czp-1-A1/FPGA_Component_Inspector/开发实施/显示方案预览/README.md

# A显示方案预览（2026-10-05）

这些文件用于讨论20方案，均不是新FPGA输出截图或识别验收证据。

- `lab3-logo-reference.png`：从随板Lab3原ROM直接解码的160×160图案，未改原ROM；来源与SHA见20方案。
- `sample-uncal-preview.png`：下一版建议采用的取样界面，默认未标定。
- `demo-present-preview.png`：未来精简演示内容，有件仅为状态预演。
- `demo-offline-preview.png`：无输入时撤销旧判定并显示等待采样。
- `preview_manifest.json`：本轮预览检查和文件哈希，不替代硬件验收清单。

三张布局图均为1024×600；字形是风格示意，正式RTL使用有限字符的1bit字模。载带为几何示意，双框用途及坐标沿用当前方案，顶部参数和底部示例数据不能用来证明实物检测通过。

交互预览源位于本聊天的可视化目录：

`C:/Users/yiziw/.codex/visualizations/2026/10/02/01a0fcf4-604d-7ef2-88bc-ccfea7cc8b08/fpga-stage-a-display.html`

`fpga-stage-a-display-inspection.html`为本机浏览器检查包装页。这里只准备方案、预览和交接；RTL/约束/.al/bit均未改。
