czp-1-A1/FPGA_Component_Inspector/待测元器件/待测元器件选择与验证方案.md

# 待测元器件搜集与筛选清单

> 2026-09-07修订：候选库仍作资料初筛。A版从一种实际样品完成正常/空穴识别；B版进入运动编号前确认P0/P1，方向特征按实测加入，不以极性未通过阻塞A版。

## 1. 搜集时主要看什么

看到一个元件后，重点记录：

- 立创编号、制造商和完整料号；
- 封装名称和元件尺寸；
- 顶部是否有色带、缺角、圆点、字符或不对称结构；
- 从正上方能否判断方向或极性；
- 是否采用载带卷盘包装；
- 载带宽度、穴位节距和装料方向；
- 能检测哪些缺陷；
- 商品图是否只是示意图，datasheet是否有真实标记说明。

最重要的一条：

> **只能从底部看出极性的元件，不适合作顶部极性识别样品；仍可用于已验证的存在/空穴检测。**

---

## 2. 第一类：最值得重点搜集

这些元件尺寸合适、方向特征较明显，优先建立候选库。

| 元件类型 | 嘉立创搜索关键词 | 可以检测什么 | 推荐程度 | 重点注意 |
|---|---|---|---:|---|
| SOD-123 二极管 | `B5819W SOD-123`、`1N4148W SOD-123` | 空穴、偏位、旋转、阴极方向 | ★★★★★ | 色带必须从顶部清楚可见 |
| SMA 二极管 | `SS14 SMA`、`DO-214AC 二极管` | 空穴、偏位、旋转、阴极方向 | ★★★★★ | 元件更大，但载带也可能更宽 |
| 3528 LED | `3528 PLCC-2 水清 LED` | 空穴、偏位、旋转、极性、颜色 | ★★★★☆ | 优先水清有色，避免荧光胶遮挡 |
| 5050 单色 LED | `5050 单色 LED` | 空穴、偏位、旋转、极性、颜色 | ★★★☆☆ | 区分单色和RGB，多芯片结构较复杂 |
| CASE-A 钽电容 | `CASE-A 3216 钽电容` | 空穴、偏位、旋转、极性条 | ★★★★★ | 顶部极性条是否清楚、批次是否一致 |
| CASE-B/C 钽电容 | `3528 钽电容`、`6032 钽电容` | 空穴、位置、方向、尺寸 | ★★★★☆ | 更容易拍清，但载带更宽、价格较高 |

可以先查看的具体例子：

- SOD-123：[MDD B5819W，C64885](https://www.lcsc.com/product-detail/C64885.html)
- 3528红色水清LED：[C516137](https://www.lcsc.com/product-detail/Light-Emitting-Diodes-LED_HONGLITRONIC-Hongli-Zhihui-HONGLITRONIC-HL-A-3528S9AC-S1-13HL_C516137.html)
- 3528绿色水清LED：[C5280496](https://www.lcsc.com/product-detail/C5280496.html)
- CASE-A钽电容：[C7177](https://www.lcsc.com/product-detail/Tantalum-Capacitors_Kyocera-AVX-TAJA106K010RNJ_C7177.html)
- SMA二极管：[onsemi SS14，C83852](https://www.lcsc.com/product-detail/schottky-diodes_onsemi-ss14_C83852.html)

---

## 3. 第二类：适合扩展方向和封装识别

这些元件适合展示系统不仅能检测二极管或LED，还能通过配方检测不同封装。

| 元件类型 | 嘉立创搜索关键词 | 可以检测什么 | 难度 | 注意事项 |
|---|---|---|---:|---|
| SOT-23 | `SOT-23 三极管`、`SOT-23 MOS管` | 空穴、偏位、旋转、侧立、封装方向 | 低 | 三引脚结构不对称，比较适合 |
| SOT-89 | `SOT-89 稳压器` | 空穴、位置、方向、错尺寸 | 低 | 引脚和散热片结构明显 |
| SOT-223 | `SOT-223 稳压器` | 空穴、方向、偏位、姿态 | 低 | 尺寸较大，载带通常更宽 |
| SOP/SOIC | `SOP-8 芯片`、`SOIC-8` | 空穴、偏位、旋转、Pin 1方向、明显引脚异常 | 中 | 查找顶部圆点或缺口明显的型号 |
| TSSOP | `TSSOP-8`、`TSSOP-14` | 空穴、方向、偏位、引脚轮廓 | 中 | 引脚较细，对清晰度要求更高 |
| QFP/LQFP | `LQFP-32`、`LQFP-48` | 空穴、方向、Pin 1、明显引脚异常 | 中高 | 元件较大但引脚密集，载带较宽 |
| QFN/DFN | `QFN-16`、`DFN-8` | 空穴、外形、方向、Pin 1标记 | 高 | 顶部标记小，部分极性特征只在底部 |
| DPAK/TO-252 | `TO-252 MOS管`、`DPAK` | 空穴、方向、偏位、外形 | 低 | 外形不对称但尺寸和载带较大 |
| 贴片光耦 | `SOP-4 光耦` | 空穴、方向、Pin 1、偏位 | 中 | 顶部圆点或缺口是否明显 |
| 贴片整流桥 | `MBF 贴片整流桥` | 空穴、方向、极性符号、字符 | 中 | 顶部符号可能较小，需看datasheet |

这类元件的重点不是识别具体电气型号，而是检测封装方向、位置和可见外观。不能仅凭普通摄像头判断芯片内部是否正常。

---

## 4. 第三类：可以做普通外观检测

这类元件通常没有极性，但可以用于扩展空穴、偏位、侧立、错尺寸和破损检测。

| 元件类型 | 嘉立创搜索关键词 | 可以检测什么 | 推荐程度 | 注意事项 |
|---|---|---|---:|---|
| 1206电阻 | `1206 电阻` | 空穴、偏位、旋转、侧立、字符 | ★★★★☆ | 适合做非极性配方 |
| 0805电阻 | `0805 电阻` | 空穴、偏位、姿态 | ★★★☆☆ | 尺寸偏小但仍可尝试 |
| 1206陶瓷电容 | `1206 MLCC` | 空穴、偏位、侧立、错尺寸 | ★★★☆☆ | 外观过于相似，不能测容量 |
| 贴片电感 | `1210 电感`、`功率电感 SMD` | 空穴、偏位、旋转、破损 | ★★★★☆ | 优先选择3～6 mm的屏蔽电感 |
| 贴片保险丝 | `1206 贴片保险丝` | 空穴、位置、外观、字符 | ★★★☆☆ | 不能只靠视觉判断是否熔断 |
| 磁珠 | `1206 磁珠` | 空穴、位置、侧立 | ★★☆☆☆ | 与电阻电容外观相似 |

普通阻容感不能作为“极性反向”检测对象，也不能通过外观判断阻值、容量或电感量。

---

## 5. 第四类：可作为高难度扩展

| 元件类型 | 嘉立创搜索关键词 | 可以研究什么 | 主要困难 |
|---|---|---|---|
| 贴片晶振 | `3225 晶振`、`5032 晶振` | 空穴、方向、字符、封装尺寸 | 金属壳反光，部分型号无方向要求 |
| 有源晶振 | `3225 有源晶振` | Pin 1方向、字符、偏位 | 顶部圆点或缺角较小 |
| 光电传感器 | `SMD 光电传感器` | 方向、窗口位置、外观 | 透明窗口和黑色壳体反光差异大 |
| 贴片霍尔传感器 | `SOT-23 霍尔传感器` | 封装方向、位置 | 只能识别外观，不能判断功能 |
| TVS二极管 | `SMA TVS`、`SOD-123 TVS` | 空穴、方向、外形 | 双向TVS可能没有极性，不要混淆 |
| 连接器 | `载带包装 SMD 连接器` | 空穴、方向、针脚明显异常 | 异形、尺寸大、载带不统一 |
| 屏蔽罩/金属件 | `载带包装 屏蔽罩` | 空穴、方向、轮廓和变形 | 高反光，需要特殊照明 |

这些适合后期证明系统可扩展，不建议作为第一版主样品。

---

## 6. 暂时不要重点搜集

- 0201、0402等超小元件；
- BGA、WLCSP等底部特征为主的封装；
- 极性只能从底部焊盘判断的LED或芯片；
- 没有datasheet、品牌或完整料号的元件；
- 散装、管装或托盘装且没有相应载带资料的元件；
- 外形完全相同、只能靠电参数区分的电阻、电容或二极管；
- 只在手机微距商品图里看得清标记的元件。

---

## 7. 每找到一个元件就这样记录

| 项目 | 填写内容 |
|---|---|
| 元件类别 | 例如SOD-123二极管 |
| 立创编号 | 例如C64885 |
| 制造商 |  |
| 完整料号 |  |
| 封装 |  |
| 元件尺寸 |  |
| 顶部特征 | 色带/缺角/圆点/字符/不对称结构 |
| 顶部能否判断方向 | 能/不能/待实物验证 |
| 预计可检测缺陷 |  |
| 包装方式 | Tape & Reel/其他 |
| 载带宽度 |  |
| 穴位节距 |  |
| datasheet链接 |  |
| 商品链接 |  |
| 初步推荐等级 | 主样品候选/第二配方/后期扩展/不推荐 |
| 备注 |  |

建议每一大类先搜集2～3个具体型号，不需要把商城所有同类元件都记录一遍。

---

## 8. 搜集完成后的初步分类

把找到的型号分成四组：

1. **主样品候选**：顶部极性明显、尺寸3～6 mm、载带资料完整；
2. **第二配方候选**：与主样品材质或封装不同，但仍容易检测；
3. **高难度扩展**：Pin 1、小字符、细引脚或强反光目标；
4. **淘汰**：顶部无可靠特征、尺寸太小或包装信息不完整。

目前推荐的搜集重点为：

> **SOD-123二极管、SMA二极管、3528 LED、钽电容、SOT-23和SOP-8。**

这六类已经能覆盖色带极性、内部结构极性、极性条、非对称引脚和Pin 1标记等多种视觉特征。

## 9. 本轮增加的实物验证记录

- 固定支架、镜头高度/倾角、导轨基准和光源，拍同平面毫米尺，记录有效视场与标记像素数；不先限定可见穴位数量。
- A版只要求正常/空穴真值完整。反向、偏位、旋转在对应功能启用前分别记录制作方法、允许正常范围与测量真值。
- 测试段和物理穴位建立编号，标记避开检测ROI及定位孔；记录运行段/相对编号与物理真值号的映射。
- 拆装后和轻微横移后复拍；完整标定补偿按误差是否妨碍本版判定决定。
- 单帧先验，多帧可用数按完整清晰检测行程和实测速度计算，不以每节距帧数代替。
- 所有未知包装、成像和运动参数仍标待核实，不因为本轮批准计划就改成实测通过。候选工作簿保持原始数据状态。
