czp-1-A1/FPGA_Component_Inspector/开发实施/验收记录/20261001_步骤1_轮次1.md

# A 阶段步骤 1：官方 Lab 1 构建记录

## 结论

**需补测。** TD 6.2.1 已完成官方 `lab_hd_1_mipi_hdmi` 的综合、布局布线和 bitgen，生成 SRAM 下载镜像；未能经 JTAG 下载到开发板，因此没有本机显示、连续视频或冷启动验收证据。

## 目标与范围

执行开发计划《00_分阶段开发与逐级验证路线.md》步骤 1：以官方 Lab 1 摄像头到 HDMI 工程为起点，先验证本机完整工具链。计划中要求的真实视频、输入分辨率/帧率、30 分钟连续运行和冷启动，本轮未测。

本轮未修改 HDL、约束或原始例程。为了不改动资料目录中的源例程，构建副本位于 `D:\TD_Example_Run_20261001`。

## 基本信息

- 日期：2026-10-01；阶段 A，步骤 1，轮次 1。
- 仓库基线：`hx1p35a-contest-work`，HEAD `f87ccf1`；无 RTL/约束改动。
- TD：`6.2.168116`（6.2.1）。
- 官方工程：`7_lab_ex_2026_nosoft/lab_hd_1_mipi_hdmi/lab_hd_1_mipi_hdmi/td_project/camera_to_dsi_display.al`。
- 顶层/器件：`design_top_wrapper` / `PH1P35MDG324`。
- 板卡照片丝印：HX1P35A V1.0；FPGA 封装丝印未能从照片确认。
- COM8：`USB Serial Port (COM8)`，FTDI VID/PID `0403:6042`，MI_01（Channel B）；Channel A 为 MI_00。当前 A、B 均绑定 FTDI CDM 2.12.36.20。

## 构建结果

| 阶段 | 结果 | 关键报告 |
|---|---|---|
| 综合 `read_design` → `opt_gate` | 通过，TD 进程退出码 0 | Setup WNS 2040 ps、TNS 0 ps；Hold WNS 114 ps、TNS 0 ps |
| 布局布线/bitgen `opt_place` → `bitgen` | 通过，TD 进程退出码 0 | Setup WNS 629 ps、TNS 0 ps、违例端点 0；Hold WNS 20 ps、TNS 0 ps、违例端点 0 |

最终资源：LUT6 9,830/21,216（46.33%）；slice 12,187/21,216（57.44%）；寄存器 13,318/42,432（31.39%）；ERAM 31/108（28.70%）；DSP 8/40（20%）；DDR byte 6/12；MIPI RX 1/2；PLL 3/6。详见 `camera_to_dsi_display_phy.area` 和 `route.qor`。

综合日志包含未驱动 DDR 初始化 RAM 输入脚及 `SYN-5025 Using 0 for all undriven pins and nets` 警告；另有部分 RAM_STYLE 自动推断警告。物理实现报告包含摄像头时钟网使用局部布线、时钟网混合扇出及 PLL 输出未绑定可时钟 IO 的警告。流程仍成功生成镜像，但这些警告需要在实际板卡验证前复核。

## JTAG/上板结果

- Windows 枚举到 FTDI `VID_0403&PID_6042`；COM8 是 MI_01/Channel B 的串口，JTAG 使用 MI_00/Channel A。
- `hwserver.exe` 实测输出：`Use channel A`、`Open device vid=0x0403 pid=0x6042`，随后 `usb_open() failed`，退出码 1。
- `bw_commands_prompt.exe` 的诊断调用及 `hwserver.exe` 都在打开 FTDI Channel A 时失败：前者报告 `PRG-9505 USB device open error` / `PRG-9525 Chip validation failed`，后者报告 `usb_open() failed`、退出码 1。当前 Channel A/MI_00 绑定 FTDI CDM；这与随附手册要求的 JTAG WinUSB 驱动状态不一致，是已观察到的阻塞点。没有向 FPGA SRAM/Flash 下载，也没有改写 FTDI EEPROM。
- 摄像头和显示器是否接好、摄像头实时视频、分辨率/帧率、30 分钟稳定性、断电冷启动：未测。

## 证据

| 证据 | 文件 | 支持内容 |
|---|---|---|
| E01 | `syn_run.log` | TD 版本、综合完成状态、综合时序与警告 |
| E02 | `phy_run.log` | 布局布线、DRC/QoR、bitgen 完成状态与最终时序 |
| E03 | `camera_to_dsi_display_phy.area`、`route.qor`、`place.qor`、`final_timing.rpt`、`route_clock_utilization.txt` | 资源、I/O、布局布线时序、时钟网络报告 |
| E04 | `camera_to_dsi_display.bit`、`camera_to_dsi_display_compress.bit` | 本轮生成的 SRAM 下载镜像 |
| E05 | Windows PnP 枚举和 `hwserver.exe` 终端输出（本轮记录） | COM8/FTDI 通道与 JTAG 打开失败原因 |

Bitstream SHA-256：

- `camera_to_dsi_display.bit`: `33A0A0B89A178E9F119E8434F6CE4649C56974B7F580A400D60301B6F49154C9`
- `camera_to_dsi_display_compress.bit`: `72E2E73AA01CA646EA7F703A8238784CDF505188F5F55DDBA8732782C3D78533`

## 下一步

先按随附的 JTAG 安装说明把 USB-JTAG 的 Channel A/MI_00 配置为可供 hwserver 打开的 WinUSB 驱动，保留 Channel B/MI_01 的 FTDI COM 驱动以维持 COM8。重插 USB 后再次确认 `hwserver.exe` 能打开设备，再用 BitWriter 的 SRAM 模式下载本轮镜像。随附流程还包含 FT_Prog 写入 `al_link_ft_new.xml` 的 USB 桥 EEPROM 步骤；本轮未执行该持久写入，模板状态也未读取。随后接好摄像头和显示器，按步骤 1 记录视频与冷启动证据。

## 提交状态

未提交、未推送。记录及证据为本地新增文件；没有修改检测 RTL 或约束。
