czp-1-A1/FPGA_Component_Inspector/开发实施/验收记录/20261001_步骤1_轮次2_JTAG驱动复测.md

# A 阶段步骤 1：JTAG 驱动复测

## 结论

**FPGA 识别和 SRAM 下载通过，视频验收待完成。** BitWriter识别到`PH1P35MDG324`，并报告芯片验证成功；官方Lab 1压缩镜像的`download`命令正常结束，耗时7.458209秒。SRAM下载成功不等于板上摄像头视频验收通过，当前也没有30分钟运行或冷启动证据。

## 设备状态

- 日期：2026-10-01；阶段 A，步骤 1，轮次 2。
- 板卡 USB 桥：FTDI `VID_0403&PID_6042`。
- JTAG：USB `MI_00` / Channel A，设备管理器显示 `USB Serial Converter A (Libusb - WinUSB)`；驱动提供方 `Libusb - WinUSB (Powered by UsbDriverTool)`，驱动包 `oem107.inf`。
- UART：USB `MI_01` / Channel B，仍绑定 FTDI CDM 2.12.36.20；`USB Serial Port (COM8)`状态为 OK。
- 未运行 FT_Prog；未写入 `al_link_ft_new.xml`；未改写 FTDI EEPROM。

## JTAG 访问探测

`hwserver.exe` 1.0c 在交互终端中输出：

```text
Initialize ftdi
Use channel A
Open device vid=0x0403 pid=0x6042
Enable mpsse
Requested jtag tck: 15 MHz
Actual jtag tck: 15 MHz
Speed: 0.00 kbps
```

这说明程序已打开 Channel A 并进入 MPSSE/JTAG 模式；空闲时速率显示 0.00 kbps。探测进程随后已关闭，避免占用 JTAG 接口。

## BitWriter SRAM 下载

- 用户截图中目标器件为`0:PH1P35MDG324`，Debug Server为`AL-LINK-FT (Local Host)`，模式为`PROGRAM_SRAM`、速度为`5MHz`。
- 文件列表显示加载了`camera_to_dsi_display_compress.bit`，Device为`phl_35p`、Package为`PH1P35MDG324`、Bit version为`0x00`。
- 日志报告`PRG-2014 : Chip validation success: PH1P35MDG324`，随后`download`命令正常结束，用时7.458209秒；界面进度为100%。据此记录FPGA识别和SRAM下载通过。
- 用镜像：`D:\TD_Example_Run_20261001\td_project\camera_to_dsi_display_Runs\best_result\camera_to_dsi_display_compress.bit`，SHA-256 `72E2E73AA01CA646EA7F703A8238784CDF505188F5F55DDBA8732782C3D78533`。
- 截图证据：`开发实施/验收记录/20261001_步骤1_轮次2_JTAG驱动复测/BitWriter_SRAM下载成功.png`，SHA-256 `4127094CA1ECF89BE154DAE522DF7924FABBAF9D109BAA8ECC33D969700865E5`。
- 下载方式为SRAM；此证据不包含Flash写入、摄像头实时视频或显示端验收。

## 待完成

## 后续下载重试

用户接好摄像头后提供的日志先显示`GUI-1001 : Downloading succeeded!`，随后又启动了一条新的`download`命令。该次新命令多次报告`PRG-8000 ERROR: Connect server failed`，最终报告`PRG-9525 ERROR: Chip validation failed`并在30.525386秒后结束。前一条GUI成功提示属于此前已完成的下载，不代表这次新重试成功；芯片校验失败发生在服务连接失败之后。

同一工作站随后检查到：`127.0.0.1:5555` TCP连接失败；PID 5124的`jtagserver.exe`进程存在，但没有在该端口监听。此前BitWriter使用`connect_cable -host_name 127.0.0.1:5555`，因此当前现象优先指向本地调试服务未就绪/不可达。现有信息不足以判断摄像头是否造成板卡复位；也未确认第一次成功下载后板卡是否掉电或复位，故当前SRAM配置状态待确认。

用户随后反馈重新上电后USB接口类型变回原样。对此工作站重新枚举当前在场的FTDI复合设备：MI_00仍显示`USB Serial Converter A (Libusb - WinUSB)`，驱动提供方`Libusb - WinUSB (Powered by UsbDriverTool)`，服务`WinUSB`，状态`Started`；MI_01仍显示`USB Serial Converter B`。因此本次系统检查时JTAG接口驱动并未回退。如果用户看到的是其他窗口/设备项，需提供对应截图才能定位其所指的“接口类型”。

建议先确认板卡USB保持连接、BitWriter选择`AL-LINK-FT (Local Host)`，停止下载后退出并重新打开BitWriter以重建本地服务；刷新后先确认器件仍显示为`PH1P35MDG324`，再只执行一次下载。不要重复更换驱动或写USB桥EEPROM。若仍报`Connect server failed`，保存刷新后的顶栏与完整日志。排线不要带电插拔；如果接排线时板卡断过电，需待服务恢复后重新下载SRAM镜像。

## 对照用户提供的安路驱动教程

此前没有完整执行该教程。此前做过的是用UsbDriverTool将MI_00绑定WinUSB、用`hwserver.exe`确认MPSSE可打开，以及BitWriter识别并下载SRAM；没有由本轮在FT_Prog中执行Scan and Parse、应用`al_link_ft_new.xml`或点击ProgramDevice/Program。

教程包含：管理员运行FT_Prog和UsbDriverTool；临时给USB Serial Converter A安装FTDI CDM以便FT_Prog识别；Scan and Parse设备并设置PID为`6042`；应用`al_link_ft_new.xml`；执行ProgramDevice/Program；重新扫描确认写入，再重新枚举设备并为Channel A安装WinUSB。模板设置FT2232H、VID/PID `0403:6042`、序列号`123456789`、Port_A使用D2XX且不启用VCP、Port_B启用VCP且不使用D2XX。

此前Windows USB父设备instance ID含序列号`123456789`，与模板基础描述符一致，VID/PID也相符；但Port_A/Port_B配置未读回，不能据此断定模板已完整写入。用户删除COM8设备后BitWriter重连和芯片校验成功，并再次下载成功（7.370535秒）；这是当前已观察到的恢复方法，不足以证明COM8是唯一根因或等价于教程EEPROM流程。教程里的FTDI EEPROM编程是持久操作，应先用FT_Prog只读Scan and Parse对比通道配置，再决定是否Program。

用户已表示摄像头接好，实时显示验收仍待完成。若需继续核对，请在FT_Prog执行只读Scan and Parse，展开Hardware Specific中的Port_A、Port_B并提供截图；暂不点Program。
