czp-1-A1/FPGA_Component_Inspector/开发实施/机械概念图/学生简易版_生成与检查说明_20260908.txt

材料方案：用户选择木板＋少量3D打印件。
生成方式：内置image_gen，以购物清单观察结果作文字描述。
本图为结构布局草案，尚待用户确认。首轮金属V1弃用。

已检查与后续必须修正的示意差异
1. 本图相机PCB水平、镜头向下，板卡相机共用托架，符合结构意图。
2. 生成板卡上出现EP4CE6字样，不是用户HX1P35A实物；正式模型必须使用HX1P35A真实外形和孔位，不能照抄文字或电路布局。
3. 出口载带被画为随滚筒下折，是图像错误。正式模型必须增加水平出口托板，使开放载带平直离开，不卷入滚筒。
4. 导向块需按真实载带宽度做成侧向限位；光轴必须对准载带中心，灯与相机PCB不得遮挡光路。这些以CAD干涉检查和实物调试为准。
5. 图片不提供可直接加工的尺寸、公差或强度结论。用户只确认材料与布局方向，后续HTML和三视图使用修正后的几何。

完整提示词
Create one realistic SIMPLE STUDENT DIY tabletop carrier-tape camera inspection prototype concept image, landscape white studio background, three-quarter front view. This is inexpensive and easy to build, NOT an industrial metal machine. MAIN STRUCTURE light natural plywood, small dark-gray 3D-printed PLA adapters, a few ordinary screws and thumb nuts. NO aluminum extrusion, NO metal gantry, NO precision slide, NO lead screw, NO fancy enclosure. Purchased narrow WHITE PLASTIC tabletop conveyor, roughly 400mm length and80mm beltwidth proportions, small yellow miniature geared motor left end, rests on a flat rectangular plywood base. A black pocketed component carrier tape with edge sprocket holes lies flat on white belt, leaves straight onto small simple flat plywood end supports, never wraps around rollers. At rear middle ONE broad rectangular upright plywood backboard, braced to base by two triangular plywood gussets, short enough for compact student bench. Two vertical rows of a FEW plain adjustment holes in backboard. A simple black 3D-printed shelf bracket bolts at one selected hole level, carries a short horizontal plywood or printed shelf extending forward over tape. This common shelf holds TWO separate PCBs flat horizontal: long BLUE FPGA board rear-right on plastic spacers, ONE tiny GREEN camera PCB at forward edge on printed cutout adapter. Short amber flat flexible ribbon with gentle slack connects adjacent edges of both boards. BOTH PCBs are horizontal, neither is upright. Camera's ONE small black M12 lens is mounted on UNDERSIDE of green PCB, points vertically DOWN through cutout. Camera top shows electronic components, not a second lens. PCB and board mechanically secured to SAME shelf, together height adjustable by changing mounting-hole row, no dangling camera. Below camera, a compact black ring light (approx outer90 inner40 height22 proportions), white emitting face downward. TWO SIMPLE 3D-printed short slotted arms support OUTER ring housing from shared shelf, permit limited independent height adjustment with hand knobs, don't block central hole. Lens vertical axis passes through ring light center and intersects carrier tape centerline. Two simple small black printed side guide blocks alongside narrow tape mounted to white conveyor frame, do not press chips or cover sprocket holes. Small purchased black knob light-controller box fixed to plywood base side by a simple printed strap, wires clipped. Leave right downstream zone open for fingers. Finish believable plywood layers and subtle printed-layer texture, tidy student prototype, no expensive machining. Title Chinese '学生简易版 载带检测支架'. Only four short leader labels: '木板底座与加固立板', '板子相机共用托架', '换孔调高 灯架微调', '3D打印导向块'. Footer '概念示意 尺寸待实测'. No claims of precision or rigidity, no manufacturing dimension lines. One assembly view only, clean readable Chinese. Make camera orientation physically correct: ONLY a flat horizontal green PCB, with ONLY one lens UNDER it facing DOWN.
