czp-1-A1/FPGA_Component_Inspector/开发实施/机械概念图/生成说明_20260908.txt

生成方式：内置 image_gen。参考购物清单进行文字描述生成，首轮带参考图片请求因网络错误失败。
用途：布局确认，不是CAD或加工图。用户确认后继续HTML展示及工程三视图。

最终完整提示词
Create a precise, physically plausible industrial CAD-style concept rendering of a small desktop FPGA carrier-tape inspection bench, landscape 3:2 white background, one large three-quarter assembly view plus one enlarged detail inset of camera and FPGA on the SAME rigid adjustable head tray. White narrow belt conveyor roughly 400mm long 80mm wide, small yellow geared motor at one end. Narrow black embossed component carrier tape lies on belt, two low adjustable side guides keep carrier laterally positioned without covering sprocket holes or pressing components. Tape remains horizontal at both ends on support tables, never wraps around rollers. Aluminum common base, sturdy twin-post aluminum extrusion gantry bolted to base outside conveyor, adjustable lockable Z carriage with handwheel crossbeam. Camera and board move together with Z carriage: long blue HX1P35A FPGA PCB horizontal on insulated standoffs behind a small green SC500CS camera PCB horizontal in a forward cutout mounting plate, small M12 black lens points straight DOWN. Adjacent edges of both PCBs connected by a SHORT yellow flat flexible ribbon with gentle slack, NOT a long cable. Board and camera both mechanically fixed on SAME head, cable never supports them. Make this connection clear in detail inset. Ring light below camera coaxial with downward lens, outer diameter90 central aperture40 height22 approximately for reference proportions, supported by two outer slotted brackets with independent vertical adjustment. No member blocks central optical aperture. Small black finned light controller at base side with accessible knob and secured cable to light. Right/downstream zone accessible for hand repair, conveyor moves left to right. Realistic bolts, rigid brackets, plain industrial finish, no robots, screens or reels. Simple numbered Chinese callouts, clear legible typography. Title '载带检测台 可调结构概念'. Label '板子与相机共用托架' pointing to two connected boards; label '环形灯独立调高'; label '载带侧导向'; label '处置空间预留'; inset title '短排线连接局部'; bottom '概念示意 非加工图'. Show height adjustment arrows. Do NOT include dimension lines or invented numerical manufacturing tolerances. Engineering concept presentation, convincing correct geometry, modest aesthetic.
