czp-1-A1/FPGA_Component_Inspector/开发实施/机械概念图/背面折叠版_生成说明_20260909.txt

图像：摄像头背面折叠版_概念V1_20260909.png
生成方式：内置image_gen。2026-09-09本次请求成功，此前失败记录保留。
用途：确认木板加少量打印件的外部支架布局，不是加工图或电气接线图。
核心结构：开发板正面朝上，用户已有隔离板与背面相机作为现成组件；两侧承托，中部避让镜头；环形灯独立调高；载带水平出入。
检查说明：板卡、隔离板、相机内部外观均为占位，以用户实际组件为准，不设计其内部固定。图中控制器、电缆和灯架连接位置仅为概念表达，不能直接作为接线或安装孔依据；后续CAD明确灯架固定面并核对干涉。未验证实际视场、尺寸或刚度。

完整提示词
Square realistic 3D concept image, inexpensive student DIY carrier-tape inspection bench on white background. Plywood base, one plywood upright backboard with triangular braces, a few black 3D printed brackets, ordinary screws. White plastic small tabletop conveyor with yellow miniature gearmotor. Black pocketed electronics carrier tape lies flat on white belt and continues horizontally onto wooden inlet/outlet support tables; black tape NEVER wraps rollers. Above tape: ONE blue FPGA board HORIZONTAL, chips and seven-segment displays face UP. Existing light-gray insulating plate directly underneath board. Tiny green camera PCB is already fixed to UNDERSIDE of this plate, inside FPGA footprint, short gold ribbon folds around board edge. Camera ONLY lens points vertically DOWN. Do NOT put camera beside board. Two printed side arms support outer edges of existing plate, middle completely OPEN under camera; no solid shelf blocking lens, no separate camera mount. Arms bolt to selectable height holes in plywood backboard. Ring light under camera on two short slotted printed brackets, independent height adjustment. Lens, ring aperture and tape center aligned vertically. Simple tape side guides and small black light controller box on base. Single three-quarter view clearly revealing camera BELOW FPGA assembly. No metal extrusion gantry, no precision slide, no enclosure, no invented chip model numbers, no manufacturing dimensions. Chinese title '摄像头背面折叠版'. Labels '已有板卡相机组件', '两侧承托 中间留空', '木板支架', '环形灯独立调高'. Footer '概念示意 尺寸待实测'. Camera is a user-provided assembled module; do not invent internal attachment details. Mechanically plausible, simple student construction.
