czp-1-A1/FPGA_Component_Inspector/官方资料/04_接口与开发流程/安路软件使用完整流程.pdf

# 安路软件使用完整流程

## 以流水灯实验为例进行演示

## 实验要求：

实现 4 个 led 灯流水点亮。

## 实现思路（代码实现）:

a) 写一个分频模块，产生 1hz 时钟（1s），用于 led 切换显示的时间。
b) 控制 led 灯进行循环点亮的控制。
i. 通过 4 个 led 灯原理图可知，当 LED0 引脚接地（给 0 值），LED1 熄灭。 当 LED0 引脚接电源（给 1 值），LED1 点亮。

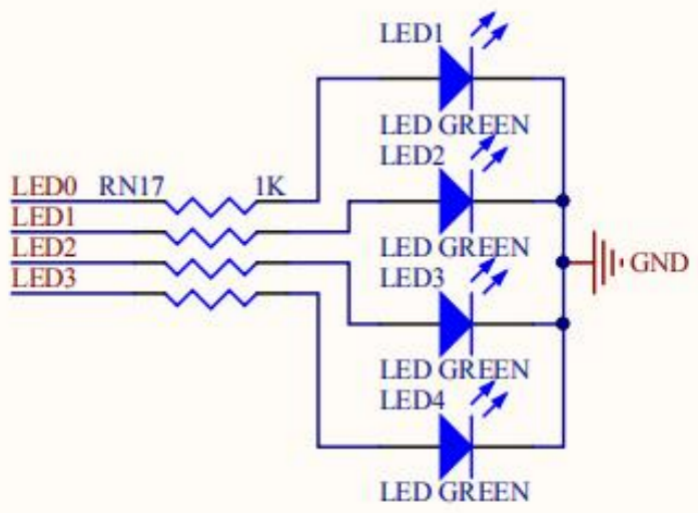
[picture p27: figure]

## 分频实现思路

### c) 应用原理： T = 1S/F 1s时间= 50_000_000(频率hz) * 20 (always @ (posedge clk)) ns , 50_000_000 是我计时 1s 时间，用 always @ (posedge clk)语句进行循环累加

的个数。

### d) 实际分频的参数：parameter T = 50_000_000 /1 / 2 -1;计数器计时到 1hz 时间一

半的个数

### i. 50_000_000 计时 1s 的个数

ii. | /1 分频频率 1hz
iii. | /2 是得到周期一半的个数
iv. | -1，因为计数器是从 0 开始计数（计数器校准）
e) 之后用计数器 cnt,从 0 到 T 值循环累加计数即可，计数器计时到 T 值时，让分
| 频的时钟取反即可。

## 设计框架：

f) 输入信号：

### i. clk;50mhz ii. rst_n;复位

g) 输出信号:

### i. [3:0] led;4 个 led 灯

## 新建工程，代码实现：

① 新建一个 run_led 文件夹，如图 1 所示。

图 1 新建工程文件夹
② 打开文件夹，里面新建 4 个文件夹。doc：是存放文档或工程相关资料的。 prj：是存放项目、IP 核文件、引脚约束文件和烧录比特流文件的。sim:是存放方针文件的。 src:是存放顶层代码和功能代码的。如图 2 所示。

### run_led

### clk

### rst_n

### led

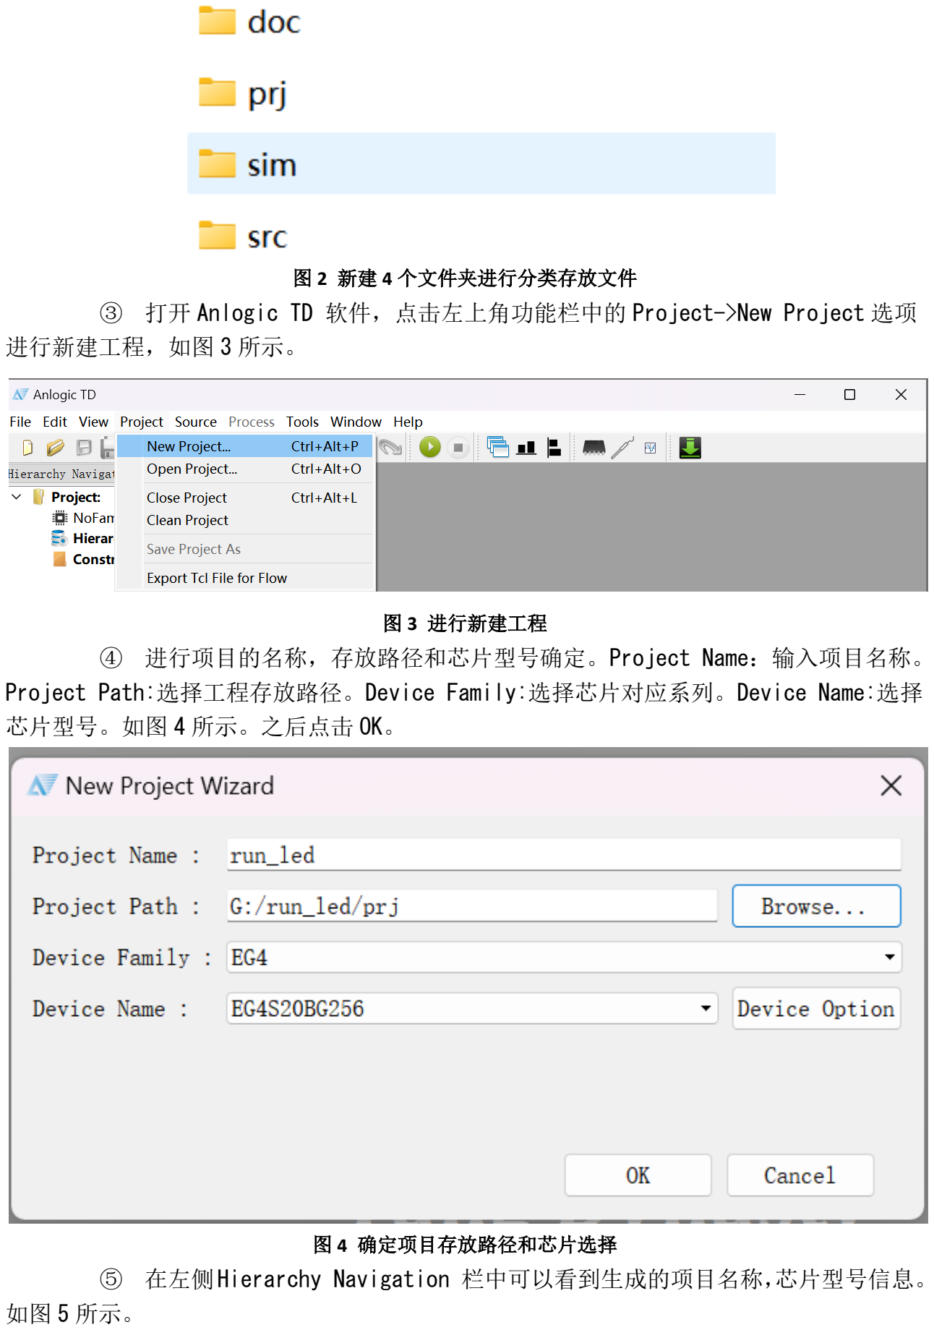
[picture p28: page 3]

图 2 新建 4 个文件夹进行分类存放文件
③ 打开 Anlogic TD 软件，点击左上角功能栏中的 Project->New Project 选项 进行新建工程，如图 3 所示。

图 3 进行新建工程
④ 进行项目的名称，存放路径和芯片型号确定。Project Name：输入项目名称。 Project Path:选择工程存放路径。Device Family:选择芯片对应系列。Device Name:选择 芯片型号。如图 4 所示。之后点击 OK。

图 4 确定项目存放路径和芯片选择
⑤ 在左侧Hierarchy Navigation 栏中可以看到生成的项目名称，芯片型号信息。 如图 5 所示。

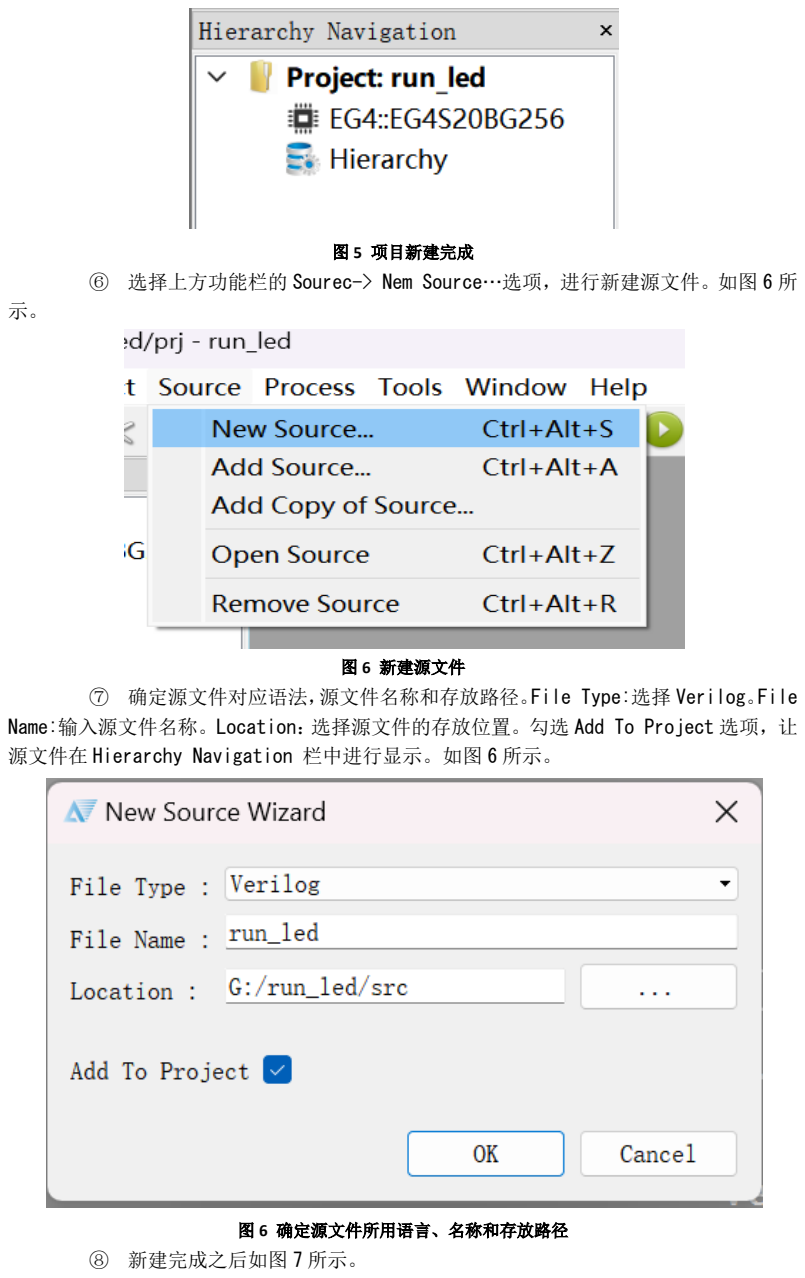
[picture p29: page 4]

图 5 项目新建完成
⑥ 选择上方功能栏的 Sourec-> Nem Source…选项，进行新建源文件。如图 6 所 示。

图 6 新建源文件
⑦ 确定源文件对应语法，源文件名称和存放路径。File Type:选择 Verilog。File Name:输入源文件名称。Location：选择源文件的存放位置。勾选 Add To Project 选项，让 源文件在 Hierarchy Navigation 栏中进行显示。如图 6 所示。

图 6 确定源文件所用语言、名称和存放路径
⑧ 新建完成之后如图 7 所示。

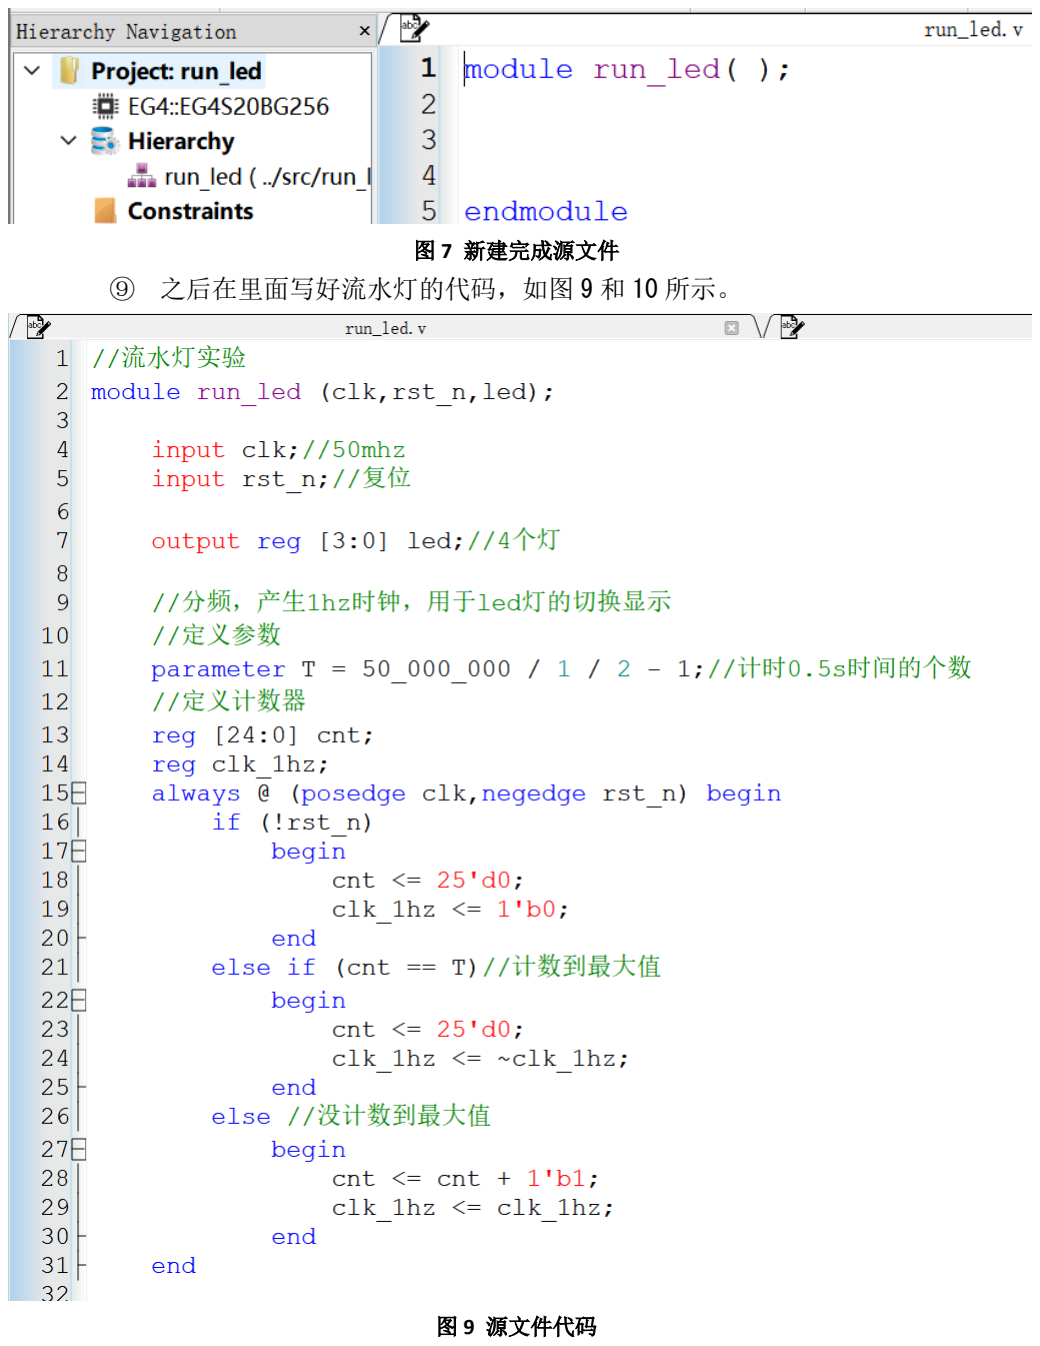
[picture p30: page 5]

图 7 新建完成源文件
⑨ 之后在里面写好流水灯的代码，如图 9 和 10 所示。

图 9 源文件代码

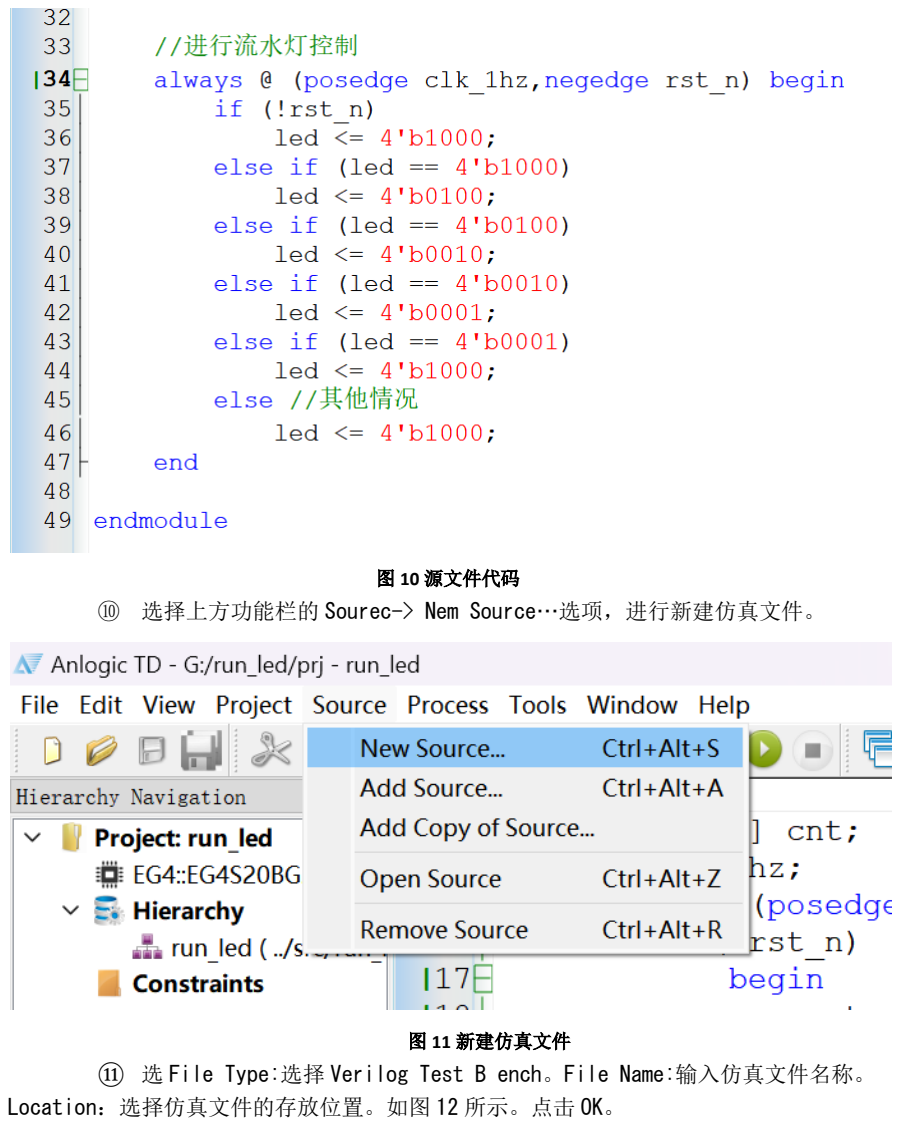
[picture p31: page 6]

图 10 源文件代码
⑩ 选择上方功能栏的 Sourec-> Nem Source…选项，进行新建仿真文件。

图 11 新建仿真文件
⑪ 选 File Type:选择 Verilog Test B ench。File Name:输入仿真文件名称。 Location：选择仿真文件的存放位置。如图 12 所示。点击 OK。

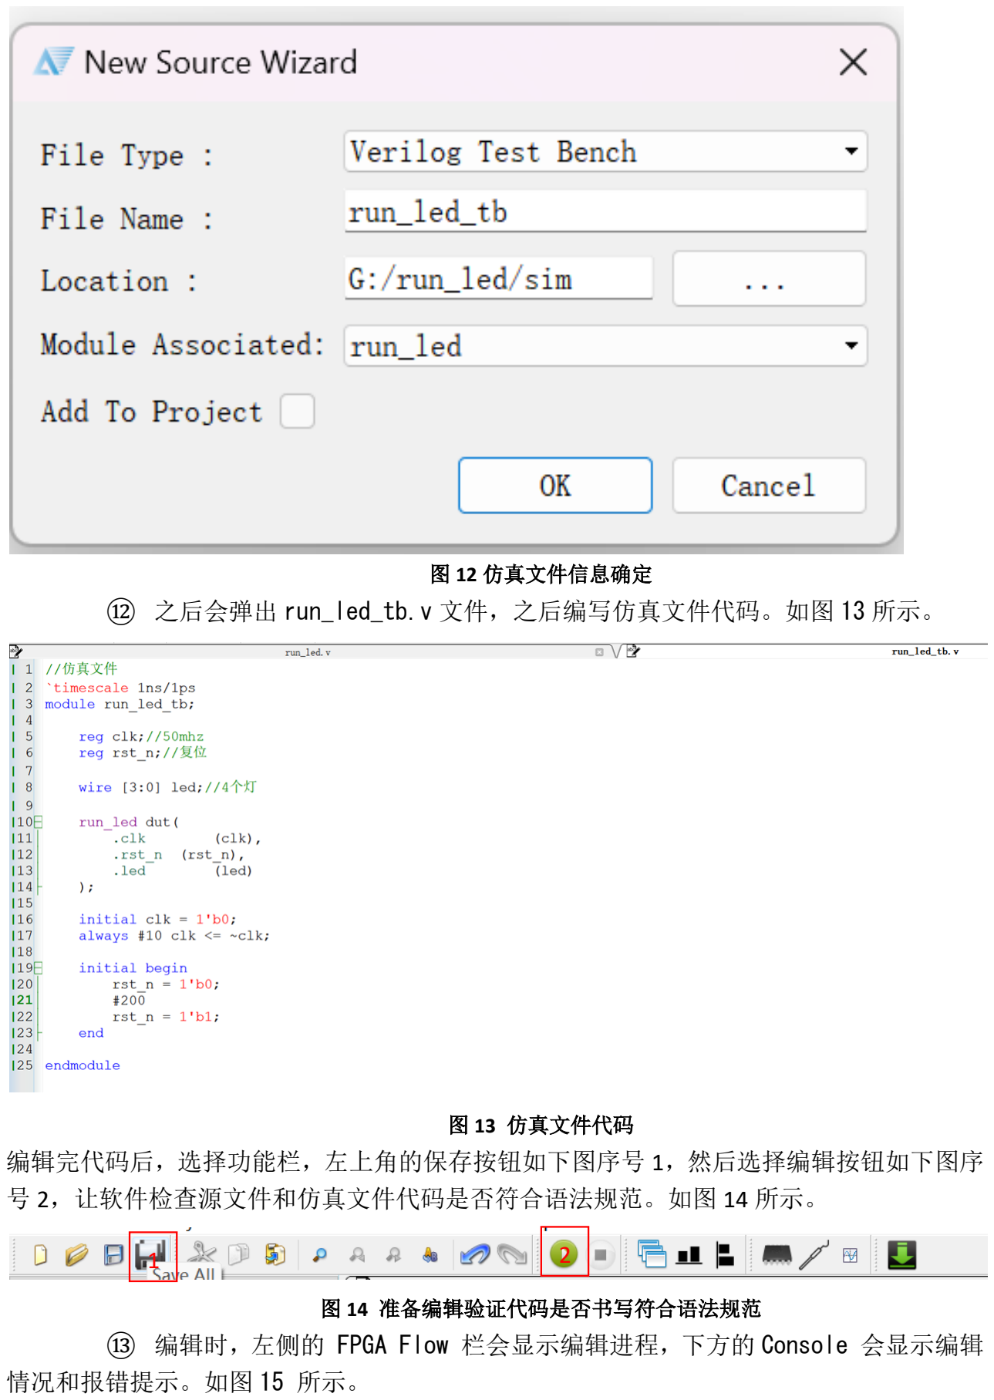
[picture p32: page 7]

图 12 仿真文件信息确定
⑫ 之后会弹出 run_led_tb.v 文件，之后编写仿真文件代码。如图 13 所示。

图 13 仿真文件代码
编辑完代码后，选择功能栏，左上角的保存按钮如下图序号 1，然后选择编辑按钮如下图序 号 2，让软件检查源文件和仿真文件代码是否符合语法规范。如图 14 所示。

图 14 准备编辑验证代码是否书写符合语法规范
⑬ 编辑时，左侧的 FPGA Flow 栏会显示编辑进程，下方的 Console 会显示编辑 情况和报错提示。如图 15 所示。
1 | 2

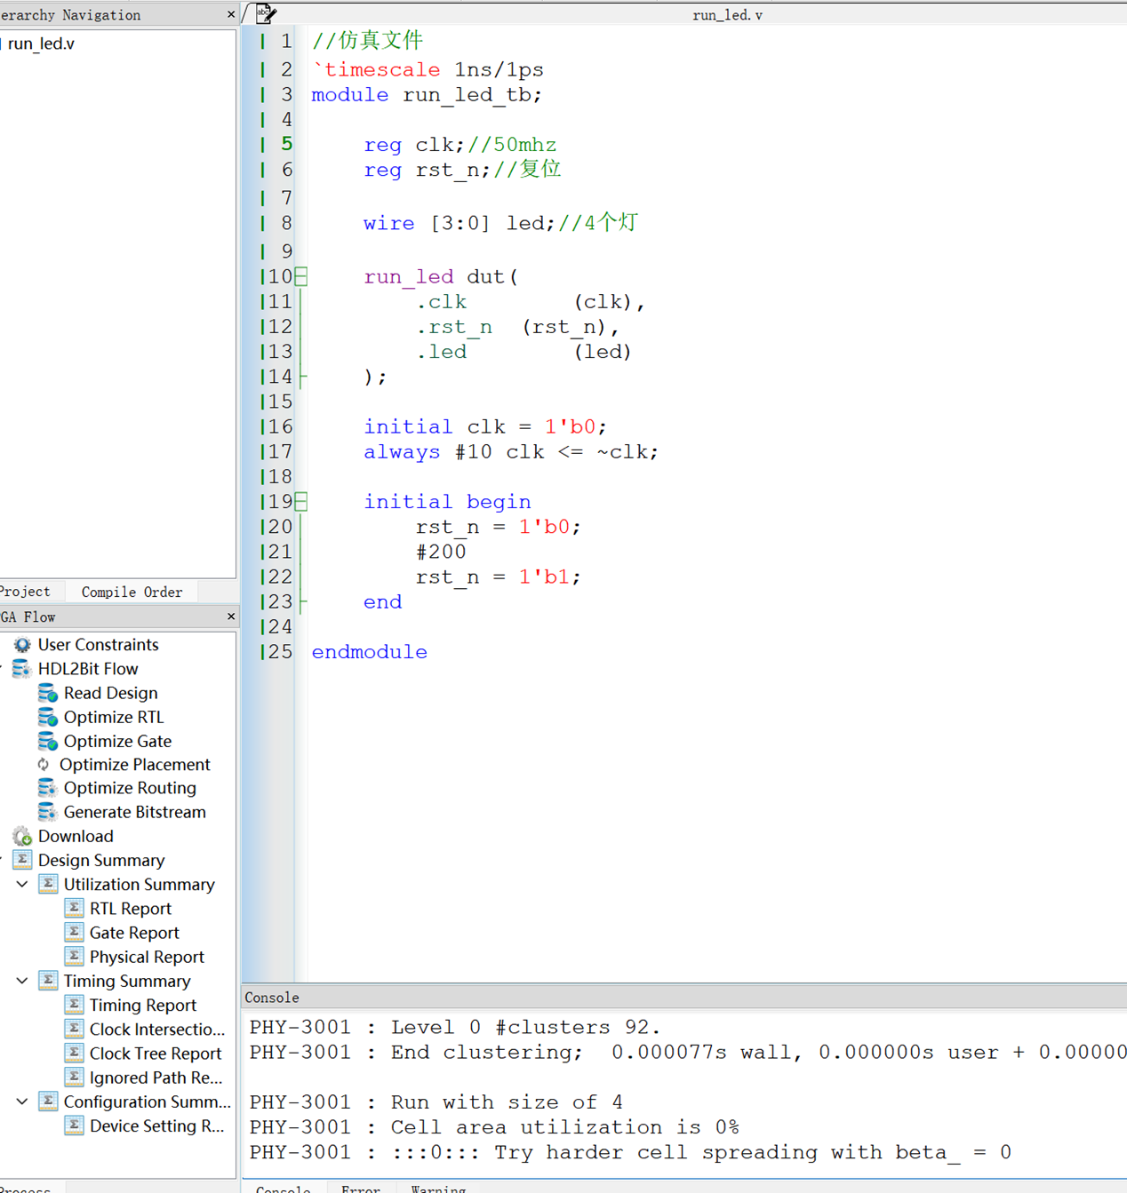
[picture p33: figure]

图 15 准备编辑验证代码是否书写符合语法规范

## 仿真验证：

### ① 编辑完成之后，没有语法问题就需要用 ModelSim-Altera 10.1d (Quartus II 13.1)

软件进行仿真验证。如图 16 所示。

### 图 16 ModelSim-Altera 10.1d (Quartus II 13.1)软件

② 左键双击 ModelSim-Altera 10.1d 软件，打开后关掉弹窗，选择功能栏里的

### File->New->Project…进行新建工程。如图 17 所示。

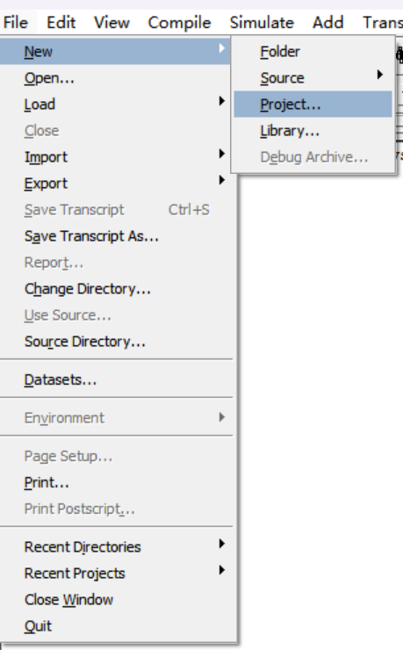
[picture p34: figure]

图 17 新建工程

### ③ project Name:输入项目名称；Project Location:选择工程存放路径；其它保持默

认即可。之后点击 OK。如图 18 所示。

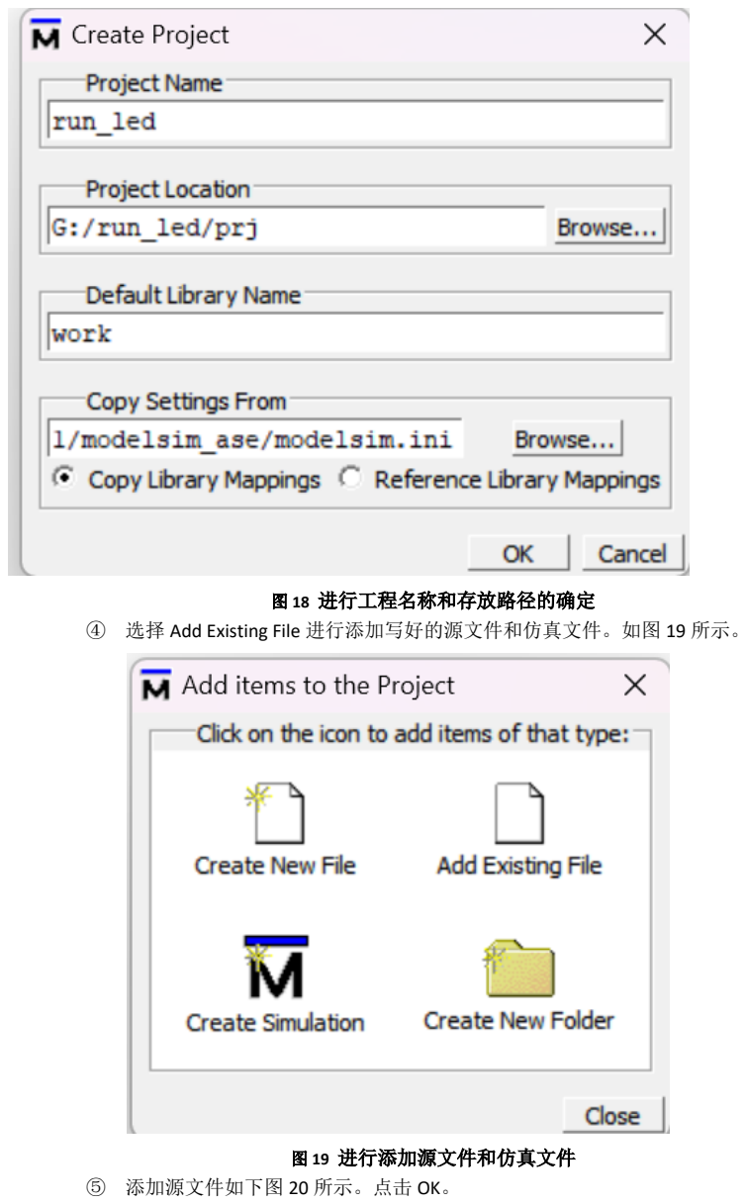
[picture p35: page 11]

图 18 进行工程名称和存放路径的确定
④ 选择 Add Existing File 进行添加写好的源文件和仿真文件。如图 19 所示。

图 19 进行添加源文件和仿真文件
⑤ 添加源文件如下图 20 所示。点击 OK。

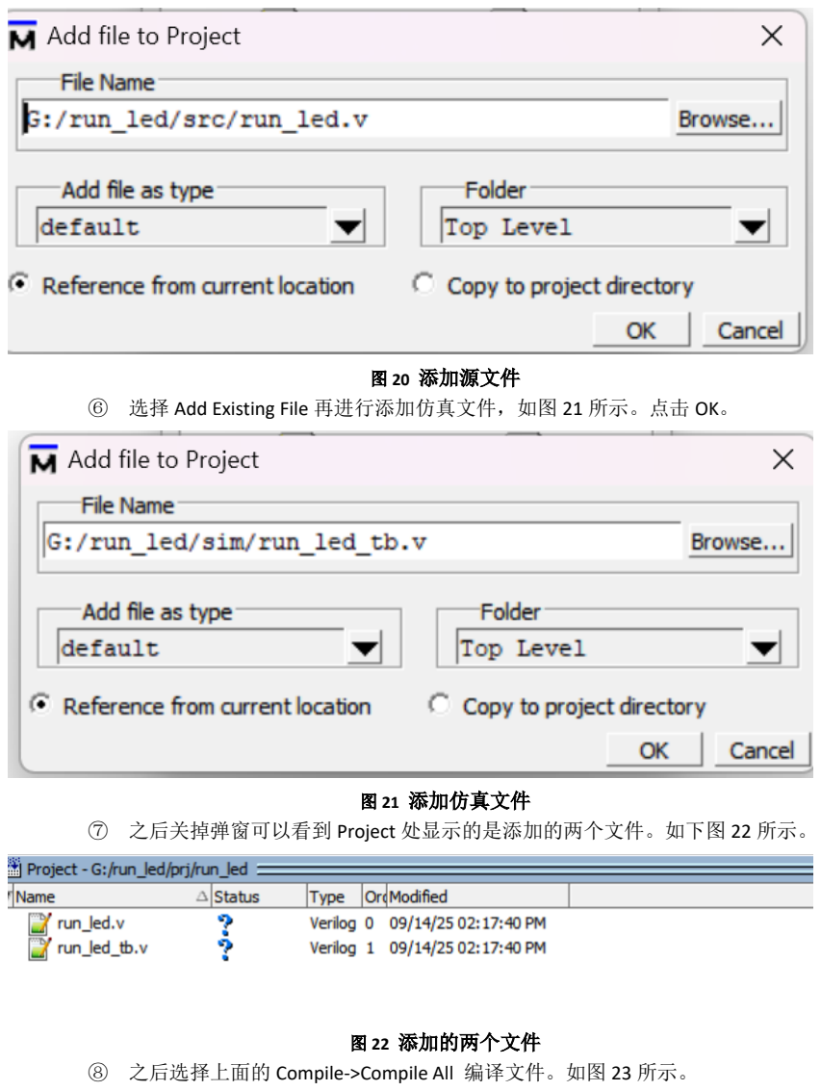
[picture p36: page 12]

图 20 添加源文件
⑥ 选择 Add Existing File 再进行添加仿真文件，如图 21 所示。点击 OK。

图 21 添加仿真文件
⑦ 之后关掉弹窗可以看到 Project 处显示的是添加的两个文件。如下图 22 所示。

图 22 添加的两个文件

### ⑧ 之后选择上面的 Compile->Compile All 编译文件。如图 23 所示。

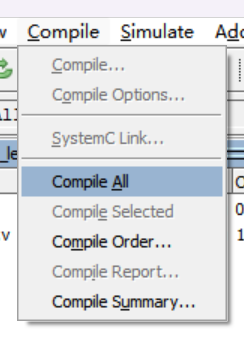
[picture p37: figure]

图 23 进行编译代码
⑨ 编译完成之后如下图 24 所示，Status 下显示对钩证明程序没有语法错误。

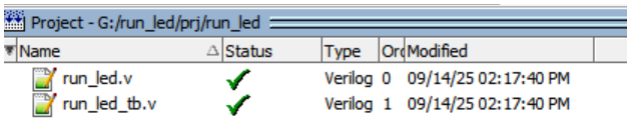
[picture p38: figure]

图 23 编译完成

### ⑩ 选择 Simulate-> Start Simulation 进行开始仿真验证的准备工作。如图 24 所示。

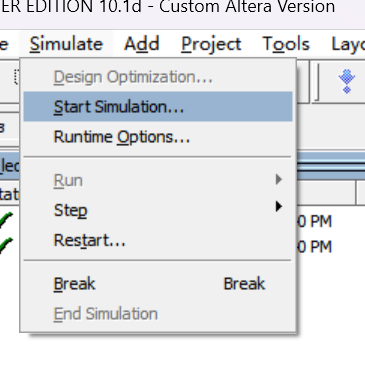
[picture p39: figure]

图 24 准备进行仿真验证

### ⑪ 选择 work 栏中的 run_led_tb 文件，之后点击 OK,如图 25 所示。

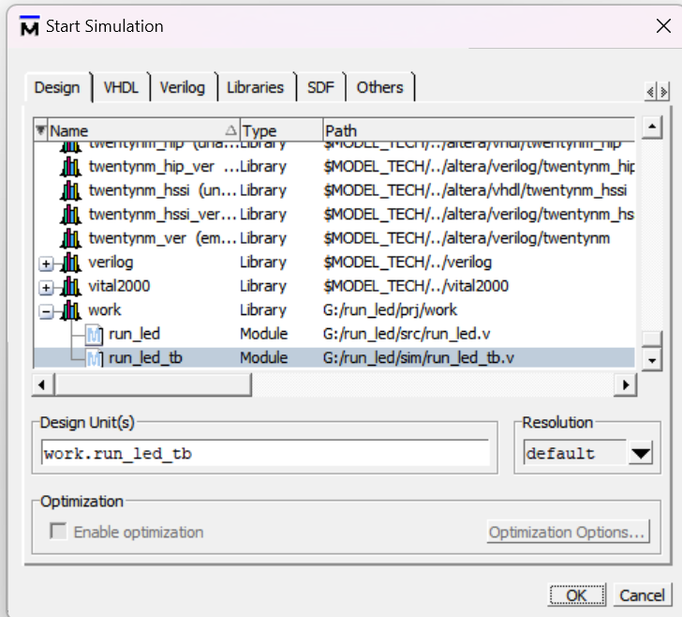
[picture p40: figure]

图 25 选择仿真文件
⑫ 找到 sim 页面栏，之后选择 dut->Add Wave 添加需要观察的信号。如图 26 所 示。

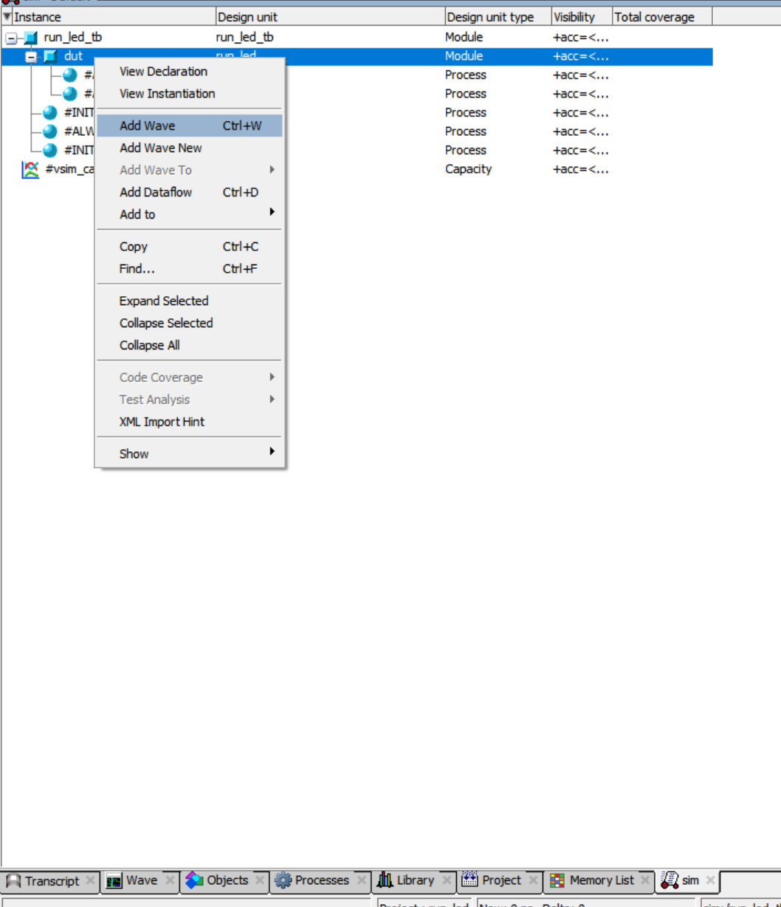
[picture p41: figure]

图 26 选择添加观察的信号
⑬ 之后找到 Wave 页面进行观察信号，验证代码功能是否正常实现。如图 27 所 示。

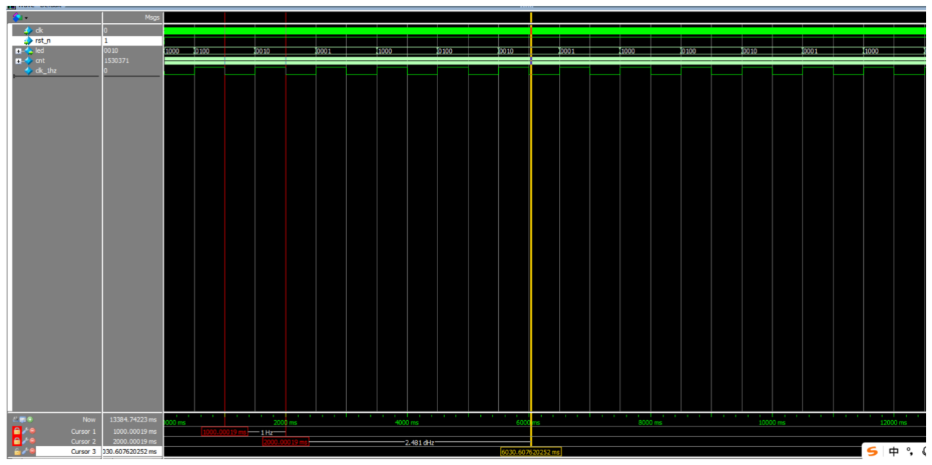
[picture p42: figure]

图 27 观察仿真波形

## 分配引脚：

1. 选择 TOOls->IO Constraint 进行分配引脚。所对应的引脚信息通过查看开发板 手册了解。如图 28 所示。

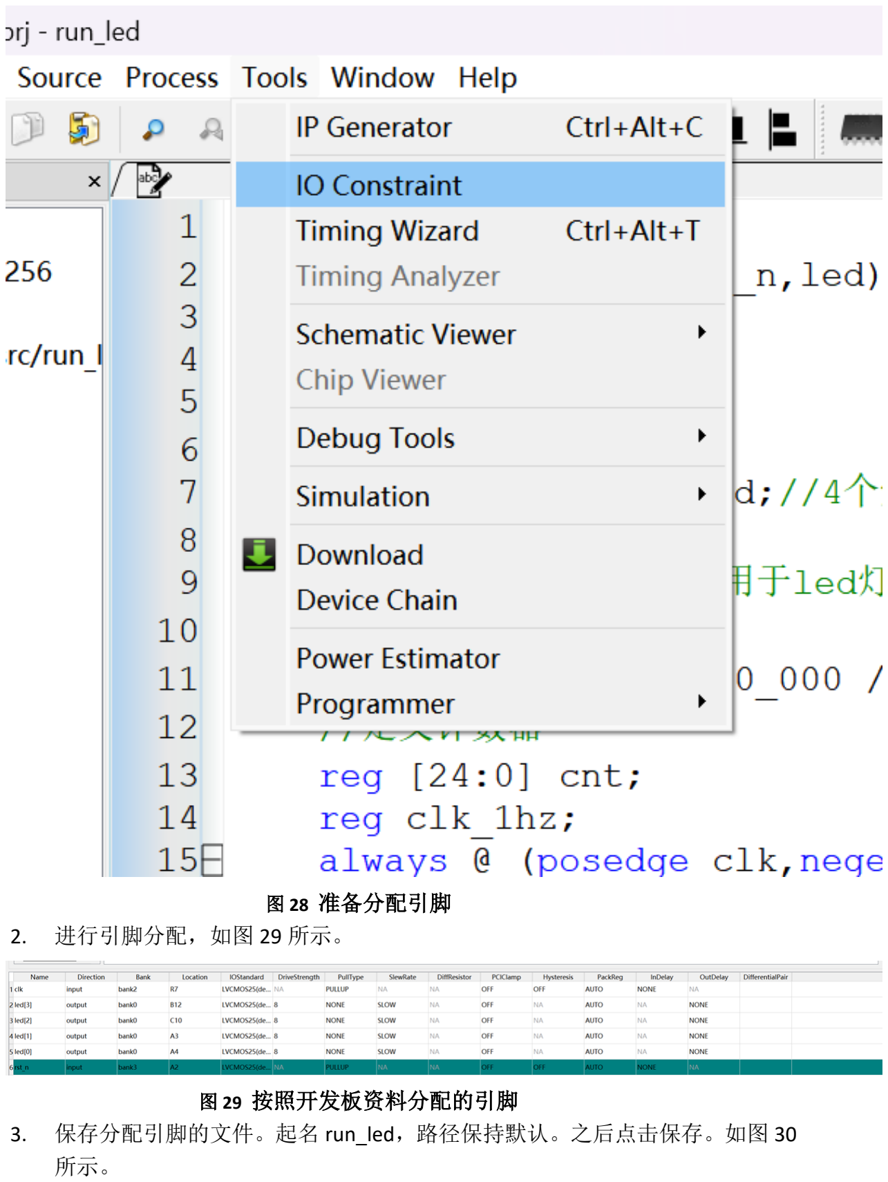
[picture p43: page 18]

图 28 准备分配引脚
2. 进行引脚分配，如图 29 所示。

图 29 按照开发板资料分配的引脚
3. 保存分配引脚的文件。起名 run_led，路径保持默认。之后点击保存。如图 30 所示。

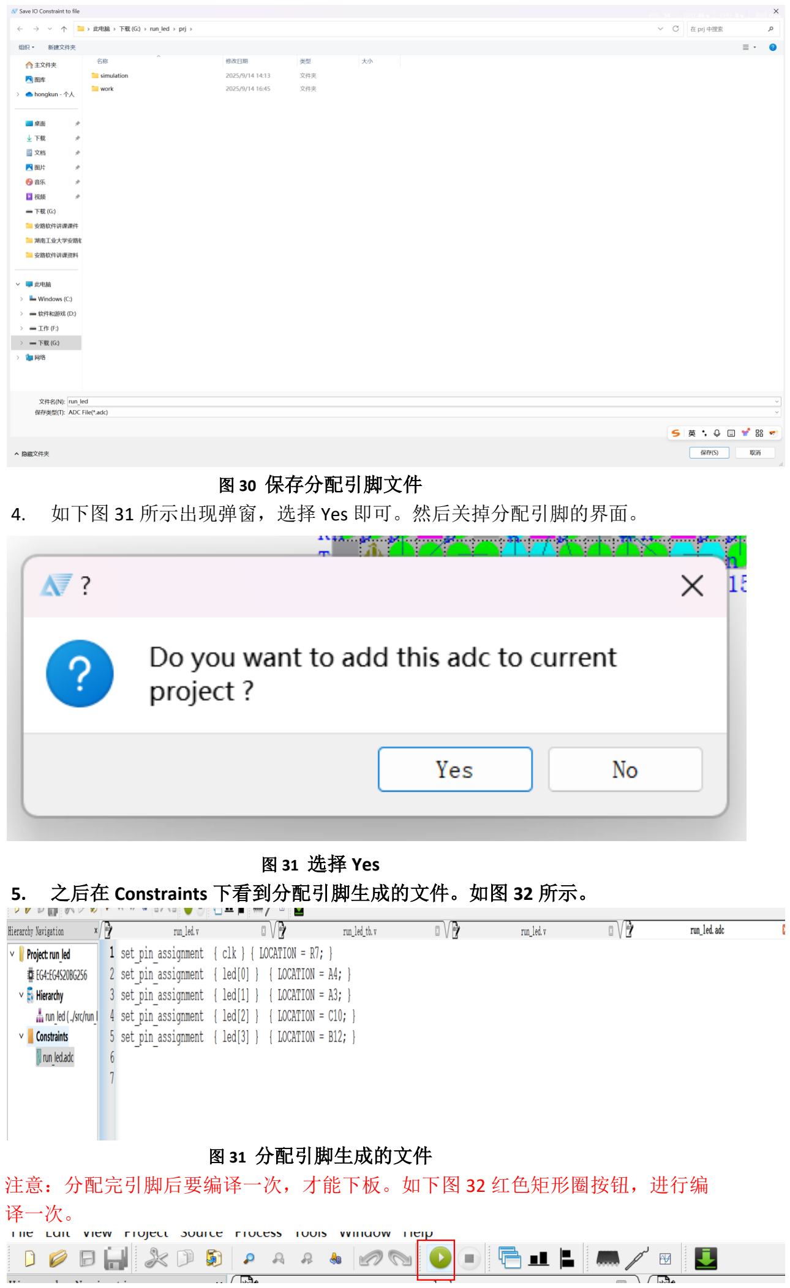
[picture p44: page 19]

图 30 保存分配引脚文件
4. 如下图 31 所示出现弹窗，选择 Yes 即可。然后关掉分配引脚的界面。

### 图 31 选择 Yes

### 5. 之后在 Constraints 下看到分配引脚生成的文件。如图 32 所示。

图 31 分配引脚生成的文件
注意：分配完引脚后要编译一次，才能下板。如下图 32 红色矩形圈按钮，进行编 译一次。

图 32 分配完引脚后编译一次

## 下板验证：

### 1) 选择 Tools->Download 进行下板。如图 32 所示。

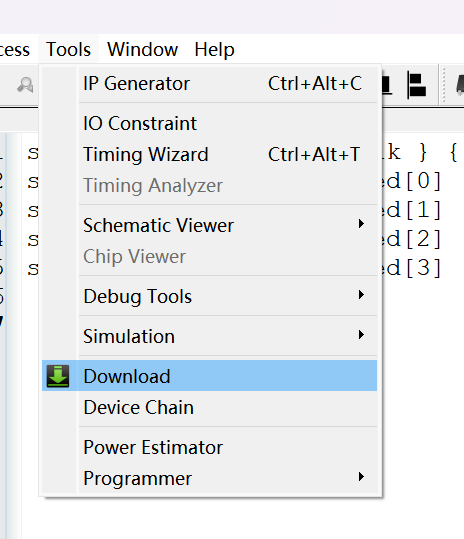
[picture p45: figure]

图 33 进行下板
2) 如果打开之后点 File Selection 下没有烧录文件，击 add 进行添加。如图 34 和 35 所示。点击打开。

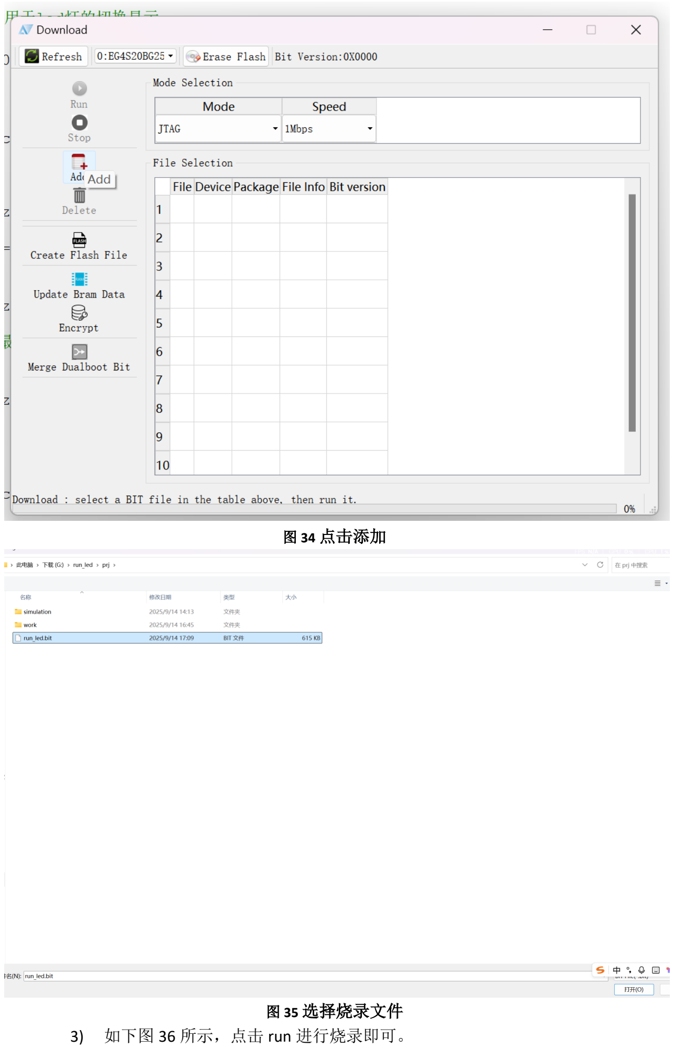
[picture p46: page 21]

图 34 点击添加

图 35 选择烧录文件
3) 如下图 36 所示，点击 run 进行烧录即可。

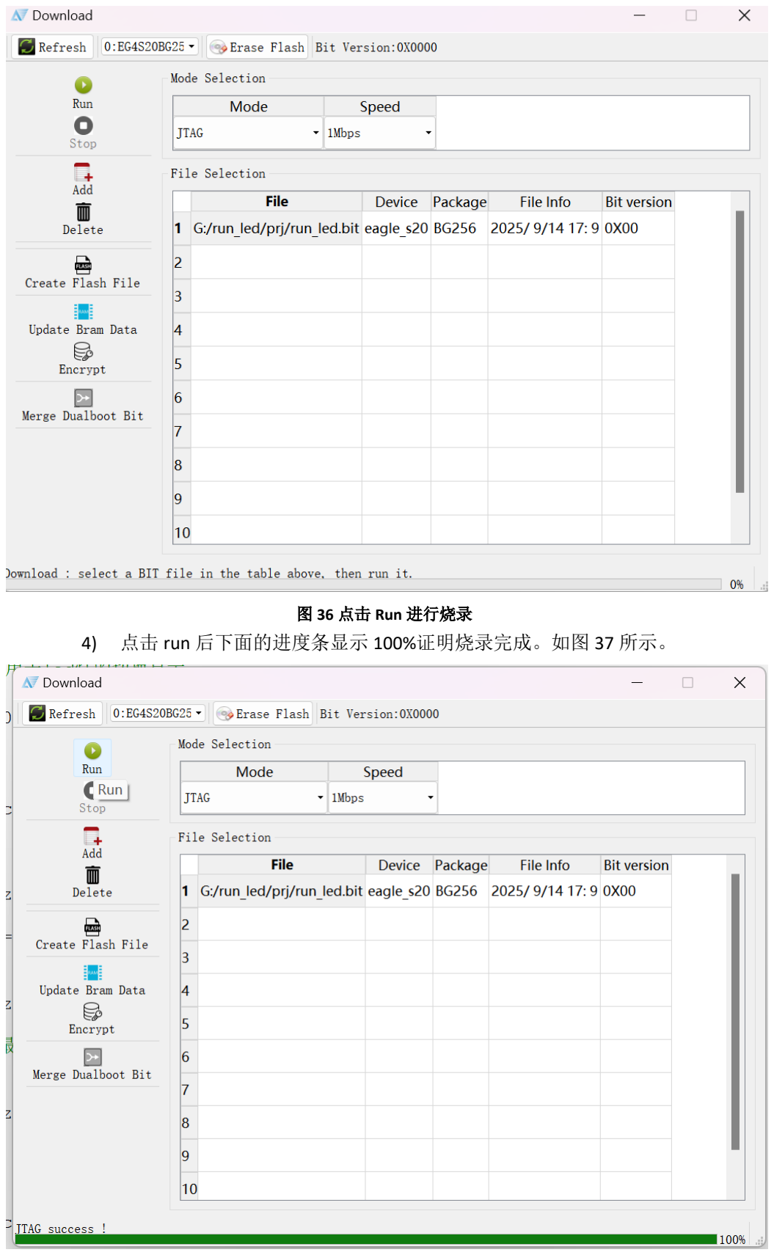
[picture p47: page 22]

图 36 点击 Run 进行烧录
4) 点击 run 后下面的进度条显示 100%证明烧录完成。如图 37 所示。

图 37 烧录完成

## 下板结果：

如下图 4 个，显示的是流水灯从右到左依次点亮的结果。

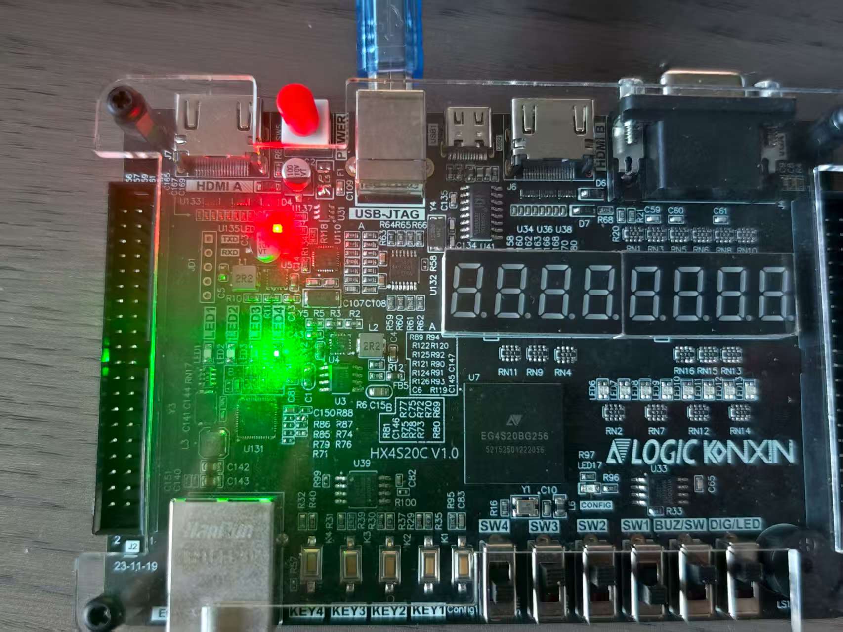
[picture p48: figure]

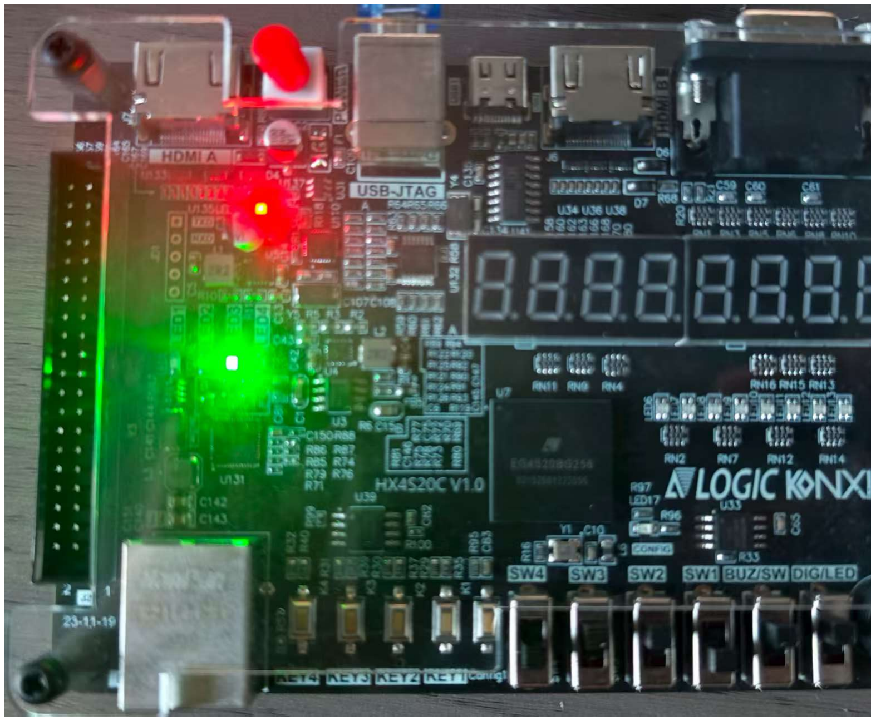
[picture p49: figure]

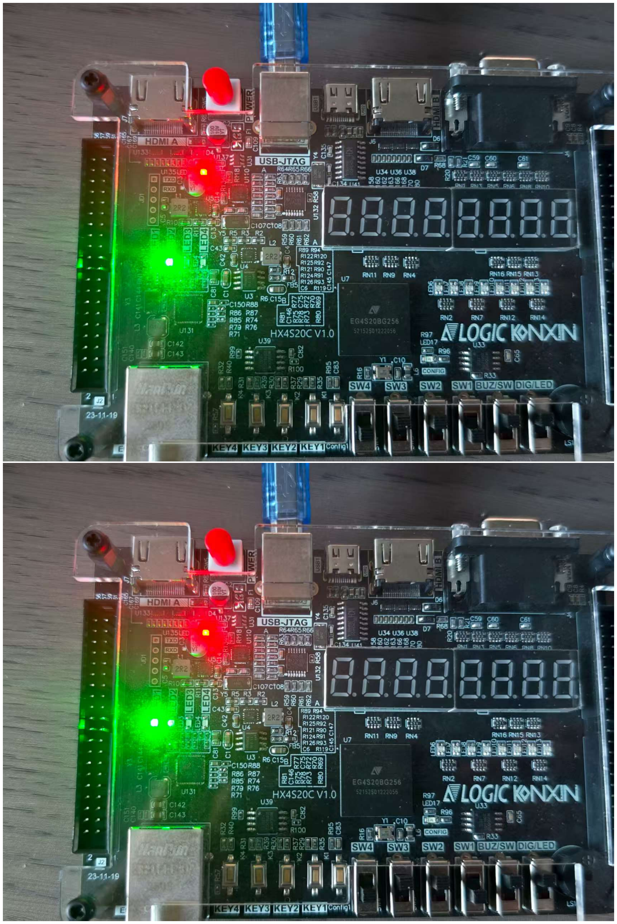
[picture p50: figure]
