czp-1-A1/FPGA_Component_Inspector/开发实施/验收记录/20261007_A_EDGE冻结诊断_轮次1/README.zh-CN.md

# EDGE 吞吐修复与冻结诊断候选版（2026-10-07）

本版修正仿真已复现的逐行额外等待，并增加拒帧诊断。软件回归、完整 TD 布局布线和镜像核对完成；实物 EDGE 冻结是否解决尚待烧录复测，不能称已上板通过。

## 烧录文件

- 文件：camera_to_dsi_display.bit（1789539 字节）
- SHA-256：c3a1cce7d4a19d6750c0e6f3e36395a3c2f3d31901834a1b13a76f497a9230f8
- 旧版 video_fix_20261006 保留，可以回退；其镜像与证据未修改。
- 分类仍未标定，界面显示“未标定”符合当前状态。

## 实物复测

不需要固定载带或记录灰度10秒范围。这次只确认视频是否持续更新。

1. 烧录本目录镜像；确认 ANLOGIC 标志下方出现 `ER x LP xxxx WS xxxx`，借此区别旧镜像。
2. SW1、SW2 都拨下进入 RAW，等待2秒后轻轻移动载带，观察10秒。
3. 仅 SW1 拨上进入 GRAY；同样等待2秒并移动载带观察10秒。
4. SW1 拨下、SW2 拨上进入 EDGE；同样观察10秒。
5. 两个 SW 都拨上进入 GRAY+EDGE；同样观察10秒，再拨回 RAW 确认恢复。可重复一轮。
6. 若 EDGE 卡住，先拍全屏，确保标志下的 ER／LP／WS 和页脚 FR／SEC／OF／VF／UF 清楚；随后切回 RAW，记录是否自行恢复。即使 FR/SEC 在变化，也以实际移动载带是否显示为视频更新依据。

KEY1/KEY2仍调曝光−/＋，KEY3/KEY4调增益−/＋。这次保持原曝光/增益/光源，避免引入额外变量。

## 诊断字段

三个新增字段均为十六进制。ER／LP／WS属于上一 AWB early epoch，由现有 CDC mailbox 一起传输，OSD 在显示帧边界一起锁存；切换后先等2秒再读稳定值。OF仍是独立的累计计数，不能说整组52bit都来自同一个视频帧。

| 字段 | 含义 |
|---|---|
| ER | 4bit拒帧原因，可按位相加；见下表。0只表示没有记录这四种原因，不能单独证明完整帧已写入并发布。 |
| LP | Sobel输入端最短行首间隔，单位是CSI处理时钟拍，按1024像素行计数。0表示未量到两个行首，FFFF表示饱和。它不是摄像头原生行时序的直接读数。 |
| WS | EDGE等待行读取信用/出口允许的最长连续等待拍数。RAW/GRAY应为0；FFFF为饱和。 |

| ER位值 | 来源 |
|---|---|
| 1 | 边缘行缓存拒帧 |
| 2 | 摄像头配置无效 |
| 4 | CSI lane异常 |
| 8 | ROI/输入帧完整性保护拒帧 |

例如 ER9=缓存拒帧+完整性拒帧，ERA=配置无效+完整性拒帧。切换瞬间的旧帧可能被主动拒绝；关注模式稳定后是否持续增长VF、持续卡住及ER稳定值。

## 软件验证

- 同一独立逐像素TB：旧Sobel在零行空闲时明确失败，新版11帧四模式、梯度、坐标、末拍和打包验证通过。
- 真实MC bridge、命令FIFO、VI/VO的RAW→EDGE→RAW和GRAY→GRAY+EDGE→GRAY均完整通过；每场景345600写字、1843200显示像素、691200真实MC命令零差异。输入为合成AWB数据，256有效拍+384空闲拍/行。
- MC暂停1000拍仍完整通过；人为暂停2000拍时EDGE明确拒坏，保留旧显示槽，下一RAW完整恢复。该负例是安全拒帧验证，未称视频完整通过，也未称板上实际DDR停顿原因。
- 真实摄像头ISP/AWB：13个短前缀验证SW/epoch恢复、四种诊断原因和每次early原子快照；另1个600行完整EDGE帧（native640有效拍+160空闲拍）验证614400像素、frame_good，以及下一epoch ER0/LP800/WS0。
- 另保留native640有效拍+32空闲拍的完整帧失败输入：累计几何错位、输出不完整。没有板上原生CSI时序测量，不能据此判定实际卡顿原因。
- LP/WS独立18个计数边界场景和逐周期无诊断对照通过；52bit CDC原子性、停钟/恢复/reset通过。
- OSD四模式每帧614400像素比对通过，新增字段帧边界快照通过；原字体/Logo ROM哈希相同。
- 默认16项测试套件中本轮重跑sobel_view和osd，其他验证来自上述独立新增回归；未声称16项全部重跑。

## 构建与记录

TD6.2.168116，PH1P35MDG324 speed3；207个冻结构建输入与当前工程哈希全部相符。最终 setup WNS +0.858 ns、hold WNS +0.020 ns，TNS均0、违例端点均0；16397 slices（77.29%）、48 ERAM、8 DSP。

新增52bit mailbox payload约束匹配208/208，req/ack各2/2，未被覆盖或忽略。完整STA覆盖率94.53%；原有PLL/IO/例程例外约束检查项与警告保留，与旧版警告语义一致，不能称全部路径完美覆盖。

独立冻结记录：开发实施/验收记录/20261007_A_EDGE冻结诊断_轮次1。含207源快照、构建报告、日志、负例、新复测和SHA-256清单。没有提交/推送、烧板或更改摄像头/检测物料算法。
