czp-1-A1/FPGA_Component_Inspector/交接说明.md

# 下一位队员操作说明（2026-10-07）

本端按用户要求停止功能开发；此次仅完成Git提交、推送和交接资料。一个时刻只有一个实现端写代码。当前新镜像是已通过软件验证的诊断候选，**尚未上板验收，实物EDGE冻结根因仍未确认**。

## 1．取得代码并确认接力

远端：https://github.com/czp-1-A1/FPGA_Component_Inspector.git
工作分支：`hx1p35a-contest-work`。不要从main继续，也不要自动把候选合并到main。

代码、镜像和冻结资料已成功推送，代码提交：`7edbb0afca701332d3d11b1d6e5a6cf5d99354fd`；远端SHA已核对。后续交接文字更新不会改变该镜像输入，拉取分支最新HEAD即可。同步信息见根目录`交接同步.json`。

新电脑／新目录（目录全英文、无空格）：

```powershell
git clone --branch hx1p35a-contest-work --single-branch https://github.com/czp-1-A1/FPGA_Component_Inspector.git
cd FPGA_Component_Inspector
git status --short --branch
git log -1 --oneline
```

已有本仓库且工作区干净：先`git fetch origin`，确认当前分支是`hx1p35a-contest-work`，再`git pull --ff-only origin hx1p35a-contest-work`。若有本地改动或提示非快进，先保留改动并核对，禁止reset/clean/强推覆盖。当前电脑可直接接续本工作区，无需重新拉取覆盖。

先读根目录AGENTS.md，再读`fpga/component_inspector/release/edge_diagnostic_20261007/README.zh-CN.md`。详细冻结证据位于`开发实施/验收记录/20261007_A_EDGE冻结诊断_轮次1/manifest.json`，冻结时“未提交”是历史状态；本次Git同步状态以分支和最新提交为准。

## 2．核对镜像与构建输入

本次待上板镜像：

`fpga/component_inspector/release/edge_diagnostic_20261007/camera_to_dsi_display.bit`

SHA-256必须是：

`c3a1cce7d4a19d6750c0e6f3e36395a3c2f3d31901834a1b13a76f497a9230f8`

```powershell
(Get-FileHash -Algorithm SHA256 -LiteralPath 'fpga/component_inspector/release/edge_diagnostic_20261007/camera_to_dsi_display.bit').Hash
$handoffRoot = (Get-Location).Path
$handoffInputs = Get-Content -Raw -Encoding UTF8 -LiteralPath 'fpga/component_inspector/release/edge_diagnostic_20261007/build_inputs.json' | ConvertFrom-Json
$handoffMismatch = @($handoffInputs | Where-Object {
    $handoffFile = Join-Path $handoffRoot ('fpga/component_inspector/' + $_.path)
    -not (Test-Path -LiteralPath $handoffFile) -or (Get-FileHash -Algorithm SHA256 -LiteralPath $handoffFile).Hash.ToLowerInvariant() -ne $_.sha256
})
if ($handoffMismatch.Count -ne 0) { $handoffMismatch; throw '构建输入哈希不符，先核对再继续' }
Write-Host ('207个构建输入核对通过，实际数量：' + $handoffInputs.Count)
```

`.gitattributes`保留工程和冻结资料原始字节，避免Windows换行转换影响SHA-256。验收目录里的source_snapshot是绑定镜像的207份源输入，不是应直接覆盖现工作区的另一个开发分支。

## 3．先复测视频，不做物料标定

保持当前摄像头、130mm距离、光源、曝光和增益。建模尚未固定，不要求载带固定位置；用轻微移动确认视频刷新即可。

按顺序测试，**每次切换先等2秒，再移动载带观察10秒**：

| 模式 | SW1 | SW2 |
|---|---|---|
| RAW | 下 | 下 |
| GRAY | 上 | 下 |
| EDGE | 下 | 上 |
| GRAY+EDGE | 上 | 上 |
| 再回RAW | 下 | 下 |

烧录后ANLOGIC标志下必须出现`ER x LP xxxx WS xxxx`，用它区别旧镜像。KEY1/KEY2调曝光−/＋，KEY3/KEY4调增益−/＋；本轮复测保持这些设置。

若某模式卡住：先拍全屏，保证ER/LP/WS和FR/SEC/OF/VF/UF清楚；再切RAW，记录是否自行恢复。FR/SEC变化不能证明显示画面更新，以移动载带是否显示为准。

复测通过条件：四种模式都持续显示移动画面；稳定2秒后OF/VF/UF不持续增长；切换和返回RAW能恢复。当前“未标定”状态正常，不能把它当分类成功或失败。

## 4．据诊断继续最小修复

ER/LP/WS均为十六进制、属于上一AWB early epoch，Logo下显示的三个字段一起锁存。ER按位组合：1边缘缓存拒帧，2配置无效，4CSI lane异常，8输入/ROI完整性保护拒帧。ER0只表示未记录这四种原因，不证明帧已经完整发布。

LP是Sobel输入端推导的最短行首间隔，WS是EDGE最长连续信用等待，单位均为CSI处理时钟拍；LP不是nativeCSI直接测量。先把照片/计数交给实现端，判断是缓存拒帧、配置/lane或几何完整性原因，再提出最小变更。

已知用户旧版反馈：RAW无花屏；EDGE卡住、返回RAW恢复；FR/SEC变化、VF增长、OF/UF不增长。GRAY计数无新增异常，移动画面尚未直接确认。当前代码修复了仿真确证的逐行等待缺陷，不能当作实物唯一根因已确定。

三类物料为黑带白件、黑带黑件、透明载带。SW组合仍是观察实验。是否保留双算法叠加、后续用哪种检测方案，需用户结合上板结果确认；不要直接新增分类或改阈值。CLASS_CALIBRATED=0，保持未标定。

## 5．记录结果并维护接力断点

新建`开发实施/验收记录/20261007_A_EDGE上板复测_轮次1.md`，不要改写冻结证据。记录：分支/测试提交、bit SHA、摄像头/距离/光源/EXP/GAIN、各模式移动画面结果、进入/10秒后OF/VF/UF、ER/LP/WS、卡住与返回RAW恢复、原始照片路径及人工真值。

随后更新AGENTS.md中的实物结论和下一步。修RTL前保留本轮镜像；修完跑对应仿真、独立TD完整布局布线/约束检查、输出新release和哈希，再上板验证。不要覆盖`edge_diagnostic_20261007`。

回退镜像：`fpga/component_inspector/release/video_fix_20261006/camera_to_dsi_display.bit`，SHA `1584f39b53f315c369feb41617539dbbb944b455ae3fe84a045d7824dcfac0d5`。RAW此前据用户反馈稳定；旧版EDGE有冻结，不能回退后称EDGE通过。

## 验证与工具边界

Sobel零行空闲旧FAIL／新11帧PASS；四模式真实MC逐字逐像素PASS；MC1000拍暂停完整PASS、2000拍暂停明确拒坏并恢复；真实ISP13前缀PASS及1完整EDGE native gap160 PASS，gap32输入FAIL保留。默认16项本轮仅重跑Sobel/OSD，另有诊断18边界、CDC52、真实ISP/MC回归。

TD6.2.168116，PH1P35MDG324 speed3：setup+0.858ns、hold+0.020ns、TNS0；16397 slices/77.29%、48ERAM、8DSP，STA94.53%，既有PLL/IO/例外约束检查项保留。

当前本机：TD `D:/AAA/FPGA.....YZW/bin`，ModelSim `D:/modelsim/win64`，vendor库`D:/AAA/FPGA.....YZW/sim_release`。TD工程入口`fpga/component_inspector/td_project/camera_to_dsi_display.al`，仿真入口`fpga/component_inspector/sim/run_modelsim.ps1`。新电脑需自行安装这些工具并更新本机路径；许可证/软件缓存不由Git传送。

Git包含当前代码、sim源/资产、release、最新20261006视频修复与20261007诊断完整冻结记录，及历史设计说明/现场反馈。`tmp/`、仿真工作库与未选入的旧大型构建缓存留在原电脑；最新验收记录已保留接续所需源/报告/脚本/日志，不依赖tmp才能阅读或烧录。
