czp-1-A1/FPGA_Component_Inspector/开发实施/08_A版静态载带实验.md

# A版静态载带实验

2026-10-02：用户确认近期目标为静止载带的稳定性与正常/空穴准确性；工作距离尚未确定。用户报告现场已经能显示清楚的载带实时画面。这是人工口述，尚未取得本轮原图、录像或镜像对应证据。

## 1. 当前这一轮怎样做

1. 保持现在能拍清楚的位置，固定相机、镜头、光源和载带。记录镜头最下端到载带检测面的距离、元件料号或外形描述、光源亮度及是否动过增益按键。距离是本轮条件，不是最终机械尺寸。
2. 同一检测位置分别放正常件和空穴。正常件完整平放；空穴确认无元件、无工具或手遮挡。真值标记放在画面检测区域之外。
3. 先提供同一条件下的正常与空穴画面各一张，附整体摆放及距离说明，用于选择候选ROI。优先保存HDMI采集的原始1024×600帧；若暂时只能拍显示器，先用于成像判断，不能将屏幕照片中的灰度值直接用作FPGA阈值。
4. 试采建议每类先选5个不同物理穴位，每个静止保持约10秒，正常件再做3次取放复位。此数量只用于探索特征和重复性，不作为正式准确率验收样本量。逐个记录穴位ID、真值、时间和画面文件。
5. 用另一张同平面的毫米尺画面记录视场。不要让尺子进入分类样本；不因缺少最终支架尺寸而停止静态试验。

未明确采集设备前，不假设电脑已经有HDMI采集卡。没有原始像素数据时，可先判断清晰度、反光和可见范围；像素阈值需通过原始帧或后续FPGA统计数据校准。

## 2. 两种测试分开记录

| 项目 | 测法 | 输出 |
|---|---|---|
| 静止稳定性 | 同一穴位不动，逐个有效采集帧计算特征 | 特征范围、结果跳变次数、无效帧；显示重复帧不算新采集帧 |
| 取放重复性 | 同一件取出再放回，回到同一检测位置 | 特征变化及是否跨越阈值 |
| 分类准确性 | 用未参与调参的物理样本测试 | 正常误报数/正常样本数、空穴漏检数/空穴样本数 |

正式测试前确定样本数及误报/漏检目标。初期按现有路线建议每类至少30个独立样本；数量不足如实记录。连拍帧不能扩充独立样本数量。换样过程单独标注，不与静止误判混合计算，但不能把静止误判事后剔除为换样。

## 3. 对应代码顺序

1. **接口验证**：候选位置为`isp_top/u_awb`的96位输出、`data_96bit_to_128bit`之前。先确认像素顺序、同步及复位行为，再冻结接口。
2. **处理和统计**：四像素并行灰度/二值、固定ROI统计，保留原图旁路。先输出统计值，再用样本选择面积、亮度和或其他最小特征；不同时堆叠多套算法。
3. **逐帧判定**：完整ROI采样后输出存在、空穴或无效/等待。无效帧不直接判空穴。样品更换的作废/重新采样方式以及视频中断超时，在接入结果显示前确定；尚未批准具体按键映射。
4. **显示与验证**：显示ROI、处理画面及统计/结果，解决跨域与显示内容关联。仿真覆盖四个lane、非4对齐ROI、首末像素、最后一拍累加、valid间断、复位及截断帧；每次上板集成保存资源、时序和视频证据。
5. **A版交付补齐**：静态判据成立后整合轻量安路Logo及最终界面，执行独立样本、30分钟运行和固化冷启动验收。

## 4. 本轮源码核实与未决项

- 主工程：`fpga/component_inspector/td_project/camera_to_dsi_display.al`；分支`hx1p35a-contest-work`，HEAD `f87ccf1c6a38e84b58a4f86cecd532a71ae56e89`。已有未提交增益48修改，本轮未动。
- `awb.v`输出96位，包含4组RGB888，组内为R/G/B从高到低；各组的空间左右顺序仍须用坐标测试向量核验。
- `awb.v`的`O_tuser = I_tuser`，没有跟随像素处理延迟；`O_tlast = !valid_d1 && valid_d2`。不能直接套标准SOF/EOL假设。
- `isp/data96_128/data96_128.v`实际定义`data_96bit_to_128bit`：4个连续96位有效拍打包成3个128位有效拍；输入无效即重置打包计数。新增处理流水线必须保留所需连续性。
- 当前链路没有实现可依赖的上游回压，不能通过拉低ready暂停相机。
- 检测结果帧标识、无效策略、显示帧关联、ROI和阈值尚未冻结；本轮没有新增检测RTL。
- `tmp/gain48_td_build`是带Logo/文字的不同副本，不等同主工程。已有报告：Slice 14357（67.67%），ERAM31，DSP9，Setup/Hold WNS 154/20 ps，TNS均0。只说明已有构建报告，不代表本轮上板通过。
- 临时副本`best_result/camera_to_dsi_display_compress.bit`本轮读取SHA-256：`D60526429D6AF8AA1D69F36D725B8EB2781EEF613C2CF200C69AAAEDC2A30E75`。现场当前使用的镜像未知，不能默认就是该文件。
- PATH中未发现`iverilog`或`verilator`；未据此判断所有安装位置均无仿真器。尚未启动仿真、构建、下载或设备操作。

下一步：取得当前正常/空穴画面、距离和采集方式；确定可复现的ROI及原始像素数据来源。随后完成接口仿真准备与最小特征方案。
