czp-1-A1/FPGA_Component_Inspector/开发实施/09_四键成像调参与视频验收.md

# 四键成像调参与视频验收（2026-10-03）

## 范围

当前版本用于静态载带成像实验：固定样品，筛选工作距离、曝光、增益和光源强度。四键调参、参数显示、输入监测属于本版；ROI正常/空穴分类仍待样本确定后实施，不能据此称完整A版通过。

正式入口：`fpga/component_inspector/td_project/camera_to_dsi_display.al`。本机目录为`D:/BaiduNetdiskDownload/HX1P35A_Contest_202606/FPGA_Component_Inspector`。原消息中额外下划线分隔的路径不存在。TD依赖使用英文目录和相对路径。

## 交付与现场分工

用户负责下载和上板调试，Codex负责代码、仿真、TD构建及针对反馈修复。交付位流位于`fpga/component_inspector/release/experiment_20261003/camera_to_dsi_display.bit`；版本清单在同目录manifest.json。当前六项仿真通过、TD已生成位流，用户确认清楚实物画面和参数叠加。四键实测、输入FPS数值、30分钟稳定性和固化冷启动仍待用户记录。资源/时序/约束覆盖及原始报告见`开发实施/验收记录/20261003_按键调参与输入测量_轮次1.md`。

## 操作

| 按键 | 管脚 | 功能 |
|---|---|---|
| KEY1 | D5 | 曝光减16个半行单位 |
| KEY2 | A9 | 曝光加16个半行单位 |
| KEY3 | B9 | 增益减1档 |
| KEY4 | C7 | 增益加1档 |

低有效，20ms消抖；长按500ms后每60ms重复；同一参数加减同时按下不改变。复位默认曝光2244、增益档48；不保存实验参数到Flash。曝光范围3~2244，由当前VTS=1127及传感器手册2*VTS-10确定；改变帧长时必须同步修改该界限。短按曝光步长16半行，触及边界时饱和，因此边界处最后一步可能小于16。

曝光不是微秒：EXP表示半行数。准确时间需核实传感器行时间、像素时钟及配置后再换算。GAIN是查表输入档号；16对应1倍、48对应2倍、80对应4倍。16~47的倍数为1+(档号-16)/32；48~79为2+(档号-48)/16；80~89为4+(档号-80)/8，最大5.125倍。光源强度手动调整并记录控制器档位/电流，未接FPGA自动控制。

初始化写完121项后，索引清零写5项曝光/增益，修正旧流程的表索引越界。配置期间保持曝光/增益整对不变，期间按键产生的新设定在本次完成后补写。CFG表示配置写入流程完成；不是传感器读回确认，须同时检查I2C错误并观察成像变化。手册说明调参在N+2帧生效，调完等待至少数帧再记录。

## 屏幕字段

第一行EXP/GAIN为十进制，EXP单位HALF-LINE，GAIN单位INDEX。INPUT为在接收支路测得的有效像素宽度、有效行数，FPS为每个1秒窗口收到的帧开始数；量化误差约±1帧/秒，连续观察多个窗口。测量使用独立板载50MHz计时，与HDMI刷新无关。HDMI标注1024x600、像素时钟约52.002MHz；总时序1344x635，名义刷新约60.935Hz，这是输出配置值，实际显示器识别模式另行记录。

标为HEX的计数均是十六进制：

- LANE：MIPI lane_error新断言事件数，同拍多个lane错误合记一次；不等于坏像素数。
- FORMAT：不一致行宽、尺寸偏离1024x600、未结束帧被新帧打断、溢出或未排空数据的异常帧计数。
- I2C：总线NACK标志上升事件数，不承诺逐字节失败计数。
- GAP：整秒窗口没有收到任何输入帧的累计次数；短于1秒的停流未必计入。
- FRAMES：输入帧开始累计次数；SECONDS：本次复位后的50MHz计时秒数。

LANE/FORMAT/I2C/GAP为16位饱和计数，FRAMES/SECONDS为32位饱和计数，复位清零。没有CRC/ECC、DDR FIFO溢出、撕裂和重启事件的完整自动计数。花屏、黑屏、冻结、撕裂、重启由现场观察独立记录，不能把这些项目填为零仅因现有计数为零。

## 接口与实现依据

输入监测在RAW10解包后、固定尺寸uial2axis之前：40位=4个10位像素，valid可能隔拍出现。HS-valid下降后延迟16拍等待CSI/RAW10流水排空，完成该数据包的像素统计；零像素短包不作为图像行。FS清零本帧，FE发布尺寸；该方法依赖原接口一行一个RAW10包和足够包间间隔，已使用现有CSI/RAW10源码联调仿真，实物须复核。

尺寸/计数和摄像头设定使用稳定寄存器邮箱握手跨时钟传输；源保持完整快照至应答返回，目的同步请求后一次采样。源MIPI→50MHz受既有异步时钟组约束，50MHz/24MHz→HDMI采用19ns datapath-only上限，小于请求两级同步到采样的最小38.46ns稳定期；只对这两个邮箱的负载和首级令牌同步器设置，未放松ISP/DDR/HDMI内部路径。原I2C分频时钟改成摄像头时钟域的上升/下降时钟使能，保留总线半周期和协议状态顺序，消除普通逻辑时钟保持违例。

新增OSD在HDMI mixer之后，视频/DE/HS/VS统一延迟2拍；字段在垂直消隐时锁存，16拍移位加3转十进制，像素路径不做变量除法。顶部704x80区域显示参数，其他区域保留视频。ENABLE=0可旁路OSD（延迟仍为2拍）。字体5x7放大2倍，使用小组合常量，不复制完整Lab3。

位宽：坐标x11位覆盖1024、y10位覆盖600；曝光/增益/输入尺寸/错误16位；一秒计数26位覆盖50,000,000；毫秒计数15位覆盖24,074；消抖/长按10位覆盖500ms；BCD20位保存5位十进制。小计数器/字体预计LUT与FF，沿用视频31 ERAM、8 DSP；最终以TD报告为准。

## 验证顺序与验收

1. 仿真：按键、消抖、长按、边界、双键、启动表、忙握手；输入尺寸/异常/停流；现有CSI/RAW10联调；邮箱原子性/停钟/复位；实际I2C起止/字节/ACK/NACK；OSD数字/像素。主要使用`sim/run_modelsim.ps1`，这六项已通过；新增打包边界也通过，原厂RAM像素测试存在已记录的悬空输入失败，详见sim/README.md。`sim/run_iverilog.ps1`保留辅助验证，可用参数IcarusBin指定工具目录。
2. TD：综合及完整布局布线，保存资源、建立/保持、check_timing、例外报告和日志。失败轮次单独保留。无解释的关键未约束路径不得称完全时序验收通过。
3. 冻结镜像：保存源码清单、TD版本、bit SHA-256和下载日志，先SRAM验证；不能边测边换镜像。
4. 上板：确认真实载带画面、四键、INPUT/FPS、显示器识别的HDMI模式；复位确认默认值。拍照用于证据，不替代原始像素数据。
5. 连续30分钟：以有效画面开始，记录0/5/10/15/20/25/30分钟的全部计数、输入FPS以及目视六项异常；末尾SECONDS比开始至少增加1800（十六进制差至少0x708），独立现场时间核对。出现异常保留失败记录，再修复重测。
6. 稳定后按板卡Flash流程固化，记录启动介质/拨码/下载模式/镜像/校验。关闭电源、断开可能供电的USB后再次上电，验证无需JTAG自动运行。最终A版整合还须重做冷启动。

## 成像组合记录

后续修复版：用户确认RAM只读输入接零后，当前ModelSim默认八项通过、TD资源及时序复核通过；新位流在`release/experiment_ramfix_20261003`，详见RAM只读端口修复验收记录。原厂RAM悬空失败为修复前记录。该版仍不包含ROI/分类，本轮未做上板验收。

每次只改变一个变量，固定载带与照明角度；先同一距离调整光源和曝光，再比较增益档，随后改变距离重复。记录反光饱和、暗部细节、边缘清晰度和噪声。当前无分类算法，检测准确率字段填“待实现/待测”。

| 编号 | 镜头端面到载带mm | EXP半行 | GAIN档/倍数 | 光源档/电流 | INPUT/FPS | 反光/噪声/细节 | 正常/空穴样本ID | 检测结果 |
|---|---:|---:|---|---|---|---|---|---|
| 待填 | | | | | | | | 待实现/待测 |
