czp-1-A1/FPGA_Component_Inspector/开发实施/10_A阶段后续实施确认稿.md

# A阶段后续实施确认稿（2026-10-03）

状态：批次1接口验证和RAM最小修复已完成；用户随后批准扩大到帧保护＋ROI灰度处理与统计，先选择中央256×128临时观测框，上板后已确认扩大为512×256。当前实施范围见14说明及本轮验收记录。用户负责下载和现场调试；后续分类、字体美化及A整合仍先确认具体范围。

后续进展：ModelSim复核定位RAM B口未连接web后，用户确认最小修复；现已显式接零，默认原厂模型八项测试通过。13稿的帧对齐/完整性保护已纳入14批次，生成专用SOF、采集/处理帧保护、四像素ROI统计和显示灰度框。历史失败与本次修复分开记录。

## 已知起点

用户确认有清楚实物画面和参数叠加；确认按键有效、亮度有响应。这里只证明基本按键功能，不扩大为长按、限幅、双键、30分钟或冷启动实测通过。当前工程四键用于曝光减/加、增益减/加，保留映射。

用户认为OSD字体和排版不好看，后续希望只保留曝光与增益。用户已确认：仅精简调参字段，A计划的ROI框、识别结果和安路Logo保留。当前实现临时观测界面：上方EXP/GAIN和ROI统计，底部独立验收监测；字体美化、分类结果和Logo待后续A整合。已有视频监测数据不能因精简界面而补填通过。

前一RAM修复基线Slice63.75%，31 ERAM、8 DSP，已约束路径建立/保持WNS 0.555/0.020ns；STA覆盖95.18%，外部I/O及硬IP约束仍需复核。保留已生成实验位流作为对照版本。

## 批次1：固定成像条件与核实像素接口

现场：继续记录镜头端面到载带面的距离、曝光半行值、增益档、光源强度，正常/空穴用同一条件观察；同平面毫米尺用于测实际视场。先选一种元件和一种载带，再确定可重复放置的单穴固定ROI。最终距离和单穴ROI坐标不预设，当前使用用户批准的中央临时观测框。

代码准备：核实AWB后RGB888四像素顺序、valid间断、帧/行边界与延迟。现有O_tuser未跟随像素流水，不能直接当作已对齐SOF使用。仿真确定坐标与首末像素，无回压暂停相机。确认后才能冻结检测接口。

通过条件：正常/空穴细节在固定位置重复可见；像素顺序与帧行时序有测试证据。单靠拍显示器不标定FPGA像素阈值。

## 批次2：固定ROI的最小处理与统计

实现可旁路灰度或二值处理、固定ROI与逐帧统计，沿用现有视频/DDR链路。先根据样本比较亮度或阈值面积，选一个最小有效特征；不预先叠加边缘、角度、极性、多帧算法。任何二值阈值、ROI或判别阈值须由有效样本确定，不能任意填写后宣称检测完成。

验证：四像素并行、非4对齐ROI、首末像素、最后一拍累加、valid间断、复位和截断帧；每次集成综合/布局布线并记录资源增量。原始帧优先；如无采集设备，先拟定FPGA统计校准方式并确认观测出口。

通过条件：定点统计与参考模型一致，能直接观察处理画面；正常/空穴特征存在可重复分离范围。

## 批次3：单帧正常/空穴判定

每个有效采集帧完整ROI采样后生成结果；无效/截断/停流显示等待，不能把无效帧直接判空穴或沿用旧结果。换样期间的作废/再采样方式需在接入结果显示前明确，不占用已固定的四个调参键。检测帧与DDR显示画面的关联在实现前确定；未验证关联时不把新结果画到旧帧上冒充对应。

先建立独立物理样本、真值与调参/测试划分，建议正常、空穴每类至少30个独立样本；同一穴位多帧只评估稳定性。正式测试前由用户确认正常误报与空穴漏检目标，不预设准确率承诺。

通过条件：静止时结果稳定，取放可复现，独立测试达到预先确认目标，失败样例保留。

## 批次4：界面与A版整合验收

字体和排版后期一起调整。调参区域只保留曝光/增益，曝光标明半行单位、增益标明档号；保留A阶段ROI框、识别结果和安路Logo（用户已确认）。处理画面与结果显示、必要的验收监测观测方式一并冻结，不能删掉现场证据入口后宣称完整验收。

完整A版同一镜像完成：综合/布局布线/约束复核、真实样本测试、连续30分钟、Flash固化与断电自动运行；建议3次冷启动。已有视频基线30分钟及早期固化记录仍待用户补齐，最终A版再测试。现场由用户操作和记录。

## 下一次拟实施范围

当前已获确认并实施帧保护＋ROI灰度统计，范围限定于14说明。交付后先用正常件和空穴记录同条件MEAN/MIN/MAX稳定范围，再由用户确认正式单穴ROI及最小分类特征。运动、编号、NG队列、电机控制继续归B/C。
