czp-1-A1/FPGA_Component_Inspector/开发实施/11_静态成像条件与样本记录.md

# 静态成像条件与样本记录（2026-10-03）

## 当前条件：临时实验点，不是最终机械或算法参数

| 项目 | 用户报告 | 状态 |
|---|---|---|
| 元件 | LM358DR | 已明确本轮对象 |
| 距离 | 镜头端面到载带约280mm | 约数，待尺测；不锁定为最终距离 |
| 机构可调距离 | 约60～400mm | 建模可调范围，不代表全范围都能清晰成像 |
| EXP | 1460 | 屏幕口述值，单位半行 |
| GAIN | 90 | 用户报告原值；代码上限89，差异待现场核对，不擅改为89 |
| 光源强度 | 未测 | 后续记录控制器档位或电流 |
| 采集方式 | 尚不确定 | 不假设已有HDMI采集卡 |
| 画面、参数叠加 | 清楚 | 人工反馈 |
| 按键及亮度 | 按键有效，亮度有响应 | 人工反馈；非长按/边界/双键完整验收 |

这些条件影响后续灰度/面积分布，但不阻塞像素接口验证。此表用于追溯实验条件，不要求现在定死参数。先在当前约280mm位置固定机位和照明，比较同位置正常件与空穴；每次只改变一个变量，允许慢慢调整。距离变化后重测视场与候选ROI，曝光/增益/照明变化后重测特征分布，不套用旧阈值。

## 一轮最小现场操作

1. 固定载带、相机和光源角度，用尺记录镜头端面到元件所在平面的距离；注明是否调整焦距、是否清楚。
2. 记录屏幕EXP/GAIN与光源档位（没有档位则记录当前控制器状态，电流未测写未测）。记录输入尺寸/FPS；HDMI刷新率单独记录。
3. 将毫米尺放在元件同平面，记录可见刻度及有效画面范围；拿走尺后再采分类样本。
4. 同一位置放LM358DR正常件和确认无元件的空穴，先各5个独立穴位探索，每个静止约10秒；正常件做3次取放复位，观察反光、暗部、边缘、噪声及装夹偏移。这些数量不作为正式准确率验收样本数。
5. 原始帧可获取时保存像素帧和对应条件；只能拍显示器时先用于候选ROI/清晰度判断，不把屏幕照片灰度当作FPGA阈值。没有原始帧时，先用14版屏幕MEAN/MIN/MAX记录有效样本分布，再决定分类特征与阈值。

当前无需遍历60～400mm全部距离。先验证一个清楚、可重复的临时实验点，再按成像效果尝试其他距离。

## 条件组合

| 组合ID | 实测距离mm | EXP半行 | GAIN档 | 光源档/电流 | 焦距/倾角变化 | INPUT/FPS | 正常/空穴清晰度、反光、噪声 | 帧或照片文件 |
|---|---:|---:|---:|---|---|---|---|---|
| E00 | 约280（待尺测） | 1460 | 90（待核对） | 未测 | 未记录 | 未记录 | 用户反馈画面清楚；正常/空穴对照待做 | 未提供 |
| E01 | | | | | | | | |
| E02 | | | | | | | | |
| E03 | | | | | | | | |

## 视场与重复装夹

| 组合ID | 同平面尺可见宽/高mm | 完整穴位数 | 单穴像素宽/高 | 候选ROI左/上/右/下 | 拆装/取放偏移 | 结论 |
|---|---|---|---|---|---|---|
| E00 | 未测 | 未测 | 未测 | 未确定 | 未测 | 不能冻结ROI |

候选ROI采用显示图像坐标，正式接入前对应到已验证的采集像素坐标。用户已批准临时观测框[256,768)×[172,428)，采用半开区间；用于成像与统计调试，不等同于E00已完成单穴标定。

## 样本真值与用途

| 样本ID | 物理穴位ID | LM358DR正常/空穴 | 真值确认方式 | 条件组合ID | 调参/独立测试 | 静止/取放 | 文件 | 备注 |
|---|---|---|---|---|---|---|---|---|
| | | | | | | | | |

真值标记放在ROI外。正式测试按物理样本划分调参集与独立测试集；连拍同一穴位不增加独立样本数。误报/漏检目标在正式测试前确认，当前没有分类RTL，不能填写检测准确率。

## ROI统计现场记录（14批次上板后填写）

每个独立穴位静止约10秒，等VALID后记录MEAN/MIN/MAX各自波动范围；WAIT不记成0或空穴。改距离、EXP、GAIN或照明后另建条件组合。以下仅是记录模板，没有实测数据。

| 样本ID/穴位ID | 条件ID | 正常/空穴真值 | ROI范围 | MEAN范围 | MIN范围 | MAX范围 | VALID/WAIT、画面异常 | 重复取放偏移 |
|---|---|---|---|---|---|---|---|---|
| 待测 | | | [256,768)×[172,428)临时 | 未测 | 未测 | 未测 | 未测 | 未测 |
