czp-1-A1/FPGA_Component_Inspector/开发实施/14_A帧保护与ROI灰度统计_实施说明.md

# A帧保护与ROI灰度统计（2026-10-03）

用户选择扩大范围到“帧保护＋ROI灰度处理与统计”，先选择中央256×128临时观测框；上板后用户反馈框偏小，现已确认扩大为512×256。13稿的帧对齐保护纳入本批；本批已获实施授权，不再停在确认稿。正常/空穴分类仍需实物特征和阈值依据。

## 本版行为

- 当前图像1024×600。扩大版ROI为半开区间 `[256,768)×[172,428)`，共131072像素；这是临时成像观测窗，后续按单穴视场调整，不是已标定的检测区。
- 中央框内显示灰度，边界为绿色，框外保留原色。灰度取 `floor((R+2G+B)/4)`，范围0～255；统计取自AWB后原始像素，显示框线和文字不进入统计。
- 调参区仅保留EXP（半行）和GAIN（档号）；第二行显示ROI MEAN/MIN/MAX与VALID/WAIT。VALID表示最近一次完整采集且处理完整的有效样本，未声称与当前DDR读出帧一一绑定；WAIT显示横线，避免将旧数值当作新样本。
- 底部两行单独保留INPUT/FPS及十六进制LANE/FORMAT/I2C/GAP/FRAMES/SECONDS、CFG，供视频验收记录；输入FPS仍是独立50MHz窗口测得的输入帧数。字体沿用现有5×7，只补充WAIT所需W字形，正式美化后续处理。
- 四键继续只调曝光/增益。距离、照明、ROI不要求现在固定；ROI边界由顶层共享常量定义，改动后需重新构建，本批不增加按键模式或串口菜单。

## 数据与保护

AWB新增独立检测SOF，使用已经存在且与像素对齐的延迟标志；原O_tuser及DDR早帧通知连接保留。坐标按每拍四像素递增，last核对一行256拍，完整处理帧600行。检测支路不使用ready回压，也不改变DDR像素和打包器。

采集保护位于RAW10解包后、uial2axis固定尺寸转换前，核对真实FS/FE、HS包结束16拍排空、每行1024像素及600行；同时检查处理是否超过接收进度。只有采集/处理均完成且候选帧未作废时，发布一次统计。配置忙、曝光/增益/I2C状态变化、通道异常、缺行/缺列、重叠SOF、重复SOF和回放超前均作废。

摄像头状态用稳定邮箱整体跨到接收时钟域；ROI均值、最小/最大值与有效位通过另一稳定邮箱整体跨到HDMI。统计支路用两级寄存器分隔灰度计算和四像素平衡归约，帧首、有效、完成及作废控制同步流水；异常立即取消有效样本并排空待处理控制。平均值在完整帧后用28拍串行除法计算，统计字段一次更新，不在逐像素路径放除法器。新增两个邮箱的payload及请求/应答物理延迟在SDC中单独约束。

原demosaic的两个只读RAM实例也存在未连接web/dib，已与前次AWB修复一样显式接零，以执行原厂模型；没有修改/解密安路库。原demosaic启动时先学习带暂停的首行跨度：本轮测试首帧回放超前被拒绝，第二帧开始正常提交。画面不变成空穴结果，启动/恢复时等待完整样本。

停流时不会重复提交统计；显示端还用独立输入FPS与配置状态作有效性门控。接收时钟停掉后，到下一空的一秒测量窗口才显示WAIT，约1～2秒；不声称毫秒级停流响应。调参期间重新等待完整帧，传感器自身寄存器生效/曝光稳定时刻仍需现场核对。

## 验证与现场操作

ModelSim新增两级验证：ROI单元以独立RGB数学参考核对非四像素对齐ROI、首末像素和异常拒绝；真实RAW10 native→uial2axis→demosaic→AWB→打包/ROI使用原厂RAM，覆盖1024×600、valid暂停、ready低、短行、长暂停回放及正常恢复。完整日志/TD结果按本轮验收记录保存，未测不能填通过。

上板后先把目标穴位放在临时框内，确认框内灰度、框外彩色、四键与底部监测。保持同一条件，正常件与空穴分别静止记录MEAN/MIN/MAX的稳定范围，再改变一个成像变量重测。统计仅说明当前ROI的亮度特征，不能直接填分类准确率。

将来若要精确分类，需重新选单穴ROI，并检查正常/空穴的特征可分性及独立样本；可再选一个最小有效特征或阈值面积。本批不加边缘、运动编号、多帧投票或电机控制。

## 扩大版范围

用户确认512×256，显示及统计共享边界同步扩大，共131072像素。仅4个RTL文件的ROI默认/共享常量变更；20位计数、28位亮度和足够容纳最多131072×255=33423360，沿用原流水与除法。扩大版受影响的OSD、ROI保护及真实ISP统计重新仿真，并用独立TD快照构建。首版256×128的照片与上板反馈保存在20261003_ROI上板反馈_轮次1；新版验收见20261003_ROI扩大512x256_轮次1。大框用于观测与成像调试，正式分类须另外选单穴ROI。
