czp-1-A1/FPGA_Component_Inspector/开发实施/15_A单穴判定与离线验证_讨论稿.md

# A单穴判定与离线验证：下一步讨论稿

2026-10-03拟稿，2026-10-04执行更新。用户确认“暂时不能上板，先做离线准备”，随后用“执行”批准文末最小批次。实现及验证边界见16实施说明；本稿保留原讨论及独立数学参考，不能把人工阈值作为实物标定值。

## 当前起点

512×256临时观测框版已经完成相关ModelSim复测及TD构建，尚未收到该扩大版上板反馈。原256×128版四张屏幕照片和用户反馈证明灰度/彩色观测出口及四键已在现场显示正常；照片不是相机原始帧，也没有同一穴位连续10秒的真值统计。

现有统计来自AWB后四像素并行RGB；只提交完整有效采集/处理帧，已有MEAN/MIN/MAX与WAIT。当前中央大框可能包含多个穴位、定位孔和背景，不能将整个框的均值直接解释为某一个穴位是否缺件。

## 建议推进顺序

1. **明确检测区域与输出语义。** 保留512×256作为成像观测窗；正式分类采用只覆盖一个目标穴位的固定ROI，避开相邻穴和定位孔。坐标先留待实物选定，不任意缩框后声称已标定。判定只代表有件/空穴，不扩展为料号、角度、极性或焊点识别。
2. **先评估现有最小特征。** 用同一条件、同一位置的正常件与空穴比较MEAN稳定范围，MIN/MAX辅助观察亮部和反光。四照片中65～68和83～84属于不同照片内容的瞬时读数，不能据此直接设置阈值或确定判定方向。均值不足以区分时，再根据实物数据评估一个阈值面积特征，不预先堆叠算法。
3. **离线准备判定与有效性测试。** 拟用人工构造、真值明确的RGB帧验证数学和控制：阈值两侧与等值边界、背景/亮点干扰、位置变化、valid暂停、帧截断、配置变化及正常恢复。人工阈值仅为仿真输入，不作为上板标定值。正常/空穴只有在采样有效且标定条件已确认后允许输出；缺少标定或帧无效保持待标定/WAIT。
4. **确认后实施最小代码批次。** 依据选定ROI和特征决定是否只复用均值，还是增加一个必要统计量；保持现有四键。新增判定功能后复测相关ModelSim，再独立TD构建及资源/建立/保持/约束报告，保留现有镜像作对照。

## 显示与换样约定须先明确

现有统计表示最近有效采集样本，没有与DDR读出帧绑定。下一判定版必须明确输出的采集时刻/有效性、换样时如何避免旧结果，以及是否要求和当前显示帧绑定；这些不能仅靠增加NORMAL/EMPTY文字解决。没有验证帧关联前，不在实物图像上叠加对应某元件的NG标记。

正式字体排版和安路Logo可以离线准备，但仍是另一个待确认范围；本讨论稿不自动授权界面改造或增加控制方式。

## 离线能完成与现场仍需完成

| 工作 | 离线进度边界 |
|---|---|
| 接口、位宽、阈值比较及状态方案 | 可以核对/拟定，具体逻辑由用户确认后实现 |
| ModelSim独立参考、人工场景、异常恢复 | 可以验证实现正确性，不等于实物准确率 |
| TD资源与时序、约束复核、镜像冻结 | 代码批次确认后可以完成 |
| 单穴ROI、正常/空穴真值、实物特征分布和阈值 | 要实物数据；距离/曝光/增益/照明可继续逐步调整并记录 |
| 误报漏检、重复取放、30分钟、Flash与冷启动 | 需要现场操作，不能用离线仿真补填 |

建议本次先确认单穴判定的输出与离线测试范围；实物条件未定时不承诺分类阈值或准确率。距离尚未最终确定不妨碍离线设计和仿真准备，后续改变成像条件时重新检查特征与阈值适用性。

## 已准备的人工测试参考

以下是拟用于ModelSim的人工像素输入，不是现场数据。测试ROI可用[1,17)×[2,10)，16×8共128像素，左右边界不与四像素拍对齐。用R=G=B构造灰度40/60/200/255，可避免把待验证DUT自身的灰度输出当作参考。

| 场景 | 人工像素组成 | 像素数 | SUM | MEAN | MIN | MAX |
|---|---|---:|---:|---:|---:|---:|
| 均匀暗区 | 128个40 | 128 | 5120 | 40 | 40 | 40 |
| 中央亮块 | 96个40＋32个200 | 128 | 10240 | 80 | 40 | 200 |
| 单个高亮干扰 | 127个40＋1个255 | 128 | 5335 | 41 | 40 | 255 |
| 阈值等值边界 | 128个60 | 128 | 7680 | 60 | 60 | 60 |

若纯仿真暂取T=60、亮块代表“有件”，则均匀暗区/高亮干扰应在暗侧，中央亮块在亮侧；等值情况须明确采用>=还是>并测试。这一方向和T不写入实物分类参数。单个高亮即使MAX=255，均值也只有41，说明至少要在测试中覆盖反光，不能直接用MAX判断是否有件。

控制场景要求：ROI外改变像素不影响特征；非4对齐边界只数选中像素；无效拍不计数；首末有效拍都计入；帧不完整、配置变化或复位时不输出正常/空穴；无标定始终待标定；下一个完整有效帧恢复。人工判定场景即使通过，也只能证明逻辑按约定工作。

## 下一批拟确认的最小范围

优先复用现有均值统计，增加单帧比较与待标定/WAIT状态的离线验证；不先增加多个特征。正式ROI、阈值和判定方向取得同条件单穴数据后再启用实物分类。用户已用“执行”确认这一批测试台＋判定RTL与独立RECENT状态行；每次native FS清旧判定、等待新样本，最近统计继续保留供调参，默认未标定。正式字体与Logo仍不在本批范围。
