czp-1-A1/FPGA_Component_Inspector/开发实施/16_A均值判定与离线验证_实施说明.md

# A均值判定与离线验证

2026-10-04，用户已用“执行”确认15稿最小批次；当前不能上板。本批实现单帧均值比较与有效性控制，继续使用512×256临时观测窗，交付参数默认未标定。它是A阶段的离线准备，实物单穴判定和完整A验收尚未完成。

## 输出规则

| 状态编码 | 屏幕文字 | 条件与含义 |
|---|---|---|
| 0 | RECENT UNCAL | 未启用标定，或曝光/增益不匹配已标定配方 |
| 1 | RECENT WAIT | 已标定，但新帧仍在采集/处理，或出现无效帧/配置变化/复位，尚未得到新样本 |
| 2 | RECENT PRESENT | 新的完整有效采集样本，均值处于设定的有件一侧 |
| 3 | RECENT EMPTY | 新的完整有效采集样本，均值处于设定的空穴一侧 |

亮侧有件：MEAN≥T；暗侧有件：MEAN≤T。等值属于有件侧。PRESENT只表示该ROI按均值条件有件，不表示料号、角度、极性或其他质量全部合格；EMPTY也不是已关联穴位编号的NG事件。

每个native RAW帧开始立即在CSI域抑制旧判定，等待本帧统计完成。配置无效、lane错误、帧保护invalidate、sample_valid撤销或复位均清除新鲜标志。UNCAL优先于WAIT；重新启用标定时，旧的sample_valid不足以恢复分类，必须收到新的sample_new。模块接口改变threshold/present_high前应撤销calibration_ok至少一个源时钟周期，并等待新样本；交付顶层参数为编译常量，无运行时阈值修改入口。

保留调参需要的最近完整MEAN/MIN/MAX：正常的新帧开始不会撤销旧统计显示，但会取消未完成的除法以及仍在流水中的旧commit。源帧无效仍撤销统计有效性。统计、判定的含义不同，不能用统计的VALID替代分类的新鲜标志。

## 接入与时序

- 原native RAW10→真实demosaic→AWB→DDR打包显示路径不插入回压或缓存。新增判定仅观察AWB后统计；四像素顺序、灰度公式和ROI逐像素掩码保持。
- `roi_statistics`仍是两级归约＋帧后28拍顺序除法；增加1位sample_new，同一源时钟边沿与mean/min/max/count/sum/sample_valid原子发布，持续一拍。native frame_start及其两级延迟取消旧计算，不清除已完成的调参统计。
- `roi_classifier`仅增加1位fresh寄存器和8位均值比较；正常接收sample_new后的下一源时钟边沿置fresh。没有新增ERAM、DSP或除法器。状态为2位，覆盖四种情形；未标定为算法旁路，原始显示继续工作。复位fresh=0。
- 顶层将状态与原25位有效/mean/min/max一起放入27位status_cdc邮箱，CSI→HDMI稳定握手；原低25位排布保持。源payload保持至应答，目标不会拼接不同邮箱快照。继续使用已有payload/req/ack物理延迟约束。
- OSD在显示VS起始锁存统计有效性和2位判定状态，同一显示帧不撕裂状态文字；只增加第三行RECENT信息，原两拍视频与同步延迟保持。摄像头配置未就绪或输入FPS为0时，已标定状态显示WAIT；CSI时钟彻底停止的检测沿用输入监测，约1～2秒，并非即时停止检测。

结果尚未绑定DDR读出帧。RECENT表示最近采集结果，不能解释为当前显示画面的逐穴判定；新帧开始的WAIT跨邮箱并等到下次显示VS后可见，可能存在邮箱/一个显示帧的显示滞后。人工换样后的在途旧图像与光学变化不由软件自动识别，静止后等待新完整样本再读取。结果不画在具体元件上，不产生运动控制事件。

## 交付参数与下一次实物标定

`design_top_wrapper.v`集中定义ROI及分类常量：

| 参数 | 本次值 | 说明 |
|---|---:|---|
| ROI | [256,768)×[172,428) | 131072像素，临时观测框；可能覆盖多个穴位和定位孔 |
| CLASS_CALIBRATED | 0 | 默认禁用；本次下载应显示UNCAL |
| CLASS_THRESHOLD | 0 | 无效占位，不能当现场阈值 |
| CLASS_PRESENT_HIGH | 1 | 无效占位，不能认定实物一定亮侧有件 |
| CLASS_EXPOSURE / CLASS_GAIN | 2244 / 48 | 禁用状态下的占位；未来应填真实标定时的曝光/增益 |

后续在同一距离、光源、曝光、增益与ROI下记录正常件/空穴的连续统计，固定单穴ROI，比较分布后再设T与方向。曝光/增益变化会使已标定状态变UNCAL，恢复匹配设置也必须等新样本；机械距离、照明与目标变化需人工作废配方，当前硬件不测这些量。均值分布重叠时，先调整成像或根据实物数据讨论新的最小特征。

默认CLASS_CALIBRATED=0会使综合工具优化分类比较逻辑；本次TD报告证明交付配置的资源与时序，不能移作未来启用配置的布局布线证明。启用或修改ROI/阈值/方向/配方后，必须重新做ModelSim及TD检查，再冻结新bit。

## 可复现验证

在`fpga/component_inspector/sim`执行`./run_modelsim.ps1`，默认11项；没有启用强制覆盖未连接RAM输入。`classifier`独立人工ROI为[1,17)×[2,10)，16×8共128像素，左右边界非四像素拍对齐。数学期望直接使用以下值，不从DUT输出反推答案：

| 人工输入 | SUM | MEAN | MIN/MAX | 仿真T=60、亮侧有件 |
|---|---:|---:|---|---|
| 128个40 | 5120 | 40 | 40/40 | EMPTY |
| 96个40＋32个200 | 10240 | 80 | 40/200 | PRESENT |
| 127个40＋1个255 | 5335 | 41 | 40/255 | EMPTY |
| 128个60 | 7680 | 60 | 60/60 | PRESENT |

另测暗侧有件、阈值±1/等值/0/255、框外黑白变化、有效拍间断、native短行、处理短行、配置取消正在进行的除法、native FS取消旧计算、lane错误、重置、未标定及重新启用不复用旧样本、异常后正常恢复；27位异步邮箱核对完整快照。单个亮点测试仅证明给定人工输入的数学行为，不承诺所有实物反光都不影响分类。

真实链路`roi_chain`继续使用1024×600、7帧native RAW10、真实demosaic/AWB/原厂ERAM/GSR/除法网表及独立RGB统计参考，增加纯仿真T=110亮侧比较。正常120应PRESENT、100应EMPTY，短行与长暂停回放WAIT；不将T=110写入交付顶层。OSD验证四状态文字/字模、VS快照、灰度/绿色边框/框外彩色及统计WAIT。

仿真不包含物理MIPI/DDR/HDMI端到端，不包含实物标签、准确率或30分钟稳定性。资源、时序、约束覆盖及bit哈希以本轮验收记录为准；既有外部I/O/PLL/DDR约束缺口须保留说明，不能把正WNS解释为所有路径完全约束。

## 待现场完成

扩大版与本版画面、四键及最近统计现场复核；正式单穴ROI与有件/空穴真值采样；阈值和方向冻结；误报/漏检、重复取放、输入FPS/HDMI模式记录；30分钟观察；按板卡流程固化及断电冷启动。Logo和整体字体美化仍留后续批准批次。
