czp-1-A1/FPGA_Component_Inspector/开发实施/18_A单穴80x80取样_实施说明.md

# A单穴80×80取样，实施说明18

2026-10-05用户回复“可以”，批准17稿。本批保留512×256灰度观测框，中央增加80×80青框，现有单个统计单元只统计青框区域；默认未标定。此文件描述实现，最终ModelSim/TD数值和镜像身份见同日验收记录，不把构建当成上板通过。

## 区域和显示语义

| 用途 | 半开坐标 | 像素数 | 显示 |
|---|---|---:|---|
| 成像观察 | [256,768)×[172,428) | 131072 | 灰度，绿色外框 |
| 单穴内部核心统计 | [472,552)×[260,340) | 6400 | 青色外框，内部仍为灰度 |

MEAN/MIN/MAX/VALID仅来自青框。第三行增加`CYAN 80X80`，RECENT继续显示UNCAL。青框表示取样区域，不是对元件轮廓的自动识别框。它应落在同一个穴位内部，排除邻穴、大定位孔和台面，无需包住整穴。

## 最小RTL改动

- `design_top_wrapper.v`保留ROI观测常量，增加SAMPLE取样常量，将SAMPLE传给ISP统计和OSD青框。原CLASS_CALIBRATED=0、四键控制、1024×600及27位邮箱不变。
- `isp/isp_top.v`默认统计区域改为80×80，继续显式传给既有roi_statistics。通用roi_statistics自身默认参数未改，生产实例以ISP参数为准。
- `experiment_osd.v`增加四个静态SAMPLE坐标参数、青框边界及说明字样，青框像素优先于灰度背景。ENABLE=0保持视频旁路，颜色和HS/VS/DE仍经过原两级寄存器。

没有增加第二套统计、帧缓存、分类算法或跨域通道。SDC/ADC、TD工程清单及相机寄存器不改。本批仅三个综合输入RTL发生变化。

## 数值、流水及有效性

沿用四像素一拍、AWB高到低排列，gray=floor((R+2G+B)/4)，范围0～255。最大6400像素和为1632000，21位足够；保留既有28位sum和20位count，避免无关位宽重构。ROI边界使用半开区间，边框是显示叠加，不写入统计输入。

灰度、平衡四路归约到累加器保持原流水，完整有效帧提交后串行除法28拍完成；均值向下取整。原生FS取消未完成计算，最近完整统计保留；坏帧、配置更新及lane错误撤销有效性。启动首帧可能因原demosaic学习被拒绝，后续完整帧恢复。

既有CSI→显示27位稳定邮箱和VS快照继续原子传送状态/有效/均值/最小/最大。统计表示最近完成采集，不与DDR显示帧编号绑定。CLASS_CALIBRATED=0，当前阈值T=0、亮侧方向、EXP2244和GAIN48仍为候选占位；不代表真实有件/空穴判断。

## 验证范围

ModelSim新增roi_core：独立生成80×80数值参考，验证6400像素、SUM/MEAN/MIN/MAX、框外黑/白不影响结果、255满量程及valid气泡。OSD逐像素核对绿色大框、灰度、青色小框、框外彩色及CYAN说明，并检查两级同步/旁路。roi_chain真实RAW10→demosaic/AWB/原厂ERAM验证7帧1024×600，参考区域改为6400像素；短行/长暂停拒绝、配置失效/恢复保持。其他非4对齐ROI、取消、分类器和27位CDC回归继续运行。

TD独立目录保存完整198项输入，综合、布局布线、时序及约束覆盖证据。既有DDR复位recovery余量和I/O/PLL/DDR约束缺口需记录，不能声称所有路径均已覆盖。未放宽约束；未来启用实际分类仍须新一轮仿真和TD。

## 下载后采样

用户自行下载本版独立bit。先检查绿框/青框、框外彩色、四键和UNCAL，确认青框内部取样有效。固定候选130mm、同一焦点/光源，先沿用EXP2244/GAIN48；两类使用同种载带、相同方向和观察面。

将同一穴内核心位置对准青框。有件、空穴各静止约10秒，记录这10秒MEAN最低/最高、MIN/MAX、VALID、INPUT FPS、L/F/I/G和真值，每类至少重复一次摆放。拍屏可用于读取FPGA显示数字和确认摆放，不把照片灰度当作原始像素。若80×80覆盖了邻穴/定位孔/台面，先反馈小框与实物边界，再调整ROI。

单穴分布有足够间隔后再确认T/方向/曝光/增益与光源/距离配方，另批启用并测准确率。30分钟运行、固化、断电自动运行和A整合后冷启动尚未完成。
