czp-1-A1/FPGA_Component_Inspector/开发实施/19_A机构未固定期间推进安排_讨论稿.md

# A阶段机构未固定期间的推进安排

2026-10-05用户说明：建模尚未完成，当前没有固定位置，严格重复摆放和连续测量困难。本记录调整工作顺序，不批准新的RTL批次。

## 当前结论

继续使用roi_core_80_20261005取样版，CLASS_CALIBRATED=0、RECENT UNCAL。当前80×80照片中有件MEAN78～88、空穴36～37，支持讨论均值判定；它们属于探索快照，不能证明固定位置下的时间稳定性或分类准确率。T58、亮侧有件保持为讨论候选。

缺少固定机构时，ROI内目标占比会随摆放变化，不能把全部波动归因于曝光、光源或传感器。因此不要求现在完成每类两次10秒的正式标定。130mm/EXP2244/GAIN48仍是候选条件，不由本轮照片锁定最终工作距离或配方。

## 机构完成之前

1. 保留已有证据，现场方便时观察双框、统计有效性、四键与输入帧率。若现有条件能临时压稳载带，可以做粗对照，记录为临时试验；无法压稳时无需继续重复拍照求正式阈值。
2. 先准备A阶段结果显示、字体/Logo和状态处理的后续方案与验收用例。当前分类器、坏帧处理、CDC已经离线验证；后续功能范围仍须形成具体方案并经用户确认再写代码。
3. 视频连续运行和断电启动验证不依赖穴位精确定位，可在现场设备方便时单独开展。记录所用bit身份、输入FPS/错误计数和人工现象；30分钟、固化及冷启动当前仍为未测。

## 机构可固定之后

先确定载带平面、高度、方向及取样位置，重新核对ROI和最佳焦点，再确定曝光/增益与照明候选配方。随后按同一穴内区域采两类各10秒、重新摆放各重复一次的完整范围，再决定T及方向。实际启用分类要重新ModelSim、TD和实物准确率验证。

当前无新bit生成授权。已冻结RTL、bit和历史验收证据保持；本次仅更新推进安排和AGENTS交接。
