czp-1-A1/FPGA_Component_Inspector/开发实施/20_A结果显示字体Logo与状态处理_待确认方案.md

# A阶段结果显示、字体、Logo与状态处理方案

日期：2026-10-05。状态：**用户已明确选择“直接用取样界面”，已批准本批RTL、ModelSim和TD实施；已完成离线实现和验证，实物检查待用户下载。**

用户最新约束：机构建模尚未完成，目标位置不能固定；先准备显示和状态处理，确认后再生成代码。当前保持 `roi_core_80_20261005` 取样版和 `CLASS_CALIBRATED=0`。照片中的T58只是讨论候选，本批不启用实际分类。

## 1. 推荐的这一批范围

完成轻量中文结果显示、清晰字模、可辨认安路Logo，以及结果撤销和恢复规则。沿用既有视频、灰度观测、80×80核心统计和四键调参。下一版先交付**取样界面**；精简演示界面采用同一布局，在最终A整合时选择。

中文结果建议使用“未标定 / 等待采样 / 有件 / 空穴”，取代当前RECENT UNCAL等小号英文。顶部调参字段只有曝光和增益，分别标“半行”和“档号”；曝光不能直接标成ms，增益档号不能直接标成dB。

“有件”只表示穴内存在元件，“空穴”只表示存在判定为空；不把它们写成综合质量OK/NG。当前尚未实现偏位、角度、极性、料号或引脚缺陷判别。

## 2. 1024×600布局

采用固定深色实底信息条、白色正文，矩形区域和留白，不使用渐变、半透明混合或装饰动画。摄像头图像仍按原像素坐标叠加；上下信息条遮盖边缘区域，**不缩放、不移动相机画面或ROI坐标**。

| 区域 | 半开坐标 / 尺寸 | 内容 |
|---|---|---|
| 顶部条 | x=[0,1024)，y=[0,80) | 安路Logo、曝光、增益 |
| Logo图案 | x=[16,112)，y=[8,72)，96×64 | 例程安路图案，保留比例，蓝/红/白 |
| Logo文字 | x=[128,272)，y=[24,56) | ANLOGIC，补充文字，不替代图案 |
| 曝光区 | x=[360,656)，y=[8,72) | 曝光 EXP；2244 半行（示例值） |
| 增益区 | x=[688,984)，y=[8,72) | 增益 GAIN；48 档号（示例值） |
| 观测框 | x=[256,768)，y=[172,428) | 512×256，绿色固定边框，内部灰度 |
| 核心框 | x=[472,552)，y=[260,340) | 80×80，青色固定边框，统计仅来自这里 |
| 底部条 | x=[0,1024)，y=[504,600) | 左侧大字结果；右侧取样/验收或精简信息 |
| 结果区 | x=[16,280)，y=[510,592) | “最近采样”小标题，48像素高状态文字 |
| 信息区 | x=[304,1008)，y=[510,592) | 见下表 |

观测框和核心框始终采用固定颜色。判定颜色只用于底部文字和标记，避免让框色暗示结果与当前DDR画面严格对应。两个框不会被上下信息条遮盖。

| 界面内容 | 底部右侧内容 | 使用时机 |
|---|---|---|
| 取样界面（下一版建议默认） | MEAN/MIN/MAX和采样有效性；真实INPUT宽高/FPS、CFG、L/F/I/G；帧计数与运行秒数 | 机构未固定、后续标定、30分钟验证 |
| 精简演示界面 | 视频/采样状态、INPUT宽高/FPS、两个框的用途说明 | 正式A演示；具体启用时机另确认 |

两种内容仅是显示编译选择，不新增板载操作。KEY1～KEY4继续曝光−/＋、增益−/＋。预览里的界面和状态选择器用于讨论，不是将要加入FPGA的菜单或按键功能。

取样界面诊断计数继续采用四位十六进制，帧/秒采用八位十六进制并标明HEX；曝光、增益、灰度和FPS采用十进制。调参和普通读数取消多余前导零，预留最大位数，数字变化不挤动标签。

## 3. 字体和Logo来源

字体方案为清晰无衬线中文和等宽数字。预览用本机微软雅黑/Consolas表达风格；正式实现只制作本界面用到的固定字模，不加入完整中文字库。

| 字模 | 原始尺寸 | 显示尺寸 / 用途 |
|---|---|---|
| 中文，预计不超过48字 | 24×24，1bit | 标签24×24；结果按整数2倍显示48×48 |
| ASCII，预计不超过64字符 | 8×16，1bit | 诊断8×16；参数和主要读数2倍显示16×32 |
| 安路图案 | 96×64，2bit索引 | 透明/白、蓝、红的固定调色板 |

字体不沿用当前5×7点阵直接放大的形式。实际字模需在1024×600渲染图和上板画面中检查笔画完整、字间距、数字0/8等辨认情况。若复杂中文在24×24仍不清晰，先调整字模而不扩充整套字体库。

Logo依据本机随板例程：

`D:/BaiduNetdiskDownload/HX1P35A_Contest_202606/7_lab_ex_2026_nosoft/lab_hd_3_osd/lab_hd_3_osd/user_source/hdl_source/anlogic_logo_rom.v`

原ROM SHA-256：`37c76680345f17a85632b7835e46a3a197cf75fdd91ca6a970b75f5346e7a9f8`。参考解码图保存在 `显示方案预览/lab3-logo-reference.png`。原图160×160，可见图案包围盒为x=[7,153)、y=[34,128)，压缩空白后按比例放入96×64区域。

只借用图案素材，不复制Lab3大型case ROM、hdmi_mixer或完整OSD。按项目02规范，将小字模和Logo放到同步ROM/ERAM。按上述字符上限计算净存储约6016字节（不含ROM深度对齐、端口和地址逻辑）；实际ERAM数量、LUT增量和时序以TD报告为准。OSD不新增DSP或全帧缓存。

## 4. 状态显示规则

结果状态与输入可用性分别判断；错误计数是累计历史，不等于当前故障。

| 条件 | 主结果文字 | 颜色 / 辅助信息 |
|---|---|---|
| 复位或相机配置尚未完成 | 等待采样 | 灰白；配置中 |
| 配置完成但INPUT FPS=0 | 等待采样 | 无输入用红色提示；撤销旧有件/空穴 |
| 采样无效、坏帧或恢复后尚无新的完整有效采样 | 等待采样 | 灰白；等待有效帧，统计显示“—” |
| 有效采样，但未标定或EXP/GAIN不匹配已标定配方 | 未标定 | 琥珀色；仍可显示有效灰度统计 |
| 配方匹配，收到新的完整有效采样，分类为PRESENT | 有件 | 绿色；最近采样结果 |
| 配方匹配，收到新的完整有效采样，分类为EMPTY | 空穴 | 橙色；最近采样结果 |

按表中顺序处理：配置/无输入/无效采样先阻止判定，再检查标定条件，最后才显示分类。不得用默认0值、残留均值或无效帧产生“空穴”。

正常下一帧开始时，画面保留**上一份完整有效采样结果**，下一份完整结果到达后统一替换。这是“最近采样”，不声称对应屏幕正在显示的DDR帧。发生坏帧、配置变化、复位或输入失效时撤销旧判定；撤销之后不能凭旧邮箱内容恢复有件/空穴，必须等新的完整采样。

当前输入停流依据独立50MHz监测域的1秒FPS窗口：完全停流通常需约1～2秒才显示FPS=0；不能宣传即时停流检测。本批沿用该机制，在仿真中验证最坏窗口边界。HDMI本身停钟/显示器断线仍需现场观察，不能由这条状态提示代替验收。

调整曝光/增益时先等待配置；配置完成后，若不匹配将来标定的EXP/GAIN则显示未标定。调回原配方也必须等待新采样。光源、焦点、距离或手动换样没有硬件观测输入，本批不能自动判断这些变化；最终标定配方和固定摆放仍由人维护。

换样期间只作观测，手正在画面内或目标移动时不能当作正式判定。静态A本批不增加稳定帧判断、手部检测或人工确认键。恢复稳定后以新的完整采样为准；自动换样识别和运动编号属于后续阶段。

累计L/F/I/G非零时，取样界面显示数值和累计异常提示；不把过去一次错误永久锁成当前故障，不把累计I2C错误直接当作当前配置失败。无效或中断期间不显示旧统计冒充有效读数。

## 5. 代码如何落地（批准后）

1. **结果发布与撤销**：保留roi_classifier现有帧新鲜性规则，在采集域增加给显示用的最近完整结果快照。新结果的state/valid/mean/min/max一次发布；普通FS不撤销这个历史显示快照，真正invalidate和标定失效会撤销。避免新均值与旧类别分开进入邮箱。
2. **恢复必须有新采样**：快照携带1位完成翻转标记，仅完整新采样发布时翻转。ROI邮箱由27位变28位，目的端记录撤销时的标记，直到收到新的有效完成标记才恢复分类；启动、配置、停流和复位分别验证。收发时钟和邮箱最坏传递时间需证明可以观察相邻完成事件，不能靠普通轮询次数冒充新采样。
3. **轻量OSD**：修改experiment_osd，新增小字模/Logo ROM及其离线转换素材。保留原灰度公式和框坐标；动态字段在显示帧边界锁存，整帧使用同一快照。同步ROM预计采用3级视频流水，RGB、DE、HS、VS及旁路一致延迟，并更新原2级的接口记录和测试预期。
4. **接入和验证**：design_top_wrapper/必要ISP输出接入发布标记和显示门控；显示域同时核对实际EXP/GAIN与已批准配方，不能仅等待另一个异步邮箱最终到达。复核28位邮箱的专用约束覆盖和CDC测试。当前阈值、摄像头配置、四键、灰度统计、DDR和HDMI模式不因界面批次调整。

本批默认仍未标定：有件/空穴界面先通过仿真状态注入检查，不表示已经用实物完成判别。T58/亮侧不写入启用配方；正式启用需要机构能固定后的同位置两类完整测量和用户确认。

## 6. 分步验收

| 步骤 | 验证内容 | 可判通过的依据 |
|---|---|---|
| 最近结果与状态 | 启动、正常新FS、有效结果更新、坏帧、调参、停流/恢复、复位、旧邮箱和完成标记 | ModelSim事件序列；错误/恢复期间不冒出旧有件或空穴；有效新结果字段不混合 |
| 字模/Logo/叠加 | 所有实际用字、最大参数位数、四类结果和输入异常；首末像素、双框边界、框外彩色、灰度 | 1024×600逐像素参考、完整帧图检查；Logo可辨认，文字不重叠 |
| 流水与旁路 | 同步、RGB、可用像素、ROM读取延迟；ENABLE旁路 | 统一3级延迟，无错位、黑边或少首末像素；若实现改变级数则同步修订并验证 |
| 集成 | 保留现有12项回归，增加显示状态时序用例；真实RAW→ISP链路 | ModelSim通过且保留日志/WLF/渲染图；不能只强制OSD状态证明整条发布链正确 |
| 资源和时序 | TD综合及布局布线，Slice/LUT/REG/ERAM/DSP、建立/保持、约束覆盖及28位CDC | 对照本批前14122 Slice/31 ERAM/8 DSP；保存报告，不放宽约束或隐藏既有覆盖缺口 |
| 实物 | 用户下载后检查中文/Logo、两个框、四键；30分钟及固化冷启动 | 绑定镜像SHA和现场记录；当前均不补填通过。正式识别准确率等机构固定后另测 |

## 7. 预览说明与确认点

预览是布局示意，载带是几何示意，有件/空穴/断流均为状态预演，不是新bit截图或实物准确率证据。建议确认的具体范围为：

- 中文状态、顶部Logo＋曝光/增益、底部大字“最近采样”，固定深色信息条。
- 下一版保留取样/验收信息，最终演示再采用精简内容；四键不增加界面切换功能。
- 最近完整结果保持、坏帧/调参/停流撤销、恢复等待新采样；轻量ROM和一致流水。
- 保持未标定，不启用T58，不新增定位/多帧/电机/计数/缺陷算法。

确认上述范围后再实施RTL、ModelSim和TD，最后提供独立版本bit由用户下载。本文件和预览不构成实现或验收通过。

## 8. 本轮方案检查

已检查取样/精简两种内容及六种状态预演；等待、配置和停流预演均隐藏统计值。浏览器在320、736、1024像素外层宽度检查无水平溢出；另外导出三张严格1024×600布局图并检查文字和Logo。此处只验证预览，尚未运行新RTL仿真或TD。

- [取样界面：未标定](D:/BaiduNetdiskDownload/HX1P35A_Contest_202606/FPGA_Component_Inspector/开发实施/显示方案预览/sample-uncal-preview.png)
- [精简界面：有件状态预演](D:/BaiduNetdiskDownload/HX1P35A_Contest_202606/FPGA_Component_Inspector/开发实施/显示方案预览/demo-present-preview.png)
- [精简界面：无输入状态预演](D:/BaiduNetdiskDownload/HX1P35A_Contest_202606/FPGA_Component_Inspector/开发实施/显示方案预览/demo-offline-preview.png)

当前198项综合输入、.al及冻结bit哈希均与roi_core_80_20261005记录相同。本轮未修改历史验收证据或release。

## 9. 用户选择

2026-10-05用户选择“直接用取样界面”。本批仅实现取样布局；精简演示布局保留为历史讨论，不增加编译选择或菜单。保持CLASS_CALIBRATED=0，不启用T58。原待确认稿已保存tmp/sample_ui_before_20261005供本批证据冻结。

## 10. 实施落点

仅取样界面已实现，最终结果见21实施说明及20261005_A取样界面字体Logo状态_轮次1。14项ModelSim与TD通过，CLASS_CALIBRATED=0。此前预览图/preview_manifest保持方案当时状态，不改造成实物或新bit证据。
