czp-1-A1/FPGA_Component_Inspector/开发实施/22_A黑带黑件特征选择与ROI边缘观测_待确认方案.md

# A黑带黑件特征选择与ROI边缘观测：待确认方案

日期：2026-10-05。本文是讨论和下一批范围建议，尚未获得实现授权；本轮不修改RTL、不生成bit、不启用分类。

## 1. 已知条件与本轮反馈

- 用户反馈取样界面调参后统计“能恢复”。仅记录这一项现场反馈；字体/Logo全部检查、30分钟、固化冷启动及分类准确率仍未完整验收。
- 目前照片中的黑带白色器件只是一种物料；还要考虑黑带黑色器件。用户确认黑色器件在当前画面中能看到外壳轮廓或金属引脚。
- 摄像头不能更换。130 mm仍是候选工作距离，机械建模未完成，位置、焦点、照明和最终ROI尚未冻结。
- 白色器件已有单穴时点MEAN：有件78～88、空穴36～37，不能用于给黑色器件设阈值，也不能代表重复摆放或完整10秒范围。
- 当前取样版CLASS_CALIBRATED=0；T58只是旧样品讨论值，未启用实际有件/空穴判定。

## 2. 为什么不能只换一个均值阈值

灰度图仍保存每个像素的明暗和空间关系；当前MEAN把整个核心区域压成一个数，会丢失轮廓、引脚位置和纹理。黑件与黑色穴底可以有相近均值，但仍存在局部亮暗变化。因此不是放弃灰度，而是考虑在灰度上提取局部结构。

Sobel计算局部亮度梯度，适合观察已可见的外壳边界和引脚；它不直接识别“元件”。空穴的穴壁、底孔、反光及噪声也会形成边缘，不能假设边缘数量越多就一定有件，也不能假设有件一定比空穴更亮。

如果光学成像中外壳边界几乎没有对比，边缘算法无法凭空恢复结构。当前已有可见轮廓或引脚，具备先做边缘观测的理由；照明方向仍需以后用实物比较。

## 3. 候选方法与采用条件

| 方法 | 适用线索 | 本项目的限制与建议 |
|---|---|---|
| 灰度均值/亮区面积 | 白件和黑色穴底有明显对比 | 保留现有均值；黑件不共用白件阈值。亮区面积看一片区域，不能只看单个MAX反光点。 |
| ROI Sobel边缘 | 外壳轮廓、引脚边界可见 | 推荐先做观测与统计；还须区分穴壁/底孔，不能单独按总边缘数判有件。 |
| 引脚或端子区域的亮区面积、位置 | 黑色本体周围存在可见金属引脚/端子 | 可能比整穴Sobel总量更简单、更有区分度；等黑件样本确认它们的位置和可见性再选。 |
| 空穴参考/小模板差分 | 固定位置后，有件与空穴的局部结构有稳定差异 | 机构固定后再评估；当前摆放变化可能被误当作元件差异。 |

建议按物料分别标定ROI和所需特征。先验证一个白件样品和一个黑件样品；不承诺一个通用阈值覆盖所有封装，也不在当前阶段增加自动物料识别或配方菜单。

## 4. 建议下一批实现范围：仅ROI边缘观测与统计

以下整批待用户确认：

1. 保留1024×600输入/显示、四键曝光增益、当前取样界面、Logo、帧保护和异常撤销恢复。
2. 在绿色512×256临时观测框内增加3×3 Sobel边缘观察；按23最新独立SW方案，SW1控制灰度底图、SW2控制橙色边缘叠加，两者都下拨看原始彩色，都上拨看灰度加边缘；框外保留彩色。先让人看清边缘来自外壳、引脚、穴壁还是底孔。
3. 保留青色80×80核心的MEAN/MIN/MAX，增加同一完整帧的边缘像素数和梯度强度总和。边缘像素阈值是观测参数，与“有件/空穴”的分类阈值分开；阈值变化会改变边缘计数，不能混用记录。
4. 暂不启用实际分类，继续显示“未标定/等待采样”。在黑件实物上比较均值、边缘位置及统计是否有稳定差别，再决定使用轮廓分区、引脚亮区面积或其他最少必要特征。

**区域边界必须注意**：80×80原本偏重穴内取样，不保证包含黑件的完整外壳轮廓和全部引脚。先用大观测框观察结构；如果轮廓落在青框外，不能据此认定Sobel无效。后续按物料选择单穴分析区域或引脚子区域，避开相邻穴位和载带定位孔，不盲目统计整个大框来判单穴。

现阶段不要求严格固定位置的长时间阈值测量。上板观察时尽量把同一种载带的有件和空穴依次放到青框，同方向、同焦点和同照明，先判断特征是否值得保留。机构固定后再做重复摆放、完整时间范围和独立样本验收。

## 5. 确认后实现和验证的约束

- 以取样版为基线，检测数据从OSD覆盖前的像素提取。现有接口为96位RGB、每拍4像素；Sobel保留各像素及跨拍水平邻居，不能用4像素平均后复制4份来代替逐像素边缘。
- 已只读核对官方Lab 2的edge_detect_96：它先对4像素分组平均，行存储复位逐项清零。本项目不直接复制该实现；遵守02资源规范，行缓存使用ERAM并验证实际映射。
- 梯度用abs(Gx)+abs(Gy)，加减/移位实现；无像素率平方根、变量除法或新增通用乘法器。流水线的坐标、有效标志及视频同步必须匹配。
- 对观测框边缘采用明确的邻域有效屏蔽，统计只计完整有效邻域；显示与统计使用相同梯度定义。不能把ROI裁切边界人为补零造成的边缘当器件特征。
- 坏帧、停流、调参、复位及RAM行预热阶段不得发布混帧统计；新增特征和原统计按同一帧原子发布，扩展CDC快照并复核其约束。
- 当前取样版Slice14240/21216（67.12%）、ERAM36/108、DSP8/40；新模块资源和建立/保持时序以实际TD报告为准，不凭预计值称通过。现有覆盖缺口继续记录，不能放松约束获得通过。
- ModelSim重点验证独立参考梯度、水平/垂直/斜边、四像素跨拍邻居、非对齐ROI、有效间隙、换行/帧边界、RAM预热、坏帧取消、调参和停流恢复，以及完整视频同步。
- 当前AWB仍为动态实现，固定曝光/增益不等于RGB增益也固定。先保留现有链路；最终标定时检查场景变化带来的特征漂移，再单独决定是否冻结AWB，不在本批顺带重写。

## 6. 本轮只读核对及参考

分支hx1p35a-contest-work，HEAD f87ccf1c6a38e84b58a4f86cecd532a71ae56e89。取样版manifest的203个构建输入、工程.al和bit哈希全部与现文件相符；本轮只新增本文并更新交接摘要，不重跑ModelSim/TD、不修改冻结release或旧验收证据。

基线bit SHA-256：ab23766b4b51c4df1d331fc14ad7f5bcc8a5ddeeeae3a2aedb8929cf04332ea1。

- [OpenCV Sobel说明](https://docs.opencv.org/4.13.0/d2/d2c/tutorial_sobel_derivatives.html)：局部梯度及abs(Gx)+abs(Gy)近似，灰度输入仍可提取边缘。
- [Edmund Optics照明几何说明](https://www.edmundoptics.com/knowledge-center/application-notes/illumination/brightfield-illumination-with-spot-and-bar-lights-for-machine-vision/)：斜向照明可增强表面结构对比，反光材料需比较角度以避免热点。把它应用于黑件载带是本项目待实测的建议，不是已证明有效的结论。

后续讨论：用户最新纠正，三类对象为黑带白件、黑带黑件、透明载带，但是否保留两种算法组合须上板验证。23_A检测方案SW切换与按键分工_待确认方案.md已改为SW1上拨灰度、SW2上拨边缘的独立开关实验方案；两者同时开启保留用于观察，不预设与/或融合判定。先由用户确认生成实验版，再手动上板比较三类有件/空穴并反馈；之后拟定正式分类代码，再经确认生成。本文Sobel为候选观察特征，不提前把任何物料固定绑定某算法。
