czp-1-A1/FPGA_Component_Inspector/开发实施/24_A独立SW灰度边缘实验版_实施说明.md

# A独立SW灰度边缘实验版

2026-10-05。用户确认实现可切换取样实验版；已完成RTL、ModelSim、TD及独立bit。正式分类和组合判定仍未授权启用，上板由用户操作。

## 已确认行为

SW1（A4）上拨灰度显示，SW2（B4）上拨橙色边缘叠加；两者全下原彩色、全上灰度加边缘。仅绿色[256,768)×[172,428)内处理，框外彩色。KEY1/2曝光减/加、KEY3/4增益减/加不变，既有字体、Logo和取样状态保留。青框[472,552)×[260,340)原MEAN/MIN/MAX不受视图改变；新增边缘数量和梯度强度用于观察，不是分类结论。

边缘用3×3 Sobel，G=abs(Gx)+abs(Gy)，初始观察阈值80（G>=80），不是有件/空穴阈值。框内只显示邻域完整的梯度，ROI边界不补零造边缘。核心边界的邻居可来自核心之外、观测框之内。

## 实施接口与位宽

1. 实际AWB接口96位RGB888，最左[95:72]，每拍四像素，CSI112.5MHz。原统计/完整性支路保持原插入点和原生FS/FE，处理器不回压摄像头。
2. 为使边缘位于邻域中心且完整保留彩色，用4行RGB缓存，每行256×96位，TD确认12个ERAM；无复位逐地址清零。接收下一行完成后连续读出上一行的RGB及邻域，再3×3计算；完整帧回放600行，尾行单独冲刷。固定整行连续有效输出，保持原96→128打包每4组变3组，不能因水平前看引入组内气泡丢字节。同步RAM、灰度、组前看、方向权和、梯度和、混色共6级寄存器；读请求到RGB有效相差5个CSI周期，已包含前看1拍。整帧独立像素及115200打包字数量核对通过。
3. 4个像素分别计算灰度floor((R+2G+B)/4)。各方向正/负权和10位（最大1020），差的绝对值10位，两方向总强度11位（按最大2040保守设计）。核心梯度有效像素数13位（6400），阈上边缘数13位，强度累加24位（6400×2040<2^24）。无平方根、变量除法或新像素乘法器。
4. SW只接50MHz两级同步器；整个2位状态稳定20ms后发布，16位epoch每次稳定切换加1。18位{epoch,edge,gray}稳定邮箱分别到CSI/HDMI；原生FS锁存本帧tag，变化立即取消旧观察统计。epoch用于防快速往返旧内容复活，65536次完整稳定切换约至少21.8分钟，邮箱旧在途内容应在微秒级排空，并由仿真验证回绕。
5. 原28位显示记录与同帧边缘统计原子合成83位：低28原字段，[45:28]tag，[58:46]边缘数，[82:59]梯度和。原mean完成后发布，不允许旧边缘配新mean；核心梯度有效数须6400且原guard完整帧才有效。目的域仅接受匹配当前请求tag的新完成token，保留既有调参/坏帧/配置/停流撤销恢复。
6. 处理后RGB进入既有DDR；OSD只画框、状态和参数，不重复把ROI变灰。视频新增行缓存延迟，DDR早帧通知应保持早于首个打包输出，且不清掉前帧尾行。观察统计仍是最近完整采集样本，没有与DDR当前显示帧绑定，静态实验不代表动态跟踪完成。

## 验证与证据

- 单元：独立图像参考比对原色/灰度/边缘/同时开启的每个输出像素及全部核心梯度、数量、强度；水平/垂直/斜边、四像素跨拍、非对齐ROI、气泡、RAM预热、尾行和帧间隔。
- 集成：真实RAW/ISP/原厂RAM与原统计回归，核对连续128位打包、早帧通知、完整600行；SW抖动/快速往返/上电位置/帧中切换、停CSI、调参并发、旧邮箱拒绝与恢复。
- UI：独立完整画面与状态参考、参数/模式按VS快照、边缘关闭或样本无效不显示旧数、RGB/同步/旁路延迟一致。
- TD：完整综合及布局布线，检查缓存映射、资源增量、正确约束下建立/保持及所有新增邮箱/开关约束匹配。不得放松时序或降低测试标准。
- 原取样版release/sample_ui_20261005及全部冻结证据保留。新构建和镜像使用独立目录；最终保存输入快照、哈希、ModelSim日志/波形、TD报告、失败/修复历史。

上板由用户操作。三类物料分别比较有件/空穴的四种视图，记录距离、曝光、增益、照明和边缘阈值，再决定正式算法；准确率、30分钟、固化及冷启动均尚未测试。

## 本轮完成结果

镜像：`fpga/component_inspector/release/sw_edge_20261005/camera_to_dsi_display.bit`，1789539字节，SHA-256 `a43156b8fc076d7940e12b8f7ba46d026a3053466b759724bef79235570bcd8c`。原sample_ui及全部旧release哈希核对未改变。

证据：`开发实施/验收记录/20261005_A独立SW灰度边缘实验_轮次1/`，包含206构建输入+.al、最新testbench/生成器/ROM、ModelSim日志及WLF、TD完整报告、独立参考/实际渲染图、首次失败与修复记录、manifest。独立TD构建在`tmp/sw_edge_td_build_20261005`。

默认16项ModelSim通过，随后对observation增加同时调参/配置与拨动的定向补测并通过。Sobel单元逐像素比对四模式及水平/垂直/斜边、彩色、非4对齐边界、气泡、尾行、预热和打包字节。真实RAW/原厂ISP/RAM9帧包括四模式、坏行/长暂停拒绝、帧中切换取消且本帧视图不变、下一原生FS应用和恢复；有效帧每帧614400像素、115200个128位字、6400核心像素，独立参考边缘316、梯度和51200。该数字是仿真图案结果，不是实物性能。OSD四模式各614400像素与参考完全一致，6状态条及3拍RGB/同步/旁路通过，字段只在VS更新。

TD6.2.168116，PH1P35MDG324 speed3，最终Slice15740/21216（74.19%），ERAM48/108，DSP8/40，综合LUT17356/REG17347。相对取样版增加1500 Slice、12 ERAM、0 DSP；按02规范属于70%～80%需复核区间，增量已核对，后续功能应重新预算。建立/恢复WNS0.146ns、TNS0，保持WNS0.020ns、TNS0，慢/快角均检查；约束周期CSI8.888ns、HDMI19.230ns不放松。最差路径为原demosaic的高扇出控制至新增early_pending，主要是布线延迟，余量较小，后续扩展须再次检查。

STA覆盖94.74%，不是100%。no-input-delay从37变39：新增2个机械SW异步输入不设置虚构同步delay，`report_timing_ignored`证明两条false-path均匹配、0覆盖/忽略；最终网表每个SW只有一个同步寄存器数据输入负载。shadow/ignored约束计数4变7：旧monitor req/ack被相同19ns观察显示预算覆盖，旧camera-display13条payload路径被更严格8ns接收预算覆盖；12项CSI/ROI/SW专用预算全部匹配且有效，无新增被忽略项。原DDR/FIFO例外、dummy4、PLL7、无输出delay63、部分输入1及两PLL反馈关键告警保留。只读约束探查不修改最终DB/bit。

## 下载后操作

| SW1 | SW2 | MODE | 绿色框内 |
|---|---|---|---|
| 下 | 下 | RAW | 原彩色 |
| 上 | 下 | GRAY | 灰度 |
| 下 | 上 | EDGE | 彩色加橙色边缘 |
| 上 | 上 | GRAY+EDGE | 灰度加橙色边缘 |

1. 下载此独立bit，先双下核对画面与KEY1/2曝光减/加、KEY3/4增益减/加。绿色框外保持彩色。
2. 将一穴放在青框，待采样有效，再依次切换四种组合。拨动后先等待新完整采样；MODE是请求，DDR画面可能晚一两帧更新。EC是阈上边缘数、GS是全部梯度和，均为十六进制；T80是十进制观察阈值。关闭边缘或样本无效时显示横线。
3. 三类物料分别拍有件/空穴的四种视图，保留EXP/GAIN。机构未固定时先看轮廓/引脚、穴壁/孔和反光是否也被突出；不要求当前完成严格准确率统计。青框80×80可能未覆盖某类器件整个轮廓，反馈后再讨论ROI或阈值。

上板反馈只决定后续正式方案。边缘更多不自动等于有件，透明盖膜/反光和空穴结构也可能产生边缘；当前显示未标定是预期行为。
