czp-1-A1/FPGA_Component_Inspector/项目整体分析/第一性原理评审与赛题符合性_20260907.md

# 载带元件智检仪：第一性原理评审与赛题符合性

评审日期：2026-09-07。计划修订状态：已按用户批准更新。

> 阅读说明：以下问题描述保留首次评审所针对的旧计划背景；引用文件现已修订，旧章节号与旧假设不再代表现行计划。当前执行以开发实施中的00路线和04接口约定为准。文档修订完成不等于实物验收通过。

## 0. 本轮采纳结果

十项建议均已采纳：实测视场优先、布局不预设穴位数、1024×600工程基线、A/B/C分版、单帧先验证、运行内相对编号、实测停车间距、分项指标、保留安路Logo、先明确FPGA接口。

A版完成静态视频和正常/空穴识别、处理视图、Logo、固化冷启动；每加模块记录资源和时序。B版验证运动清晰度、电机干扰、相对编号与失锁恢复；启用动态叠加时验证帧匹配。C版验证停车、多NG队列及复检。滚动快门列为B版验证项，双光场仅在单光场不足时考虑；A版固定ROI不必先完成完整动态跟踪。

补充相机支架与导轨复装标定、物理穴位真值集、队列高水位及停车期间余量。资源、样本和冷启动在原计划中已有方向性要求，本轮将其落实到阶段验收表，不能一概称为原计划完全遗漏。

所有实拍、时序闭合、识别率和停车结果仍待记录。

评审对象为实际存在的 `E:\2026FPGA\FPGA_Component_Inspector`。用户给出的分层路径在当前文件系统中不存在；上述目录包含对应项目和“赛题要求与分析”。

**结论：选题方向符合这份赛题，但现有文件不足以认定作品已经满足验收要求。修订前最大的具体漏洞是成像几何尚未验证，就固定了“16 mm镜头、80 mm左右工作距离、5～7穴位、同画面检测与返修”的整机架构。**

本次读取总体方案、全部开发实施Markdown、样品方案、候选库、购物条目、相机手册，以及官方Lab压缩包中的相关RTL和时序报告；逐字复核两份原PPT的第5、6、26页。未操作实物、运行TD综合或进行上板测试。未在项目自研资料中找到检测RTL、离线算法代码、实拍检测数据、已填写验收记录或最终整合工程；官方例程与其历史报告不能当作本项目的完成证据。实物或其他目录中的进度不在这个结论范围内。

## 1. 从第一性原理定义这个项目

C版完整闭环最终需要输出的是：**哪一个物理穴位存在什么可观察缺陷，以及能否在该穴位离开可处置范围前把它正确停住。**

C版需要五个条件同时成立；A版只验证静态观察、判据和集成证据，B版再加入运动编号：

| 条件 | 必须回答的问题 | 不成立的后果 |
|---|---|---|
| 能观察 | 正反、正常偏移和异常偏移在真实图像中能否分开？ | 算法无法恢复图像里没有的信息 |
| 有判据 | 对具体元件和载带，多少偏移或旋转算不合格？ | 数值测得准也可能判错质量 |
| 地址可靠 | 当前结果属于哪个物理穴位？失去观测后如何处理？ | 识别正确但停错元件 |
| 来得及 | 取像、复核、计算和减速的总时间/距离是否足够？ | 发出NG时已经错过停车点 |
| 可证实 | 同一固化工程是否稳定完成上述过程？ | 只有方案描述，无法证明完成 |

当前计划对模块和阶段的组织较完整，也已提出成像验证、独立测试集、定点化、资源检查和逐级提速。真正欠缺的是：**这些约束之间的定量闭合，以及失败时的处理契约。**

## 2. 最大漏洞：镜头视角与实际传感器不匹配

### 2.1 已确认的源文件事实

[总体方案第5.2节](E:/2026FPGA/FPGA_Component_Inspector/项目整体分析/基于国产FPGA的电子元件载带封装检测_项目总体分析.md)根据16 mm镜头标称水平20°、垂直13°，推算80 mm工作距离下视场约28 × 18 mm，并据此安排5～7个4 mm节距穴位。

但是，[SC500CS数据手册](E:/2026FPGA/FPGA_Component_Inspector/摄像头+镜头/SC500CS_数据手册_V1.8.pdf)第2页给出：像素尺寸1.12 μm，阵列2600 × 1952，镜头光学尺寸1/5英寸。以有效输出2592 × 1944计算，实际感光宽高约：

```text
传感器有效宽度 Sx = 2592 × 0.00112 = 2.903 mm
传感器有效高度 Sy = 1944 × 0.00112 = 2.177 mm
```

镜头商品参数中的“适配1/2.5英寸像面”不能使这个1/5英寸传感器变大；商品视角也不能脱离其测试传感器尺寸直接移植。视场与传感器尺寸、焦距、工作距离共同相关，参见[Edmund Optics光学说明](https://www.edmundoptics.com/knowledge-center/application-notes/imaging/understanding-focal-length-and-field-of-view/)。

### 2.2 一阶复算

以薄透镜近似，令物距u从主平面计、焦距f=16 mm：

```text
放大率 m = f / (u - f)
物方视场 FOV = 传感器有效尺寸 / m
```

| 假设物距u | 全有效阵列水平视场 | 全有效阵列垂直视场 |
|---|---:|---:|
| 80 mm | 11.61 mm | 8.71 mm |
| 110 mm | 17.06 mm | 12.79 mm |

即便使用忽略近摄修正的粗略公式 `FOV ≈ S × u/f`，80 mm处也只得到14.52 × 10.89 mm，仍与28 × 18 mm有明显差异。

**上述数字是用于发现矛盾的估算，不是实际镜头的测量值，也不是误差上下界。** 商品工作距离可能从镜头前端测量，主平面位置、实际有效焦距、调焦和裁剪都会改变结果。它们足以说明现有28 mm结论缺少依据，不能直接冻结机械布局。

在相同薄透镜假设下，16 mm镜头覆盖28 mm水平视场需要u约170 mm；能否在此距离合焦、保留极性细节，仍需实测。

### 2.3 为什么它会影响整机

1. 80 mm附近可能只能覆盖少数穴位，不能按5～7个完整穴位安排算法和界面。
2. 横向放带时，12 mm载带及定位孔可能无法完整进入垂直视场。
3. 检测点与返修点计划相隔3～4个穴位，即12～16 mm；还需两端ROI、边缘余量和操作空间，小视场未必装得下。
4. 后续所有“每元件多少像素”“可用几帧”“还有多少停车距离”的预算都需重算。

**优先修正办法：使用最终相机模式，在载带高度平面放毫米尺，拍下水平/垂直视场；同画面放入真实载带、定位孔及极性标记。先得到可用视场和特征像素数，再决定工作距离、穴位数和返修布局。** 不必据此立即更换已选镜头。

## 3. 相机能力与当前官方工程不是同一基线

SC500CS手册第15页确实支持2592 × 1944@30、1920 × 1080@30、1280 × 720@60；其中FHD标为Crop，HD标为2 × 2 Binning and Crop。这说明切换模式可能同时改变视场与采样方式，不能默认只是对相同视场换一个像素数。

本次直接读取[官方Lab 1压缩包](E:/2026FPGA/FPGA_Component_Inspector/Example/01_MIPI采集与HDMI显示/lab_hd_1_mipi_hdmi.zip)，得到以下事实：

| 源码位置（压缩包内部） | 核查结果 |
|---|---|
| `user_source/hdl_source/uics500_cfg/uics500reg.v`，78～81行 | 输出宽寄存器0x3208/09为0x0400=1024；高寄存器0x320A/B为0x0258=600 |
| `user_source/hdl_source/design_top_wrapper.v`，539～540行 | 图像宽高参数1024 × 600 |
| 同一顶层，734、738行 | HDMI有效宽高1024 × 600 |
| `user_source/hdl_source/isp/isp_top.v`，50～51、78～79行 | ISP也使用1024 × 600 |
| `user_source/hdl_source/isp/data128_96/data128_96.v`，16行 | 96位数据由四组24位数据组成 |

因此：

- 应先以1024 × 600及实测输入帧率建立工程基线；不能预先把720p60作为已经能用的模式。
- 提升模式必须联动检查相机寄存器、解包、ISP尺寸、行缓存、DDR调度、显示时序和时钟吞吐量。
- 96位RGB接口一次携带四个24位像素的布局，与“一拍一个像素”的算法草图存在适配工作；需确定像素顺序、坐标步进、同拍跨ROI时的累加规则。
- 改为串行像素也可以，但必须证明时钟和FIFO能承受突发输入，不能只按每秒平均像素量估算。

[框架文档末节](E:/2026FPGA/FPGA_Component_Inspector/开发实施/03_系统框架与Codex接力协作流程图.md)已经承认“一拍像素数”未确定。这是需要前置关闭的接口问题。

## 4. 定位孔可以维持运行内相对编号，但不自带永久绝对地址

[总体方案第14节](E:/2026FPGA/FPGA_Component_Inspector/项目整体分析/基于国产FPGA的电子元件载带封装检测_项目总体分析.md)称定位孔提供“天然地址”。更准确地说，它提供周期位置基准；绝对地址需要起点、相位关系和持续可信的运动历史。

正常连续运行中，可用“本次基准建立后的第127穴”作为有效相对编号。比赛并不必然要求整卷永久绝对序号。失锁后停止并重建run_id与起点，旧队列冻结，确认受影响载带段后才能清理；可控暂停若位置仍可信则保留编号。

对于均匀孔列，载带前进一个完整P0后，局部孔列可以长得一样。例如P0=4 mm、速度20 mm/s，200 ms观测中断就可能漏过一个完整孔周期。如果又发生跳齿或手动拉带，电机发出的脉冲数也不能单独证明载带实际位移。

结果可能是：所有后续检测继续“正常显示”，但pocket_id整体偏移一位。NG FIFO会稳定地把错误穴位送到返修区，这是比偶发误检更难发现的系统错误。

需要新增明确状态和验收用例：

- 起始基准、P0/P1比例、运动方向和首次合法穴位的初始化规则。
- `UNSYNC / TRACKING / LOST / RECOVERY`，独立于元件OK/NG质量状态。
- 丢帧超时、孔数与步进预测不一致、反向拖动、孔损坏、队列满时的处理。
- 地址可信度丢失后禁止把后续结果冒充原编号；暂停送料，重新建立基准，并明确原队列如何处置。
- 遮住定位孔、暂停视频、制造一次滑移、连续NG及停车恢复时，核对实际标记穴位。

是否必须增加独立传感器或编码器取决于实测。若能证明连续观测条件和位移界限，视觉加步进预测可工作；若无法保证，就应失锁停车或增加独立位移证据。

## 5. B版运动验证与C版停车预算

### 5.1 每穴位可用帧数的公式需要改

[总体方案第6.4节](E:/2026FPGA/FPGA_Component_Inspector/项目整体分析/基于国产FPGA的电子元件载带封装检测_项目总体分析.md)以4 mm节距、40 mm/s、60 fps算出6帧。

```text
60 × 4 / 40 = 6
```

这个量是“载带前进一个节距期间采了多少帧”。它只有在可用检测行程恰好4 mm时，才能代表每穴位可用帧数。更一般地：

```text
可用帧数约为 N = 输入帧率 × 有效检测行程长度 / 载带速度
```

有效行程必须扣掉ROI不完整、边缘模糊、反光和判定截止位置等因素。若有效行程只有1 mm，上述工况只有约1.5帧的时间窗口，无法保证3帧投票；具体整数帧数还受采样相位影响。

多帧需要先统一穴位坐标，不能直接平均同一元件在不同帧中的绝对图像坐标。重复帧也不能当作独立观测；同一片反光持续存在时，多帧并不自动提升可信度。

### 5.2 曝光预算

设物方像素密度为s px/mm，速度v mm/s，曝光t秒，则匀速运动导致的像素模糊约为：

```text
模糊像素 b = s × v × t
```

例如只作为算例取s=50 px/mm、v=20 mm/s，若目标为b≤1 px，则曝光应≤1 ms。必须用最终模式的实际s和实际可接受模糊量重新计算。

还应测试逐行曝光导致的几何形变。SC500CS手册第21页图2-2展示逐行Reset/Readout时序；缩短曝光可以降低单行运动模糊，却不能自动消除不同行采样时刻不同造成的形变。这种区别也见[Basler快门原理文档](https://docs.baslerweb.com/electronic-shutter-types)。移动矩形的倾斜可能被误认为元件旋转，定位孔与元件跨行采样也会产生相对位置偏差。

滚动形变先实测是否影响判定，不要求A版实现补偿。双光场是可选升级，不宜仅凭输出VSYNC简单交替开灯。曝光窗口、传感器帧号、光源相位及驱动延迟需要一起验证，尤其是逐行曝光跨越光源切换的情况。

### 5.3 停车预算

从首次有效采样位置到目标停车位置的距离D至少满足：

```text
D ≥ v × T判定及控制 + v²/(2a可保证减速度) + 位置误差及余量
```

该式假定前段匀速、制动段恒减速度；真实加减速曲线应替换为实测停止距离。T应包括取像等待、所需帧数、读出、计算、跨域与驱动响应。

举例：v=40 mm/s，T=0.10 s，a=100 mm/s²，位置余量1 mm，需要约4+8+1=13 mm。在计划的12～16 mm检测—返修间距里已经不宽裕。这个算例不是对现有机构的实测结论，但说明停车间距必须由预算决定。

“像素流水线固定延迟”“多帧判定延迟”“采集到HDMI显示延迟”是三个不同指标。可变帧数的复核不能不加条件地宣称整个判定延迟固定；应报告最小、最大、分布和超时策略。

## 6. 动态功能启用时必须落实的时间关系

### 6.1 动态ROI生成具有因果顺序

A版使用固定ROI；以下约束在启用动态ROI或动态框时生效，不作为全部A版前置功能。

修订前的完整图把“定位孔 → 穴位ROI → 特征累加”画为直接流式通路。但是如果完整孔特征到图像较后位置才得到，元件对应像素可能已经经过。即使孔在上游，孔中心也要在相应区域结束后才稳定。

必须选择并验证一种实现：

1. 在扫描方向安排定位孔区域先完成，再处理元件区域，缓存所需行；
2. 用上一帧位姿加运动预测生成当前帧ROI，并预算预测误差及起步行为；
3. 保存必要ROI或图像后再处理，并重新预算存储和延迟。

已有“用行缓存”“传递valid”的规范是正确方向，但不能替代具体的扫描时序与数据可用时间说明。

### 6.2 检测结果和DDR显示帧必须匹配

检测支路产生的最新位置可能属于帧n，而HDMI正在显示DDR里的较早帧。直接把最新矩形框叠在旧画面上会漂移，即使CDC电路完全正确也一样。

应绑定采集frame_id、DDR写入/读出帧、结果快照和显示坐标；帧切换时原子更新结果。运动控制用带采样时刻/位置的实时事件，屏幕叠加用与所显示图像匹配的快照。两者可以共享判定，但时间语义不同。

## 7. 工艺边界、质量判据和误停成本还不完整

### 7.1 开放载带的输送方式

总体方案先定位为“装料之后、封盖之前”，随后又安排“放料卷盘放出已装料但未封盖载带”，并把盖带压合设为可选。对没有保持结构的开放穴位，转弯、卷绕、送料启停可能改变元件的位置或使元件离穴。

因此要区分两种真实可验证场景：

- 接在装料工序后的水平短段，检测/处置后进入封合或保持结构。
- 比赛用水平测试带，在导轨内制作缺陷和送料，明确不把未经保持与封合的收卷作为已验证功能。

若主张卷对卷，必须说明入口元件保持、局部开盖/剥离、出口保持或封盖结构，以及这些动作是否产生新缺陷。

购物清单中保存的是“小型桌面电动传送带、可调速正反转”条目；现有文字不能确认其电机类型、控制输入或定位能力。它与方案里的STEP/DIR齿孔送料之间缺一份接口核验，不能按商品标题推定已满足精准停车。

### 7.2 偏位和旋转不自动等于缺陷

元件与穴位之间存在容纳间隙，必须先定义具体包装和工序允许的平移、旋转、露出边界及方向。需分开：

- 整条载带在图像中的运动；
- 穴位相对定位孔的制造/定位偏差；
- 元件相对实际穴位的位姿；
- 允许活动范围内的正常变化与越界缺陷。

否则算法只是“偏离理想中心报警”，无法说明为什么需要返修。最好实测穴位边界或标定孔—穴位关系并计入容差，不能把名义坐标直接当作精确真值。

二阶矩提供主轴方向，通常不能独立区分0°与180°；正方形或近对称轮廓的主轴还可能不稳定。极性必须依赖独立可见标记，不应把二阶矩角度直接当成有向极性角。

### 7.3 3%～5%误检率可能使自动停车很低效

总体方案稳定版设定20 mm/s、4 mm节距，即不停车时300穴位/min，并提出3%～5%误检率目标。若每个误检都触发停车，假设每次确认恢复耗时10秒，仅误停就会使净吞吐显著下降：

```text
平均秒/穴 = P1/v + 误停概率q × 单次误停时间t
净吞吐 = 60 / (P1/v + q×t)
```

| 假设误停概率 | 每次误停耗时 | 仅计误停后的净吞吐 |
|---|---:|---:|
| 0% | 10 s | 300穴位/min |
| 3% | 10 s | 120穴位/min |
| 5% | 10 s | 约85.7穴位/min |

这是近似算例，假设每个误停单独处理，不计真实缺陷返修、加减速及合并处置。它说明“95%识别”和“可用闭环”不是同一个验收目标。应分别测正常件误停、异常件漏检、失锁停车、人工处置时间和净吞吐。

30张图片也不等于30个独立元件，更不能将相邻视频帧随机拆分为训练/测试集。应按物理样本、测试段或批次划分。即便30个独立样本零失败，单侧95%置信上界对应的失败率仍约9.5%；1000次独立试验零失败则约0.30%。这些只是统计界限，不代表本项目已达到对应结果。

## 8. 赛题逐项符合性

依据2026-09-05版[赛题原PPT](<E:/2026FPGA/FPGA_Component_Inspector/赛题要求与分析/赛题解析二 .pptx>)第5、6、26页，并与AI可读包内original.pptx同页复核。官网链接本次访问超时，未确认是否另有更新规则，因此本表严格针对用户提供的版本。

### 8.1 基础要求：最终设计至少3条

| 条目 | 方案覆盖 | 当前证据结论 | 要补的验收证据 |
|---|---|---|---|
| MIPI摄像头采集，HDMI实时显示 | 明确覆盖；官方Lab 1可作底座 | 未证明本项目上板完成 | 对应工程版本、实物采集显示、实际输入输出帧率 |
| FPGA完成至少一种图像处理，并输出处理后视频 | 灰度/二值/边缘模式有规划 | 未证明最终整合工程完成 | 同一镜像中可见处理画面，确认处理发生在FPGA |
| 处理后视频稳定连续，无明显异常 | 有30分钟等测试计划 | 只有计划，无本项目测试记录 | 连续运行录像、帧/错误计数、异常说明 |
| OSD图形或文字，包含“安路”Logo | 总体方案明确覆盖 | 文档冲突已修正，仍无上板完成证据 | Logo与检测叠加同屏的最终镜像演示 |

**Logo冲突是已修正的历史文档问题。** [资源规范第11节第1项](E:/2026FPGA/FPGA_Component_Inspector/开发实施/02_FPGA资源预算与代码优化规范.md)修订前要求“删除Logo、大图片和复杂OSD”；另有“不复制Logo”等语句。不能让资源优化误删赛题第4条需要的标识。

应改成：“保留可辨认的安路Logo，以小尺寸位图/ERAM实现；删除大型组合ROM的原实现和无关演示图形。”本轮已按批准将资源规范改为保留轻量Logo。

严格按这份PPT，缺Logo意味着基础第4条不能算完成；若其余3条成立，仍满足‘至少3条’，所以不能推断缺Logo就自动不合格。但它会破坏项目承诺的四项完整覆盖。

只输出原始画面和分类框，不能当然证明基础第2条的“输出处理后视频”。保留可切换的灰度或二值视图，最容易现场验证。

### 8.2 扩展要求：最终设计至少1条

| 条目 | 项目对应 | 判断 |
|---|---|---|
| 风格化/视觉增强 | 边缘、增强和调试视图 | 可能覆盖；固定外部照明本身不能作为FPGA视频增强完成证据 |
| 目标检测识别并叠加结果文字 | 穴位/元件检测、空穴/方向分类、文字与框 | 最直接且足够独立的扩展主线；不强制CNN |
| 实际场景外部控制 | 图像NG驱动送料停车 | 方向符合，须演示动作由实时识别触发 |
| 实时性、资源等性能优化 | 流水线、共享计算、ERAM等 | 有方法不等于已优化；需同功能条件下的前后数据 |
| 自主创新 | 逐穴追踪、处置复检等 | 可以作为创新说明，程度由实际实现和评审决定 |

从方案覆盖看，做好“检测识别+叠加结果”就已有清晰的扩展路径。电机、双光场、复检、第二配方不是满足至少1条扩展的共同前提。

### 8.3 整机硬约束与进阶建议

| 项目 | 当前结论 |
|---|---|
| 必须HX1P35A | 方案正确；实物需核对。目录中有HX1P35B命名的手册/原理图，不能仅凭文件名判定实物不符合 |
| 固化、上电运行，无需PC重新下载 | 已规划，无最终固化和冷启动证据；应从早期视频版本就验证启动链 |
| 已实现功能整合在一个最终设计 | 已规划，无最终整合工程证据；三个单独Lab不能合并计为一个已完成作品 |
| 实用性 | 场景有逻辑，但开放载带保持、质量阈值、地址恢复与净吞吐需验证 |
| 优化逻辑、功耗 | 不能依据资源占用大小单独判断作品优劣；报告功耗应说明测量边界 |
| 多算法、跟踪、延迟可视化、运动检测、图像自调节 | PPT为尝试/鼓励/探索方向，未设为全部必做 |

进阶第3项说的是“采集到显示”的延迟。项目目前主要描述“检测线到判定”的延迟，两者不能互相替代。进阶第4项帧差运动检测与定位孔测速也不是完全同一个实现；固定曝光不能算自动图像质量调节。无需为凑全这些建议而扩张稳定版。

总体方案中的“不得加入非安路FPGA”等表述，在这份PPT第5、6、26页及已读文字中未找到直接依据；可以保留为团队设计约束，但不应不加来源地转述为本次已经核实的赛事原文。PPT明确写的是无需PC再次下载；项目主动选择核心检测无PC运行，是更明确的工程边界。

## 9. 计划最大的管理漏洞：最小可交付版本过大

[总体方案稳定版清单](E:/2026FPGA/FPGA_Component_Inspector/项目整体分析/基于国产FPGA的电子元件载带封装检测_项目总体分析.md)同时要求四类缺陷、多穴位、动态ROI、编号、FIFO、精准停车、人工返修、同相机复检和统计。只要任何一个困难环节推迟，就无法宣布稳定版完成。

同时，多帧融合在前文被作为默认判定策略，在冲刺清单和资源规范中又被安排为后加功能。若单帧达不到误检要求，多帧实际就是前置依赖；若单帧足够，就不应默认把融合复杂度压进第一版。需要用实测统一版本边界。

阶段路线把完整机械验证放在静态四类检测之后，但目标速度、抖动、保持结构和可用窗口会反过来决定成像和算法。已有第一周计划提到动态图像，这一点应落实成前置的小型运动试验，避免一直等到阶段7/8才发现前面数据不适用。

建议三个可验收版本：

| 版本 | 必须完成 | 退出条件 |
|---|---|---|
| A：赛题完整视频与最小识别 | HX1P35A、MIPI、至少一种处理后视图、稳定HDMI、安路Logo、真实载带的存在/空穴识别与文字、固化冷启动 | 同一镜像独立运行，形成基本+扩展证据 |
| B：可信连续检测 | 一种锁定料号和载带、低速运动、相对编号、失锁策略、启用动态显示时的帧匹配；方向识别待特征验证后再加 | 样本与实物ID对应，运动检出/误停/漏号可量化 |
| C：处置闭环 | 已测停车预算、缺陷队列、连续NG、停靠、人工处置和同相机复检 | 正确穴位停车与恢复，包含异常注入测试 |

偏位/角度精测、双光场、第二配方、缺陷地图与自动配方按证据再加入。这样既保留最终目标，也能尽早拥有可提交作品。

## 10. 现在优先完成的六项工作

1. **确认并固化现有视频基线。** 记录1024 × 600模式的真实输入帧率、像素格式和复位行为；保存本机工程及启动证据。
2. **量真实视场。** 最终模式下用标尺测宽高、焦平面和边缘可用区域，重新评估16 mm镜头及检测/处置位置。
3. **A版锁定一个样品。** 候选库目前仍将顶部可见性和包装尺寸标为待验证；落实具体料号、实物载带P0/P1、正常活动范围；A版先正常/空穴，方向真值在启用方向检测前补齐。
4. **B版做小型动态成像试验。** 无需先造完整卷对卷机构；测短曝光下的极性、孔位、形变和有效帧数。
5. **分阶段填写系统预算和异常状态契约。** 包含有效检测行程、最大判定时间、制动距离、定位误差、丢帧/失锁/队列满与恢复动作。
6. **依据已修订计划形成版本A。** 保留轻量Logo；统一多帧是否依赖；生成同一最终设计的证据，再推进高难度闭环。

最有价值的下一项实验是：**在当前实际相机模式下，拍一张同平面的毫米尺、整条载带宽度、数个定位孔和真实正反向元件。** 它能立即检查项目最关键的空间假设，并为像素精度、可用帧数、机械间距和后续算法提供同一套依据。

## 11. 补充证据说明

- 候选库“候选元件库”J5:J14仍为待实物验证；M5:N16的载带宽度和节距仍为待核实。资料初筛有进展，但不能当作成像与机械验证已完成。[元器件候选库](E:/2026FPGA/FPGA_Component_Inspector/待测元器件选择/待测元器件候选库.xlsx)
- 本次核对官方Lab 1/2/3的`final_timing.rpt`，总体SWNS分别0.629、0.234、0.121 ns，与资源规范列出的官方历史数据一致。这支持参考工程的风险评估，不证明新增检测算法合并后的时序。
- 数学算例均基于文中明确假设，未作为实测成绩；本报告没有推断获奖概率或承诺工业产线级性能。
- 首次评审未修改原计划；本轮经批准已更新总体分析、开发路线、资源规范、框架、验收模板、样品方案及Word，新增接口约定。候选工作簿和官方工程未修改，实物测试尚待完成。
