czp-1-A1/FPGA_Component_Inspector/开发实施/01_阶段验收记录模板.md

# 阶段验收记录模板

> 本文件是AI填写的正式测试记录模板。人按Word操作手册完成实物操作并提供证据，AI复制本模板为每轮测试生成独立记录，不覆盖模板。版本A/B/C与团队组名不同。

## 0. 人与AI怎样协作

1. 测试前：AI说明本次测什么、操作顺序、需要保存的文件、通过条件；未定的验收目标先列出，不能看到结果后倒推目标。
2. 人执行实物操作，提供原图、视频、日志、工具报告和必要的现场说明。AI有实际工具访问能力时可直接收集工程报告，但必须记录来源。
3. AI在`开发实施/验收记录/日期_步骤_轮次.md`保存本轮记录，原始证据建议放到对应同名目录。只填写与本轮有关的章节，其余注明不适用原因。
4. AI区分“仪器或报告实测”“从图像或日志计算”“人工口述”“估算”。每个关键结果引用具体文件、页码、时间段或行号，并写明单位和计算方法。
5. 未执行写“未测”；缺证据写“待补证据”；确实不适用写“N/A及原因”。不得把计划值、官方例程成绩、显示刷新率或猜测当成本项目实测。
6. AI根据事先目标给出“通过、需补测、未通过”，列出依据和缺口。没有证据不能默认通过；不虚构验收人或签字。
7. Word仅同步步骤状态、一句关键结论和本轮记录路径，不重复维护详细数据。更正记录时保留原值、修正依据和日期，复测另建记录。

### 本轮证据清单

| 证据编号 | 文件路径及定位 | 内容与来源类型 | 能支持什么 | 缺失或限制 |
|---|---|---|---|---|
| E01 | | | | |

测试前约定的目标及来源：

本轮待补信息及由谁提供：

## 1. 基本信息

| 项目 | 填写 |
|---|---|
| 版本与步骤、负责人、日期 | |
| 工程提交号、bitstream及TD版本 | |
| 板卡丝印、摄像头、镜头 | |
| 输入模式/帧率、HDMI模式/帧率 | |
| 光源、曝光、工作距离及测量起点 | |
| 相机倾角、支架锁紧和导轨基准 | |
| 元件料号、载带宽度、P0/P1 | |
| 运行段编号、速度及真值表位置 | |

## 2. 测试前目标与本次变化

- 本次只改变：
- 本版本启用的检测类别：
- 样本数量和误报/漏检/定位等目标：
- 测试方法与停止条件：

## 3. 视场及重复装夹 A起

| 距离 mm | 有效视场宽高 mm | 完整穴位数 | 孔/标记可见性 | 重装夹后结果 | 照片 |
|---|---|---|---|---|---|
| | | | | | |

## 4. 物理穴位真值 A起

| 测试段/物理号 | 料号 | 真值类别 | 制作与测量方法 | 运行段/相对号 | 检测结果 | 原图 |
|---|---|---|---|---|---|---|
| | | | | | | |

标记不放入检测ROI或定位孔；调参集与独立测试集按物理样本或测试段分开。初始NG、返修后真值与复检结果分开记录，复检不重复计产量。

## 5. 每次模块集成记录 A起

| 工程/新增模块 | LUT/Slice | FF | ERAM | DSP | 对前版增量 | 建立/保持WNS | 报告位置 |
|---|---|---|---|---|---|---|---|
| | | | | | | | |

- 时钟和I/O约束覆盖、未约束路径说明：
- RAM/DSP映射检查：
- 接口表、像素顺序、valid/sof/eol和帧匹配检查：
- 本次功能与视频是否同时通过：

## 6. 运动及电气干扰 B起

| 工况 | 实测速度 | 曝光/可用帧 | 视频错误计数前后 | 闪屏/重启 | 供电/回流/布线与证据 |
|---|---|---|---|---|---|
| 电机关闭 | | | | | |
| 匀速运行 | | | | | |
| 反复启停 | | | | | |
| 光源开关 | | | | | |

## 7. 编号和异常恢复 B起

| 注入情况 | 是否失锁/暂停 | 旧结果/队列处理 | 新运行段/基准 | 恢复结果与实物核对 |
|---|---|---|---|---|
| 孔遮挡/视频中断 | | | | |
| 滑移/手动移动 | | | | |
| 受控暂停再继续 | | | | |

最大可信观测间隔、位移偏差及依据：

## 8. 停车与队列 C版

| 速度/负载 | 判定及控制时间 | 最坏停止距离 | 检测到处置距离 | 误差余量 | 是否足够 |
|---|---|---|---|---|---|
| | | | | | |

FIFO深度：　高水位：　停车期间新增事件储备：　复检完成条件：

| 场景 | 停靠物理号是否正确 | 未决事件是否保留 | 恢复结果 | 证据 |
|---|---|---|---|---|
| 单NG/相邻NG/间隔NG | | | | |
| 全NG/高水位/队列满 | | | | |
| 复检失败/失锁重同步 | | | | |

## 9. 指标与证据

| 指标 | 分子/分母或测法 | 实测 | 目标 | 是否通过 |
|---|---|---|---|---|
| 正常误报 | 正常判NG数/正常数 | | | |
| 异常漏检 | 分类别，异常放行数/异常数 | | | |
| 正常件误停 | 次数及每百正常穴次数，C版 | | | |
| 停错穴 | 错穴次数/定位停车次数，C版 | | | |
| 丢号/重号/失锁/重同步 | 分开计数及原因，B起 | | | |
| 净吞吐 | 唯一完成穴数/含停车处置恢复的总分钟 | | | |
| 延迟 | 流水/采样到判定/采集到显示分开 | | | |
| 冷启动 | 不重新下载，成功次数/测试次数 | | | |
| 连续视频稳定性 | 时长、错误计数、录像 | | | |

## 10. 阶段结论

- [ ] 通过，进入本计划下一步
- [ ] 需补测，当前结论未定
- [ ] 未通过，保留已验收版本

失败样例、原因及下一步：

AI整理日期：　人工操作人：　人工复核状态（未复核/已复核）：

验收人（实际确认后填写）：　日期：　工程/图片/视频/日志存放位置：

### 同步到Word的摘要

- 步骤与当前状态：
- 一句关键结论：
- 本轮正式记录路径：
- 下一步操作或待补证据：
