czp-1-A1/FPGA_Component_Inspector/开发实施/05_计划修订记录_20260907.md

# 计划修订记录

日期：2026-09-07。用户已批准十项修订及Word更新。

## 已实施的修改

| 修订项 | 写入位置 | 仍需完成的实测 |
|---|---|---|
| 实测视场优先，穴位与布局不预设 | 总体分析、00路线、01记录、样品方案 | 标尺视场、标记像素数、复装重复性 |
| 官方1024×600工程基线 | 总体分析、00路线、团队HTML | 输入帧率、稳定运行与冷启动 |
| A/B/C分版，先单帧识别 | 总体分析、00路线、02资源、03框架 | A正常/空穴；B运动；C停车 |
| 运行内相对编号与失锁重建 | 总体分析、04接口 | 漏孔、视频中断、滑移及暂停恢复 |
| 停车距离先测，多NG队列明确 | 总体分析、01记录、04接口 | 停靠误差、高水位、在途事件和队列满 |
| 缺陷分项指标与物理真值 | 总体分析、01记录、样品方案 | 独立验收段、各类误报漏检、净吞吐 |
| 保留轻量安路Logo | 02资源、总体分析、00路线 | 最终镜像显示证据 |
| 写RTL前落实像素与时序接口 | 04接口、03框架 | 像素顺序、有效信号、动态ROI及帧匹配 |

## 验证项的阶段归属

- A：每次集成记录资源与时序，固定夹具和标定，独立真值集，固化冷启动。
- B：电机启停干扰、运动清晰度、滚动形变、相对编号；启用动态显示时验证帧匹配。
- C：制动距离、多NG处理、队列余量、失锁后的旧队列处置、人工处理后复检。
- 可选升级：双光场、方向及偏位旋转精测、多帧融合。是否加入由实测与需求决定。

## 配套文档与完成状态

第一性原理评审保留旧计划问题背景，新增已修订状态与阶段限定。Word已改为可编辑的执行与实验填写表，不再要求重复授权。原文件已在本轮修改前备份。

文档修订完成；实拍、资源时序闭合、识别率、停车成绩和赛题实物验收均不能据此标为完成。官方工程、候选工作簿和购物资料未修改。

## 按AI协作方式调整文档分工

用户确认主要由AI整理和填写，人需要明确测试操作。Word保留原文件名以便查找，内容改为操作与证据采集手册：八步分别说明目的、人工操作、交给AI的证据和继续条件，末页仅保留进度摘要。01模板作为AI填写的正式记录，规定逐轮保存、引用证据、区分来源、缺失项不猜测和人工复核状态。详细数据不在两份文件重复维护。
