czp-1-A1/FPGA_Component_Inspector/开发实施/06_机械结构概念与建模边界_20260908.md

# 机械结构概念与建模边界

日期：2026-09-08。阶段：结构概念待用户确认。用户已明确选择“木板＋少量3D打印件”，优先简单、低成本、容易装配。本轮先出概念图；用户确认后再制作HTML整体展示及建模三视图，不冻结生产尺寸。

最新结构输入：用户确认摄像头可通过原排线折到开发板背面，并由用户直接固定到已有隔离板。本设计把“开发板＋隔离板＋背面摄像头”视为一个已有组件，不设计或审查其内部相机固定方式。外部支架仅承托整体、调高度并避让镜头。

## 1. 现在能提前做什么

可以开始总体占位、参数化骨架和可调机构的设计。优先解决相机与载带的相对位置固定、照明调节、板卡安装及走线。视场未实测时，镜头工作距离、检测穴位数和处置区距离不应定死。

现行建议结构为：木底板 + 宽木立板及两块三角加强板 + 分档调高的双侧承托架 + 环形灯短槽微调支架 + 载带侧导向及水平出料托板。整块开发板水平放置，正面向上，背面摄像头镜头向下。承托架中间留空，不用完整木托盘挡住背面镜头。送料机构与相机架分别固定到底板，避免把相机的重量和调整力直接交给塑料传送带框架。实际振动仍须联调验证。

取消首轮概念中的金属型材龙门、丝杆升降台和复杂机加工件。相机整体通过换安装孔位调高；短槽只做小范围微调，拧紧后固定。先验证检测功能，再决定是否需要更精细的机构。普通螺钉、螺母及垫片可用于连接，主体不依赖金属加工。

## 2. 购物资料能确认到什么程度

| 物品 | 已见本地依据 | 设计用途与限制 |
|---|---|---|
| HX1P35A板子与SC500CS摄像头 | 商品图显示短柔性排线连接；用户确认相机可折到已有背面隔离板并自行固定 | 作为一个组件承托，摄像头位于开发板下方；仅需组件外形、可承托位置和镜头位置来设计外部支架 |
| 小型白色传送带 | 文件名“长40cm-宽8cm”，照片有端部黄色减速电机 | 暂按400×80 mm名义占位，不能当精确安装尺寸；无编码反馈或精准停车性能证据 |
| 环形灯 | 商品图标SJ-R9060-D40，外径90、内孔40、高22 mm；图示4×M3深4及78 mm圆 | 可作初步灯座包络，安装孔侧别、位置、深度和选购型号仍须核实 |
| 光源控制器 | 单路型号示图：输出24V/48W，可调18.5至24V；示图宽74.5、高39.5、长103、安装宽88 mm | 基座侧边安装，预留旋钮、开关与接线空间；核对实际购买型号、光源额定电流及连接器后接线 |
| 16/25 mm镜头 | 本地参数文件均写M12×P0.5，最大宽度14 mm，高18.3/20 mm | 不用商品视角冻结SC500CS视场；保留调焦及镜头拆装空间 |
| M12螺母帽 | 仅有短链接，无所选规格图 | 核对是否为M12×0.5镜头锁圈；普通标“M12”的五金螺母帽不能直接判为兼容 |

以上来自购物清单图片和文字，不是到货尺寸验收。未访问或确认商品当前库存、价格与变体。

## 3. 板子与相机怎样一起安装

开发板正面朝上，已有隔离板在下，摄像头固定于隔离板背面，镜头朝下。原排线绕过板边连接，形成紧凑的上下叠放组件；内部相机固定和折线方式由用户处理，不增加单独的相机前伸支架。

自制支架采用两侧短承托臂，支承已有隔离板的可用边缘并防止整体滑移。中间及镜头下方留空。承托边具体位置以用户组件实际可承托区域确定，不夹PCB器件或接口。开发板接口、按键和调焦操作仍可触及。

整个组件换孔调高，环形灯通过短槽独立微调。光轴应依次穿过灯的内孔并落在载带检测位置；相机折到背面后，光轴未必位于开发板几何中心，外部支架按实际镜头位置对齐，不按板中心猜测。

## 4. 具体需要建模的零件

| 优先级 | 自制件或组件 | 需要的调节与装配功能 |
|---|---|---|
| 先做 | 木底板、宽立板及两块三角加强板 | 用普通板材切割钻孔，固定设备，侧向不明显晃动；底板预留后续送料机构安装位 |
| 先做 | 双侧承托臂与连接块 | 小型3D打印件，用成对安装孔分档调高；只托已有组件可承托的两侧，中间避让镜头 |
| 先做 | 环形灯双侧支架 | 从灯壳安装位置承重，灯高独立调节，中央光路无遮挡，不夹持镜头承重 |
| 随后 | 载带侧导向和入口引导 | 按载带宽度调节，仅约束侧向，不遮定位孔或压元件；支架固定，载带在内部移动 |
| 随后 | 控制器固定座与线夹 | 控制器固定到底板，方便操作，外部线缆有余量并固定 |
| 后置 | 遮光罩、整机外壳及专用送料轮 | 先验证光照、散热、停车和排线空间，再决定形状 |

承重面积较大的底板、立板、加强板及出料托板优先用木板，3D打印只做双侧承托臂、短灯架、导向块和线夹，避免为了支架打印一整套大机器。取消上版单独的相机安装板及完整共用木托盘。木板厚度、打印材料、壁厚及连接件尺寸根据实物重量和试装决定；木板孔位尽量简单，打印孔先用小试件检查装配。概念图不代表已经验证刚度或长期稳定性。

保留相机原有镜头座，不把打印M12精细螺纹作为本轮任务；现成传送带、环形灯、控制器以外购件占位即可。优先只做能开始视场测试的板卡相机托架，确认视场后再完成灯架和侧导向，减少反复打印。

## 5. 当前清单还不等于完整停车系统

现有平带适合先验证运动成像。载带与平带之间可能相对滑动，照片也无法证明减速电机已有适合FPGA的驱动输入、位置反馈和停止重复精度。C版仍要核对电机额定参数及驱动器，测实际停止距离，再决定是否补充齿孔送料或位置反馈。

开放载带保持水平通过，不能随输送机端部滚筒卷下去；入口和出口要有支承，并保留前方人工取放空间。处置区在下游预留，是否同相机复检、最终相隔多少，待视场和制动实验确定。

M12镜头的S接口名义螺纹是M12×0.5；所选螺母要逐项核对螺距、厚度及不干涉调焦。[Edmund Optics接口说明](https://www.edmundoptics.com/c/m12-smount-lenses/1005/)

## 6. 从概念图到工程三视图

材料与简易布局已确认：带三角加强的木立板、共架板卡相机、独立灯架、侧导向、下游操作空间。已制作HTML旋转查看与部件说明，以及同一展示几何生成的正视、俯视、右视结构示意。它们用于确认布局，不替代实测定尺寸后的CAD加工图。

正式建模前由人量、AI整理：已有板卡相机组件的外形、总厚度、重量、隔离板可承托位置以及镜头轴相对组件边缘的位置和向下突出量；传送带实物外形、带面高度、固定位置；灯和控制器安装孔；镜头实际合焦与视场距离；载带及元件高度。无需为了外部支架重新测绘内部相机固定孔或设计排线折弯。

采用规范工程图表达即可，不为了“工业级”增加昂贵结构或无必要的精密公差。木板出切割外形和钻孔定位图；打印件出正视、俯视、右视及必要剖面，并配可打印模型。统一投影法、基准、单位和比例，标明材料、板厚、孔径、装配间隙；未知尺寸用参数或待测标识。生成概念图只供布局确认，正式三视图从同一CAD几何导出，实测定尺寸后才进入制作。

## 7. 概念图检查说明

首张V1金属结构生成图存在相机朝向与光路错误，且不符合后来确认的简易材料方案，已弃用，不可照着建模。正确设计是两块PCB水平固定在同一托架，相机唯一镜头在相机PCB下方，光轴垂直穿过环形灯中心并对准载带。生成图中的电路板元件布局、传送带细节和紧固件均为示意，以实物替换。

旧学生简易版图片`机械概念图/木板与3D打印_学生简易版_20260908.png`采用相机与板卡平铺，已被用户的背面折叠方案替代。旧图还存在板卡型号文字和出口载带方向错误，不作为本轮建模依据。

背面折叠版的结构重设计已写入本文件；本轮新概念图连续两次因图像服务网络错误未生成成功。暂无与新结构匹配的生成图，不把旧图标为新版。HTML和正式三视图尚未开始。

2026-09-09更新：背面折叠版概念图已成功生成，保存为`机械概念图/摄像头背面折叠版_概念V1_20260909.png`，替代以上“暂无新图”的状态。图片符合背面相机、双侧承托、镜头避让和水平出料的布局意图。内部板卡相机外观、控制器接线及灯架连接细节均为示意，不作为制造或接线依据。用户随后确认增加前后调节，当前执行以下方案。

## 8. 已确认的调节结构与展示文件

板卡、已有隔离板与背面摄像头作为整体，两侧托臂承托，中间留空。木立板按孔位分档调高；两侧托臂设置前后长槽，组件同步前后移动，锁紧后保持镜头朝下。调整高度时先托住组件，再拆装连接螺钉，左右使用同一排孔。实际孔距、槽长、承托宽度和螺钉规格待实测确认。

环形灯采用独立支架：竖槽调灯高，横向支臂的前后短槽调中心位置，外侧承托避免遮挡中央光路。调节顺序为：先调板卡高度与前后位置，使镜头对准器件并合焦；再将灯中心移到镜头轴线下；最后调灯高、亮度并实拍检查反光。不能只把灯对准器件，却让镜头仍然偏离检测区。

展示入口：`机械结构展示/背面折叠支架_调节与三视图.html`，可离线打开、拖动旋转、切换视角、分别调整板卡和灯，并下载当前三视结构示意。默认状态已导出为`机械结构展示/背面折叠支架_三视结构示意.svg`。

页面里的毫米值和高度档位用于演示交互，不是实物测量结果；光轴对齐提示只验证展示几何，不能证明实际成像与照明合格。正式加工三视图、打印模型及公差仍须在第6节实测完成后生成。
