czp-1-A1/FPGA_Component_Inspector/官方资料/00_资料索引.md

# 官方资料索引

## 1. 资料来源与整理原则

- 官方原始资料：`E:\2026FPGA\HX1P35A_Contest_202606`
- 本项目资料目录：`E:\2026FPGA\国产FPGA载带元件智检仪\官方资料`
- 整理日期：2026-08-28
- 本目录只复制当前“载带元件智检仪”开发中直接有用或较可能用到的资料。
- 官网原始资料没有被移动、修改或删除；大型安装包、无关外设例程和重复压缩包仍保留在官网原目录中。

## 2. 最推荐的阅读顺序

1. `02_开发板与引脚/新HX1P35A开发板手册-HDL版2604.pdf`
2. `01_赛题参考例程/参考文档/lab_ex_1_MIPI采集与HDMI显示.docx`
3. `01_赛题参考例程/01_MIPI采集与HDMI显示/lab_hd_1_mipi_hdmi.zip`
4. `01_赛题参考例程/参考文档/lab_ex_2_边缘检测.docx`
5. `01_赛题参考例程/参考文档/lab_ex_3_OSD叠加.docx`
6. `03_PH1P35芯片与MIPI/UG1316_安路科技PH1P系列FPGA MIPI用户手册.pdf`
7. 遇到资源、时序、封装或电气问题时，再查 `DS1300_PH1P_Datasheet.pdf` 和开发板原理图。

## 3. 各目录用途

### 3.1 `01_赛题参考例程`

| 资料 | 对本项目的作用 | 建议 |
|---|---|---|
| MIPI采集与HDMI显示 | SC500 摄像头输入、RAW10 解包、基础 ISP、DDR2 帧缓存和 HDMI 输出的底座 | 第一阶段先完整跑通 |
| 边缘检测 | 提供流式邻域运算、行缓存和边缘算子的参考结构 | 可复用于定位孔、穴位边界和元件轮廓检测 |
| OSD叠加 | 提供检测框、文字/图标、计数等画面叠加思路 | 用于显示穴位编号、OK/NG、缺陷类型和统计信息 |
| 参考文档 | 三个实验的操作和模块说明 | 解压工程前先读 |

三个实验压缩包按原文件名保存，没有改动内部工程。第二个压缩包原名本身为 `lab_hd_2_edge.zip.zip`，不是整理时误加的后缀。

### 3.2 `02_开发板与引脚`

包含开发板手册、引脚汇总和 10 页开发板原理图，主要用于：

- 确认 MIPI、DDR2、HDMI、系统时钟和复位连接；
- 选择电机驱动、传感器、按键、蜂鸣器和补光控制使用的扩展 IO；
- 核对 IO Bank 电压、电平兼容性和外接电路连接；
- 编写或复核工程引脚约束。

> **重要版本提示：** 手册名称为 **HX1P35A**，但引脚汇总和原理图名称为 **HX1P35B**。正式接电和写约束前，必须同时核对实物板丝印、当前官方例程约束文件和原理图，不能只照抄“AI易读版”引脚表。

### 3.3 `03_PH1P35芯片与MIPI`

| 资料 | 主要用途 |
|---|---|
| `DS1300_PH1P_Datasheet.pdf` | PH1P35 资源、电气、时钟、存储器、DSP、封装和引脚资料 |
| `DS1301_PH1P_FamilyOverview.pdf` | 快速查看 PH1P 系列能力和型号差异 |
| `UG1316_安路科技PH1P系列FPGA MIPI用户手册.pdf` | MIPI D-PHY 硬核、通道、时钟、接口和配置方法 |
| `参考IP设计资料文档.zip` | 后续使用官方 IP 时查阅 |
| `安路选型手册_202503.pdf` | 编写器件选型与资源适配论证时使用 |

PH1P35 提供 MIPI 硬核、片上存储、DSP、PLL 和 DDR 接口能力，适合作为本项目低延迟流式视觉链路的核心。具体可用资源和约束仍应以综合、布局布线报告为准。

### 3.4 `04_接口与开发流程`

- `安路软件使用完整流程.pdf`：TD 工具建工程、综合、布局布线和下载流程。
- `FAE培训_硬件接口相关(1).pdf`：扩展 IO、电平和接口设计的基础参考。
- `FPGA 设计与开发的工程设计流程.pptx`：项目分层、验证和工程流程参考。

## 4. 已在主工程中、未重复复制的官方资料

以下三个文件已经位于 `摄像头+镜头` 目录，并与官网对应文件的 SHA-256 完全一致：

- `摄像头+镜头/SC500CS_数据手册_V1.8.pdf`
- `摄像头+镜头/SC500CS板原理图.pdf`
- `摄像头+镜头/6504镜头.pdf`

用途分别是 SC500CS 寄存器与成像参数、摄像头小板供电/MIPI 接线、原配镜头参数。它们是完成摄像头初始化、曝光控制、光学选型和接口排查的直接依据。

## 5. 项目模块与官方资料对应关系

| 项目模块 | 首选资料 |
|---|---|
| SC500 图像采集 | Lab 1、SC500CS 数据手册、SC500CS 板原理图、MIPI 用户手册 |
| RAW10/ISP/DDR2/HDMI | Lab 1、开发板手册、开发板原理图 |
| 定位孔与轮廓提取 | Lab 2，后续在其流式行缓存结构上改造 |
| HDMI 检测框和文字显示 | Lab 3 |
| 元件分类、偏移、旋转、极性检测 | 在 Lab 1 视频链路上新增项目自研模块；官方例程只作为底座 |
| 穴位编号与运动跟踪 | 定位孔检测模块 + 项目自研状态机/FIFO |
| 电机、传感器、蜂鸣器和补光 | 开发板手册、引脚汇总、开发板原理图、硬件接口培训 |
| FPGA资源与器件选型论证 | DS1300、DS1301、安路选型手册、最终综合报告 |

## 6. 没有复制到主工程的内容

以下资料不是被删除，而是继续保留在官网原目录：

- 约 3 GB 的 TD 安装包和软件工具；
- 约 2 GB 的驱动、网络工具和第三方软件；
- 与当前作品无关的 GPS、以太网、AD/DA、LCD、音视频等通用例程；
- 大量综合日志、临时文件和重复工程；
- `安路比赛文档2026.zip`：其中主要内容与已复制的三个独立实验包重复，故没有再次复制；
- AD 元件库和 PCB 封装库：当前阶段不自制 FPGA 核心板，暂不放入主工程；若后续制作扩展 PCB，可回官网原目录取用。

## 7. 当前建议

先以 Lab 1 建立一份项目基线工程，确认摄像头、DDR2 和 HDMI 全链路稳定；随后分别移植 Lab 2 的流式邻域处理结构和 Lab 3 的 OSD 结构。不要直接在官方压缩包内改工程，应解压到主工程后另建版本控制目录，保留一份未修改基线用于对照。
