czp-1-A1/FPGA_Component_Inspector/开发实施/验收记录/20261003_A像素接口验证_轮次1.md

# A像素接口验证：轮次1（2026-10-03）

## 本轮范围与结论

用户确认先做成像条件记录和像素接口验证；不改综合RTL，不生成新bit，不进入分类阈值或ROI实现。基本按键与亮度响应已由用户确认。接口特点与正常数据路径在模型仿真中得到验证，但整体A版和全部相机/DDR链路未验收。

分支hx1p35a-contest-work，HEAD f87ccf1c6a38e84b58a4f86cecd532a71ae56e89，工作区未提交。原实验位流及195项RTL/IP/SDC构建输入SHA-256全部不变。bit SHA-256仍为0b1a72e36772b852195fd16275d9540bd694d849a3dae2b110596f2eac6c907a。

## 成像条件（人工报告）

LM358DR，镜头端面到载带约280mm；建模可调范围约60～400mm；EXP1460半行，GAIN报告90；光源未测，原始帧采集方式尚不确定。源码GAIN上限89，差异保留待核对，未擅改数据。详表在11文档。这些是临时实验条件，不是最终锁定参数；无需因暂未定死而停止接口验证。

## 测试方法与限制

Icarus Verilog v12。选择TD .al列出的根目录awb.v/signal_delay.v，使用实际双线性、96/128转换RTL和divider_gate网表。线性x梯度确认lane顺序，BGGR R100/G50/B20确认RGB，等RGB样本使真实除法器输出1倍用于AWB像素标签追踪。与外部参考字节串比较，不用DUT信号作为期望数据。

首次尝试直接编译厂商库，因保护块解析报al_map_basic.v:1009 syntax error失败；Icarus无法执行加密ERAM。后续只编译厂商已公开的明文DFF/LUT/Adder/glbl定义，不解密保护块、不改厂商文件；ERAM使用awb_ram_model.v的96×2048同步读一拍/读前写模型，不清RAM。模型边界必须带入结论：不代表厂商完整ERAM验证或上板物理延迟。原语编译有typ选择及输入coerced to inout警告，来自既有厂商定义。

本轮测试输入为1024宽、3行（AWB高度配置600）；没有伪称已覆盖完整600行图像或MIPI、整个demosaic邻域生成、DDR/FIFO/HDMI联调。

## 证据与结果

| 项目 | 结果 | 原始证据 |
|---|---|---|
| 双线性模块x梯度、RGB通道、5级数据/标志对齐 | PASS | pixel_interface.log |
| AWB四lane标签与连续正常行 | 768输入拍=768输出拍，3行各256拍 | pixel_interface.log |
| 96→128字节流 | 576字、全部匹配12像素参考串 | pixel_interface.log |
| 每行2处各2拍输入暂停 | 数据保持完整，输出连续 | pixel_interface.log；仅此暂停程度 |
| user到第一像素 | 连续53拍，短暂停顿55拍 | pixel_interface.log；RAM模型仿真值 |
| ready低 | 180拍输出仍有效，无有效回压 | pixel_interface.log |
| 复位/首帧 | 输出启动前复位，随后新帧标签无污染 | pixel_interface.log；不扩展为全部复位时序验证 |
| 残缺行 | 64拍输入仍回放256拍、unknown=0 | pixel_interface.log；暴露完整性保护缺口 |
| 打包中reset/SOF | 不重启相位，仍拼接连续字节流 | pack_boundary.log |
| 打包中valid空拍 | 相位清零；残余64位丢弃；完整新组可恢复 | pack_boundary.log |

这些负面场景的PASS表示“如实复现现有接口行为”，不是残缺帧防护通过。不能依据AWB输出宽度正确、无X或valid连续判输入完整。

## 新文件与复现

新增sim/tb_pixel_interface.v、tb_pack_boundary.v、awb_ram_model.v、run_pixel_interface.ps1；.gitignore忽略生成的pixel_interface_lib。运行run_pixel_interface.ps1即可复现两项测试，TdSimRoot可指定安装目录。实际除法器网表编译较慢，生成约157MB仿真中间文件，该文件不作为源码交付。

同名证据目录包含两项完整stdout日志、源码快照和manifest.json（源码及厂商明文库输入校验）。已编译仿真再次执行用于取得完整持久日志；复现结果一致。没有重跑TD，因本轮没有修改任何综合输入，沿用上一版本报告而不称本轮新增布局布线验证。

## 下一批建议（未生成RTL）

保留DDR现有早帧通知；新增检测专用的像素对齐SOF/坐标/本帧有效上下文。不得简单固定延迟53拍处理user，不得拿累计FORMAT计数替代本帧有效性。缺行/缺列、中断、复位或换样期间作废，不认旧缓存数据为新结果；覆盖上一帧未排空时新帧到来。具体方案在12文档，须由用户确认后生成。

现场继续在临时条件下观察正常/空穴和同平面毫米尺，记录视场、装夹重复性与候选ROI。采集方式和参数尚可调整；没有像素样本/FPGA统计依据时不写死阈值。四键映射保留，字体与排版在后期整合批次调整。

未测：实测INPUT/FPS、GAIN90差异、视场、正式ROI、误报漏检、30分钟、Flash/冷启动。未提交/推送，无下载服务操作。
