czp-1-A1/FPGA_Component_Inspector/开发实施/验收记录/20261003_ModelSim复核_轮次1.md

# ModelSim复核记录（2026-10-03）

用户指定主要使用ModelSim。本轮接通本机ModelSim并复核既有测试，未实现ROI/分类、未生成位流、未操作下载服务。

分支 `hx1p35a-contest-work`，HEAD `f87ccf1c6a38e84b58a4f86cecd532a71ae56e89`，未提交/推送。ModelSim SE-64 2019.2，安路库来自TD 6.2.168116安装目录；原厂加密ERAM原文件未修改、未解密。

## 运行方式

主入口 `fpga/component_inspector/sim/run_modelsim.ps1`，图形波形入口 `sim/run.do`，说明 `sim/README.md`。脚本继承本机已有许可环境变量到子进程，本轮没有改变系统许可配置；测试各用独立编译库、日志和WLF，既检查退出码也检查PASS及Fatal/Error。

| 测试 | 原工程 | 未用RAM输入接零的诊断模式 |
|---|---|---|
| controls | 通过 | 通过 |
| cdc | 通过 | 通过 |
| monitor | 通过 | 通过 |
| csi_monitor | 通过，实际CSI/RAW10，1024×600 | 通过 |
| i2c | 通过，实际I2C总线 | 通过 |
| osd | 通过 | 通过 |
| pack_boundary | 通过，复现既有打包边界 | 通过 |
| pixel_interface | **失败**：1036ns首拍全零 | 通过，测试台强制web=0/dib=0 |

诊断模式是明确的测试覆盖，不能据此把原工程记为八项通过。主入口默认测试原工程，发现失败会返回错误。诊断使用 `-TieUnusedAwbRamInputs`，编译库及日志与原工程分开。

## 失败、定位和复测

1. 最初ModelSim进程未继承已有许可配置；读取本机已配置变量到当前进程后运行成功，不在证据中存储许可内容。
2. ModelSim拒绝 `uicfgcs500.v` 在使用 `iic_error` 后再声明；仅将这一行声明移到I2C实例前，未改电路逻辑。原源文件保存在本目录 `uicfgcs500_before.v`，编译失败日志保留。
3. 原厂ERAM模型要求 `PH1P_PHY_GSR` 顶层，只有 `glbl` 时加载失败。脚本增加原厂GSR库和顶层；测试在GSR启动期结束后才发数据。加载失败日志单独保存。
4. 加载完成后首拍为全零，期望 `111111121212131313141414`。定位到 `signal_delay.v` 的RAM B端口未连接 `web`/`dib`。独立试验写入四个不同96位字，原厂RAM输入悬空时均读零；只将 `web` 接0就能逐地址正确读回，`dib` 接0也正确。此试验含读回断言，证据为 `tb_eram_probe.v`、`eram_console.log`。
5. 综合RTL中的RAM连接没有更改。只在像素测试台显式强制 `web=0,dib=0` 后，真实AWB/除法器/原厂ERAM链路通过：连续3行共768拍输入/输出，576个打包字，SOF提前53拍；短输入暂停时55拍；ready低仍输出180拍；复位重启正常；64拍残缺输入仍回放256拍旧数据。与前次行为RAM模型结果相符，但不能推断原工程悬空端口在硬件上的行为。

像素测试仍是1024宽、3行局部链路测试，配置高度600；不包含完整600行、MIPI接收/DDR/video_out全链路，不证明上板时序或分类准确率。219条加载警告来自既有网表/IP，包括未用端口、常量宽度、加法器默认输入及ERAM INIT_FILE诊断；日志完整保存，未用屏蔽警告换取通过。

## 冻结版本与改动边界

本轮新增ModelSim脚本/说明，更新测试台的可选诊断覆盖及波形入口。仅一项综合源码字节变化：`uicfgcs500.v` 的声明顺序修复。冻结manifest的195项构建输入中，当前194项一致、该文件不同；差异及SHA-256见本目录manifest.json。旧bit及历史manifest保留，SHA-256仍为 `0b1a72e36772b852195fd16275d9540bd694d849a3dae2b110596f2eac6c907a`，没有重跑TD。不能称当前源码与冻结bit逐字一致。

原工程失败、诊断通过的编译/运行日志、顶层WLF、独立RAM试验、当前源码快照和校验清单保存在同名目录。历史失败不覆盖。

## 下一步（确认后实施）

最小前置修复：仅显式连接 `signal_delay.v` 的RAM只读B端口 `web=0,dib=0`，去掉仿真强制覆盖后重跑ModelSim主入口，目标为原工程八项通过。随后按12文档拟定检测专用SOF/坐标与输入完整性保护，用户确认范围再生成RTL；保持当前显示/DDR早帧通知。新集成版须重跑TD并由用户上板复核，不提前称A阶段完成。
