czp-1-A1/FPGA_Component_Inspector/开发实施/验收记录/20261003_RAM只读端口修复_轮次1.md

# RAM只读端口修复与复测（2026-10-03）

用户在ModelSim失败定位及最小修复说明后回复“可以，我们继续”，本轮执行该两处RAM输入连接修复。检测帧对齐/完整性保护尚未生成RTL；具体范围另见13确认稿。

分支 `hx1p35a-contest-work`，HEAD `f87ccf1c6a38e84b58a4f86cecd532a71ae56e89`，工作区未提交/推送，既有改动保留。

## 改动

根目录 `signal_delay.v` 的AWB RAM只读B端口增加 `.web(1'b0)`、`.dib(96'd0)`。其余原文件字节保持，前后快照有校验。辅助Icarus RAM模型增加对应未用输入声明，以保持测试接口可编译；没有用该辅助模型替代本轮原厂模型验证。

ModelSim默认脚本和测试台未增加强制覆盖。修复前失败和接零诊断记录完整保留在 `20261003_ModelSim复核_轮次1`，本轮证据单独保存。

## 验证结果

| 项目 | 结果 | 证据 |
|---|---|---|
| ModelSim默认回归 | 八项通过，原厂加密ERAM，未启用TieUnusedAwbRamInputs | regression_console.log、modelsim各测试目录 |
| 像素接口 | 连续/短valid暂停、ready低、复位后重启通过；残缺行仍回放旧数据的现状复现 | modelsim/pixel_interface/console.log及WLF |
| 已有延迟SOF探针 | 四个输出序列中I_tuser_r2均与第一有效组同拍 | awb_sof_console.log、tb_awb_sof_probe.sv |
| 辅助Icarus | signal_delay与更新后的辅助RAM模型展开编译通过；未重跑完整Icarus网表仿真 | manifest验证字段；主要结论来自ModelSim |
| TD综合/布局布线 | 通过 | td_syn、td_phy |
| 资源 | Slice13525（63.75%）、ERAM31、DSP8，与旧实验版相同 | td_phy/route.qor及area |
| 最终建立/保持 | WNS 0.555/0.020ns，TNS均0，无约束路径违例 | td_phy/route.qor及pr.timing |
| STA覆盖 | 95.18%，待核验事项未消除 | td_phy/pr.timing、constraint_coverage.txt |
| 上板/30分钟/固化/冷启动 | 本轮未测 | 不补填通过 |

像素场景仍为1024宽、3行局部AWB/双线性/打包测试，未覆盖完整600行、RAW→demosaic全链路或帧重叠。已有延迟SOF只是候选接口证据，不能直接判完整帧保护实现完成。

check_timing：no_clock=0、invalid_constraint=0；dummy4、PLL/clock约束7、两项被遮蔽例外、37项无输入延迟、63项无输出延迟、1项部分输入延迟仍待核验。本轮没有通过放宽约束取得通过。原厂网表/IP警告保留。

TD使用独立构建目录 `tmp/ram_readonly_td_build_20261003`，旧构建未覆盖。首次命令因工作目录错误未找到build.tcl，日志保存为td_wrong_working_directory.log；纠正目录后的综合及布局布线均正常完成，不将命令调用失误误记为RTL失败。

## 冻结交付

新目录 `fpga/component_inspector/release/experiment_ramfix_20261003/` 包含位流、sha256、manifest和说明。bit为1,789,539字节，SHA-256 `e8c925afb42ffbcc4bebd5081ec0fb4b4e266a5ca61fb80caa4d0140fef3fb97`。

manifest验证195项当前工程与本轮构建输入逐文件一致；相对旧冻结版本，仅 `signal_delay.v` 两处输入连接及 `uicfgcs500.v` 的声明顺序两项源码不同。旧bit SHA-256仍为 `0b1a72e36772b852195fd16275d9540bd694d849a3dae2b110596f2eac6c907a`，旧manifest不改作新版本记录。

源码/IP/SDC快照、仿真和TD报告及证据校验在同名目录。本轮所有构建/仿真进程已结束，未操作USB-JTAG/Flash。用户可自行下载此修复版复核视频，不能据此称完整A版完成。

下一步按13确认稿确认检测专用SOF、四像素坐标、输入及处理完整性与异常恢复的范围；确认后生成对应RTL及全600行ModelSim测试，再做TD集成和现场复核。

## 后续现场反馈（2026-10-03）

用户尝试下载修复版时，日志反复出现`PRG-8000 ERROR: Connect server failed`，随后`PRG-9525 ERROR: Chip validation failed`，用时32.624026s。该失败发生在服务连接/芯片校验阶段，不作为位流写入后功能失败。只读检查确认交付bit的SHA-256仍为`e8c925afb42ffbcc4bebd5081ec0fb4b4e266a5ca61fb80caa4d0140fef3fb97`；先后观察到下载服务未运行及随后hwserver PID22388监听5555，服务变化由现场自行操作，Codex没有启动/停止下载服务或执行download。

用户随后明确回复“没有问题烧进去了”，记为用户确认修复版下载成功。没有获取本次成功下载的完整日志；不推断Flash固化或冷启动成功。用户随后确认本修复版“画面清楚，四键均正常”，记为实物画面及四键基本调参功能人工复核通过。没有取得本版长按/限幅/双键、输入尺寸/FPS数值、30分钟稳定性证据，其他验收事项仍待现场记录。

13确认稿仍待用户确认功能范围，本次下载成功反馈不视为新检测RTL生成授权。
