czp-1-A1/FPGA_Component_Inspector/开发实施/验收记录/20261003_ROI上板反馈_轮次1.md

# ROI统计版上板反馈（2026-10-03）

用户反馈：“这个中央框有点太小了，框外彩色和四建正常”。收到四张显示器照片，原始JPEG复制保留在同名证据目录，逐文件校验见manifest.json；没有改图、没有把屏幕照片当原始像素帧。

## 版本及确认边界

预期镜像为release/roi_statistics_20261003，SHA-256 53b6e341c02da01292067eb27bb7d0f456afded30602a449d79496b2051fabce。照片中的256×128中央绿色框及MEAN/MIN/MAX界面与此版一致；未取得下载日志或现场位流校验，镜像绑定记为预期而非已核实。

- 用户确认：框外彩色、四键正常。
- 照片可见：绿色中央框、框内灰度、EXP/GAIN、统计值、VALID；这证明现场观测出口已经显示，不单凭照片断言FPGA统计数值绝对准确。
- 用户提出扩大观测框；未批准新尺寸前不改RTL、不生成新bit。

## 照片逐张读数

| 用户图 | EXP半行 | GAIN档 | MEAN | MIN | MAX | 状态 | ROI内容观察 |
|---|---:|---:|---:|---:|---:|---|---|
| 1 | 2116 | 43 | 68 | 41 | 192 | VALID | 主要是暗色穴区与亮圆点，空穴真值未单独确认 |
| 2 | 2116 | 43 | 65 | 40 | 192 | VALID | 类似图1，放置存在变化 |
| 3 | 2116 | 43 | 83 | 36 | 255 | VALID | 包含亮色物体/元件区域及多个穴位，正常真值待确认 |
| 4 | 2116 | 43 | 84 | 36 | 255 | VALID | 类似图3，放置存在变化 |

图3/4底部输入宽×高可读为1024×600，输入FPS分别为27/26（由工程独立输入监测产生，非显示器刷新率）。F/I/G可读为0000，L被遮挡，不补填；图1/2底部不完整，不据此补全计数。图3/4秒计数约0x44B/0x44A，不能替代连续30分钟无异常验收。

以上是四个照片时刻的读数，不是固定同穴位连续10秒的波动范围，也不是已标定正常/空穴分布。曝光2116、增益43是这次照片条件；距离、光源、镜头位置变化未新增确认，不能自动套用此前约280mm条件。MAX255说明至少有ROI处理像素达到8位灰度上限，不证明整幅过曝或原始传感器已饱和。

## 拟定下一版范围

建议中央观测框512×256，半开区间[256,768)×[172,428)，宽高均为现版两倍、面积四倍；备选384×192，[320,704)×[204,396)。待用户选尺寸后，显示灰度/边框及统计ROI一起调整，验证像素数、统计与边界，重新TD构建并独立冻结版本。

扩大框方便放置与观察，会纳入更多载带、定位孔和背景；不能将它直接当单穴正常/空穴分类ROI。正式分类时再按一个穴位选区。当前不加按键ROI模式、分类阈值、字体/Logo或运动功能。30分钟、Flash固化、冷启动和统计绝对准确性实物复核仍未完成。

后续决定：用户已明确选择512×256，开始按上述扩大版范围实施；本反馈记录仍描述原256×128镜像的四张现场照片，不把它们作为扩大版实测。
