czp-1-A1/FPGA_Component_Inspector/开发实施/验收记录/20261003_按键调参与输入测量_轮次1.md

# 四键调参与输入测量：轮次1（2026-10-03）

## 版本与结论

静态载带成像调参实验版本，不含ROI正常/空穴分类。用户最新决定：Codex生成和验证代码，用户负责下载、上板调试，有问题再反馈解决。因此不继续代做30分钟或Flash现场测试。

代码基线：hx1p35a-contest-work，HEAD f87ccf1c6a38e84b58a4f86cecd532a71ae56e89，交付为未提交工作区。入口`fpga/component_inspector/td_project/camera_to_dsi_display.al`。用户既有增益默认48等改动保留。

位流：`fpga/component_inspector/release/experiment_20261003/camera_to_dsi_display.bit`，未压缩，1,789,539字节。

SHA-256：`0b1a72e36772b852195fd16275d9540bd694d849a3dae2b110596f2eac6c907a`。

交付RTL、IP、SDC共195项与最终构建逐文件SHA-256一致；manifest.json保存完整清单。TD工程.al仅修正旧E盘根路径为当前D盘路径，引用全部存在。源码改动快照与证据在同名目录。

## 实现

四板载键：KEY1/2曝光减/加，KEY3/4增益减/加，管脚D5/A9/B9/C7。增加20ms消抖、长按重复、限幅、同参数相反双键抑制、配置忙时稳定握手。曝光默认/最大2244半行，增益默认48档。修复摄像头初始化转曝光增益表的索引，增加I2C NACK事件计数。

增加输入宽高、输入帧率、lane/format/gap/frames/seconds监测与OSD、跨域邮箱、BCD转换。I2C逻辑改用摄像头主时钟的时钟使能以消除普通逻辑分频时钟保持违例。详细单位、计数语义和操作见09文档。

## 仿真

Icarus Verilog v12，`sim/run_iverilog.ps1`，六项通过，原始日志`simulation_final.log`：

| 项目 | 结果 |
|---|---|
| 四键/消抖/长按/边界/双键/忙握手/启动121+5次写入 | PASS |
| CDC原子数据、异步变化、停钟、复位 | PASS |
| PPC4隔拍valid、尺寸异常、lane事件、停流 | PASS |
| 现有CSI与RAW10解包联调，1024×600 | PASS |
| 实际I2C START、4字节、ACK、STOP、NACK | PASS |
| OSD十进制字段与视频像素保留 | PASS |

ModelSim许可证不可用，未修改许可证；使用仓库tmp/tools/iverilog。保留既有REG_DATA、GainTbl端口位宽警告。OSD仿真图`osd_simulation.png`是仿真证据，不能替代实物图。

## TD失败与复测

TD 6.2.168116，PH1P35MDG324，速度等级3。第一轮失败报告保留在`td_failed_round1`：建立WNS -1.459ns/TNS -204.614ns，保持WNS -3.925ns/TNS -105.189ns。定位为跨域邮箱路径以及普通逻辑分频I2C时钟；修复后完整重跑综合与布局布线。

第二轮报告保留在`td_final_syn`与`td_final_phy`，bitgen结束标记、日志完整：

| 项目 | 第二轮结果 |
|---|---|
| Slice | 13525/21216，63.75% |
| LUT6 | 10943/21216，51.58% |
| 寄存器 | 14815，34.91% |
| ERAM / DSP / PLL / GCLK | 31 / 8 / 3 / 8 |
| 建立WNS / TNS | 0.555ns / 0ns |
| 保持WNS / TNS | 0.020ns / 0ns |
| STA覆盖 | 95.18% |
| no_clock / invalid_constraint / loops / no_path | 均0 |

已约束路径的建立和保持检查通过；尚不能称完整约束验收通过。check_timing仍有37项no input delay、63项no output delay、1项partial input delay、7项PLL/clock buffer检查、4项dummy node。既有DDR FIFO两项max_delay被异步时钟组遮蔽，仍需结合硬IP和板级时序复核。两个显示邮箱的6项19ns datapath-only约束均命中非空路径；详细路径与例外在报告中。

## 下载与实物

此前失败日志保留。用户关闭旧JTAG程序并重连后，同一BitWriter会话connect_cable再download：芯片校验成功，进度100%，命令正常结束，11.567455秒。日志同时有附带自动服务usb_open失败警告，完整保存，未删除。模式jtag（SRAM），参数-spd 7（工具枚举，不当作7MHz）；未写Flash。

用户随后确认：有清楚的实物画面和参数叠加。这是人工反馈，未取得截图、参数数值或逐键测试记录。Codex自建hwserver PID16968已停止，释放USB-JTAG；没有修改驱动或FTDI EEPROM。

| 现场项目 | 当前证据/状态 |
|---|---|
| 实物画面及参数叠加 | 用户确认清楚 |
| KEY1～4及亮度响应 | 用户确认按键有效、画面亮度有响应；长按/边界/双键未单独实测记录 |
| 输入尺寸、输入FPS、计数 | 待用户填写屏幕值 |
| 显示器识别HDMI模式 | 待用户记录；配置1024×600，像素约52.002MHz |
| 连续30分钟 | 未测试 |
| 花屏/黑屏/冻结/撕裂/重启 | 未统计，不填零 |
| Flash固化/启动方式/断电自动运行 | 未测试 |
| 最终A版整合冷启动 | 待最终A版完成后测试 |
| 检测准确率 | 未实现分类，不可评估 |

## 用户现场记录表

固定同一位流、样品与成像设置，现场有效画面开始计时；输入FPS与显示器刷新率分别记录。计数是十六进制。

| 分钟 | INPUT/FPS | EXP/GAIN/光源/距离 | LANE/FORMAT/I2C/GAP | FRAMES/SECONDS | 花屏/黑屏/冻结/撕裂/重启 | 备注 |
|---|---|---|---|---|---|---|
| 0 | | | | | | |
| 5 | | | | | | |
| 10 | | | | | | |
| 15 | | | | | | |
| 20 | | | | | | |
| 25 | | | | | | |
| 30 | | | | | | |

下次根据用户按键、参数或异常反馈定位问题；如代码改变，重新生成镜像与校验值，受影响的仿真/时序/现场测试重做。未提交或推送。

## 后续用户反馈与范围（2026-10-03）

用户确认按键有效、亮度有响应；认为参数字体及排版不好看，希望后期只保留增益/曝光。下一步继续A阶段，但必须先确认方案再生成。本轮不改RTL/位流；后续计划见10文档。

用户进一步确认：调参只留曝光/增益，A阶段ROI框、识别结果和安路Logo保留。该回答仅确认显示范围，不视为批准生成检测RTL。
