czp-1-A1/FPGA_Component_Inspector/开发实施/验收记录/20261004_A均值离线判定_轮次1.md

# A均值离线判定：本轮验收记录

2026-10-04。用户“执行”批准15稿离线最小实现；无法上板，下载及现场复核由用户进行。本记录区分仿真、TD构建、实物状态，不作为完整A阶段通过结论。

## 代码与镜像身份

- 分支：hx1p35a-contest-work；HEAD：f87ccf1c6a38e84b58a4f86cecd532a71ae56e89；未提交、未推送。
- 工程入口：fpga/component_inspector/td_project/camera_to_dsi_display.al。
- 最终独立构建：tmp/roi_classifier_final_td_build_20261004；与当前工程、冻结快照逐项核对198项输入及.al哈希一致。
- bit：fpga/component_inspector/release/roi_classifier_20261004/camera_to_dsi_display.bit；1,789,539字节。
- SHA-256：`e9ae1233a592f5d500d8b30cabbcb17acbf82c6ed49ce1ead95be26e0282a707`。
- 回退基线：roi_statistics_large_20261003，SHA-256 `a20859510c99568d15377d6bb9622090d23ca92d4f275a4282bed70cad466a48`；所有旧发布保持。

本批新增roi_classifier与独立RECENT状态行；统计sample_new、native FS取消旧计算、配置/lane直接取消；27位结果邮箱。正常新帧保留最近完整调参统计，但清除旧分类。512×256仍用于观测，CLASS_CALIBRATED=0，因此本次实物应显示UNCAL，不会直接分类多个穴位。详细接口、位宽、延迟、旁路及标定步骤见16实施说明。

## ModelSim最终证据

ModelSim SE-64 2019.2，真实原厂ERAM/GSR/除法网表；未使用强制覆盖RAM输入。最终10项短测试在regression_classifier_final10_console.log通过；随后classifier增加最近统计保留断言单独通过；roi_chain按最终RTL单独通过。合计11项均有最终compile/console/transcript/WLF，不将中间旧版链路的通过冒作最终版。

| 测试 | 最终结果 | 主要依据 |
|---|---|---|
| controls | PASS | 四键、限幅与相机配置请求 |
| cdc | PASS | 稳定握手快照 |
| monitor | PASS | 输入尺寸/帧率及计数逻辑 |
| csi_monitor | PASS | 实际CSI解包与输入监测 |
| i2c | PASS | 实际I2C总线 |
| osd | PASS | EXP/GAIN/统计、四状态字样/字模、VS快照及全图灰度/边框/框外彩色 |
| pack_boundary | PASS | 原打包边界行为 |
| pixel_interface | PASS | 真实像素接口与原厂模型 |
| roi_guard | PASS | 独立RGB灰度参考、非4对齐、帧异常与恢复 |
| classifier | PASS | 128像素独立SUM/MEAN、阈值两极性/等值/0/255、UNCAL/WAIT、FS/config/lane/短帧/复位/恢复与27位CDC |
| roi_chain | PASS | 七个1024×600实际native RAW10→demosaic/AWB/统计帧，纯仿真T=110分类、短行与长暂停拒绝/恢复 |

人工图像独立数学：SUM/MEAN=5120/40、10240/80、5335/41、7680/60；ROI[1,17)×[2,10)，128像素。框外0/255变化不改变特征，单个255亮点在人工T=60时仍为空侧。该结论只针对人工组成，不是实物反光鲁棒性或准确率。

真实链路首帧因原demosaic学习行跨度导致回放超前而拒绝；帧2/4/6/7有效、均值120/100/120/100；帧3短native行和帧5长暂停回放无效；中间配置无效撤销结果。每个有效大ROI采样131072像素，sum/min/max与独立AWB RGB参考一致。最终链路Warnings=27，仍为原厂网表ECC端口宽度、未使用端口及legacy ready连接等基线提醒，无新增classifier接口警告；Errors=0。仿真时间33,613,540ns，不是实物运行时长。

## TD最终资源与时序

TD6.2.168116，PH1P35MDG324，speed3；最终综合及布局布线/bitgen完成，没有error标记。报告为Routed、Slow/Fast两个corner，未修改SDC放宽条件。

| 指标 | 最终值 | 相对扩大框基线 |
|---|---:|---|
| 布线Slice | 14140 / 21216（66.65%） | +61（约+0.29个百分点） |
| 物理LUT6 | 11533 | 见phy.area，不能与综合LUT直接混比 |
| 物理寄存器 | 15374 | 见phy.area |
| 综合LUT / REG | 14982 / 15682 | +23 / +2 |
| ERAM / DSP | 31 / 8 | 均无增加 |
| Setup/Recovery WNS | 0.199ns | 基线0.962ns |
| Hold WNS | 0.020ns | 基线0.020ns |
| Setup/Hold TNS | 0 / 0 | 无违例端点 |
| STA coverage | 95.06% | 基线同值 |

综合层次增量：OSD logic LUT704→720，seq656保持；统计logic LUT290→292、seq229→231、ripple55保持。默认未标定使classifier比较/fresh逻辑被优化掉，因此不以本次资源证明未来启用的全部资源或时序；启用真实配方必须重新TD验证。

全设计最紧0.199ns路径是原DDR控制器usr_clk域复位到pageInfo异步复位端的recovery（报告1329行附近），非新均值比较路径。CSI域SWNS1.777ns。余量为正，但全局低于0.3～0.5ns优化目标，应在后续增量时继续跟踪；本批不重构原DDR底层。

## 约束覆盖边界

constraint_coverage.txt：no clock0、clock definition0、invalid constraint0、combinational loops0、no path constraints0。6条camera_receive/roi_display的payload/req/ack物理预算有效，Dominated数量匹配，Ignored/Shadowed0；本次SDC与前版哈希完全相同。

仍保留基线问题：dummy4、PLL/clock buffer checks7、no input delay37、no output delay63、partial input delay1。coverage中的shadowed/ignored共4类包括既有DDR/FIFO两条无效例外与两条被邮箱细化预算部分覆盖的广义预算，不能理解为6条邮箱预算失效。两个PLL local反馈CRITICAL-WARNING保留。95.06%覆盖率和正WNS不代表完整外部I/O约束关闭。

## 现场状态与下一步

本镜像未下载、未观察实物；INPUT实测分辨率/输入FPS、HDMI输出模式、30分钟错误/花屏/黑屏/冻结/撕裂/重启、Flash启动与断电冷启动全部未测。仅可保留此前小框照片及用户“四键正常”的历史反馈，不能移作本版通过。

下次上板：使用本次冻结bit，先确认512×256灰度框、框外彩色、四键、EXP/GAIN、统计与RECENT UNCAL；调整成像后选一个完整穴位ROI，同条件分别采正常/空穴约10秒的范围和真值。距离/光源可继续调节，但改变后重检配方；不从四张显示器照片65～68/83～84直接设阈值。获得ROI、T、方向和曝光/增益后，再生成启用分类版并重新仿真/TD/现场验证。准确率目标、Logo/字体、30分钟及固化冷启动仍未闭环。

## 证据位置

目录20261004_A均值离线判定_轮次1包含198项source_snapshot、11项ModelSim compile/console/transcript/WLF、TD syn/phy报告和覆盖、仿真OSD预览、输入/证据manifest与文档快照。preview为人工RGB场景，不是相机原始帧。history/failure_notes区分首次重复声明、异步测试刺激问题、隔离目录缺依赖和未发布中间综合；不补造丢失失败波形。
