czp-1-A1/FPGA_Component_Inspector/开发实施/验收记录/20261005_130mm成像反馈_轮次1.md

# 20261005 130 mm 成像反馈，轮次1

## 本轮范围与来源

用户提交六张显示器照片及工作距离130 mm。随后确认：图1～3有元件，图4～6空穴；两组光源未调整；130 mm下轻微调过镜头对焦；尺子与载带同高。距离起算位置、光源类型/档位、元件料号仍未确认，不能沿用历史LM358DR作为本组料号。

原始JPEG按用户顺序无修改保存为同名目录内photo_01.jpg～photo_06.jpg；manifest.json保存来源、SHA-256及人工读取参数，六份副本与附件原文件哈希逐一一致。照片为显示器拍照，不是摄像头原始像素帧；统计来自屏幕OSD读数，不从手机照片重新计算灰度。

分支hx1p35a-contest-work，HEAD f87ccf1c6a38e84b58a4f86cecd532a71ae56e89。照片中的512×256观测框、第三行RECENT UNCAL与最新roi_classifier_20261004界面一致，但没有下载日志/实际下载镜像哈希，本组不宣称精确绑定到该bit。本机冻结bit重新核对SHA-256为e9ae1233a592f5d500d8b30cabbcb17acbf82c6ed49ce1ead95be26e0282a707。本轮只归档证据及更新交接，不改RTL、约束或冻结release，不运行TD/ModelSim/JTAG。

## 照片读数

共同条件：EXP=2244（half-line），GAIN=48（index）；INPUT=1024×600，ROI=VALID，RECENT=UNCAL，CFG=1，L/F/I/G可见计数均为0000。曝光2244已到当前ae_set.v的AE_MAX；GAIN48不是48 dB。

| 照片 | 人工真值 | MEAN | MIN | MAX | 输入FPS | FR（十六进制） | SEC（十六进制） |
|---|---|---:|---:|---:|---:|---|---|
| 1 | 有件 | 87 | 30 | 255 | 27 | 000036F0 | 0000020D |
| 2 | 有件 | 81 | 31 | 255 | 27 | 000038D8 | 00000220 |
| 3 | 有件 | 85 | 31 | 255 | 27 | 000038F5 | 00000221 |
| 4 | 空穴 | 85 | 29 | 138 | 27 | 00004424 | 0000028C |
| 5 | 空穴 | 83 | 28 | 144 | 26 | 00004614 | 0000029E |
| 6 | 空穴 | 88 | 28 | 143 | 27 | 0000463A | 000002A0 |

## 当前结论与边界

- 有件大框MEAN范围81～87，空穴83～88，明显重叠，不能设置一个均值阈值来分开本组全部样本。不能据此否定正式单穴ROI的均值方案：当前[256,768)×[172,428)含多个穴位、尺子及背景；样本间载带位置也变动。
- 有件MAX255说明后AWB灰度至少一个像素达到8位上限，照片也可见亮反光。不能据此认定RAW已经饱和，或确定饱和面积。空穴MAX138～144虽有区别，只有六张照片且全框MAX易受亮点干扰，尚不据此改分类算法或定阈值。
- 显示叠加字符较清楚，实物与尺子刻度偏软；130 mm下仅轻微调焦，仍应比较最佳焦点。6504镜头原厂PDF标称M.O.D=0.2 m、手动聚焦，130 mm低于标称最近摄距；这是对焦风险，不能仅凭规格宣称130 mm绝对不可用。
- 同高尺子可用于后续视场测量，但本轮未完成可靠毫米/像素标定，未发布精确视场尺寸或正式ROI坐标。临时自动绿色边框提取未可靠完成，放弃数值视场推算，不把未成功的图像分析当成标定结果；未输出或修改任何图像。
- 六个时点显示输入26～27 FPS、可见错误计数0，支持这些时点的视频/统计界面状态；不能证明期间连续无花屏/冻结/撕裂，也不是30分钟测试。UNCAL为未标定版本的预期状态，不是空穴判定结果。最新版本四键、断电固化和冷启动未由本组照片验证。

## 下一次现场操作

1. 保持130 mm和现有曝光/增益/照明，若镜头允许旋调，缓慢调焦，以载带穴边或同平面尺子的细刻度为参照，寻找最清楚的位置。照相时正对显示器，优先比较同一部位边缘清晰度。
2. 若130 mm始终找不到清楚焦点，再将工作距离改到200～250 mm，每个距离重新调焦，与130 mm比较。暂不冻结最终工作距离；摄像头及1024×600保持现状。
3. 清晰度确定后，把一个完整穴位放到画面中央，标尺移出观测/检测区域；固定相机、载带高度、照明、EXP/GAIN，采集相同位置有件/空穴对照。保留大框用于观测，正式单穴统计框及启用范围需先讨论并由用户确认再生成代码。

缺失项：距离起算基准、最佳焦点比较、光源类型/强度、当前元件料号、实际视场标定、单穴统计范围/阈值/方向。完整A阶段的准确率、30分钟稳定性、固化/冷启动继续待测。本轮新增证据与交接均未提交/未推送。
