czp-1-A1/FPGA_Component_Inspector/开发实施/验收记录/20261005_130mm成像反馈_轮次2.md

# 20261005 130 mm 成像反馈，轮次2

## 来源与范围

用户再次提交六张显示器照片，明确距离仍为130 mm。按照片外观及其对摆放差异的回复，图1～3为有件样本、4～6为空穴样本。先前回答为“用了另一段载带，摆放方向不同”，其后进一步补充“是同一种载带,翻转了180°”；当前按同一种载带、摆放方向相差180°记录，不再把穴型是否相同列为未确认项，也不把“同一种”解释为同一实物片段。有件大定位孔在元件上方，空穴大定位孔在穴位下方。具体旋转轴未单独说明，不额外断言是否换过观察面。本轮调焦量和光源设置未重新确认，不能把轮次1确认的全部条件直接移入本轮。

尺子已移出画面；当前框仍包含多个穴位、大定位孔及台面背景。照片中的元件轮廓和空穴能够辨认，边缘仍偏软，手机拍屏不能用来给光学清晰度作严格评分。

六原始JPEG按顺序保存到同名目录photo_01.jpg～photo_06.jpg，manifest.json记录来源、SHA-256及屏幕人工读数；六份副本与原附件哈希逐一相同。分支hx1p35a-contest-work，HEAD f87ccf1c6a38e84b58a4f86cecd532a71ae56e89。本机冻结roi_classifier_20261004 bit重新核对SHA-256为e9ae1233a592f5d500d8b30cabbcb17acbf82c6ed49ce1ead95be26e0282a707；界面与它相符，实际下载镜像仍未通过下载日志/哈希核验。本轮不修改RTL、约束、冻结release，不运行构建/下载。

## 屏幕读数

全部照片EXP=2244（half-line）、GAIN=48（index），INPUT=1024×600、ROI VALID、RECENT UNCAL、CFG=1，L/F/I/G可见计数全部0。

| 照片 | 样本 | MEAN | MIN | MAX | 输入FPS |
|---|---|---:|---:|---:|---:|
| 1 | 有件 | 91 | 29 | 255 | 27 |
| 2 | 有件 | 81 | 28 | 255 | 27 |
| 3 | 有件 | 80 | 27 | 255 | 27 |
| 4 | 空穴 | 72 | 29 | 241 | 27 |
| 5 | 空穴 | 60 | 27 | 196 | 26 |
| 6 | 空穴 | 66 | 28 | 225 | 27 |

## 结论

- 本组六个时点有件大框均值80～91、空穴60～72，样本间存在间隔；轮次1为有件81～87、空穴83～88。不能合并两轮来认定固定阈值有效，也不能把这一轮的间隔等同于单穴分类准确率。轮次间背景、摆放及其他条件未全部固定。
- 空穴MAX达到196～241，有件仍为255；MAX不是可靠的单穴分类依据。亮部到灰度上限不证明RAW饱和面积，也不意味着应该继续增加增益。
- 用户已确认同一种载带，方向相差180°；不是不同穴型的对照。照片中穴位在大框中的高度、定位孔位置及背景占比有变化，先统一方向、观察面和穴位位置，再比较统计值；不能因同种载带就忽略这些差异。
- 130 mm可继续作为候选静态试验距离，先在该条件下做单穴ROI试验；仍未冻结为最佳工作距离，镜头标称近摄200 mm和最佳焦点未确认的限制保持。当前目标是有件/空穴检测，照片尚不能证明细节检测能力。
- 输入26～27 FPS及可见计数0仅是六张快照的证据，不代表连续30分钟、画面无冻结/撕裂、四键或冷启动已验收。UNCAL是未标定状态，当前不会输出真实有件/空穴判定。

## 下一步（待用户确认实现范围）

已整理17_A单穴ROI实物标定_讨论稿.md：建议保留512×256灰度观测框，另画中央80×80青色统计框，现有单个统计单元改为只统计该小框，默认UNCAL。80×80只是初始候选，不是已经标定的最终穴位区域；需把已确认同种载带的有件/空穴样本按同方向、同观察面、同高度摆放，将穴位中心移到同一小框位置，排除相邻穴位、大定位孔及台面，再采两类约10秒统计范围。用户此次仅更正实验条件，尚未确认下一版生成范围。

确认后才写RTL、做ModelSim/TD并冻结新bit。阈值/方向需取得正式单穴数据后另行确认。本轮只有证据归档、讨论稿及AGENTS交接更新，未提交/未推送。
