czp-1-A1/FPGA_Component_Inspector/开发实施/验收记录/20261005_130mm成像反馈_轮次3.md

# 20261005 130 mm 成像反馈，轮次3

## 样本与条件

用户提交六张新显示器照片，并明确确认：仍为130 mm，图1～3空穴、图4～6有件，两组之间没有调整光源和对焦。载带种类沿用其此前确认的同一种；本组大定位孔均在穴位/元件上方，方向已统一。光源种类/强度、元件料号及最佳焦点仍未记录完整。

EXP=2244（half-line）、GAIN=48（index），INPUT=1024×600、ROI VALID、RECENT UNCAL、CFG=1。统计读数来自OSD，不从手机拍屏像素计算灰度。当前仍为[256,768)×[172,428)的512×256大框，包含多个穴位、大定位孔及背景；两类穴位在框中的位置/占比仍不完全一致。

## 六张照片读数

| 照片 | 人工真值 | MEAN | MIN | MAX | 输入FPS |
|---|---|---:|---:|---:|---|
| 1 | 空穴 | 46 | 27 | 153 | 被线遮挡，未完整录入 |
| 2 | 空穴 | 53 | 26 | 168 | 被线遮挡，未完整录入 |
| 3 | 空穴 | 48 | 27 | 158 | 27 |
| 4 | 有件 | 107 | 30 | 255 | 被线遮挡，未完整录入 |
| 5 | 有件 | 102 | 30 | 255 | 被线遮挡，未完整录入 |
| 6 | 有件 | 100 | 30 | 255 | 被线遮挡，未完整录入 |

F/I/G可读处均为0000；L与部分FPS数字被线遮挡，不能补填为0或沿用旧轮次帧率。截图不能证明连续30分钟运行、无冻结/撕裂或冷启动通过。

## 结论与下一步

- 三张空穴均值范围46～53，有件100～107，本组已读快照间隔为100−53=47。该间隔支持继续测试单穴均值特征，不能当成已测准确率、时间稳定范围或正式阈值的余量；每类当前只有三个时点。
- 有件MAX255表示后AWB灰度至少一个像素达到8位上限；不能据此判断RAW饱和面积或细节是否完全可恢复。下一次保持这组配方便于对照，不以增加曝光/增益替代选取正确统计区域。
- 当前资料足够推进单穴取样试验方案，不需要继续重复拍大框来确定正式阈值。仍不能直接从大框数值启用分类；先取得固定小框、同位置的有件/空穴统计。
- 修正17稿先前“80×80完整装入整个穴位”的表述：80×80用于穴位内部核心取样，有件时取元件主体对应区域，空穴时取同一穴内区域，不要求覆盖整穴外轮廓。小框须位于同一个穴位内，并避开邻穴、大定位孔和台面。尺寸仍是初始候选，适配情况需上板复核。
- 下一版建议仍为512×256灰度观测区＋中央80×80青色统计框，现有单个统计单元仅统计小框、默认UNCAL。把有件/空穴的目标区域移到同一框位置，保持130 mm/EXP2244/GAIN48/现有光源与焦点，每类观察约10秒并重复摆放，再确定阈值及明暗方向。用户本轮确认的是样本/条件，不等于批准生成下一版；继续等待方案确认。

## 归档与代码状态

六JPEG无修改复制到同名目录photo_01.jpg～photo_06.jpg，manifest.json保存原来源、SHA-256和人工读数；六副本逐一校验一致。17稿更新前版本保存到轮次2目录docs_snapshot，轮次2 manifest的proposal_file已指向该快照，原proposal_sha256继续有效。

分支hx1p35a-contest-work，HEAD f87ccf1c6a38e84b58a4f86cecd532a71ae56e89。本机roi_classifier_20261004冻结bit SHA-256重新核对为e9ae1233a592f5d500d8b30cabbcb17acbf82c6ed49ce1ead95be26e0282a707。照片界面与该版本相符，实际下载身份尚未经下载日志/哈希核验。此轮仅新建证据及记录、修订17讨论稿、保留旧稿快照并更新AGENTS交接；未改RTL/约束/release，未运行TD/ModelSim/JTAG，未提交/未推送。
