czp-1-A1/FPGA_Component_Inspector/开发实施/验收记录/20261005_80x80单穴反馈_轮次1.md

# 80×80单穴上板反馈，轮次1

日期：2026-10-05。用户确认仍130mm，图1～4有件、图5～9空穴，两组光源及对焦未调整；本次是几个时点照片，未记录完整10秒MEAN范围。不能补填重复摆放协议已完成。

## 界面与实物观察

9张照片均显示绿色大观测框、青色80×80取样框和CYAN 80X80说明。EXP2244（half-line）、GAIN48（index），INPUT1024×600、ROI VALID、RECENT UNCAL、CFG1。大定位孔均在穴位上方，两类方向一致。小框未覆盖上方大定位孔，主要落在目标单穴区域；严格穴内核心边界是否全部落入仍需现场复核。

有件时元件相对青框位置有变化，尤其图3、4取入的主体和黑色周边比例不同。80×80不要求包整个元件或整个穴位，但两类应取同一穴内位置；下一次先对齐固定再观察。当前照片能观察到双框/灰度/有效统计，并不能独立证明四键、连续30分钟、无冻结/撕裂或冷启动。

## FPGA屏幕读数

以下数字由OSD人工读取，不计算手机拍屏灰度。输入FPS为工程输入帧计数显示，不是显示器刷新率。

| 图 | 真值 | MEAN | MIN | MAX | 输入FPS | 备注 |
|---|---|---:|---:|---:|---:|---|
| 1 | 有件 | 85 | 27 | 255 | 27 |  |
| 2 | 有件 | 88 | 27 | 255 | 27 |  |
| 3 | 有件 | 78 | 28 | 253 | 26 |  |
| 4 | 有件 | 82 | 27 | 255 | 27 |  |
| 5 | 空穴 | 36 | 26 | 112 | 27 |  |
| 6 | 空穴 | 37 | 26 | 112 | 26 |  |
| 7 | 空穴 | 37 | 25 | 112 | 27 |  |
| 8 | 空穴 | 37 | 26 | 112 | 26 | 与图6同一显示快照 |
| 9 | 空穴 | 36 | 26 | 110 | 26 |  |

各图可读L/F/I/G均0000，仅为相应拍照时点。图8与图6的画面及FR/SEC/读数一致，不算独立时点；原始JPEG字节重复：[(8, 6)]。共9个附件，最多8个独立显示快照。

## 判断与候选阈值

有件MEAN快照78～88，空穴36～37，观测间隔78−37=41级。与上一轮大框统计分别记录，不能混合标定。当前支持均值特征继续试验，不等于完整时间稳定范围、泛化保证或分类准确率。

仅作讨论的阈值候选为T=58、亮侧有件：有效且已标定时mean≥58为PRESENT，mean<58为EMPTY。对当前快照，离空穴最高37为21级，离有件最低78为20级；这只是快照余量。尚未批准写入RTL，交付bit继续CLASS_CALIBRATED=0/UNCAL。

有件MAX253～255说明后AWB的8位灰度至少有一个像素接近/达到上限，不足以确定RAW饱和或高亮面积；当前无需增加曝光/增益。空穴内部的小亮孔已取入统计，这可以作为固定区域特征的一部分，但不能把上方大定位孔或框外亮区混进取样。

## 下一步现场记录

继续使用当前bit，固定130mm/EXP2244/GAIN48、同一焦点/光源和同向载带。将同一个穴内位置对准青框，固定观察10秒；分别记录有件和空穴的MEAN最低/最高、MIN/MAX、VALID、INPUT FPS、L/F/I/G。每类移开后重新摆放，再记录一次。总共4段10秒，只需记数字即可，不必每帧拍照。

获得完整范围后再确认T/方向与启用批次；若范围仍有足够间隔，可以从T=58候选开始验证，重做ModelSim/TD并测真实分类准确率。若覆盖混入邻穴/台面或边界不适配，先反馈青框与穴位边界再调整ROI。

## 证据和代码状态

9个JPEG按原字节归档为photo_01.jpg～photo_09.jpg，副本SHA逐项一致；manifest保存来源、读数、重复、条件确认和未测项。冻结bit本机SHA再次核对为78d9a419cc75bae78655cc7608037959415ea67fd0452580446de0b7176c3c54；198项输入及.al仍匹配冻结版。照片界面与roi_core_80_20261005一致，实际下载的二进制身份未经下载日志核验。

本轮仅新增实物反馈记录/manifest/照片并更新AGENTS；未改RTL/约束/release，未生成新bit，未运行ModelSim/TD/JTAG，未提交/推送。旧冻结验收文档和镜像保持。
