czp-1-A1/FPGA_Component_Inspector/开发实施/验收记录/20261005_A单穴80x80取样_轮次1.md

# A单穴80×80取样验收记录，轮次1

日期：2026-10-05。用户回复“可以”批准17稿范围。结论：离线实现、ModelSim和TD通过，已冻结独立镜像；本版尚未上板，不作完整A阶段通过。

## 版本与输入身份

- 分支：hx1p35a-contest-work；HEAD：f87ccf1c6a38e84b58a4f86cecd532a71ae56e89。工作区未提交、未推送，沿用并保留已有改动。
- 新镜像：fpga/component_inspector/release/roi_core_80_20261005/camera_to_dsi_display.bit，1,789,539字节。
- SHA-256：`78d9a419cc75bae78655cc7608037959415ea67fd0452580446de0b7176c3c54`。
- TD 6.2.168116，PH1P35MDG324，speed3；ModelSim SE-64 2019.2。独立构建tmp/roi_core_td_build_20261005。
- 当前工程、隔离构建及证据快照逐项核对198项输入哈希，.al单独核对。相对roi_classifier_20261004仅design_top_wrapper/isp_top/experiment_osd三个综合RTL输入变化；ADC/SDC/.al、统计算法/guard/classifier/CDC/相机四键保持。
- 5个旧release bit哈希另行核对，不覆盖。本目录保存源文件、测试台、12项compile/console/transcript/WLF、完整回归输出、TD日志/资源/时序/约束覆盖/阶段标记、PPM/PNG预览及工具脚本。最终manifest列出全部证据文件SHA。

## 本版行为

绿框为512×256灰度观察区[256,768)×[172,428)；青框为80×80核心取样区[472,552)×[260,340)，6400像素。MEAN/MIN/MAX/VALID仅来自青框，RECENT旁新增CYAN 80X80。青框内部仍为灰度，绿框以外保留彩色。

当前仍CLASS_CALIBRATED=0，RECENT UNCAL；T=0/亮侧/EXP2244/GAIN48为占位或候选条件。只有一套统计、没有新增帧缓存；6400满量程和1632000，沿用28位sum/20位count与28拍除法。新FS取消未完成计算，最近完整调参统计保留；异常及配置更新失效。统计为最近完成采集，不绑定DDR显示帧。

## ModelSim

默认命令12项全PASS，未使用TieUnusedAwbRamInputs。完整runner终结标志为`PASS ModelSim: all 12 tests, including original vendor ERAM model`。

| 测试 | 本轮结果 |
|---|---|
| controls / cdc / monitor / csi_monitor / i2c | 全PASS，四键、原子跨域、输入测量、实际CSI/RAW解包与实际I2C ACK/NACK回归 |
| pack_boundary / pixel_interface | 全PASS，原厂RAM/GSR及实际AWB/打包、ready低、气泡、未完整行特征保持 |
| roi_guard / classifier | 全PASS，非4对齐ROI、完整性、配置/lane/FS取消恢复、两极性/等值/0/255及27位邮箱 |
| roi_core | PASS，6400像素独立SUM/MEAN/MIN/MAX参考；框外黑/白结果一致；255满量程、valid气泡 |
| osd | PASS，1024×600逐像素绿框/灰度/青框/框外彩色、CYAN字样、两级HS/VS/DE及ENABLE=0旁路；四状态VS快照 |
| roi_chain | PASS，真实7帧1024×600 native RAW→选定demosaic/AWB/原厂ERAM/统计；6400参考、短行/长暂停拒绝、配置失效/恢复；人工T=110仅测试 |

启动帧按旧demosaic学习行为拒绝，后续完整帧有效。仿真预览已检查，表示布局与逻辑，不是实物成像或物理MIPI/DDR/HDMI验证。

## TD资源、时序和约束

Slice 14122（66.56%），ERAM 31，DSP 8；Setup/Recovery WNS 1.437ns、Hold WNS 0.020ns，TNS均0；STA 95.05%。

综合LUT 15006 / REG 15680；物理LUT6 11543 / REG 15360。资源没有增加ERAM或DSP，未增加第二套统计。最紧建立路径位于MIPI_RX_BYTE_CLK域，u_roi_statistics/add12_syn_124→beat_hi_reg[7]，WNS1.437ns；建立/恢复和保持无负余量，最终路径详见td/phy_1/camera_to_dsi_display_pr.timing，不用布局估计代替布线结果。

最终约束覆盖分类计数与旧发布基线一致：dummy4、PLL/clock7、无input delay37、无output delay63、partial input1、shadowed/ignored总4（既有DDR/FIFO2及被专用预算覆盖的通用预算2）。无clock/invalid constraint/组合环等为0。6条专用邮箱payload/req/ack预算均Matched=Dominated>0、Ignored=Shadowed=0。仍有两PLL本地反馈告警，未放宽SDC，不宣称全部路径覆盖。当前默认未标定比较会被优化，未来启用须新TD验证。

## 中间工具调用记录

首次ModelSim相对Tee日志被runner Push-Location解析到sim下，未得到完整回归；改绝对日志路径后全部通过。首次TD带-f参数只报source参数错误，没有执行综合；正确直接传build.tcl后综合及物理阶段通过。原始TD调用失败日志和最终retry日志都保留，细节见history/invocation_notes.md。未出现本轮RTL断言失败，未放松测试。

## 待用户上板与标定

1. 自行下载上述新镜像，确认大绿框、小青框、框外彩色、四键、统计VALID及UNCAL。
2. 候选130mm，先沿用EXP2244/GAIN48，固定同一焦点/光源与载带高度；同种载带方向及观察面一致。
3. 单个穴位内部核心对准青框，排除邻穴、大定位孔和台面。有件/空穴各静止约10秒，记录MEAN最低/最高、MIN/MAX、VALID、INPUT FPS、L/F/I/G和真值，每类至少重复一次摆放。青框无需包整穴。
4. 小框不适配先反馈边界再调整ROI；分布有间隔后另确认T/方向及配方，另批启用并验证准确率。

130mm三轮大框照片独立保留，不用于新单穴T；轮次3批准前17稿保留原字节快照，其历史proposal_approved=false反映当时状态。本版实物准确率、30分钟、固化断电启动和A整合后冷启动均未测。
