czp-1-A1/FPGA_Component_Inspector/开发实施/机械结构展示/08_默认尺寸与采购草案.md

# 简易支架默认尺寸与采购草案

状态：用户授权对未知尺寸作工程假设。单位mm；版本2026-09-09。本文是用于试装的设计尺寸，不是已经验证的加工发布版。配套三视图为尺寸示意，尚无Fusion实体模型、干涉检查或可直接打印的STL。

最新偏心假设：用户明确镜头不在板中心，授权估计。暂取镜头相对板中心沿130长边偏置+20、沿90短边偏置0。为保持镜头在检测中心，板卡、亚克力及双侧承托整体沿X移−20；灯和检测点位置不变。不是由照片测量得到。立板两列安装位置随托架整体偏移，实际安装先对光轴再钻孔；原“板中心等于镜头中心”的占位已被整体HTML及SVG更新替代。

最新用户纠正（优先于上一段）：托臂及安装孔保持左右对称，不随板卡整体错开20。仅移动已有板卡组件来示意光轴对中，不新增左右调节机构。当前占位托臂中心在±65、板宽130，板左移20后右边到X=45，右托臂及滑块内缘约X=53，不能声称已有可靠双侧承托。整体图据实保留此待解决接口；实际固定前必须确认接触范围，不能把板卡悬空夹紧。暂不擅自改变支架尺寸。

## 1. 本轮采用的输入

确定输入：板卡与上下亚克力平面130×90；传送带带面420×80，整机420×110×80；灯外径90、内孔40、高22；镜头外形直径14、高18.3。

设计假设：下亚克力厚1；下亚克力支承面到组件顶部30；镜头最下端在支承面下方20（包括摄像头安装层的预留，并非把18.3当成真实突出量）；组件重量暂按不超过0.5kg估算设计，实际超出时须复核。上下亚克力均保留，中间及排线内部固定由用户处理。

材料默认：12厚胶合板作为主体；打印小件PETG，先按4道外壁、约40%填充作为打样起点，承重方向和层间受力由打印方检查。打印尺寸按常见小件控制，最大单件暂不超过170×110×45，不要求购买打印机。不能凭填充率保证承重。

## 2. 总体布置与调节范围

木底板650×350×12；X沿输送方向，Y向后。传送带居中于X=325，带面中心线Y=140。木立板前表面暂设Y=250，沿X居中，立板宽300、高360、厚12。整机理论木结构高度372，不包含插头和线缆突出空间。

带面高度暂按80，检测面暂按85，均从底板上表面算。镜头默认工作距离100，故镜头端面Z=185，亚克力支承面Z=205。支承面可调Z=145—305，对应假设下镜头至检测面40—200；真实突出量或检测面高度变化时整体平移这个范围。

相机高度采用木立板每20一档的孔阵列，加托臂根部22长竖槽微调，避免只有分档没有微调。左右必须同高，用托臂前后槽对中。130边暂沿X，90边沿Y；镜头未知偏移不可能无限补偿，默认前后±30，X方向通过整体安装位置调整，木底板和立板的最终安装孔现场对中再钻。

灯下表面默认Z=145，即距检测面60；灯顶Z=167，默认距镜头端面18。灯高独立可调。不要承诺整个相机行程都能保留灯在镜头下：W=40时扣除22灯厚只剩18总余量，要实拍确认无遮挡且不碰样品，否则限制最低位置或改变照明布置。

## 3. 木板下料尺寸

| 编号 | 名称 | 数量 | 尺寸 | 加工说明 |
|---|---|---:|---|---|
| W01 | 底板 | 1 | 650×350×12 | 实物摆放后钻设备孔，先不按旧HTML孔位钻孔 |
| W02 | 立板 | 1 | 300×360×12 | 相机架两列孔间距初定120；孔阵列在实物托架试装后定位 |
| W03 | 三角加强板 | 2 | 直角边120×200，厚12 | 靠后布置；普通小角码配穿透螺栓固定，避开设备 |
| W04 | 进出料托板 | 2 | 100×100×12 | 接触高度待载带和带面实测；支脚现场按高度切，不预先固定脚长 |

底板长度650对420机身两端各留115；托料板100长可在此空间摆放，但端部滚筒位置以实物为准。水平承托面不得使穴底或元件刮碰。木板尺寸是本轮选定方案，可以据此估料；孔位和托料脚仍现场确定。

## 4. 打印件候选尺寸

所有孔/槽名义尺寸是打样值。M4通孔先用4.5、滑槽宽4.5；打印收缩因设备而异，先打印孔槽试片再决定补偿，不在打印件上直接制作承重螺纹。

| 编号 | 零件 | 数量 | 外形/关键尺寸 | 尚需试装之处 |
|---|---|---:|---|---|
| P01 | 加强托臂 | 2 | 前后长170、宽24、总高45；水平承重板厚10；根部厚10、高45；三角筋厚6；水平槽4.5×70；根部两竖槽4.5×22，中心横距12 | 长槽两端距边≥10；根部螺栓及筋避让需在实体建模时检查；螺纹不攻入木板边缘 |
| P02 | 亚克力承托限位块 | 4 | 24×18×8；承托台阶深12，限位唇高2；M4通孔4.5 | 下亚克力1厚不作为夹紧承重板；接触台阶垫薄软垫，限位只防滑不压弯亚克力 |
| P03 | 灯架竖向导板 | 2 | 150×24×12；竖槽4.5×100；上下固定区各25 | 导板固定木立板前面，下端高度现场布置；活动块用两螺钉约束转动 |
| P04 | 灯前后支臂 | 2 | 140×20×12；前后槽4.5×70；根部活动连接板另按试装合并/拆分 | 需根部加强与双点锁紧，不允许单螺钉悬臂自由转动 |
| P05 | 环形灯分体外夹圈组件 | 1组，两半 | 装合名义内径91、外径110、轴向高16；分缝与夹耳另建模；两侧M4连接 | 0.5径向余量配薄软垫；夹住外壳侧壁，避开线口和LED面，轻夹试验验证不下滑；未知孔不用于固定 |
| P06 | 可调载带导向块 | 暂4 | 30×20×10；固定槽4.5×16 | 真正接触轮廓、间隙和下凸避让待样带；现在不要批量打印 |

P05不使用灯背面未知螺孔；这是替代接口的设计选择，不是已经验证的灯壳夹持方案。夹圈不会夹镜头。若灯壳有凸起、散热要求或线口干涉，局部开避让口；试夹无法可靠承重时改用确认后的原安装孔，不能靠大力挤压灯壳解决。

配套图只表达上述主体尺寸：P01筋与根部连接、P02台阶、P05夹耳和分缝等均须在实体CAD中完成。图中未标注的细节不可自行按图片比例加工。

## 5. 采购准备表

这是备料数量，允许少量余量，不是最终装配逐孔统计。已有物品无需重复买。

| 物品 | 默认准备 | 用途/长度说明 |
|---|---|---|
| 12厚胶合板 | 按W01—W04下料 | 可先买板，设备孔后钻 |
| M4螺栓 | M4×16、25、35各20颗 | 短规格用于打印件；35候选用于12木板＋约10打印根部＋垫片螺母，实际核对螺纹露出，不超长碰运动件 |
| M4螺母 | 普通40个；手拧12个 | 调节位置用手拧，其余普通；按最终孔数调整 |
| M4大平垫片 | 100个 | 木板和打印件接触面分散压力 |
| 普通小角码 | 约8—12个 | 固定木立板、加强板及托料脚；按现货孔径选配，少量金属紧固件即可 |
| 薄软垫 | 0.5和1厚少量 | 亚克力接触面、灯外夹圈试配；厚度不能累加到挤坏灯壳 |
| 扎带和线夹 | 各约10 | 固定线缆，留足运动余量 |
| PETG打印 | 先P01一件、P02一件与孔槽试片；灯圈先短段试配 | 通过后再打印左右整套，P06等样带到手 |

不新增镜头、相机、灯、控制器或输送带。现阶段不购买M3灯壳安装螺钉，因为这版采用外夹圈；后续改接口再按实际深度选长度。

## 6. 现在怎么做

1. 用现有组件和临时垫块试拍，寻找一个清楚且范围足够的位置；不知道距离不会阻止画草案，但不能跳过成像验证后宣称机械设计最终完成。
2. 看配套三视示意确认空间；按上述默认尺寸进入参数化实体CAD，完成夹耳、筋、孔、槽和配合。
3. 打印一个托臂/限位块和小孔槽试片，试托已有组件；检查亚克力有无明显挠曲、镜头与线口有无干涉。
4. 主体可靠后补齐灯架，试夹灯壳、确认不会下滑，再装灯测试照明。
5. 载带到手后确定导向接触面和托料高度，最后钻设备安装孔。

交付限制：本轮完成默认尺寸表、备料清单和标注三视示意；尚未完成可直接生产的CAD/STL。所有“设计假设”均由本轮自主选取，未冒充用户实测结果。
