czp-1-A1/FPGA_Component_Inspector/官方资料/00_来源说明/复制范围说明.md

# 复制范围说明

本目录是从 `E:\2026FPGA\HX1P35A_Contest_202606` 中筛选出的项目开发资料，不是官网资料的完整镜像。

## 已复制

- 三个 2026 赛题参考实验工程及其说明文档；
- HX1P35A/B 开发板手册、引脚汇总和完整原理图；
- PH1P35 数据手册、系列概览、MIPI 用户手册、参考 IP 资料和选型手册；
- 安路软件开发流程、硬件接口培训和 FPGA 工程流程资料；
- 官方 `资料指引.docx`。

## 未重复复制

主工程 `摄像头+镜头` 目录中的 SC500CS 数据手册、摄像头板原理图和 6504 镜头资料，已经过 SHA-256 核对，与官网文件一致。

## 保留策略

- 官网原目录始终作为只读来源保留。
- 本目录中的压缩包作为项目基线，不在压缩包内部直接修改。
- 实际开发工程另行解压并纳入版本控制。
- 若文件版本冲突，以比赛官网最新通知、实物板卡版本和当前例程约束文件共同核实，不凭文件名推断。
