czp-1-A1/FPGA_Component_Inspector/开发实施/验收记录/20261005_80x80单穴反馈_轮次1/AGENTS_snapshot.md

# 载带智检仪 Codex接力入口

## 核心规则

- 两人轮流用各自Codex实现同一工程，额度不足时接棒；第三人独立测试。无固定专业分工，A/B/C仅表示阶段。同一时间只有一个实现端写入，接棒须确认前端已停止。
- 先核对Git分支、HEAD及未提交/暂存/未跟踪文件，再从下方断点继续。默认续接同一任务分支，不重做已验证工作，不覆盖他人改动，不盲目拉取、重置或强推。
- AI负责实现与分析，人负责实物操作、真值和现场复核。只有一块板；验收冻结代码与镜像，不能边测边换。测试端不修改答案或事后降低目标。
- A：步骤1—4，Lab 1视频→视场→固定ROI正常/空穴→处理视图、Logo、结果与冷启动；B：步骤5—6，运动、编号与失锁恢复；C：步骤7—8，NG队列、停车与复检。可选算法不阻塞A。
- 以Lab 1的1024×600配置起步；改RTL前核对实际像素接口、PPC、同步和CDC。每次集成检查本机资源、完整约束与布局布线时序，同时验证视频。
- 无证据不判通过；未测、仿真、编译、上板和人工复核分别记录。上板绑定提交/工作区快照、TD版本、镜像SHA-256与证据；输入帧率不能用HDMI刷新率代替。

## 工程目录

开发工程统一放 `fpga/`，本机完整路径 `D:/BaiduNetdiskDownload/HX1P35A_Contest_202606/FPGA_Component_Inspector/fpga`。工程目录及其依赖文件使用英文/ASCII命名、无空格、相对引用；其他电脑的仓库父路径也需全英文。当前候选底座为 `fpga/component_inspector/`，TD入口 `td_project/camera_to_dsi_display.al`；保留例程内部布局，不要求套用之前的空目录骨架。原始Example保留不动。

## 按需读取（均在开发实施目录）

| 任务 | 文件 |
|---|---|
| 阶段顺序/通过条件 | `00_分阶段开发与逐级验证路线.md` |
| 测试记录 | `01_阶段验收记录模板.md` |
| RTL实现 | `02_FPGA资源预算与代码优化规范.md`、`04_FPGA接口与异常处理约定.md` |
| 架构/接力细节 | `03_系统框架与Codex接力协作流程图.md` |

只读本轮相关章节。最新用户决定优先于旧分工；示意图不代表源码已实现。

## 强制交接更新

每完成一个可接续小步骤及结束本轮前，直接更新下方断点，不等额度耗尽、不重复询问。仅保留当前有效摘要，历史详见Git或独立记录，不在本文件累积长日志。

摘要必须包含：目标与断点、分支/代码基线、改动文件、验证及证据、未决事项、下一条具体操作、运行中进程/设备、提交/推送状态。测试详表放 `开发实施/验收记录/日期_步骤_轮次.md`，失败与复测分别保留。

交接需包含代码、必要未跟踪文件与证据，不能只传本文。按授权提交/推送，不混入无关暂存文件；成功推送才可称已同步。接棒端核对工具依赖、实际文件与日志；Git不传未提交文件、进程或聊天。意外断额度时由人保存改动，接棒端恢复实际断点，WIP不当作稳定版。

## 当前断点（2026-10-05）

- **目标与断点**：用户回复“可以”批准17稿，本批已实现512×256灰度观测＋中央80×80青框核心统计，默认UNCAL。12项ModelSim及最终TD通过，独立版本已冻结，收到双框/CYAN与有效统计的上板照片；当前快照两类分离，完整10秒范围和重复摆放待记录，不当作完整A验收。
- **分支/基线**：hx1p35a-contest-work，HEAD f87ccf1c6a38e84b58a4f86cecd532a71ae56e89；fpga/component_inspector。原工作区及5个冻结release保留。上一冻结基线roi_classifier_20261004，SHA e9ae1233a592f5d500d8b30cabbcb17acbf82c6ed49ce1ead95be26e0282a707。
- **本批改动**：仅3项综合RTL输入变化：design_top_wrapper添加SAMPLE坐标并传ISP/OSD；isp_top默认统计80×80；experiment_osd画青框及CYAN 80X80。通用统计算法、guard/classifier/27位CDC、相机、四键、1024×600、ADC/SDC/.al均不改。新增tb_roi_core，修改tb_osd/tb_roi_chain/runner及simREADME/04接口/17状态，新增18说明。
- **验证及证据**：ModelSim SE64 2019.2默认12项PASS，无强制覆盖。6400像素独立参考、框外黑白排除、255满量程、气泡；OSD逐像素灰度/双框/框外彩色、字样、同步/旁路两级延迟。真实RAW→选定ISP/原厂ERAM共7帧1024×600，短行/长暂停拒绝和恢复；非4对齐/配置/取消/分类/27位CDC旧回归全部通过。日志/WLF在sim/modelsim_work，runner tmp/modelsim_probe/regression_roi_core_console.log，PPM/预览已检查；已冻结至20261005_A单穴80x80取样_轮次1同名证据目录，198项输入/.al及12项日志/WLF/TD报告/文档快照完整。
- **构建/资源**：tmp/roi_core_td_build_20261005隔离完整198输入＋.al，与旧基线仅上述3RTL不同，约束不改。综合LUT15006/REG15680，Slice 14122（66.56%），ERAM 31，DSP 8；Setup/Recovery WNS 1.437ns、Hold WNS 0.020ns，TNS均0；STA 95.05%。TD6.2.168116，PH1P35MDG324 speed3。首次TD带-f未执行综合，保留build_console.log；正确直接传build.tcl的综合日志build_console_retry.log。首次ModelSim相对Tee路径失败，完整回归改绝对路径后通过。旧基线约束I/O/PLL/DDR缺口与两PLL反馈告警需继续如实记录，不放宽SDC。
- **区域/参数**：观测[256,768)×[172,428)，统计[472,552)×[260,340)共6400像素。青框取同一个穴内核心，不要求包整穴，需实物验证边界；MEAN/MIN/MAX/VALID仅来自青框。CLASS_CALIBRATED=0，T=0/亮侧/EXP2244/GAIN48占位；无实际分类/准确率。最近完整统计保留，新FS取消未完成计算；坏帧/配置/lane撤销有效；没有DDR显示帧绑定。未来启用分类须重新TD。
- **实物/镜头约束**：固定摄像头不能换；窗口1024×600保持。6504镜头4mm/F2手动对焦、标称近摄200mm；130mm为候选距离，用户已轻调焦。最佳焦点和最终距离/光源尚未冻结，不凭镜头PDF单独否定130mm。机构60～400mm不保证全程清晰。历史LM358DR约280mm不当作当前实物料号。
- **三轮照片**：20261005_130mm成像反馈轮次1/2/3各六张独立保留。轮次2同种载带旋转180°，不合并阈值。轮次3方向统一，前三空穴/后三有件，用户确认130mm且光源/焦点未调；EXP2244/GAIN48，大框空穴MEAN46/53/48、有件107/102/100，快照间隔47级，仅支持试小框。F/I/G可读均0，多处FPS/L遮挡留空；照片非原始像素。轮次3引用17稿已保留更新前docs_snapshot/17_before_implementation.md并改manifest指向原哈希，历史proposal_approved=false保持为当时状态。
- **冻结镜像**：release/roi_core_80_20261005/camera_to_dsi_display.bit，1,789,539字节，SHA 78d9a419cc75bae78655cc7608037959415ea67fd0452580446de0b7176c3c54。198输入/.al与工程和隔离构建逐项一致。约束覆盖计数与旧版一致，6专用邮箱预算有效；基线缺口保持。5旧bit哈希验证保留。
- **最新单穴实物反馈**：20261005_80x80单穴反馈_轮次1保存9原始JPEG/manifest及报告。用户确认130mm、图1～4有件/5～9空穴、光源和焦点未调，仅几个时点、未记完整10秒范围。有件MEAN85/88/78/82（78～88），空穴36/37/37/37/36（36～37），快照间隔41级；图8与图6同一显示快照不算独立。EXP2244/GAIN48、VALID/UNCAL/CFG1、INPUT1024×600及FPS26/27，可读L/F/I/G均0。青框相对元件位置有变化，需固定同一穴内取样位置；不是原始图像标定或准确率。T58/亮侧仅讨论候选，尚未批准写RTL；下载二进制身份未从日志核验。198输入/.al和本机冻结bit哈希核对一致，本轮未改RTL/约束/release/bit。
- **下一条具体操作**：继续当前UNCAL版，130mm/EXP2244/GAIN48及同一焦点/光源，两类对齐同一个穴内核心；每类固定10秒记MEAN最低/最高，再移开重新摆放重复一次，共4段10秒，并记录MIN/MAX/VALID/INPUT FPS/L/F/I/G。取得范围后再确认T/方向与启用批次；若ROI不适配先调整取样。分类准确率/30分钟/固化冷启动未测。
- **运行进程/设备**：本批ModelSim/TD均已结束，无后台构建；设备由用户管理，助手不操作JTAG/USB。18及离线验收保持冻结，最新实物记录另存。
- **提交/推送**：未提交、未推送。git diff --check仅既有uii2c.v:148行尾空格，未修改该行；不要称已同步。
