czp-1-A1/FPGA_Component_Inspector/开发实施/验收记录/20261006_A_SW视频链路修复_轮次1/上板记录表.md

# 上板记录表：SW 视频链路修复候选版

镜像 SHA-256：`1584f39b53f315c369feb41617539dbbb944b455ae3fe84a045d7824dcfac0d5`。软件候选已验证；本表实物结果尚未填写，空白不表示通过。

日期/操作者：____　板卡：____　摄像头距离：____ mm　曝光/增益：____ / ____

保持同一接线与照明，依照 release README，切换后等待约 5 秒再记录基准。累计值为十六进制；记录起止，勿将切换瞬间与稳态混为一组。

| 条件 | 观察时长 | OF 起→止 | VF 起→止 | UF 起→止 | 左侧竖条/花屏/闪屏 | 画面与采样恢复 | 照片/视频位置 |
|---|---|---|---|---|---|---|---|
| RAW 下/下 | 1分钟 | | | | | | |
| GRAY 上/下 | 1分钟 | | | | | | |
| EDGE 下/上 | 1分钟 | | | | | | |
| GRAY+EDGE 上/上 | 1分钟 | | | | | | |
| 复位后 RAW | | | | | | | |
| 冷启动 | | | | | | | |
| 持续运行（记录模式） | 30分钟 | | | | | | |

异常补充：是否只有摄像头区变化____；文字/框是否稳定____；MODE____；计数首次变化时刻____；调参/切换/复位是否同时发生____；恢复耗时____。

结论由现场复核填写：____。
