czp-1-A1/FPGA_Component_Inspector/开发实施/验收记录/20261006_A_SW视频链路修复_轮次1/验收记录.md

# 阶段 A：SW 视频链路修复验收记录（第 1 轮）

## 结论与范围

软件验证、TD 综合/布局布线及 bitgen 完成，已冻结候选镜像；实物花屏是否消除仍待上板。不能把仿真 PASS 或正时序余量当作实物验收通过。

用户报告：此前取样版稳定，新增 SW 实验版后 RAW 也花屏/闪屏，左侧出现竖条；字体、Logo 和框保持稳定。本轮针对视频传输与帧边界，保持 1024×600、UI、双 ROI、四个 KEY 和 SW1/SW2 的四种组合；CLASS_CALIBRATED=0，没有启用正式分类或选择三类物料的算法。

Git 分支 hx1p35a-contest-work；HEAD f87ccf1c6a38e84b58a4f86cecd532a71ae56e89。交付是未提交/未推送的工作区快照，不能仅靠该 HEAD 复刻。保留既有脏文件，未暂存、未重置、未覆盖旧 release 或原始 Example。

## 修复行为

- `roi_sobel_view.v`：EDGE 按整行的 256 拍准入并等待流水线排空；有限缓存出错时拒绝当前帧。`input_armed` 在 early FS 清零，仅在真实有效 pixel SOF 置位；此前旧 valid 不写 RAM、不推进指针、不产生 RGB/打包内容或坏帧污染。
- `isp/data96_128/data96_128.v`：96→128 位打包在 valid 间隙保留相位，复位/新帧通知丢弃半组，保留原字节序。
- `isp_top.v`：完整字数必须同时满足原始输入帧的 good/bad 证明；配置、行长、停流、缓存错误撤销当前证明。
- `video_in.v`：帧尾短 burst 写出，只发布完整槽，避开最新完整槽与显示活动槽；统计的是 MC 命令 FIFO 接受的写字，不能称为 DDR 物理写完成。
- `video_out.v`：显示选择完整槽；旧 DDR 返回在 VS 后先排空，再清 FIFO；预填充和 outstanding 预留限制避免覆盖。下溢后本帧余部显示黑色，下一显示帧重新从头恢复。
- `design_top_wrapper.v`、`roi_observation_snapshot.v`：传输健康经 CDC 接入有效状态，失效撤销旧采样，恢复需新样本。`experiment_osd.v`、ASCII ROM 与生成器增加 OF/VF/UF 和 V 字形，原主要版式不变。
- SDC：取消 DDR 的整组时钟 blanket cut，给实际 CSI/DDR/显示与新增邮箱路径设置 datapath 预算，保持既有约束问题单独记录。

修复前源文件及约束在 `tmp/video_fix_before_20261006`。最终 207 项构建输入、534 份证据副本及 SHA-256 在本目录 manifest.json；全部工程输入与 TD 冻结输入哈希一致。

## 数字验证

默认测试记录如下。ROI chain 的早期通过日志保留；最后 input_armed 修改后用增强的真实 ISP 九帧 proof 完整重跑，作为最终版本该路径的证据。其余未重跑项的 RTL 依赖没有变化；Sobel 最终版本已重跑，避免把旧通过日志称为全部最新重跑。

| 测试 | 结果 | 来源范围 |
|---|---|---|
| sobel_view | PASS | latest source rerun |
| observation | PASS | pass; RTL dependency closure unchanged since test |
| stop_recovery | PASS | pass; RTL dependency closure unchanged since test |
| display_state | PASS | pass; RTL dependency closure unchanged since test |
| controls | PASS | pass; RTL dependency closure unchanged since test |
| cdc | PASS | pass; RTL dependency closure unchanged since test |
| monitor | PASS | pass; RTL dependency closure unchanged since test |
| csi_monitor | PASS | pass; RTL dependency closure unchanged since test |
| i2c | PASS | pass; RTL dependency closure unchanged since test |
| osd | PASS | pass; RTL dependency closure unchanged since test |
| pack_boundary | PASS | pass; RTL dependency closure unchanged since test |
| pixel_interface | PASS | pass; RTL dependency closure unchanged since test |
| roi_guard | PASS | pass; RTL dependency closure unchanged since test |
| roi_core | PASS | pass; RTL dependency closure unchanged since test |
| classifier | PASS | pass; RTL dependency closure unchanged since test |
| roi_chain | PASS | earlier pass; latest actual ISP proof supersedes ROI chain |

附加测试全部检查明确 PASS 和 Fatal/Error，不能只看 ModelSim 退出码：

| 证据 | 检查与结果 |
|---|---|
| `additional_tests/roi_proof_after_sof_20261006/roi_console.log` | 实际 RAW10→demosaic→AWB→ISP 九帧；五个完整有效帧每帧 614400 像素/115200 packed 字，独立拼接参考逐字比对；短行、长暂停、配置取消、帧中切换无完整证明，随后恢复 |
| `additional_tests/transport_resume_verify_20261006/mode_0..3.console.log` | 每模式两帧 1024×600；每模式 230400 实际 MC 写字/读命令和 1228800 显示像素全部匹配；合计 921600 字、4915200 像素，正常 OF/VF/UF=0；争用时 ready 低 300 DDR 拍，FIFO 峰 384、读侧预留峰 480 |
| `additional_tests/transport_resume_verify_20261006/faults.console.log` | 停 CSI 仅 1176/1536 字、960 写字时拒绝短帧；8000 拍响应暂停产生 UF=1/余 256 像素黑，240 outstanding 跨 VS 排空再 CLEAR；10000 拍 ready 暂停触发缓存过载，拒绝坏帧并恢复，VF=2 |
| `additional_tests/transport_resume_verify_20261006/pre_sof_four_modes.console.log` | 四种旧模式各半帧→early FS→4 拍旧 valid→有效新 SOF；全部 RAM、指针、输出、打包和状态逐拍不受污染；共拒绝 16 拍，恢复 32768 像素/6144 字 |
| `additional_tests/awb_epoch_verify_20261006/fixed/console.log` | 实际工程 AWB、signal_delay、原厂 ERAM 与 divider，无 force；停 CSI 后新 early FS 的 E+1..3 有真实旧 valid，E+75 为新 pixel SOF。修复版四模式丢弃旧拍、指针/RAM不变、无输出或坏帧；随后各 1024×8 恢复 8192 像素/1536 字，从(0,0)精确开始 |
| `additional_tests/io_fix_review_20261006/` | 实际 video_in/video_out，小尺寸短尾与完整 1024×600 精确传输、短帧/溢出/下溢/跨 VS 排空与恢复 |
| `simulation/model_logs/osd/console.log` | 独立完整 614400 像素布局参考，Logo/字体/状态/同步三拍/VS快照及新 V 字形 |

真实 ISP proof：Errors=0，优化阶段 Warnings=234（vopt-2241 9、2685 74、2697 8、2718 143），来自既有端口宽度、未用端口缺省连接及 vendor INIT_FILE 范围。真实 AWB fixed：Errors=0、Warnings=2（vendor ECC 端口宽度）；四模式链路 mode0/faults 的 FIFO 优化各 10 条既有警告，其余模式和最终前 SOF 测试为零。没有以抑制警告或替换实际 AWB/原厂模型判通过。

保留的失败/诊断：原 `tmp/sobel_fix_review_20261006/pre_sof_console.log` 在新增旧 valid 刺激下明确 FAIL；同一失败 TB 的 root 修复复测在 `additional_tests/pre_sof_fix_20261006` PASS。真实 AWB `legacy_contract/console.log` 对旧源码明确 Fatal，`legacy/console.log` 的 PASS 仅表示旧缺陷成功复现（RAW/GRAY 泄漏 3 RGB 拍、2 packed 字，EDGE 两模式置坏），不能当作旧版通过。AWB 两次初始监测时点误判及原 ISP proof 中断日志保留并解释；最终通过采用修正检查器和当前源快照。

受控 DDR MC 行为模型不模拟物理 DDR PHY、MIPI 信号完整性、DSI/HDMI 物理链路或真实光学条件。

## TD 构建

最终目录：`tmp/video_fix_td_after_sof_20261006/td_project/camera_to_dsi_display_Runs`，Tang Dynasty 6.2.168116，PH1P35MDG324，speed3。综合与物理阶段进程均结束，`.bitgen.end.f` 存在。

| 项目 | 最终值 |
|---|---|
| Slice | 16251 / 76.60% |
| ERAM / DSP | 48 / 8 |
| setup WNS / TNS / 违例端点 | +0.310 ns / 0 / 0 |
| hold WNS / TNS / 违例端点 | +0.020 ns / 0 / 0 |
| STA coverage | 94.54% |
| 新 transport 邮箱预算 | payload/req/ack 匹配 68/2/2；Shadowed=0，Ignored=0 |
| 新 overflow 邮箱预算 | payload/req/ack 匹配 64/2/2；Shadowed=0，Ignored=0 |
| no clock / invalid constraint / no path constraints / combinational loops | 全部 0 |

综合日志有 124 条警告（含 2 条 USR-6135 critical）；物理阶段有 10 条警告（含 PHY-5060 摄像头时钟 mixed fanout 和 PHY-5079 local clock routing 两条 critical）。与本轮早期修复预构建相比，忽略 Verilog 行号后的警告文本和计数一致，未新增 ERROR/FATAL。约束报告仍有 dummy=4、PLL/clock frequency=7、shadowed exception 分类=9、no input delay=39、no output delay=63、partial input delay=1。STA 覆盖不满 100%，不能表述为所有路径已完全约束；完整报告在 td_reports，独立审计在 final_build_audit。预构建 bit 与历史 WIP 包不用于本次烧录。

## 交付与待测

镜像：[camera_to_dsi_display.bit](D:/BaiduNetdiskDownload/HX1P35A_Contest_202606/FPGA_Component_Inspector/fpga/component_inspector/release/video_fix_20261006/camera_to_dsi_display.bit)，1789539 字节，SHA-256 `1584f39b53f315c369feb41617539dbbb944b455ae3fe84a045d7824dcfac0d5`。

[烧录与四模式操作](D:/BaiduNetdiskDownload/HX1P35A_Contest_202606/FPGA_Component_Inspector/fpga/component_inspector/release/video_fix_20261006/README.zh-CN.md)；[上板记录表](D:/BaiduNetdiskDownload/HX1P35A_Contest_202606/FPGA_Component_Inspector/开发实施/验收记录/20261006_A_SW视频链路修复_轮次1/上板记录表.md)。先 RAW，再 GRAY/EDGE/GRAY+EDGE，稳定后比较 OF/VF/UF 是否增长，并检验失效/恢复。随后复位、冷启动与 30 分钟运行。尚未操作 JTAG，未完成实物稳定性、三类物料观察、固定 ROI 标定或分类准确率验收。

旧稳定版 SHA-256：ab23766b4b51c4df1d331fc14ad7f5bcc8a5ddeeeae3a2aedb8929cf04332ea1；原问题 SW 版：a43156b8fc076d7940e12b8f7ba46d026a3053466b759724bef79235570bcd8c。冻结时均复核未改。此前 `20261006_A_SW视频修复交接_轮次1` 和 ZIP 为 input_armed 最终修复前的历史 WIP，不能代表本次候选。
