czp-1-A1/FPGA_Component_Inspector/开发实施/验收记录/20261007_A_EDGE冻结诊断_轮次1/交接说明.md

# 给下一位队员／Codex的交接说明（2026-10-07）

用户因额度不足明确要求本实现端停止并交接。本端不继续新开发，没有运行中的构建/仿真/JTAG任务。用户TD GUI没有修改。先确认上一位实现端已经停止，再启动唯一写入端。

## 先看这三个文件

1. 仓库根AGENTS.md：有效断点与协作规则。
2. 本记录README.zh-CN.md：新镜像、诊断字段和上板复测步骤。
3. 本记录manifest.json：207构建输入、镜像、完整报告和每份冻结证据的哈希。

工程根：D:/BaiduNetdiskDownload/HX1P35A_Contest_202606/FPGA_Component_Inspector。TD工程入口fpga/component_inspector/td_project/camera_to_dsi_display.al。

## 现在已完成／未完成

旧版RAW花屏已据用户反馈消失；EDGE卡住、回RAW恢复；EDGE下FR继续、VF增长，OF/UF不增长。GRAY下FR/SEC变化、OF/VF/UF不增长，但没有直接确认移动物体显示。不能把计数增长当成已显示新帧。

当前修复的是已复现Sobel逐行额外等待缺陷，附拒帧原因ER、最短行周期LP、最大信用等待WS。完整仿真、TD和hash核对通过，已生成诊断候选镜像；新镜像尚未上板，实物冻结具体原因未确定。不要向用户承诺已经修好，不继续添加新物料算法。

新镜像：fpga/component_inspector/release/edge_diagnostic_20261007/camera_to_dsi_display.bit。
SHA-256：c3a1cce7d4a19d6750c0e6f3e36395a3c2f3d31901834a1b13a76f497a9230f8。
旧video_fix_20261006保留，SHA1584f39b53f315c369feb41617539dbbb944b455ae3fe84a045d7824dcfac0d5，可回退。

下一步只做上板视频复测：RAW→GRAY→EDGE→GRAY+EDGE→RAW，每次等2秒后移动载带观察10秒。Logo下应有ER/LP/WS。如果仍卡，拍全屏包含这三个值和FR/SEC/OF/VF/UF，退回RAW记录恢复。无需固定位置、无需灰度10秒范围。

## 改动与证据边界

- 本轮代码：roi_sobel_view.v删除pipeline_idle并加LP/WS；isp/isp_top.v加四种拒帧原因并锁存上一AWB epoch；design_top_wrapper.v扩已有OF mailbox至52bit；experiment_osd.v加字段与帧边界快照。
- 验证/资产：sim/tb_sobel_view.v、tb_osd.v、generate_osd_assets.py、render_osd_reference.py及参考图。原字体/Logo ROM内容未变。
- 连续行旧TB明确Fatal失败，新Sobel11帧PASS；新四模式真实MC各三完整帧逐字/逐像素PASS。MC2000拍暂停是明确视频拒帧负例，安全恢复PASS；不是正常完整视频PASS。
- 最终源真实ISP13短前缀PASS＋1完整EDGE native gap160 PASS；gap32的完整帧输入明确FAIL（累计几何不足），单独留存。短前缀不能称完整帧，合成时序失败不能称板上根因。
- LP/WS18边界、无诊断对照、52bit CDC、四模式OSD完整栅格PASS。默认16项本轮只重跑Sobel/OSD。
- TD最终setup+0.858ns/hold+0.020ns/TNS0，16397 slices/77.29%、48ERAM、8DSP；STA94.53%。扩宽CDC预算全匹配；既有PLL/IO/例外约束告警保留，未新增警告语义。
- 所有失败日志和最初许可证设置错误保留。test scope和工具/仿真/物理限制见manifest，别混用中间源PASS。

## 文件／Git接续

分支hx1p35a-contest-work，HEAD f87ccf1c6a38e84b58a4f86cecd532a71ae56e89。本轮没有暂存/提交/推送；工程有大量此前脏文件与必要未跟踪RTL。只checkout该HEAD无法恢复本轮成果。

同一电脑接续：保留现有workspace，先git status并核对source_snapshot和build_inputs.json；不要reset、clean、拉取覆盖或重跑旧冻结脚本。
换电脑接续：优先整体复制FPGA_Component_Inspector（含必要未跟踪fpga源码、sim、release、开发实施）。只交AGENTS不够。冻结source_snapshot含本镜像全部207输入，可核验恢复；带上本记录、release和工具依赖。目录名全英文、无空格。

冻结构建目录tmp/edge_diagnostic_td_20261007。ModelSim D:/modelsim/win64，vendor库D:/AAA/FPGA.....YZW/sim_release；TD6.2.168116在D:/AAA/FPGA.....YZW/bin。Python C:/Users/yiziw/.cache/codex-runtimes/codex-primary-runtime/dependencies/python/python.exe。

freeze_edge_diagnostic_20261007.py是仅创建一次的封存脚本；如果release/record已经存在，不要重跑覆盖。执行摘要tmp/edge_diagnostic_delivery_20261007/freeze_result.json和最终manifest可判断封存是否完整。没有建立新Codex线程或给别的线程发消息，交接方式为本地文件。
