czp-1-A1/FPGA_Component_Inspector/开发实施/验收记录/20261007_A_EDGE冻结诊断_轮次1/验收记录.md

# 20261007 A阶段 EDGE冻结诊断／轮次1

状态：软件验证完成的诊断候选；实物冻结原因及本版上板复测待补。

用户反馈：旧video_fix_20261006的RAW无花屏；EDGE冻结、退回RAW恢复；FR/SEC变化、VF增长、OF/UF不增长。GRAY下FR/SEC变化，OF/VF/UF均不增长；尚未直接确认GRAY移动画面。

本轮改变限定为Sobel逐行吞吐缺陷及诊断可见性：删除pipeline_idle读行门控；增加LP/WS；ISP锁存cache/config/lane/guard四种拒帧原因；已有OF mailbox扩16→52bit；取样OSD增加ER/LP/WS。未改DDR仲裁/缓存容量/分类阈值/物料算法；保留所有既有未提交变更。字体与Logo ROM哈希相同。

当前代码基线：hx1p35a-contest-work，HEAD f87ccf1c6a38e84b58a4f86cecd532a71ae56e89；未暂存、提交或推送。镜像c3a1cce7d4a19d6750c0e6f3e36395a3c2f3d31901834a1b13a76f497a9230f8。完整资料见manifest.json及README.zh-CN.md。

本轮默认套件仅重跑sobel_view、osd；另有独立真实MC、真实ISP/AWB、CDC52、18计数边界和逐像素前后回归。原生gap160完整EDGE正常、gap32完整帧明确失败分别留存；旧零行空闲失败、MC长暂停安全拒帧和工具首次许可证错误也保留，未隐藏失败或降低答案。

TD完整布局布线和bitgen已完成：setup+0.858ns/hold+0.020ns/TNS0/端点违例0，16397 slices/77.29%/48ERAM/8DSP；STA94.53%，旧PLL/IO/例外约束检查项保留，警告语义未新增。扩宽CDC约束匹配208 payload及各2 req/ack，无覆盖/忽略。

测试边界：DDR为行为模型；真实ISP正常完整测试仅1个EDGE帧，前缀不能代表完整帧发布；LP为Sobel推导输入行间隔而非nativeCSI测量；没有JTAG或板上操作。当前修正是确证吞吐缺陷，但不是实物冻结唯一根因的证明。

下一步：按README烧录新冻结镜像，RAW→GRAY→EDGE→GRAY+EDGE→RAW各等待2秒并移动载带观察10秒。若卡住，采全屏ER/LP/WS/FR/SEC/OF/VF/UF，再记录退回RAW是否恢复；根据实测决定下一次最小修复。

封存时未操作用户TD GUI；全部构建/仿真进程已结束，没有运行中JTAG。用户撤销的定时任务未重建。
