czp-1-A1/FPGA_Component_Inspector/开发实施/机械结构展示/零件工程图_R1/先读我.md

# 零件工程图 R1

本包覆盖相机承托与环形灯安装，共8种打印零件，数量共20件。另给木板4类的大致尺寸。图册为10页A3横向PDF，也可打开“零件图册_浏览.html”查看各页矢量SVG。

这是基于用户授权假设形成的试制工程图，尚未实物验收，不应被称为已认证、已通过工业生产验收的图纸。图中一般公差为试制目标；孔槽需要打印试片验证。载带导向轮廓仍未知，未发布其加工图。

各零件STEP为实际CadQuery/OpenCascade实体，可导入Fusion等CAD继续编辑；不是生成图片或仅包络方块。8件均检查单一有效实体和尺寸包络。P01与前后P02、P02与P03的代表性摆放做了实体相交检查；左右承托重叠按偏心20假设计算。未进行整机全行程干涉、螺钉工具空间、承重或光学实测验证。

本版优先于旧“零件尺寸三视草案.html”、08默认草案和整体V3中的打印件占位尺寸。具体变化：P01长度195且筋位于下方；P02/P03加宽64，托臂不偏移；灯导板贴木立板X=±100，外侧P07连接灯圈。不要把旧V3的零件形状当成本包实体模型。

木板尺寸：底板650×350×12一块，立板300×360×12一块，直角三角加强板120×200×12两块，托料板100×100×12两块。托料脚及孔位待实物试放后定。材料默认胶合板；打印件默认PETG。

开始制作时，先做一件P01、一件P02、一件P03进行试配；确认下亚克力接触面积、夹口和镜头避让，再补齐。灯圈先试夹直径90灯壳、线口及软垫，确认不下滑再装其余灯架。不得用过度拧紧弥补明显尺寸不符。

零件列表：P01托臂2、P02承托块4、P03压片4、P04导板2、P05灯托臂2、P06A/B夹圈各1、P07连接片4（合计20）。螺栓表及数量见PDF末页。

参数化生成源在上一级build_parts_r1.py、make_parts_sheets.py。生成环境：Python、CadQuery 2.8.0、ReportLab；PDF字体嵌入黑体，几何以STEP及孔槽尺寸表为准。
