czp-1-A1/FPGA_Component_Inspector/开发实施/验收记录/20261005_130mm成像反馈_轮次2/docs_snapshot/17_A单穴ROI实物标定_讨论稿_before_round3.md

# A单穴ROI实物标定，讨论稿17

状态：拟定范围，等待用户确认；没有据此修改RTL或生成新bit。

## 目标与依据

130 mm轮次2六张照片中，有件大框MEAN80～91、空穴60～72，比轮次1出现更明显间隔。用户已进一步确认同一种载带、方向相差180°。当前512×256框混有多穴、定位孔和背景，摆放方向及穴位位置也不同，因此需要改为对同一位置的单穴统计，才能决定均值阈值是否可用。

以130 mm作为本次候选试验距离，保持现有摄像头和1024×600视频模式。最佳焦点、照明配方及最终工作距离仍由实物比较确定。80×80尺寸来自当前画面可见穴位大小的初步估计，不当作原始帧标定结果。

## 建议的下一版行为

1. 保留现有中央512×256灰度观测区和绿色外框，便于看载带与整体成像。
2. 在中央增加青色80×80单穴统计框，半开坐标[472,552)×[260,340)，即x=472～551、y=260～339。操作时将一个完整穴位居中放入；80×80必须能排除相邻穴位、大定位孔和台面，尺寸是否适配需上板复核。
3. 将当前单个统计单元的区域换为80×80。现有MEAN/MIN/MAX/VALID仅对应青色小框；大框保留观察用途，不增加第二套统计单元。界面补足统计小框的说明，避免读数归属混淆。
4. 保持CLASS_CALIBRATED=0、RECENT UNCAL；本版只采集单穴数据。尚未确定阈值、明暗方向及完整配方，不预设真实分类结果。

现有全帧完整性保护及配置变更失效逻辑继续适用于统计；曝光/增益四键按现有行为使用。整字体/Logo、直方图、MAX判定、运动跟踪及多穴分类不属于这次建议范围。

## 最小实现与验证

分开现有观测坐标和统计坐标：顶层/isp_top的统计参数指向80×80，OSD保留大框并画出小框。复用现有灰度、累加/串行除法、分类器及27位邮箱，不增加帧缓存或重复统计。

确认范围后执行：

- ModelSim：独立参考核对80×80共6400像素的SUM/MEAN/MIN/MAX；框外亮点不能影响小框；非4对齐ROI、坏帧、配置变更、取消/恢复及CDC回归保持有效。OSD核对大框灰度、框外彩色、小框覆盖及像素/同步延迟。
- TD：最终综合及布局布线，保存资源、建立/保持时序和约束覆盖报告；关注既有DDR复位recovery余量和基线约束缺口，不因通过构建宣称全部时序路径已覆盖。
- 冻结：新目录保存bit、输入快照与SHA-256，不覆盖旧release；用户自行下载，助手不操作JTAG/USB。

## 新版下载后的采样操作

先固定载带高度、对焦、照明、EXP/GAIN和130 mm距离。将已确认同种载带的有件/空穴样本摆成相同方向、同一观察面，使大定位孔在同一侧；穴位中心对齐同一青色小框位置。检查小框完整覆盖目标且不包含邻穴/大定位孔/台面。

有件与空穴各固定观察约10秒，记录MEAN的最小/最大、MIN/MAX、VALID、输入FPS、错误计数及实物真值；每类至少重复一次摆放。不要把显示器照片像素作为摄像头原始灰度。若小框不适配，先反馈边界与目标关系，再调整固定ROI，不直接强行启用阈值。

若两类单穴均值范围有足够间隔，再另行确认阈值、方向、EXP/GAIN及光源/距离配方，并在启用分类后重新仿真、TD与实物准确率验证。范围重叠则先定位对焦/反光/定位原因，再讨论是否需要其他特征。当前资料未批准此下一版；用户原要求仍为确认后生成。
