czp-1-A1/FPGA_Component_Inspector/官方资料/00_来源说明/资料指引.docx

网盘里的文件夹包括几个部分：

1_安路工具和软件：包含安路科技的开发环境相关软件安装及驱动，含老版本和新版本。

2_Example：是提供多个配套例程及实验说明，包含老版本和新版本软件完成的DEMO。

3_原理图：包含开发板和转接板摄像头的原理图。

4_芯片手册：含有开发板上用户所涉及的芯片。

5_软件工具及驱动：含串口通信、网络数据传输等上位机及驱动。

6_PH1P35：是安路科技PH1P系列所提供的技术手册。

7_lab_ex_2026_nosoft：里面包含2026年安路赛道赛题二提供相关例程及资料等。

8_FPGA学校资料：含FPGA基础知识、语法等内容。

9_康芯HX1P35使用手册及实验平台介绍：里面包含了HX4S20板的使用手册，引脚说明及安路其他系列实验平台介绍。
