czp-1-A1/FPGA_Component_Inspector/开发实施/导师汇报_制作记录/render_bw_final/page-1.png

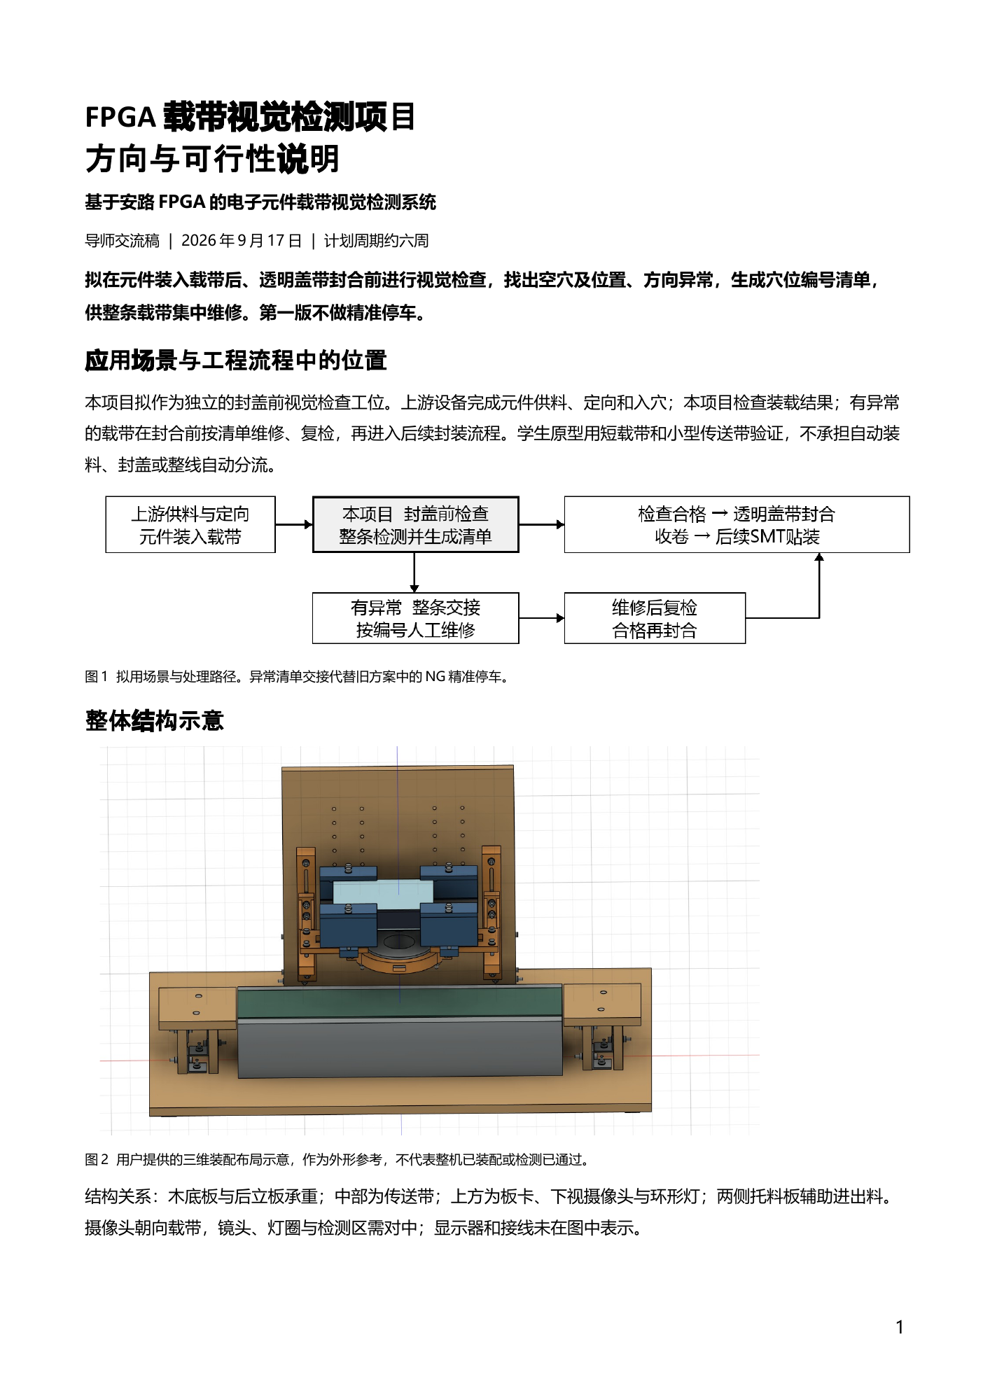
开发实施/导师汇报_制作记录/render_bw_final/page-1.png
