czp-1-A1/FPGA_Component_Inspector/开发实施/显示方案预览/demo-offline-preview.png

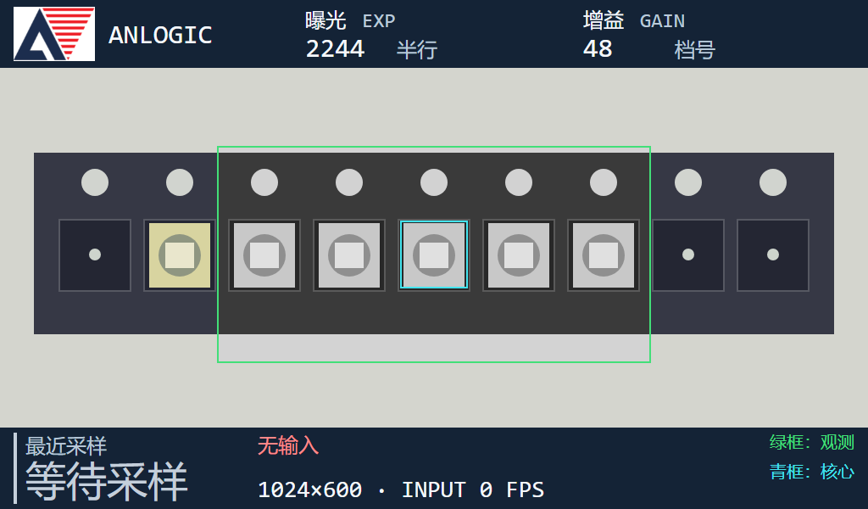
开发实施/显示方案预览/demo-offline-preview.png
