czp-1-A1/FPGA_Component_Inspector/开发实施/机械概念图/可调载带检测台_概念V1_20260908.png

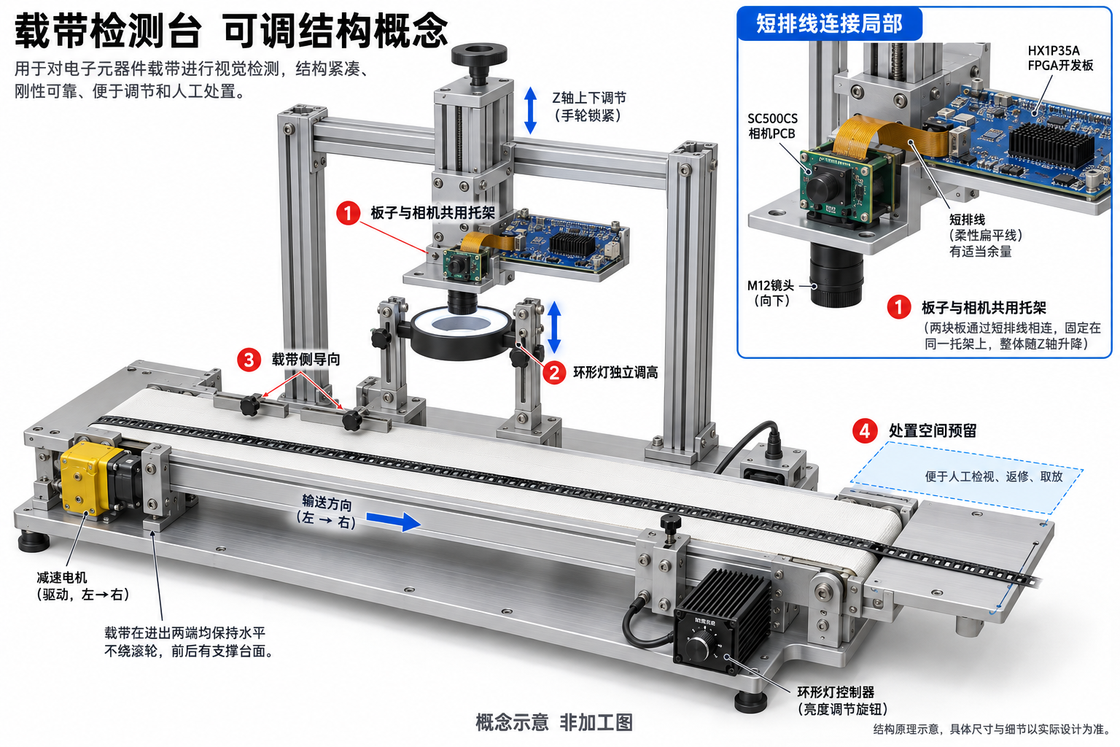
开发实施/机械概念图/可调载带检测台_概念V1_20260908.png
