czp-1-A1/FPGA_Component_Inspector/开发实施/机械概念图/摄像头背面折叠版_概念V1_20260909.png

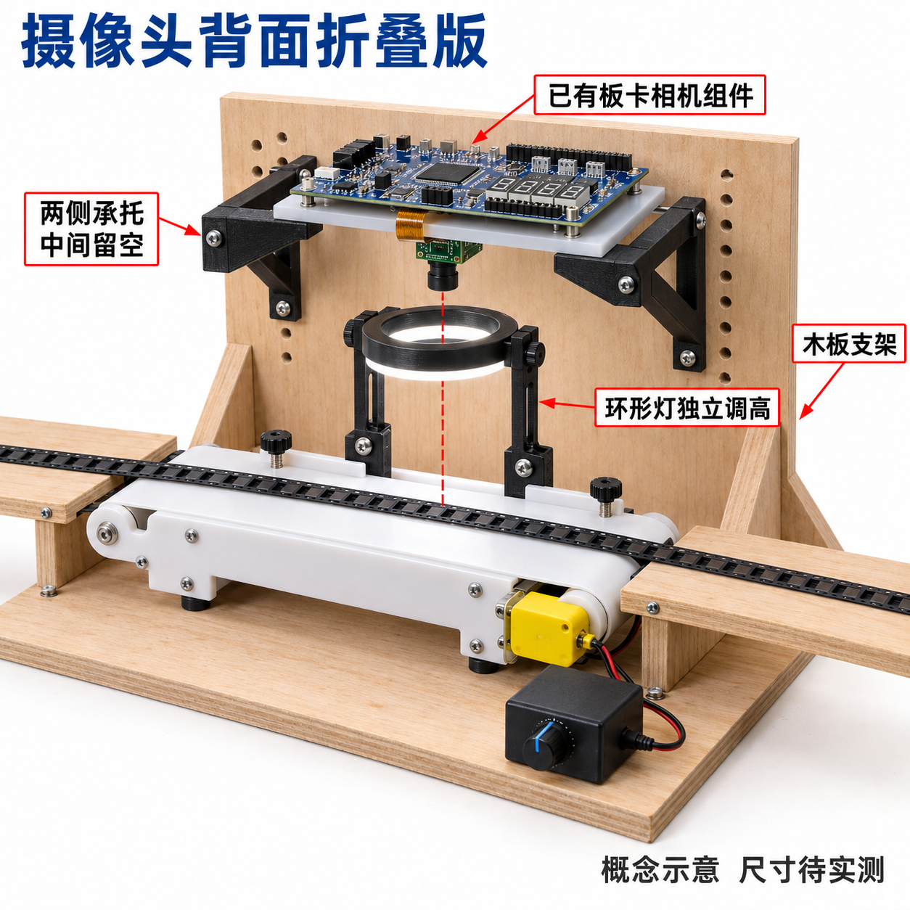
开发实施/机械概念图/摄像头背面折叠版_概念V1_20260909.png
