czp-1-A1/FPGA_Component_Inspector/开发实施/机械概念图/木板与3D打印_学生简易版_20260908.png

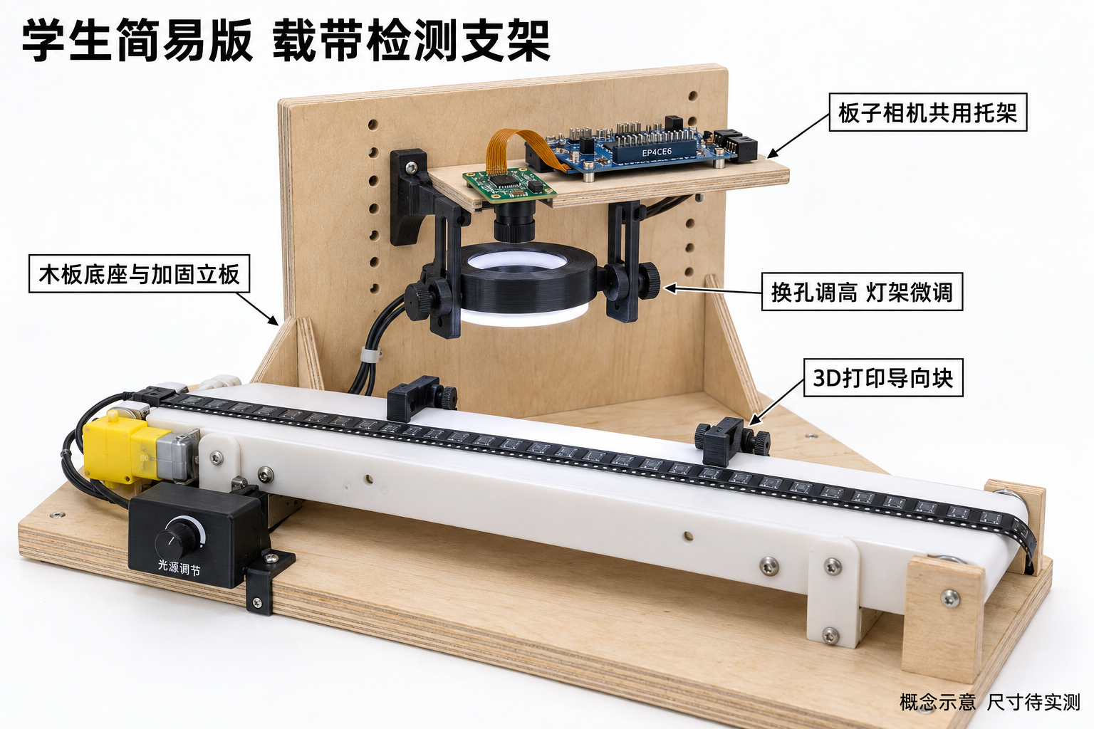
开发实施/机械概念图/木板与3D打印_学生简易版_20260908.png
