czp-1-A1/FPGA_Component_Inspector/开发实施/机械结构展示/整体布局V3_检查.png

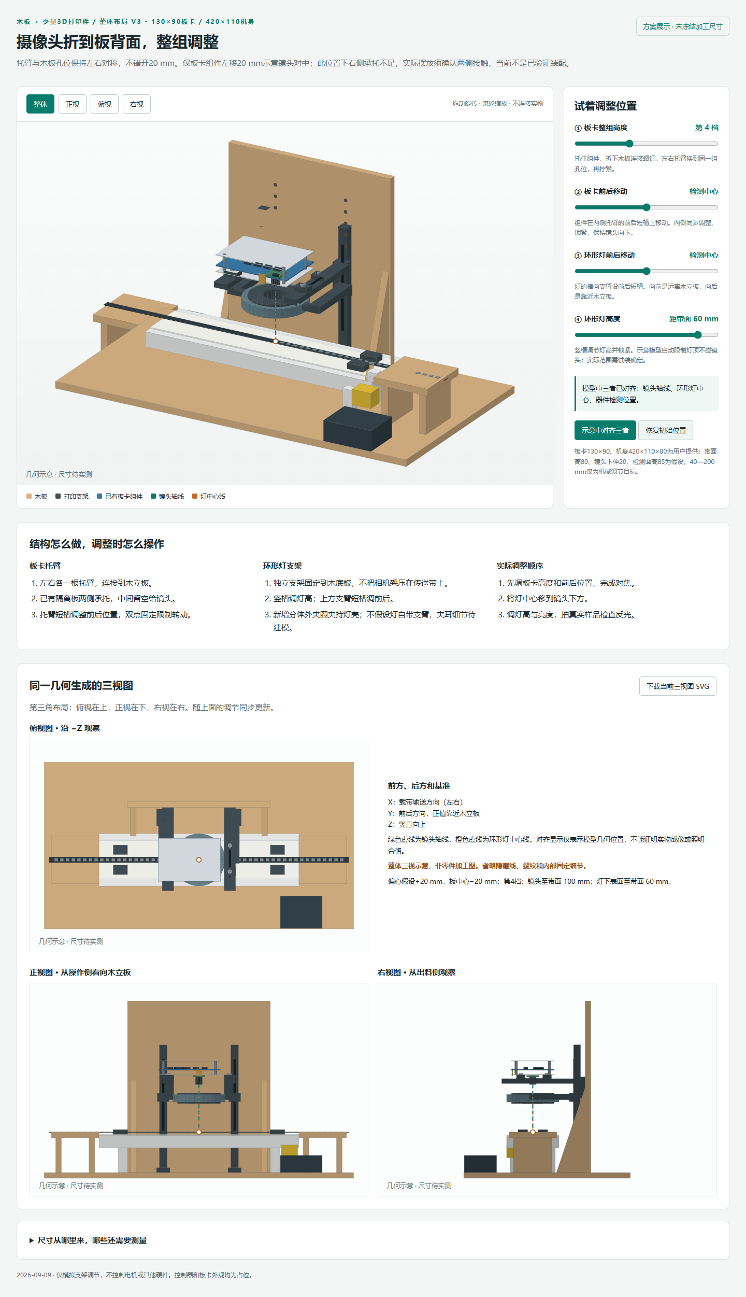
开发实施/机械结构展示/整体布局V3_检查.png
