czp-1-A1/FPGA_Component_Inspector/开发实施/机械结构展示/页面检查.png

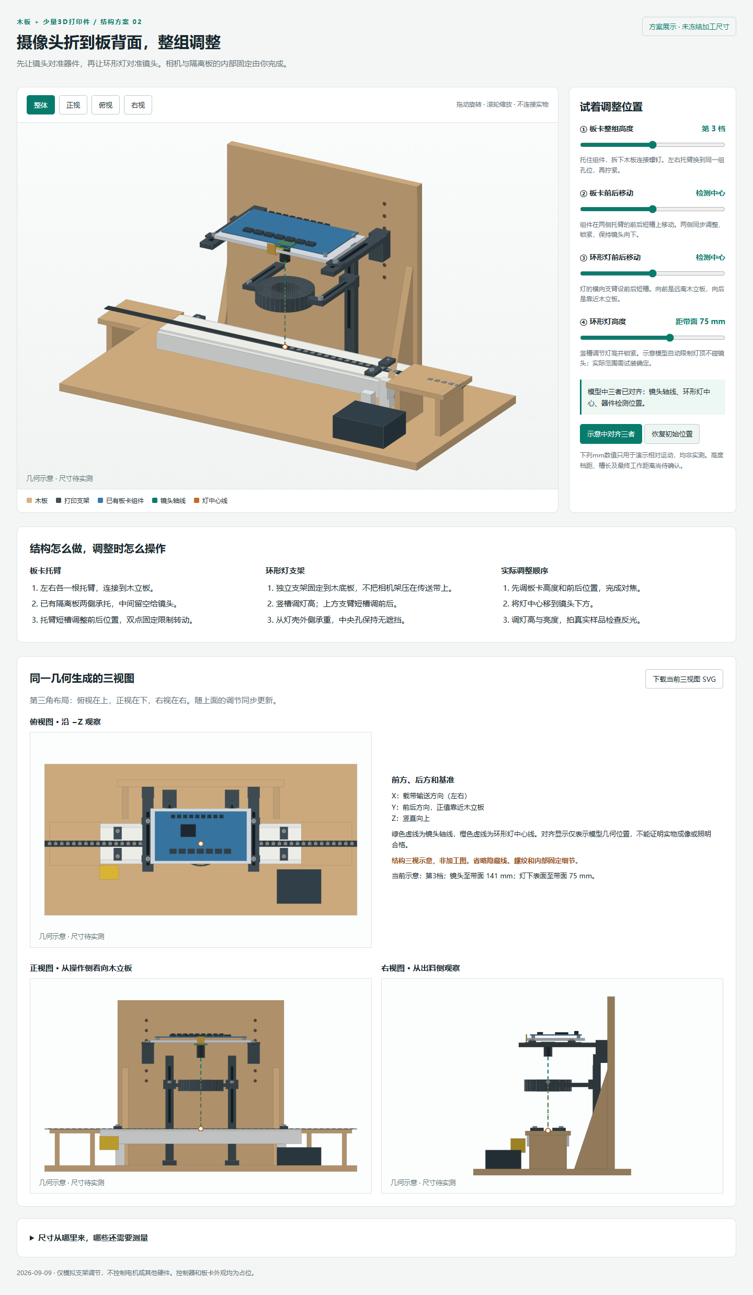
开发实施/机械结构展示/页面检查.png
