czp-1-A1/FPGA_Component_Inspector/开发实施/验收记录/20261005_80x80单穴反馈_轮次1/photo_01.jpg

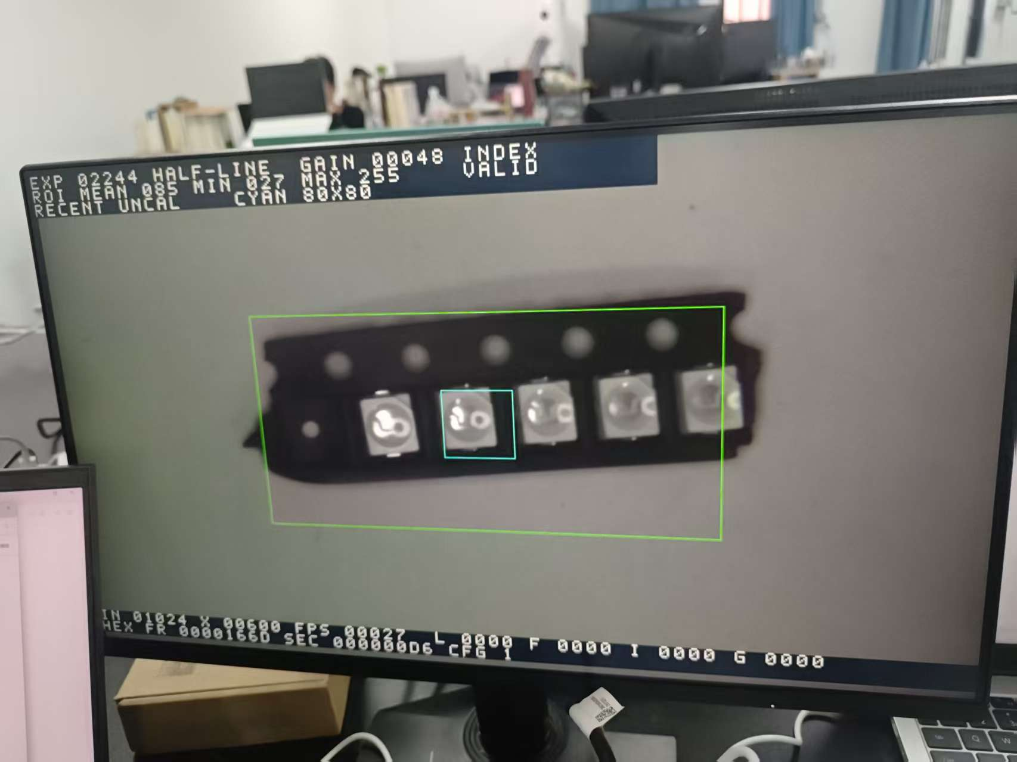
开发实施/验收记录/20261005_80x80单穴反馈_轮次1/photo_01.jpg
