czp-1-A1/FPGA_Component_Inspector/开发实施/验收记录/20261005_130mm成像反馈_轮次3/photo_04.jpg

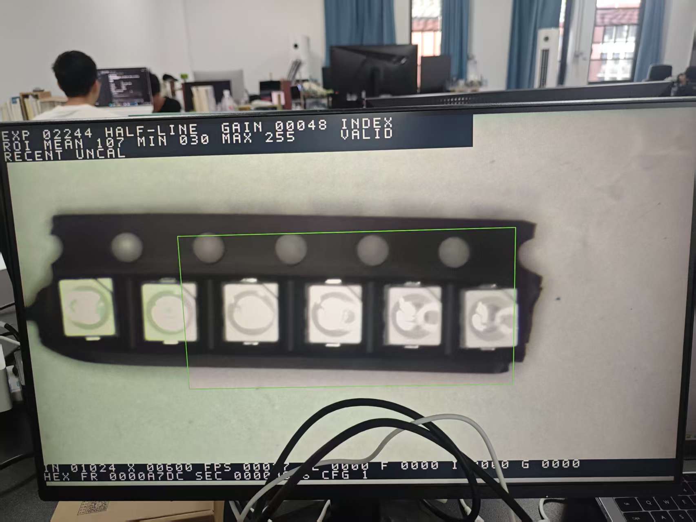
开发实施/验收记录/20261005_130mm成像反馈_轮次3/photo_04.jpg
