czp-1-A1/FPGA_Component_Inspector/开发实施/验收记录/20261006_A_SW视频链路修复_轮次1/simulation/osd_assets/mode_0.png

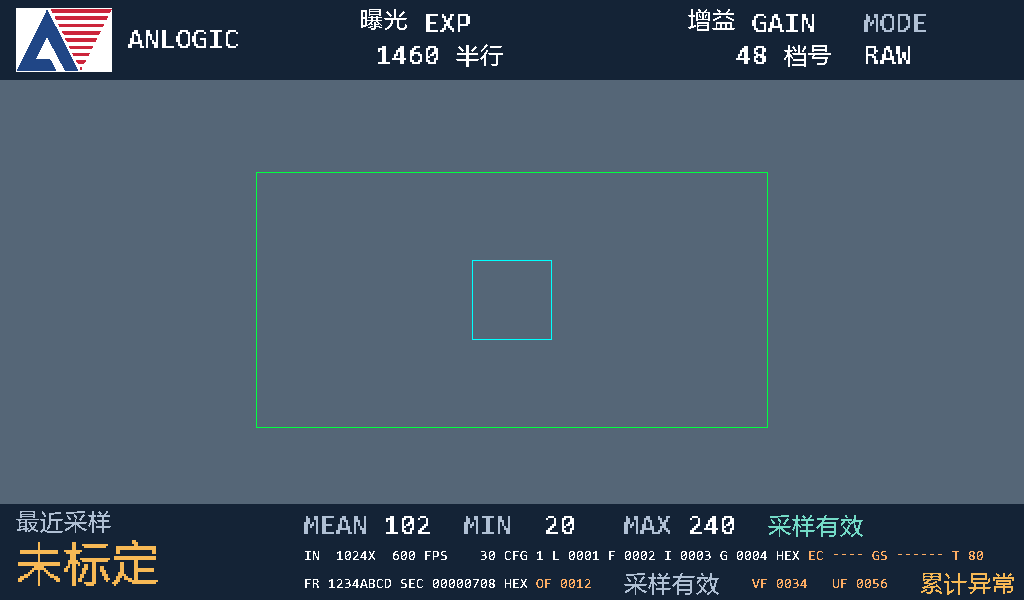
开发实施/验收记录/20261006_A_SW视频链路修复_轮次1/simulation/osd_assets/mode_0.png
