czp-1-A1/FPGA_Component_Inspector/赛题要求与分析/FPGA赛题解析_AI可读资料包/FPGA赛题解析_AI可读资料包/assets/diagrams_png/image13.png

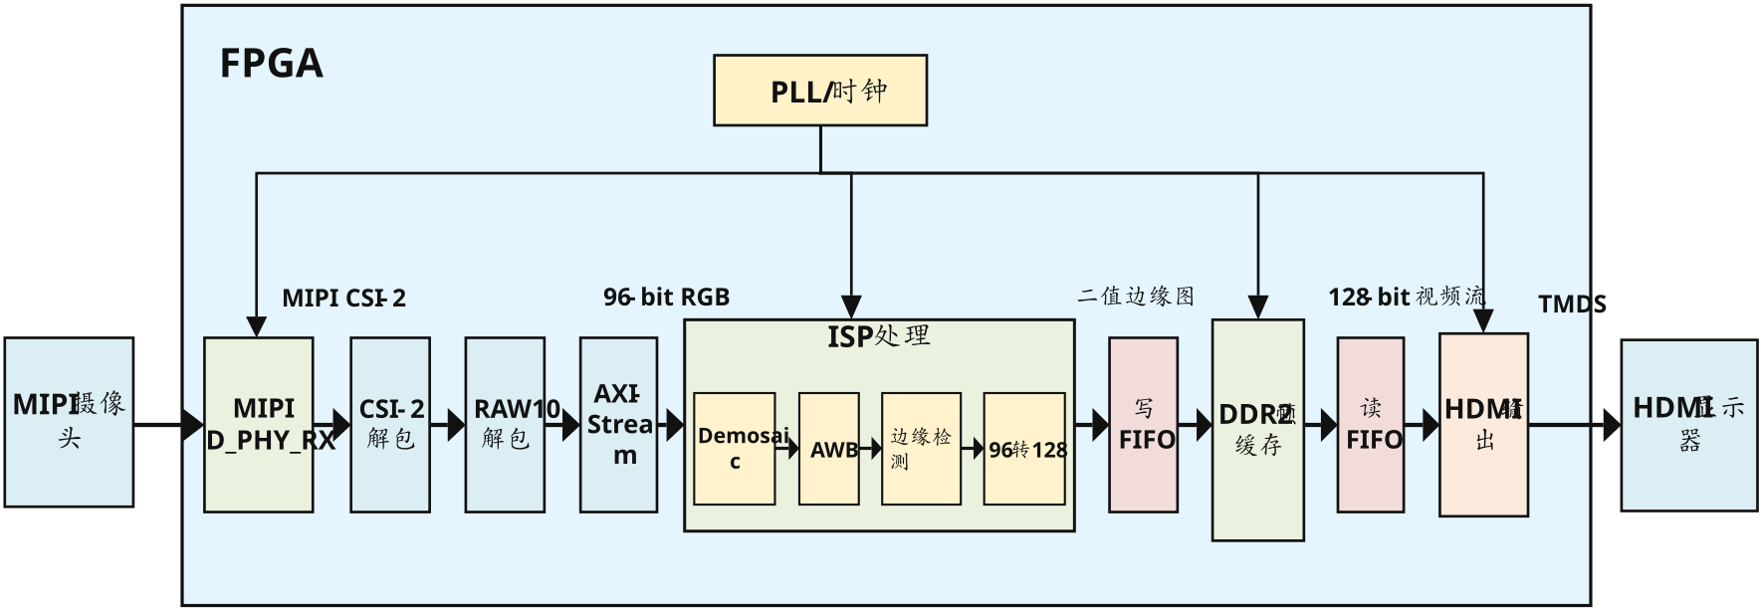
赛题要求与分析/FPGA赛题解析_AI可读资料包/FPGA赛题解析_AI可读资料包/assets/diagrams_png/image13.png
