czp-1-A1/FPGA_Component_Inspector/购物清单/镜头/16mm_25mm镜头参数.md

# 镜头参数

## 16mm 5MP 无畸变镜头

- 焦距：16 mm
- 接口：M12 × P0.5
- 视场角：
  - 对角 D：31°
  - 水平 H：20°
  - 垂直 V：13°
- 清晰度：5MP
- 像面尺寸：1/2.5"
- 畸变率：≤1%
- 光圈 F/NO：1.8 ±5%
- 重量：5.3 g
- 最近摄距 M.O.D：80 mm
- 工作温度：-10℃ ～ +70℃
- 后焦距 BFL：8.4 ±0.5 mm
- 最大宽度：14 mm
- 高度：18.3 mm

## 25mm 8MP 无畸变镜头

- 焦距：25 mm
- 接口：M12 × P0.5
- 视场角：
  - 对角 D：19°
  - 水平 H：15°
  - 垂直 V：8°
- 清晰度：8MP
- 像面尺寸：1/2"
- 畸变率：≤1%
- 光圈 F/NO：2.4 ±5%
- 重量：5.0 g
- 最近摄距 M.O.D：100 mm
- 工作温度：-10℃ ～ +70℃
- 后焦距 BFL：11 ±0.5 mm
- 最大宽度：14 mm
- 高度：20 mm
