czp-1-A1/FPGA_Component_Inspector/待测元器件/待测元器件候选库.xlsx

Sheet: 候选元件库
载带元件候选库（初筛版） |  | 立创照片 | 立创照片
用途：按项目文档先建立候选型号库；“待核实/待实物验证”不是已确认事实。LCSC照片仅用于外观初筛，最终以实物成像验证为准。 |  | LCSC商品主图；照片仅用于外观初筛，最终以实物成像验证为准。 | LCSC商品主图；照片仅用于外观初筛，最终以实物成像验证为准。 | 用途：按项目文档先建立候选型号库；“待核实/待实物验证”不是已确认事实。 | 用途：按项目文档先建立候选型号库；“待核实/待实物验证”不是已确认事实。 | 用途：按项目文档先建立候选型号库；“待核实/待实物验证”不是已确认事实。 | 用途：按项目文档先建立候选型号库；“待核实/待实物验证”不是已确认事实。 | 用途：按项目文档先建立候选型号库；“待核实/待实物验证”不是已确认事实。 | 用途：按项目文档先建立候选型号库；“待核实/待实物验证”不是已确认事实。 | 用途：按项目文档先建立候选型号库；“待核实/待实物验证”不是已确认事实。 | 用途：按项目文档先建立候选型号库；“待核实/待实物验证”不是已确认事实。 | 用途：按项目文档先建立候选型号库；“待核实/待实物验证”不是已确认事实。 | 用途：按项目文档先建立候选型号库；“待核实/待实物验证”不是已确认事实。 | 用途：按项目文档先建立候选型号库；“待核实/待实物验证”不是已确认事实。 | 用途：按项目文档先建立候选型号库；“待核实/待实物验证”不是已确认事实。 | 用途：按项目文档先建立候选型号库；“待核实/待实物验证”不是已确认事实。 | 用途：按项目文档先建立候选型号库；“待核实/待实物验证”不是已确认事实。
元件类别 | 立创编号 | 图片 | 图片2 | 制造商 | 完整料号 | 封装 | 元件尺寸 | 顶部特征 | 顶部能否判断方向 | 预计可检测缺陷 | 包装方式 | 载带宽度 | 穴位节距 | datasheet链接 | 商品链接 | 初步推荐等级 | 信息状态
SOD-123肖特基二极管 | C64885 | LCSC C64885 | LCSC C64885 | MDD | B5819W | SOD-123 | 约2.6 x 1.6 mm | 顶部阴极色带；轴向外形 | 待实物验证 | 空穴、偏位、旋转、阴极方向、多料 | Tape & Reel | 待核实（常见8 mm） | 待核实（常见4 mm） | https://www.mdddiode.com/uploadfile/2020/0908/20200908094649539.pdf | https://www.lcsc.com/product-detail/C64885.html | 主样品候选 | 商品编号来自项目文档；包装参数待核实
SOD-123开关二极管 | C2099 | LCSC C2099 | LCSC C2099 | JSCJ | 1N4148W | SOD-123 | 约2.6 x 1.6 mm | 顶部阴极色带；轴向外形 | 待实物验证 | 空穴、偏位、旋转、阴极方向、多料 | Tape & Reel | 待核实（常见8 mm） | 待核实（常见4 mm） | https://datasheet.lcsc.com/datasheet/pdf/a039f08bad6041678a289b80dd5d701f.pdf?productCode=C2099 | https://www.lcsc.com/product-detail/C2099.html | 主样品候选 | 立创商品页已核对；包装尺寸待核实
SMA肖特基二极管 | C83852 | LCSC C83852 | LCSC C83852 | onsemi | SS14 | SMA/DO-214AC | 约4.5 x 2.7 mm | 顶部阴极色带；大尺寸轴向外形 | 待实物验证 | 空穴、偏位、旋转、阴极方向、多料 | Tape & Reel | 待核实（常见12 mm） | 待核实（常见4 mm） | https://www.onsemi.com/pdf/datasheet/ss12-d.pdf | https://www.lcsc.com/product-detail/C83852.html | 主样品候选 | 商品编号来自项目文档；包装参数待核实
3528红色水清LED | C516137 | LCSC C516137 | LCSC C516137 | HONGLITRONIC | HL-A-3528S9AC-S1-13HL | PLCC-2/3528 | 约3.5 x 2.8 mm | 顶部芯片/杯体不对称结构；颜色特征 | 待实物验证 | 空穴、偏位、旋转、明显极性/方向、颜色异常、多料 | Tape & Reel | 待核实（常见8 mm） | 待核实（常见4 mm） | https://www.honglitronic.com/uploads/soft/20230210/1-23021016122Q29.pdf | https://www.lcsc.com/product-detail/Light-Emitting-Diodes-LED_HONGLITRONIC-Hongli-Zhihui-HONGLITRONIC-HL-A-3528S9AC-S1-13HL_C516137.html | 主样品候选 | 商品编号和链接来自项目文档；极性特征必须实拍验证
3528绿色水清LED | C5280496 | LCSC C5280496 | LCSC C5280496 | OSRAM | LP T67F-P1R2-35-Z | 3528 | 约3.5 x 2.8 mm | 顶部芯片/杯体不对称结构；绿色发光特征 | 待实物验证 | 空穴、偏位、旋转、方向、颜色异常、多料 | Tape & Reel | 待核实（常见8 mm） | 待核实（常见4 mm） | https://datasheet.lcsc.com/datasheet/pdf/fd3a523537368e22b535762f4866be43.pdf?productCode=C5280496 | https://www.lcsc.com/product-detail/C5280496.html | 第二配方候选 | 立创商品页已核对；极性特征和包装尺寸待实物验证
CASE-A钽电容 | C7177 | LCSC C7177 | LCSC C7177 | Kyocera AVX | TAJA106K010RNJ | CASE-A/3216 | 约3.2 x 1.6 mm | 顶部极性条（需确认颜色与方向） | 待实物验证 | 空穴、偏位、旋转、极性条方向、多料 | Tape & Reel | 待核实（常见8 mm） | 待核实（常见4 mm） | https://datasheets.kyocera-avx.com/TAJ.pdf | https://www.lcsc.com/product-detail/Tantalum-Capacitors_Kyocera-AVX-TAJA106K010RNJ_C7177.html | 主样品候选 | 商品编号来自项目文档；具体包装参数待核实
CASE-B钽电容 | C7193 | LCSC C7193 | LCSC C7193 | Kyocera AVX | TAJB106K016RNJ | CASE-B-3528-21(mm) | 约3.5 x 2.8 mm | 顶部极性条（需确认颜色与方向） | 待实物验证 | 空穴、偏位、旋转、极性方向、多料 | Tape & Reel | 待核实（常见8/12 mm） | 待核实（常见4 mm） | https://datasheets.kyocera-avx.com/TAJ.pdf | https://www.lcsc.com/product-detail/C7193.html | 第二配方候选 | 立创商品页已核对；极性条、载带宽度和节距待实物确认
SOT-23三极管 | C20526 | LCSC C20526 | LCSC C20526 | JSCJ | MMBT3904(RANGE:100-300) | SOT-23 | 约2.9 x 1.3 mm | 三引脚不对称轮廓；顶部激光标记 | 待实物验证 | 空穴、偏位、旋转、侧立、封装方向、多料 | Tape & Reel | 待核实（常见8 mm） | 待核实（常见4 mm） | https://datasheet.lcsc.com/datasheet/pdf/9335632bcfa83df8351353eab379720e.pdf?productCode=C20526 | https://www.lcsc.com/product-detail/C20526.html | 第二配方候选 | 立创商品页已核对；顶部标记和包装尺寸待实拍
SOT-89稳压器 | C880752 | LCSC C880752 | LCSC C880752 | Slkor | AMS1117-3.3 | SOT-89-3 | 约4.5 x 2.5 mm | 大散热片与引脚轮廓不对称；顶部型号标记 | 待实物验证 | 空穴、偏位、旋转、方向、错尺寸、多料 | Tape & Reel | 待核实（常见8/12 mm） | 待核实（常见4 mm） | https://datasheet.lcsc.com/datasheet/pdf/158719a1727e8939bb22ae7d016ecfa3.pdf?productCode=C880752 | https://www.lcsc.com/product-detail/C880752.html | 高难度扩展 | 立创商品页已核对；顶部标记和实际载带待确认
SOP-8芯片 | C5423 | LCSC C5423 | LCSC C5423 | TI | LM358DR | SOIC-8 | 约5.0 x 4.0 mm | 顶部缺口或圆点（Pin 1）；细引脚轮廓 | 待实物验证 | 空穴、偏位、旋转、Pin 1方向、明显引脚异常、多料 | Tape & Reel | 待核实（常见12 mm） | 待核实（常见4 mm） | https://datasheet.lcsc.com/datasheet/pdf/15e76e5a54e249468598e3cd1deb82d5.pdf?productCode=C5423 | https://www.lcsc.com/product-detail/C5423.html | 高难度扩展 | 立创商品页已核对；Pin 1标记、载带宽度和节距待实拍
1206电阻（非极性配方） | C132649 | LCSC C132649 | LCSC C132649 | YAGEO | RC1206FR-0710KL | 1206 | 约3.2 x 1.6 mm | 矩形本体；可能有字符但无可靠极性 | 不能判断极性 | 空穴、偏位、旋转、侧立、错尺寸、破损 | Tape & Reel | 待核实（常见8 mm） | 待核实（常见4 mm） | https://datasheet.lcsc.com/datasheet/pdf/b426be3ce22c6de3e0c3a2248e49159e.pdf?productCode=C132649 | https://www.lcsc.com/product-detail/C132649.html | 第二配方候选 | 立创商品页已核对；字符可见性和包装尺寸待确认
1210贴片电感（普通外观配方） | C840633 | LCSC C840633 | LCSC C840633 | BOURNS | CM322522-100KL | 1210 | 约3.2 x 2.5 mm | 磁屏蔽外壳和端头轮廓；无可靠极性 | 不能判断电气极性 | 空穴、偏位、旋转、侧立、明显破损、多料 | Tape & Reel | 待核实（常见8/12 mm） | 待核实（常见4 mm） | https://datasheet.lcsc.com/datasheet/pdf/ca5b3527879705a95e54b9f69dce33e3.pdf?productCode=C840633 | https://www.lcsc.com/product-detail/C840633.html | 后期扩展 | 立创商品页已核对；金属反光和包装尺寸待实物验证

Sheet: 验证计划
候选元件验证计划
验证阶段 | 要验证的问题 | 操作方法 | 合格判据 | 输出记录 | 关联字段
资料初筛 | 是否为真实卷带包装？ | 下载商品页/封装与包装资料，记录载带宽度、节距、装料方向 | 料号、包装方式、载带参数可追溯 | 商品页截图或PDF页码 | 包装方式/载带宽度/穴位节距
静态成像 | 顶部特征是否能判方向？ | 固定工作距离、顶光，拍摄正向/反向/旋转/空穴样品 | 正反方向特征可分离，标记不被反光淹没 | 原图、灰度图、二值图 | 顶部特征/顶部能否判断方向
动态成像 | 送料时是否清晰？ | 以目标速度连续送料，记录运动模糊和穴位覆盖数 | 每穴至少获得3帧可用图像，定位孔连续可见 | 视频、帧数、速度 | 穴位节距/检测缺陷
缺陷样本 | 算法所需缺陷是否能复现？ | 制作空穴、偏位、旋转、反向、多料测试段 | 每类缺陷均有可重复样本和编号 | 测试段照片/编号表 | 预计可检测缺陷
机械兼容 | 载带能否稳定通过导轨？ | 装卷、送料、停车，记录卡带、跑偏和停车误差 | 无明显卡带；停车误差满足处置窗口 | 机械测试记录 | 载带宽度/穴位节距
最终决策 | 是否进入主样品或第二配方？ | 按成像、算法、机械三项结果评分 | 主样品：方向可靠、资料完整、机械可用 | 选型结论和淘汰原因 | 初步推荐等级/备注

Sheet: 来源说明
来源与数据状态说明
来源类型 | 用途 | 本表处理方式 | 注意事项
项目文档中的示例链接/编号 | 提供候选商品编号和初始方向 | 保留原链接；相关字段标注“来自项目文档” | 不代表当前库存或包装参数已核实
厂商/代理商datasheet | 核对封装外形、极性标记和尺寸 | 写入datasheet链接 | 不同后缀、品牌和批次可能不同
标准封装经验值 | 帮助初筛载带宽度和节距 | 仅作为“常见值”提示，不填成确定值 | 必须下载具体料号包装图确认
实物拍摄验证 | 确认顶部方向特征、反光和动态清晰度 | 列为后续验证阶段 | 这是能否进入FPGA算法开发的关键证据
机械送料测试 | 确认载带宽度、节距和停车兼容性 | 列为验证计划 | 视觉可行不等于机械可用
信息状态字段 | 区分已知、推断和待确认 | 用“待核实/待实物验证”显式标记 | 开发前应将主样品关键字段补齐
LCSC公开商品页/接口 | 核对具体SKU、制造商、型号、封装、Tape & Reel状态 | 已为泛化条目替换为具体SKU；字段仍需按采购批次复核 | 库存、价格和包装细节会变化，采购前应再次确认
