czp-1-A1/FPGA_Component_Inspector/fpga/component_inspector/release/roi_core_80_20261005/README.md

# 单穴80×80取样版，2026-10-05

下载文件：camera_to_dsi_display.bit（1,789,539字节）。
SHA-256：78d9a419cc75bae78655cc7608037959415ea67fd0452580446de0b7176c3c54

保留512×256灰度绿框，增加中央80×80青框[472,552)×[260,340)。MEAN/MIN/MAX/VALID只统计青框内6400像素，CYAN 80X80标识归属，默认RECENT UNCAL。相机1024×600和四键保持。

ModelSim默认12项全PASS；TD 6.2.168116最终综合/布局布线通过，Slice 14122（66.56%），ERAM 31，DSP 8；Setup/Recovery WNS 1.437ns、Hold WNS 0.020ns，TNS均0；STA 95.05%。完整输入198项及.al哈希核对；约束覆盖缺口保持，没有放宽SDC。此版尚未上板。

用户自行下载，固定130mm候选条件与同一光源/焦点，先用EXP2244/GAIN48，将单穴核心区域对青框；有件/空穴各记录约10秒MEAN范围/MIN/MAX/VALID/输入FPS/错误计数，每类重复摆放一次。小框不需包整穴，排除定位孔/邻穴/台面。数据确认后再定阈值，当前不输出实际分类。

说明：开发实施/18_A单穴80x80取样_实施说明.md。验收记录与证据：开发实施/验收记录/20261005_A单穴80x80取样_轮次1.md及同名目录。回退版roi_classifier_20261004保持。30分钟、实物准确率与固化冷启动未测，未提交或推送。
