czp-1-A1/FPGA_Component_Inspector/fpga/component_inspector/release/roi_statistics_20261003/README.md

# 临时ROI灰度统计版（2026-10-03）

下载文件：camera_to_dsi_display.bit，1,789,539字节。SHA-256：`53b6e341c02da01292067eb27bb7d0f456afded30602a449d79496b2051fabce`。

中央256×128临时ROI：[384,640)×[236,364)，框内灰度、边框绿色、框外原色；上方EXP/GAIN与ROI MEAN/MIN/MAX、VALID/WAIT，底部保留独立输入FPS及验收计数。四键曝光−/＋、增益−/＋。本版没有正常/空穴分类。

ModelSim 10项通过，TD综合及布局布线完成。最终建立/保持WNS 0.217/0.020ns，TNS0；Slice 13998（65.98%）、31 ERAM、8 DSP。197项当前/构建输入一致，快照与报告见开发实施/验收记录/20261003_ROI灰度统计_轮次1，manifest绑定冻结版本。

上板由用户操作，尚未现场验收。启动首帧可能WAIT，完整后VALID；调参时等待新样本。数值是最近有效采集统计，尚未绑定DDR显示帧。外部I/O、PLL及两项DDR例外约束仍待核验；30分钟、Flash固化及冷启动未测。保留上一已确认画面/四键正常的experiment_ramfix_20261003作为对照。

先将同一目标穴位放在中央框内，确认显示与四键，再在同一距离、EXP、GAIN、光源下分别记录正常和空穴MEAN/MIN/MAX约10秒的波动范围；WAIT不作统计样本。距离和光照可继续逐步调整，每次改变一个变量并记新条件ID。
