czp-1-A1/FPGA_Component_Inspector/fpga/component_inspector/release/roi_statistics_large_20261003/README.md

# 中央512×256观测ROI版（2026-10-03）

下载camera_to_dsi_display.bit，1,789,539字节，SHA-256 `a20859510c99568d15377d6bb9622090d23ca92d4f275a4282bed70cad466a48`。

中央窗口x=256～767、y=172～427，共131072像素；框内灰度/绿色边框、框外彩色；统计同一区域。四键曝光−/＋、增益−/＋及默认参数保持。本版只扩大观测ROI，没有正常/空穴分类。

受影响的3项ModelSim（OSD、ROI保护、真实7帧ISP统计）通过；其余7项沿用前版证据。TD综合及布局布线完成，建立/保持WNS 0.962/0.020ns、TNS0，Slice14079（66.36%）、31 ERAM、8 DSP；197项输入与独立构建一致。部分基线约束待核验。全部证据在开发实施/验收记录/20261003_ROI扩大512x256_轮次1。

由用户下载。上板、30分钟、Flash和冷启动未测；前小框版反馈不作为新大框验收。启动可能先WAIT，完整采集/处理后VALID；停止CSI时钟到WAIT约1～2秒。统计显示最近有效采集样本，尚未绑定DDR显示帧。

重新下载可能回到默认EXP2244/GAIN48。可用四键恢复照片中的2116/43后比较；新ROI面积变化，均值不能直接按旧框数据判断正常/空穴。先把目标置入框，检查显示和按键，再保持同一成像条件记录统计波动范围。正式分类另选单穴ROI。
