czp-1-A1/FPGA_Component_Inspector/fpga/component_inspector/release/sw_edge_20261005/README.zh-CN.md

# 独立SW灰度/边缘取样实验版

文件：camera_to_dsi_display.bit，1789539字节。
SHA-256：a43156b8fc076d7940e12b8f7ba46d026a3053466b759724bef79235570bcd8c。

SW1上拨开启灰度，SW2上拨开启橙色Sobel边缘。下/下RAW，上/下GRAY，下/上EDGE，上/上GRAY+EDGE。绿色512×256框内处理，框外彩色；青色80×80框取样。四个KEY继续曝光减/加、增益减/加。

切换后等待新完整采样。边缘开启且采样有效时EC/GS分别是青框阈上数量/全部梯度和，十六进制显示；T80为十进制Sobel观察阈值。关闭或无效显示横线。MODE是请求，视频从下一原生帧应用，并经过DDR显示延迟。

按三类物料分别观察有件/空穴的四种视图并拍照，保留曝光/增益条件。位置尚未固定，可以先收集现象；青框不保证覆盖每类完整轮廓，阈值80也尚未标定。

默认16项ModelSim和调参/拨动并发补测通过；TD综合/布局布线完成。Slice74.19%，ERAM48，DSP8；建立0.146ns、保持0.020ns、TNS0，STA94.74%，保留既有约束覆盖问题，新增SW/邮箱路径已核对。

正式有件/空穴分类未启用，未标定是预期状态。本版上板画面、三类物料效果、准确率、30分钟稳定运行、固化和冷启动待实测。助手未执行下载。详细源码、测试及TD证据见manifest.json和仓库开发实施/验收记录/20261005_A独立SW灰度边缘实验_轮次1。
