czp-1-A1/FPGA_Component_Inspector/开发实施/07_机械定尺寸测量表与制作清单.md

# 机械定尺寸测量表与制作清单

日期：2026-09-09。单位统一为 mm。适用于木板＋少量3D打印件、摄像头折到已有隔离板背面的方案。

当前状态：布局已确认；真实安装尺寸尚未冻结。现有HTML中的620、330、高度档位、槽长等均为展示参数，不能照抄下单或打印。购物清单中有商品资料不代表已经购买，先填写“已有/未买”。

## 0. 用户补充尺寸（优先于旧商品资料和展示占位）

| 对象 | 最新输入 | 当前可用于设计的范围 |
|---|---|---|
| 板卡及上下亚克力板 | 平面均按130×90 | 确定平面包络；总厚度、下板厚度、可承托区域、重量仍未给出。暂按130沿输送方向布置，不把镜头放在几何中心作为真实尺寸 |
| 传送带带面 | 420×80 | 替代旧400×80名义尺寸 |
| 传送带整体 | 420×110×80 | 作为用户提供的整机包络；80为整体高度，不能自动等同实测带面高度；底部照片不用于推算精确脚位 |
| 镜头位置 | 未知，用户确认能对准输送带中心 | 中心对准作为装配目标；托臂和组件需要保留对中调节，最终偏移及避让仍待组装后确认 |
| 载带 | 宽度未知，仅确定小于80 | 导向采用可调结构，最终间隙及高度按样带定，不能据此保证任意小于80的载带都能适配 |
| 拍摄距离 | 用户估计40—200 | 作为机械范围的待验证目标；不代表镜头在整个范围都能合焦或满足视场。40端尤其需检查灯厚22与光路/样品之间的空间 |
| 环形灯 | 图三SJ-R9060-D40：外径90、内孔40、高22；4×M3深4、分布圆直径78 | 图纸给出的安装孔中心相对灯中心为(±39,0)、(0,±39)，相邻中心距约55.15，对置78；须确认实物安装面，不将发光面小孔当安装孔 |

环形灯不自带之前展示的竖杆、支臂、连接耳或托座，这些属于自制件。优先用灯壳已有安装螺孔连接独立的打印转接件，从上方/背面承托，保留中央光路与发光区域；不假设灯外侧自带凸耳。确认安装面后再决定转接件剖面和螺钉长度，不能直接用长螺钉拧到底。

本次三张输入照片与用户文字为上述补充来源。旧HTML及结构SVG尚未按本次数据重建，仍仅是布局示意。正式尺寸以本节和后续实测结果为准。

剩余优先数据缩减为：①下亚克力板厚度、组件总高及镜头下伸量；②镜头最终中心位置或允许移动的实际范围；③实际合焦且视场合格的工作距离；④灯背面安装面确认；⑤木板厚度和打印成型范围。样带尺寸未到时可以先做主体，导向块后定。

## 1. 你先提供什么

优先填写A1—A5、B1—B3、C1、D1。尺子测大外形，卡尺测板厚、孔径及小间隙；不确定的尺寸写“约”，没有的数据写“未测”。无需测绘相机内部固定方式。

坐标约定：X为载带行进方向，Y为前后方向（向木立板为后），Z向上。板卡组件先按最终折好、镜头向下的姿态摆放。从上往下看，以隔离板前左角作为平面测量起点。

| 编号 | 测什么、怎样测 | 填写结果 | 决定什么 |
|---|---|---|---|
| A1 | 折好后整个组件的最大左右宽X、前后深Y、总高度；包括伸出的接口 | X=；Y=；高= | 托臂间距、立板宽度、整体避让 |
| A2 | 隔离板左右宽、前后深、厚度；左右边缘各有多宽可承托，下面有没有器件挡住 | 宽=；深=；厚=；左可托宽=；右可托宽= | 承托滑块和限位块形状 |
| A3 | 镜头中心距隔离板左边、前边的距离；从隔离板下表面到镜头最下端的距离 | 距左=；距前=；下伸= | 对中位置、托臂伸出量及支架高度 |
| A4 | 镜头及其周围需要留空的最大直径；调焦时手是否能伸入；排线/插头在哪侧伸出 | 避让直径=；调焦空间=；插线侧= | 中央开口和线缆避让 |
| A5 | 整个板卡组件重量，厨房秤或可信规格均可，注明来源 | 重量= g；来源= | 托臂厚度、加强筋与连接尺寸 |
| B1 | 传送带放到平桌上，量最大长宽高，包括电机和突出的支脚；另量真正可用带面长宽 | 总长=；总宽=；总高=；带面长=；带面宽= | 底板尺寸及周边空间 |
| B2 | 从桌面到带面上表面的高度，入口/中部/出口各量一次 | 入口=；中部=；出口= | 托料板高度、检测平面高度 |
| B3 | 脚的接触位置、底部固定孔位置和孔径；无孔写无孔，并量可夹持部位 | 孔径=；孔距=；或可夹位置= | 固定孔或外侧压块，避免猜测钻机架 |
| C1 | 实际检测载带宽度、总厚度/穴底下凸高度、器件最高点；指出两侧可接触边及定位孔侧 | 宽=；厚/下凸=；件高=；可接触边= | 导向间隙、托料面、避让定位孔与元件 |
| D1 | 用最终镜头和实际视频模式，拍毫米尺与样品：清楚时镜头最下端到器件检测面的距离；画面能用的左右/前后范围；极性标记能否辨认 | 镜头=；模式=；距离=；有效视场=×；标记可辨= | 支架高度范围、是否能检测目标区域 |
| D2 | 在D1位置上下小范围试拍，记录仍能满足视场与清晰度的距离；记录灯下表面距检测面及反光情况 | 可用距离下限=；上限=；灯高=；反光= | 换孔范围、灯架行程；范围未知时先保持可调 |
| E1 | 环形灯实际外径、内孔、高度，安装孔位于哪个面，孔数/孔距/螺纹深度；电线出口 | 外径=；内孔=；高=；孔面=；孔位=；深=；出线= | 灯座和连接耳，M3螺钉长度 |
| E2 | 控制器实际长宽高、安装孔、旋钮及插头伸出方向 | 外形=；孔位=；插线空间= | 固定片、底板布置 |
| F1 | 可用木板实际厚度；打印店/打印机最大成型尺寸和材料；可用桌面长宽 | 板厚=；打印范围=；材料=；桌面= | 螺钉长度、拆件方式、整机外形 |

D1可以先用临时垫块稳固托住已有隔离板的两侧来测，镜头下方留空。记录镜头端面到样品检测面的距离，不要把PCB高度当成工作距离。暂时只有一只镜头，就先测这一只。

若方便，另给三张照片：最终折好组件的俯视、底面和侧面，各带尺子。照片帮助确认方向，不能替代孔距与厚度实测。不需要拆开相机或重新设计其内部固定。

## 2. 已有资料里的尺寸

| 现成件 | 目前能引用的尺寸 | 使用状态 |
|---|---|---|
| 传送带 | 文件名为长400、宽80 | 名义值，电机突出量、带高和孔位未提供 |
| 环形灯SJ-R9060-D40 | 商品图外径90、内孔40、高22；标4×M3深4及78圆 | 必须核实到货型号、孔所在面和78标注含义后再出灯座孔位 |
| 单路光源控制器 | 商品图74.5×103×39.5，另有安装宽88 | 核对型号，88不能直接当成完整安装孔坐标 |
| 16/25 mm镜头 | 本地资料最大宽14；高18.3/20；M12×0.5 | 外形参数不能替代镜头实际突出量和工作距离 |

## 3. 需要准备或购买的东西

不重复购买已有物品。此表为结构准备清单，不是电机驱动或整机电气BOM；电机电源、驱动、控制接口仍按项目电气验证处理。

| 物品 | 预计数量/做法 | 尺寸及下单条件 | 已有/未买 |
|---|---|---|---|
| 胶合板底板 | 1块 | 外形依B1、E2、桌面空间定；厚度先选可方便买到的规格，实测后建模 | |
| 胶合板立板 | 1块 | 宽依A1及两托臂位置；高依B2、C1、D1及A3 | |
| 木三角加强板 | 2块 | 和立板、底板一起定尺寸及连接孔 | |
| 入口、出口木托料板及支脚 | 托料面各1组 | 宽依C1，长度依实际悬空段，高依B2与载带下凸；不先固定100 mm | |
| 普通穿透螺栓、螺母、大垫片 | 按最终孔表统计 | 结构连接优先统一一种规格；M4可作设计候选，长度由夹持厚度＋垫片＋螺母决定，未冻结 | |
| 手拧螺母或旋钮 | 用于经常调整位置 | 与最终螺栓规格一致；不需要全部连接都用旋钮 | |
| 灯安装螺钉 | 依确认后的实际孔数 | 商品图标M3；长度须扣除支架及垫片厚度，伸入量不得超实际孔深 | |
| 薄软垫、扎带、粘式线夹 | 少量 | 用于隔离板接触面、线缆固定；不能靠软垫代替机械限位 | |
| 3D打印服务或材料 | 按下面零件清单 | 材料和工艺与打印店确认，承重件先试装再批量；不打印整块底板 | |
| 尺子；能借到则用卡尺和秤 | 各1 | 大外形用尺，小孔厚度用卡尺，组件重量用秤 | |

现成传送带、板卡相机、镜头、环形灯、控制器直接使用实物，不重新打印。M12锁圈若已有合适件不用买；要买时核实M12×0.5，不能仅凭“M12螺母”名称下单。

## 4. 需要3D建模/打印的零件和尺寸来源

| 零件 | 初步数量 | 最终图纸要标什么 | 依赖数据 |
|---|---|---|---|
| 左右承托臂（带根部加强） | 2件 | 总长宽高、根部安装孔、前后槽长宽、承重截面、加强筋 | A1—A5、B1、D1、木板厚度 |
| 隔离板承托滑块/限位块 | 暂4件 | 承托宽度、接触台阶、限位高度、锁紧孔；数量随可用支承区定 | A2、A3、A4 |
| 环形灯竖槽支架 | 2件 | 总高、底脚、竖槽宽长、固定孔及加强筋 | B2、C1、D2、E1 |
| 环形灯前后支臂/滑块 | 2组，能合并则合并 | 前后槽、滑块接触面、锁紧孔、灯连接孔及镜头避让 | A3、D2、E1 |
| 载带侧导向块 | 暂4件 | 导向间距、接触高度、入口倒角、固定槽；不压元件或遮定位孔 | B1、B2、C1 |
| 传送带外侧固定压块 | 仅无合适固定孔时制作 | 接触台阶、压紧孔、机架及运动部件避让 | B3 |
| 控制器固定片/线夹 | 能用现成件则不打印 | 外形、孔位、线槽 | E2 |

各零件外形与接口都依赖以上数据，当前不提供伪精确的最终长宽高。可先确定零件类型，数据齐全后在同一参数模型中出尺寸，避免HTML、采购表和三视图互相矛盾。

## 5. 怎样从实测值确定高度和位置

设Zt为检测面相对木底板上表面的高度，W为镜头端面到检测面的实测工作距离，P为镜头端面到隔离板下表面的实测上向距离，则隔离板承托面高度为：Zt＋W＋P。Zt包含传送带高度及实际载带/器件检测面的高度。承托垫片厚度应计入装配。

先定镜头轴在检测区的位置，再用A3反推隔离板位置，不能把板中心当镜头中心。环形灯按这条轴线对中，并检查整段可用视场是否被内孔挡住。灯高以实拍反光和亮度为准。换孔范围覆盖实际需要的工作距离范围，槽长只覆盖所需微调与装配余量。

承重件厚度还需用组件重量、悬臂长度和打印工艺检查，并通过试装观察晃动。尺寸齐全能冻结接口，但实际抗振、光照和送料效果仍需联调验证。

## 6. 数据齐后交付哪些图

1. 总装正视、俯视、右视及轴测图：总体尺寸、光轴、带面基准、调整范围和零件编号。
2. 每一种打印件单独三视图，必要时加剖视：长宽高、孔径孔距、槽长槽宽、壁厚、倒角及材料；给可编辑模型和打印文件。
3. 木板切割/钻孔图：板厚、外形、孔位，全部从统一边缘基准定位。
4. 最终采购表：每种螺钉的直径、长度、数量，垫片、螺母及现成件规格，并区分已有和新增。
5. 装配顺序及试装检查：左右同高、镜头与灯对中、调焦和插线可达、无碰撞、载带平直、启停不明显晃动。

现有结构三视图位于`机械结构展示/背面折叠支架_三视结构示意.svg`，仅可用于理解布局。上述实测数据尚未收到，因此本轮没有生成可加工的零件三视图或STL，也不应据现有示意尺寸购买定尺件。
