czp-1-A1/FPGA_Component_Inspector/开发实施/机械结构展示/机械装配_R2/打印准备_阶段2/木板下料清单.csv

编号 | 尺寸mm | 数量 | 备注
W01 | 650×400×12 | 1 | 结构孔10个；设备固定孔待定位
W02 | 300×360×12 | 1 | 相机40孔、灯导板4孔、角码6孔，共50孔
W03 | 直角边120/200，厚12 | 2 | 每件4个角码孔
W04 | 100×100×12 | 2 | 每件2个通孔及90度沉孔；左件旋转180度安装
W05 | 12×80×68（高度暂定） | 4 | 每件2孔；按实测带面改高度及上孔
