czp-1-A1/FPGA_Component_Inspector/开发实施/机械结构展示/机械装配_R2/打印准备_阶段2/紧固件清单_名义待实配.csv

规格 | 数量 | 备注
90°沉头 M4×20 | 4 | 名义尺寸；实购头部/有效螺纹核实
内六角圆柱头 M4×25 | 32 | 名义尺寸；实购头部/有效螺纹核实
内六角圆柱头 M4×30 | 8 | 名义尺寸；实购头部/有效螺纹核实
内六角圆柱头 M4×35 | 6 | 名义尺寸；实购头部/有效螺纹核实
内六角圆柱头 M4×45 | 4 | 名义尺寸；实购头部/有效螺纹核实
内六角圆柱头 M4×65 | 8 | 名义尺寸；实购头部/有效螺纹核实
外六角 M4×35 | 4 | 名义尺寸；实购头部/有效螺纹核实
M4螺母，AF7，模型厚3.2 | 66 | 普通螺母；防松措施试装后确定
M4平垫，内径4.5×外径9×厚0.8 | 128 | 托料板沉头顶面不加垫片
25×25×25×2 普通角码 | 18 | 现货孔位核实后再钻木板
20×20×8底部防滑垫 | 4 | 粘贴/固定方式待选型
