czp-1-A1/FPGA_Component_Inspector/开发实施/机械结构展示/机械装配_R2b/P08_询价_Q1/P08_Q1_紧固件及数量.csv

编号 | 名称 | 规格 | 数量 | 单位 | 状态 | 说明
P08 | 背孔连接板 | PETG；100%填充 | 2 | 件 | 询价；同款2件 | 主体上表面贴床，支脚向上；不增加独立试片
M3-S | 非沉头螺丝 | M3×12，建议内六角圆柱头 | 4 | 颗 | 暂选，首次装配核实 | 头部包络≤Ø5.5×3；头下长12±0.20为核验预算，不是实购物料公差已确认
M3-W | 平垫片 | OD7 / ID3.6 / 厚0.5 | 4 | 片 | 采购尺寸核实 | 厚0.50±0.05为核验预算；实际测量
M4-S | 外侧连接螺栓 | M4×30 | 4 | 颗 | 沿用，不重复采购 | 名义夹持厚18；螺母外露7.2
M4-N | 螺母 | M4；模型厚3.2 | 4 | 颗 | 沿用 | 实际规格核实
M4-W | 平垫片 | OD9 / ID4.5 / 厚0.8 | 8 | 片 | 沿用 | 每颗M4上下各一片
