czp-1-A1/FPGA_Component_Inspector/购物清单/24V光源控制器/aa68ab9984d40b1cfe8deec86199f549.jpg

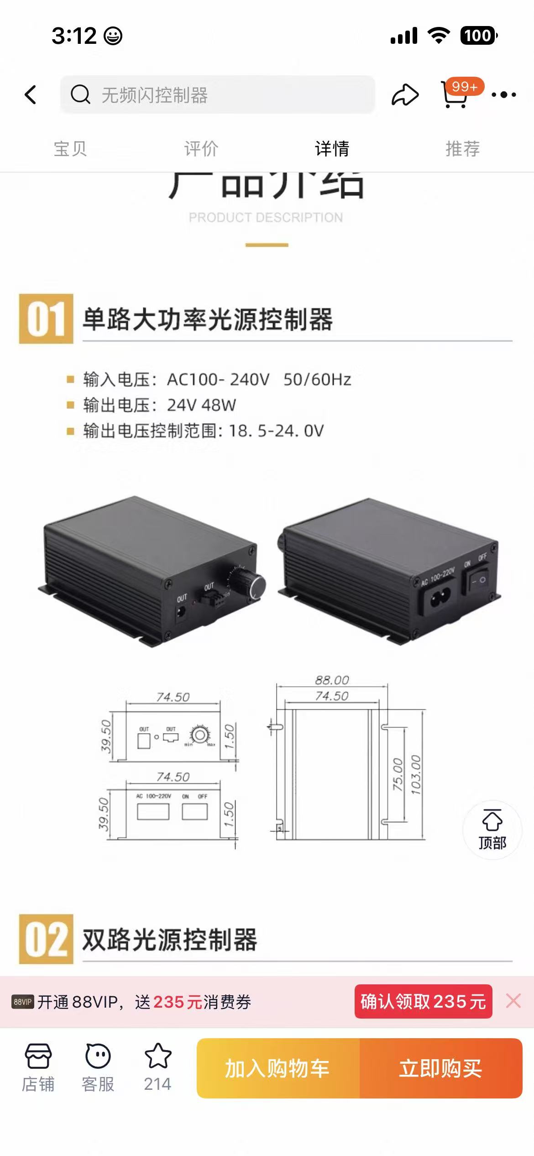
购物清单/24V光源控制器/aa68ab9984d40b1cfe8deec86199f549.jpg
