czp-1-A1/FPGA_Component_Inspector/购物清单/小型传送带/微信图片_20260907151045_1086_7.jpg

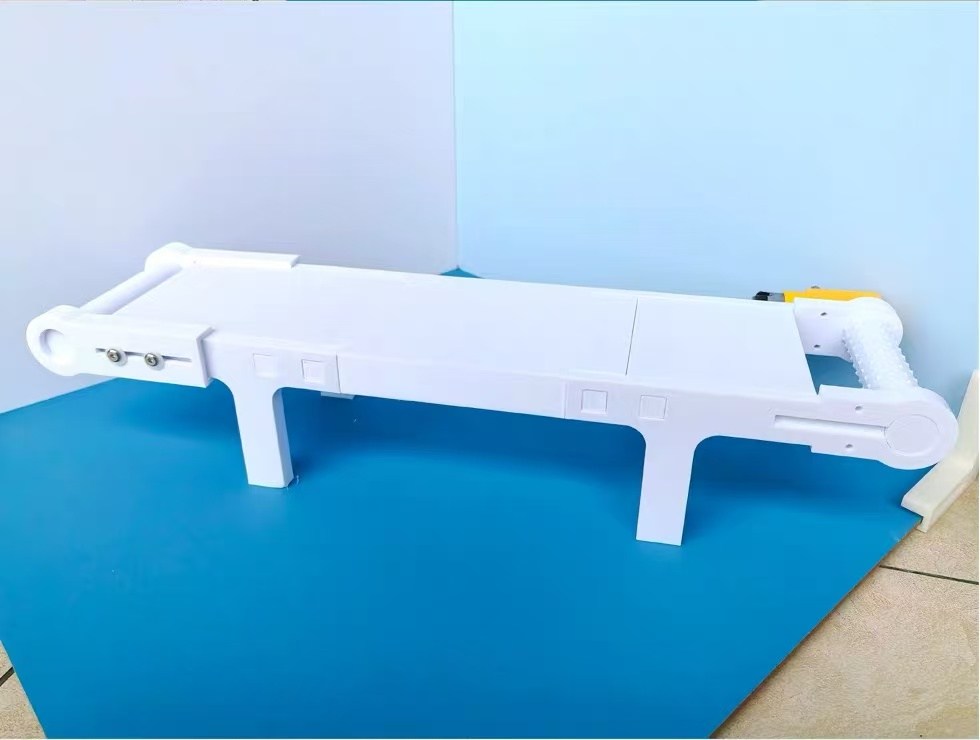
购物清单/小型传送带/微信图片_20260907151045_1086_7.jpg
