czp-1-A1/FPGA_Component_Inspector/购物清单/小型传送带/长40cm-宽8cm.jpg

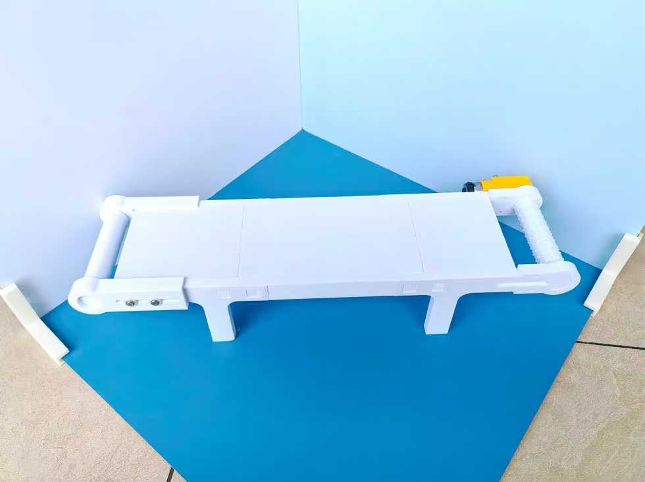
购物清单/小型传送带/长40cm-宽8cm.jpg
