czp-1-A1/FPGA_Component_Inspector/购物清单/机械视觉_60度环形光源_漫反射/微信图片_20260907151346_1089_7.jpg

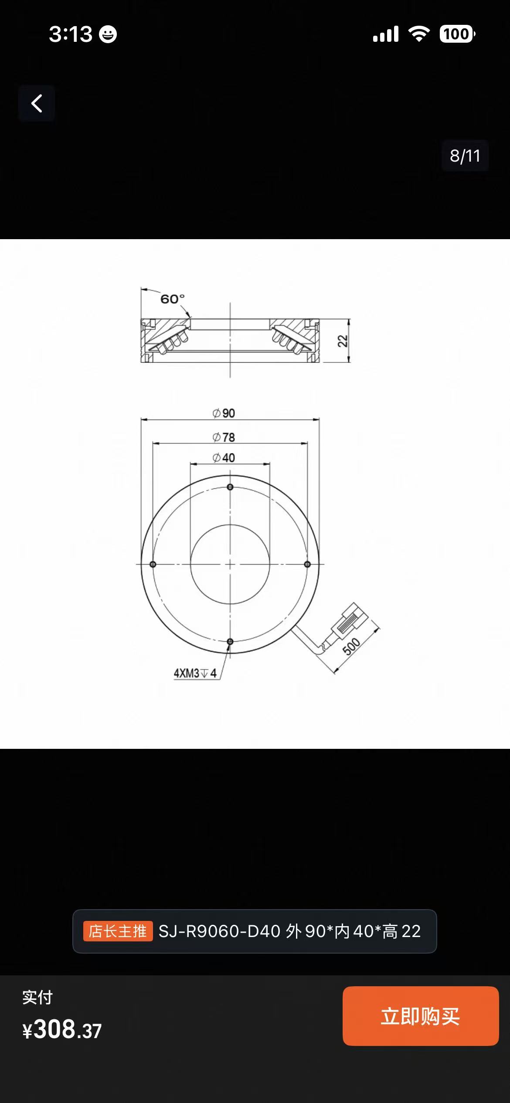
购物清单/机械视觉_60度环形光源_漫反射/微信图片_20260907151346_1089_7.jpg
