czp-1-A1/FPGA_Component_Inspector/购物清单/板子+摄像头/微信图片_20260907151759_1090_7.jpg

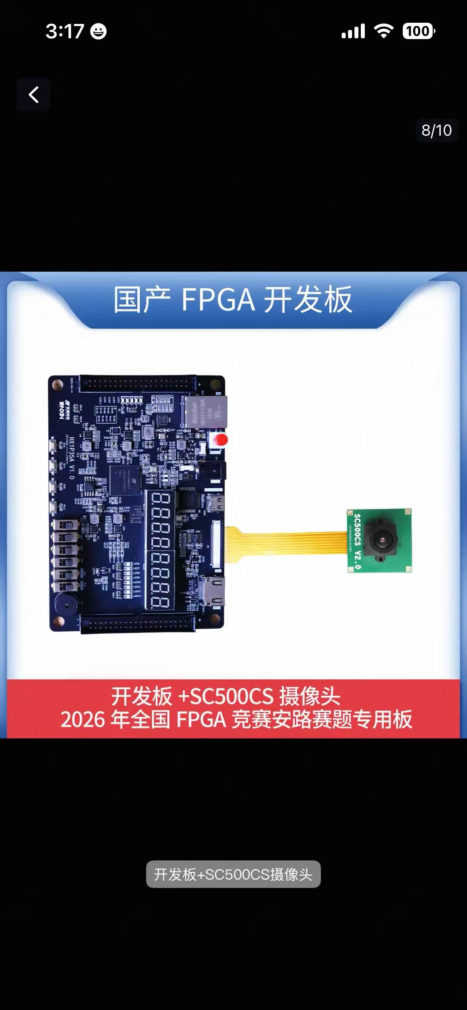
购物清单/板子+摄像头/微信图片_20260907151759_1090_7.jpg
