czp-1-A1/FPGA_Component_Inspector/开发实施/机械结构展示/机械装配_R2/FPGA_Inspector_R2_Assembly.step

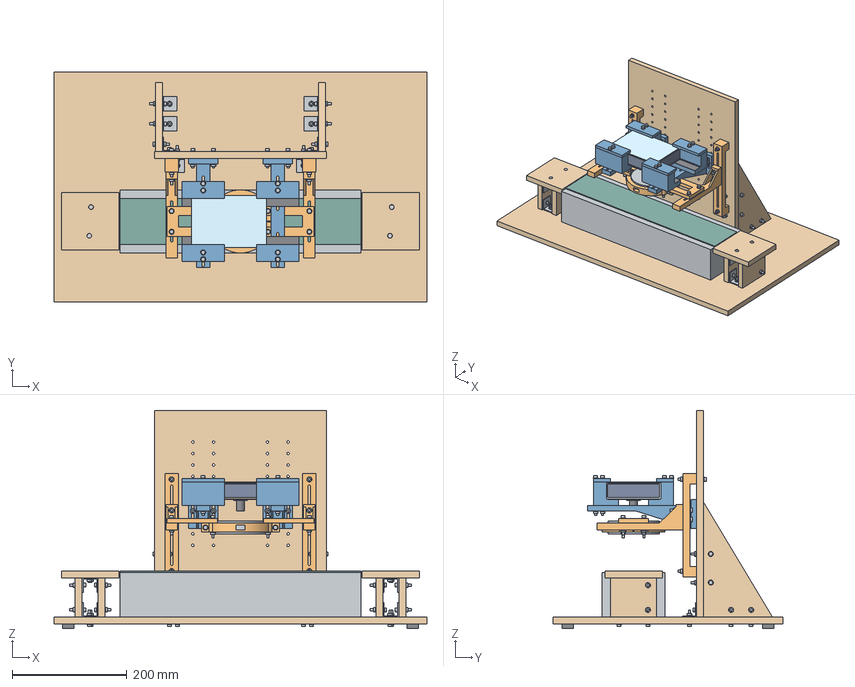
[picture p123: CAD file, 2026-09-30]
开发实施/机械结构展示/机械装配_R2/FPGA_Inspector_R2_Assembly.step
650.0 x 400.0 x 380.0 mm
