czp-1-A1/FPGA_Component_Inspector/开发实施/机械结构展示/机械装配_R2b/P08_询价_Q1/evidence/P08_native_assembly_coords.step

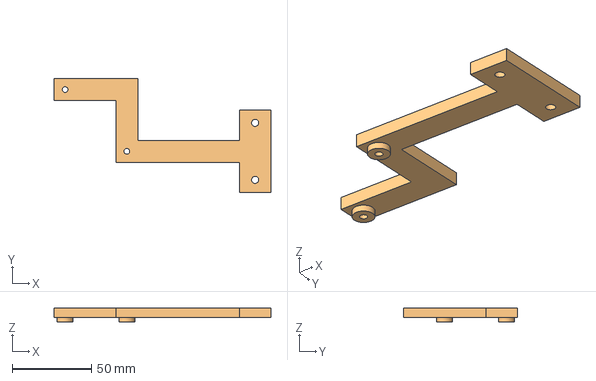
[picture p124: CAD file, 2026-09-30]
开发实施/机械结构展示/机械装配_R2b/P08_询价_Q1/evidence/P08_native_assembly_coords.step
137.0 x 72.0 x 9.00 mm
