czp-1-A1/FPGA_Component_Inspector/开发实施/机械结构展示/机械装配_R2/打印准备_阶段2/evidence/切片输入网格/P03_LB.stl

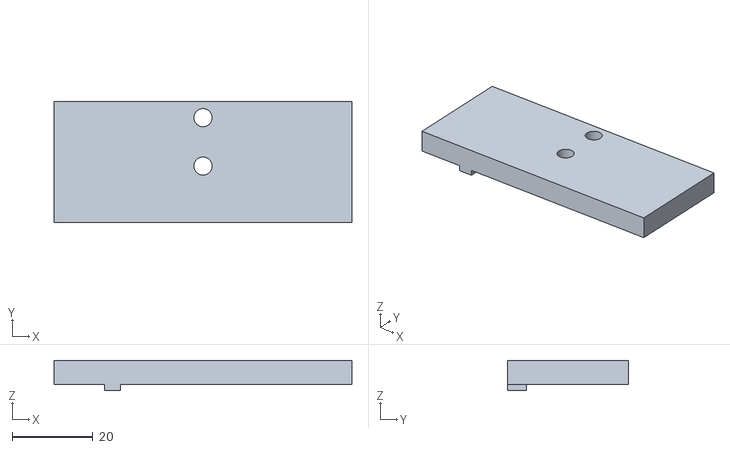
[picture p125: CAD file, 2026-09-30]
开发实施/机械结构展示/机械装配_R2/打印准备_阶段2/evidence/切片输入网格/P03_LB.stl
74.0 x 30.0 x 7.50
