czp-1-A1/FPGA_Component_Inspector/开发实施/机械结构展示/机械装配_R2/打印准备_阶段2/P01_R2a修订模型图纸及复核/零件STEP/P01.step

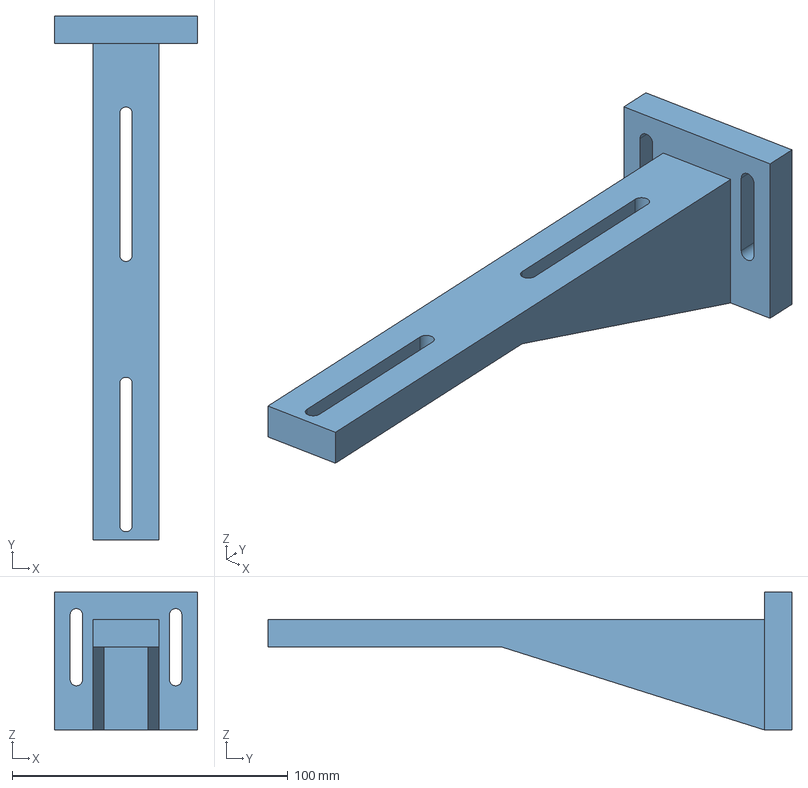
[picture p126: CAD file, 2026-09-30]
开发实施/机械结构展示/机械装配_R2/打印准备_阶段2/P01_R2a修订模型图纸及复核/零件STEP/P01.step
52.0 x 190.0 x 50.0 mm
