czp-1-A1/FPGA_Component_Inspector/开发实施/机械结构展示/机械装配_R2/打印准备_阶段2/小样STEP/HT01.step

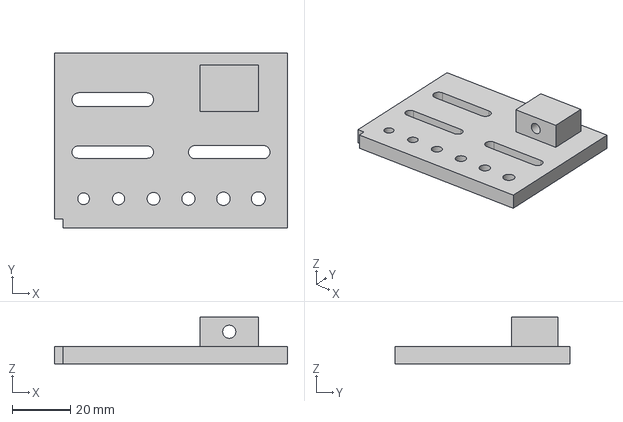
[picture p127: CAD file, 2026-09-30]
开发实施/机械结构展示/机械装配_R2/打印准备_阶段2/小样STEP/HT01.step
80.0 x 60.0 x 16.0 mm
