czp-1-A1/FPGA_Component_Inspector/开发实施/机械结构展示/机械装配_R2/打印准备_阶段2/小样原始网格/CT03.stl

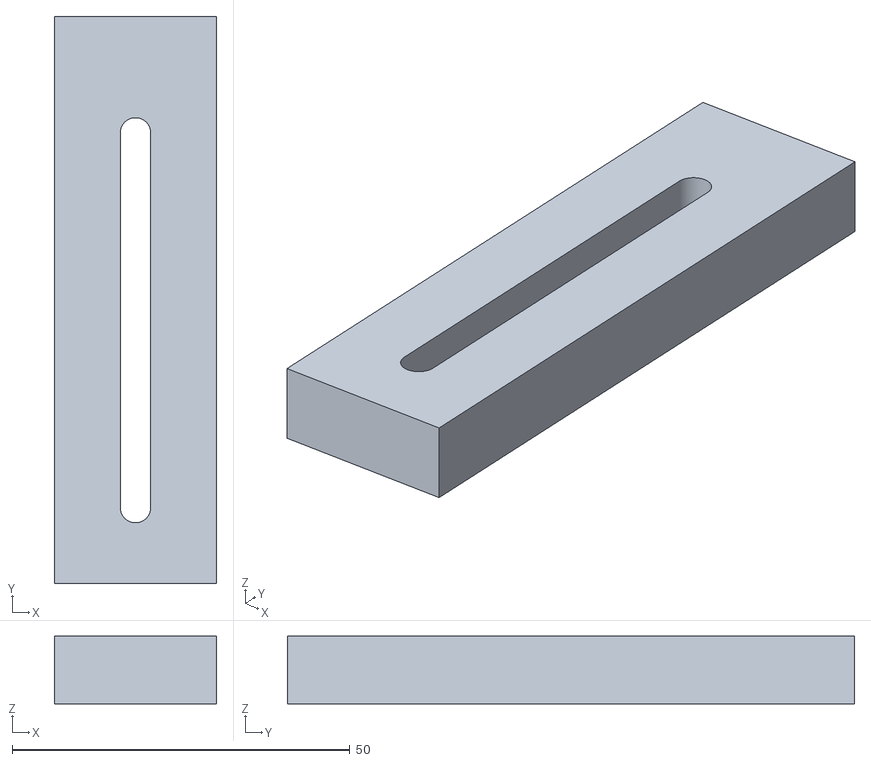
[picture p128: CAD file, 2026-09-30]
开发实施/机械结构展示/机械装配_R2/打印准备_阶段2/小样原始网格/CT03.stl
24.0 x 84.0 x 10.0
