czp-1-A1/FPGA_Component_Inspector/开发实施/机械结构展示/机械装配_R2/打印准备_阶段2/零件STEP/P06A.step

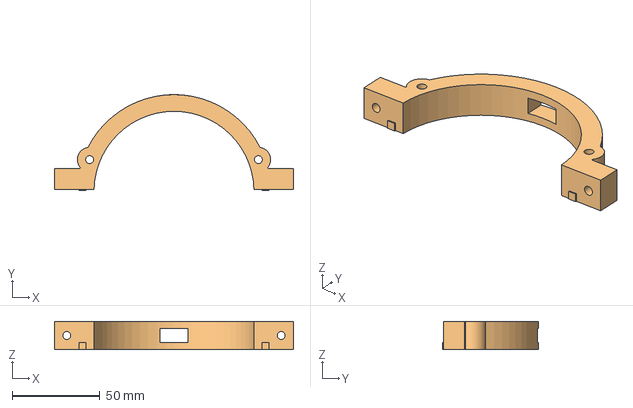
[picture p129: CAD file, 2026-09-30]
开发实施/机械结构展示/机械装配_R2/打印准备_阶段2/零件STEP/P06A.step
136.0 x 54.5 x 16.0 mm
