czp-1-A1/FPGA_Component_Inspector/开发实施/机械结构展示/零件工程图_R1/P01.step

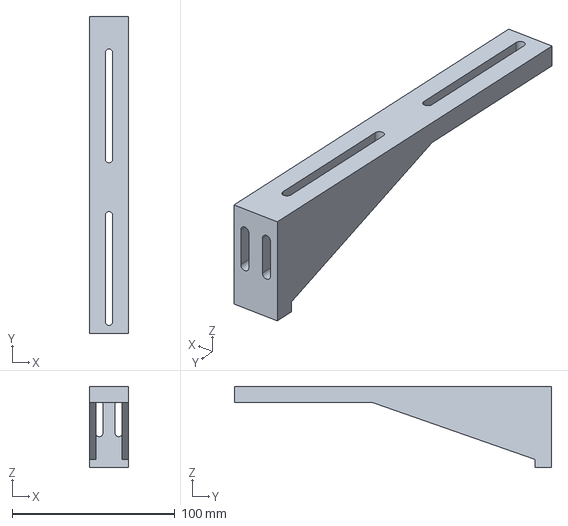
[picture p130: CAD file, 2026-09-09]
开发实施/机械结构展示/零件工程图_R1/P01.step
24.0 x 195.0 x 50.0 mm
