czp-1-A1/FPGA_Component_Inspector/开发实施/机械结构展示/机械装配_R2/打印准备_阶段2/evidence/切片输入网格/P07_L.stl

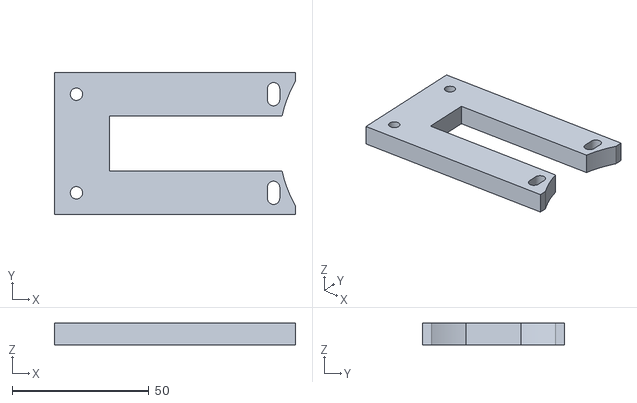
[picture p131: CAD file, 2026-09-30]
开发实施/机械结构展示/机械装配_R2/打印准备_阶段2/evidence/切片输入网格/P07_L.stl
88.0 x 52.0 x 8.00
