czp-1-A1/FPGA_Component_Inspector/开发实施/机械结构展示/机械装配_R2/打印准备_阶段2/小样STEP/CT01.step

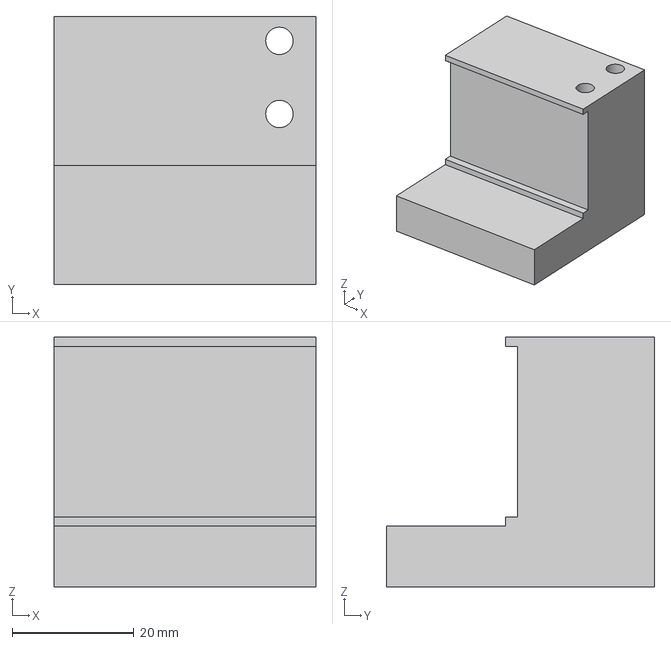
[picture p132: CAD file, 2026-09-30]
开发实施/机械结构展示/机械装配_R2/打印准备_阶段2/小样STEP/CT01.step
43.0 x 44.0 x 41.0 mm
