czp-1-A1/FPGA_Component_Inspector/开发实施/机械结构展示/机械装配_R2/打印准备_阶段2/零件STEP/S01.step

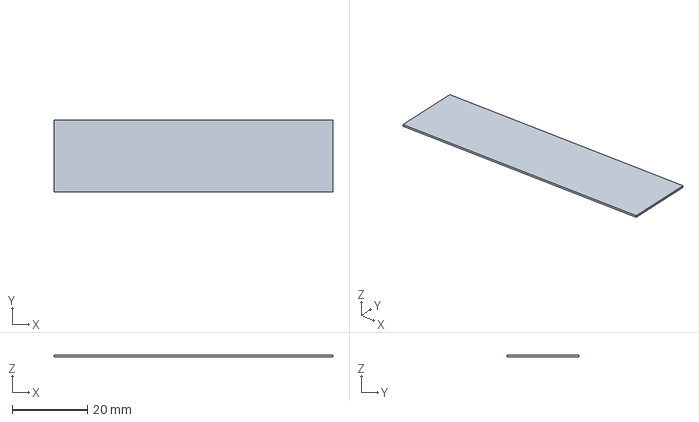
[picture p133: CAD file, 2026-09-30]
开发实施/机械结构展示/机械装配_R2/打印准备_阶段2/零件STEP/S01.step
74.0 x 19.0 x 0.5 mm
