czp-1-A1/FPGA_Component_Inspector/开发实施/机械结构展示/机械装配_R2c_合并布局/evidence/baseline_P04.step

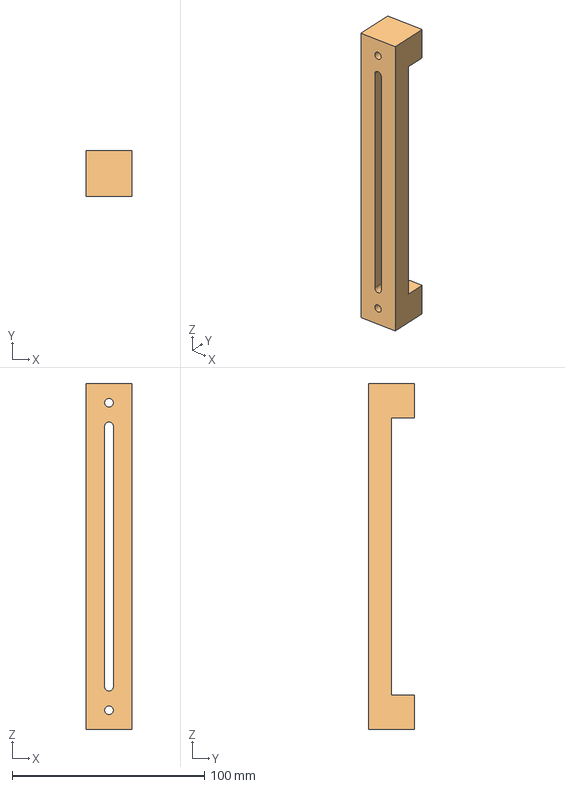
[picture p134: CAD file, 2026-09-30]
开发实施/机械结构展示/机械装配_R2c_合并布局/evidence/baseline_P04.step
24.0 x 24.0 x 180.0 mm
