czp-1-A1/FPGA_Component_Inspector/开发实施/机械结构展示/零件工程图_R1/P05.step

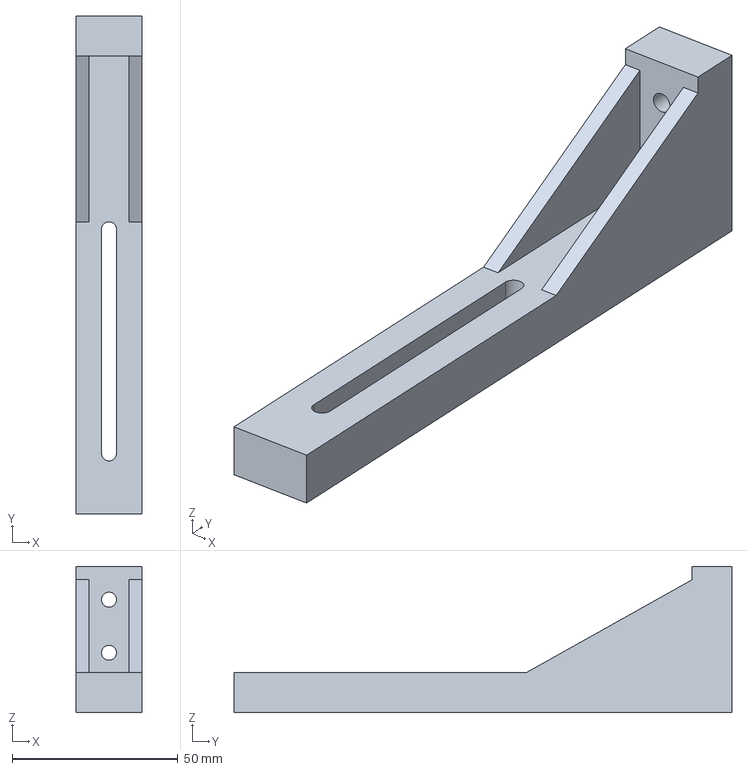
[picture p135: CAD file, 2026-09-09]
开发实施/机械结构展示/零件工程图_R1/P05.step
20.0 x 150.0 x 44.0 mm
