czp-1-A1/FPGA_Component_Inspector/开发实施/机械结构展示/机械装配_R2c_合并布局/evidence/baseline_P05.step

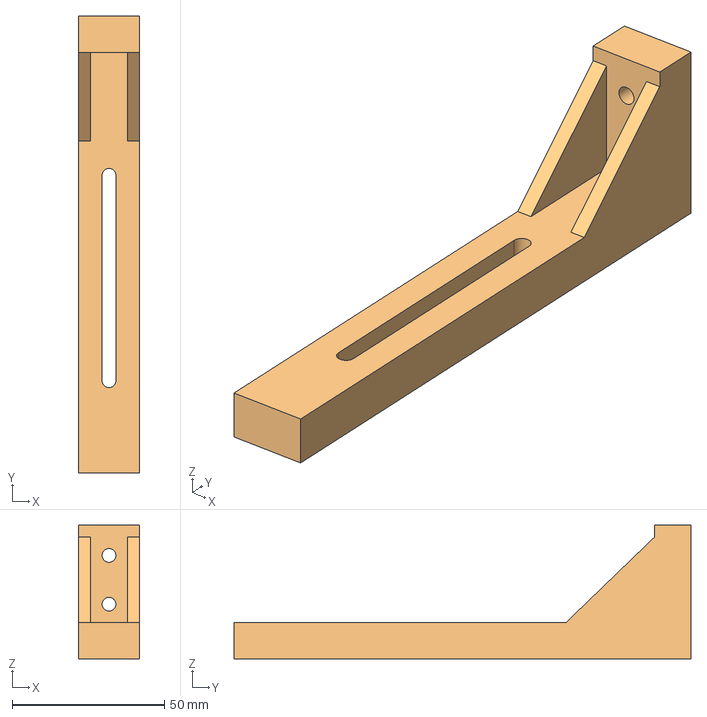
[picture p138: CAD file, 2026-09-30]
开发实施/机械结构展示/机械装配_R2c_合并布局/evidence/baseline_P05.step
20.0 x 150.0 x 44.0 mm
