czp-1-A1/FPGA_Component_Inspector/开发实施/机械结构展示/零件工程图_R1/P06B.step

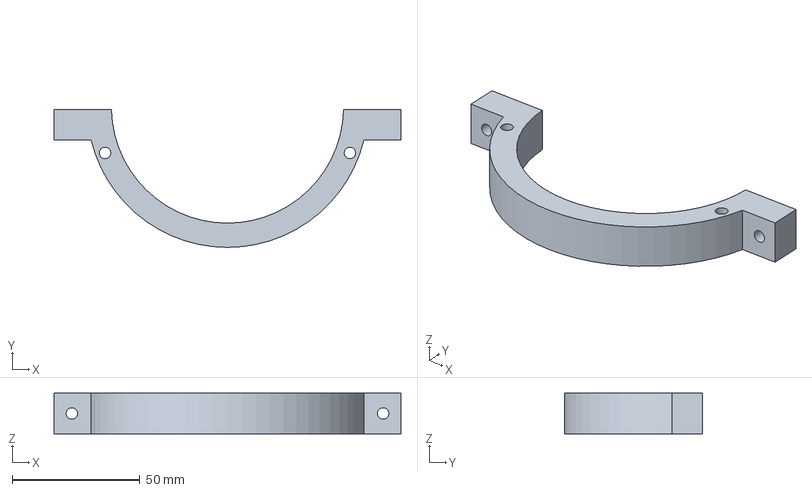
[picture p140: CAD file, 2026-09-09]
开发实施/机械结构展示/零件工程图_R1/P06B.step
136.0 x 54.0 x 16.0 mm
