czp-1-A1/FPGA_Component_Inspector/开发实施/机械结构展示/零件工程图_R1/P03.step

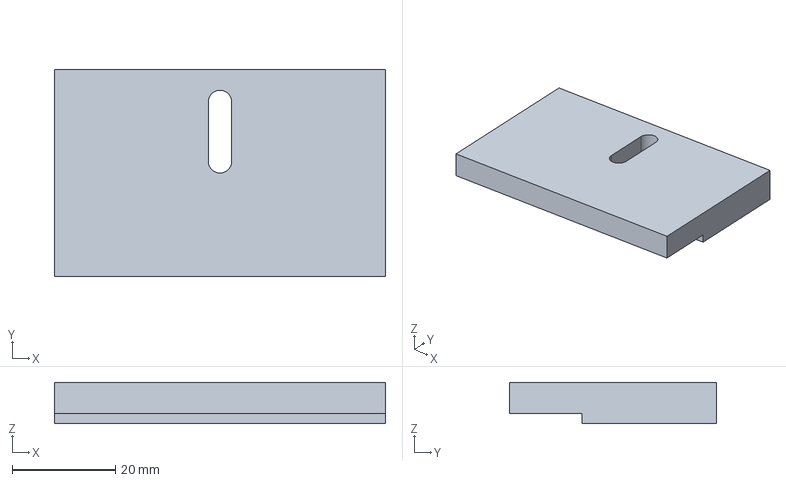
[picture p142: CAD file, 2026-09-09]
开发实施/机械结构展示/零件工程图_R1/P03.step
64.0 x 40.0 x 8.00 mm
