czp-1-A1/FPGA_Component_Inspector/开发实施/机械结构展示/机械装配_R2c_合并布局/evidence/baseline_P02.step

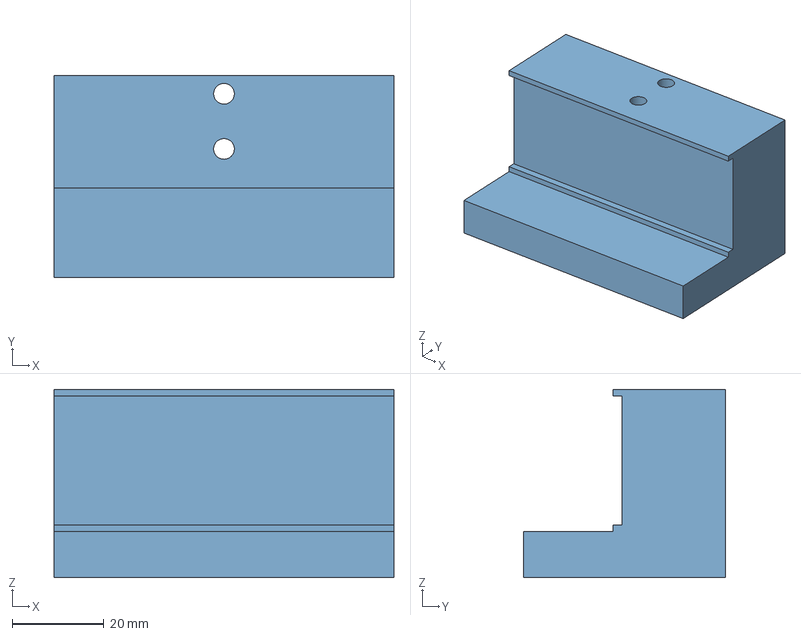
[picture p143: CAD file, 2026-09-30]
开发实施/机械结构展示/机械装配_R2c_合并布局/evidence/baseline_P02.step
74.0 x 44.0 x 41.0 mm
