czp-1-A1/FPGA_Component_Inspector/开发实施/机械结构展示/机械装配_R2/打印准备_阶段2/零件STEP/W02.step

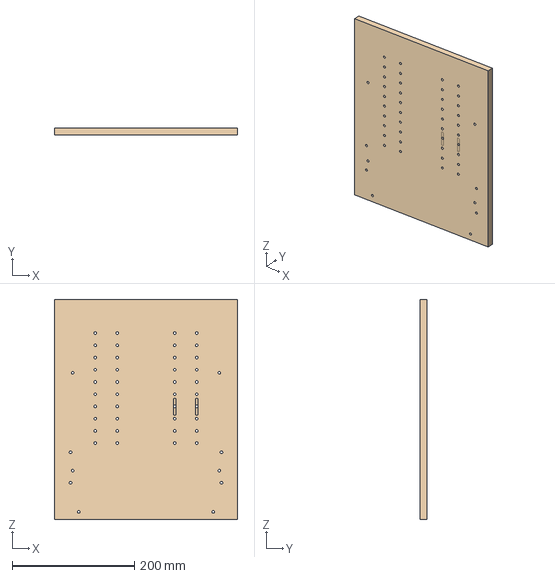
[picture p146: CAD file, 2026-09-30]
开发实施/机械结构展示/机械装配_R2/打印准备_阶段2/零件STEP/W02.step
300.0 x 12.0 x 360.0 mm
