czp-1-A1/FPGA_Component_Inspector/(list of files, cad)

Other CAD files:
开发实施/机械结构展示/机械装配_R2/打印准备_阶段2/P01_R2a修订模型图纸及复核/FPGA_Inspector_R2a_Assembly.step
开发实施/机械结构展示/机械装配_R2/打印准备_阶段2/P01修订_R2a/FPGA_Inspector_R2a_Assembly.step
开发实施/机械结构展示/机械装配_R2/打印准备_阶段2/evidence/打印方向网格/P03_RB.stl
开发实施/机械结构展示/机械装配_R2/打印准备_阶段2/P01修订_R2a/evidence/打印方向网格/P01.stl
开发实施/机械结构展示/机械装配_R2/打印准备_阶段2/首批小样_STL_毫米_已定向/CT03.stl
开发实施/机械结构展示/机械装配_R2b/P08_询价_Q1/P08_Q1_顶面贴床_支脚朝上_数量2.stl
开发实施/机械结构展示/机械装配_R2c_合并布局/evidence/baseline_P03_RB.step
开发实施/机械结构展示/机械装配_R2/打印准备_阶段2/evidence/打印方向网格/HT01.stl
开发实施/机械结构展示/机械装配_R2/打印准备_阶段2/小样原始网格/CT01.stl
开发实施/机械结构展示/机械装配_R2/打印准备_阶段2/首批小样_STL_毫米_已定向/CT01.stl
开发实施/机械结构展示/机械装配_R2b/P08_询价_Q1/evidence/P08_unoriented.stl
开发实施/机械结构展示/机械装配_R2b/P08_询价_Q1/P08_Q1.step
开发实施/机械结构展示/机械装配_R2/打印准备_阶段2/evidence/切片输入网格/P06B.stl
开发实施/机械结构展示/机械装配_R2/打印准备_阶段2/evidence/打印方向网格/P06A.stl
开发实施/机械结构展示/机械装配_R2/打印准备_阶段2/小样原始网格/HT01.stl
开发实施/机械结构展示/机械装配_R2/打印准备_阶段2/零件STEP/P07_L.step
开发实施/机械结构展示/机械装配_R2/打印准备_阶段2/首批小样_STL_毫米_已定向/P06B.stl
开发实施/机械结构展示/机械装配_R2c_合并布局/evidence/baseline_P03_LF.step
开发实施/机械结构展示/机械装配_R2/打印准备_阶段2/evidence/切片输入网格/P03_RF.stl
开发实施/机械结构展示/机械装配_R2/打印准备_阶段2/evidence/打印方向网格/P07_R.stl
开发实施/机械结构展示/机械装配_R2/打印准备_阶段2/小样STEP/CT03.step
开发实施/机械结构展示/机械装配_R2/打印准备_阶段2/小样原始网格/CT02.stl
开发实施/机械结构展示/机械装配_R2/打印准备_阶段2/零件STEP/P03_RB.step
开发实施/机械结构展示/机械装配_R2/打印准备_阶段2/首批小样_STL_毫米_已定向/CT02.stl
开发实施/机械结构展示/机械装配_R2/打印准备_阶段2/evidence/切片输入网格/P03_RB.stl
开发实施/机械结构展示/机械装配_R2/打印准备_阶段2/evidence/打印方向网格/P05.stl
开发实施/机械结构展示/机械装配_R2/打印准备_阶段2/零件STEP/P05.step
开发实施/机械结构展示/机械装配_R2/打印准备_阶段2/首批小样_STL_毫米_已定向/P06A.stl
开发实施/机械结构展示/机械装配_R2c_合并布局/evidence/baseline_P08.step
开发实施/机械结构展示/机械装配_R2/打印准备_阶段2/evidence/切片输入网格/P06A.stl
开发实施/机械结构展示/机械装配_R2/打印准备_阶段2/evidence/打印方向网格/P03_LB.stl
开发实施/机械结构展示/机械装配_R2/打印准备_阶段2/首批小样_STL_毫米_已定向/HT01.stl
开发实施/机械结构展示/机械装配_R2c_合并布局/evidence/baseline_P03_LB.step
开发实施/机械结构展示/机械装配_R2/打印准备_阶段2/evidence/切片输入网格/P05.stl
开发实施/机械结构展示/机械装配_R2/打印准备_阶段2/evidence/打印方向网格/P01.stl
开发实施/机械结构展示/机械装配_R2/打印准备_阶段2/零件STEP/P03_LB.step
开发实施/机械结构展示/机械装配_R2/打印准备_阶段2/evidence/切片输入网格/P07_R.stl
开发实施/机械结构展示/机械装配_R2/打印准备_阶段2/evidence/打印方向网格/P07_L.stl
开发实施/机械结构展示/机械装配_R2/打印准备_阶段2/零件STEP/P03_RF.step
开发实施/机械结构展示/机械装配_R2c_合并布局/evidence/baseline_P01.step
开发实施/机械结构展示/零件工程图_R1/P06A.step
开发实施/机械结构展示/机械装配_R2/打印准备_阶段2/evidence/切片输入网格/P03_LF.stl
开发实施/机械结构展示/机械装配_R2/打印准备_阶段2/evidence/打印方向网格/CT02.stl
开发实施/机械结构展示/机械装配_R2/打印准备_阶段2/零件STEP/P04.step
开发实施/机械结构展示/机械装配_R2c_合并布局/evidence/baseline_P03_RF.step
开发实施/机械结构展示/机械装配_R2/打印准备_阶段2/evidence/打印方向网格/CT03.stl
开发实施/机械结构展示/机械装配_R2/打印准备_阶段2/零件STEP/P02.step
开发实施/机械结构展示/机械装配_R2/打印准备_阶段2/evidence/打印方向网格/P06B.stl
开发实施/机械结构展示/机械装配_R2/打印准备_阶段2/零件STEP/P06B.step
开发实施/机械结构展示/机械装配_R2/打印准备_阶段2/evidence/打印方向网格/P03_LF.stl
开发实施/机械结构展示/机械装配_R2/打印准备_阶段2/evidence/打印方向网格/P03_RF.stl
开发实施/机械结构展示/机械装配_R2/打印准备_阶段2/零件STEP/P07_R.step
开发实施/机械结构展示/机械装配_R2/打印准备_阶段2/evidence/打印方向网格/CT01.stl
开发实施/机械结构展示/机械装配_R2/打印准备_阶段2/零件STEP/P03_LF.step
开发实施/机械结构展示/机械装配_R2/打印准备_阶段2/evidence/打印方向网格/P02.stl
开发实施/机械结构展示/机械装配_R2/打印准备_阶段2/零件STEP/P01.step
开发实施/机械结构展示/机械装配_R2/打印准备_阶段2/evidence/打印方向网格/P04.stl
开发实施/机械结构展示/机械装配_R2/打印准备_阶段2/零件STEP/S03A.step
开发实施/机械结构展示/机械装配_R2/FPGA_Inspector_R2_Prototype.f3d
开发实施/机械结构展示/机械装配_R2/evidence/R2_working_checkpoint.f3d
开发实施/机械结构展示/机械装配_R2/打印准备_阶段2/P01_R2a修订模型图纸及复核/FPGA_Inspector_R2a_Parametric.f3d
开发实施/机械结构展示/机械装配_R2/打印准备_阶段2/P01修订_R2a/FPGA_Inspector_R2a_Parametric.f3d
开发实施/机械结构展示/机械装配_R2/打印准备_阶段2/R2_关键配合小样.f3d
开发实施/机械结构展示/机械装配_R2/打印准备_阶段2/首件HT01_仅此件试打准备/HT01.stl
开发实施/机械结构展示/机械装配_R2b/FPGA_Inspector_R2b_Parametric.f3d
