czp-1-A1/FPGA_Component_Inspector/开发实施/机械结构展示/机械装配_R2b/00_最新状态_布局已认可_接口待确认.md

# R2b 最新状态：P08 Q1 询价文件已完成

本文件优先于旧记录中的“布局待确认”“接口待确认”和“M3长度待定”。旧R2、R2a、R2b模型及评审包均保留，R2b原生文件哈希未变。

- 布局已认可。四个Ø10支脚落点按用户确认可贴平处理。
- 孔深4mm仅作为图纸设计输入，不表述为厂家确认4mm全深可用。
- 暂选4颗M3×12非沉头螺丝，配0.5mm平垫片；CAD安装厚9mm，名义拧入2.5mm。
- 询价核验预算：A=9±0.20、L=12±0.20、w=0.50±0.05，拧入2.05～2.95mm。公差待供方确认/实测，不是制造精度已验证。
- STEP、已定向STL、3页工程图、紧固件清单、首次装配表及询价包位于P08_询价_Q1。
- P08同款2件，PETG，100%填充，M3通孔Ø3.6。无独立试片，不下发订单，不交付机器G-code。
- 维护步骤仍为D120/H60、Y0；前送入+5mm后落座，装M4，再恢复工作姿态。原行程限制继续有效。
- 承载、温升、实物互换、螺纹啮合与固定可靠性保持首次装配待验证。实际打印厚度尚未测量；禁止扩大灯壳螺纹孔。
- HT02取消，旧P06试打暂停，CT01/02/03原计划不变。
