czp-1-A1/FPGA_Component_Inspector/开发实施/机械结构展示/机械装配_R2c_合并布局/00_当前状态_仅条件询价.md

# R2c：条件布局及询价，禁止直接制造

PETG、100%填充为默认要求；25%仅作可选成本比较。
未测参数须由实测补齐，条件模型不能直接放行打印。
尚未下单的CT01/02/03暂停；旧P06试打保持暂停，HT02取消。
不增加独立打印试片，不下发订单。旧R2/R2a/R2b与P08 Q1文件保留。
首侧正式件先配简单板材/垫块模拟件；真实板卡须有稳定等高的另一侧支承。
P08沿用Q1：4颗M3x12为暂选，名义拧入2.5mm；4mm仅图纸孔深，不代表全深可用。
最终是否采用R2c取决于实际报价、装配便利和返工成本，不仅看件数。
