czp-1-A1/FPGA_Component_Inspector/开发实施/机械结构展示/机械装配_R2b/P08_询价_Q1/00_询价说明_不下单.md

# P08 Q1 询价文件说明

用途：供询价和工艺评估，不是打印订单；未发送给任何供方或打印机。R2b、R2a、R2原模型保留不变。此次P08实体形状未改，仅从R2b原生参数化实体导出单件制造文件。

## 文件与数量
- P08_Q1.step：单一有效实体，灯心X/Y坐标保留；支脚接触面Z=0，主体底Z=3、顶Z=9。
- P08_Q1_顶面贴床_支脚朝上_数量2.stl：一个零件，单位按mm导入，打印数量2；不要当作已包含两个零件，也不要缩放。
- P08_Q1_工程图及紧固件.pdf：3张A3页，单件三视图、孔位/实体坐标与剖视、紧固件及公差预算；已逐页渲染检查。
- P08_Q1_紧固件及数量.csv：两件P08所需数量，明确新选M3与沿用M4。
- P08_Q1_首次装配记录.csv：保留未验证项目；不增加HT02或其他独立试片。

## 制作与切片
P08同款2件，PETG，100%填充，M3通孔名义Ø3.6。主体大平面贴床、支脚向上，无支撑；估算采用0.4mm喷嘴、0.2mm层高、4壁、100%直线填充、3mm裙边。单件含裙边143×78×9mm，可放入200×200×200mm空间。使用一次两件排布时仍需供方检查实际间距、裙边和热床范围。

离线PrusaSlicer估算：25.32g/件（含裙边），约2h03m/件；两件约50.64g，顺序打印约4h06m。实际材料、机器、速度、排布会改变报价。100%填充不等于无孔隙或强度已经验证。未交付机器G-code。

网格检查：封闭、单一连通实体，3084三角面；STL包络137×72×9mm；原生与STEP体积一致，STL体积差约0.00021%。已定向网格没有高于床面的向下悬空平面，离线无支撑切片成功。未将切片成功当作实际打印验收。

## M3×12复核
四个Ø10支脚落点按用户确认可贴平处理。灯图纸孔深4mm仅是设计输入，不表述为厂家确认4mm全深可用。

CAD总安装厚A=主体6+支脚3=9mm。配0.5mm平垫片，4颗M3×12非沉头螺丝，名义e=12-9-0.5=2.5mm。

为询价和首次核验拟定：A=9±0.20mm、螺丝头下L=12±0.20mm、垫片w=0.50±0.05mm。得e_min=11.8-9.2-0.55=2.05mm；e_max=12.2-8.8-0.45=2.95mm。相对理想4mm深度的最小剩余量=1.05mm。以上公差须供方确认或实测，不是现成物料标准公差的引用；实际厚度现在没有测量值。

主体6±0.15、支脚3±0.15，同时总厚9±0.20需直接控制；不能把两个分项极限简单叠加到±0.30后仍引用上述结果。供方若不能达到，请在报价标明，不自行变更尺寸。

图纸孔深不提供有效完整螺纹长度，也不说明孔底几何。1.05mm仅是相对图示理想孔底的几何预算，不能据此保证不顶底。首次装配记录A、L、w、有效孔深与实际啮合，先手拧排除顶底，再检查固定可靠性；不以增大扭矩试探。若不足，暂停紧固并复核螺丝/垫片方案，不扩大灯壳螺纹孔。四处均需检查。

暂按非沉头内六角圆柱头包络≤Ø5.5×3选择，配OD7/ID3.6平垫片；供方须确认实物头部尺寸。螺丝12mm从头下承压面起算，不含头高。头部外形沿用已检查包络，伸入灯壳的杆段按上述预算新增，真实牙型/啮合可靠性未模拟。

## 继续保留的限制
沿用R2b报告有效行程：建议D50～200、H10～92且D≥H+40；H<16时Y≥-13，H≥16时前后槽±14.75，检测对中Y=0。没有扩大使用窗口。

维护固定为D120/H60、Y0：台面装好灯与P08，外侧M4暂不装；灯组件抬高5mm从前方送入后落座，再装M4，随后恢复工作姿态。默认D100下不得强行抬高送入。

首次装配仍须验证：M3孔试穿、实际螺纹啮合、固定可靠性、承载/挠曲/蠕变/松动、工作温升、实物180°互换、线缆及光学。必要时允许轻修PETG通孔并记录，禁止扩大灯壳螺纹孔。HT01的M4结果不作为M3验证；无独立试片费用。
