czp-1-A1/FPGA_Component_Inspector/开发实施/机械结构展示/机械装配_R2/打印准备_阶段2/逐件工程图_试制/HT01.pdf

# HT01 孔槽及横孔试片

## 数量 1 材料 PETG / 待试制

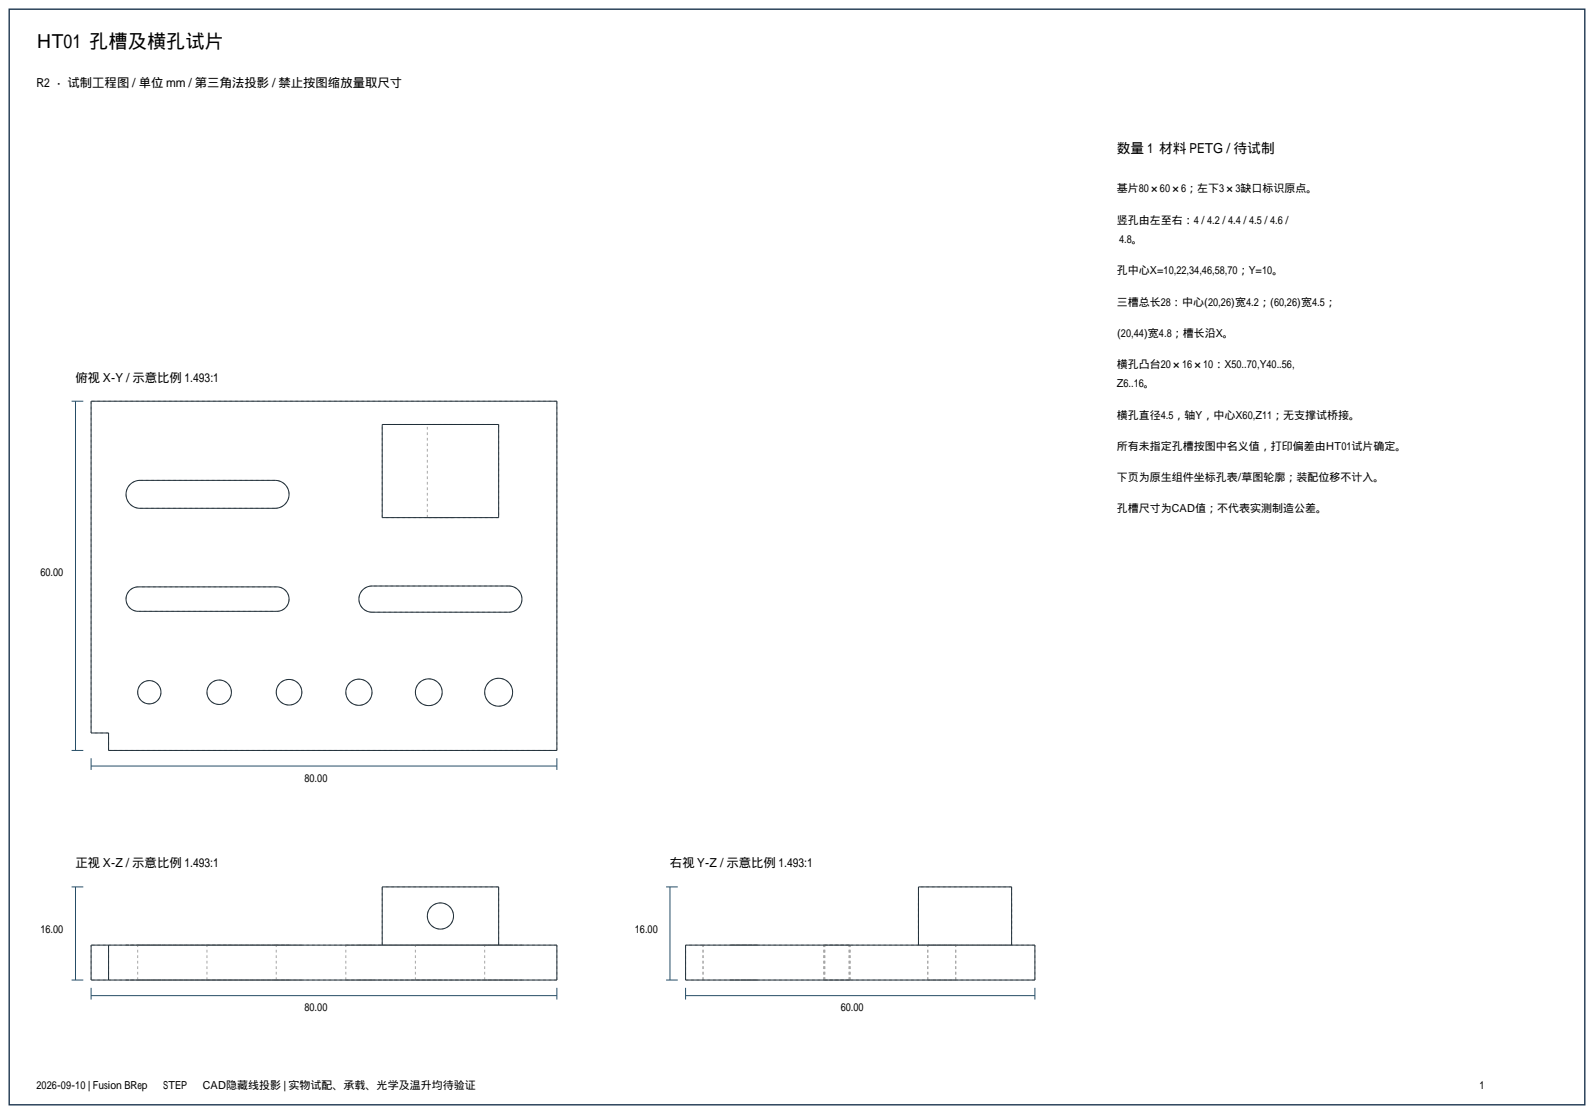
[picture p160: page 1]
俯视 X-Y / 示意比例 1.493:1; 正视 X-Z / 示意比例 1.493:1; 右视 Y-Z / 示意比例 1.493:1; 基片80×60×6；左下3×3缺口标识原点。; 竖孔由左至右：4 / 4.2 / 4.4 / 4.5 / 4.6 /; 孔中心X=10,22,34,46,58,70；Y=10。; 三槽总长28：中心(20,26)宽4.2；(60,26)宽4.5；; (20,44)宽4.8；槽长沿X。; 横孔凸台20×16×10：X50..70,Y40..56,; 横孔直径4.5，轴Y，中心X60,Z11；无支撑试桥接。; 所有未指定孔槽按图中名义值，打印偏差由HT01试片确定。; 孔槽尺寸为CAD值；不代表实测制造公差。

R2 · 试制工程图 / 单位 mm / 第三角法投影 / 禁止按图缩放量取尺寸

下页为原生组件坐标孔表/草图轮廓；装配位移不计入。

2026-09-10 | Fusion BRep → STEP → CAD隐藏线投影 | 实物试配、承载、光学及温升均待验证

### R2 · 试制工程图 / 单位 mm / 第三角法投影 / 禁止按图缩放量取尺寸

### 原生草图坐标说明：X 沿输送，Y 向后，Z 向上。圆为孔或圆轮廓；关联用途见特征名。

Base_sketch [原生草图已约束]

轮廓顶点 (0.0, 0.0, 0.0) | 轮廓顶点 (0.0, 60.0, 0.0)
轮廓顶点 (80.0, 0.0, 0.0) | 轮廓顶点 (80.0, 60.0, 0.0)

Vertical_4_1_sketch [原生草图已约束]

圆直径 4.000; 中心 (10.000, 10.000, -1.000)

Vertical_4.2_1_sketch [原生草图已约束]

圆直径 4.200; 中心 (22.000, 10.000, -1.000)

Vertical_4.4_1_sketch [原生草图已约束]

圆直径 4.400; 中心 (34.000, 10.000, -1.000)

Vertical_4.5_1_sketch [原生草图已约束]

圆直径 4.500; 中心 (46.000, 10.000, -1.000)

Vertical_4.6_1_sketch [原生草图已约束]

圆直径 4.600; 中心 (58.000, 10.000, -1.000)

Vertical_4.8_1_sketch [原生草图已约束]

圆直径 4.800; 中心 (70.000, 10.000, -1.000)

Slot_4.2_0_sketch [原生草图已约束]

轮廓顶点 (8.1, 23.9, -1.0) | 轮廓顶点 (8.1, 28.1, -1.0)
轮廓顶点 (31.9, 23.9, -1.0) | 轮廓顶点 (31.9, 28.1, -1.0)

Slot_4.2_0_ends_1_sketch [原生草图已约束]

圆直径 4.200; 中心 (8.100, 26.000, -1.000)

Slot_4.2_0_ends_2_sketch [原生草图已约束]

圆直径 4.200; 中心 (31.900, 26.000, -1.000)

Slot_4.5_0_sketch [原生草图已约束]

轮廓顶点 (48.25, 23.75, -1.0) | 轮廓顶点 (48.25, 28.25, -1.0)
轮廓顶点 (71.75, 23.75, -1.0) | 轮廓顶点 (71.75, 28.25, -1.0)

Slot_4.5_0_ends_1_sketch [原生草图已约束]

圆直径 4.500; 中心 (48.250, 26.000, -1.000)

Slot_4.5_0_ends_2_sketch [原生草图已约束]

圆直径 4.500; 中心 (71.750, 26.000, -1.000)

### R2 · 试制工程图 / 单位 mm / 第三角法投影 / 禁止按图缩放量取尺寸

Slot_4.8_0_sketch [原生草图已约束]

轮廓顶点 (8.4, 41.6, -1.0) | 轮廓顶点 (8.4, 46.4, -1.0)
轮廓顶点 (31.6, 41.6, -1.0) | 轮廓顶点 (31.6, 46.4, -1.0)

Slot_4.8_0_ends_1_sketch [原生草图已约束]

圆直径 4.800; 中心 (8.400, 44.000, -1.000)

Slot_4.8_0_ends_2_sketch [原生草图已约束]

圆直径 4.800; 中心 (31.600, 44.000, -1.000)

Horizontal_hole_boss_sketch [原生草图已约束]

轮廓顶点 (50.0, 40.0, 6.0) | 轮廓顶点 (50.0, 56.0, 6.0)
轮廓顶点 (70.0, 40.0, 6.0) | 轮廓顶点 (70.0, 56.0, 6.0)

Horizontal_M4_1_sketch [原生草图已约束]

圆直径 4.500; 中心 (60.000, 39.000, 11.000)

Origin_notch_sketch [原生草图已约束]

轮廓顶点 (0.0, 0.0, -1.0) | 轮廓顶点 (0.0, 3.0, -1.0)
轮廓顶点 (3.0, 0.0, -1.0) | 轮廓顶点 (3.0, 3.0, -1.0)
