czp-1-A1/FPGA_Component_Inspector/开发实施/机械结构展示/机械装配_R2/打印准备_阶段2/逐件工程图_试制/W02.pdf

# W02 后立板_300x360x12

## 数量 1 材料 12 mm胶合板

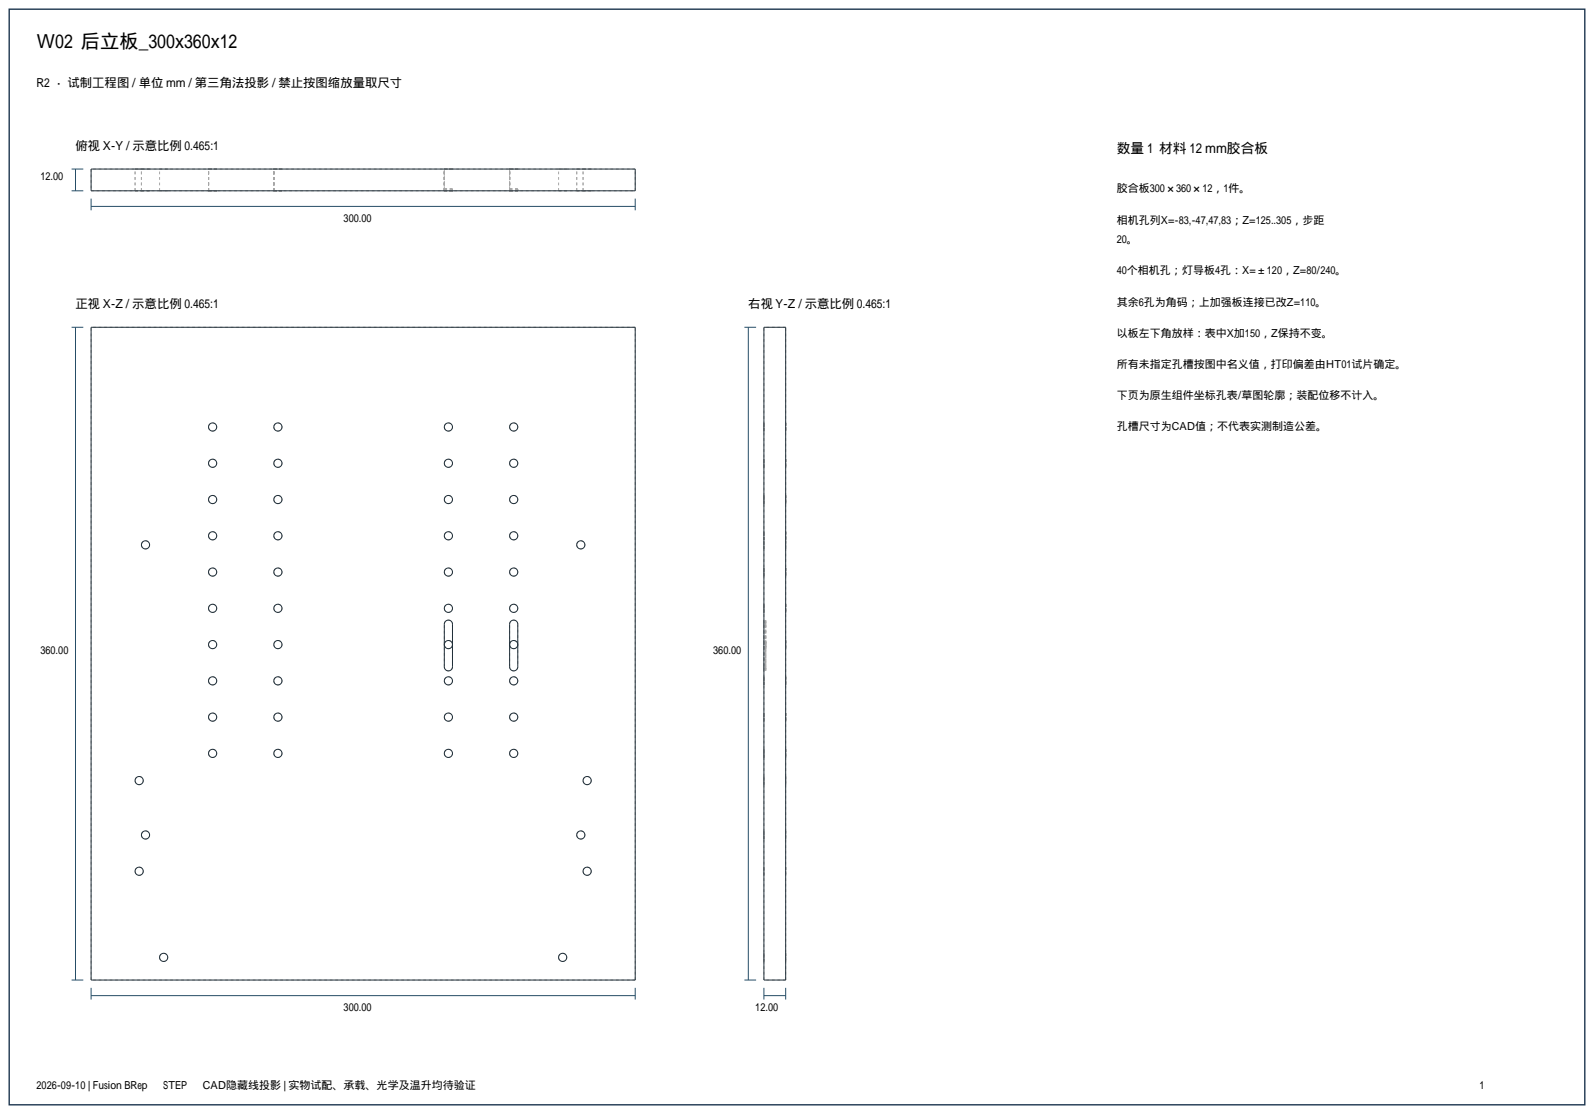
[picture p161: page 1]
俯视 X-Y / 示意比例 0.465:1; 正视 X-Z / 示意比例 0.465:1; 右视 Y-Z / 示意比例 0.465:1; 胶合板300×360×12，1件。; 相机孔列X=-83,-47,47,83；Z=125..305，步距; 40个相机孔；灯导板4孔：X=±120，Z=80/240。; 其余6孔为角码；上加强板连接已改Z=110。; 以板左下角放样：表中X加150，Z保持不变。; 所有未指定孔槽按图中名义值，打印偏差由HT01试片确定。; 孔槽尺寸为CAD值；不代表实测制造公差。

R2 · 试制工程图 / 单位 mm / 第三角法投影 / 禁止按图缩放量取尺寸

下页为原生组件坐标孔表/草图轮廓；装配位移不计入。

2026-09-10 | Fusion BRep → STEP → CAD隐藏线投影 | 实物试配、承载、光学及温升均待验证

### R2 · 试制工程图 / 单位 mm / 第三角法投影 / 禁止按图缩放量取尺寸

### 原生草图坐标说明：X 沿输送，Y 向后，Z 向上。圆为孔或圆轮廓；关联用途见特征名。

Wall_sketch [原生草图已约束]

轮廓顶点 (-150.0, 110.0, 0.0) | 轮廓顶点 (-150.0, 122.0, 0.0)
轮廓顶点 (150.0, 110.0, 0.0) | 轮廓顶点 (150.0, 122.0, 0.0)

Camera_height_hole_array_1_sketch [原生草图已约束]

圆直径 4.500; 中心 (-83.000, 109.000, 145.000)

Camera_height_hole_array_2_sketch [原生草图已约束]

圆直径 4.500; 中心 (-83.000, 109.000, 165.000)

Camera_height_hole_array_3_sketch [原生草图已约束]

圆直径 4.500; 中心 (-83.000, 109.000, 185.000)

Camera_height_hole_array_4_sketch [原生草图已约束]

圆直径 4.500; 中心 (-83.000, 109.000, 205.000)

Camera_height_hole_array_5_sketch [原生草图已约束]

圆直径 4.500; 中心 (-83.000, 109.000, 225.000)

Camera_height_hole_array_6_sketch [原生草图已约束]

圆直径 4.500; 中心 (-83.000, 109.000, 245.000)

Camera_height_hole_array_7_sketch [原生草图已约束]

圆直径 4.500; 中心 (-83.000, 109.000, 265.000)

Camera_height_hole_array_8_sketch [原生草图已约束]

圆直径 4.500; 中心 (-83.000, 109.000, 285.000)

Camera_height_hole_array_9_sketch [原生草图已约束]

圆直径 4.500; 中心 (-83.000, 109.000, 305.000)

Camera_height_hole_array_10_sketch [原生草图已约束]

圆直径 4.500; 中心 (-47.000, 109.000, 145.000)

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

圆直径 4.500; 中心 (-123.500, 109.000, 60.000)

Angle_fixings_4_sketch [原生草图已约束]

圆直径 4.500; 中心 (-123.500, 109.000, 110.000)

Angle_fixings_5_sketch [原生草图已约束]

圆直径 4.500; 中心 (123.500, 109.000, 60.000)

Angle_fixings_6_sketch [原生草图已约束]

圆直径 4.500; 中心 (123.500, 109.000, 110.000)
