czp-1-A1/FPGA_Component_Inspector/开发实施/机械结构展示/机械装配_R2c_合并布局/合并前必测表.csv

项目 | 测量内容 | 关联参数 | 当前占位值_非实测 | 实测记录
下亚克力外形 | 长/宽/厚/四角形状 | board_l,board_w,acrylic_lower_t | 130/90/1
上亚克力外形 | 长/宽/厚及相对下板XY错位 | 独立上下板外形与偏移参数 | 暂同下板；偏移0
叠层高度 | 下板底到上板顶四角高度/翘曲 | stack_h | 30
底面禁碰区 | 相机座/排线/螺帽范围及高度 | 禁碰区实测包络 | 仅占位
承托位置 | 四处可接触区与软垫实际位置/压缩厚度 | support_depth,pad_w,soft_t | 19/74/0.5
镜头中心 | 下板基准边到镜头轴XY距离及正负方向 | lens_dx,lens_dy | +20/0 假设
镜头突出 | 端面至下板底及调焦/镜座最大包络 | lens_drop,lens_d,lens_body_h | 20/14/18.3
实际接口 | 仅实际使用插座与插头XYZ包络/插拔方向 | 接口预留区 | 待确认
线缆路径 | 工作位/维护位弯曲空间及余量 | 线缆包络 | 待确认
板卡重量 | 含上下亚克力与摄像头/线缆牵引情况 | 首次件承载依据 | 未知
