czp-1-A1/FPGA_Component_Inspector/开发实施/机械结构展示/机械装配_R2c_合并布局/执行进度_续作先读.md

# R2c执行进度（不是交付完成声明）

已导入R2b为新的未保存文档FPGA_Inspector_R2c_Conditional_Quote；旧文件哈希在evidence/old_files_hashes.json。
已建立必测表、当前暂停状态和脚本；R2b基线STEP和100%/25%离线切片完成。100%整套估算1016.10g、串行73.20小时，非供方报价。
Fusion官方MCP端口27183。build.py请求已提交，必须先检查其结果/活动模型，禁止直接重发。
曾由恢复文档弹窗阻塞，已仅关闭提示、保留恢复文件。随后出现Windows登录界面，已请求用户解锁；不进行登录界面操作。

## 续作顺序
1. 查看evidence/build_mcp.json、changes.json、rebuilt.png是否出现；若请求仍运行先等待，不重复建模。
2. 完成后执行upper_parameters.py（仅一次），检查默认几何、板卡装入、默认工具、D120/H60维护和sweep、regression。
3. save_views.py输出原生与零件STEP以及截图；slice_compare.py new进行新件切片，slice_roles.py汇总支撑用料。
4. 根据失败记录修订结构/限制；核查新旧报告后再执行report.py，不能盲目使用预写报告中的候选结论。
5. 检查原生回读、图片和报价数字，校验旧文件哈希并打包。无订单，无制造放行。

所有脚本位于scripts。common.py和hardware_common.py来自旧版；MCP脚本用普通Python执行，OCP切片脚本需bundled Python3.12。内部G-code位于E:/fusion360_codex_skill/.tools/tmp/R2c_offline，不进入询价包。
