czp-1-A1/FPGA_Component_Inspector/开发实施/机械结构展示/机械装配_R2/打印准备_阶段2/HT01实测与CT推进判断_20260918.md

# HT01实测记录与CT小样推进判断

记录日期：2026-09-18。证据来源：用户到货照片、用户手动试穿反馈与本次确认；不是AI现场测量。

## 试验条件
- 商家确认：线材PETG，100%填充。
- 用户确认：M4螺丝；未打磨、未扩孔、未靠旋拧强行穿过。
- 打印层高、壁数、温度及设备配置未提供。

## 原始结果
| 项目 | 名义尺寸 mm | 用户反馈 |
|---|---:|---|
| 圆孔1 | 4.0 | 过不去 |
| 圆孔2 | 4.2 | 过不去 |
| 圆孔3 | 4.4 | 刚好 |
| 圆孔4 | 4.5 | 顺畅 |
| 圆孔5 | 4.6 | 顺畅 |
| 圆孔6 | 4.8 | 顺畅 |
| 左上槽 | 宽4.8，总长28 | 穿入及滑动顺畅 |
| 左下槽 | 宽4.2，总长28 | 穿入及滑动顺畅 |
| 右侧槽 | 宽4.5，总长28 | 穿入及滑动顺畅 |
| 凸台横孔 | 4.5 | 刚好 |
| 平放桌面 | — | 无翘动 |

未提供卡尺实测孔径、槽宽、槽长、外形与厚度；未单独量化首层外扩、松旷、横孔下垂或承载。不得据此填入尺寸实测值或宣称完整尺寸验收通过。

## 阶段结论
HT01已完成本次M4螺丝的未修孔通过性测试，足以支持进入CT小样试配。竖向4.5通孔与4.5宽槽暂不增加补偿；横向4.5孔为刚好，不作为顺畅通孔已验证。孔与槽结果不同，不能反推出统一收缩率或全局补偿。

## CT核对与下一步
已核对 scripts/02_build_coupons.py 及 scripts/phase2_drawings.py：CT01、CT02各有两个名义直径4.5的通孔；CT03为宽4.5、总长60、厚10的槽段。
- CT01：底面朝下，按既有切片说明处理支撑；CT02：顶面朝下；CT03：底面朝下。使用已定向STL，避免再次翻转。
- 可以按现有孔槽名义尺寸准备CT01/02/03各一件试打，不必先统一扩大孔槽。保持同店、同材质，并请商家沿用HT01工艺、按实际设备重新切片。
- CT01孔道比HT01深，三件叠装还涉及同轴度；HT01通过不能保证CT直接通过。
- 当前CT的30 mm板卡叠层、0.5 mm软垫及0.5 mm防脱间隙是名义试配条件。用稳定模拟件验证局部接口；不把实际整块FPGA仅支承在这一个小样上，不把假设30 mm当实测。
- CT03仍是独立试配槽段，不能用于确认P01 R2a端部余量、有效行程或整体承载。
- CT通过后再试P06灯圈；整套打印仍未放行。

本记录补充旧“仅HT01”等待状态。未改动CAD、STL、旧包及空白CSV模板，未向商家下单。
