czp-1-A1/FPGA_Component_Inspector/开发实施/机械结构展示/机械装配_R2/打印准备_阶段2/R2_切片与小样检查报告.md

# R2 第二阶段：切片可行性与关键小样交付

日期：2026-09-11。状态：试制方案；关键小样可进入试打准备，整套打印暂缓。R1与确认布局时的R2原生文件均保留。

## 本次实做与边界

- 已用 PrusaSlicer 2.9.6 对12种整机打印件及4种小样进行了实际离线切片。P03四角、P07左右为独立编号。16种网格均封闭，STEP读回通过实体有效性检查。
- 关键小样原生档重新导入Fusion：4独立实体、11用户参数、103时间线条目、33个完全约束草图，未发现特征错误。
- 在Fusion原生临时实体中，将P02及P03_RB移至小样坐标并裁切，与CT01/CT02求交；对称体积差绝对值均小于0.001 mm³，局部接口一致。外部内核对完全重合面的布尔结果出现异常，未采用该结果作为接口验收依据；原生验证记录另附。
- 逐件STEP共24份（含软垫/软衬和4种小样）；每种均有独立PDF，另附合订本。图纸由真实STEP隐藏线投影生成，含外形、孔槽及原生草图坐标，不是Fusion原生关联Drawing文档。参数改变后须重新导出图纸。
- 逐件图纸采用各视图标注的示意比例，不能按纸上比例量取尺寸；三视图位置按第三角布置。坐标是各组件原生建模坐标，安装位移另计。
- **P01整件暂缓：前侧60长槽最前端Y=-79，臂前缘Y=-80，只剩1 mm实体。建议下一修订将该承托槽缩至56以保留3 mm，复核垫片及装入路径后再放行。本次未悄然更改已确认整机。**这不是28 mm高度微调槽，不改变本报告已有高度行程。
- 16种零件连同实际生成的支撑/附着边挤出路径均在假设200×200×200范围内；不代表实机夹具、探针禁区或起始擦嘴动作已检查。
- 没有连接打印机，没有下发打印任务。evidence中的G-code仅为估算证据；首批包不含G-code。请在自己的打印机配置中导入毫米STL重新切片，确认平台与设备设置后使用。

## 切片基准（全部为预估假设）

200立方平台；0.4喷嘴；1.75 PETG，密度1.27 g/cm³；0.20层高；4圈壁；顶部/底部各5层；25% gyroid填充；0.45线宽。Brim一般3，P01为4。支撑阈值45°、snug，Z间隔0.25、XY间隔0.35，两层接触层。速度、加速度等见同目录INI。

估算配置使用喷嘴240°C、热床80°C、风扇30–60%；这是可复算的通用配置，尚未匹配用户打印机及PETG牌号。时间不是实机工时。材料含支撑和附着边，不含试错、换料和实际起始清料。

首批6件共 **122.12 g**，留15%试错备料约 **140 g**。全套18个PETG实体按当前方向逐件累计约 **612.08 g**（仅预算，未放行）。软衬/软垫及木板不计入PETG。

## 逐件方向、支撑及用料

| 编号 | 数量 | 方向 | 本体包络mm | 支撑 | Brim | g/件 | 支撑净增g | 预计时间 | 路径 | 状态 |
| --- | --- | --- | --- | --- | --- | --- | --- | --- | --- | --- |
| P01 | 2 | 侧面+X朝下 | 50.0×190.0×52.0 | 自动支撑/开放处清理 | 4 | 68.42 | 10.72 | 5h 40m 22s | 路径未超200³ | 暂缓整套打印 |
| P02 | 4 | 原生底面-Z朝下 | 74.0×44.0×41.0 | 自动支撑/开放处清理 | 3 | 50.39 | 2.09 | 4h 29m 32s | 路径未超200³ | 暂缓整套打印 |
| P03_LB | 1 | 顶面朝下 | 74.0×30.0×7.5 | 无支撑/桥接须试验 | 3 | 10.35 | 0.0 | 54m 46s | 路径未超200³ | 暂缓整套打印 |
| P03_LF | 1 | 顶面朝下 | 74.0×30.0×7.5 | 无支撑/桥接须试验 | 3 | 10.35 | 0.0 | 54m 53s | 路径未超200³ | 暂缓整套打印 |
| P03_RB | 1 | 顶面朝下 | 74.0×30.0×7.5 | 无支撑/桥接须试验 | 3 | 10.35 | 0.0 | 54m 49s | 路径未超200³ | 暂缓整套打印 |
| P03_RF | 1 | 顶面朝下 | 74.0×30.0×7.5 | 无支撑/桥接须试验 | 3 | 10.35 | 0.0 | 54m 51s | 路径未超200³ | 暂缓整套打印 |
| P04 | 2 | 正面-Y朝下 | 24.0×180.0×24.0 | 无支撑/桥接须试验 | 3 | 41.29 | 0.0 | 3h 44m 47s | 路径未超200³ | 暂缓整套打印 |
| P05 | 2 | 侧面+X朝下 | 44.0×150.0×20.0 | 自动支撑/开放处清理 | 3 | 32.26 | 0.25 | 2h 44m 46s | 路径未超200³ | 暂缓整套打印 |
| P06A | 1 | 原生底面-Z朝下 | 136.0×54.5×16.0 | 无支撑/桥接须试验 | 3 | 23.43 | 0.0 | 2h 13m 29s | 路径未超200³ | 仅小样试制 |
| P06B | 1 | 原生底面-Z朝下 | 136.0×54.5×16.0 | 无支撑/桥接须试验 | 3 | 23.41 | 0.0 | 2h 13m 47s | 路径未超200³ | 仅小样试制 |
| P07_L | 1 | 原生底面-Z朝下 | 88.0×52.0×8.0 | 无支撑/桥接须试验 | 3 | 19.17 | 0.0 | 1h 45m 53s | 路径未超200³ | 暂缓整套打印 |
| P07_R | 1 | 原生底面-Z朝下 | 88.0×52.0×8.0 | 无支撑/桥接须试验 | 3 | 19.17 | 0.0 | 1h 46m 2s | 路径未超200³ | 暂缓整套打印 |
| CT01 | 1 | 原生底面-Z朝下 | 43.0×44.0×41.0 | 自动支撑/开放处清理 | 3 | 31.23 | 1.22 | 2h 52m 39s | 路径未超200³ | 仅小样试制 |
| CT02 | 1 | 顶面朝下 | 43.0×30.0×7.5 | 无支撑/桥接须试验 | 3 | 6.24 | 0.0 | 34m 18s | 路径未超200³ | 仅小样试制 |
| CT03 | 1 | 原生底面-Z朝下 | 24.0×84.0×10.0 | 无支撑/桥接须试验 | 3 | 13.91 | 0.0 | 1h 11m 0s | 路径未超200³ | 仅小样试制 |
| HT01 | 1 | 原生底面-Z朝下 | 80.0×60.0×16.0 | 无支撑/桥接须试验 | 3 | 23.9 | 0.0 | 2h 13m 57s | 路径未超200³ | 仅小样试制 |

支撑净增为同配置有/无支撑两次切片的耗料差，包含与支撑相关的路径变化，不是称量值。层间强度未验证。

## 逐件工艺审查

- P01：侧面+X朝下，根部比臂宽，长臂底离床14 mm，因此需要长条支撑。4 mm Brim后190长本体仍可容纳；打印层沿侧向堆叠不能视为强度验证。1 mm槽端余量问题使其仍处于暂缓状态。
- P02 / CT01：底面朝下，承托面向上；上部Y止挡有2 mm伸出，使用支撑。支撑从开放前侧取出，不能把1.5 mm高止挡掰掉；止挡接触面毛刺应轻修并重新量间隙，不能靠打磨消除设计错误。
- P03 / CT02：顶面朝下，X止挡向上打印；两螺孔竖直，不需支撑。0.5 mm防抬间隙和亚克力接触面需实物量测。四个整机压片不可混用。
- P04：正面-Y朝下，两垫高脚朝上，180长方向在平台内；背面12 mm通道开放，先穿根部螺钉再固定导板。孔轴在打印Z方向。
- P05：侧放；上筋之间及根部台阶允许自动支撑，支撑可从侧面清除。孔槽及双螺栓垫片支承面清理后试装。
- P06A/B：底面朝下，以完整两半作为试配件。本轮不加支撑以检查16 mm窗口桥接和水平4.5孔；若窗口塌陷或孔内挂丝不合格，可在切片软件局部加可拆支撑重试。不要把自动切片成功当成桥接合格。
- P07L/R：平放，槽孔竖直，无支撑；避让口开通。连接短槽要容纳夹圈收紧，不能把桥板当作增加灯壳夹紧力的工具。
- CT03：平放，仅验证承托块与10 mm厚槽段/螺杆配合，不验证P01整臂、加强筋、最前端槽唇或承载。
- HT01：平放且不加支撑；六个竖孔、三种槽宽及一个横孔区分测试。保留原始测量，不先钻通再声称打印配合合格。

## 首批小样与装配试配

建议先HT01，再CT01+CT02+CT03，最后P06A+P06B。每一组通过后再推进下一组；灯圈合格前不整套打印。

### HT01 孔槽试片

80×60×6，左下3×3缺口为原点。X=10,22,34,46,58,70 / Y=10的孔依次直径4.0,4.2,4.4,4.5,4.6,4.8。三槽总长28：中心(20,26)宽4.2、(60,26)宽4.5、(20,44)宽4.8。横孔直径4.5沿Y，中心X60,Z11。

记录各实际孔径、槽宽、槽长、M4螺杆是否自由穿过、横孔顶部下垂、首层外扩。以实际螺杆和卡尺/量规检查，未经试片结果不要全局修改孔补偿。

### CT01 / CT02 / CT03 右后承托防脱小样

需2根M4×65、2个M4螺母、4片上述平垫；0.5 mm软垫一片；模拟上下亚克力与中间硬间隔，总高度30 mm。下/上亚克力各1 mm的假设意味着中间间隔28 mm。夹紧力路径是压片→板外硬支脚→底座→槽段，不能经过板卡叠层。

1. 将CT01放在CT03槽段上，两个孔对槽；放好0.5软垫。用稳定的亚克力角部模拟件和间隔块，禁止把整块FPGA只托在这一处小样上。
2. 垂直放入亚克力试件，最后装CT02；两M4×65贯穿并用垫片螺母锁住硬支脚，不靠继续拧螺钉消除防抬间隙。
3. CT01坐标下，板右边应在X=-20附近，板后边Y=45附近；检查右侧X挡内面-19.5、后侧Y挡内面45.5。上板最高面40.5、防脱底41，名义0.5间隙。
4. 用塞尺检查0.5防抬间隙，并检查最大允许抬起时X/Y止挡仍与上亚克力边缘重叠。量取实际厚度后记录偏差。
5. 本组仅验证右后局部+X/+Y接口；不能独立证明整机±X/±Y总间隙1.0。四点装配时另做四极限角及最大抬起试验。

默认右侧几何承托17×19；最不利误差沿两轴分别扣5，保留12×14=168 mm²。5 mm由板边内缩0.5、定位变化1、托臂误差1、打印偏差1、软垫贴放1.5组成。左侧名义57×19，预算后52×14。实际检验取亚克力、实体面、软垫三者交集；孔槽/倒角/缺口不能算承托区域。改变偏心、板尺寸或限位参数必须重算；小样不证明1 mm亚克力挠曲或总承重安全。

### P06A / P06B 灯圈试配

需2根M4×35、2螺母、4平垫，0.5 mm软衬；灯圈由完整成品几何导出。先空装螺钉检查穿入/退出及工具可达，再贴软衬，围合灯壳并交替轻紧两侧。

初始总缝2，几何闭合限位总缝1。若触及限位仍滑动，停止并修改衬垫/夹圈；不得继续过量挤压灯壳。限位不能证明壳体受力安全。此夹持方案没有已验证的失效承托，初次检查应在低高度软垫上进行，避免灯滑落。

必须实物记录：连续夹持接触、轻载自重防滑、夹持后灯壳是否变形、螺钉工具空间、实际线口位置与窗口对应、线缆弯曲、发光面/内孔遮挡、调焦手指空间、通电工作温升。未知安装面的4个M3孔仍不使用。灯不靠镜头承重。未完成的各项标“待验证”，不能用CAD无干涉代替。

## 有效行程保持

统一槽算法：槽总长−校核直径4.5−双螺栓中心距−两端各1余量。

|项目|槽几何允许|整机工作限制|
|---|---|---|
|相机短槽28，单螺杆|21.5；20分档交叠1.5|推荐拍摄距离D=50..200，须同时满足下列组合条件|
|灯竖槽140，双距16|117.5|保守灯发光面距检测面H=10..97|
|灯前后槽72，双距36|29.5，即±14.75|全前后范围并保留2 mm裕量要求D≥H+42|
|相机与灯对中Y=0|几何组合限制|D≥H+38；40 mm目标端未通过，D40/H10碰撞|

默认D100/H60：灯对中满足上述限制；前后全行程不满足2 mm裕量条件，向后建议Y≤10。灯前后调节用于装配/避让，偏离Y0时灯心不与检测点同轴，检测前复位对中。H<30人工取放受限，低位时先升灯再取样。40–200为机械目标，不保证光学合焦；本次没有扩大原报告工作范围。

## 木板与紧固件

| 编号 | 下料mm | 数量 | 说明 |
| --- | --- | --- | --- |
| W01 | 650×400×12 | 1 | 结构孔10个；设备固定孔待定位 |
| W02 | 300×360×12 | 1 | 相机40孔、灯导板4孔、角码6孔，共50孔 |
| W03 | 直角边120/200，厚12 | 2 | 每件4个角码孔 |
| W04 | 100×100×12 | 2 | 每件2个通孔及90度沉孔；左件旋转180度安装 |
| W05 | 12×80×68（高度暂定） | 4 | 每件2孔；按实测带面改高度及上孔 |

木板逐件PDF附圆孔坐标。W01仅结构孔，设备孔继续待实物定位。W02和W03的上加强板角码连接Z=110。现货角码的2孔位置未确认，先用实物角码核孔位。托料板应水平进入/离开设备，名义机端间隙2须结合实际载带验证，不设计未知轮廓贴合导向件。

| 规格 | 数量 | 说明 |
| --- | --- | --- |
| 90°沉头 M4×20 | 4 | 名义尺寸；实购头部/有效螺纹核实 |
| 内六角圆柱头 M4×25 | 32 | 名义尺寸；实购头部/有效螺纹核实 |
| 内六角圆柱头 M4×30 | 8 | 名义尺寸；实购头部/有效螺纹核实 |
| 内六角圆柱头 M4×35 | 6 | 名义尺寸；实购头部/有效螺纹核实 |
| 内六角圆柱头 M4×45 | 4 | 名义尺寸；实购头部/有效螺纹核实 |
| 内六角圆柱头 M4×65 | 8 | 名义尺寸；实购头部/有效螺纹核实 |
| 外六角 M4×35 | 4 | 名义尺寸；实购头部/有效螺纹核实 |
| M4螺母，AF7，模型厚3.2 | 66 | 普通螺母；防松措施试装后确定 |
| M4平垫，内径4.5×外径9×厚0.8 | 128 | 托料板沉头顶面不加垫片 |
| 25×25×25×2 普通角码 | 18 | 现货孔位核实后再钻木板 |
| 20×20×8底部防滑垫 | 4 | 粘贴/固定方式待选型 |

合计66根螺钉、66个螺母、128片垫片。未加采购备件。板卡叠层从30变35时，原M4×65可能不足，须重算有效伸出，预计改70并核实。灯导板背面根部使用外六角头以便7 mm开口扳手侧向进入；所有实购头部、螺纹长度、垫片实际厚度均需核对。

## 后续装配顺序与放行条件

关键小样→实测板卡叠层/镜头突出/带面高/灯线口→修订P01槽端并重新切片及校核→逐件打印→木板按实购角码定位钻孔→组装底板、立板、加强板→预装P04背槽根部螺钉再固定P04→装对称P01和四个P02→放板卡并装四个P03→独立安装灯臂、连接板与灯圈→调高/对中→手动带样通过两端托料板→低速启停观察位移。

全套打印放行前必须：关键小样记录通过、P01修订复核、四点限位与承托交集复查、亚克力不被压弯、灯圈夹持实测、实机切片配置确认。承载、长时间运行、光学和温升另行验证；不存在工业验收结论。

## 文件与证据

`首批小样_STL_毫米_已定向`仅含上述6件。`小样STEP`含4新小样；灯圈STEP在`零件STEP`。`R2_关键配合小样.f3d`保存用户参数和特征历史。`逐件工程图_试制`有独立PDF与合订本；`evidence`保留切片日志、参数、路径边界、实体和原生档检查结果。

软件来源：[PrusaSlicer 2.9.6官方发布](https://github.com/prusa3d/PrusaSlicer/releases/tag/version_2.9.6)、[官方命令行说明](https://github.com/prusa3d/PrusaSlicer/wiki/Command-Line-Interface)。用量来自本机实际切片输出，非网页估计。
