czp-1-A1/FPGA_Component_Inspector/开发实施/机械结构展示/机械装配_R2b/P08_询价_Q1/P08_Q1_工程图及紧固件.pdf

# P08 / Q1 背面螺纹孔连接板 - 单件三视图

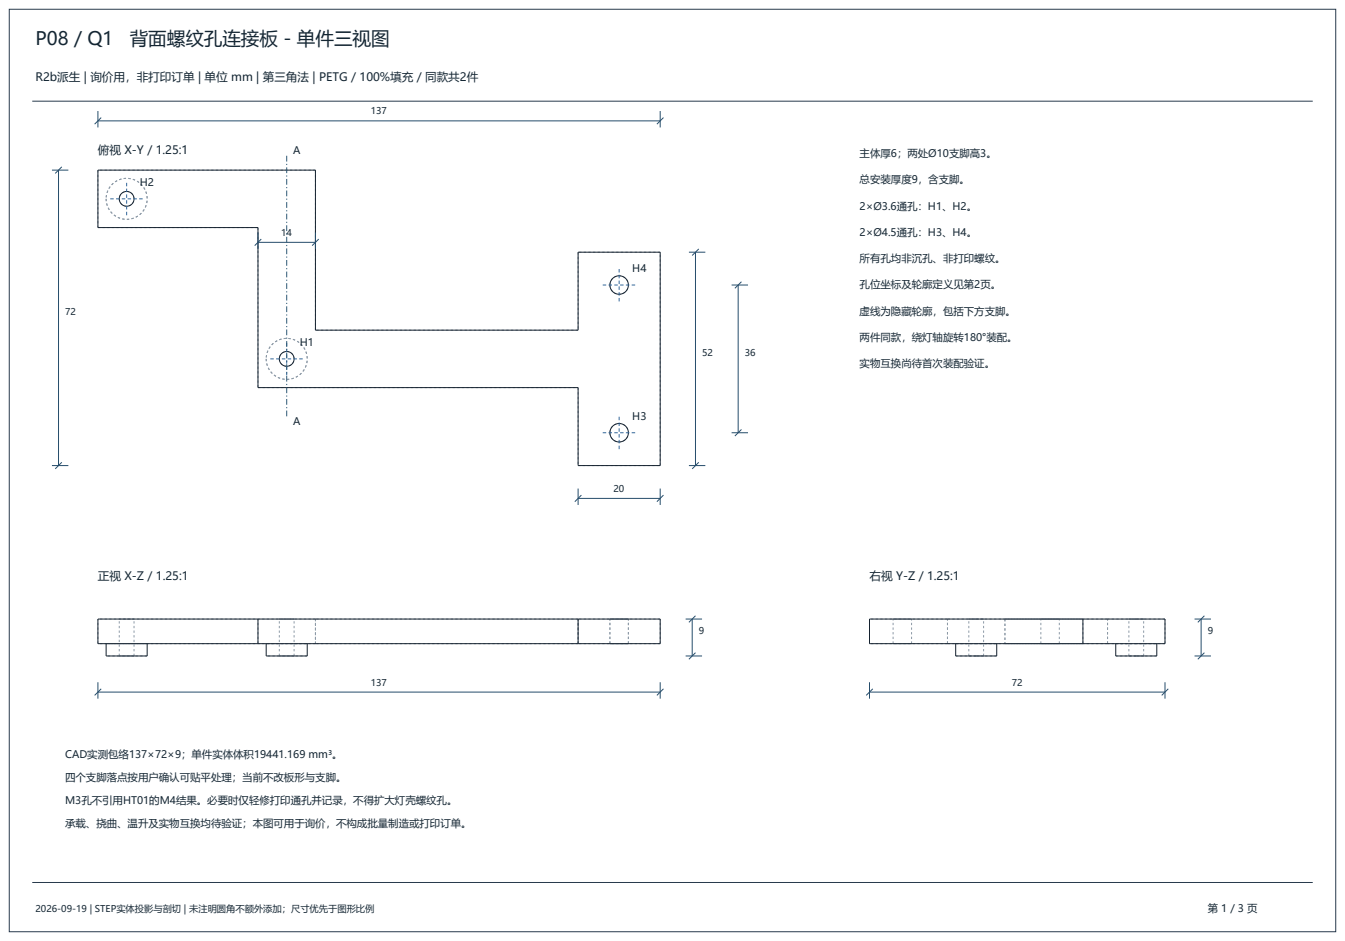
[picture p162: page 1]
2026-09-19 | STEP实体投影与剖切 | 未注明圆角不额外添加；尺寸优先于图形比例; 主体厚6；两处Ø10支脚高3。; 总安装厚度9，含支脚。; 所有孔均非沉孔、非打印螺纹。; 孔位坐标及轮廓定义见第2页。; 虚线为隐藏轮廓，包括下方支脚。; 两件同款，绕灯轴旋转180°装配。; 实物互换尚待首次装配验证。; CAD实测包络137×72×9；单件实体体积19441.169 mm³。; 四个支脚落点按用户确认可贴平处理；当前不改板形与支脚。; M3孔不引用HT01的M4结果。必要时仅轻修打印通孔并记录，不得扩大灯壳螺纹孔。

R2b派生 | 询价用，非打印订单 | 单位 mm | 第三角法 | PETG / 100%填充 / 同款共2件

承载、挠曲、温升及实物互换均待验证；本图可用于询价，不构成批量制造或打印订单。

# P08 / Q1 背面螺纹孔连接板 - 孔位、轮廓与剖视

R2b派生 | 询价用，非打印订单 | 单位 mm | 第三角法 | PETG / 100%填充 / 同款共2件
2026-09-19 | STEP实体投影与剖切 | 未注明圆角不额外添加；尺寸优先于图形比例 | 第 2 / 3 页

加工坐标：保留灯心X/Y原点，支脚接触面Z=0；主体下表面Z=3，上表面Z=9。

孔 | X | Y | 通孔直径 | 轴向范围
H1 | 39 | 0 | Ø3.6 | Z=0～9
H2 | 0 | 39 | Ø3.6 | Z=0～9
H3 | 120 | -18 | Ø4.5 | Z=3～9
H4 | 120 | 18 | Ø4.5 | Z=3～9

H1、H2各有同轴Ø10×3支脚。

M3孔中心距外条边7；孔边余量5.2。

M3垫片OD7在主体上的最小边余量3.5。

M4孔距安装耳近端边8，孔边余量5.75。

孔位取灯心原点；不要按STL平移坐标放样。

主体矩形并集 | X范围 | Y范围 | Z范围
上侧横条 | -7～46 | 32～46 | 3～9
竖向连接条 | 32～46 | -7～46 | 3～9
外伸横条 | 32～120 | -7～7 | 3～9
安装耳 | 110～130 | -26～26 | 3～9

外形由四矩形并集形成一个连续实体。

条宽14；安装耳20×52；主体统一厚6。

不要在内角自行增加影响装配的圆角。

去毛刺，不得削薄支脚承压面或垫片座面。

模型控制外形；本页坐标控制孔位与实体尺寸。

A-A实体剖切：X=39，沿+X观察 / 2:1

Ø10

3

6
9

孔贯穿主体及支脚；剖切轮廓取自STEP实体。

询价尺寸控制目标（供方需确认可达性）：

主体6±0.15；支脚3±0.15；总厚9±0.20。

总厚需直接测量控制，不因分项公差放宽。

一般线性尺寸±0.20；孔中心坐标±0.15。

M3孔Ø3.6 +0.20/0（允许轻修PETG后达到）；

M4孔Ø4.5 +0.20/0；均须去毛刺、试穿。

这些是拟定制造要求，不是已测得的打印精度。

供方若无法达到，应在报价中注明，先修订再生产。

# P08 / Q1 背面螺纹孔连接板 - 紧固件、打印要求及首次装配

R2b派生 | 询价用，非打印订单 | 单位 mm | 第三角法 | PETG / 100%填充 / 同款共2件
2026-09-19 | STEP实体投影与剖切 | 未注明圆角不额外添加；尺寸优先于图形比例 | 第 3 / 3 页
项目 | 数量 | 规格 / 当前选择 | 状态
P08连接板 | 2 | PETG，100%填充 | 同款，按已定向STL；无独立试片
灯背面螺丝 | 4 | M3×12，非沉头，建议内六角圆柱头 | 暂选；头部包络≤Ø5.5×3，供方核实
M3平垫片 | 4 | OD7 / ID3.6 / 厚0.5 | 厚度预算±0.05；实购核实
P08/P05螺栓 | 4 | M4×30 | 沿用，夹持厚18；露出螺母名义7.2
M4螺母 | 4 | M4，模型厚3.2 | 沿用；核实实际尺寸
M4平垫片 | 8 | OD9 / ID4.5 / 厚0.8 | 沿用，每个M4上下各一片

M3安装厚度按CAD复核为9 mm（主体6+支脚3）；打印后的实际厚度尚未测量。

名义拧入：e=L-A-w=12-9-0.5=2.5 mm。图示孔深4 mm仅作为设计输入。

输入或结果 | 名义 | 询价/核验公差预算 | 说明
螺丝头下长度L | 12 | ±0.20 | 采购核实；非沉头长度从头下承压面起算
实际安装厚度A | 9 | ±0.20 | 两处逐点测量，含一体支脚
平垫片厚w | 0.5 | ±0.05 | 实际采购件测量
拧入e | 2.5 | 2.05～2.95 | e_max=12.2-8.8-0.45=2.95
相对图示4mm的余量 | 1.5 | 最小1.05 | 仅理想几何预算，不证明4mm全深可用

实际有效螺纹、入口不完整牙和孔底形状未确认；不得把上表的余量写成厂家认可的顶底安全余量。

首次装配：核实A、w、L及有效孔深；手拧确认未顶底，再检查螺纹啮合和固定可靠性，不得强拧补偿。

若有效可用深度不足以容纳实际拧入并留余量，暂停紧固，复核螺丝/垫片方案后再装，不扩大灯壳螺纹孔。

打印：主体大平面贴床、支脚向上；0.4喷嘴/0.2层高为估算基准，4壁，100%直线填充，无支撑，3mm裙边。

STL单件137×72×9（含裙边143×78×9）；估算25.32g/件、约2h03/件；两件约50.64g，供方实际切片为准。

维护：D120/H60、Y0，台面组装灯与P08，抬高5mm从前送入后落座，装M4，再恢复工作姿态。

承载/挠曲/松动、温升、实物180°互换与M3通孔适配均列首次装配待验证；不增加HT02，不下发打印订单。
