czp-1-A1/FPGA_Component_Inspector/开发实施/机械结构展示/机械装配_R2/打印准备_阶段2/逐件工程图_试制/P01.pdf

# P01 对称托臂

## 数量 2 材料 PETG / 待试制

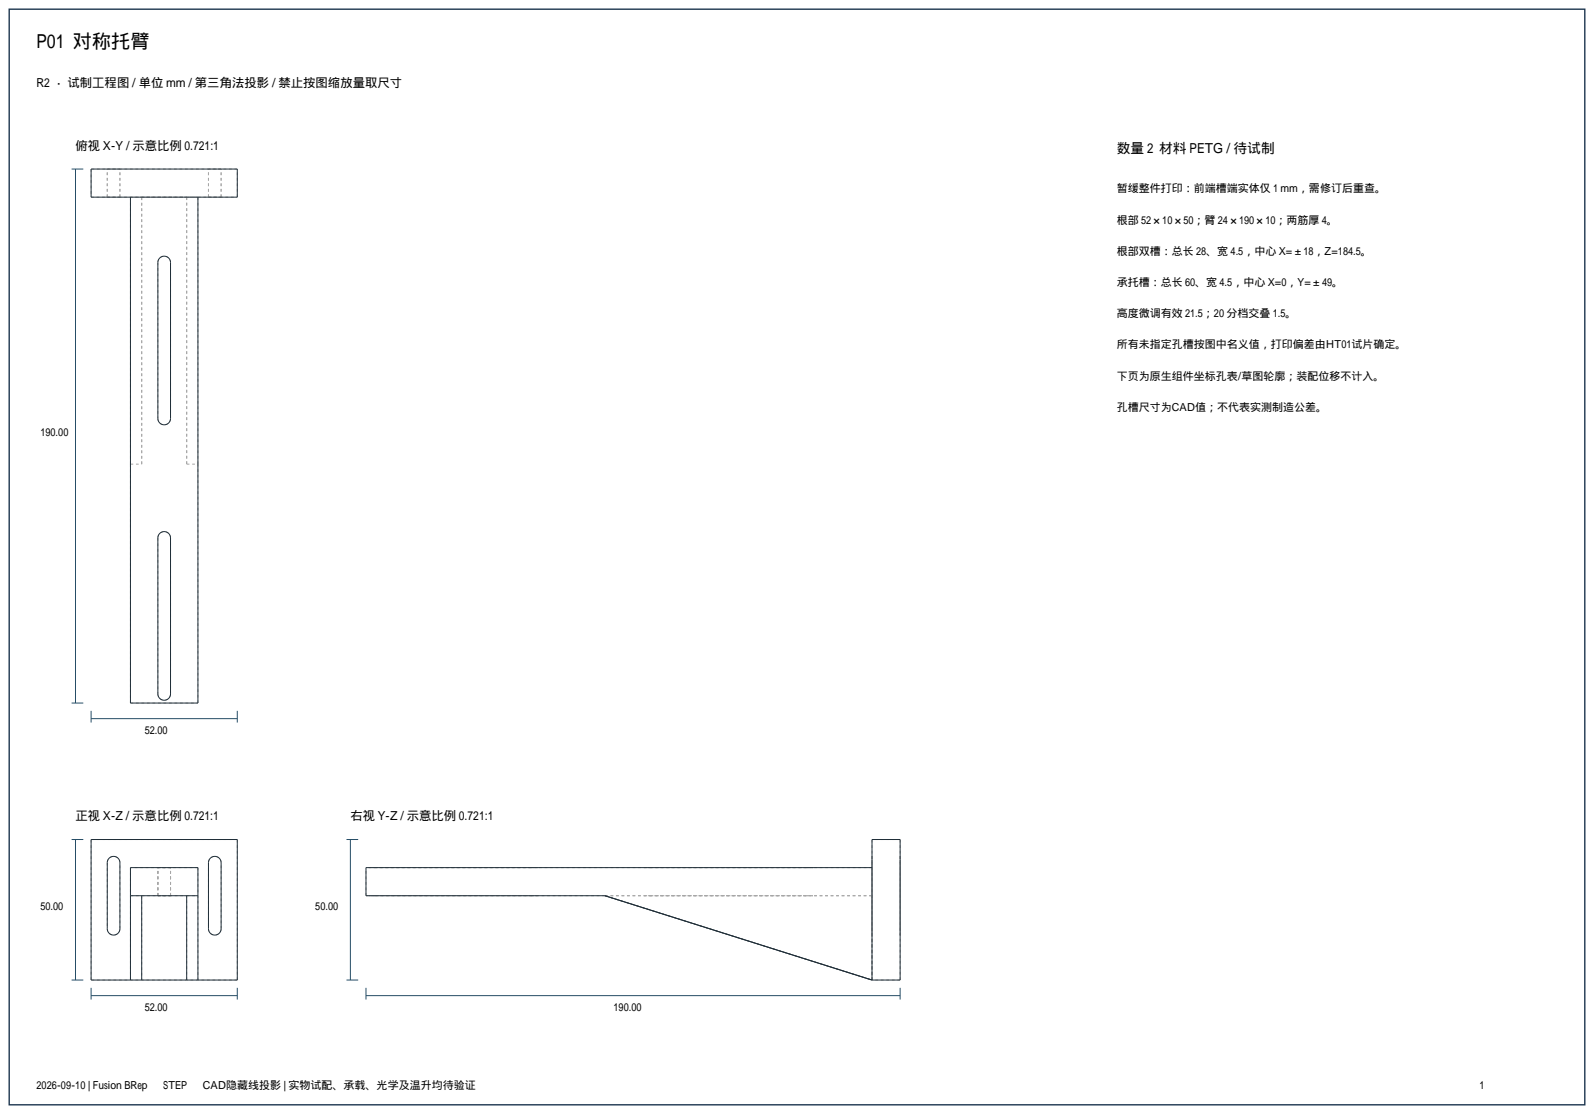
[picture p163: page 1]
俯视 X-Y / 示意比例 0.721:1; 正视 X-Z / 示意比例 0.721:1; 右视 Y-Z / 示意比例 0.721:1; 根部 52×10×50；臂 24×190×10；两筋厚 4。; 高度微调有效 21.5；20 分档交叠 1.5。; 所有未指定孔槽按图中名义值，打印偏差由HT01试片确定。; 孔槽尺寸为CAD值；不代表实测制造公差。

R2 · 试制工程图 / 单位 mm / 第三角法投影 / 禁止按图缩放量取尺寸

暂缓整件打印：前端槽端实体仅 1 mm，需修订后重查。

根部双槽：总长 28、宽 4.5，中心 X=±18，Z=184.5。

承托槽：总长 60、宽 4.5，中心 X=0，Y=±49。

下页为原生组件坐标孔表/草图轮廓；装配位移不计入。

2026-09-10 | Fusion BRep → STEP → CAD隐藏线投影 | 实物试配、承载、光学及温升均待验证

### R2 · 试制工程图 / 单位 mm / 第三角法投影 / 禁止按图缩放量取尺寸

### 原生草图坐标说明：X 沿输送，Y 向后，Z 向上。圆为孔或圆轮廓；关联用途见特征名。

Arm_flat_sketch [原生草图已约束]

轮廓顶点 (-12.0, -80.0, 184.5) | 轮廓顶点 (-12.0, 110.0, 184.5)
轮廓顶点 (12.0, -80.0, 184.5) | 轮廓顶点 (12.0, 110.0, 184.5)

Wide_root_sketch [原生草图已约束]

轮廓顶点 (-26.0, 100.0, 154.5) | 轮廓顶点 (-26.0, 110.0, 154.5)
轮廓顶点 (26.0, 100.0, 154.5) | 轮廓顶点 (26.0, 110.0, 154.5)

Under_rib_-12_sketch [原生草图已约束]

轮廓顶点 (-12.0, 5.0, 184.5) | 轮廓顶点 (-12.0, 100.0, 154.5)

轮廓顶点 (-12.0, 100.0, 184.5)

Under_rib_8_sketch [原生草图已约束]

轮廓顶点 (8.0, 5.0, 184.5) | 轮廓顶点 (8.0, 100.0, 154.5)

轮廓顶点 (8.0, 100.0, 184.5)

Pad_position_slots_0_sketch [原生草图已约束]

轮廓顶点 (-2.25, -76.75, 183.5) | 轮廓顶点 (-2.25, -21.25, 183.5)
轮廓顶点 (2.25, -76.75, 183.5) | 轮廓顶点 (2.25, -21.25, 183.5)

Pad_position_slots_0_ends_1_sketch [原生草图已约束]

圆直径 4.500; 中心 (0.000, -76.750, 183.500)

Pad_position_slots_0_ends_2_sketch [原生草图已约束]

圆直径 4.500; 中心 (0.000, -21.250, 183.500)

Pad_position_slots_1_sketch [原生草图已约束]

轮廓顶点 (-2.25, 21.25, 183.5) | 轮廓顶点 (-2.25, 76.75, 183.5)
轮廓顶点 (2.25, 21.25, 183.5) | 轮廓顶点 (2.25, 76.75, 183.5)

Pad_position_slots_1_ends_1_sketch [原生草图已约束]

圆直径 4.500; 中心 (0.000, 21.250, 183.500)

Pad_position_slots_1_ends_2_sketch [原生草图已约束]

圆直径 4.500; 中心 (0.000, 76.750, 183.500)

Root_fine_slots_0_sketch [原生草图已约束]

轮廓顶点 (-20.25, 99.0, 172.75) | 轮廓顶点 (-20.25, 99.0, 196.25)
轮廓顶点 (-15.75, 99.0, 172.75) | 轮廓顶点 (-15.75, 99.0, 196.25)

Root_fine_slots_0_ends_1_sketch [原生草图已约束]

圆直径 4.500; 中心 (-18.000, 99.000, 172.750)

### R2 · 试制工程图 / 单位 mm / 第三角法投影 / 禁止按图缩放量取尺寸

Root_fine_slots_0_ends_2_sketch [原生草图已约束]

圆直径 4.500; 中心 (-18.000, 99.000, 196.250)

Root_fine_slots_1_sketch [原生草图已约束]

轮廓顶点 (15.75, 99.0, 172.75) | 轮廓顶点 (15.75, 99.0, 196.25)
轮廓顶点 (20.25, 99.0, 172.75) | 轮廓顶点 (20.25, 99.0, 196.25)

Root_fine_slots_1_ends_1_sketch [原生草图已约束]

圆直径 4.500; 中心 (18.000, 99.000, 172.750)

Root_fine_slots_1_ends_2_sketch [原生草图已约束]

圆直径 4.500; 中心 (18.000, 99.000, 196.250)
