czp-1-A1/FPGA_Component_Inspector/开发实施/机械结构展示/机械装配_R2/打印准备_阶段2/逐件工程图_试制/P06A.pdf

# P06A 分体灯夹圈

## 数量 1 材料 PETG / 待试制

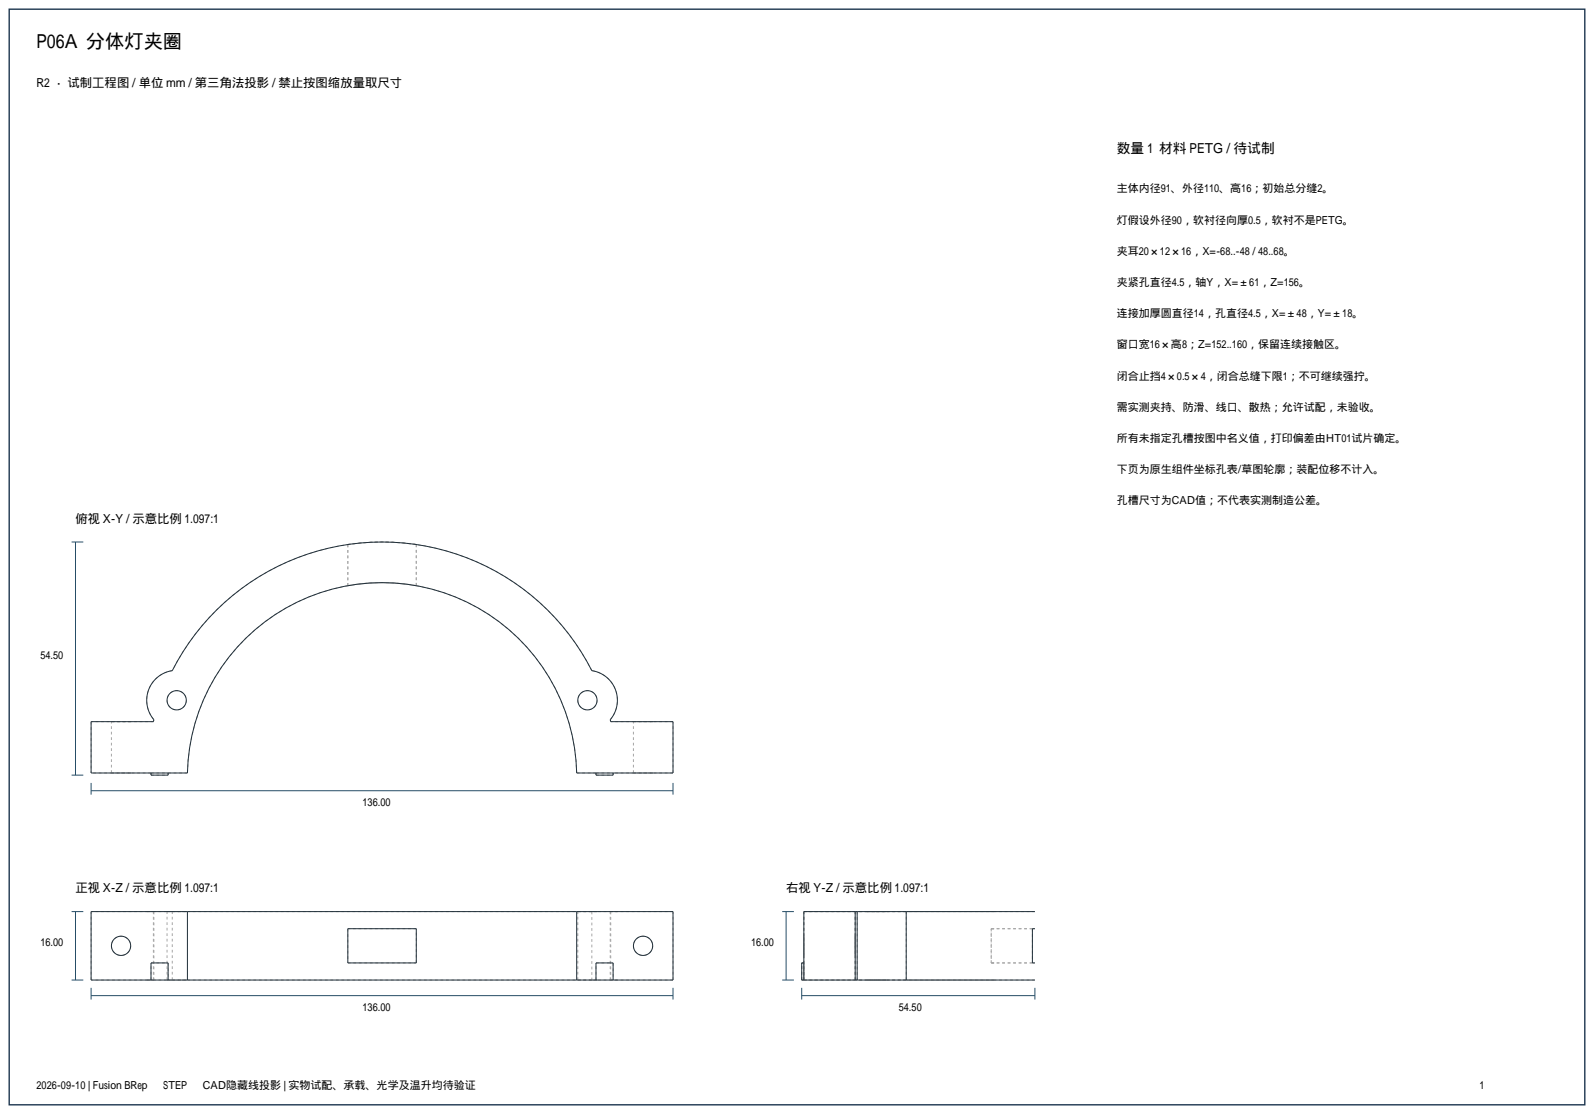
[picture p164: page 1]
俯视 X-Y / 示意比例 1.097:1; 正视 X-Z / 示意比例 1.097:1; 右视 Y-Z / 示意比例 1.097:1; 主体内径91、外径110、高16；初始总分缝2。; 灯假设外径90，软衬径向厚0.5，软衬不是PETG。; 夹紧孔直径4.5，轴Y，X=±61，Z=156。; 连接加厚圆直径14，孔直径4.5，X=±48，Y=±18。; 窗口宽16×高8；Z=152..160，保留连续接触区。; 闭合止挡4×0.5×4，闭合总缝下限1；不可继续强拧。; 所有未指定孔槽按图中名义值，打印偏差由HT01试片确定。; 孔槽尺寸为CAD值；不代表实测制造公差。

R2 · 试制工程图 / 单位 mm / 第三角法投影 / 禁止按图缩放量取尺寸

需实测夹持、防滑、线口、散热；允许试配，未验收。

下页为原生组件坐标孔表/草图轮廓；装配位移不计入。

2026-09-10 | Fusion BRep → STEP → CAD隐藏线投影 | 实物试配、承载、光学及温升均待验证

### R2 · 试制工程图 / 单位 mm / 第三角法投影 / 禁止按图缩放量取尺寸

### 原生草图坐标说明：X 沿输送，Y 向后，Z 向上。圆为孔或圆轮廓；关联用途见特征名。

Annular_clamp_sketch [原生草图已约束]

圆直径 110.000; 中心 (0.000, 0.000, 148.000)

Annular_clamp_bore_1_sketch [原生草图已约束]

圆直径 91.000; 中心 (0.000, 0.000, 148.000)

Split_gap_sketch [原生草图已约束]

轮廓顶点 (-80.0, -80.0, 147.0) | 轮廓顶点 (-80.0, 1.0, 147.0)
轮廓顶点 (80.0, -80.0, 147.0) | 轮廓顶点 (80.0, 1.0, 147.0)

Clamp_ear_-68_sketch [原生草图已约束]

轮廓顶点 (-68.0, 1.0, 148.0) | 轮廓顶点 (-68.0, 13.0, 148.0)
轮廓顶点 (-48.0, 1.0, 148.0) | 轮廓顶点 (-48.0, 13.0, 148.0)

Clamp_ear_48_sketch [原生草图已约束]

轮廓顶点 (48.0, 1.0, 148.0) | 轮廓顶点 (48.0, 13.0, 148.0)
轮廓顶点 (68.0, 1.0, 148.0) | 轮廓顶点 (68.0, 13.0, 148.0)

Reinforced_mount_-48_sketch [原生草图已约束]

圆直径 14.000; 中心 (-48.000, 18.000, 148.000)

Reinforced_mount_48_sketch [原生草图已约束]

圆直径 14.000; 中心 (48.000, 18.000, 148.000)

Preserve_housing_clearance_sketch [原生草图已约束]

圆直径 91.000; 中心 (0.000, 0.000, 147.000)

Bridge_mounts_1_sketch [原生草图已约束]

圆直径 4.500; 中心 (-48.000, 18.000, 147.000)

Bridge_mounts_2_sketch [原生草图已约束]

圆直径 4.500; 中心 (48.000, 18.000, 147.000)

Clamp_screws_1_sketch [原生草图已约束]

圆直径 4.500; 中心 (-61.000, -14.000, 156.000)

Clamp_screws_2_sketch [原生草图已约束]

圆直径 4.500; 中心 (61.000, -14.000, 156.000)

Closure_limit_-54_sketch [原生草图已约束]

轮廓顶点 (-54.0, 0.5, 148.0) | 轮廓顶点 (-54.0, 1.0, 148.0)
轮廓顶点 (-50.0, 0.5, 148.0) | 轮廓顶点 (-50.0, 1.0, 148.0)

### R2 · 试制工程图 / 单位 mm / 第三角法投影 / 禁止按图缩放量取尺寸

Closure_limit_50_sketch [原生草图已约束]

轮廓顶点 (50.0, 0.5, 148.0) | 轮廓顶点 (50.0, 1.0, 148.0)
轮廓顶点 (54.0, 0.5, 148.0) | 轮廓顶点 (54.0, 1.0, 148.0)

Straight_cable_vent_window_sketch [原生草图已约束]

轮廓顶点 (-8.0, 42.0, 152.0) | 轮廓顶点 (-8.0, 60.0, 152.0)
轮廓顶点 (8.0, 42.0, 152.0) | 轮廓顶点 (8.0, 60.0, 152.0)
