czp-1-A1/FPGA_Component_Inspector/开发实施/机械结构展示/机械装配_R2/打印准备_阶段2/逐件工程图_试制/R2_逐件工程图合订本.pdf

# P01 对称托臂

## 数量 2 材料 PETG / 待试制

俯视 X-Y / 示意比例 0.721:1; 正视 X-Z / 示意比例 0.721:1; 右视 Y-Z / 示意比例 0.721:1; 根部 52×10×50；臂 24×190×10；两筋厚 4。; 高度微调有效 21.5；20 分档交叠 1.5。; 所有未指定孔槽按图中名义值，打印偏差由HT01试片确定。; 孔槽尺寸为CAD值；不代表实测制造公差。

R2 · 试制工程图 / 单位 mm / 第三角法投影 / 禁止按图缩放量取尺寸

暂缓整件打印：前端槽端实体仅 1 mm，需修订后重查。

根部双槽：总长 28、宽 4.5，中心 X=±18，Z=184.5。

承托槽：总长 60、宽 4.5，中心 X=0，Y=±49。

下页为原生组件坐标孔表/草图轮廓；装配位移不计入。

2026-09-10 | Fusion BRep → STEP → CAD隐藏线投影 | 实物试配、承载、光学及温升均待验证

# P01 对称托臂

### R2 · 试制工程图 / 单位 mm / 第三角法投影 / 禁止按图缩放量取尺寸

### 原生草图坐标说明：X 沿输送，Y 向后，Z 向上。圆为孔或圆轮廓；关联用途见特征名。

Arm_flat_sketch [原生草图已约束]

轮廓顶点 (-12.0, -80.0, 184.5) | 轮廓顶点 (-12.0, 110.0, 184.5)
轮廓顶点 (12.0, -80.0, 184.5) | 轮廓顶点 (12.0, 110.0, 184.5)

Wide_root_sketch [原生草图已约束]

轮廓顶点 (-26.0, 100.0, 154.5) | 轮廓顶点 (-26.0, 110.0, 154.5)
轮廓顶点 (26.0, 100.0, 154.5) | 轮廓顶点 (26.0, 110.0, 154.5)

Under_rib_-12_sketch [原生草图已约束]

轮廓顶点 (-12.0, 5.0, 184.5) | 轮廓顶点 (-12.0, 100.0, 154.5)

轮廓顶点 (-12.0, 100.0, 184.5)

Under_rib_8_sketch [原生草图已约束]

轮廓顶点 (8.0, 5.0, 184.5) | 轮廓顶点 (8.0, 100.0, 154.5)

轮廓顶点 (8.0, 100.0, 184.5)

Pad_position_slots_0_sketch [原生草图已约束]

轮廓顶点 (-2.25, -76.75, 183.5) | 轮廓顶点 (-2.25, -21.25, 183.5)
轮廓顶点 (2.25, -76.75, 183.5) | 轮廓顶点 (2.25, -21.25, 183.5)

Pad_position_slots_0_ends_1_sketch [原生草图已约束]

圆直径 4.500; 中心 (0.000, -76.750, 183.500)

Pad_position_slots_0_ends_2_sketch [原生草图已约束]

圆直径 4.500; 中心 (0.000, -21.250, 183.500)

Pad_position_slots_1_sketch [原生草图已约束]

轮廓顶点 (-2.25, 21.25, 183.5) | 轮廓顶点 (-2.25, 76.75, 183.5)
轮廓顶点 (2.25, 21.25, 183.5) | 轮廓顶点 (2.25, 76.75, 183.5)

Pad_position_slots_1_ends_1_sketch [原生草图已约束]

圆直径 4.500; 中心 (0.000, 21.250, 183.500)

Pad_position_slots_1_ends_2_sketch [原生草图已约束]

圆直径 4.500; 中心 (0.000, 76.750, 183.500)

Root_fine_slots_0_sketch [原生草图已约束]

轮廓顶点 (-20.25, 99.0, 172.75) | 轮廓顶点 (-20.25, 99.0, 196.25)
轮廓顶点 (-15.75, 99.0, 172.75) | 轮廓顶点 (-15.75, 99.0, 196.25)

Root_fine_slots_0_ends_1_sketch [原生草图已约束]

圆直径 4.500; 中心 (-18.000, 99.000, 172.750)

# P01 对称托臂

### R2 · 试制工程图 / 单位 mm / 第三角法投影 / 禁止按图缩放量取尺寸

Root_fine_slots_0_ends_2_sketch [原生草图已约束]

圆直径 4.500; 中心 (-18.000, 99.000, 196.250)

Root_fine_slots_1_sketch [原生草图已约束]

轮廓顶点 (15.75, 99.0, 172.75) | 轮廓顶点 (15.75, 99.0, 196.25)
轮廓顶点 (20.25, 99.0, 172.75) | 轮廓顶点 (20.25, 99.0, 196.25)

Root_fine_slots_1_ends_1_sketch [原生草图已约束]

圆直径 4.500; 中心 (18.000, 99.000, 172.750)

Root_fine_slots_1_ends_2_sketch [原生草图已约束]

圆直径 4.500; 中心 (18.000, 99.000, 196.250)

# P02 加宽四点承托块

## 数量 4 材料 PETG / 待试制

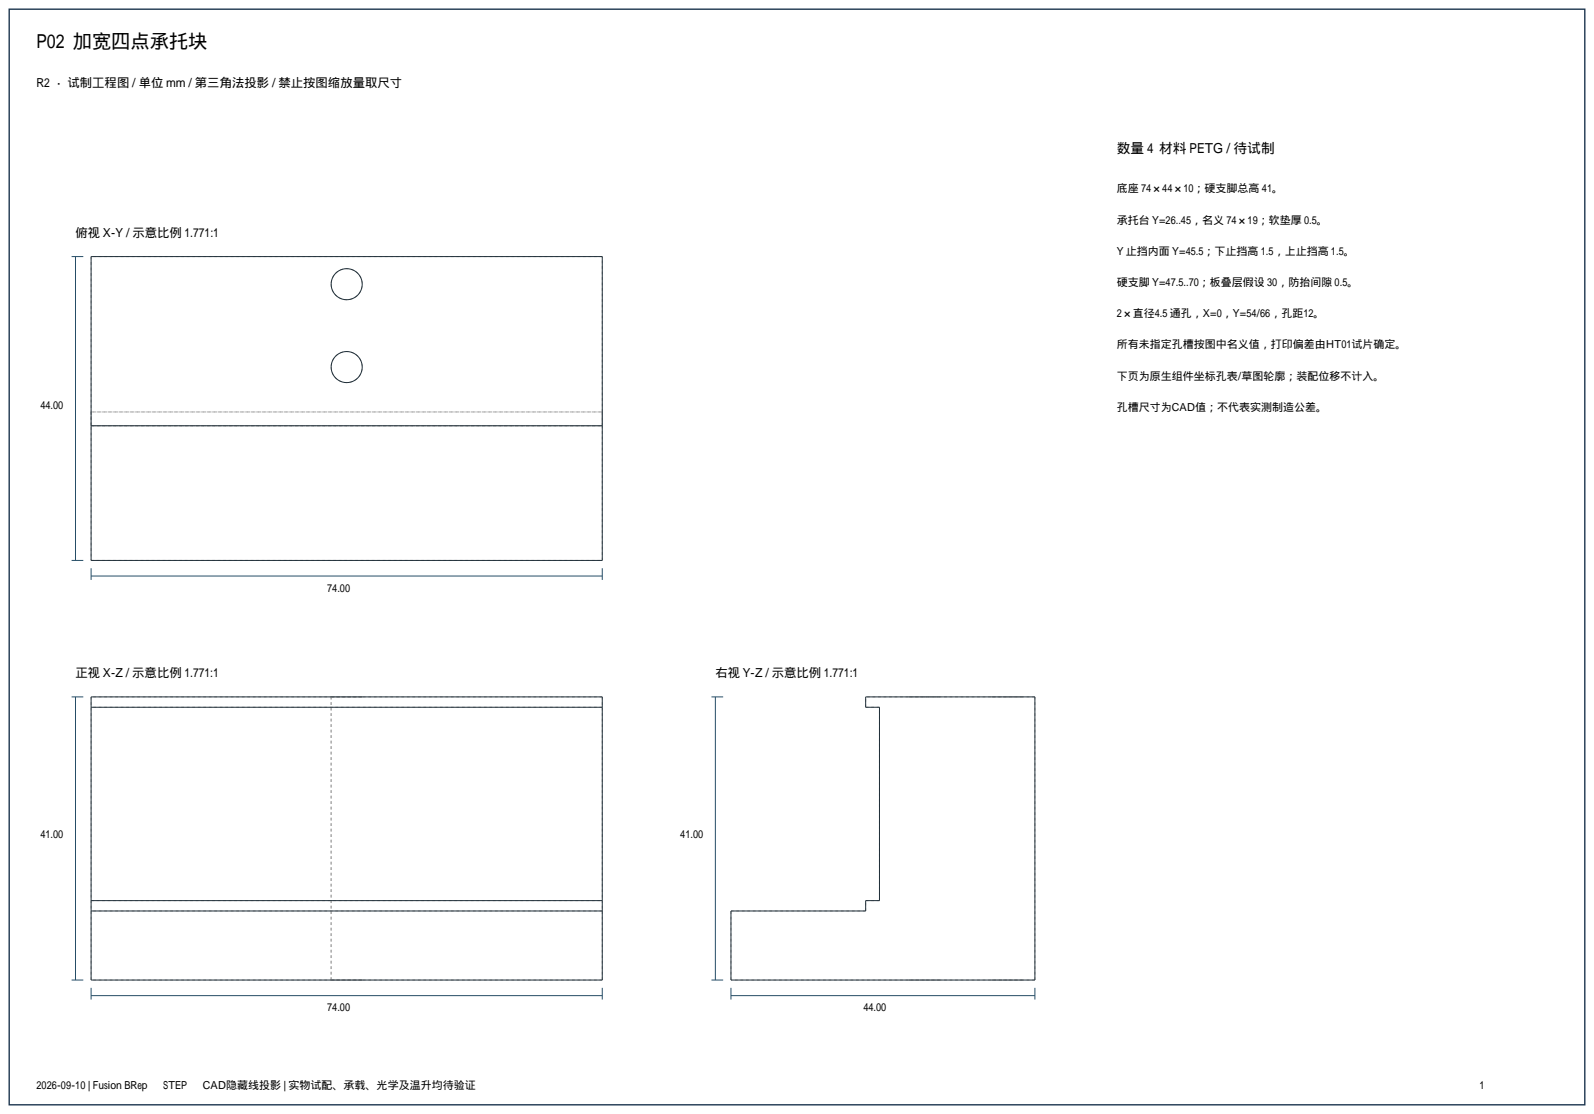
[picture p165: page 4]
俯视 X-Y / 示意比例 1.771:1; 正视 X-Z / 示意比例 1.771:1; 右视 Y-Z / 示意比例 1.771:1; 底座 74×44×10；硬支脚总高 41。; 所有未指定孔槽按图中名义值，打印偏差由HT01试片确定。; 孔槽尺寸为CAD值；不代表实测制造公差。

R2 · 试制工程图 / 单位 mm / 第三角法投影 / 禁止按图缩放量取尺寸

承托台 Y=26..45，名义 74×19；软垫厚 0.5。

Y 止挡内面 Y=45.5；下止挡高 1.5，上止挡高 1.5。

硬支脚 Y=47.5..70；板叠层假设 30，防抬间隙 0.5。

下页为原生组件坐标孔表/草图轮廓；装配位移不计入。

# P02 加宽四点承托块

### R2 · 试制工程图 / 单位 mm / 第三角法投影 / 禁止按图缩放量取尺寸

### 原生草图坐标说明：X 沿输送，Y 向后，Z 向上。圆为孔或圆轮廓；关联用途见特征名。

Support_pad_sketch [原生草图已约束]

轮廓顶点 (-37.0, 26.0, 194.5) | 轮廓顶点 (-37.0, 70.0, 194.5)
轮廓顶点 (37.0, 26.0, 194.5) | 轮廓顶点 (37.0, 70.0, 194.5)

Through_fasteners_1_sketch [原生草图已约束]

圆直径 4.500; 中心 (0.000, 54.000, 193.500)

Through_fasteners_2_sketch [原生草图已约束]

圆直径 4.500; 中心 (0.000, 66.000, 193.500)

Hard_standoff_sketch [原生草图已约束]

轮廓顶点 (-37.0, 47.5, 204.5) | 轮廓顶点 (-37.0, 70.0, 204.5)
轮廓顶点 (37.0, 47.5, 204.5) | 轮廓顶点 (37.0, 70.0, 204.5)

Lower_acrylic_Y_stop_sketch [原生草图已约束]

轮廓顶点 (-37.0, 45.5, 204.5) | 轮廓顶点 (-37.0, 47.5, 204.5)
轮廓顶点 (37.0, 45.5, 204.5) | 轮廓顶点 (37.0, 47.5, 204.5)

Upper_acrylic_Y_stop_sketch [原生草图已约束]

轮廓顶点 (-37.0, 45.5, 234.0) | 轮廓顶点 (-37.0, 47.5, 234.0)
轮廓顶点 (37.0, 45.5, 234.0) | 轮廓顶点 (37.0, 47.5, 234.0)

Standoff_through_bolts_1_sketch [原生草图已约束]

圆直径 4.500; 中心 (0.000, 54.000, 203.500)

Standoff_through_bolts_2_sketch [原生草图已约束]

圆直径 4.500; 中心 (0.000, 66.000, 203.500)

# P03_LB 上防脱及X止挡

## 数量 1 材料 PETG / 待试制

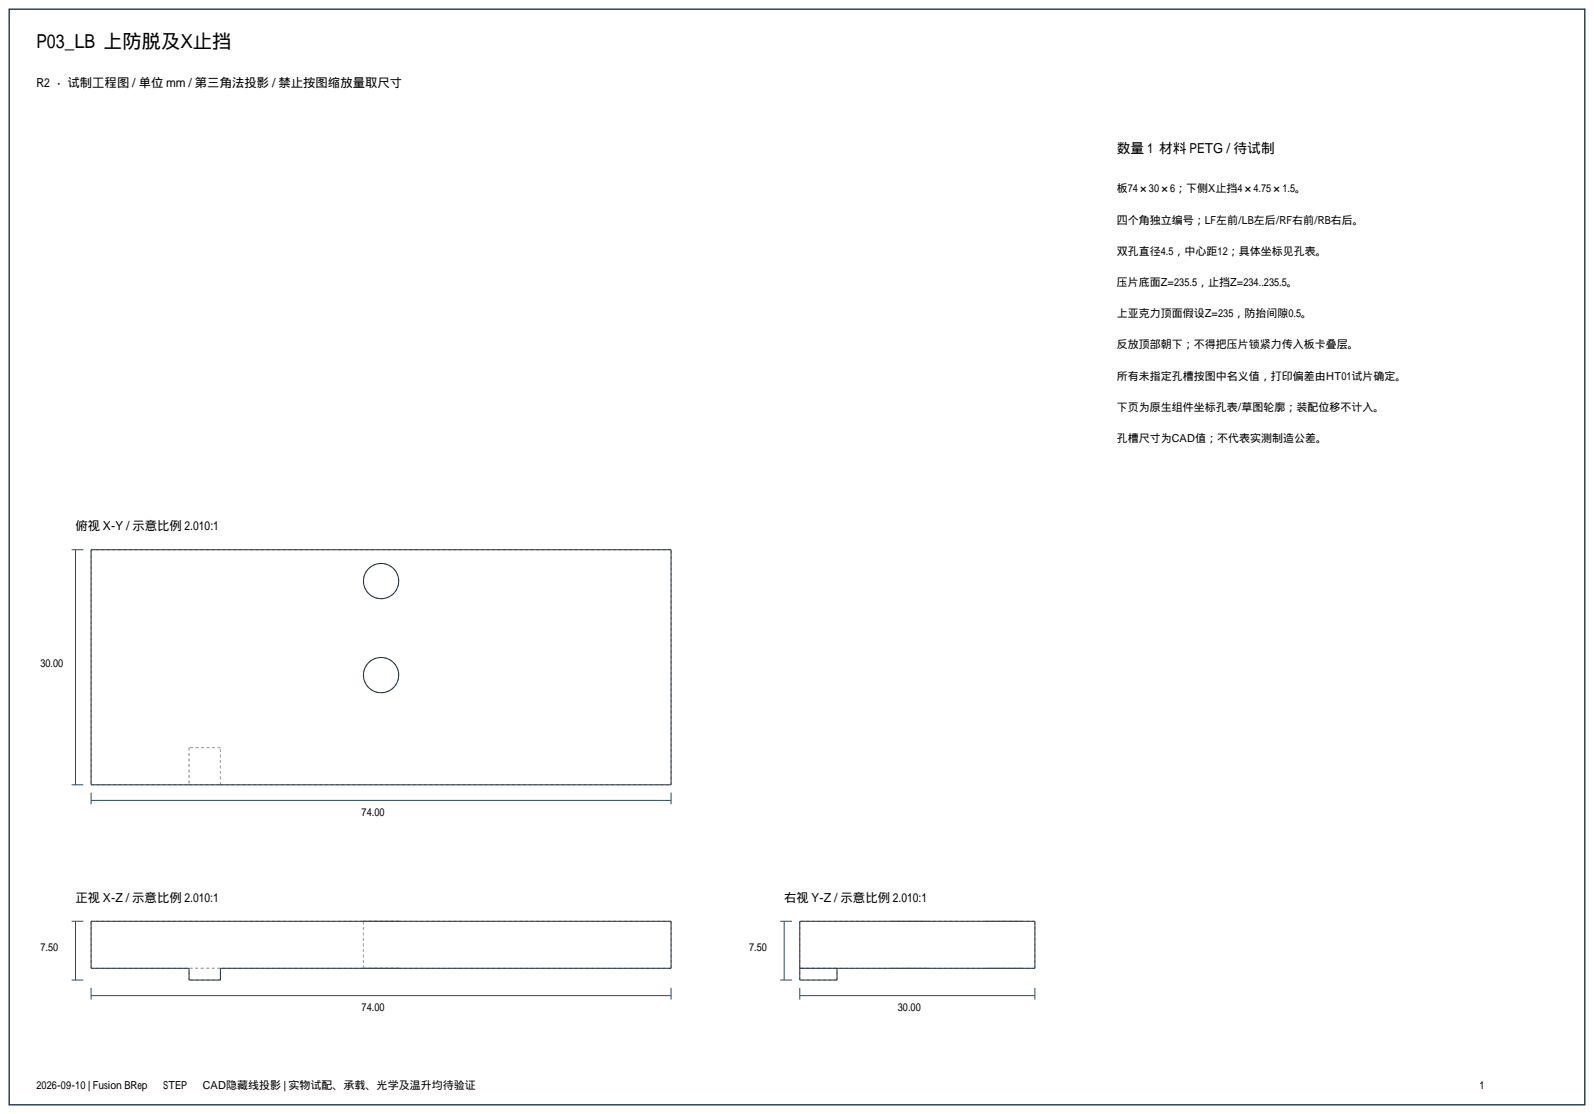
[picture p166: page 6]
俯视 X-Y / 示意比例 2.010:1; 正视 X-Z / 示意比例 2.010:1; 右视 Y-Z / 示意比例 2.010:1; 板74×30×6；下侧X止挡4×4.75×1.5。; 双孔直径4.5，中心距12；具体坐标见孔表。; 压片底面Z=235.5，止挡Z=234..235.5。; 上亚克力顶面假设Z=235，防抬间隙0.5。; 反放顶部朝下；不得把压片锁紧力传入板卡叠层。; 所有未指定孔槽按图中名义值，打印偏差由HT01试片确定。; 孔槽尺寸为CAD值；不代表实测制造公差。

R2 · 试制工程图 / 单位 mm / 第三角法投影 / 禁止按图缩放量取尺寸

四个角独立编号；LF左前/LB左后/RF右前/RB右后。

下页为原生组件坐标孔表/草图轮廓；装配位移不计入。

# P03_LB 上防脱及X止挡

### R2 · 试制工程图 / 单位 mm / 第三角法投影 / 禁止按图缩放量取尺寸

### 原生草图坐标说明：X 沿输送，Y 向后，Z 向上。圆为孔或圆轮廓；关联用途见特征名。

Top_retainer_sketch [原生草图已约束]

轮廓顶点 (-102.0, 40.0, 235.5) | 轮廓顶点 (-102.0, 70.0, 235.5)
轮廓顶点 (-28.0, 40.0, 235.5) | 轮廓顶点 (-28.0, 70.0, 235.5)

Upper_acrylic_X_stop_sketch [原生草图已约束]

轮廓顶点 (-89.5, 40.0, 234.0) | 轮廓顶点 (-89.5, 44.75, 234.0)
轮廓顶点 (-85.5, 40.0, 234.0) | 轮廓顶点 (-85.5, 44.75, 234.0)

Retainer_bolts_1_sketch [原生草图已约束]

圆直径 4.500; 中心 (-65.000, 54.000, 234.500)

Retainer_bolts_2_sketch [原生草图已约束]

圆直径 4.500; 中心 (-65.000, 66.000, 234.500)

# P03_LF 上防脱及X止挡

## 数量 1 材料 PETG / 待试制

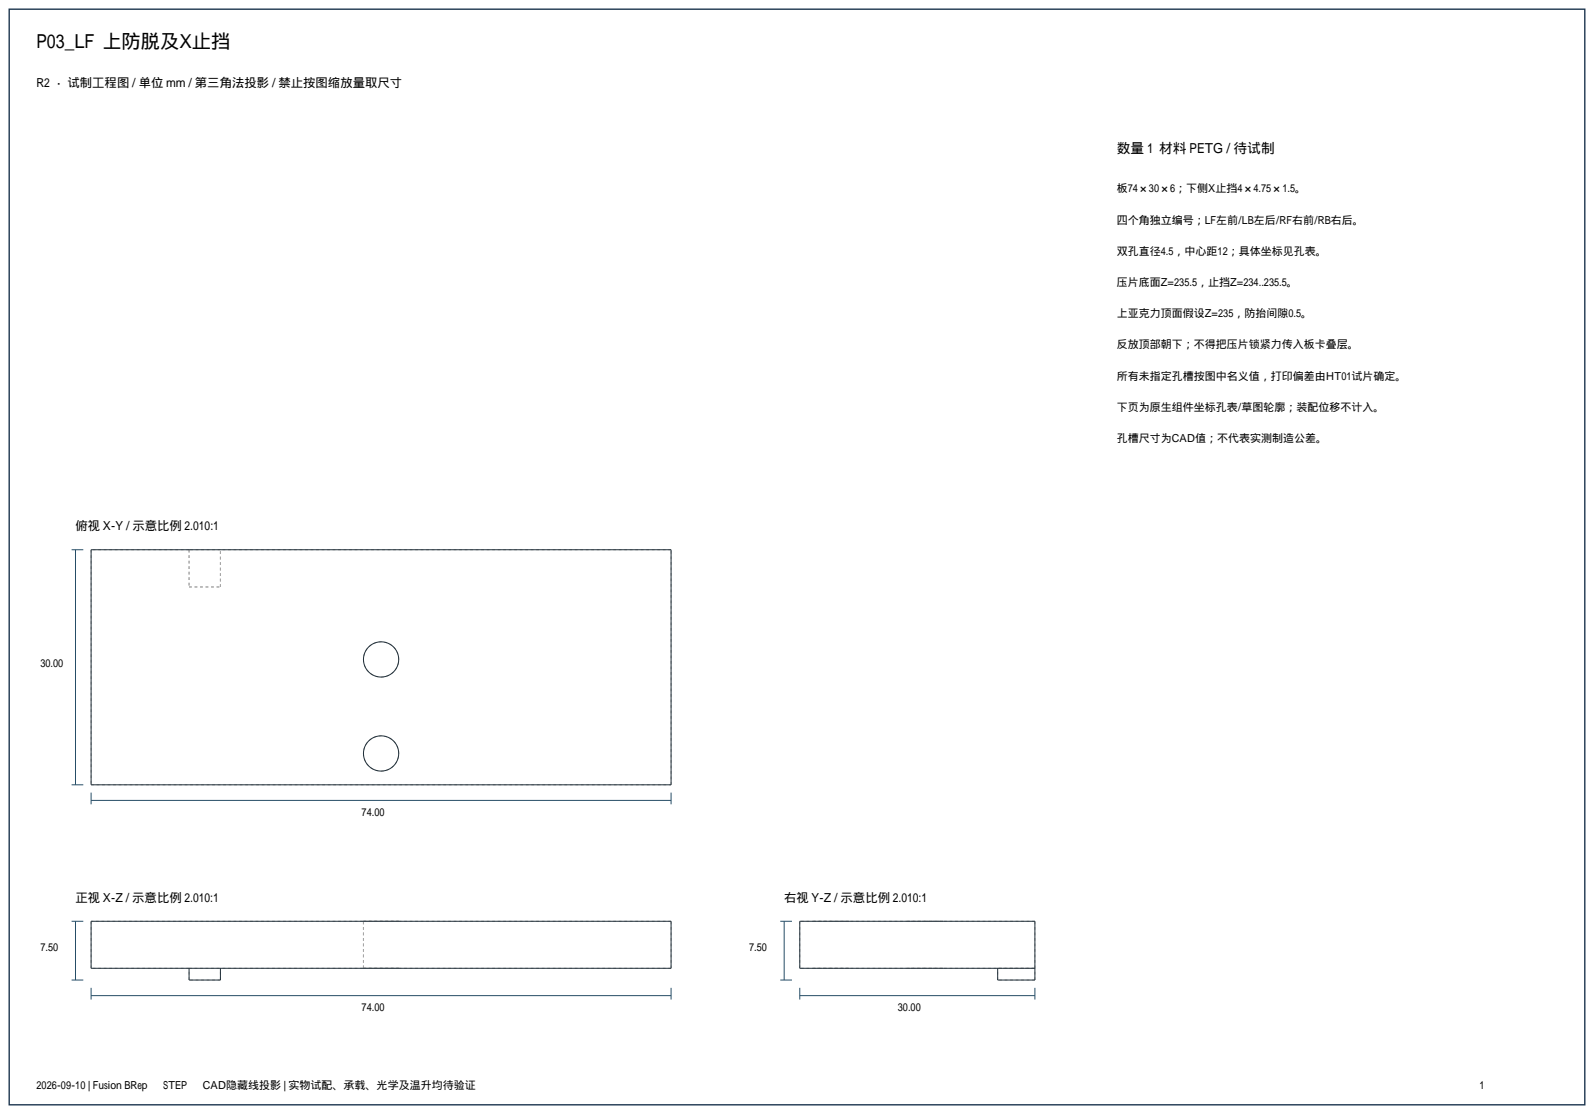
[picture p167: page 8]
俯视 X-Y / 示意比例 2.010:1; 正视 X-Z / 示意比例 2.010:1; 右视 Y-Z / 示意比例 2.010:1; 板74×30×6；下侧X止挡4×4.75×1.5。; 双孔直径4.5，中心距12；具体坐标见孔表。; 压片底面Z=235.5，止挡Z=234..235.5。; 上亚克力顶面假设Z=235，防抬间隙0.5。; 反放顶部朝下；不得把压片锁紧力传入板卡叠层。; 所有未指定孔槽按图中名义值，打印偏差由HT01试片确定。; 孔槽尺寸为CAD值；不代表实测制造公差。

R2 · 试制工程图 / 单位 mm / 第三角法投影 / 禁止按图缩放量取尺寸

四个角独立编号；LF左前/LB左后/RF右前/RB右后。

下页为原生组件坐标孔表/草图轮廓；装配位移不计入。

# P03_LF 上防脱及X止挡

### R2 · 试制工程图 / 单位 mm / 第三角法投影 / 禁止按图缩放量取尺寸

### 原生草图坐标说明：X 沿输送，Y 向后，Z 向上。圆为孔或圆轮廓；关联用途见特征名。

Top_retainer_sketch [原生草图已约束]

轮廓顶点 (-102.0, -70.0, 235.5) | 轮廓顶点 (-102.0, -40.0, 235.5)
轮廓顶点 (-28.0, -70.0, 235.5) | 轮廓顶点 (-28.0, -40.0, 235.5)

Upper_acrylic_X_stop_sketch [原生草图已约束]

轮廓顶点 (-89.5, -44.75, 234.0) | 轮廓顶点 (-89.5, -40.0, 234.0)
轮廓顶点 (-85.5, -44.75, 234.0) | 轮廓顶点 (-85.5, -40.0, 234.0)

Retainer_bolts_1_sketch [原生草图已约束]

圆直径 4.500; 中心 (-65.000, -54.000, 234.500)

Retainer_bolts_2_sketch [原生草图已约束]

圆直径 4.500; 中心 (-65.000, -66.000, 234.500)

# P03_RB 上防脱及X止挡

## 数量 1 材料 PETG / 待试制

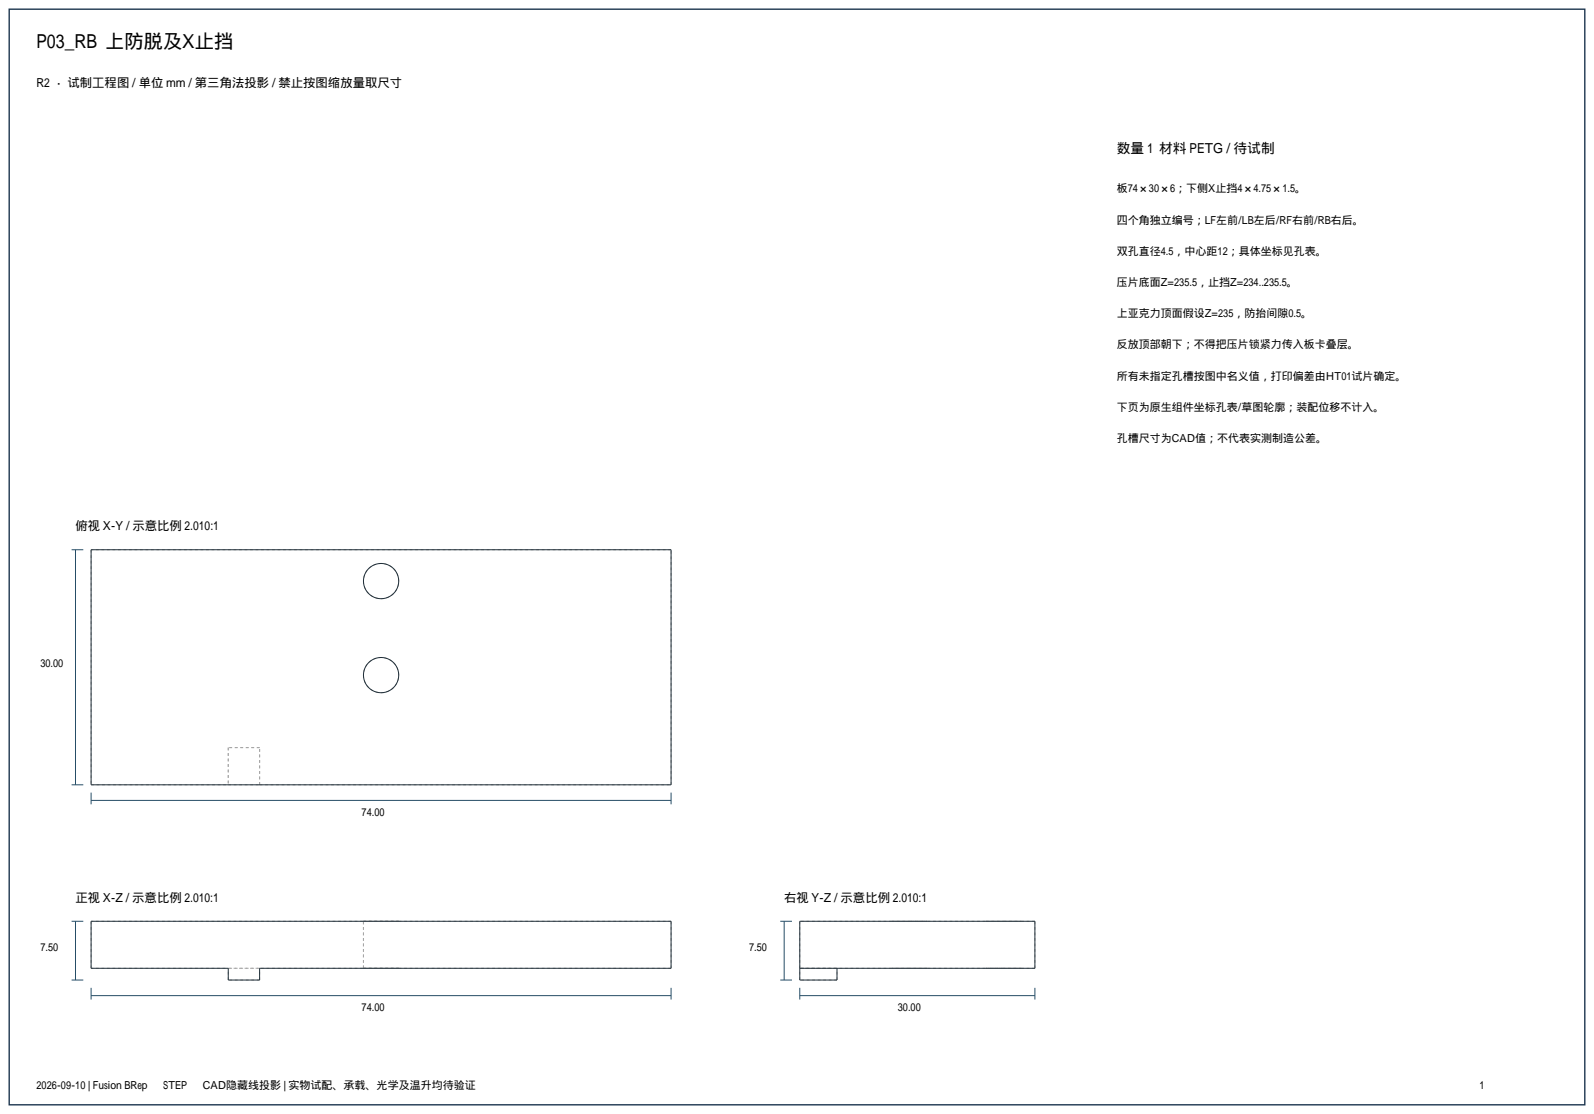
[picture p168: page 10]
俯视 X-Y / 示意比例 2.010:1; 正视 X-Z / 示意比例 2.010:1; 右视 Y-Z / 示意比例 2.010:1; 板74×30×6；下侧X止挡4×4.75×1.5。; 双孔直径4.5，中心距12；具体坐标见孔表。; 压片底面Z=235.5，止挡Z=234..235.5。; 上亚克力顶面假设Z=235，防抬间隙0.5。; 反放顶部朝下；不得把压片锁紧力传入板卡叠层。; 所有未指定孔槽按图中名义值，打印偏差由HT01试片确定。; 孔槽尺寸为CAD值；不代表实测制造公差。

R2 · 试制工程图 / 单位 mm / 第三角法投影 / 禁止按图缩放量取尺寸

四个角独立编号；LF左前/LB左后/RF右前/RB右后。

下页为原生组件坐标孔表/草图轮廓；装配位移不计入。

# P03_RB 上防脱及X止挡

### R2 · 试制工程图 / 单位 mm / 第三角法投影 / 禁止按图缩放量取尺寸

### 原生草图坐标说明：X 沿输送，Y 向后，Z 向上。圆为孔或圆轮廓；关联用途见特征名。

Top_retainer_sketch [原生草图已约束]

轮廓顶点 (28.0, 40.0, 235.5) | 轮廓顶点 (28.0, 70.0, 235.5)
轮廓顶点 (102.0, 40.0, 235.5) | 轮廓顶点 (102.0, 70.0, 235.5)

Upper_acrylic_X_stop_sketch [原生草图已约束]

轮廓顶点 (45.5, 40.0, 234.0) | 轮廓顶点 (45.5, 44.75, 234.0)
轮廓顶点 (49.5, 40.0, 234.0) | 轮廓顶点 (49.5, 44.75, 234.0)

Retainer_bolts_1_sketch [原生草图已约束]

圆直径 4.500; 中心 (65.000, 54.000, 234.500)

Retainer_bolts_2_sketch [原生草图已约束]

圆直径 4.500; 中心 (65.000, 66.000, 234.500)

# P03_RF 上防脱及X止挡

## 数量 1 材料 PETG / 待试制

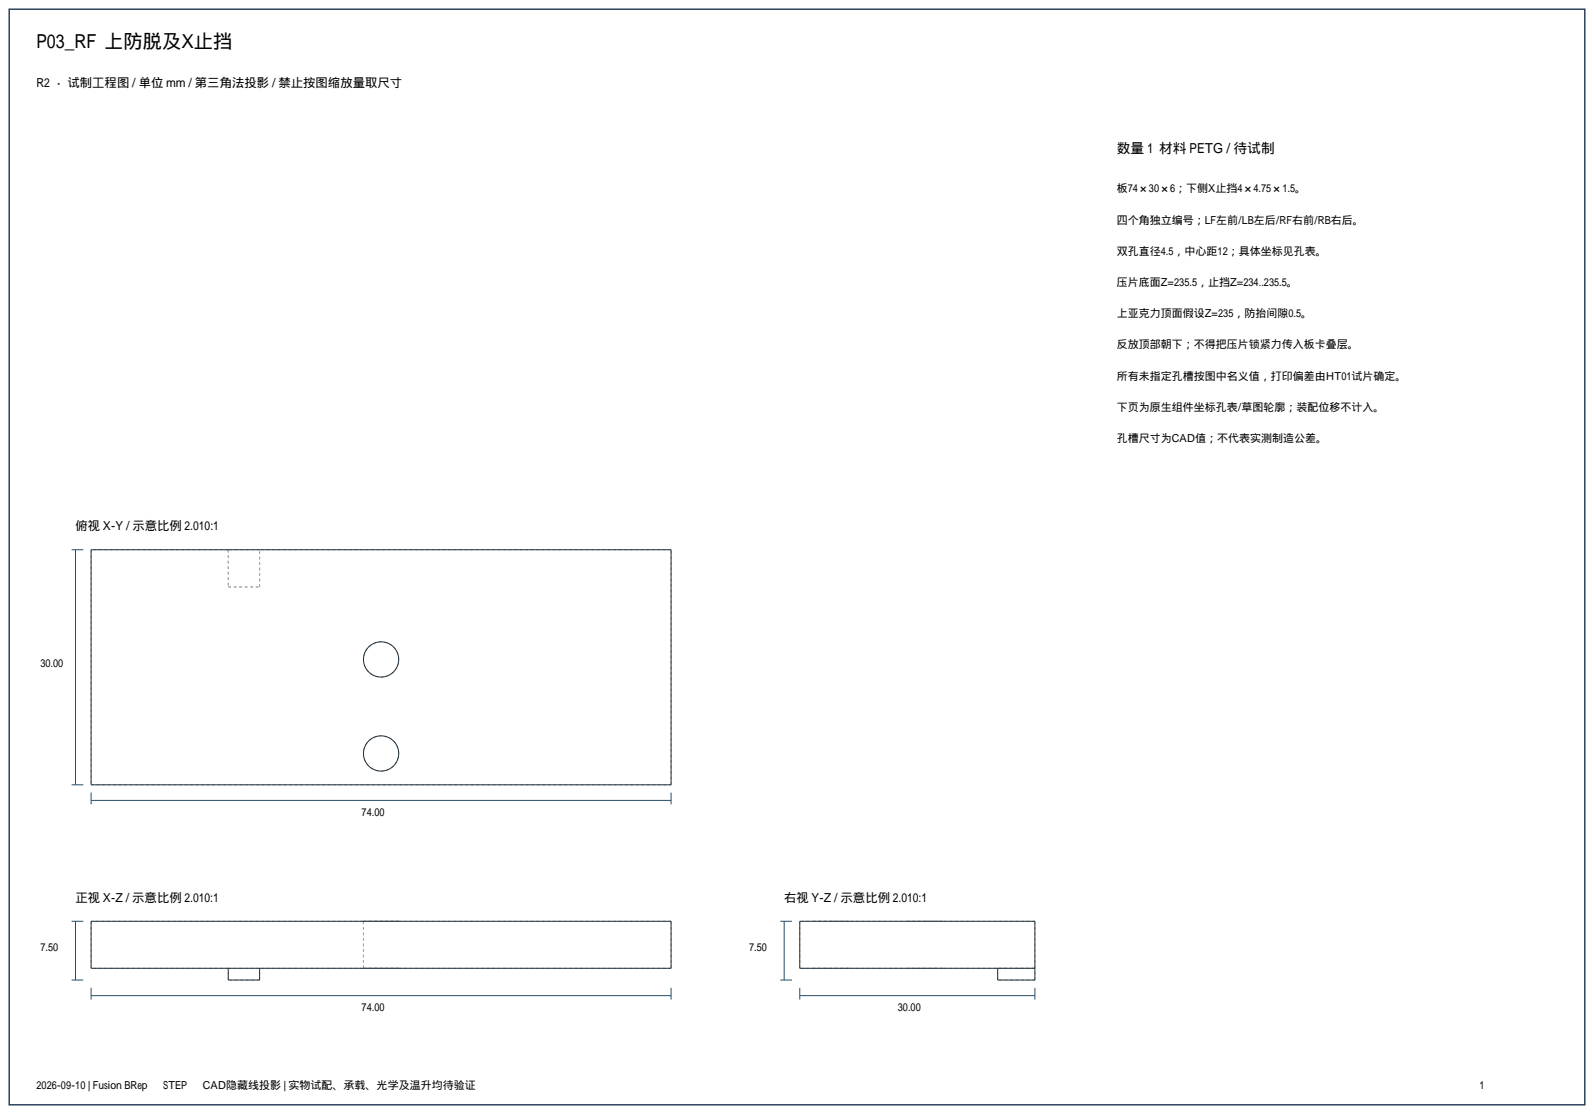
[picture p169: page 12]
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

R2 · 试制工程图 / 单位 mm / 第三角法投影 / 禁止按图缩放量取尺寸

四个角独立编号；LF左前/LB左后/RF右前/RB右后。

下页为原生组件坐标孔表/草图轮廓；装配位移不计入。

# P03_RF 上防脱及X止挡

### R2 · 试制工程图 / 单位 mm / 第三角法投影 / 禁止按图缩放量取尺寸

### 原生草图坐标说明：X 沿输送，Y 向后，Z 向上。圆为孔或圆轮廓；关联用途见特征名。

Top_retainer_sketch [原生草图已约束]

轮廓顶点 (28.0, -70.0, 235.5) | 轮廓顶点 (28.0, -40.0, 235.5)
轮廓顶点 (102.0, -70.0, 235.5) | 轮廓顶点 (102.0, -40.0, 235.5)

Upper_acrylic_X_stop_sketch [原生草图已约束]

轮廓顶点 (45.5, -44.75, 234.0) | 轮廓顶点 (45.5, -40.0, 234.0)
轮廓顶点 (49.5, -44.75, 234.0) | 轮廓顶点 (49.5, -40.0, 234.0)

Retainer_bolts_1_sketch [原生草图已约束]

圆直径 4.500; 中心 (65.000, -54.000, 234.500)

Retainer_bolts_2_sketch [原生草图已约束]

圆直径 4.500; 中心 (65.000, -66.000, 234.500)

# P04 开放背槽竖导板

## 数量 2 材料 PETG / 待试制

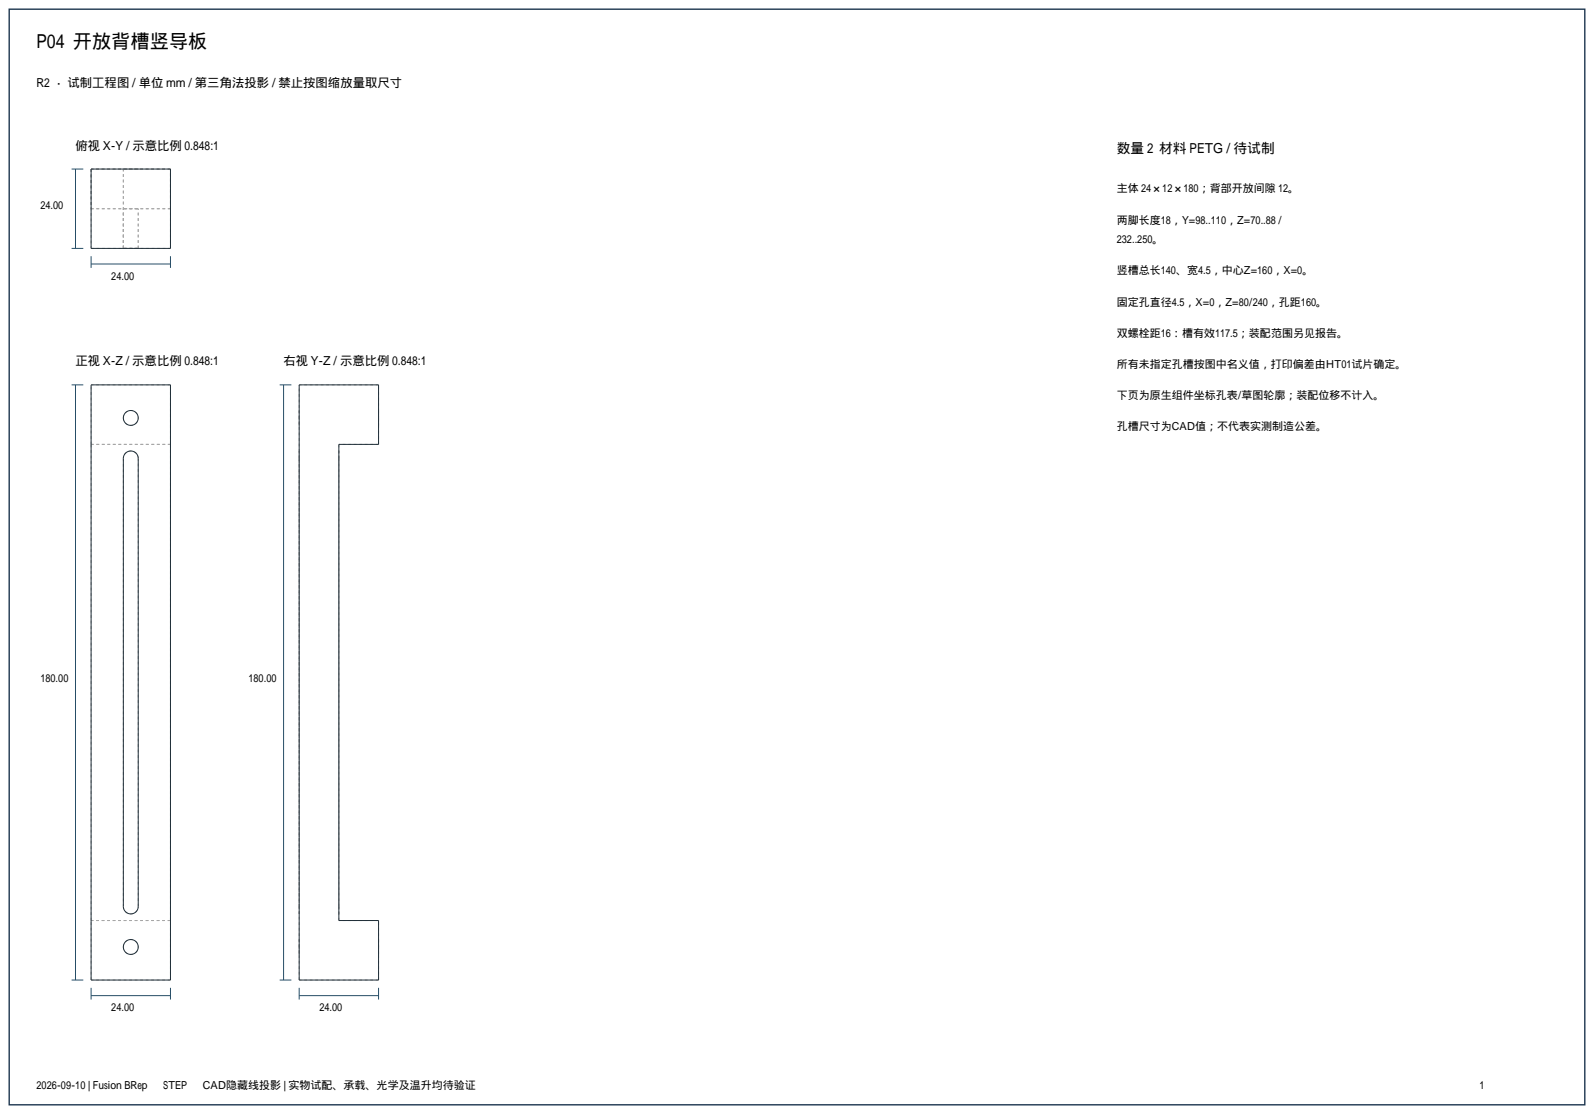
[picture p170: page 14]
俯视 X-Y / 示意比例 0.848:1; 正视 X-Z / 示意比例 0.848:1; 右视 Y-Z / 示意比例 0.848:1; 主体 24×12×180；背部开放间隙 12。; 两脚长度18，Y=98..110，Z=70..88 /; 竖槽总长140、宽4.5，中心Z=160，X=0。; 固定孔直径4.5，X=0，Z=80/240，孔距160。; 双螺栓距16：槽有效117.5；装配范围另见报告。; 所有未指定孔槽按图中名义值，打印偏差由HT01试片确定。; 孔槽尺寸为CAD值；不代表实测制造公差。

R2 · 试制工程图 / 单位 mm / 第三角法投影 / 禁止按图缩放量取尺寸

下页为原生组件坐标孔表/草图轮廓；装配位移不计入。

# P04 开放背槽竖导板

### R2 · 试制工程图 / 单位 mm / 第三角法投影 / 禁止按图缩放量取尺寸

### 原生草图坐标说明：X 沿输送，Y 向后，Z 向上。圆为孔或圆轮廓；关联用途见特征名。

Guide_plate_sketch [原生草图已约束]

轮廓顶点 (-12.0, 86.0, 70.0) | 轮廓顶点 (-12.0, 98.0, 70.0)
轮廓顶点 (12.0, 86.0, 70.0) | 轮廓顶点 (12.0, 98.0, 70.0)

Lower_standoff_sketch [原生草图已约束]

轮廓顶点 (-12.0, 98.0, 70.0) | 轮廓顶点 (-12.0, 110.0, 70.0)
轮廓顶点 (12.0, 98.0, 70.0) | 轮廓顶点 (12.0, 110.0, 70.0)

Upper_standoff_sketch [原生草图已约束]

轮廓顶点 (-12.0, 98.0, 232.0) | 轮廓顶点 (-12.0, 110.0, 232.0)
轮廓顶点 (12.0, 98.0, 232.0) | 轮廓顶点 (12.0, 110.0, 232.0)

Vertical_adjustment_0_sketch [原生草图已约束]

轮廓顶点 (-2.25, 85.0, 92.25) | 轮廓顶点 (-2.25, 85.0, 227.75)
轮廓顶点 (2.25, 85.0, 92.25) | 轮廓顶点 (2.25, 85.0, 227.75)

Vertical_adjustment_0_ends_1_sketch [原生草图已约束]

圆直径 4.500; 中心 (0.000, 85.000, 92.250)

Vertical_adjustment_0_ends_2_sketch [原生草图已约束]

圆直径 4.500; 中心 (0.000, 85.000, 227.750)

Fixed_wood_bolts_1_sketch [原生草图已约束]

圆直径 4.500; 中心 (0.000, 85.000, 80.000)

Fixed_wood_bolts_2_sketch [原生草图已约束]

圆直径 4.500; 中心 (0.000, 85.000, 240.000)

# P05 双螺栓灯托臂

## 数量 2 材料 PETG / 待试制

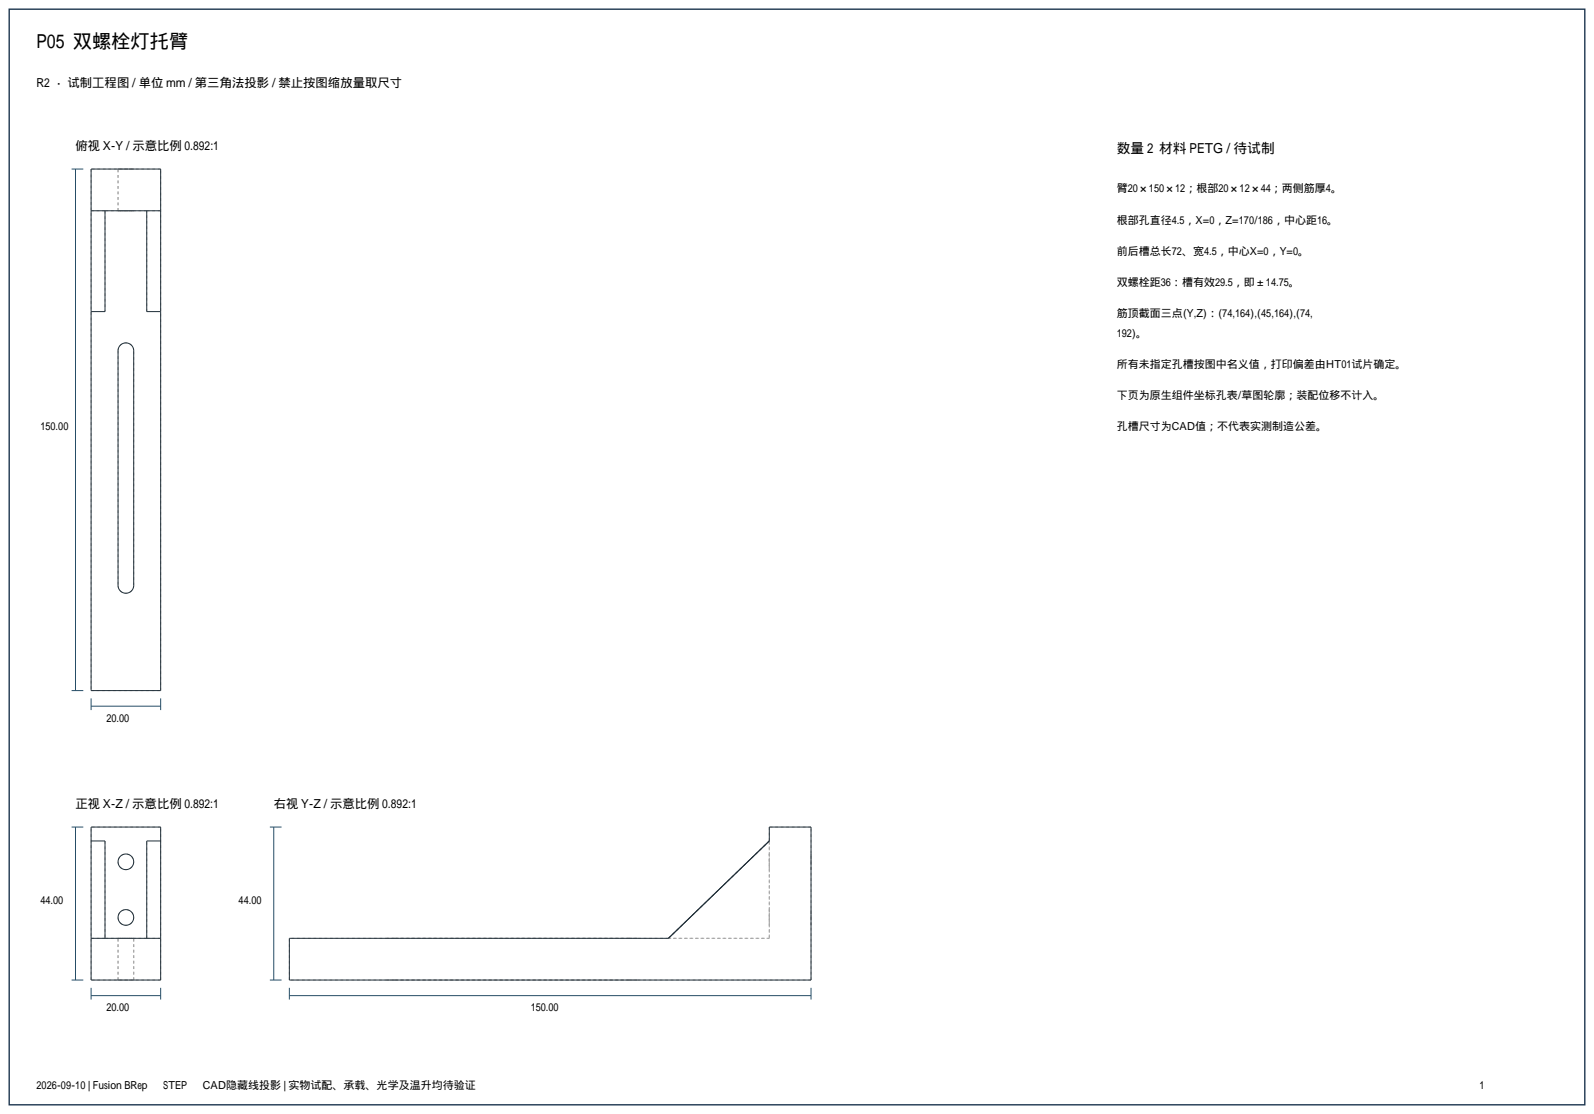
[picture p171: page 16]
俯视 X-Y / 示意比例 0.892:1; 正视 X-Z / 示意比例 0.892:1; 右视 Y-Z / 示意比例 0.892:1; 臂20×150×12；根部20×12×44；两侧筋厚4。; 根部孔直径4.5，X=0，Z=170/186，中心距16。; 前后槽总长72、宽4.5，中心X=0，Y=0。; 双螺栓距36：槽有效29.5，即±14.75。; 筋顶截面三点(Y,Z)：(74,164),(45,164),(74,; 所有未指定孔槽按图中名义值，打印偏差由HT01试片确定。; 孔槽尺寸为CAD值；不代表实测制造公差。

R2 · 试制工程图 / 单位 mm / 第三角法投影 / 禁止按图缩放量取尺寸

下页为原生组件坐标孔表/草图轮廓；装配位移不计入。

# P05 双螺栓灯托臂

### R2 · 试制工程图 / 单位 mm / 第三角法投影 / 禁止按图缩放量取尺寸

### 原生草图坐标说明：X 沿输送，Y 向后，Z 向上。圆为孔或圆轮廓；关联用途见特征名。

Lamp_arm_sketch [原生草图已约束]

轮廓顶点 (-10.0, -64.0, 152.0) | 轮廓顶点 (-10.0, 86.0, 152.0)
轮廓顶点 (10.0, -64.0, 152.0) | 轮廓顶点 (10.0, 86.0, 152.0)

Lamp_root_sketch [原生草图已约束]

轮廓顶点 (-10.0, 74.0, 152.0) | 轮廓顶点 (-10.0, 86.0, 152.0)
轮廓顶点 (10.0, 74.0, 152.0) | 轮廓顶点 (10.0, 86.0, 152.0)

Top_rib_-10_sketch [原生草图已约束]

轮廓顶点 (-10.0, 45.0, 164.0) | 轮廓顶点 (-10.0, 74.0, 164.0)

轮廓顶点 (-10.0, 74.0, 192.0)

Top_rib_6_sketch [原生草图已约束]

轮廓顶点 (6.0, 45.0, 164.0) | 轮廓顶点 (6.0, 74.0, 164.0)

轮廓顶点 (6.0, 74.0, 192.0)

Fore_aft_slot_0_sketch [原生草图已约束]

轮廓顶点 (-2.25, -33.75, 151.0) | 轮廓顶点 (-2.25, 33.75, 151.0)
轮廓顶点 (2.25, -33.75, 151.0) | 轮廓顶点 (2.25, 33.75, 151.0)

Fore_aft_slot_0_ends_1_sketch [原生草图已约束]

圆直径 4.500; 中心 (0.000, -33.750, 151.000)

Fore_aft_slot_0_ends_2_sketch [原生草图已约束]

圆直径 4.500; 中心 (0.000, 33.750, 151.000)

Twin_height_bolts_1_sketch [原生草图已约束]

圆直径 4.500; 中心 (0.000, 73.000, 170.000)

Twin_height_bolts_2_sketch [原生草图已约束]

圆直径 4.500; 中心 (0.000, 73.000, 186.000)

# P06A 分体灯夹圈

## 数量 1 材料 PETG / 待试制

俯视 X-Y / 示意比例 1.097:1; 正视 X-Z / 示意比例 1.097:1; 右视 Y-Z / 示意比例 1.097:1; 主体内径91、外径110、高16；初始总分缝2。; 灯假设外径90，软衬径向厚0.5，软衬不是PETG。; 夹紧孔直径4.5，轴Y，X=±61，Z=156。; 连接加厚圆直径14，孔直径4.5，X=±48，Y=±18。; 窗口宽16×高8；Z=152..160，保留连续接触区。; 闭合止挡4×0.5×4，闭合总缝下限1；不可继续强拧。; 所有未指定孔槽按图中名义值，打印偏差由HT01试片确定。; 孔槽尺寸为CAD值；不代表实测制造公差。

R2 · 试制工程图 / 单位 mm / 第三角法投影 / 禁止按图缩放量取尺寸

需实测夹持、防滑、线口、散热；允许试配，未验收。

下页为原生组件坐标孔表/草图轮廓；装配位移不计入。

# P06A 分体灯夹圈

### R2 · 试制工程图 / 单位 mm / 第三角法投影 / 禁止按图缩放量取尺寸

### 原生草图坐标说明：X 沿输送，Y 向后，Z 向上。圆为孔或圆轮廓；关联用途见特征名。

Annular_clamp_sketch [原生草图已约束]

圆直径 110.000; 中心 (0.000, 0.000, 148.000)

Annular_clamp_bore_1_sketch [原生草图已约束]

圆直径 91.000; 中心 (0.000, 0.000, 148.000)

Split_gap_sketch [原生草图已约束]

轮廓顶点 (-80.0, -80.0, 147.0) | 轮廓顶点 (-80.0, 1.0, 147.0)
轮廓顶点 (80.0, -80.0, 147.0) | 轮廓顶点 (80.0, 1.0, 147.0)

Clamp_ear_-68_sketch [原生草图已约束]

轮廓顶点 (-68.0, 1.0, 148.0) | 轮廓顶点 (-68.0, 13.0, 148.0)
轮廓顶点 (-48.0, 1.0, 148.0) | 轮廓顶点 (-48.0, 13.0, 148.0)

Clamp_ear_48_sketch [原生草图已约束]

轮廓顶点 (48.0, 1.0, 148.0) | 轮廓顶点 (48.0, 13.0, 148.0)
轮廓顶点 (68.0, 1.0, 148.0) | 轮廓顶点 (68.0, 13.0, 148.0)

Reinforced_mount_-48_sketch [原生草图已约束]

圆直径 14.000; 中心 (-48.000, 18.000, 148.000)

Reinforced_mount_48_sketch [原生草图已约束]

圆直径 14.000; 中心 (48.000, 18.000, 148.000)

Preserve_housing_clearance_sketch [原生草图已约束]

圆直径 91.000; 中心 (0.000, 0.000, 147.000)

Bridge_mounts_1_sketch [原生草图已约束]

圆直径 4.500; 中心 (-48.000, 18.000, 147.000)

Bridge_mounts_2_sketch [原生草图已约束]

圆直径 4.500; 中心 (48.000, 18.000, 147.000)

Clamp_screws_1_sketch [原生草图已约束]

圆直径 4.500; 中心 (-61.000, -14.000, 156.000)

Clamp_screws_2_sketch [原生草图已约束]

圆直径 4.500; 中心 (61.000, -14.000, 156.000)

Closure_limit_-54_sketch [原生草图已约束]

轮廓顶点 (-54.0, 0.5, 148.0) | 轮廓顶点 (-54.0, 1.0, 148.0)
轮廓顶点 (-50.0, 0.5, 148.0) | 轮廓顶点 (-50.0, 1.0, 148.0)

# P06A 分体灯夹圈

### R2 · 试制工程图 / 单位 mm / 第三角法投影 / 禁止按图缩放量取尺寸

Closure_limit_50_sketch [原生草图已约束]

轮廓顶点 (50.0, 0.5, 148.0) | 轮廓顶点 (50.0, 1.0, 148.0)
轮廓顶点 (54.0, 0.5, 148.0) | 轮廓顶点 (54.0, 1.0, 148.0)

Straight_cable_vent_window_sketch [原生草图已约束]

轮廓顶点 (-8.0, 42.0, 152.0) | 轮廓顶点 (-8.0, 60.0, 152.0)
轮廓顶点 (8.0, 42.0, 152.0) | 轮廓顶点 (8.0, 60.0, 152.0)

# P06B 分体灯夹圈

## 数量 1 材料 PETG / 待试制

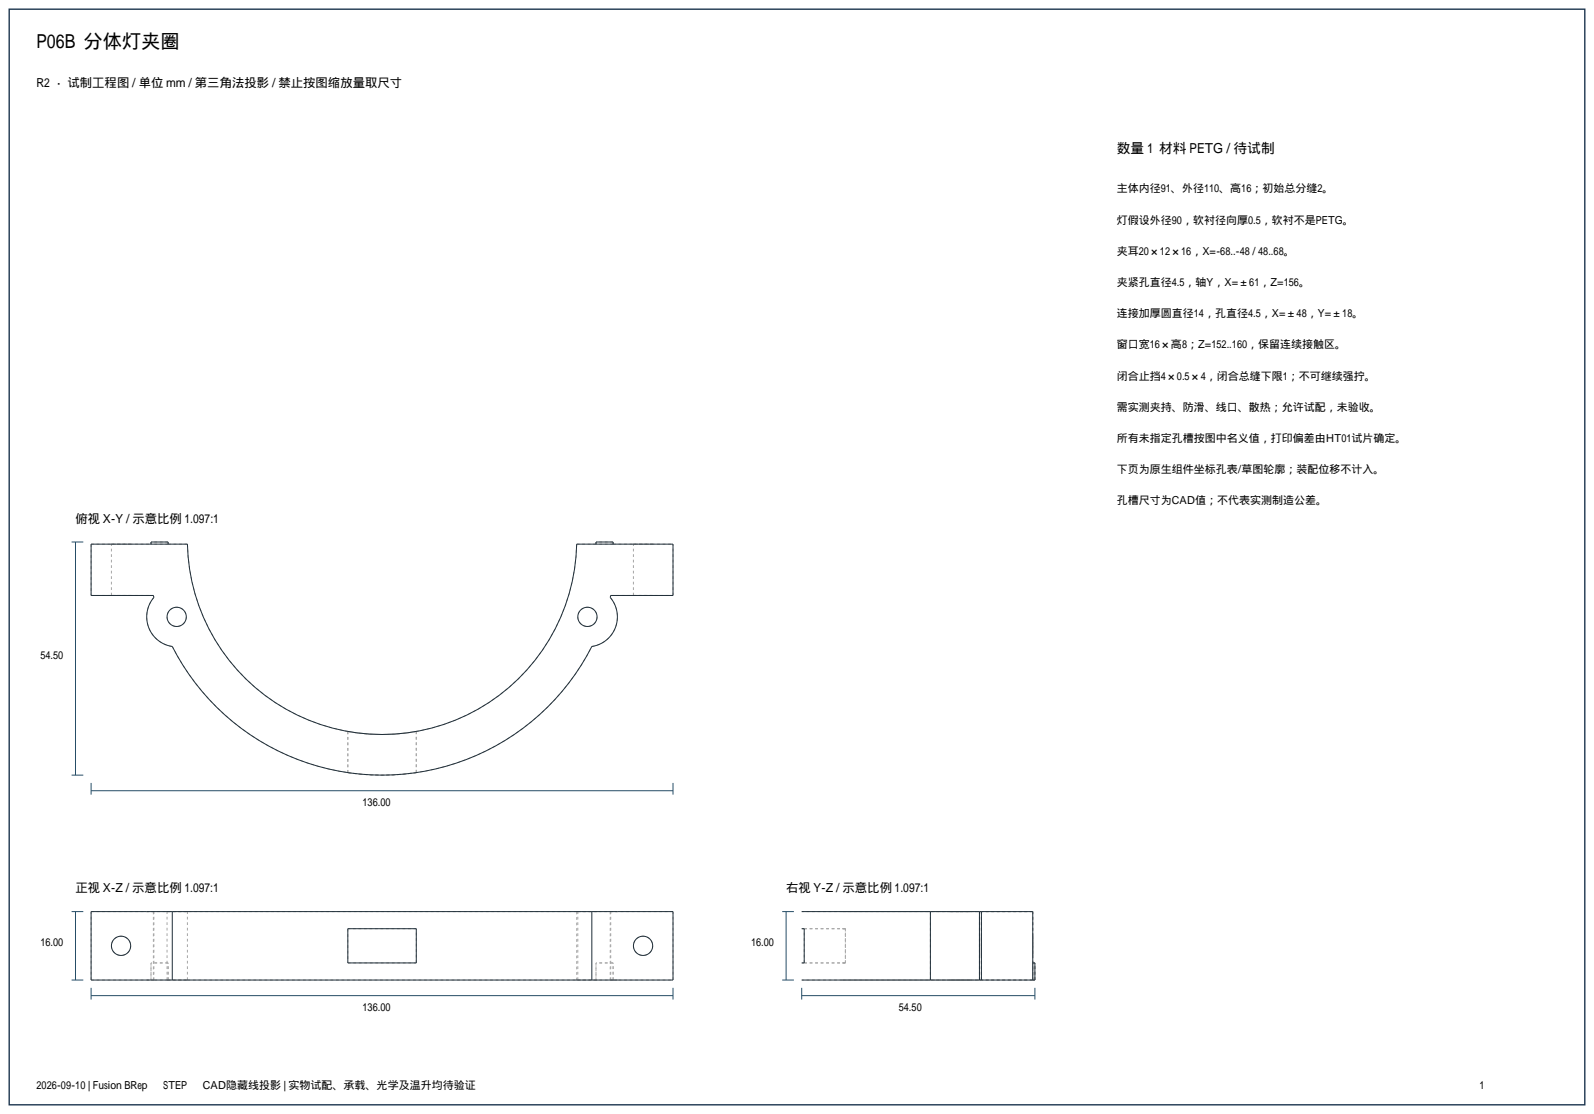
[picture p172: page 21]
俯视 X-Y / 示意比例 1.097:1; 正视 X-Z / 示意比例 1.097:1; 右视 Y-Z / 示意比例 1.097:1; 主体内径91、外径110、高16；初始总分缝2。; 灯假设外径90，软衬径向厚0.5，软衬不是PETG。; 夹紧孔直径4.5，轴Y，X=±61，Z=156。; 连接加厚圆直径14，孔直径4.5，X=±48，Y=±18。; 窗口宽16×高8；Z=152..160，保留连续接触区。; 闭合止挡4×0.5×4，闭合总缝下限1；不可继续强拧。; 所有未指定孔槽按图中名义值，打印偏差由HT01试片确定。; 孔槽尺寸为CAD值；不代表实测制造公差。

R2 · 试制工程图 / 单位 mm / 第三角法投影 / 禁止按图缩放量取尺寸

需实测夹持、防滑、线口、散热；允许试配，未验收。

下页为原生组件坐标孔表/草图轮廓；装配位移不计入。

# P06B 分体灯夹圈

### R2 · 试制工程图 / 单位 mm / 第三角法投影 / 禁止按图缩放量取尺寸

### 原生草图坐标说明：X 沿输送，Y 向后，Z 向上。圆为孔或圆轮廓；关联用途见特征名。

Annular_clamp_sketch [原生草图已约束]

圆直径 110.000; 中心 (0.000, 0.000, 148.000)

Annular_clamp_bore_1_sketch [原生草图已约束]

圆直径 91.000; 中心 (0.000, 0.000, 148.000)

Split_gap_sketch [原生草图已约束]

轮廓顶点 (-80.0, -1.0, 147.0) | 轮廓顶点 (-80.0, 80.0, 147.0)
轮廓顶点 (80.0, -1.0, 147.0) | 轮廓顶点 (80.0, 80.0, 147.0)

Clamp_ear_-68_sketch [原生草图已约束]

轮廓顶点 (-68.0, -13.0, 148.0) | 轮廓顶点 (-68.0, -1.0, 148.0)
轮廓顶点 (-48.0, -13.0, 148.0) | 轮廓顶点 (-48.0, -1.0, 148.0)

Clamp_ear_48_sketch [原生草图已约束]

轮廓顶点 (48.0, -13.0, 148.0) | 轮廓顶点 (48.0, -1.0, 148.0)
轮廓顶点 (68.0, -13.0, 148.0) | 轮廓顶点 (68.0, -1.0, 148.0)

Reinforced_mount_-48_sketch [原生草图已约束]

圆直径 14.000; 中心 (-48.000, -18.000, 148.000)

Reinforced_mount_48_sketch [原生草图已约束]

圆直径 14.000; 中心 (48.000, -18.000, 148.000)

Preserve_housing_clearance_sketch [原生草图已约束]

圆直径 91.000; 中心 (0.000, 0.000, 147.000)

Bridge_mounts_1_sketch [原生草图已约束]

圆直径 4.500; 中心 (-48.000, -18.000, 147.000)

Bridge_mounts_2_sketch [原生草图已约束]

圆直径 4.500; 中心 (48.000, -18.000, 147.000)

Clamp_screws_1_sketch [原生草图已约束]

圆直径 4.500; 中心 (-61.000, -14.000, 156.000)

Clamp_screws_2_sketch [原生草图已约束]

圆直径 4.500; 中心 (61.000, -14.000, 156.000)

Closure_limit_-54_sketch [原生草图已约束]

轮廓顶点 (-54.0, -1.0, 148.0) | 轮廓顶点 (-54.0, -0.5, 148.0)
轮廓顶点 (-50.0, -1.0, 148.0) | 轮廓顶点 (-50.0, -0.5, 148.0)

# P06B 分体灯夹圈

### R2 · 试制工程图 / 单位 mm / 第三角法投影 / 禁止按图缩放量取尺寸

Closure_limit_50_sketch [原生草图已约束]

轮廓顶点 (50.0, -1.0, 148.0) | 轮廓顶点 (50.0, -0.5, 148.0)
轮廓顶点 (54.0, -1.0, 148.0) | 轮廓顶点 (54.0, -0.5, 148.0)

Straight_cable_vent_window_sketch [原生草图已约束]

轮廓顶点 (-8.0, -60.0, 152.0) | 轮廓顶点 (-8.0, -42.0, 152.0)
轮廓顶点 (8.0, -60.0, 152.0) | 轮廓顶点 (8.0, -42.0, 152.0)

# P07_L 灯圈连接板

## 数量 1 材料 PETG / 待试制

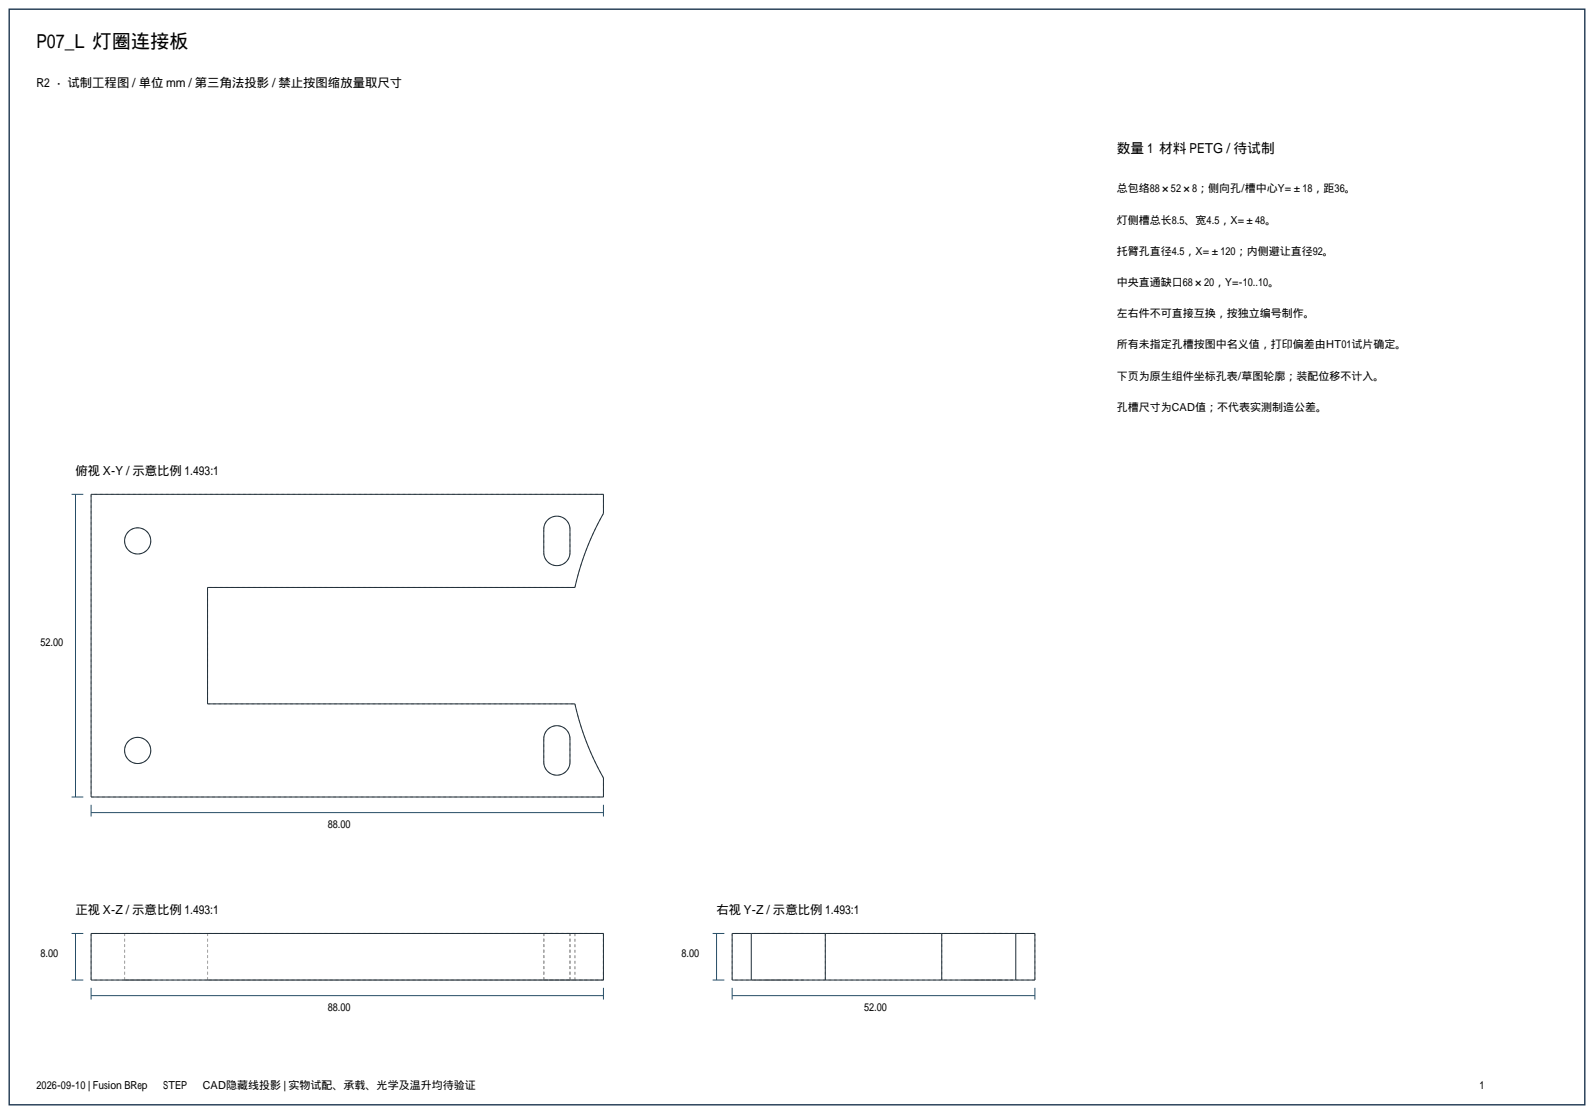
[picture p173: page 24]
俯视 X-Y / 示意比例 1.493:1; 正视 X-Z / 示意比例 1.493:1; 右视 Y-Z / 示意比例 1.493:1; 总包络88×52×8；侧向孔/槽中心Y=±18，距36。; 灯侧槽总长8.5、宽4.5，X=±48。; 托臂孔直径4.5，X=±120；内侧避让直径92。; 中央直通缺口68×20，Y=-10..10。; 左右件不可直接互换，按独立编号制作。; 所有未指定孔槽按图中名义值，打印偏差由HT01试片确定。; 孔槽尺寸为CAD值；不代表实测制造公差。

R2 · 试制工程图 / 单位 mm / 第三角法投影 / 禁止按图缩放量取尺寸

下页为原生组件坐标孔表/草图轮廓；装配位移不计入。

# P07_L 灯圈连接板

### R2 · 试制工程图 / 单位 mm / 第三角法投影 / 禁止按图缩放量取尺寸

### 原生草图坐标说明：X 沿输送，Y 向后，Z 向上。圆为孔或圆轮廓；关联用途见特征名。

Bridge_plate_sketch [原生草图已约束]

轮廓顶点 (-128.0, -26.0, 164.0) | 轮廓顶点 (-128.0, 26.0, 164.0)
轮廓顶点 (-40.0, -26.0, 164.0) | 轮廓顶点 (-40.0, 26.0, 164.0)

Central_opening_sketch [原生草图已约束]

轮廓顶点 (-108.0, -10.0, 163.0) | 轮廓顶点 (-108.0, 10.0, 163.0)
轮廓顶点 (-40.0, -10.0, 163.0) | 轮廓顶点 (-40.0, 10.0, 163.0)

Housing_keepout_sketch [原生草图已约束]

圆直径 92.000; 中心 (0.000, 0.000, 163.000)

Clamp_compliance_slots_0_sketch [原生草图已约束]

轮廓顶点 (-50.25, -20.0, 163.0) | 轮廓顶点 (-50.25, -16.0, 163.0)
轮廓顶点 (-45.75, -20.0, 163.0) | 轮廓顶点 (-45.75, -16.0, 163.0)

Clamp_compliance_slots_0_ends_1_sketch [原生草图已约束]

圆直径 4.500; 中心 (-48.000, -20.000, 163.000)

Clamp_compliance_slots_0_ends_2_sketch [原生草图已约束]

圆直径 4.500; 中心 (-48.000, -16.000, 163.000)

Clamp_compliance_slots_1_sketch [原生草图已约束]

轮廓顶点 (-50.25, 16.0, 163.0) | 轮廓顶点 (-50.25, 20.0, 163.0)
轮廓顶点 (-45.75, 16.0, 163.0) | 轮廓顶点 (-45.75, 20.0, 163.0)

Clamp_compliance_slots_1_ends_1_sketch [原生草图已约束]

圆直径 4.500; 中心 (-48.000, 16.000, 163.000)

Clamp_compliance_slots_1_ends_2_sketch [原生草图已约束]

圆直径 4.500; 中心 (-48.000, 20.000, 163.000)

Arm_fasteners_1_sketch [原生草图已约束]

圆直径 4.500; 中心 (-120.000, -18.000, 163.000)

Arm_fasteners_2_sketch [原生草图已约束]

圆直径 4.500; 中心 (-120.000, 18.000, 163.000)

# P07_R 灯圈连接板

## 数量 1 材料 PETG / 待试制

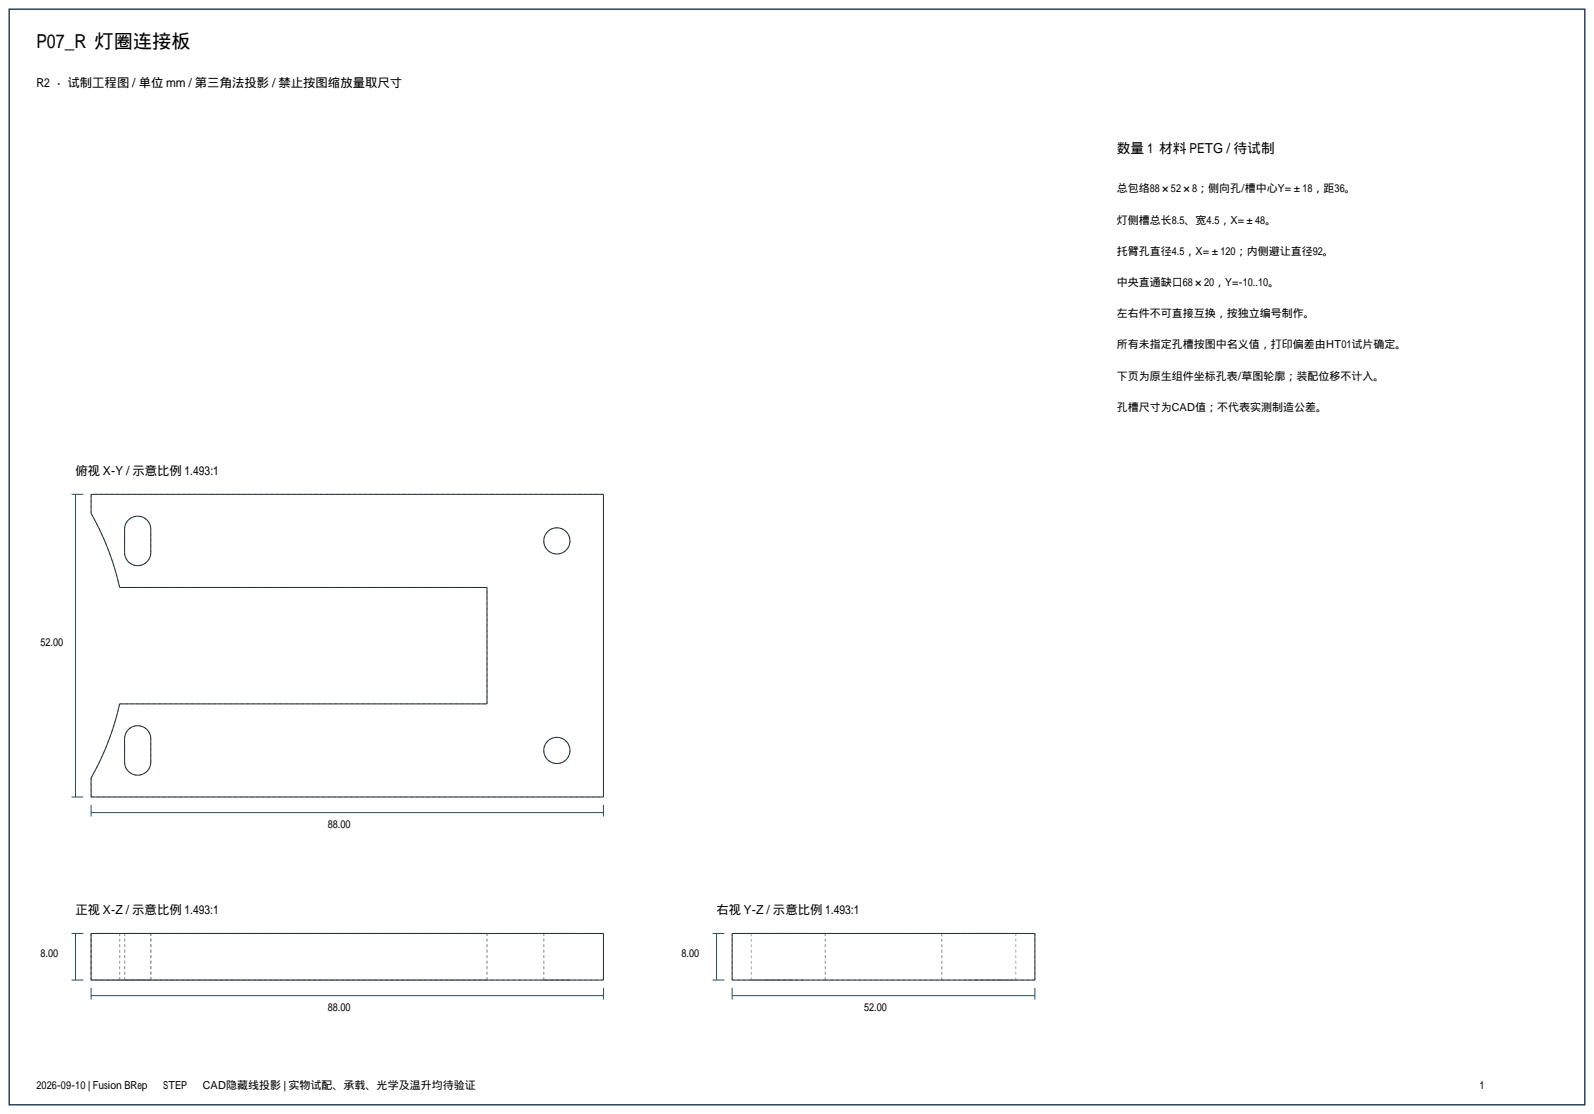
[picture p174: page 26]
俯视 X-Y / 示意比例 1.493:1; 正视 X-Z / 示意比例 1.493:1; 右视 Y-Z / 示意比例 1.493:1; 总包络88×52×8；侧向孔/槽中心Y=±18，距36。; 灯侧槽总长8.5、宽4.5，X=±48。; 托臂孔直径4.5，X=±120；内侧避让直径92。; 中央直通缺口68×20，Y=-10..10。; 左右件不可直接互换，按独立编号制作。; 所有未指定孔槽按图中名义值，打印偏差由HT01试片确定。; 孔槽尺寸为CAD值；不代表实测制造公差。

R2 · 试制工程图 / 单位 mm / 第三角法投影 / 禁止按图缩放量取尺寸

下页为原生组件坐标孔表/草图轮廓；装配位移不计入。

# P07_R 灯圈连接板

### R2 · 试制工程图 / 单位 mm / 第三角法投影 / 禁止按图缩放量取尺寸

### 原生草图坐标说明：X 沿输送，Y 向后，Z 向上。圆为孔或圆轮廓；关联用途见特征名。

Bridge_plate_sketch [原生草图已约束]

轮廓顶点 (40.0, -26.0, 164.0) | 轮廓顶点 (40.0, 26.0, 164.0)
轮廓顶点 (128.0, -26.0, 164.0) | 轮廓顶点 (128.0, 26.0, 164.0)

Central_opening_sketch [原生草图已约束]

轮廓顶点 (40.0, -10.0, 163.0) | 轮廓顶点 (40.0, 10.0, 163.0)
轮廓顶点 (108.0, -10.0, 163.0) | 轮廓顶点 (108.0, 10.0, 163.0)

Housing_keepout_sketch [原生草图已约束]

圆直径 92.000; 中心 (0.000, 0.000, 163.000)

Clamp_compliance_slots_0_sketch [原生草图已约束]

轮廓顶点 (45.75, -20.0, 163.0) | 轮廓顶点 (45.75, -16.0, 163.0)
轮廓顶点 (50.25, -20.0, 163.0) | 轮廓顶点 (50.25, -16.0, 163.0)

Clamp_compliance_slots_0_ends_1_sketch [原生草图已约束]

圆直径 4.500; 中心 (48.000, -20.000, 163.000)

Clamp_compliance_slots_0_ends_2_sketch [原生草图已约束]

圆直径 4.500; 中心 (48.000, -16.000, 163.000)

Clamp_compliance_slots_1_sketch [原生草图已约束]

轮廓顶点 (45.75, 16.0, 163.0) | 轮廓顶点 (45.75, 20.0, 163.0)
轮廓顶点 (50.25, 16.0, 163.0) | 轮廓顶点 (50.25, 20.0, 163.0)

Clamp_compliance_slots_1_ends_1_sketch [原生草图已约束]

圆直径 4.500; 中心 (48.000, 16.000, 163.000)

Clamp_compliance_slots_1_ends_2_sketch [原生草图已约束]

圆直径 4.500; 中心 (48.000, 20.000, 163.000)

Arm_fasteners_1_sketch [原生草图已约束]

圆直径 4.500; 中心 (120.000, -18.000, 163.000)

Arm_fasteners_2_sketch [原生草图已约束]

圆直径 4.500; 中心 (120.000, 18.000, 163.000)

# S01 承托软垫_现场裁切

### R2 · 试制工程图 / 单位 mm / 第三角法投影 / 禁止按图缩放量取尺寸

74.00

19.00

俯视 X-Y / 示意比例 2.247:1

74.00

0.50

正视 X-Z / 示意比例 1.124:1

19.00

0.50

右视 Y-Z / 示意比例 1.124:1

## 数量 4 材料 软片 / 待选型

软垫74×19×0.5，4件；材料硬度、胶粘待试配。

贴放不得侵入孔槽；软垫内缩误差预算1.5。

非PETG打印件。

所有未指定孔槽按图中名义值，打印偏差由HT01试片确定。

下页为原生组件坐标孔表/草图轮廓；装配位移不计入。

孔槽尺寸为CAD值；不代表实测制造公差。

# S01 承托软垫_现场裁切

### R2 · 试制工程图 / 单位 mm / 第三角法投影 / 禁止按图缩放量取尺寸

### 原生草图坐标说明：X 沿输送，Y 向后，Z 向上。圆为孔或圆轮廓；关联用途见特征名。

Contact_soft_pad_sketch [原生草图已约束]

轮廓顶点 (-37.0, 26.0, 204.5) | 轮廓顶点 (-37.0, 45.0, 204.5)
轮廓顶点 (37.0, 26.0, 204.5) | 轮廓顶点 (37.0, 45.0, 204.5)

# S03A 灯圈软衬_0p5厚_待实配

## 数量 1 材料 软片 / 待选型

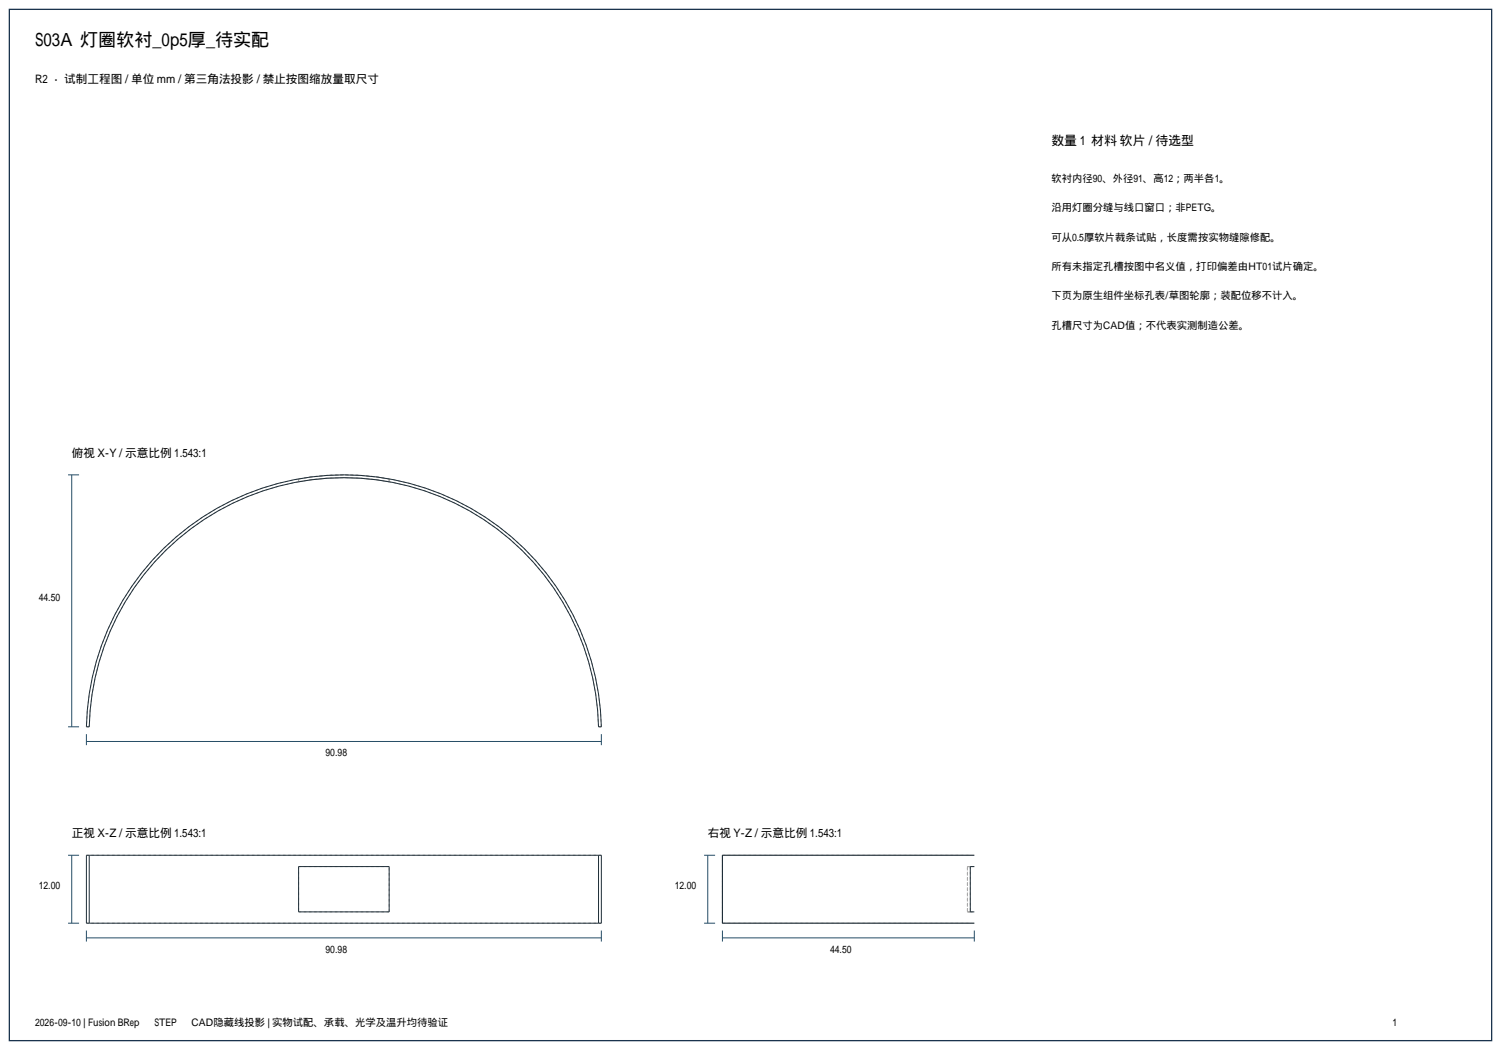
[picture p175: page 30]
俯视 X-Y / 示意比例 1.543:1; 正视 X-Z / 示意比例 1.543:1; 右视 Y-Z / 示意比例 1.543:1; 软衬内径90、外径91、高12；两半各1。; 沿用灯圈分缝与线口窗口；非PETG。; 可从0.5厚软片裁条试贴，长度需按实物缝隙修配。; 所有未指定孔槽按图中名义值，打印偏差由HT01试片确定。; 孔槽尺寸为CAD值；不代表实测制造公差。

R2 · 试制工程图 / 单位 mm / 第三角法投影 / 禁止按图缩放量取尺寸

下页为原生组件坐标孔表/草图轮廓；装配位移不计入。

# S03A 灯圈软衬_0p5厚_待实配

### R2 · 试制工程图 / 单位 mm / 第三角法投影 / 禁止按图缩放量取尺寸

### 原生草图坐标说明：X 沿输送，Y 向后，Z 向上。圆为孔或圆轮廓；关联用途见特征名。

Soft_liner_sketch [原生草图已约束]

圆直径 91.000; 中心 (0.000, 0.000, 150.000)

Soft_liner_bore_1_sketch [原生草图已约束]

圆直径 90.000; 中心 (0.000, 0.000, 150.000)

Split_liner_sketch [原生草图已约束]

轮廓顶点 (-60.0, -60.0, 149.0) | 轮廓顶点 (-60.0, 1.0, 149.0)
轮廓顶点 (60.0, -60.0, 149.0) | 轮廓顶点 (60.0, 1.0, 149.0)

Cable_window_sketch [原生草图已约束]

轮廓顶点 (-8.0, 42.0, 152.0) | 轮廓顶点 (-8.0, 60.0, 152.0)
轮廓顶点 (8.0, 42.0, 152.0) | 轮廓顶点 (8.0, 60.0, 152.0)

# S03B 灯圈软衬_0p5厚_待实配

## 数量 1 材料 软片 / 待选型

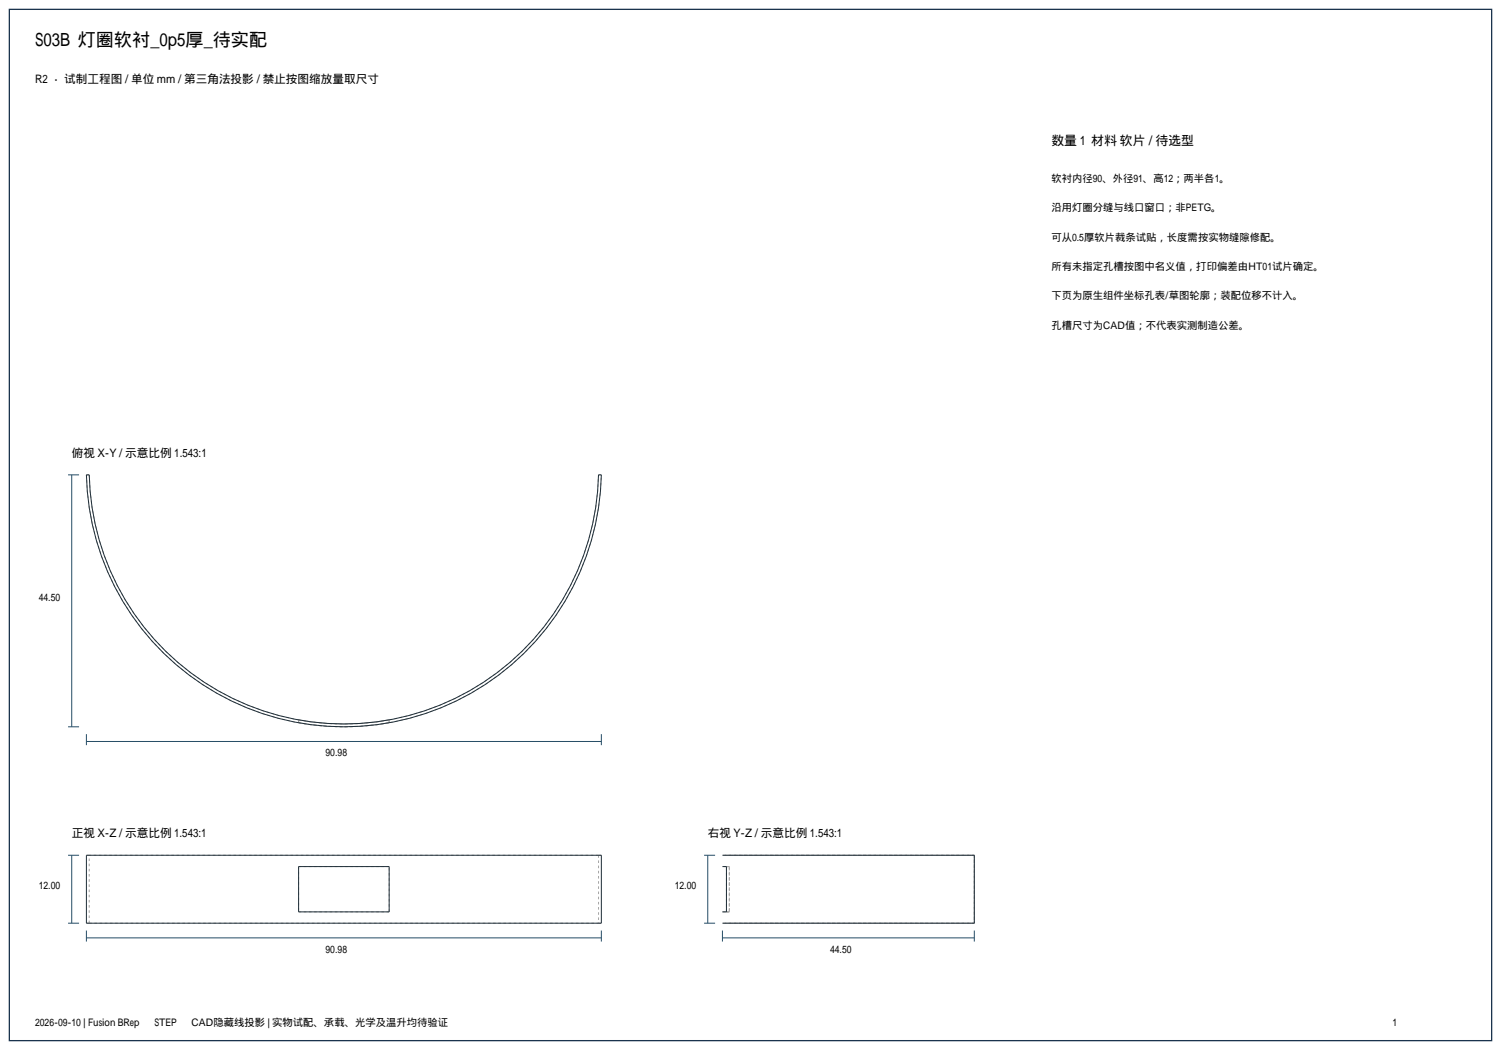
[picture p176: page 32]
俯视 X-Y / 示意比例 1.543:1; 正视 X-Z / 示意比例 1.543:1; 右视 Y-Z / 示意比例 1.543:1; 软衬内径90、外径91、高12；两半各1。; 沿用灯圈分缝与线口窗口；非PETG。; 可从0.5厚软片裁条试贴，长度需按实物缝隙修配。; 所有未指定孔槽按图中名义值，打印偏差由HT01试片确定。; 孔槽尺寸为CAD值；不代表实测制造公差。

R2 · 试制工程图 / 单位 mm / 第三角法投影 / 禁止按图缩放量取尺寸

下页为原生组件坐标孔表/草图轮廓；装配位移不计入。

# S03B 灯圈软衬_0p5厚_待实配

### R2 · 试制工程图 / 单位 mm / 第三角法投影 / 禁止按图缩放量取尺寸

### 原生草图坐标说明：X 沿输送，Y 向后，Z 向上。圆为孔或圆轮廓；关联用途见特征名。

Soft_liner_sketch [原生草图已约束]

圆直径 91.000; 中心 (0.000, 0.000, 150.000)

Soft_liner_bore_1_sketch [原生草图已约束]

圆直径 90.000; 中心 (0.000, 0.000, 150.000)

Split_liner_sketch [原生草图已约束]

轮廓顶点 (-60.0, -1.0, 149.0) | 轮廓顶点 (-60.0, 60.0, 149.0)
轮廓顶点 (60.0, -1.0, 149.0) | 轮廓顶点 (60.0, 60.0, 149.0)

Cable_window_sketch [原生草图已约束]

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

# W01 底板_650x400x12

## 数量 1 材料 12 mm胶合板

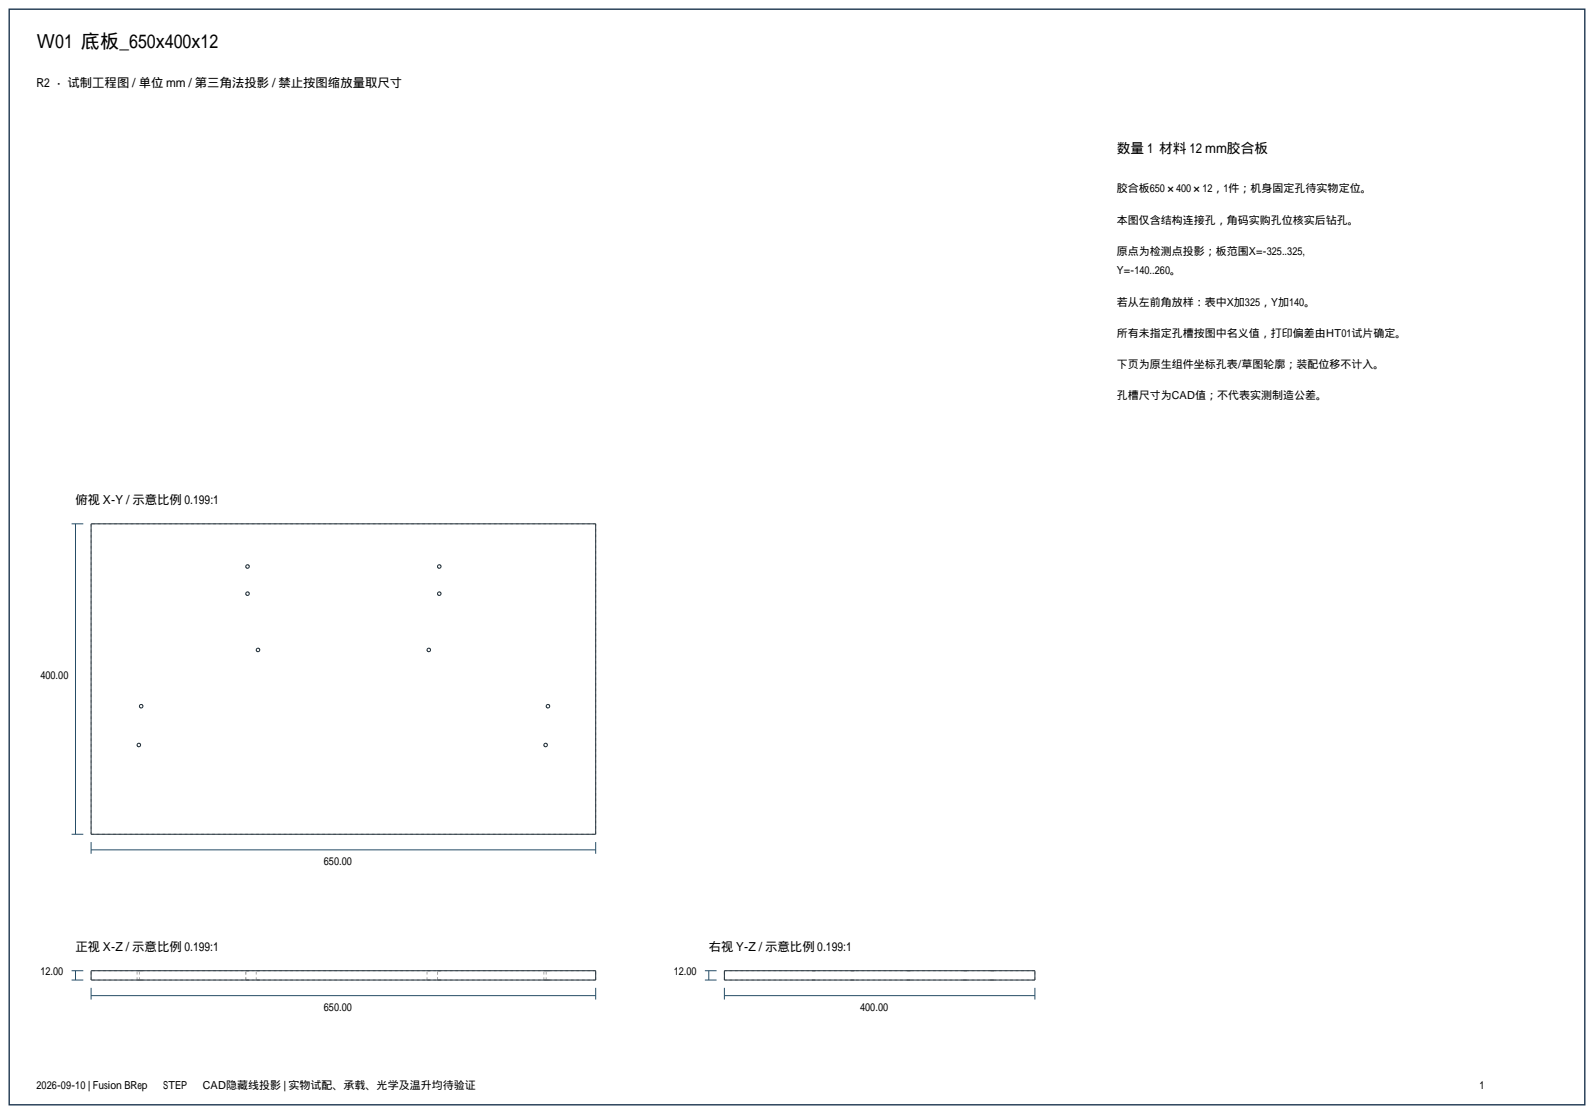
[picture p177: page 34]
俯视 X-Y / 示意比例 0.199:1; 正视 X-Z / 示意比例 0.199:1; 右视 Y-Z / 示意比例 0.199:1; 胶合板650×400×12，1件；机身固定孔待实物定位。; 本图仅含结构连接孔，角码实购孔位核实后钻孔。; 原点为检测点投影；板范围X=-325..325,; 若从左前角放样：表中X加325，Y加140。; 所有未指定孔槽按图中名义值，打印偏差由HT01试片确定。; 孔槽尺寸为CAD值；不代表实测制造公差。

R2 · 试制工程图 / 单位 mm / 第三角法投影 / 禁止按图缩放量取尺寸

下页为原生组件坐标孔表/草图轮廓；装配位移不计入。

# W01 底板_650x400x12

### R2 · 试制工程图 / 单位 mm / 第三角法投影 / 禁止按图缩放量取尺寸

### 原生草图坐标说明：X 沿输送，Y 向后，Z 向上。圆为孔或圆轮廓；关联用途见特征名。

Base_sketch [原生草图已约束]

轮廓顶点 (-325.0, -140.0, -12.0) | 轮廓顶点 (-325.0, 260.0, -12.0)
轮廓顶点 (325.0, -140.0, -12.0) | 轮廓顶点 (325.0, 260.0, -12.0)

Structural_fixings_only_1_sketch [原生草图已约束]

圆直径 4.500; 中心 (-110.000, 97.500, -13.000)

Structural_fixings_only_2_sketch [原生草图已约束]

圆直径 4.500; 中心 (110.000, 97.500, -13.000)

Structural_fixings_only_3_sketch [原生草图已约束]

圆直径 4.500; 中心 (-123.500, 170.000, -13.000)

Structural_fixings_only_4_sketch [原生草图已约束]

圆直径 4.500; 中心 (-123.500, 205.000, -13.000)

Structural_fixings_only_5_sketch [原生草图已约束]

圆直径 4.500; 中心 (123.500, 170.000, -13.000)

Structural_fixings_only_6_sketch [原生草图已约束]

圆直径 4.500; 中心 (123.500, 205.000, -13.000)

Structural_fixings_only_7_sketch [原生草图已约束]

圆直径 4.500; 中心 (260.500, -25.000, -13.000)

Structural_fixings_only_8_sketch [原生草图已约束]

圆直径 4.500; 中心 (263.500, 25.000, -13.000)

Structural_fixings_only_9_sketch [原生草图已约束]

圆直径 4.500; 中心 (-260.500, 25.000, -13.000)

Structural_fixings_only_10_sketch [原生草图已约束]

圆直径 4.500; 中心 (-263.500, -25.000, -13.000)

# W02 后立板_300x360x12

## 数量 1 材料 12 mm胶合板

俯视 X-Y / 示意比例 0.465:1; 正视 X-Z / 示意比例 0.465:1; 右视 Y-Z / 示意比例 0.465:1; 胶合板300×360×12，1件。; 相机孔列X=-83,-47,47,83；Z=125..305，步距; 40个相机孔；灯导板4孔：X=±120，Z=80/240。; 其余6孔为角码；上加强板连接已改Z=110。; 以板左下角放样：表中X加150，Z保持不变。; 所有未指定孔槽按图中名义值，打印偏差由HT01试片确定。; 孔槽尺寸为CAD值；不代表实测制造公差。

R2 · 试制工程图 / 单位 mm / 第三角法投影 / 禁止按图缩放量取尺寸

下页为原生组件坐标孔表/草图轮廓；装配位移不计入。

# W02 后立板_300x360x12

### R2 · 试制工程图 / 单位 mm / 第三角法投影 / 禁止按图缩放量取尺寸

### 原生草图坐标说明：X 沿输送，Y 向后，Z 向上。圆为孔或圆轮廓；关联用途见特征名。

Wall_sketch [原生草图已约束]

轮廓顶点 (-150.0, 110.0, 0.0) | 轮廓顶点 (-150.0, 122.0, 0.0)
轮廓顶点 (150.0, 110.0, 0.0) | 轮廓顶点 (150.0, 122.0, 0.0)

Camera_height_hole_array_1_sketch [原生草图已约束]

圆直径 4.500; 中心 (-83.000, 109.000, 145.000)

Camera_height_hole_array_2_sketch [原生草图已约束]

圆直径 4.500; 中心 (-83.000, 109.000, 165.000)

Camera_height_hole_array_3_sketch [原生草图已约束]

圆直径 4.500; 中心 (-83.000, 109.000, 185.000)

Camera_height_hole_array_4_sketch [原生草图已约束]

圆直径 4.500; 中心 (-83.000, 109.000, 205.000)

Camera_height_hole_array_5_sketch [原生草图已约束]

圆直径 4.500; 中心 (-83.000, 109.000, 225.000)

Camera_height_hole_array_6_sketch [原生草图已约束]

圆直径 4.500; 中心 (-83.000, 109.000, 245.000)

Camera_height_hole_array_7_sketch [原生草图已约束]

圆直径 4.500; 中心 (-83.000, 109.000, 265.000)

Camera_height_hole_array_8_sketch [原生草图已约束]

圆直径 4.500; 中心 (-83.000, 109.000, 285.000)

Camera_height_hole_array_9_sketch [原生草图已约束]

圆直径 4.500; 中心 (-83.000, 109.000, 305.000)

Camera_height_hole_array_10_sketch [原生草图已约束]

圆直径 4.500; 中心 (-47.000, 109.000, 145.000)

Camera_height_hole_array_11_sketch [原生草图已约束]

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

Angle_fixings_4_sketch [原生草图已约束]

圆直径 4.500; 中心 (-123.500, 109.000, 110.000)

Angle_fixings_5_sketch [原生草图已约束]

圆直径 4.500; 中心 (123.500, 109.000, 60.000)

Angle_fixings_6_sketch [原生草图已约束]

圆直径 4.500; 中心 (123.500, 109.000, 110.000)

# W03 后加强板_120x200x12

## 数量 2 材料 12 mm胶合板

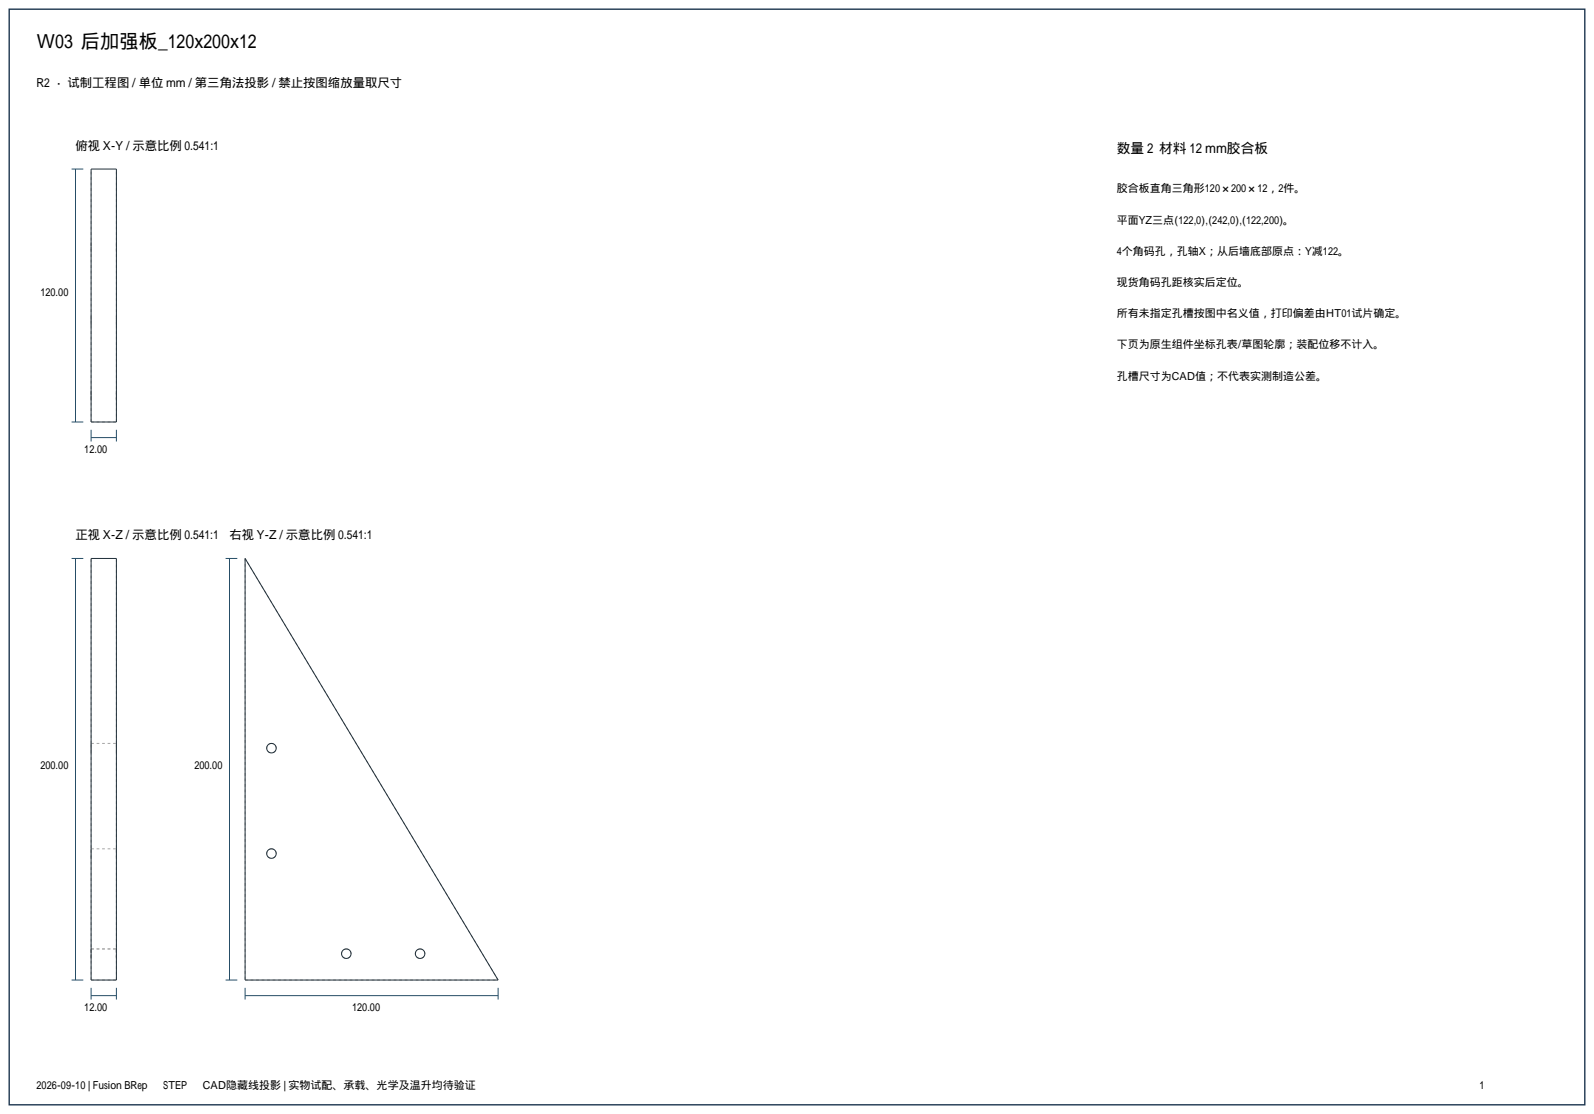
[picture p178: page 41]
俯视 X-Y / 示意比例 0.541:1; 正视 X-Z / 示意比例 0.541:1; 右视 Y-Z / 示意比例 0.541:1; 胶合板直角三角形120×200×12，2件。; 平面YZ三点(122,0),(242,0),(122,200)。; 4个角码孔，孔轴X；从后墙底部原点：Y减122。; 现货角码孔距核实后定位。; 所有未指定孔槽按图中名义值，打印偏差由HT01试片确定。; 孔槽尺寸为CAD值；不代表实测制造公差。

R2 · 试制工程图 / 单位 mm / 第三角法投影 / 禁止按图缩放量取尺寸

下页为原生组件坐标孔表/草图轮廓；装配位移不计入。

# W03 后加强板_120x200x12

### R2 · 试制工程图 / 单位 mm / 第三角法投影 / 禁止按图缩放量取尺寸

### 原生草图坐标说明：X 沿输送，Y 向后，Z 向上。圆为孔或圆轮廓；关联用途见特征名。

Rear_gusset_sketch [原生草图已约束]

轮廓顶点 (0.0, 122.0, 0.0) | 轮廓顶点 (0.0, 122.0, 200.0)

轮廓顶点 (0.0, 242.0, 0.0)

Angle_fixings_1_sketch [原生草图已约束]

圆直径 4.500; 中心 (-1.000, 170.000, 12.500)

Angle_fixings_2_sketch [原生草图已约束]

圆直径 4.500; 中心 (-1.000, 205.000, 12.500)

Angle_fixings_3_sketch [原生草图已约束]

圆直径 4.500; 中心 (-1.000, 134.500, 60.000)

Angle_fixings_4_sketch [原生草图已约束]

圆直径 4.500; 中心 (-1.000, 134.500, 110.000)

# W04 端部托料板_100x100x12

## 数量 2 材料 12 mm胶合板

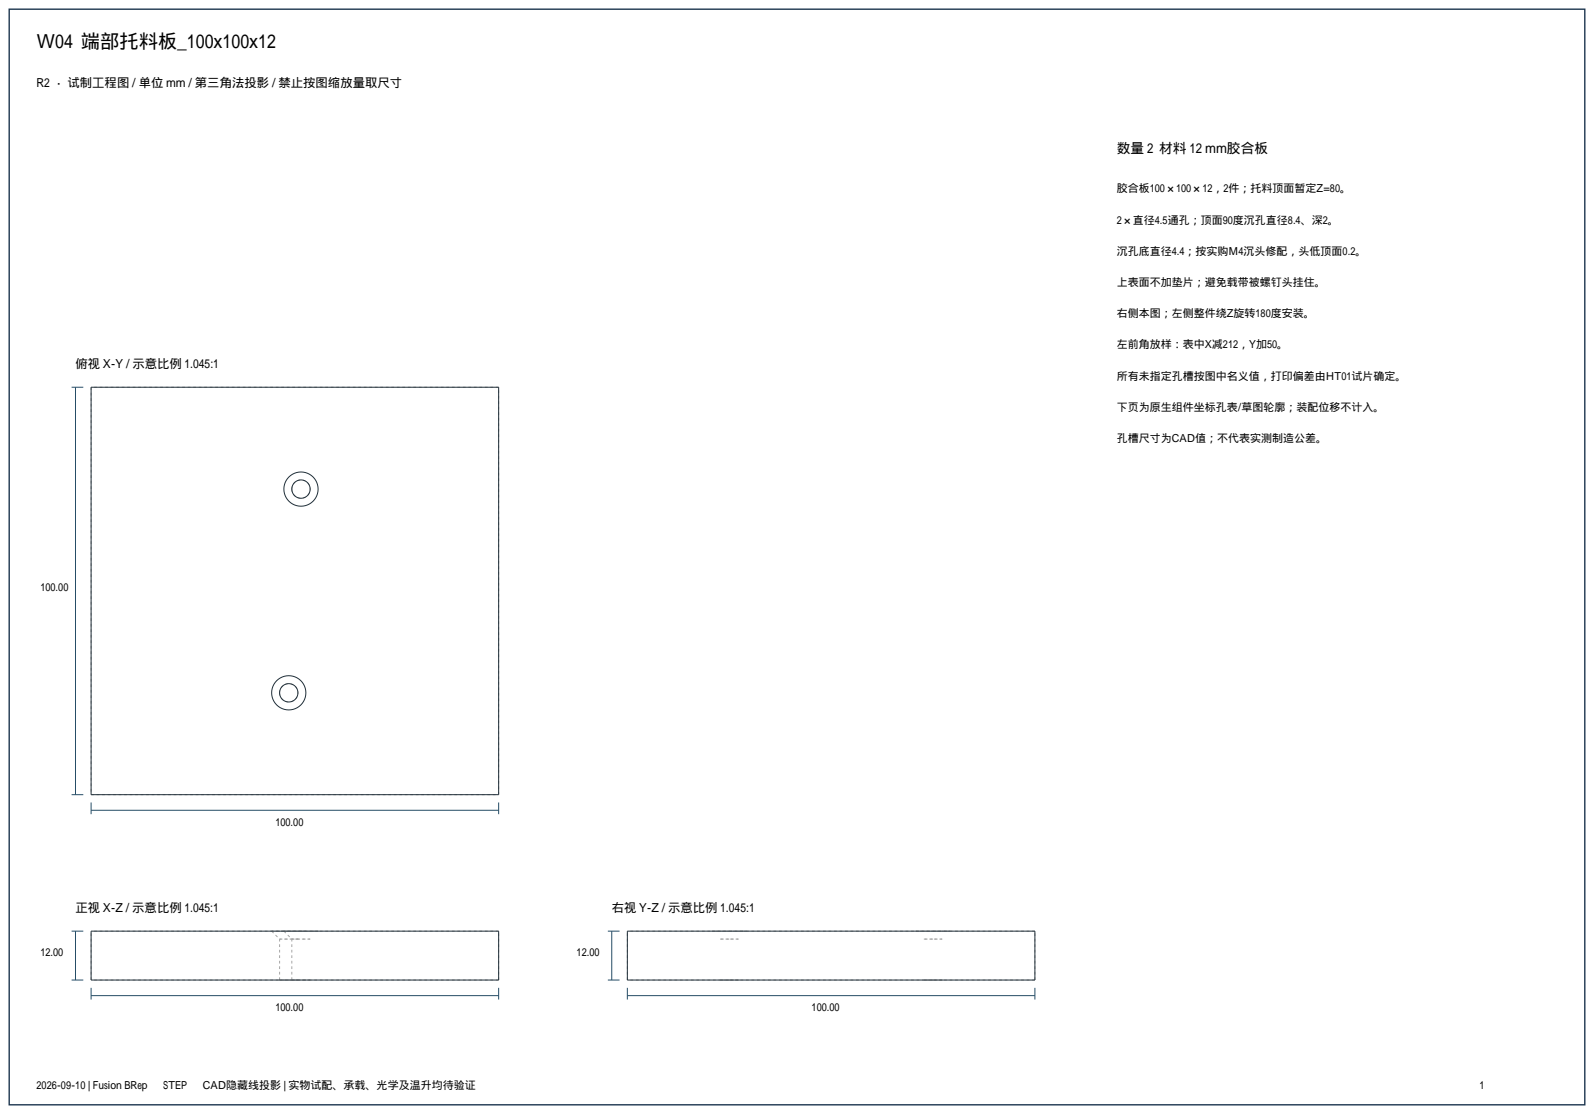
[picture p179: page 43]
俯视 X-Y / 示意比例 1.045:1; 正视 X-Z / 示意比例 1.045:1; 右视 Y-Z / 示意比例 1.045:1; 胶合板100×100×12，2件；托料顶面暂定Z=80。; 2×直径4.5通孔；顶面90度沉孔直径8.4、深2。; 沉孔底直径4.4；按实购M4沉头修配，头低顶面0.2。; 上表面不加垫片；避免载带被螺钉头挂住。; 右侧本图；左侧整件绕Z旋转180度安装。; 左前角放样：表中X减212，Y加50。; 所有未指定孔槽按图中名义值，打印偏差由HT01试片确定。; 孔槽尺寸为CAD值；不代表实测制造公差。

R2 · 试制工程图 / 单位 mm / 第三角法投影 / 禁止按图缩放量取尺寸

下页为原生组件坐标孔表/草图轮廓；装配位移不计入。

# W04 端部托料板_100x100x12

### R2 · 试制工程图 / 单位 mm / 第三角法投影 / 禁止按图缩放量取尺寸

### 原生草图坐标说明：X 沿输送，Y 向后，Z 向上。圆为孔或圆轮廓；关联用途见特征名。

Tray_sketch [原生草图已约束]

轮廓顶点 (212.0, -50.0, 68.0) | 轮廓顶点 (212.0, 50.0, 68.0)
轮廓顶点 (312.0, -50.0, 68.0) | 轮廓顶点 (312.0, 50.0, 68.0)

Foot_angle_fixings_1_sketch [原生草图已约束]

圆直径 4.500; 中心 (260.500, -25.000, 67.000)

Foot_angle_fixings_2_sketch [原生草图已约束]

圆直径 4.500; 中心 (263.500, 25.000, 67.000)

Flush_head_recess_0_section_0 [原生草图已约束]

圆直径 4.400; 中心 (260.500, -25.000, 78.000)

Flush_head_recess_0_section_1 [原生草图已约束]

圆直径 8.400; 中心 (260.500, -25.000, 80.000)

Flush_head_recess_1_section_0 [原生草图已约束]

圆直径 4.400; 中心 (263.500, 25.000, 78.000)

Flush_head_recess_1_section_1 [原生草图已约束]

圆直径 8.400; 中心 (263.500, 25.000, 80.000)

# W05 托料脚_12厚胶合板_高度暂定

## 数量 4 材料 12 mm胶合板

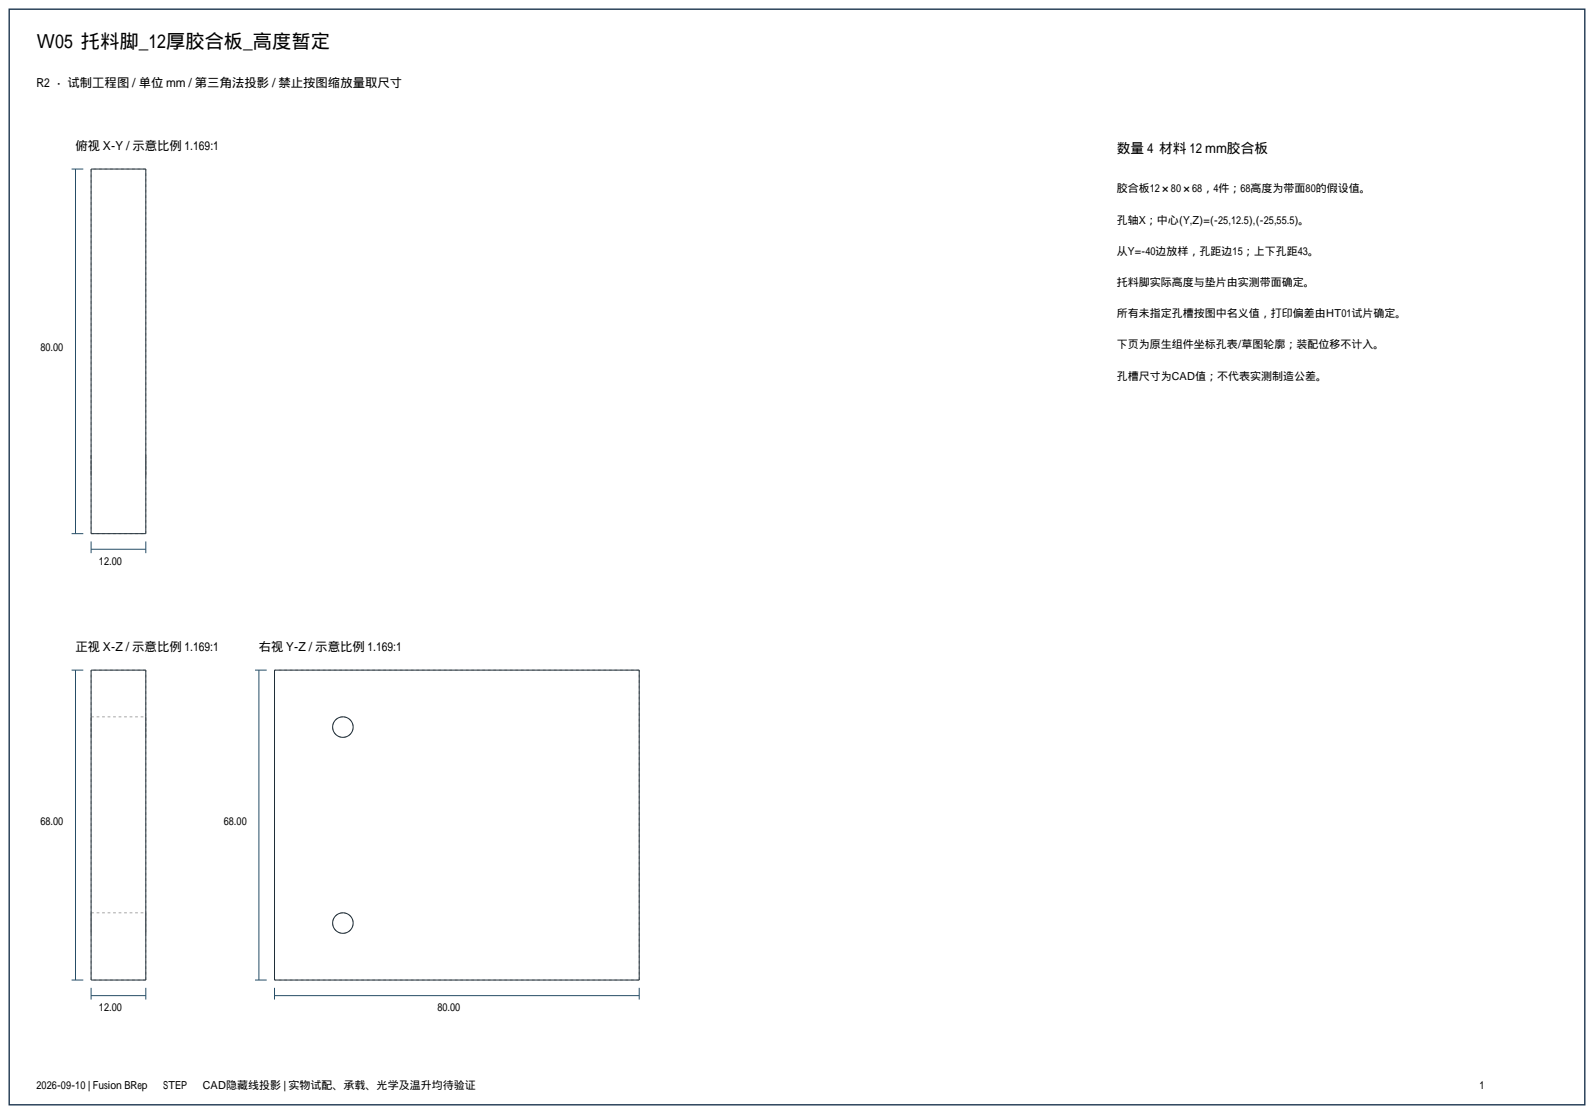
[picture p180: page 45]
俯视 X-Y / 示意比例 1.169:1; 正视 X-Z / 示意比例 1.169:1; 右视 Y-Z / 示意比例 1.169:1; 胶合板12×80×68，4件；68高度为带面80的假设值。; 孔轴X；中心(Y,Z)=(-25,12.5),(-25,55.5)。; 从Y=-40边放样，孔距边15；上下孔距43。; 托料脚实际高度与垫片由实测带面确定。; 所有未指定孔槽按图中名义值，打印偏差由HT01试片确定。; 孔槽尺寸为CAD值；不代表实测制造公差。

R2 · 试制工程图 / 单位 mm / 第三角法投影 / 禁止按图缩放量取尺寸

下页为原生组件坐标孔表/草图轮廓；装配位移不计入。

# W05 托料脚_12厚胶合板_高度暂定

### R2 · 试制工程图 / 单位 mm / 第三角法投影 / 禁止按图缩放量取尺寸

### 原生草图坐标说明：X 沿输送，Y 向后，Z 向上。圆为孔或圆轮廓；关联用途见特征名。

Plywood_foot_sketch [原生草图已约束]

轮廓顶点 (0.0, -40.0, 0.0) | 轮廓顶点 (0.0, 40.0, 0.0)
轮廓顶点 (12.0, -40.0, 0.0) | 轮廓顶点 (12.0, 40.0, 0.0)

Angle_fixings_1_sketch [原生草图已约束]

圆直径 4.500; 中心 (-1.000, -25.000, 12.500)

Angle_fixings_2_sketch [原生草图已约束]

圆直径 4.500; 中心 (-1.000, -25.000, 55.500)

# CT01 右后承托局部小样

## 数量 1 材料 PETG / 待试制

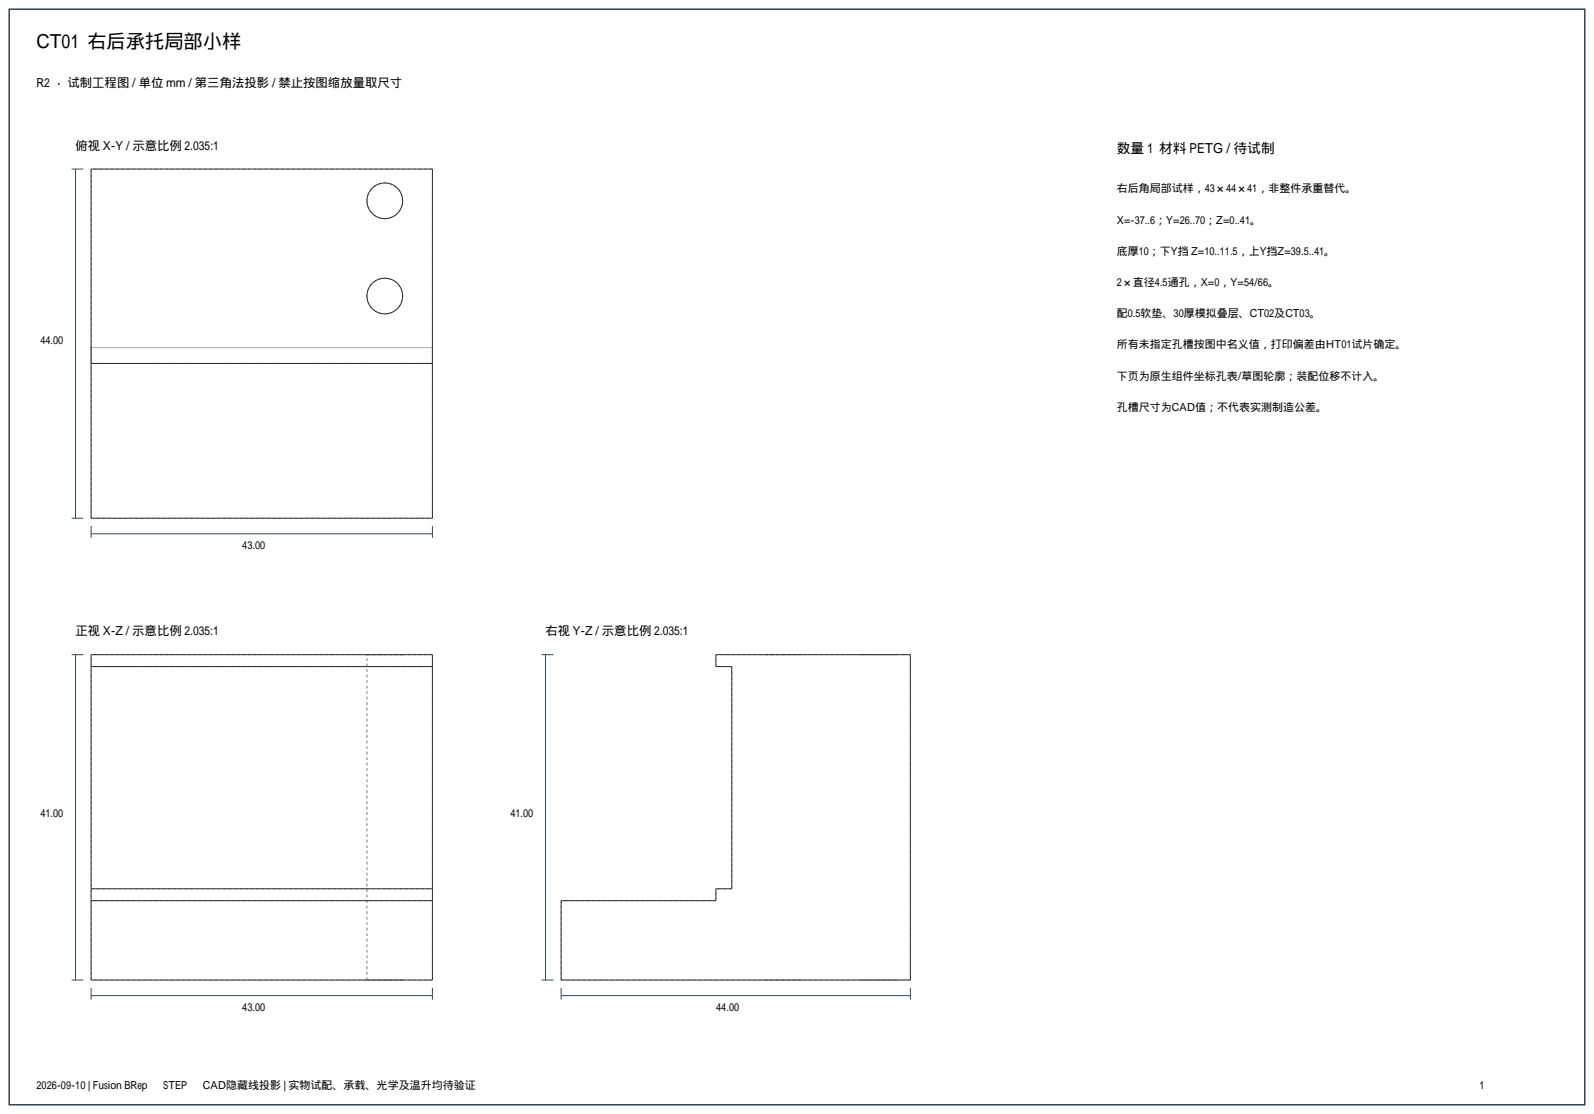
[picture p181: page 47]
俯视 X-Y / 示意比例 2.035:1; 正视 X-Z / 示意比例 2.035:1; 右视 Y-Z / 示意比例 2.035:1; 右后角局部试样，43×44×41，非整件承重替代。; 底厚10；下Y挡 Z=10..11.5，上Y挡Z=39.5..41。; 配0.5软垫、30厚模拟叠层、CT02及CT03。; 所有未指定孔槽按图中名义值，打印偏差由HT01试片确定。; 孔槽尺寸为CAD值；不代表实测制造公差。

R2 · 试制工程图 / 单位 mm / 第三角法投影 / 禁止按图缩放量取尺寸

下页为原生组件坐标孔表/草图轮廓；装配位移不计入。

# CT01 右后承托局部小样

### R2 · 试制工程图 / 单位 mm / 第三角法投影 / 禁止按图缩放量取尺寸

### 原生草图坐标说明：X 沿输送，Y 向后，Z 向上。圆为孔或圆轮廓；关联用途见特征名。

Support_base_sketch [原生草图已约束]

轮廓顶点 (-37.0, 26.0, 0.0) | 轮廓顶点 (-37.0, 70.0, 0.0)
轮廓顶点 (6.0, 26.0, 0.0) | 轮廓顶点 (6.0, 70.0, 0.0)

Hard_standoff_sketch [原生草图已约束]

轮廓顶点 (-37.0, 47.5, 10.0) | 轮廓顶点 (-37.0, 70.0, 10.0)
轮廓顶点 (6.0, 47.5, 10.0) | 轮廓顶点 (6.0, 70.0, 10.0)

Lower_Y_stop_sketch [原生草图已约束]

轮廓顶点 (-37.0, 45.5, 10.0) | 轮廓顶点 (-37.0, 47.5, 10.0)
轮廓顶点 (6.0, 45.5, 10.0) | 轮廓顶点 (6.0, 47.5, 10.0)

Upper_Y_stop_sketch [原生草图已约束]

轮廓顶点 (-37.0, 45.5, 39.5) | 轮廓顶点 (-37.0, 47.5, 39.5)
轮廓顶点 (6.0, 45.5, 39.5) | 轮廓顶点 (6.0, 47.5, 39.5)

Two_through_bolts_1_sketch [原生草图已约束]

圆直径 4.500; 中心 (0.000, 54.000, -1.000)

Two_through_bolts_2_sketch [原生草图已约束]

圆直径 4.500; 中心 (0.000, 66.000, -1.000)

# CT02 右后防脱及X止挡局部小样

## 数量 1 材料 PETG / 待试制

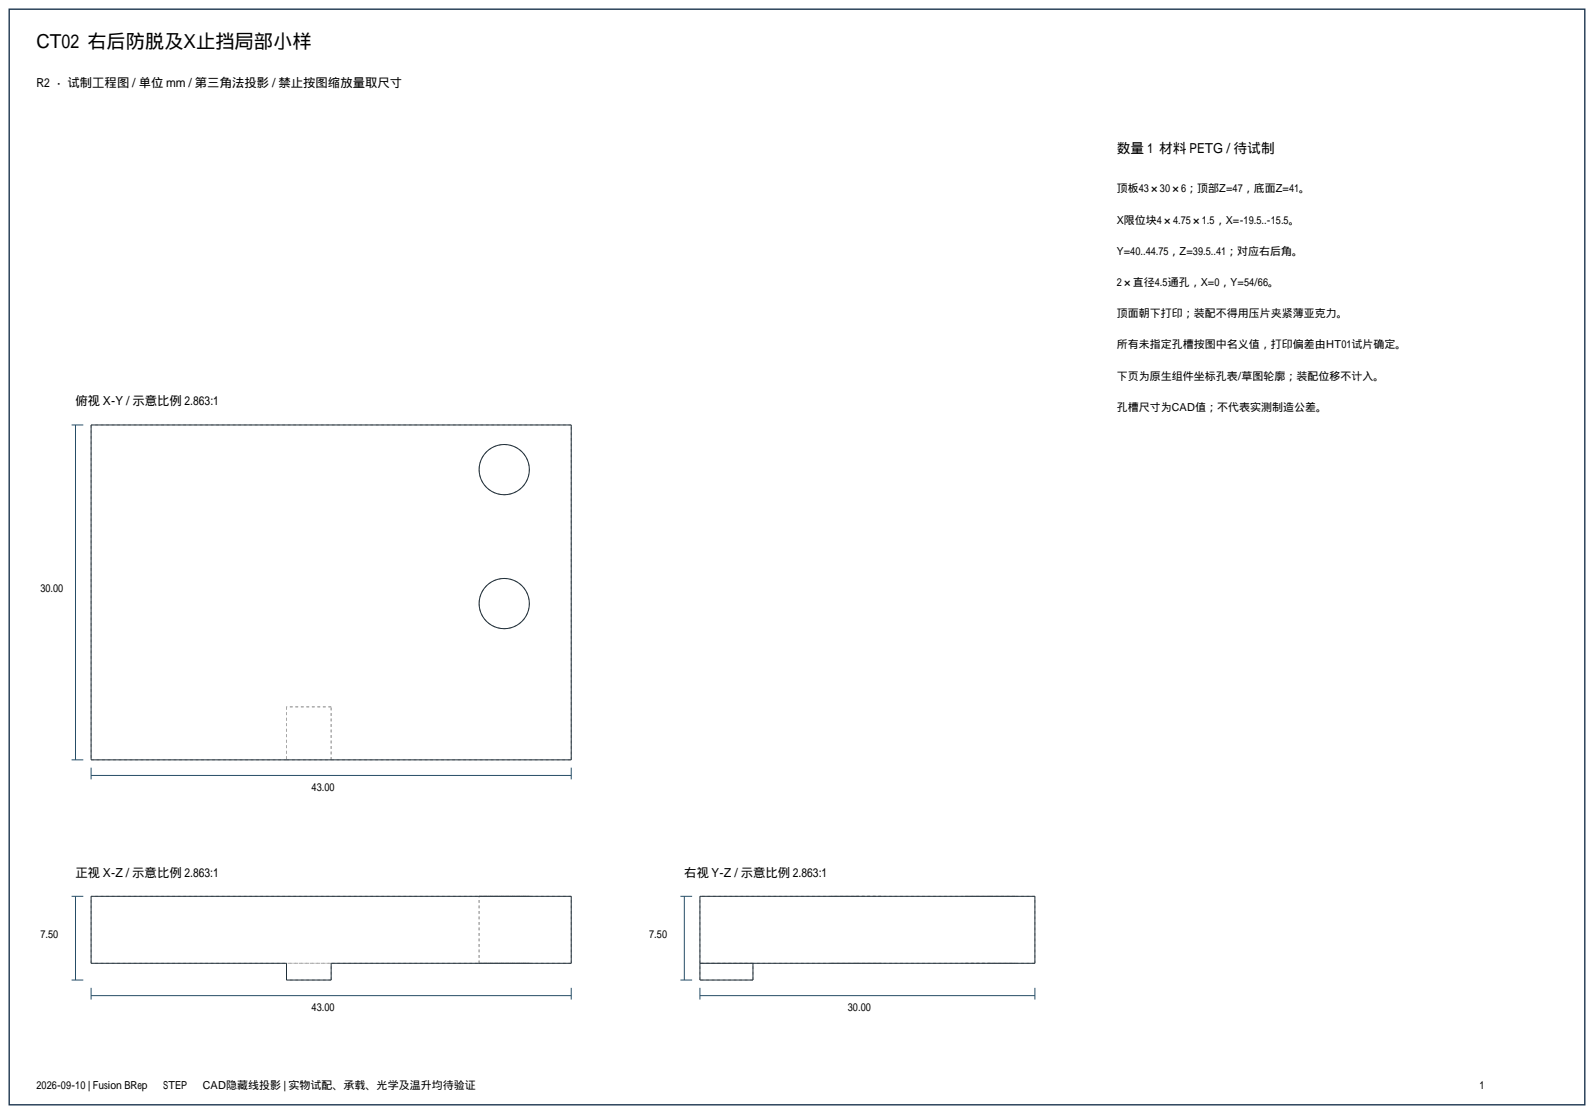
[picture p182: page 49]
俯视 X-Y / 示意比例 2.863:1; 正视 X-Z / 示意比例 2.863:1; 右视 Y-Z / 示意比例 2.863:1; 顶板43×30×6；顶部Z=47，底面Z=41。; X限位块4×4.75×1.5，X=-19.5..-15.5。; Y=40..44.75，Z=39.5..41；对应右后角。; 顶面朝下打印；装配不得用压片夹紧薄亚克力。; 所有未指定孔槽按图中名义值，打印偏差由HT01试片确定。; 孔槽尺寸为CAD值；不代表实测制造公差。

R2 · 试制工程图 / 单位 mm / 第三角法投影 / 禁止按图缩放量取尺寸

下页为原生组件坐标孔表/草图轮廓；装配位移不计入。

# CT02 右后防脱及X止挡局部小样

### R2 · 试制工程图 / 单位 mm / 第三角法投影 / 禁止按图缩放量取尺寸

### 原生草图坐标说明：X 沿输送，Y 向后，Z 向上。圆为孔或圆轮廓；关联用途见特征名。

Retainer_sketch [原生草图已约束]

轮廓顶点 (-37.0, 40.0, 41.0) | 轮廓顶点 (-37.0, 70.0, 41.0)
轮廓顶点 (6.0, 40.0, 41.0) | 轮廓顶点 (6.0, 70.0, 41.0)

Upper_X_stop_sketch [原生草图已约束]

轮廓顶点 (-19.5, 40.0, 39.5) | 轮廓顶点 (-19.5, 44.75, 39.5)
轮廓顶点 (-15.5, 40.0, 39.5) | 轮廓顶点 (-15.5, 44.75, 39.5)

Two_through_bolts_1_sketch [原生草图已约束]

圆直径 4.500; 中心 (0.000, 54.000, 40.000)

Two_through_bolts_2_sketch [原生草图已约束]

圆直径 4.500; 中心 (0.000, 66.000, 40.000)

# CT03 托臂槽段试装垫座

## 数量 1 材料 PETG / 待试制

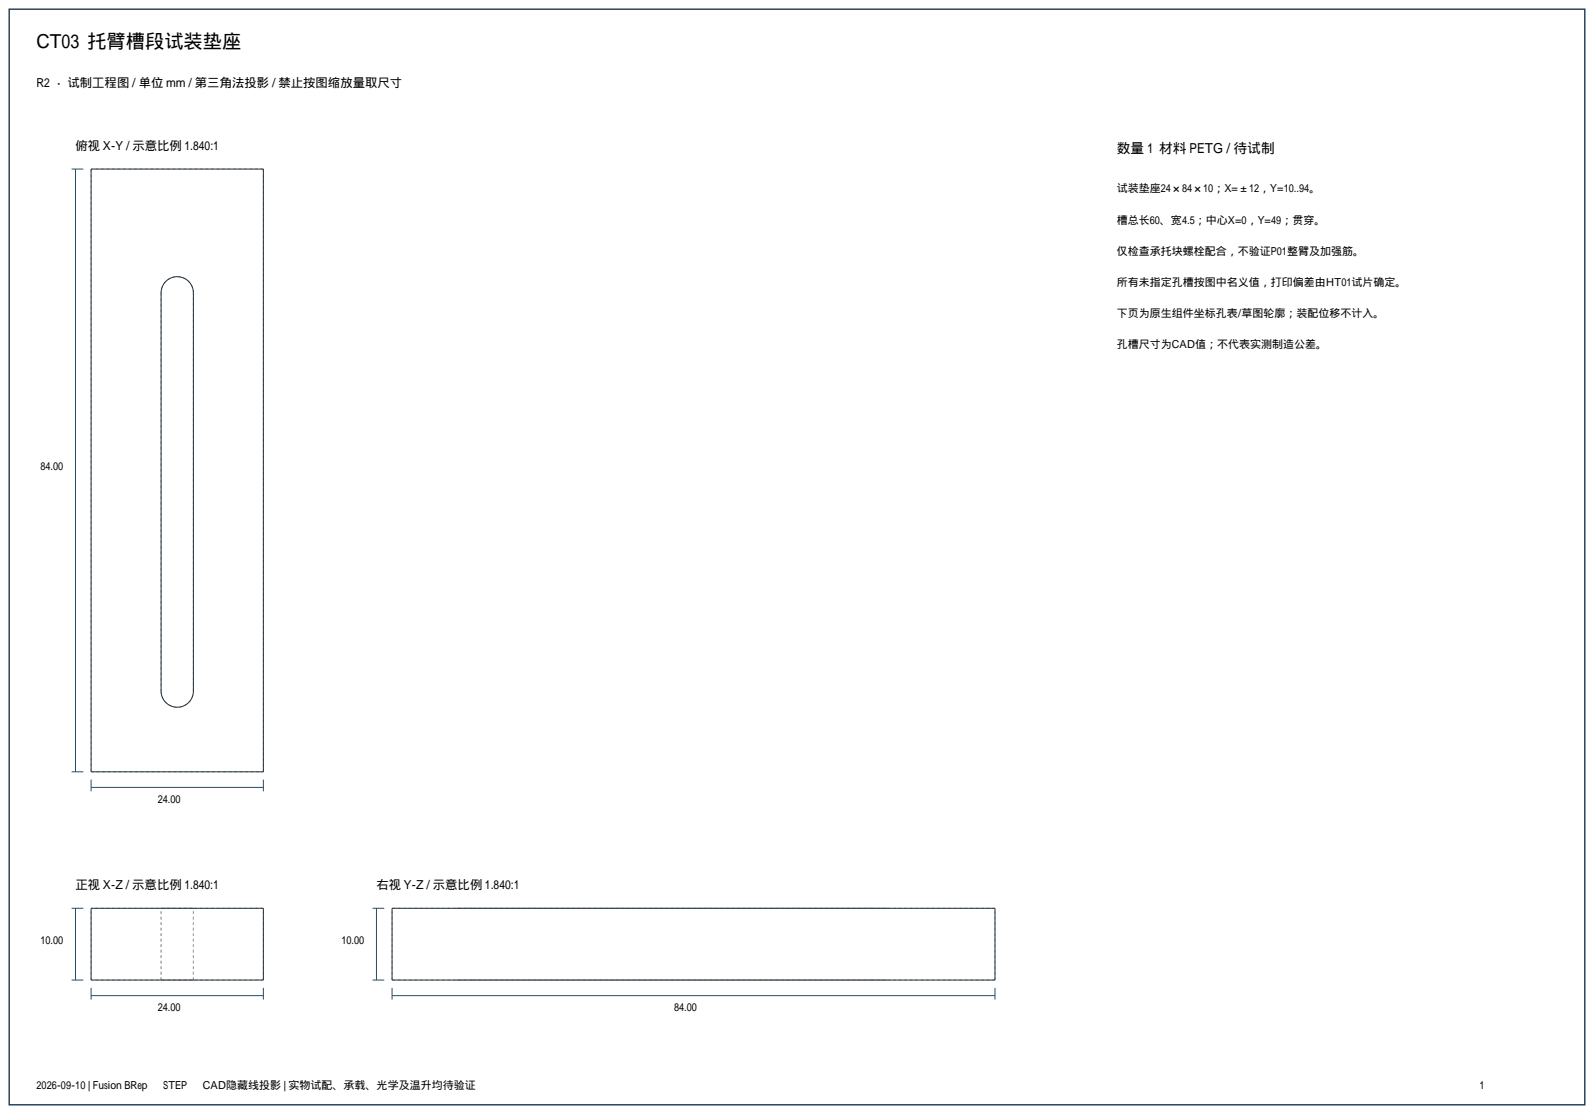
[picture p183: page 51]
俯视 X-Y / 示意比例 1.840:1; 正视 X-Z / 示意比例 1.840:1; 右视 Y-Z / 示意比例 1.840:1; 试装垫座24×84×10；X=±12，Y=10..94。; 槽总长60、宽4.5；中心X=0，Y=49；贯穿。; 仅检查承托块螺栓配合，不验证P01整臂及加强筋。; 所有未指定孔槽按图中名义值，打印偏差由HT01试片确定。; 孔槽尺寸为CAD值；不代表实测制造公差。

R2 · 试制工程图 / 单位 mm / 第三角法投影 / 禁止按图缩放量取尺寸

下页为原生组件坐标孔表/草图轮廓；装配位移不计入。

# CT03 托臂槽段试装垫座

### R2 · 试制工程图 / 单位 mm / 第三角法投影 / 禁止按图缩放量取尺寸

### 原生草图坐标说明：X 沿输送，Y 向后，Z 向上。圆为孔或圆轮廓；关联用途见特征名。

Arm_segment_sketch [原生草图已约束]

轮廓顶点 (-12.0, 10.0, -10.0) | 轮廓顶点 (-12.0, 94.0, -10.0)
轮廓顶点 (12.0, 10.0, -10.0) | 轮廓顶点 (12.0, 94.0, -10.0)

Pad_mount_slot_0_sketch [原生草图已约束]

轮廓顶点 (-2.25, 21.25, -11.0) | 轮廓顶点 (-2.25, 76.75, -11.0)
轮廓顶点 (2.25, 21.25, -11.0) | 轮廓顶点 (2.25, 76.75, -11.0)

Pad_mount_slot_0_ends_1_sketch [原生草图已约束]

圆直径 4.500; 中心 (0.000, 21.250, -11.000)

Pad_mount_slot_0_ends_2_sketch [原生草图已约束]

圆直径 4.500; 中心 (0.000, 76.750, -11.000)

# HT01 孔槽及横孔试片

## 数量 1 材料 PETG / 待试制

俯视 X-Y / 示意比例 1.493:1; 正视 X-Z / 示意比例 1.493:1; 右视 Y-Z / 示意比例 1.493:1; 基片80×60×6；左下3×3缺口标识原点。; 竖孔由左至右：4 / 4.2 / 4.4 / 4.5 / 4.6 /; 孔中心X=10,22,34,46,58,70；Y=10。; 三槽总长28：中心(20,26)宽4.2；(60,26)宽4.5；; (20,44)宽4.8；槽长沿X。; 横孔凸台20×16×10：X50..70,Y40..56,; 横孔直径4.5，轴Y，中心X60,Z11；无支撑试桥接。; 所有未指定孔槽按图中名义值，打印偏差由HT01试片确定。; 孔槽尺寸为CAD值；不代表实测制造公差。

R2 · 试制工程图 / 单位 mm / 第三角法投影 / 禁止按图缩放量取尺寸

下页为原生组件坐标孔表/草图轮廓；装配位移不计入。

# HT01 孔槽及横孔试片

### R2 · 试制工程图 / 单位 mm / 第三角法投影 / 禁止按图缩放量取尺寸

### 原生草图坐标说明：X 沿输送，Y 向后，Z 向上。圆为孔或圆轮廓；关联用途见特征名。

Base_sketch [原生草图已约束]

轮廓顶点 (0.0, 0.0, 0.0) | 轮廓顶点 (0.0, 60.0, 0.0)
轮廓顶点 (80.0, 0.0, 0.0) | 轮廓顶点 (80.0, 60.0, 0.0)

Vertical_4_1_sketch [原生草图已约束]

圆直径 4.000; 中心 (10.000, 10.000, -1.000)

Vertical_4.2_1_sketch [原生草图已约束]

圆直径 4.200; 中心 (22.000, 10.000, -1.000)

Vertical_4.4_1_sketch [原生草图已约束]

圆直径 4.400; 中心 (34.000, 10.000, -1.000)

Vertical_4.5_1_sketch [原生草图已约束]

圆直径 4.500; 中心 (46.000, 10.000, -1.000)

Vertical_4.6_1_sketch [原生草图已约束]

圆直径 4.600; 中心 (58.000, 10.000, -1.000)

Vertical_4.8_1_sketch [原生草图已约束]

圆直径 4.800; 中心 (70.000, 10.000, -1.000)

Slot_4.2_0_sketch [原生草图已约束]

轮廓顶点 (8.1, 23.9, -1.0) | 轮廓顶点 (8.1, 28.1, -1.0)
轮廓顶点 (31.9, 23.9, -1.0) | 轮廓顶点 (31.9, 28.1, -1.0)

Slot_4.2_0_ends_1_sketch [原生草图已约束]

圆直径 4.200; 中心 (8.100, 26.000, -1.000)

Slot_4.2_0_ends_2_sketch [原生草图已约束]

圆直径 4.200; 中心 (31.900, 26.000, -1.000)

Slot_4.5_0_sketch [原生草图已约束]

轮廓顶点 (48.25, 23.75, -1.0) | 轮廓顶点 (48.25, 28.25, -1.0)
轮廓顶点 (71.75, 23.75, -1.0) | 轮廓顶点 (71.75, 28.25, -1.0)

Slot_4.5_0_ends_1_sketch [原生草图已约束]

圆直径 4.500; 中心 (48.250, 26.000, -1.000)

Slot_4.5_0_ends_2_sketch [原生草图已约束]

圆直径 4.500; 中心 (71.750, 26.000, -1.000)

# HT01 孔槽及横孔试片

### R2 · 试制工程图 / 单位 mm / 第三角法投影 / 禁止按图缩放量取尺寸

Slot_4.8_0_sketch [原生草图已约束]

轮廓顶点 (8.4, 41.6, -1.0) | 轮廓顶点 (8.4, 46.4, -1.0)
轮廓顶点 (31.6, 41.6, -1.0) | 轮廓顶点 (31.6, 46.4, -1.0)

Slot_4.8_0_ends_1_sketch [原生草图已约束]

圆直径 4.800; 中心 (8.400, 44.000, -1.000)

Slot_4.8_0_ends_2_sketch [原生草图已约束]

圆直径 4.800; 中心 (31.600, 44.000, -1.000)

Horizontal_hole_boss_sketch [原生草图已约束]

轮廓顶点 (50.0, 40.0, 6.0) | 轮廓顶点 (50.0, 56.0, 6.0)
轮廓顶点 (70.0, 40.0, 6.0) | 轮廓顶点 (70.0, 56.0, 6.0)

Horizontal_M4_1_sketch [原生草图已约束]

圆直径 4.500; 中心 (60.000, 39.000, 11.000)

Origin_notch_sketch [原生草图已约束]

轮廓顶点 (0.0, 0.0, -1.0) | 轮廓顶点 (0.0, 3.0, -1.0)
轮廓顶点 (3.0, 0.0, -1.0) | 轮廓顶点 (3.0, 3.0, -1.0)
