czp-1-A1/FPGA_Component_Inspector/开发实施/机械结构展示/机械装配_R2b/P08首次装配记录_布局认可后.csv

检查项目 | 名义值或要求 | 实测/照片编号 | 结果 | 修整记录 | 日期/人员
灯背面接触区域 | 4处Ø10支脚完整落于可承载平面 |  | 待验证
外缘接触面专项 | 四处Ø10支脚逐一核实；理论外缘仅余1mm，检查倒角/台阶/凹槽及实际有效接触面 |  | 待接口确认
四脚高度与周边避让 | 记录四处平面高差、线口和散热开口；不以名义架空代替实测 |  | 待接口确认
厂家允许拧入深度 | 待厂家确认，不能取图示4mm |  | 待验证
螺丝选型 | L-t-h-w，记录极限公差 |  | 待验证
4处M3试穿 | P08Ø3.6未验证；不得修大灯壳螺纹 |  | 待验证
通孔轻修 | 只可轻修PETG；记录前后孔径与工具 |  | 待验证
180度互换 | 只旋转180度，无镜像或强迫对孔 |  | 待验证
四脚贴合 | 检查翘曲、晃动及垫片 |  | 待验证
加载挠曲/松动 | 试验载荷和持续时间待实际记录 |  | 待验证
工作温升 | 记录环境温度、灯工况、稳定温度 |  | 待验证
线口/散热/调焦 | 实物照片与结果 |  | 待验证
维护装入 | D120/H60前送入+5mm落座 |  | 待验证
光学实拍 | 焦距、视场、遮光及样品结果 |  | 待验证
