czp-1-A1/FPGA_Component_Inspector/开发实施/机械结构展示/机械装配_R2/打印准备_阶段2/首件HT01_仅此件试打准备/HT01实测记录.csv

对象 | 原生坐标mm | 名义尺寸mm | 实测孔径/槽宽 | 实测槽总长 | 未修孔螺杆是否自由穿过 | 轻修后结果(另列) | 毛刺/下垂/首层外扩
竖孔1 | (10,10) | 4
竖孔2 | (22,10) | 4.2
竖孔3 | (34,10) | 4.4
竖孔4 | (46,10) | 4.5
竖孔5 | (58,10) | 4.6
竖孔6 | (70,10) | 4.8
槽 | (20,26) | 宽4.2/总长28
槽 | (60,26) | 宽4.5/总长28
槽 | (20,44) | 宽4.8/总长28
横孔 | 轴Y; X60,Z11 | 4.5
