czp-1-A1/FPGA_Component_Inspector/开发实施/机械结构展示/机械装配_R2/evidence/02_structure_view.png

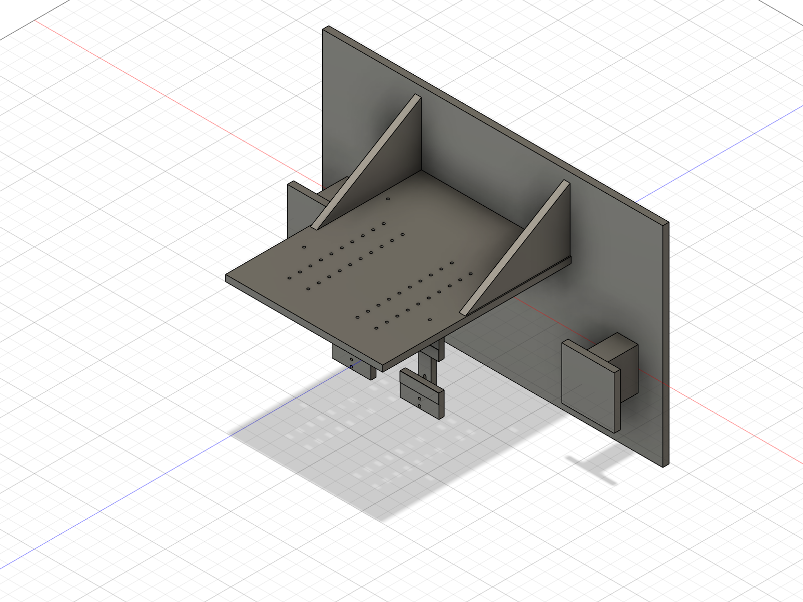
开发实施/机械结构展示/机械装配_R2/evidence/02_structure_view.png
