czp-1-A1/FPGA_Component_Inspector/开发实施/机械结构展示/机械装配_R2/打印准备_阶段2/evidence/图纸复核/CT03-2.png

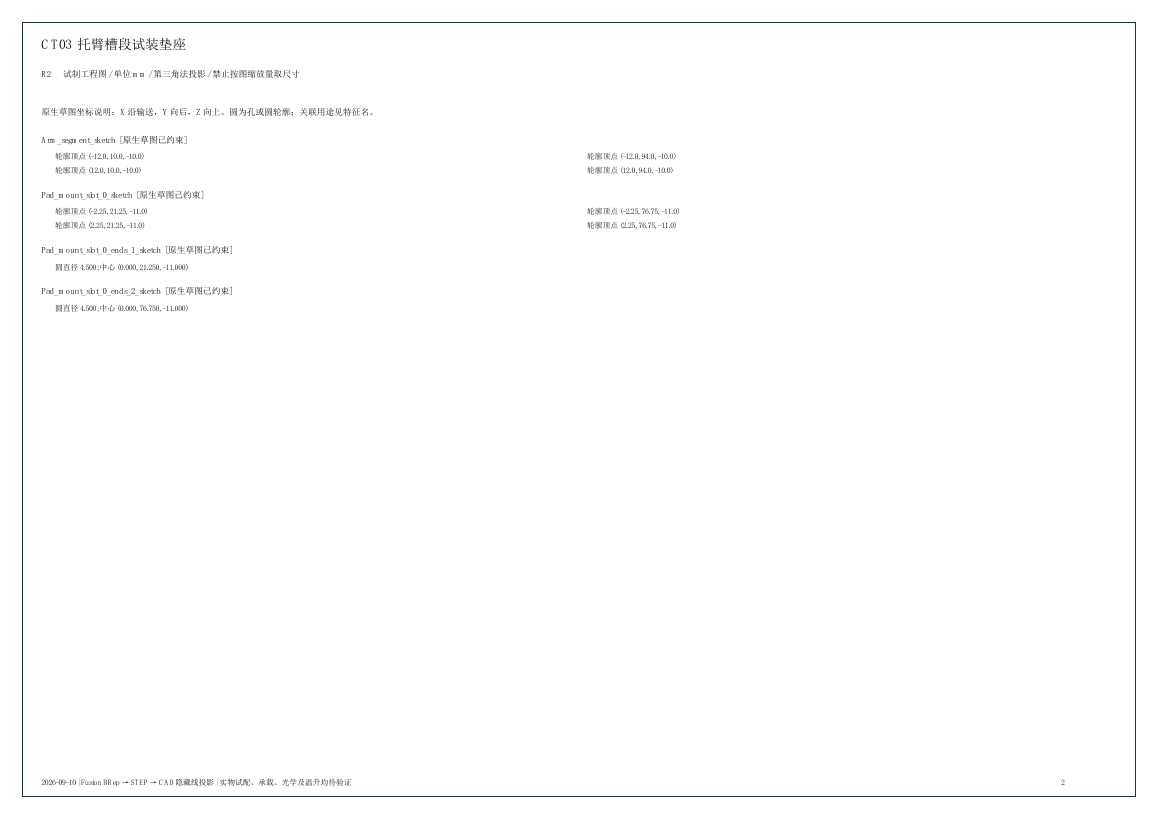
开发实施/机械结构展示/机械装配_R2/打印准备_阶段2/evidence/图纸复核/CT03-2.png
