czp-1-A1/FPGA_Component_Inspector/开发实施/机械结构展示/机械装配_R2b/P08_询价_Q1/evidence/active_before.png

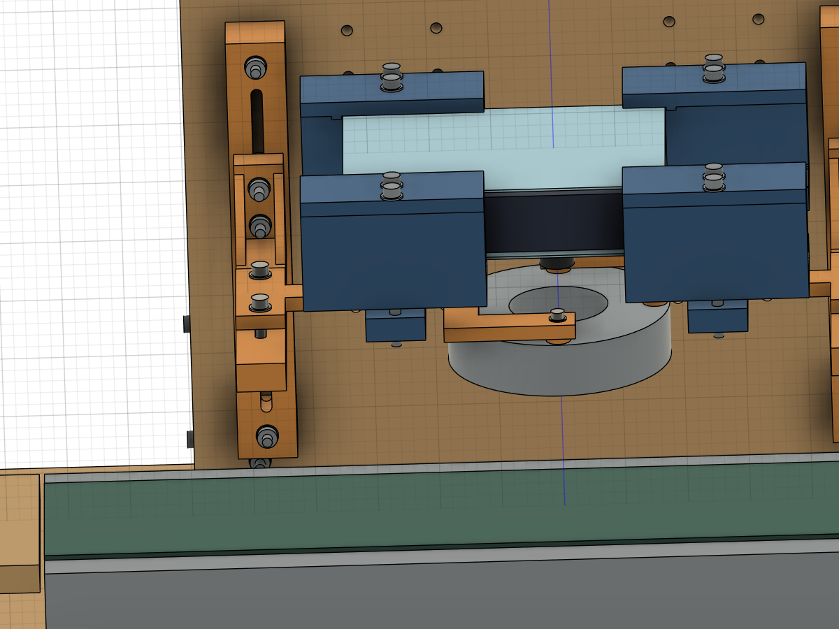
开发实施/机械结构展示/机械装配_R2b/P08_询价_Q1/evidence/active_before.png
