czp-1-A1/FPGA_Component_Inspector/fpga/component_inspector/release/experiment_20261003/README.md

# 静态成像调参实验版本（2026-10-03）

由用户负责下载和实物调试，反馈问题后再修改。当前尚未实现ROI正常/空穴检测，不能用本版评估分类准确率。

- 位流：`camera_to_dsi_display.bit`，未压缩，1,789,539字节；适配PH1P35MDG324，TD 6.2.168116，速度等级3。
- 工程：`../../td_project/camera_to_dsi_display.al`，顶层design_top_wrapper；交付代码在`../../user_source/`。
- 校验：`camera_to_dsi_display.bit.sha256`；`manifest.json`记录195项构建输入的SHA-256与版本信息。
- 完整说明：仓库`开发实施/09_四键成像调参与视频验收.md`。
- 报告：仓库`开发实施/验收记录/20261003_按键调参与输入测量_轮次1/td_final_syn`与`td_final_phy`。

| 按键 | 功能 | 管脚 |
|---|---|---|
| KEY1 | 曝光减 | D5 |
| KEY2 | 曝光加 | A9 |
| KEY3 | 增益减 | B9 |
| KEY4 | 增益加 | C7 |

默认EXP=2244半行，GAIN=48档；曝光步进16，增益步进1。20ms消抖，长按500ms后每60ms重复。同一参数的加减同时按下不改变。参数不持久保存。

屏幕显示EXP/GAIN、接收端实际INPUT尺寸及每秒输入帧数；错误计数为十六进制。HDMI标注为配置模式1024×600、像素时钟约52MHz，不能用显示器刷新率替代摄像头输入帧率。

六项仿真通过。完整综合及布局布线结束：Slice 63.75%，31 ERAM，8 DSP；建立WNS 0.555ns，保持WNS 0.020ns，TNS均0。STA覆盖95.18%，外部I/O与既有IP约束仍有待核验事项，详见验收记录。

用户已确认清楚的实物画面和参数叠加。四键实测、具体尺寸/FPS/计数、30分钟稳定性、Flash固化和断电启动尚未记录。当前不再由Codex操作下载服务；后续由用户测试。

后续状态补充：用户已确认按键有效且亮度响应。初次ModelSim复核移动 `uicfgcs500.v` 中 `iic_error` 的声明位置，并发现只读RAM未连接web；用户随后确认最小修复，当前 `signal_delay.v` 已将web/dib接零，ModelSim默认八项及TD均通过。相对本冻结manifest，当前两项源码哈希不同，不能宣称当前源码与本bit逐字一致。本目录位流及manifest保留原构建记录，新修复版单独保存于相邻 `experiment_ramfix_20261003` 目录；详见仓库`开发实施/验收记录/20261003_RAM只读端口修复_轮次1.md`。
