czp-1-A1/FPGA_Component_Inspector/fpga/component_inspector/release/experiment_ramfix_20261003/README.md

# RAM只读端口修复版（2026-10-03）

用户确认后，仅在根目录 `signal_delay.v` 显式连接AWB RAM只读B端口 `web=0,dib=0`；同时包含此前ModelSim兼容的 `iic_error` 声明位置调整。未新增ROI、识别、结果显示或字体改动；四键与现有OSD沿用实验版。

- 位流：`camera_to_dsi_display.bit`，1,789,539字节，PH1P35MDG324、速度等级3、TD 6.2.168116。
- SHA-256：`e8c925afb42ffbcc4bebd5081ec0fb4b4e266a5ca61fb80caa4d0140fef3fb97`。
- `manifest.json`记录195项当前源码/构建输入的一致性、位流、资源与时序；旧实验版保留在相邻 `experiment_20261003` 目录。
- ModelSim默认八项通过，无测试台RAM输入强制覆盖；TD综合及布局布线通过。
- Slice 63.75%，31 ERAM、8 DSP；Setup/Hold WNS 0.555/0.020ns，TNS均0；STA覆盖95.18%，既有外部I/O及硬IP约束事项仍待核验。
- 后续用户确认本修复版已成功下载；此前连接服务失败保留在验收记录。用户确认画面清楚、四键均正常；30分钟、Flash固化、冷启动仍待现场验证，Codex未代操作下载。

详细报告：仓库 `开发实施/验收记录/20261003_RAM只读端口修复_轮次1.md`。下一批功能方案：`开发实施/13_A检测帧对齐与完整性保护_实施确认稿.md`，待用户确认。
