czp-1-A1/FPGA_Component_Inspector/开发实施/验收记录/20261007_A_EDGE冻结诊断_轮次1/additional_tests/edge_freeze_awb_20261007/events.csv

event | frame | input_gap | mode | cycle | write_y | write_group | read_y | ready_rows | ready | pipeline_idle | frame_bad
read_start | 2 | 1 | 2 | 6837 | 2 | 0 | 0 | 1 | 1 | 1 | 0
read_start | 2 | 1 | 2 | 7099 | 3 | 4 | 1 | 2 | 1 | 1 | 0
cache_overrun | 2 | 1 | 2 | 7352 | 4 | 0 | 1 | 3 | 1 | 0 | 0
read_start | 3 | 1 | 2 | 12369 | 2 | 0 | 0 | 1 | 1 | 1 | 0
read_start | 3 | 1 | 2 | 12631 | 3 | 4 | 1 | 2 | 1 | 1 | 0
cache_overrun | 3 | 1 | 2 | 12884 | 4 | 0 | 1 | 3 | 1 | 0 | 0
read_start | 5 | 2 | 2 | 23449 | 2 | 0 | 0 | 1 | 1 | 1 | 0
read_start | 5 | 2 | 2 | 23711 | 3 | 2 | 1 | 2 | 1 | 1 | 0
read_start | 5 | 2 | 2 | 23973 | 4 | 6 | 2 | 3 | 1 | 1 | 0
cache_overrun | 5 | 2 | 2 | 24225 | 5 | 0 | 2 | 4 | 1 | 0 | 0
read_start | 7 | 4 | 2 | 34575 | 2 | 0 | 0 | 1 | 1 | 1 | 0
read_start | 7 | 4 | 2 | 34837 | 3 | 0 | 1 | 2 | 1 | 1 | 0
read_start | 7 | 4 | 2 | 35099 | 4 | 0 | 2 | 3 | 1 | 1 | 0
read_start | 7 | 4 | 2 | 35361 | 5 | 2 | 3 | 4 | 1 | 1 | 0
read_start | 7 | 4 | 2 | 35623 | 6 | 4 | 4 | 5 | 1 | 1 | 0
read_start | 7 | 4 | 2 | 35885 | 7 | 6 | 5 | 6 | 1 | 1 | 0
cache_overrun | 7 | 4 | 2 | 36139 | 8 | 0 | 5 | 7 | 1 | 0 | 0
read_start | 9 | 6 | 2 | 45761 | 2 | 0 | 0 | 1 | 1 | 1 | 0
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
