czp-1-A1/FPGA_Component_Inspector/开发实施/验收记录/20261007_A_EDGE冻结诊断_轮次1/additional_tests/edge_freeze_awb_20261007/isp_lifecycle_events.csv

event | frame | cycle | source_request | received_request | raw_start | observation_match | guard_bad | video_bad
FS_or_bad_change | 1 | 957 | 0 | 0 | 1 | 1 | 0 | 0
FS_or_bad_change | 1 | 1047 | 0 | 0 | 0 | 1 | 0 | 0
FS_or_bad_change | 1 | 1101 | 0 | 0 | 0 | 1 | 0 | 0
FS_or_bad_change | 1 | 1182 | 0 | 0 | 0 | 1 | 1 | 0
FS_or_bad_change | 1 | 1183 | 0 | 0 | 0 | 1 | 1 | 1
FS_or_bad_change | 2 | 5471 | 0 | 0 | 1 | 1 | 1 | 1
FS_or_bad_change | 2 | 5472 | 0 | 0 | 0 | 1 | 0 | 1
FS_or_bad_change | 2 | 5940 | 0 | 0 | 0 | 1 | 0 | 1
FS_or_bad_change | 2 | 5941 | 0 | 0 | 0 | 1 | 0 | 0
FS_or_bad_change | 2 | 5994 | 0 | 0 | 0 | 1 | 0 | 0
FS_or_bad_change | 3 | 17149 | 6 | 0 | 1 | 1 | 0 | 0
FS_or_bad_change | 3 | 17151 | 6 | 0 | 0 | 1 | 0 | 1
request_delivery | 3 | 17159 | 6 | 6 | 0 | 0 | 0 | 1
FS_or_bad_change | 3 | 17160 | 6 | 6 | 0 | 0 | 1 | 1
FS_or_bad_change | 3 | 17618 | 6 | 6 | 0 | 0 | 1 | 1
FS_or_bad_change | 3 | 17619 | 6 | 6 | 0 | 0 | 1 | 0
FS_or_bad_change | 3 | 17620 | 6 | 6 | 0 | 0 | 1 | 1
FS_or_bad_change | 3 | 17672 | 6 | 6 | 0 | 0 | 1 | 1
FS_or_bad_change | 4 | 29727 | 6 | 6 | 1 | 1 | 1 | 1
FS_or_bad_change | 4 | 29728 | 6 | 6 | 0 | 1 | 0 | 1
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
