czp-1-A1/FPGA_Component_Inspector/开发实施/验收记录/20261007_A_EDGE冻结诊断_轮次1/additional_tests/edge_freeze_awb_20261007/summary.csv

frame | mode | input_gap | awb_beats | awb_rows | awb_sofs | min_awb_gap | max_awb_gap | view_beats | view_rows | packed_words | frame_bad | bad_write_row | bad_write_group | bad_read_row | min_read_start_period | max_read_start_period | ready_hold
1 | 0 | 1 | 4096 | 16 | 1 | 1 | 1 | 4096 | 16 | 3072 | 0 | -1 | -1 | -1 | 999999 | 0 | 0
2 | 2 | 1 | 4096 | 16 | 1 | 1 | 1 | 504 | 1 | 378 | 1 | 4 | 0 | 1 | 262 | 262 | 0
3 | 2 | 1 | 4096 | 16 | 1 | 1 | 1 | 504 | 1 | 378 | 1 | 4 | 0 | 1 | 262 | 262 | 0
4 | 0 | 2 | 4096 | 16 | 1 | 2 | 2 | 4096 | 16 | 3072 | 0 | -1 | -1 | -1 | 999999 | 0 | 0
5 | 2 | 2 | 4096 | 16 | 1 | 2 | 2 | 759 | 2 | 569 | 1 | 5 | 0 | 2 | 262 | 262 | 0
6 | 0 | 4 | 4096 | 16 | 1 | 4 | 4 | 4096 | 16 | 3072 | 0 | -1 | -1 | -1 | 999999 | 0 | 0
7 | 2 | 4 | 4096 | 16 | 1 | 4 | 4 | 1529 | 5 | 1146 | 1 | 8 | 0 | 5 | 262 | 262 | 0
8 | 0 | 6 | 4096 | 16 | 1 | 6 | 6 | 4096 | 16 | 3072 | 0 | -1 | -1 | -1 | 999999 | 0 | 0
9 | 2 | 6 | 4096 | 16 | 1 | 6 | 6 | 4096 | 16 | 3072 | 0 | -1 | -1 | -1 | 262 | 262 | 0
10 | 0 | 8 | 4096 | 16 | 1 | 8 | 8 | 4096 | 16 | 3072 | 0 | -1 | -1 | -1 | 999999 | 0 | 0
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
