czp-1-A1/FPGA_Component_Inspector/开发实施/验收记录/20261007_A_EDGE冻结诊断_轮次1/additional_tests/edge_freeze_awb_20261007/lifecycle_after_diag/full_g160_events.csv

event | frame | cycle | source_request | received_request | raw_start | observation_match | guard_bad | video_bad
FS_or_bad_change | 1 | 957 | 0 | 0 | 1 | 1 | 0 | 0
FS_or_bad_change | 1 | 1047 | 0 | 0 | 0 | 1 | 0 | 0
FS_or_bad_change | 1 | 1101 | 0 | 0 | 0 | 1 | 0 | 0
FS_or_bad_change | 1 | 1182 | 0 | 0 | 0 | 1 | 1 | 0
FS_or_bad_change | 1 | 1183 | 0 | 0 | 0 | 1 | 1 | 1
request_delivery | 1 | 5093 | 6 | 6 | 0 | 0 | 1 | 1
FS_or_bad_change | 2 | 6023 | 6 | 6 | 1 | 1 | 1 | 1
FS_or_bad_change | 2 | 6024 | 6 | 6 | 0 | 1 | 0 | 1
FS_or_bad_change | 2 | 6492 | 6 | 6 | 0 | 1 | 0 | 1
FS_or_bad_change | 2 | 6493 | 6 | 6 | 0 | 1 | 0 | 0
FS_or_bad_change | 2 | 6546 | 6 | 6 | 0 | 1 | 0 | 0
FS_or_bad_change | 3 | 487850 | 6 | 6 | 1 | 1 | 0 | 0
FS_or_bad_change | 3 | 488319 | 6 | 6 | 0 | 1 | 0 | 0
FS_or_bad_change | 3 | 488373 | 6 | 6 | 0 | 1 | 0 | 0
