czp-1-A1/FPGA_Component_Inspector/开发实施/验收记录/20261007_A_EDGE冻结诊断_轮次1/additional_tests/edge_freeze_awb_20261007/lifecycle_pilot/isp_lifecycle_events.csv

event | frame | cycle | source_request | received_request | raw_start | observation_match | guard_bad | video_bad
FS_or_bad_change | 1 | 957 | 0 | 0 | 1 | 1 | 0 | 0
FS_or_bad_change | 1 | 1047 | 0 | 0 | 0 | 1 | 0 | 0
FS_or_bad_change | 1 | 1101 | 0 | 0 | 0 | 1 | 0 | 0
FS_or_bad_change | 1 | 1182 | 0 | 0 | 0 | 1 | 1 | 0
FS_or_bad_change | 1 | 1183 | 0 | 0 | 0 | 1 | 1 | 1
FS_or_bad_change | 2 | 5471 | 0 | 0 | 1 | 1 | 1 | 1
FS_or_bad_change | 2 | 5472 | 0 | 0 | 0 | 1 | 0 | 1
FS_or_bad_change | 2 | 5940 | 0 | 0 | 0 | 1 | 0 | 1
FS_or_bad_change | 2 | 5941 | 0 | 0 | 0 | 1 | 0 | 0
FS_or_bad_change | 2 | 5994 | 0 | 0 | 0 | 1 | 0 | 0
request_delivery | 2 | 17159 | 6 | 6 | 0 | 0 | 0 | 0
FS_or_bad_change | 3 | 18049 | 6 | 6 | 1 | 1 | 1 | 1
FS_or_bad_change | 3 | 18050 | 6 | 6 | 0 | 1 | 0 | 1
FS_or_bad_change | 3 | 18518 | 6 | 6 | 0 | 1 | 0 | 1
FS_or_bad_change | 3 | 18519 | 6 | 6 | 0 | 1 | 0 | 0
FS_or_bad_change | 3 | 18572 | 6 | 6 | 0 | 1 | 0 | 0
