czp-1-A1/FPGA_Component_Inspector/开发实施/验收记录/20261007_A_EDGE冻结诊断_轮次1/additional_tests/edge_freeze_awb_20261007/ready_recovery_initial/credit_events.csv

event | frame | cycle | credit | Sobel_bad | ISP_bad | camera_bad | FIFO_used | write_y | read_y
credit_or_FS | 1 | 1217 | 1 | 0 | 0 | 0 | 0 | 0 | 0
credit_or_FS | 1 | 1218 | 1 | 0 | 0 | 0 | 0 | 0 | 0
credit_or_FS | 1 | 1219 | 0 | 0 | 0 | 0 | 0 | 0 | 0
credit_or_FS | 1 | 1232 | 1 | 0 | 0 | 0 | 0 | 0 | 0
credit_or_FS | 2 | 13894 | 1 | 0 | 0 | 0 | 0 | 16 | 0
credit_or_FS | 2 | 13895 | 1 | 0 | 0 | 0 | 0 | 16 | 0
credit_or_FS | 2 | 13896 | 0 | 0 | 0 | 0 | 0 | 16 | 0
credit_or_FS | 2 | 13908 | 1 | 0 | 0 | 0 | 0 | 16 | 0
credit_or_FS | 2 | 15641 | 0 | 0 | 0 | 0 | 289 | 3 | 1
release_read_busy | 2 | 16369 | 0 | 0 | 0 | 0 | 384 | 4 | 2
credit_or_FS | 2 | 16517 | 1 | 0 | 0 | 0 | 288 | 4 | 2
credit_or_FS | 2 | 16584 | 0 | 0 | 0 | 0 | 289 | 4 | 2
credit_or_FS | 2 | 16585 | 1 | 0 | 0 | 0 | 288 | 4 | 2
credit_or_FS | 2 | 16587 | 0 | 0 | 0 | 0 | 289 | 4 | 2
credit_or_FS | 2 | 16589 | 1 | 0 | 0 | 0 | 288 | 4 | 2
credit_or_FS | 2 | 16590 | 0 | 0 | 0 | 0 | 289 | 4 | 2
credit_or_FS | 2 | 16808 | 1 | 0 | 0 | 0 | 288 | 5 | 3
credit_or_FS | 2 | 16875 | 0 | 0 | 0 | 0 | 289 | 5 | 3
credit_or_FS | 2 | 16876 | 1 | 0 | 0 | 0 | 288 | 5 | 3
credit_or_FS | 2 | 16878 | 0 | 0 | 0 | 0 | 289 | 5 | 3
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
