czp-1-A1/FPGA_Component_Inspector/开发实施/验收记录/20261007_A_EDGE冻结诊断_轮次1/additional_tests/edge_freeze_transport_20261007/mc_switch_0_0_gap_384_compete_1_pause_1200/trace.csv

cycle | frame_id | mode | input_y | input_group | read_y | reading | ready_rows | credit | camera_used | fifo_rd_used | write_busy | read_busy | view_pixels | packed_words | mc_words | frame_bad | cache_overrun
1 | 0 | 0 | 0 | 0 | 0 | 0 | 0 | 1 | 0 | 0 | 0 | 0 | 0 | 0 | 0 | 0 | 0
25 | 1 | 0 | 0 | 0 | 0 | 0 | 0 | 0 | 0 | 0 | 0 | 0 | 0 | 0 | 0 | 0 | 0
36 | 1 | 0 | 0 | 0 | 0 | 0 | 0 | 1 | 0 | 0 | 0 | 0 | 0 | 0 | 0 | 0 | 0
333 | 1 | 0 | 0 | 255 | 0 | 0 | 0 | 1 | 189 | 186 | 0 | 0 | 1020 | 190 | 0 | 0 | 0
1101 | 1 | 0 | 1 | 255 | 0 | 0 | 0 | 1 | 276 | 270 | 1 | 0 | 2044 | 382 | 107 | 0 | 0
1869 | 1 | 0 | 2 | 255 | 0 | 0 | 1 | 1 | 266 | 260 | 1 | 0 | 3068 | 574 | 309 | 0 | 0
2637 | 1 | 0 | 3 | 255 | 0 | 0 | 2 | 1 | 256 | 250 | 1 | 0 | 4092 | 766 | 511 | 0 | 0
3405 | 1 | 0 | 4 | 255 | 0 | 0 | 3 | 1 | 237 | 234 | 0 | 0 | 5116 | 958 | 720 | 0 | 0
4173 | 1 | 0 | 5 | 255 | 0 | 0 | 4 | 1 | 189 | 186 | 0 | 0 | 6140 | 1150 | 960 | 0 | 0
4941 | 1 | 0 | 6 | 255 | 0 | 0 | 5 | 1 | 276 | 270 | 1 | 0 | 7164 | 1342 | 1067 | 0 | 0
5709 | 1 | 0 | 7 | 255 | 0 | 0 | 6 | 1 | 266 | 260 | 1 | 0 | 8188 | 1534 | 1269 | 0 | 0
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
