czp-1-A1/FPGA_Component_Inspector/开发实施/验收记录/20261007_A_EDGE冻结诊断_轮次1/additional_tests/edge_freeze_transport_20261007/mc_switch_2_0_gap_384_compete_1_pause_1000/trace.csv

cycle | frame_id | mode | input_y | input_group | read_y | reading | ready_rows | credit | camera_used | fifo_rd_used | write_busy | read_busy | view_pixels | packed_words | mc_words | frame_bad | cache_overrun
1 | 0 | 0 | 0 | 0 | 0 | 0 | 0 | 1 | 0 | 0 | 0 | 0 | 0 | 0 | 0 | 0 | 0
25 | 1 | 2 | 0 | 0 | 0 | 0 | 0 | 0 | 0 | 0 | 0 | 0 | 0 | 0 | 0 | 0 | 0
36 | 1 | 2 | 0 | 0 | 0 | 0 | 0 | 1 | 0 | 0 | 0 | 0 | 0 | 0 | 0 | 0 | 0
333 | 1 | 2 | 0 | 255 | 0 | 0 | 0 | 1 | 0 | 0 | 0 | 0 | 0 | 0 | 0 | 0 | 0
1101 | 1 | 2 | 1 | 255 | 0 | 0 | 0 | 1 | 0 | 0 | 0 | 0 | 0 | 0 | 0 | 0 | 0
1869 | 1 | 2 | 2 | 255 | 1 | 0 | 1 | 1 | 192 | 192 | 0 | 0 | 1024 | 192 | 0 | 0 | 0
2637 | 1 | 2 | 3 | 255 | 2 | 0 | 2 | 1 | 144 | 144 | 0 | 0 | 2048 | 384 | 240 | 0 | 0
3405 | 1 | 2 | 4 | 255 | 3 | 0 | 3 | 1 | 96 | 96 | 0 | 0 | 3072 | 576 | 480 | 0 | 0
4173 | 1 | 2 | 5 | 255 | 4 | 0 | 4 | 1 | 48 | 48 | 0 | 0 | 4096 | 768 | 720 | 0 | 0
4941 | 1 | 2 | 6 | 255 | 5 | 0 | 5 | 1 | 0 | 0 | 0 | 0 | 5120 | 960 | 960 | 0 | 0
5709 | 1 | 2 | 7 | 255 | 6 | 0 | 6 | 1 | 192 | 192 | 0 | 0 | 6144 | 1152 | 960 | 0 | 0
6477 | 1 | 2 | 8 | 255 | 7 | 0 | 7 | 1 | 144 | 144 | 0 | 0 | 7168 | 1344 | 1200 | 0 | 0
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
