czp-1-A1/FPGA_Component_Inspector/开发实施/验收记录/20261006_A_SW视频链路修复_轮次1/additional_tests/awb_epoch_verify_20261006/corrected_monitor/legacy/epoch_trace.csv

mode | time_ns | cycle | early_at_sample | awb_valid_at_sample | pixel_sof_at_sample | rd_valid_after | rd_valid_d_after | valid_d1_after | valid_d2_after | view_valid_after | packed_valid_after | frame_bad_after | write_row_after | write_group_after
0 | 528596000 | 2860 | 1 | 1 | 0 | 0 | 1 | 1 | 1 | 0 | 1 | 0 | 3 | 209
0 | 528606000 | 2861 | 0 | 1 | 0 | 0 | 0 | 1 | 1 | 1 | 0 | 0 | 3 | 210
0 | 528616000 | 2862 | 0 | 1 | 0 | 0 | 0 | 0 | 1 | 1 | 0 | 0 | 3 | 211
0 | 528626000 | 2863 | 0 | 1 | 0 | 0 | 0 | 0 | 0 | 1 | 1 | 0 | 4 | 0
0 | 528636000 | 2864 | 0 | 0 | 0 | 0 | 0 | 0 | 0 | 0 | 1 | 0 | 4 | 0
0 | 528646000 | 2865 | 0 | 0 | 0 | 0 | 0 | 0 | 0 | 0 | 0 | 0 | 4 | 0
0 | 528656000 | 2866 | 0 | 0 | 0 | 0 | 0 | 0 | 0 | 0 | 0 | 0 | 4 | 0
0 | 528666000 | 2867 | 0 | 0 | 0 | 0 | 0 | 0 | 0 | 0 | 0 | 0 | 4 | 0
0 | 528676000 | 2868 | 0 | 0 | 0 | 0 | 0 | 0 | 0 | 0 | 0 | 0 | 4 | 0
1 | 1057396000 | 5740 | 1 | 1 | 0 | 0 | 1 | 1 | 1 | 0 | 1 | 0 | 3 | 209
1 | 1057406000 | 5741 | 0 | 1 | 0 | 0 | 0 | 1 | 1 | 1 | 0 | 0 | 3 | 210
1 | 1057416000 | 5742 | 0 | 1 | 0 | 0 | 0 | 0 | 1 | 1 | 0 | 0 | 3 | 211
1 | 1057426000 | 5743 | 0 | 1 | 0 | 0 | 0 | 0 | 0 | 1 | 1 | 0 | 4 | 0
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
