czp-1-A1/FPGA_Component_Inspector/开发实施/机械结构展示/零件工程图_R1/qa/page-01.png

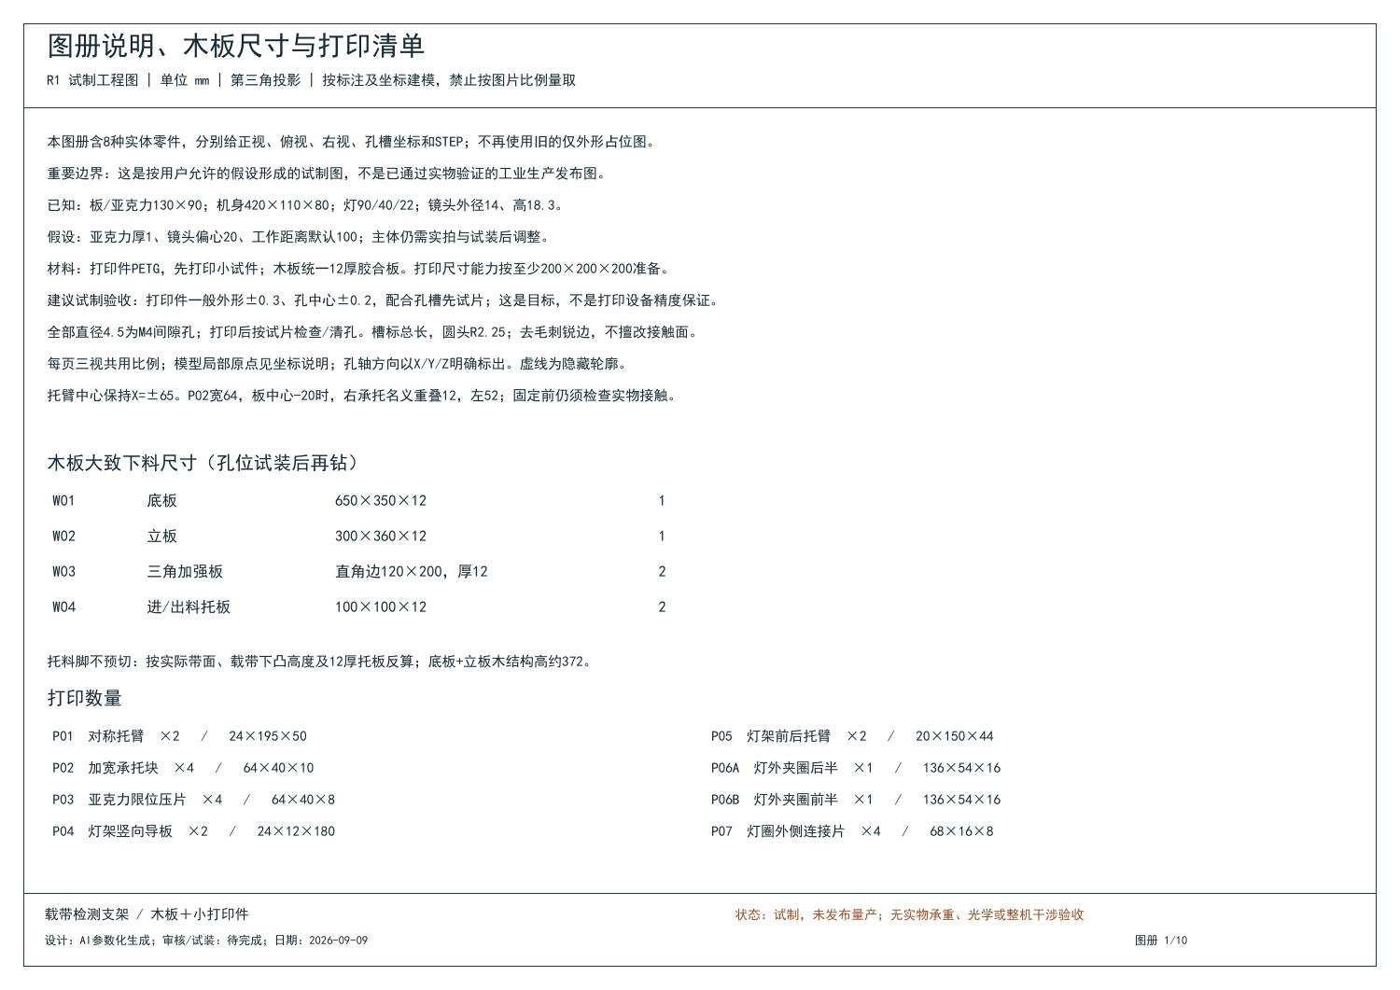
开发实施/机械结构展示/零件工程图_R1/qa/page-01.png
