czp-1-A1/FPGA_Component_Inspector/fpga/component_inspector/release/video_fix_20261006/README.zh-CN.md

# SW 视频链路修复候选版（2026-10-06）

已完成软件仿真、综合、布局布线及位流生成；板上稳定性待实测。本版用于验证 SW 实验版出现的左侧竖条、摄像头花屏和闪屏。

烧录文件：[camera_to_dsi_display.bit](D:/BaiduNetdiskDownload/HX1P35A_Contest_202606/FPGA_Component_Inspector/fpga/component_inspector/release/video_fix_20261006/camera_to_dsi_display.bit)，1,789,539 字节。SHA-256：

```text
1584f39b53f315c369feb41617539dbbb944b455ae3fe84a045d7824dcfac0d5
```

保持 1024×600、原取样界面字体与 Logo、绿色 512×256 观测框、青色 80×80 取样框、曝光和增益四键。正式分类仍未启用，“未标定”为预期状态。

| SW1 | SW2 | MODE |
|---|---|---|
| 下 | 下 | RAW |
| 上 | 下 | GRAY |
| 下 | 上 | EDGE |
| 上 | 上 | GRAY+EDGE |

SW1 开启绿色框内灰度，SW2 开启绿色框内橙色 Sobel 边缘；框外保留原彩色。切换请求经过消抖，在新输入帧应用，并有 DDR 显示延迟。KEY1/2 继续曝光减/加，KEY3/4 继续增益减/加。阈值 T80 仅用于观察；EC/GS 为青框的边缘数量/梯度和，十六进制显示。

修复了流暂停时的像素打包、帧尾传输、完整帧发布、跨显示帧残留响应和下溢恢复。新帧通知后遗留的旧 AWB 像素会被丢弃，直到收到有效的新帧起点。异常时采样状态撤销，恢复后等新的有效采样。

页脚新增 16 位十六进制累计值，每个显示帧统一快照，复位清零：

| 指标 | 含义 |
|---|---|
| OF | 摄像头写 FIFO 溢出的帧数 |
| VF | 新输入帧到来时，上一帧尚未完整发布的次数 |
| UF | 显示已经选择完整帧，但预填充/读数据不足的帧数 |

先按以下步骤验证，暂时不评估分类准确率：

1. SW1、SW2 均拨下，烧录本文件。保持原摄像头接线、曝光和增益；等待画面和采样状态恢复，再记录三个累计值。启动时需等完整帧，短暂黑画面不作为稳态结果。
2. RAW 连续观察 1 分钟，检查左侧竖条、花屏/闪屏及 OF/VF/UF 是否继续增长。不要以“采样有效”单独判断图像正常。
3. 依次切到 GRAY、EDGE、GRAY+EDGE；每次等待约 5 秒，再记录基准计数并观察 1 分钟。切换过程可能主动丢弃未完成帧，比较稳定后的计数变化。
4. 四种模式正常后再做复位、冷启动和 30 分钟持续观察。出现异常时，保留模式、前后计数、曝光/增益及带完整界面的照片或视频，记录是否仅视频区异常。

本版 16 项默认测试有明确 PASS；最终 Sobel 修改已复测，真实 ISP 九帧与逐字证明另用最新源码完成。四模式传输共比较 4,915,200 显示像素；真实 AWB 的旧版失败与修复版四模式通过均保留。TD 6.2.168116 / PH1P35MDG324 speed3：Slice 76.60%、ERAM 48、DSP 8；最终建立 +0.310 ns、保持 +0.020 ns、TNS 均 0，STA 覆盖 94.54%。时钟布线等既有 critical 告警及未满的约束覆盖保留，详细范围见验收记录。

[详细验收记录](D:/BaiduNetdiskDownload/HX1P35A_Contest_202606/FPGA_Component_Inspector/开发实施/验收记录/20261006_A_SW视频链路修复_轮次1/验收记录.md)；[上板记录表](D:/BaiduNetdiskDownload/HX1P35A_Contest_202606/FPGA_Component_Inspector/开发实施/验收记录/20261006_A_SW视频链路修复_轮次1/上板记录表.md)。未操作 JTAG、未提交或推送。旧 sample_ui_20261005 与 sw_edge_20261005 位流未覆盖。
