czp-1-A1/FPGA_Component_Inspector/摄像头+镜头/SC500CS板原理图.pdf

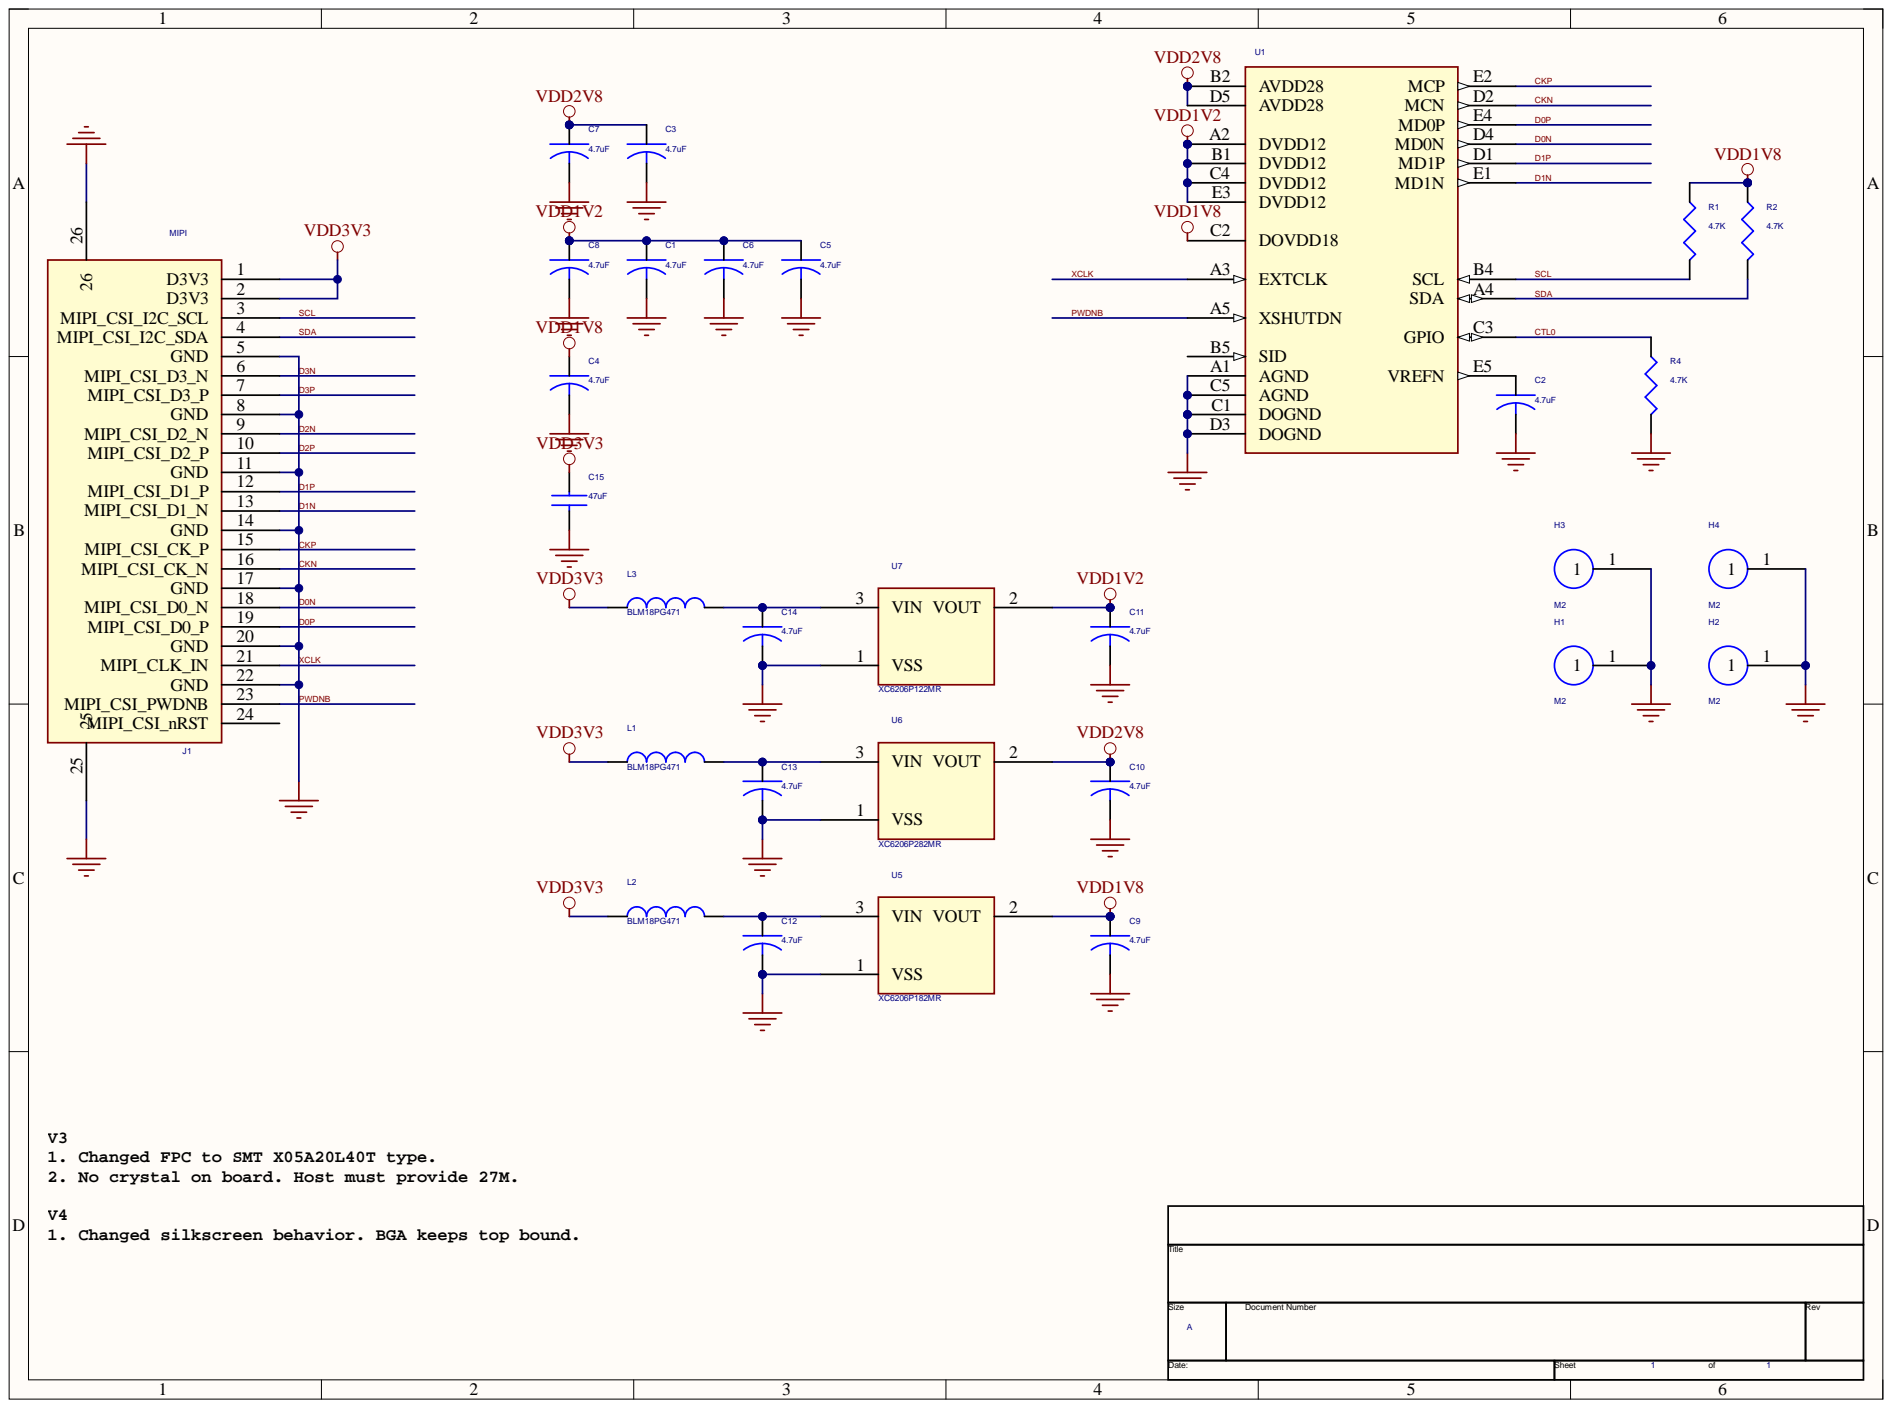
[picture p232: page 1]

1. Changed FPC to SMT X05A20L40T type.
2. No crystal on board. Host must provide 27M.

1. Changed silkscreen behavior. BGA keeps top bound.
