czp-1-A1/FPGA_Component_Inspector/官方资料/02_开发板手册与引脚/开发板原理图/HX1P35B_FT_40P_2.pdf

# GND

NC

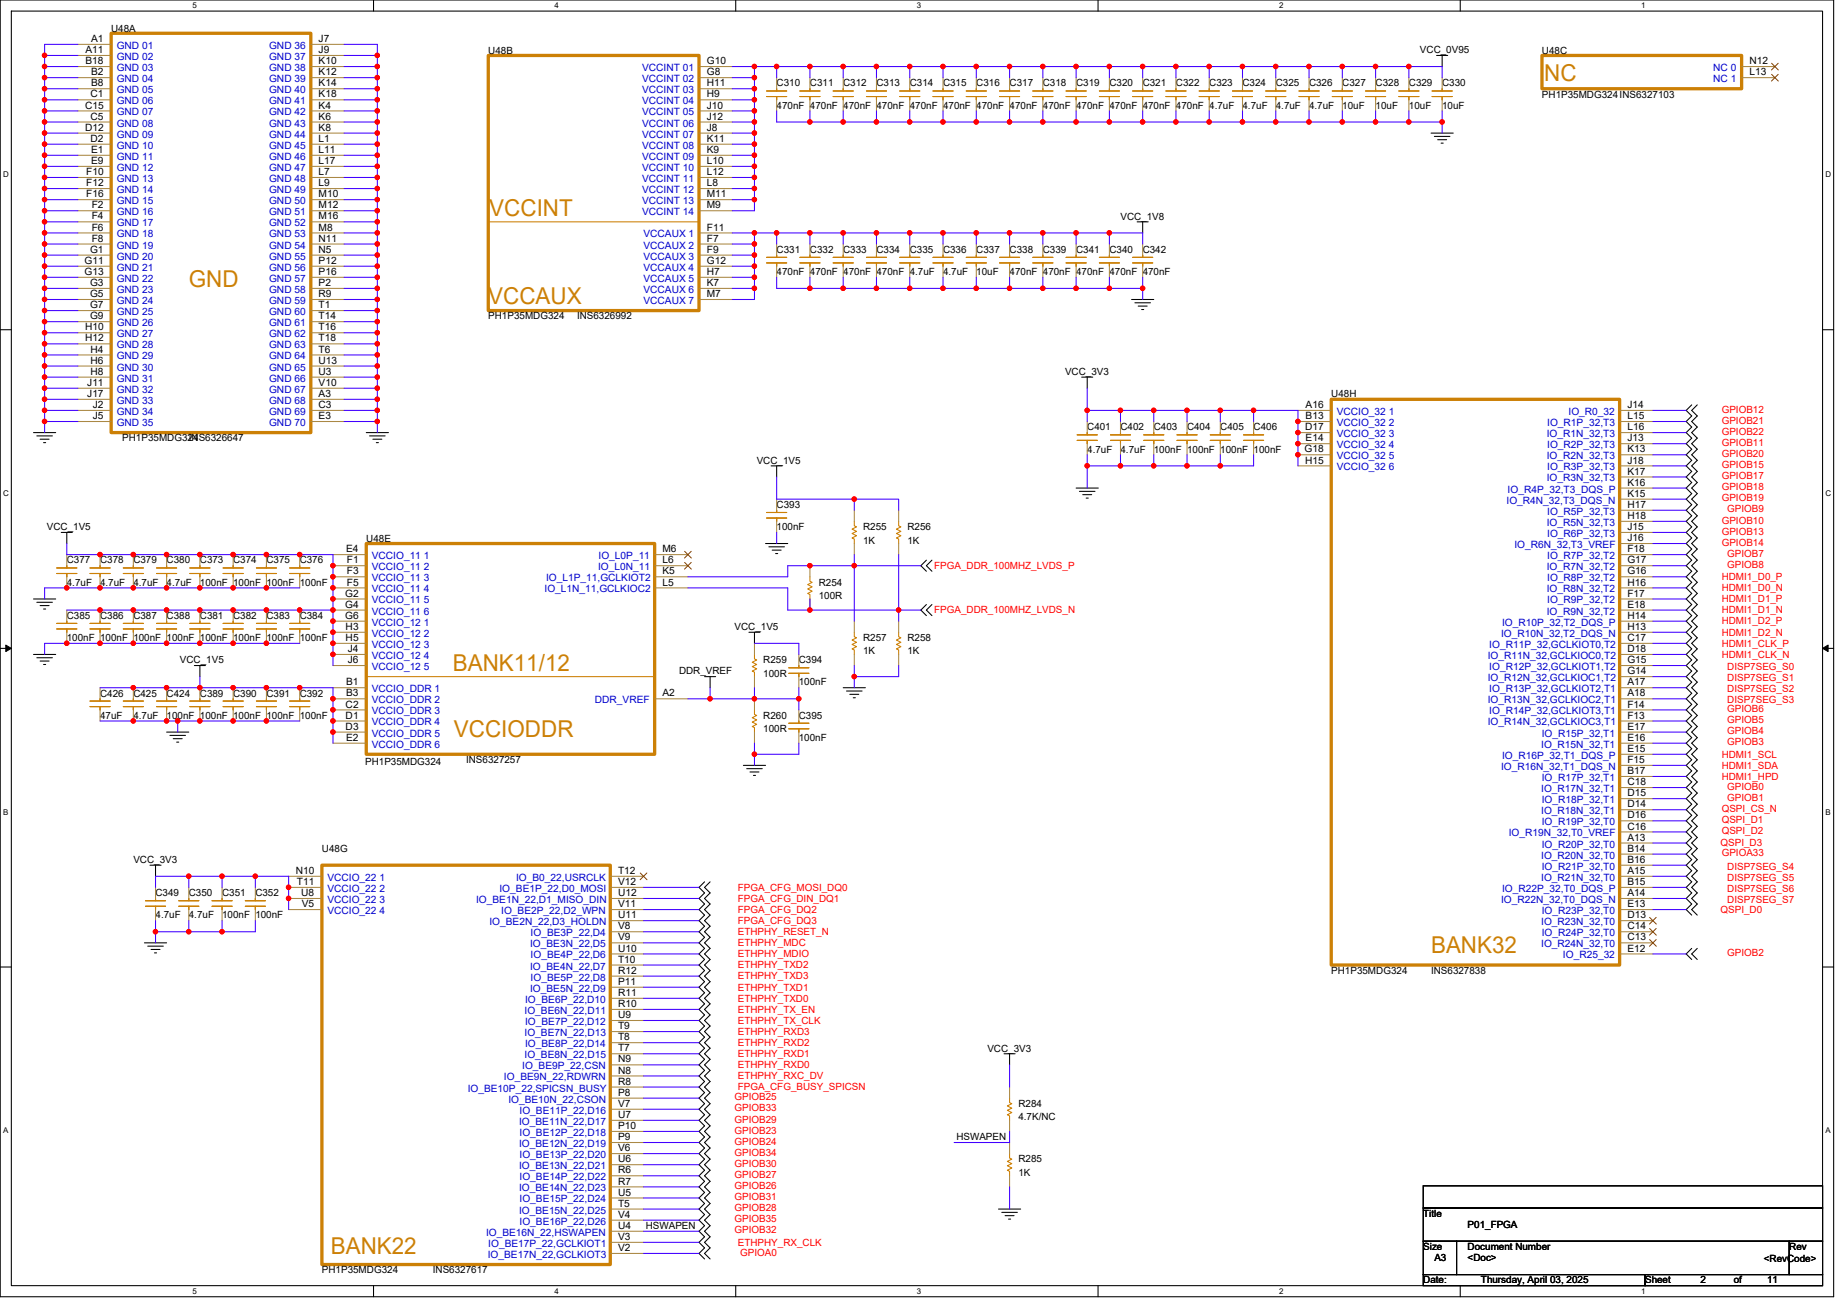
[picture p233: page 1]

Size Size Size A3 A3 A3 | Document Number Document Number Document Number <Doc> <Doc> <Doc> <RevCode> <RevCode> <RevCode> | Rev Rev Rev

Date: Date: Date: Thursday, April 03, 2025 Thursday, April 03, 2025 Thursday, April 03, 2025 | Sheet Sheet Sheet 2 2 2 of of of 11 11 11
