czp-1-A1/FPGA_Component_Inspector/官方资料/02_开发板手册与引脚/开发板原理图/HX1P35B_FT_40P_4.pdf

1.8V

# POWER

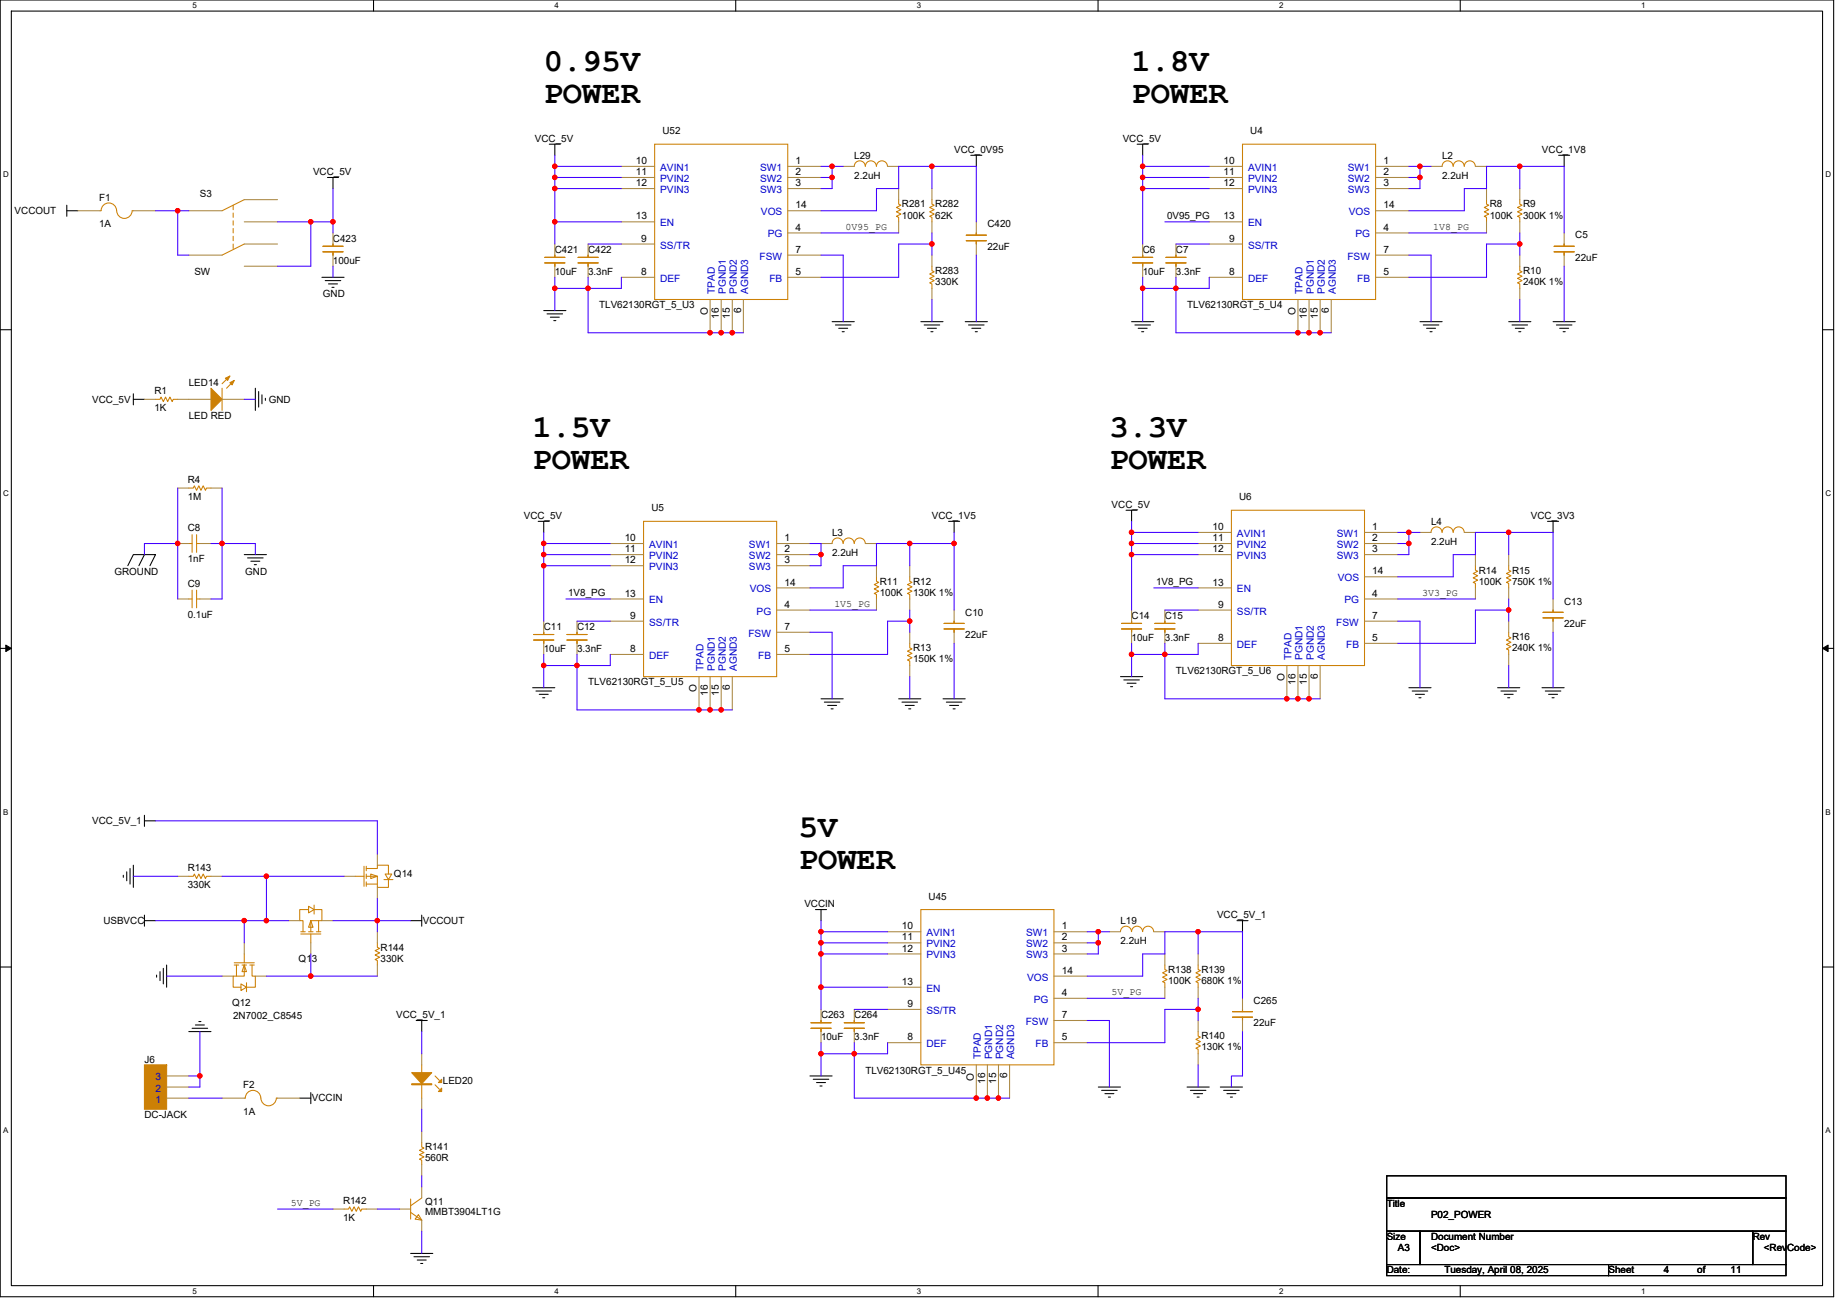
[picture p234: page 1]

Size Size Size A3 A3 A3 | Document Number Document Number Document Number | Rev Rev Rev

Date: Date: Date: Tuesday, April 08, 2025 Tuesday, April 08, 2025 Tuesday, April 08, 2025 | Sheet Sheet Sheet 4 4 4 of of of 11 11 11
