czp-1-A1/FPGA_Component_Inspector/官方资料/02_开发板手册与引脚/开发板原理图/HX1P35B_FT_40P_8.pdf

QSPI FLASH | 4 bit LED

# SPI FLASH

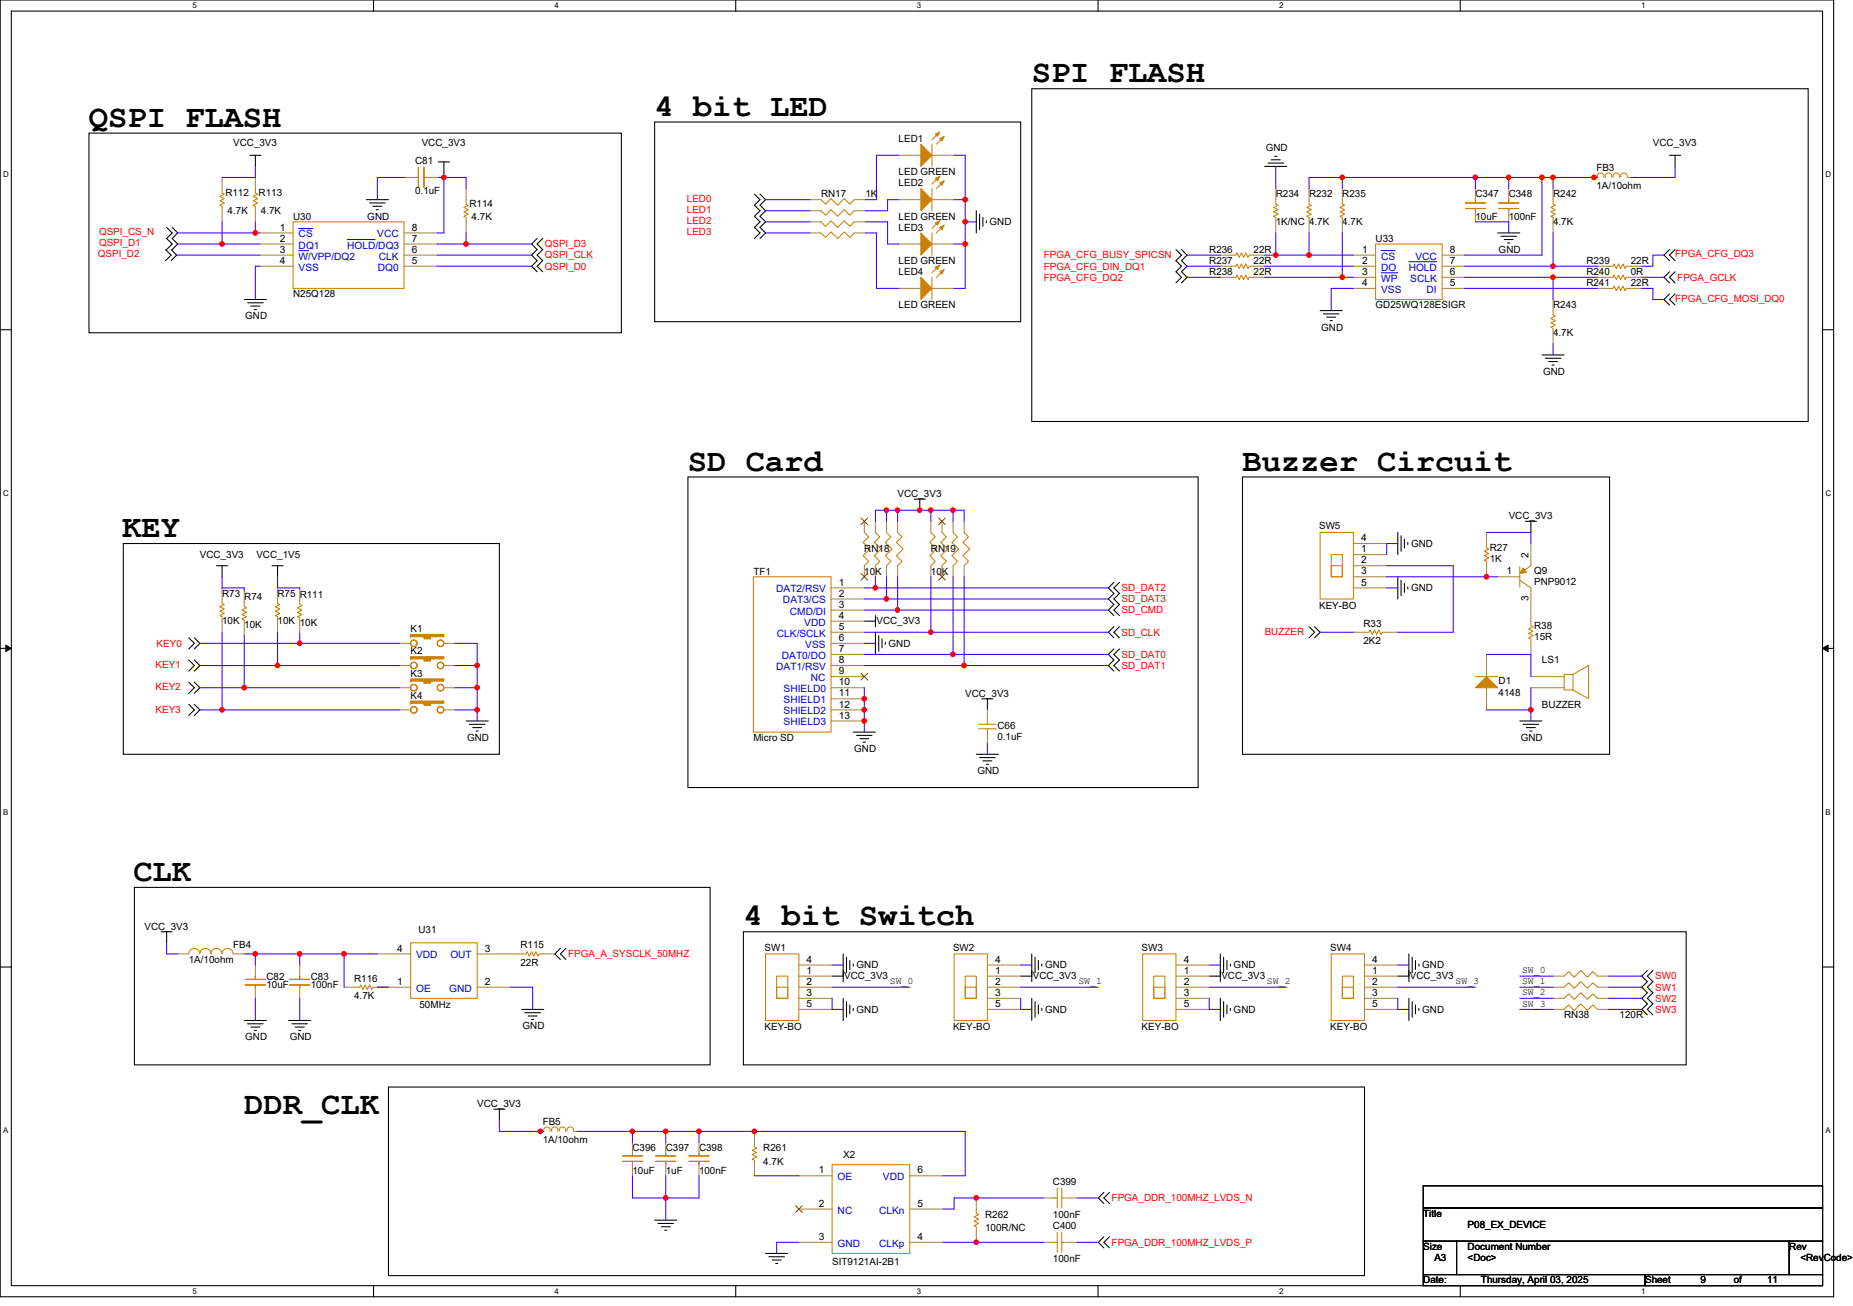
[picture p236: page 1]
