czp-1-A1/FPGA_Component_Inspector/官方资料/02_开发板手册与引脚/开发板原理图/HX1P35B_FT_40P_1.pdf

# PH1P35_FT V1

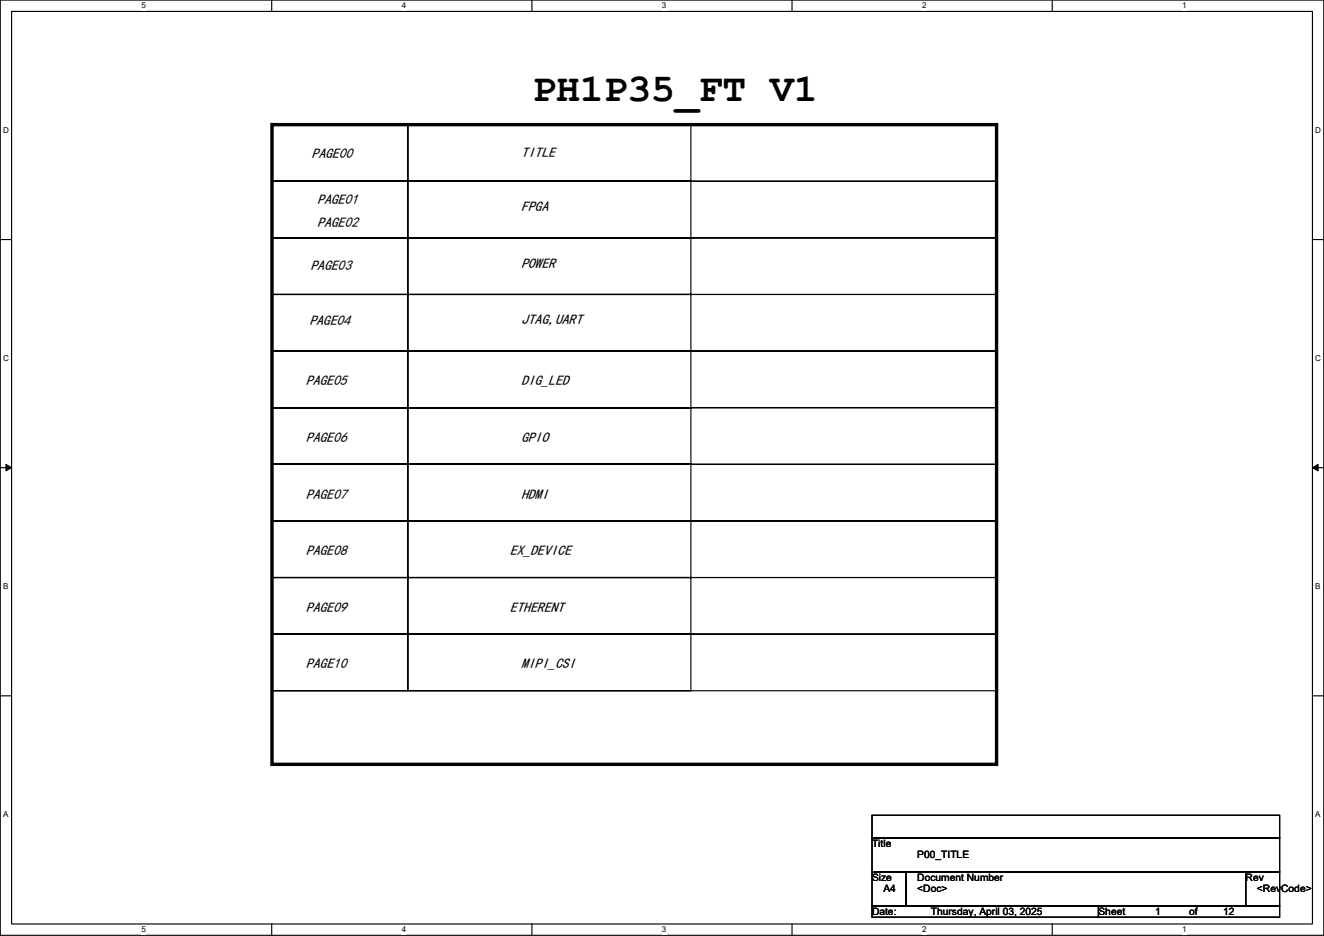
[picture p245: page 1]
Title; <Doc>; <RevCode>; P00_TITLE

Size Size Size A4 A4 A4 | Document Number Document Number Document Number | Rev Rev Rev

Date: Date: Date: Thursday, April 03, 2025 Thursday, April 03, 2025 Thursday, April 03, 2025 | Sheet Sheet Sheet 1 1 1 of of of 12 12 12
