czp-1-A1/FPGA_Component_Inspector/官方资料/02_开发板手册与引脚/开发板原理图/HX1P35B_FT_40P_9.pdf

# Ethernet PHY

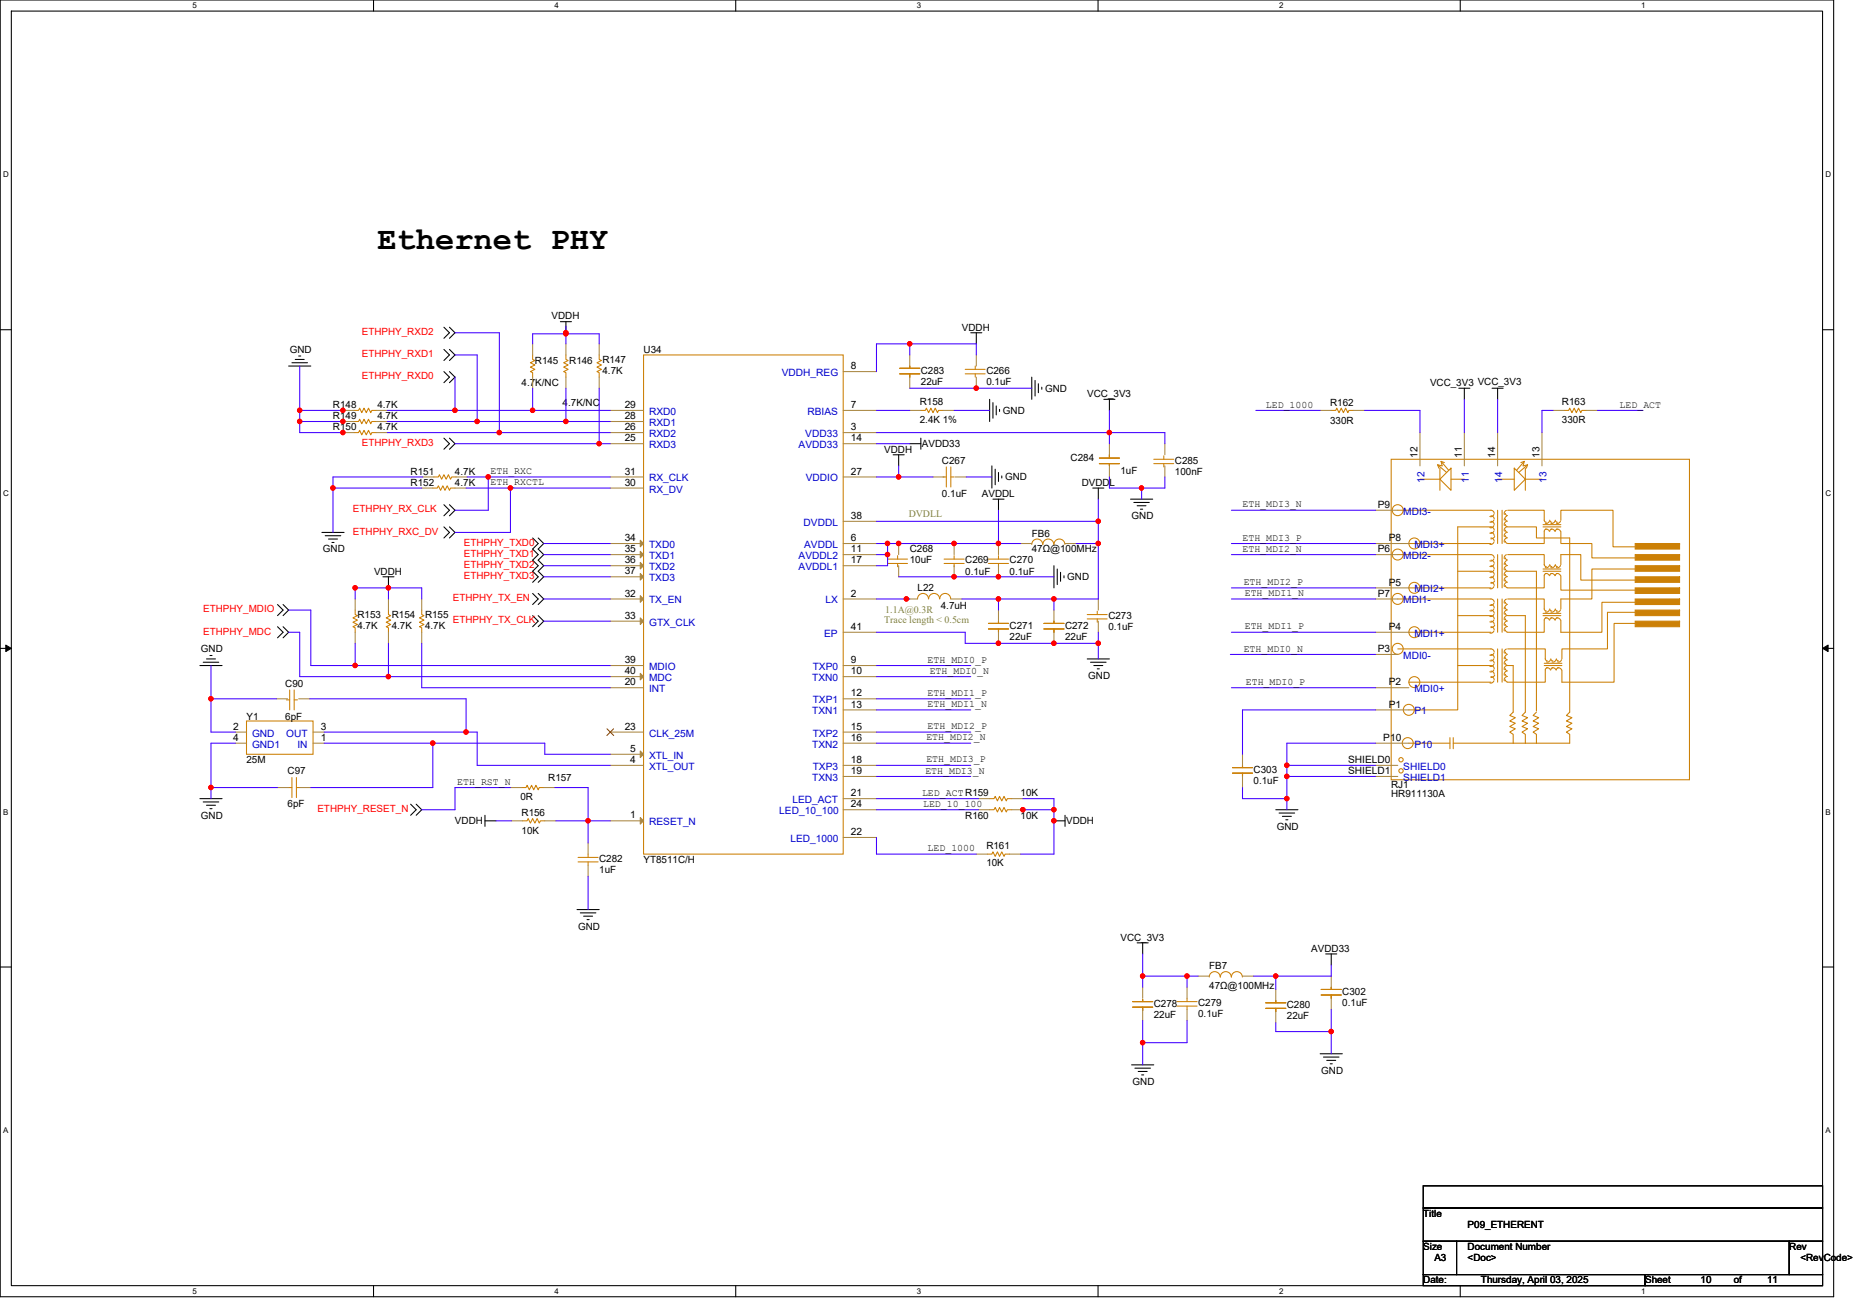
[picture p246: page 1]

R149 4.7K | RXD1 28
R150 4.7K | RXD2 26

Size Size Size A3 A3 A3 | Document Number Document Number Document Number | Rev Rev Rev

Date: Date: Date: Thursday, April 03, 2025 Thursday, April 03, 2025 Thursday, April 03, 2025 | Sheet Sheet Sheet 10 10 10 of of of 11 11 11
