czp-1-A1/FPGA_Component_Inspector/开发实施/验收记录/20261006_A_SW视频链路修复_轮次1/source_snapshot/user_source/hdl_source/key_remove_shakes.v

/*
creat time: 2020/12/3 15:50

engineer:   xiong guo qiang

description:
对按键操作进行消抖操作，每次按下产生一个时钟周期的高脉冲

*/


module key_remove_shakes( 
	input wire      I_clk,    
	input wire      I_rst_n,
	
	input wire      I_key_in,        
	
	output reg      O_key_trig_out   
);

	///同步到处理时钟域，打三拍
	reg       S_key_in_sync_1d;      
	reg       S_key_in_sync_2d;      
	reg       S_key_in_sync_3d;      
	reg	      S_key_in_sync_4d;
	wire      S_key_in_n_edge;       
			  
	reg       S_delay_en;            
	reg       S_delay_en_1d;         
	wire      S_delay_en_n_edge;     
	reg[16:0] S_delay_cnt;           
	
	
	always @ (posedge I_clk) begin
		S_key_in_sync_1d <= I_key_in;
		S_key_in_sync_2d <= S_key_in_sync_1d;
		S_key_in_sync_3d <= S_key_in_sync_2d;
		S_key_in_sync_4d <= S_key_in_sync_3d;
	end
	

	assign S_key_in_n_edge = ~S_key_in_sync_3d & S_key_in_sync_4d;
	
	
	always @ (posedge I_clk or negedge I_rst_n) begin
		if(!I_rst_n)
			S_delay_en <= 1'b0;
		else
			if(S_key_in_n_edge)
				S_delay_en <= 1'b1;
			else if(S_delay_cnt == 'd100000)
				S_delay_en <= 1'b0;
			else
				S_delay_en <= S_delay_en;
	end
	
	
	always @ (posedge I_clk or negedge I_rst_n) begin
		if(!I_rst_n)
			S_delay_cnt <= 'd0;
		else
			if(S_delay_en)
				S_delay_cnt <= S_delay_cnt + 1'b1;
			else
				S_delay_cnt <= 'd0;
	end
	
	
	always @ (posedge I_clk) begin
		S_delay_en_1d <= S_delay_en;
	end
	
	
	assign S_delay_en_n_edge = ~S_delay_en & S_delay_en_1d;
	
	
	always @ (posedge I_clk) begin
		if(S_delay_en_n_edge && !S_key_in_sync_4d)
			O_key_trig_out <= 1'b1;
		else
			O_key_trig_out <= 1'b0;
	end
	

endmodule
