czp-1-A1/FPGA_Component_Inspector/开发实施/验收记录/20261006_A_SW视频链路修复_轮次1/source_snapshot/user_source/hdl_source/isp/demosaic_4x_2_0/blk_mem_gen_demosaic/.params_blk_mem_gen_demosaic.txt

DEBUG : 0 : U : En :  :  : 
PACK : 0 : U : En :  :  : 
SP_RAM : 0 : U : En :  :  : 
SDP_RAM : 0 : U : En :  :  : 
DP_RAM : 1 : U : En :  :  : 
ECC_SBITERRINJ : 0 : U : Dis :  :  : 
ECC_DBITERRINJ : 0 : U : Dis :  :  : 
DATA_WIDTH_A_c : 33 : U : En :  : 1 : 1152
DATA_DEPTH_A : 2048 : U : En :  : 2 : 16384
DATA_DEPTH_B : 2048 : G : En :  :  : 
RESETMODE_A : ASYNC : G : En :  :  : 
RESETMODE_B : ASYNC : G : En :  :  : 
INIT_FILE :  : U : Dis :  :  : 
FILL_ALL : 0 : U : En :  :  : 
CEA_EN : 0 : U : En :  :  : 
OUTREG_DISA : 1 : U : En :  :  : 
OUTREG_WITH_OCEA : 0 : U : En :  :  : 
OUTREG_WITHOUT_OCEA : 0 : U : En :  :  : 
ASYNC_RELEASE_Aa : 0 : U : En :  :  : 
ASYNC_RELEASE_Bb : 0 : U : En :  :  : 
DATA_WIDTH_B_c : 33 : U : En : 33;;66;;132;;264;;528;;1056 :  : 
CEB_EN : 0 : U : En :  :  : 
OUTREG_DISB : 1 : U : En :  :  : 
OUTREG_WITH_OCEB : 0 : U : En :  :  : 
OUTREG_WITHOUT_OCEB : 0 : U : En :  :  : 
OREGSET_Bb : 1 : U : En :  :  : 
x1 : X1=33 : G : En :  :  : 
EM20F : 0 : U : En :  :  : 
EM20S : 1 : U : En :  :  : 
ECC_CODE : ENCODE&DECODE : U : Dis : ENCODE&DECODE;;ONLY_DECODE :  : 
ADDR_WIDTH_A : 11 : G : En :  :  : 
ADDR_WIDTH_B : 11 : G : En :  :  : 
DATA_WIDTH_A : 33 : G : En :  :  : 
DATA_WIDTH_B : 33 : G : En :  :  : 
BYTE : 0 : G : En :  :  : 
BYTE_A : 33 : G : En :  :  : 
BYTE_B : 33 : G : En :  :  : 
BYTE_WIDTH_A : 33 : G : En :  :  : 
BYTE_WIDTH_B : 33 : G : En :  :  : 
WRITEMODE_A : NORMAL : G : En :  :  : 
REGMODE_A : NOREG : G : En :  :  : 
REGMODE_B : NOREG : G : En :  :  : 
WRITEMODE_B : READBEFOREWRITE : G : En :  :  : 
ECC : 0 : U : Dis :  :  : 
SSROVERCE : 0 : G : En :  :  : 
OREGSET_A : 0 : U : En :  :  : 
ASYNC_RELEASE_A : 1 : U : En :  :  : 
OREGSET_B : 0 : U : En :  :  : 
ASYNC_RELEASE_B : 1 : U : En :  :  : 
BYTEW : 0 : G : En :  :  : 
COMMON_CLK : 0 : G : En :  :  : 
FAST : 1 : G : En :  :  : 
init_none : 1 : U : En :  :  : 
Load_mif_file : 0 : U : En :  :  : 
FILL_0 : 1 : U : Dis :  :  : 
FILL_1 : 0 : U : Dis :  :  : 
byte_none : 1 : U : En :  :  : 
byte_8 : 0 : U : En :  :  : 
byte_10 : 0 : U : En :  :  : 
clk_async : 1 : U : En :  :  : 
clk_sync : 0 : U : En :  :  : 
ssroverce_dis : 1 : U : En :  :  : 
ssroverce_en : 0 : U : En :  :  : 
write_before_read_a : 0 : U : En :  :  : 
read_before_write_a : 0 : U : En :  :  : 
write_disable_read_a : 1 : U : En :  :  : 
write_before_read_b : 0 : U : En :  :  : 
read_before_write_b : 1 : U : En :  :  : 
write_disable_read_b : 0 : U : En :  :  : 
CEA_always : 1 : U : En :  :  : 
wea_al : 1 : U : Dis :  :  : 
SET_A : 1 : U : En :  :  : 
reset_asynca : 1 : U : Dis :  :  : 
reset_synca : 0 : U : Dis :  :  : 
Always_b : 1 : U : En :  :  : 
reset_syncb : 0 : U : Dis :  :  : 
reset_asyncb : 1 : U : Dis :  :  : 
depth_range_a : 2~16384 : G : En :  :  : 
ecc_paa : 1 : G : En :  :  : 
FILL_INIT_VAL : NONE : G : En :  :  : 
real_range : 1~1152 : G : En :  :  : 
fill_file : NONE : G : En :  :  : 
ENCODE : 0 : G : En :  :  : 
DECODE : 0 : G : En :  :  : 
wea_display : 0 : G : En :  :  : 
WEA_EN_dis : 0 : U : Dis :  :  : 
WEA_EN : 1 : G : En :  :  : 
wea_port : 1 : G : En :  :  : 
write_before_read_a_dis : 1 : G : En :  :  : 
read_before_write_a_dis : 1 : G : En :  :  : 
reset_synca_dis : 0 : G : En :  :  : 
doa_dis : 1 : G : En :  :  : 
rsta_dis : 0 : G : En :  :  : 
ECC_BITERRINJ_dis : 0 : G : En :  :  : 
lmple_dis : 1 : G : En :  :  : 
problem_sum : 0 : G : En :  :  : 
SF2 : 0 : G : En :  :  : 
DR1P : 0 : G : En :  :  : 
PH1P : 1 : G : En :  :  : 
