czp-1-A1/FPGA_Component_Inspector/开发实施/机械结构展示/机械装配_R2/打印准备_阶段2/P01修订_R2a/通用PETG_仅预估.ini

# Generic offline estimate only; NOT a machine profile.
printer_technology = FFF
bed_shape = 0x0,200x0,200x200,0x200
max_print_height = 200
nozzle_diameter = 0.4
filament_diameter = 1.75
filament_density = 1.27
filament_type = PETG
layer_height = 0.2
first_layer_height = 0.2
perimeters = 4
top_solid_layers = 5
bottom_solid_layers = 5
fill_density = 25%
fill_pattern = gyroid
extrusion_width = 0.45
first_layer_extrusion_width = 0.45
external_perimeter_extrusion_width = 0.45
perimeter_extrusion_width = 0.45
infill_extrusion_width = 0.45
solid_infill_extrusion_width = 0.45
top_infill_extrusion_width = 0.45
support_material_extrusion_width = 0.45
perimeter_speed = 45
external_perimeter_speed = 30
small_perimeter_speed = 20
infill_speed = 55
solid_infill_speed = 40
top_solid_infill_speed = 30
bridge_speed = 25
support_material_speed = 35
travel_speed = 120
first_layer_speed = 20
default_acceleration = 500
filament_max_volumetric_speed = 8
temperature = 240
first_layer_temperature = 240
bed_temperature = 80
first_layer_bed_temperature = 80
min_fan_speed = 30
max_fan_speed = 60
disable_fan_first_layers = 3
support_material = 1
support_material_auto = 1
support_material_buildplate_only = 0
support_material_threshold = 45
support_material_style = snug
support_material_contact_distance = 0.25
support_material_xy_spacing = 0.35
support_material_interface_layers = 2
support_material_spacing = 2.5
brim_width = 3
brim_separation = 0.1
skirts = 0
complete_objects = 0
binary_gcode = 0
gcode_flavor = marlin2
start_gcode = ; OFFLINE ESTIMATE ONLY - NOT FOR PRINTING
end_gcode = ; ESTIMATE END
