czp-1-A1/FPGA_Component_Inspector/开发实施/验收记录/20261006_A_SW视频链路修复_轮次1/git_diff_stat.txt

 AGENTS.md                                          |  24 +-
 .../td_project/camera_to_dsi_display.al            | 122 +++++++-
 .../td_project/camera_to_dsi_display.sdc           |  56 +++-
 .../user_source/constraints_source/pin.adc         |  10 +-
 .../user_source/hdl_source/awb.v                   |   4 +-
 .../user_source/hdl_source/design_top_wrapper.v    | 128 +++++++-
 .../hdl_source/isp/data96_128/data96_128.v         | 123 ++------
 .../isp/demosaic_4x_2_0/line_buffer_demosaic.v     |   2 +
 .../hdl_source/isp/demosaic_4x_2_0/zhenghe.v       |   2 +
 .../user_source/hdl_source/isp/isp_top.v           |  84 +++++-
 .../user_source/hdl_source/signal_delay.v          |   2 +
 .../hdl_source/uics500_cfg/uicfgcs500.v            |  16 +-
 .../user_source/hdl_source/uics500_cfg/uii2c.v     |  38 ++-
 .../user_source/hdl_source/uiisp_beta/ae_set.v     | 156 +++++-----
 .../user_source/hdl_source/video_in.v              | 323 ++++++++------------
 .../user_source/hdl_source/video_out.v             | 330 ++++++++-------------
 ...244\204\347\220\206\347\272\246\345\256\232.md" |  57 +++-
 17 files changed, 830 insertions(+), 647 deletions(-)
