czp-1-A1/FPGA_Component_Inspector/开发实施/验收记录/20261006_A_SW视频链路修复_轮次1/source_snapshot/user_source/ip_source/w128_d512_fifo/.params_w128_d512_fifo.txt

ERAM : 1 : U : En :  :  : 
DRAM_EN : 0 : U : En :  :  : 
BRAM_AUTO : 0 : U : En :  :  : 
BRAM_FAST : 1 : U : En :  :  : 
ASYNC : 1 : U : En :  :  : 
SYNC : 0 : U : En :  :  : 
RST_ASYNC : 1 : U : En :  :  : 
Write_Depth : 512 : U : En : 16;;32;;64;;128;;256;;512;;1024;;2048;;4096;;8192;;16384 :  : 
DATA_WIDTH_W : 128 : U : En :  : 1 : 1024
DATA_WIDTH_R : 128 : U : En : 16;;32;;64;;128;;256;;512;;1024 :  : 
SHOW_AHEAD_EN : 0 : G : En :  :  : 
OUTREG_EN : NOREG : G : En :  :  : 
AL_FULL_NUM : 253 : U : En :  : 3 : 509
AL_EMPTY_NUM : 2 : U : En :  : 2 : 508
COMMON_CLK_EN : 0 : G : Dis :  :  : 
ADDR_WIDTH_W : 9 : G : En :  :  : 
ADDR_WIDTH_R : 9 : G : En :  :  : 
Outreg_enable : 0 : U : En :  :  : 
Outreg_disable : 1 : U : En :  :  : 
Show_ahead_en : 0 : U : En :  :  : 
Show_ahead_dis : 1 : U : En :  :  : 
AL_Full_Range : 3-509 : G : En :  :  : 
AL_Empty_Range : 2-508 : G : En :  :  : 
Read_Depth : 512 : G : En :  :  : 
SYNCHRONOUS_RST_EN : 0 : U : En :  :  : 
