czp-1-A1/FPGA_Component_Inspector/官方资料/03_PH1P35芯片与MIPI/参考IP设计资料文档/APUG013_UDP_Communication_Protocol_Reference_Design_v1.5/APUG013_UDP_Communication_Protocol_Reference_Design_v1.5_to/src/tx_client_fifo.v

// ===========================================================================
// Copyright (c) 2011-2020 Anlogic Inc. All Right Reserved.
//
// TEL: 86-21-61633787
// WEB: http://www.anlogic.com/
// ===========================================================================
//
//
//  
//
//
// ===========================================================================

module tx_client_fifo #
  (
    parameter DEVICE           = "PH1",//"PH1","EG4"
    parameter ADDR_WIDTH       = 11 ,//default 11,
    parameter FULL_DUPLEX_ONLY = 0
  )

  (
    // MAC Interface
    input            rd_clk,
    input            rd_sreset,
    input            rd_enable,
    output reg [7:0] tx_data,
    output reg       tx_data_valid,
    input            tx_ack,
    input            tx_collision,
    input            tx_retransmit,
    output           overflow,

    // Local-link Interface
    input            wr_clk,
    input            wr_sreset,
    input      [7:0] wr_data,
    input            wr_sof_n,
    input            wr_eof_n,
    input            wr_src_rdy_n,
    output           wr_dst_rdy_n,
    output reg [3:0] wr_fifo_status
  );


  //----------------------------------------------------------------------------
  // Define Internal Signals
  //----------------------------------------------------------------------------

  wire        GND;
  wire        VCC;
  wire [7:0]  GND_BUS;

  // Encode rd_state_machine states
  parameter  IDLE_s       = 4'b0000;
  parameter  QUEUE1_s     = 4'b0001;
  parameter  QUEUE2_s     = 4'b0010;
  parameter  QUEUE3_s     = 4'b0011;
  parameter  QUEUE_ACK_s  = 4'b0100;
  parameter  WAIT_ACK_s   = 4'b0101;
  parameter  FRAME_s      = 4'b0110;
  parameter  DROP_s       = 4'b0111;
  parameter  RETRANSMIT_s = 4'b1000;

  reg  [3:0]  rd_state;
  reg  [3:0]  rd_nxt_state;

  // Encode wr_state_machine states
  parameter WAIT_s   = 2'b00;
  parameter DATA_s   = 2'b01;
  parameter EOF_s    = 2'b10;
  parameter OVFLOW_s = 2'b11;

  reg  [1:0]  wr_state;
  reg  [1:0]  wr_nxt_state;

  reg  [7:0]  wr_data_bram;
  reg  [7:0]  wr_data_pipe[0:1];
  reg         wr_sof_pipe[0:1];
  reg         wr_eof_pipe[0:1];
  reg         wr_accept_pipe[0:1];
  reg         wr_accept_bram;
  reg  [0:0]  wr_eof_bram;
  reg  [ADDR_WIDTH:0] wr_addr;
  wire        wr_addr_inc;
  wire        wr_start_addr_load;
  wire        wr_addr_reload;
  reg  [ADDR_WIDTH:0] wr_start_addr;
  reg         wr_fifo_full;
  wire        wr_en;
  wire        wr_en_u;
  wire        wr_en_l;
  reg         wr_ovflow_dst_rdy;
  wire        wr_dst_rdy_int_n;

  wire        frame_in_fifo;
  reg         rd_eof;
  reg         rd_eof_reg;
  reg         rd_eof_pipe;
  reg  [ADDR_WIDTH:0] rd_addr;
  wire        rd_addr_inc;
  wire        rd_addr_reload;
  wire [7:0]  rd_data_bram_u;
  wire [7:0]  rd_data_bram_l;
  reg  [7:0]  rd_data_pipe_u;
  reg  [7:0]  rd_data_pipe_l;
  reg  [7:0]  rd_data_pipe;
  wire [0:0]  rd_eof_bram_u;
  wire [0:0]  rd_eof_bram_l;
  wire        rd_en;
  wire        rd_en_bram;
  reg         rd_bram_u;
  reg         rd_bram_u_reg;


  reg         rd_tran_frame_tog = 1'b0;

  wire        wr_tran_frame_sync;

  reg         wr_tran_frame_delay = 1'b0;

  reg         rd_retran_frame_tog = 1'b0;

  wire        wr_retran_frame_sync;

  reg         wr_retran_frame_delay = 1'b0;
  wire        wr_store_frame;
  reg         wr_transmit_frame;
  reg         wr_retransmit_frame;
  reg  [ADDR_WIDTH-3:0]  wr_frames;
  reg         wr_frame_in_fifo;

  reg   [3:0] rd_16_count;
  wire        rd_txfer_en;
  reg  [ADDR_WIDTH:0] rd_addr_txfer;

  reg         rd_txfer_tog = 1'b0;

  wire        wr_txfer_tog_sync;

  reg         wr_txfer_tog_delay = 1'b0;
  wire        wr_txfer_en;


  reg  [ADDR_WIDTH:0] wr_rd_addr;

  reg  [ADDR_WIDTH:0] wr_addr_diff;

  reg         rd_drop_frame;
  reg         rd_retransmit;
  reg  [ADDR_WIDTH:0] rd_start_addr;
  wire        rd_start_addr_load;
  wire        rd_start_addr_reload;

  reg  [ADDR_WIDTH:0] rd_dec_addr;

  wire        rd_transmit_frame;
  wire        rd_retransmit_frame;
  reg         rd_col_window_expire;
  reg         rd_col_window_pipe[0:1];


  reg         wr_col_window_pipe[0:1];

  wire        wr_eof_state;
  reg         wr_eof_state_reg;
  wire        wr_fifo_overflow;
  reg  [9:0]  rd_slot_timer;
  reg         wr_col_window_expire;
  wire        rd_idle_state;

  //----------------------------------------------------------------------------
  // Begin FIFO architecture
  //----------------------------------------------------------------------------

  assign GND = 1'b0;
  assign VCC = 1'b1;
  assign GND_BUS = 8'b0;


  //----------------------------------------------------------------------------
  // Write State machine and control
  //----------------------------------------------------------------------------

  // Write state machine
  // states are WAIT, DATA, EOF, OVFLOW
  // clock through next state of sm
  always @(posedge wr_clk)
  begin
     if (wr_sreset == 1'b1) begin
         wr_state <= WAIT_s;
     end
     else begin
         wr_state <= wr_nxt_state;
     end
  end

  // decode next state, combinitorial
  // should never be able to overflow whilst not in the data state.
  always @(wr_state or wr_sof_pipe[1] or wr_eof_pipe[0] or wr_eof_pipe[1]
           or wr_eof_bram[0] or wr_fifo_overflow)
  begin
  case (wr_state)
     WAIT_s : begin
        if (wr_sof_pipe[1] == 1'b1) begin
           wr_nxt_state <= DATA_s;
        end
        else begin
           wr_nxt_state <= WAIT_s;
        end
     end

     DATA_s : begin
        // wait for the end of frame to be detected
        if (wr_fifo_overflow == 1'b1 && wr_eof_pipe[0] == 1'b0
            && wr_eof_pipe[1] == 1'b0) begin
           wr_nxt_state <= OVFLOW_s;
        end
        else if (wr_eof_pipe[1] == 1'b1) begin
           wr_nxt_state <= EOF_s;
        end
        else begin
           wr_nxt_state <= DATA_s;
        end
     end
     EOF_s : begin
        // if the start of frame is already in the pipe, a back to back frame
        // transmission has occured.  move straight back to frame state
        if (wr_sof_pipe[1] == 1'b1) begin
           wr_nxt_state <= DATA_s;
        end
        else if (wr_eof_bram[0] == 1'b1) begin
           wr_nxt_state <= WAIT_s;
        end
        else begin
           wr_nxt_state <= EOF_s;
        end
     end

     OVFLOW_s : begin
        // wait until the end of frame is reached before clearing the overflow
        if (wr_eof_bram[0] == 1'b1) begin
           wr_nxt_state <= WAIT_s;
        end
        else begin
           wr_nxt_state <= OVFLOW_s;
        end
     end

     default : begin
        wr_nxt_state <= WAIT_s;
     end

  endcase
  end


  // decode output signals.
  assign wr_en = (wr_state == OVFLOW_s) ? 1'b0 : wr_accept_bram;
  assign wr_en_l = wr_en & !wr_addr[ADDR_WIDTH];
  assign wr_en_u = wr_en & wr_addr[ADDR_WIDTH];

  assign wr_addr_inc = wr_en;

  assign wr_addr_reload = (wr_state == OVFLOW_s) ? 1'b1 : 1'b0;
  assign wr_start_addr_load = (wr_state == EOF_s && wr_nxt_state == WAIT_s)
                              ? 1'b1 :
                              (wr_state == EOF_s && wr_nxt_state == DATA_s)
                              ? 1'b1 : 1'b0;


  // pause the local link flow when the fifo is full.
  assign wr_dst_rdy_int_n = (wr_state == OVFLOW_s) ?
                            wr_ovflow_dst_rdy : wr_fifo_full;

  assign wr_dst_rdy_n = wr_dst_rdy_int_n;

  // when in overflow and have captured ovflow eof send dst rdy high again.
  assign overflow = (wr_state == OVFLOW_s) ? 1'b1 : 1'b0;

  // when in overflow and have captured ovflow eof send dst rdy high again.
  always @(posedge wr_clk)
  begin
     if (wr_sreset == 1'b1) begin
        wr_ovflow_dst_rdy <= 1'b0;
     end
     else begin
        if (wr_fifo_overflow == 1'b1 && wr_state == DATA_s) begin
            wr_ovflow_dst_rdy <= 1'b0;
        end
        else if (wr_eof_n == 1'b0 && wr_src_rdy_n == 1'b0) begin
            wr_ovflow_dst_rdy <= 1'b1;
        end
     end
  end

  // eof signals for use in overflow logic
  assign wr_eof_state = (wr_state == EOF_s) ? 1'b1 : 1'b0;

  always @(posedge wr_clk)
  begin
     if (wr_sreset == 1'b1) begin
        wr_eof_state_reg <= 1'b0;
     end
     else begin
        wr_eof_state_reg <= wr_eof_state;
     end
  end


  //----------------------------------------------------------------------------
  // Read state machine and control
  //----------------------------------------------------------------------------

  // clock through the read state machine
  always @(posedge rd_clk)
  begin
     if (rd_sreset == 1'b1) begin
        rd_state <= IDLE_s;
     end
     else if (rd_enable == 1'b1) begin
        rd_state <= rd_nxt_state;
     end
  end

  //----------------------------------------------------------------------------
  // Full Duplex Only State Machine
generate if (FULL_DUPLEX_ONLY == 1) begin : gen_fd_sm
  // decode the next state
  always @(rd_state or frame_in_fifo or rd_eof or tx_ack)
  begin
  case (rd_state)
           IDLE_s : begin
              // if there is a frame in the fifo start to queue the new frame
              // to the output
              if (frame_in_fifo == 1'b1) begin
                 rd_nxt_state <= QUEUE1_s;
              end
              else begin
                 rd_nxt_state <= IDLE_s;
              end
           end

           QUEUE1_s : begin
              rd_nxt_state <= QUEUE2_s;
           end

           QUEUE2_s : begin
              rd_nxt_state <= QUEUE3_s;
           end

           QUEUE3_s : begin
              rd_nxt_state <= QUEUE_ACK_s;
           end

           QUEUE_ACK_s : begin
              rd_nxt_state <= WAIT_ACK_s;
           end

           WAIT_ACK_s : begin
              // the output pipe line is fully loaded, so wait for ack from mac
              // before moving on
              if (tx_ack == 1'b1) begin
                 rd_nxt_state <= FRAME_s;
              end
              else begin
                 rd_nxt_state <= WAIT_ACK_s;
              end
           end

           FRAME_s : begin
              // when the end of frame has been reached wait another frame in
              // the fifo
              if (rd_eof == 1'b1) begin
                 rd_nxt_state <= IDLE_s;
              end
              else begin
                 rd_nxt_state <= FRAME_s;
              end
           end

           default : begin
              rd_nxt_state <= IDLE_s;
           end
        endcase
  end
                                // full duplex state machine

end // gen_fd_sm
endgenerate


  //----------------------------------------------------------------------------
  // Full and Half Duplex State Machine
generate if (FULL_DUPLEX_ONLY != 1) begin : gen_hd_sm
  // decode the next state
  // should never receive a rd_drop_frame pulse outside of the Frame state
  always @(rd_state or frame_in_fifo or rd_eof_reg or tx_ack or rd_drop_frame
           or rd_retransmit)
  begin
  case (rd_state)
           IDLE_s : begin
              // if a retransmit request is detected go to retransmit state
              if (rd_retransmit == 1'b1) begin
                 rd_nxt_state <= RETRANSMIT_s;
              end
              // if there is a frame in the fifo then queue the new frame to
              // the output
              else if (frame_in_fifo == 1'b1) begin
                 rd_nxt_state <= QUEUE1_s;
              end
              else begin
                 rd_nxt_state <= IDLE_s;
              end
           end

           QUEUE1_s : begin
              if (rd_retransmit == 1'b1) begin
                 rd_nxt_state <= RETRANSMIT_s;
              end
              else begin
                rd_nxt_state <= QUEUE2_s;
              end
           end

           QUEUE2_s : begin
              if (rd_retransmit == 1'b1) begin
                 rd_nxt_state <= RETRANSMIT_s;
              end
              else begin
                 rd_nxt_state <= QUEUE3_s;
              end
           end

           QUEUE3_s : begin
              if (rd_retransmit == 1'b1) begin
                 rd_nxt_state <= RETRANSMIT_s;
              end
              else begin
                 rd_nxt_state <= QUEUE_ACK_s;
              end
           end

           QUEUE_ACK_s : begin
              if (rd_retransmit == 1'b1) begin
                 rd_nxt_state <= RETRANSMIT_s;
              end
              else begin
                 rd_nxt_state <= WAIT_ACK_s;
              end
           end

           WAIT_ACK_s : begin
              // the output pipeline is now fully loaded so wait for ack from
              // mac before moving on.
              if (rd_retransmit == 1'b1) begin
                 rd_nxt_state <= RETRANSMIT_s;
              end
              else if (tx_ack == 1'b1) begin
                 rd_nxt_state <= FRAME_s;
              end
              else begin
                 rd_nxt_state <= WAIT_ACK_s;
              end
           end

           FRAME_s : begin
              // if a collision only request, then must drop the rest of the
              // current frame, move to drop state
              if (rd_drop_frame == 1'b1) begin
                 rd_nxt_state <= DROP_s;
              end
              else if (rd_retransmit == 1'b1) begin
                 rd_nxt_state <= RETRANSMIT_s;
              // continue transmitting frame until the end of the frame is
              // detected, then wait for a new frame to be sent.
              end
              else if (rd_eof_reg == 1'b1) begin
                 rd_nxt_state <= IDLE_s;
              end
              else begin
                 rd_nxt_state <= FRAME_s;
              end
           end

           DROP_s : begin
              // wait until rest of frame has been cleared.
              if (rd_eof_reg == 1'b1) begin
                 rd_nxt_state <= IDLE_s;
              end
              else begin
                 rd_nxt_state <= DROP_s;
              end
           end

           RETRANSMIT_s : begin
              // reload the data pipe from the start of the frame
              rd_nxt_state <= QUEUE1_s;
           end

           default : begin
              rd_nxt_state <= IDLE_s;
           end
        endcase
  end

end // gen_hd_sm // half duplex state machine
endgenerate

  //----------------------------------------------------------------------------
  // decode output signals
  // decode output data
  always @(posedge rd_clk)
  begin
     if (rd_enable == 1'b1) begin
        if (rd_nxt_state == FRAME_s)
           tx_data <= rd_data_pipe;
        else begin
           case (rd_state)
              QUEUE_ACK_s :
                 tx_data <= rd_data_pipe;
              WAIT_ACK_s :
                 tx_data <= tx_data;
              FRAME_s :
                 tx_data <= rd_data_pipe;
              default :
                 tx_data <= 8'b0;
           endcase
        end
     end
  end

  // decode output data valid
  always @(posedge rd_clk)
  begin
     if (rd_enable == 1'b1)
        begin
        if (rd_nxt_state == FRAME_s)
           tx_data_valid <= ~(tx_collision && ~(tx_retransmit));
        else
           begin
           case (rd_state)
              QUEUE_ACK_s :
                 tx_data_valid <= 1'b1;
              WAIT_ACK_s :
                 tx_data_valid <= 1'b1;
              FRAME_s :
                 tx_data_valid <= ~(rd_nxt_state == DROP_s);
              default :
                 tx_data_valid <= 1'b0;
           endcase
        end
     end
  end

  //----------------------------------------------------------------------------
  // decode full duplex only control signals
generate if (FULL_DUPLEX_ONLY == 1) begin : gen_fd_decode

  assign rd_en = (rd_state == IDLE_s) ? 1'b0 :
                 (rd_nxt_state == FRAME_s) ? 1'b1 :
                 (rd_state == WAIT_ACK_s) ? 1'b0 : 1'b1;

  assign rd_addr_inc = rd_en;

  assign rd_addr_reload = (rd_state == FRAME_s && rd_nxt_state == IDLE_s)
                          ? 1'b1 : 1'b0;

  // Transmit frame pulse is only 1 clock enabled pulse long.
  // Transmit frame pulse must never be more frequent than 64 clocks to allow
  // toggle to cross clock domain
  assign rd_transmit_frame = (rd_state == WAIT_ACK_s && rd_nxt_state == FRAME_s)
                             ? 1'b1 : 1'b0;

  // unused for full duplex only
  assign rd_start_addr_reload = 1'b0;
  assign rd_start_addr_load   = 1'b0;
  assign rd_retransmit_frame  = 1'b0;

end // gen_fd_decode // full duplex control signals
endgenerate

  //----------------------------------------------------------------------------
  // decode half duplex control signals
generate if (FULL_DUPLEX_ONLY != 1) begin : gen_hd_decode

  assign rd_en = (rd_state == IDLE_s) ? 1'b0 :
                 (rd_nxt_state == DROP_s && rd_eof == 1'b1) ? 1'b0 :
                 (rd_nxt_state == FRAME_s) ? 1'b1 :
                 (rd_state == RETRANSMIT_s) ? 1'b0 :
                 (rd_state == WAIT_ACK_s) ? 1'b0 : 1'b1;

  assign rd_addr_inc = rd_en;

  assign rd_addr_reload = (rd_state == FRAME_s && rd_nxt_state == IDLE_s)
                          ? 1'b1 :
                          (rd_state == DROP_s && rd_nxt_state == IDLE_s)
                          ? 1'b1 : 1'b0;

  assign rd_start_addr_reload = (rd_state == RETRANSMIT_s) ? 1'b1 : 1'b0;

  assign rd_start_addr_load = (rd_state== WAIT_ACK_s && rd_nxt_state == FRAME_s)
                              ? 1'b1 :
                              (rd_col_window_expire == 1'b1) ? 1'b1 : 1'b0;

  // Transmit frame pulse must never be more frequent than 64 clocks to allow
  // toggle to cross clock domain
  assign rd_transmit_frame = (rd_state == WAIT_ACK_s && rd_nxt_state == FRAME_s)
                             ? 1'b1 : 1'b0;

  // Retransmit frame pulse must never be more frequent than 16 clocks to allow
  // toggle to cross clock domain
  assign rd_retransmit_frame = (rd_state == RETRANSMIT_s) ? 1'b1 : 1'b0;

end // gen_hd_decode                           // half duplex control signals
endgenerate


  //----------------------------------------------------------------------------
  // Frame Count
  // We need to maintain a count of frames in the fifo, so that we know when a
  // frame is available for transmission.  The counter must be held on the
  // write clock domain as this is the faster clock.
  //----------------------------------------------------------------------------

  // A frame has been written to the fifo
  assign wr_store_frame = (wr_state == EOF_s && wr_nxt_state != EOF_s)
                          ? 1'b1 : 1'b0;

  // generate a toggle to indicate when a frame has been transmitted from the
  // fifo
  always @(posedge rd_clk)
  begin  // process
     if (rd_enable == 1'b1) begin
        if (rd_transmit_frame == 1'b1) begin
           rd_tran_frame_tog <= !rd_tran_frame_tog;
        end
     end
  end

  // move the read transmit frame signal onto the write clock domain

reg [1:0]rd_tran_frame_tog_reg;
always@(posedge wr_clk)
begin
	rd_tran_frame_tog_reg <= {rd_tran_frame_tog_reg[0],rd_tran_frame_tog};
end
assign wr_tran_frame_sync = rd_tran_frame_tog_reg[1];

  // edge detect of the resynchronized transmit frame signal
  always @(posedge wr_clk)
  begin
      wr_tran_frame_delay <= wr_tran_frame_sync;
  end

  always @(posedge wr_clk)
  begin
      if (wr_sreset == 1'b1) begin
         wr_transmit_frame   <= 1'b0;
      end
      else begin
         // edge detector
         if ((wr_tran_frame_delay ^ wr_tran_frame_sync) == 1'b1) begin
           wr_transmit_frame    <= 1'b1;
         end
         else begin
           wr_transmit_frame    <= 1'b0;
         end
      end
  end

  //----------------------------------------------------------------------------
generate if (FULL_DUPLEX_ONLY == 1) begin : gen_fd_count

  // count the number of frames in the fifo.  the counter is incremented when a
  // frame is stored and decremented when a frame is transmitted.  Need to keep
  // the counter on the write clock as this is the fastest clock.
  always @(posedge wr_clk)
  begin
     if (wr_sreset == 1'b1) begin
        wr_frames <= 'b0;
     end
     else begin
        if ((wr_store_frame & !wr_transmit_frame) == 1'b1) begin
           wr_frames <= wr_frames + 1;
        end
        else if ((!wr_store_frame & wr_transmit_frame) == 1'b1) begin
           wr_frames <= wr_frames - 1;
        end
     end
  end

end // gen_fd_count
endgenerate

  //----------------------------------------------------------------------------
generate if (FULL_DUPLEX_ONLY != 1) begin : gen_hd_count

  // generate a toggle to indicate when a frame has been transmitted from the
  // fifo
  always @(posedge rd_clk)
  begin  // process
     if (rd_enable == 1'b1) begin
        if (rd_retransmit_frame == 1'b1) begin
           rd_retran_frame_tog <= !rd_retran_frame_tog;
        end
     end
  end

  // move the read transmit frame signal onto the write clock domain

reg [1:0]rd_retran_frame_tog_reg;
	
always@(posedge wr_clk)
begin
	rd_retran_frame_tog_reg <= {rd_retran_frame_tog_reg[0],rd_retran_frame_tog};
end
assign wr_retran_frame_sync = rd_retran_frame_tog_reg[1];
 



  // edge detect of the resynchronized read transmit frame signal
  always @(posedge wr_clk)
  begin
     wr_retran_frame_delay <= wr_retran_frame_sync;
  end
  
  always @(posedge wr_clk)
  begin
     if (wr_sreset == 1'b1) begin
        wr_retransmit_frame  <= 1'b0;
     end
     else begin
        // edge detector
        if ((wr_retran_frame_delay ^ wr_retran_frame_sync) == 1'b1) begin
           wr_retransmit_frame    <= 1'b1;
        end
        else begin
           wr_retransmit_frame    <= 1'b0;
        end
     end
  end

  // count the number of frames in the fifo.  the counter is incremented when a
  // frame is stored or retransmitted and decremented when a frame is tx'd.
  // Need to keep the counter on the write clock as this is the fastest clock.
  // Assumes transmit and retransmit cannot happen at same time
  always @(posedge wr_clk)
  begin
     if (wr_sreset == 1'b1) begin
        wr_frames <= 'b0;
     end
     else begin
        if ((wr_store_frame & wr_retransmit_frame) == 1'b1) begin
           wr_frames <= wr_frames + 2;
        end
        else if (((wr_store_frame | wr_retransmit_frame)
                 & !wr_transmit_frame) == 1'b1) begin
           wr_frames <= wr_frames + 1;
        end
        else if (wr_transmit_frame == 1'b1 & !wr_store_frame) begin
           wr_frames <= wr_frames - 1;
        end
     end
  end

end // gen_hd_count
endgenerate


  //----------------------------------------------------------------------------
  // generate a frame in fifo signal for use in control logic
  always @(posedge wr_clk)
  begin
      if (wr_sreset == 1'b1) begin
         wr_frame_in_fifo <= 1'b0;
      end
      else begin
         if (wr_frames != 0) begin
            wr_frame_in_fifo <= 1'b1;
         end
         else begin
            wr_frame_in_fifo <= 1'b0;
         end
      end
  end

  // register back onto read domain for use in the read logic
reg [1:0]wr_frame_in_fifo_reg;
	
always@(posedge rd_clk)
begin
	wr_frame_in_fifo_reg <= {wr_frame_in_fifo_reg[0],wr_frame_in_fifo};
end
assign frame_in_fifo = wr_frame_in_fifo_reg[1];

  //----------------------------------------------------------------------------
  // Address counters
  //----------------------------------------------------------------------------

  // Address counters
  // write address is incremented when write enable signal has been asserted
  always @(posedge wr_clk)
  begin
     if (wr_sreset == 1'b1) begin
        wr_addr <= 'b0;
     end
     else if (wr_addr_reload == 1'b1) begin
        wr_addr <= wr_start_addr;
     end
     else if (wr_addr_inc == 1'b1) begin
        wr_addr <= wr_addr + 1;
     end
  end

  // store the start address incase the address must be reset
  always @(posedge wr_clk)
  begin
     if (wr_sreset == 1'b1) begin
        wr_start_addr <= 'b0;
     end
     else if (wr_start_addr_load == 1'b1) begin
        wr_start_addr <= wr_addr + 1;
     end
  end

  //----------------------------------------------------------------------------
generate if (FULL_DUPLEX_ONLY == 1) begin : gen_fd_addr
  // read address is incremented when read enable signal has been asserted
  always @(posedge rd_clk)
  begin
     if (rd_sreset == 1'b1) begin
        rd_addr <= 'b0;
     end
     else if (rd_enable == 1'b1) begin
        if (rd_addr_reload == 1'b1) begin
           rd_addr <= rd_dec_addr;
        end
        else if (rd_addr_inc == 1'b1) begin
           rd_addr <= rd_addr + 1;
        end
     end
  end

  // do not need to keep a start address, but the address is needed to
  // calculate fifo occupancy.
  always @(posedge rd_clk)
  begin
     if (rd_sreset == 1'b1) begin
        rd_start_addr <= 'b0;
     end
     else if (rd_enable == 1'b1) begin
        rd_start_addr <= rd_addr;
     end
  end



end // gen_fd_addr // full duplex address counters
endgenerate

  //----------------------------------------------------------------------------
generate if (FULL_DUPLEX_ONLY != 1) begin : gen_hd_addr
  // read address is incremented when read enable signal has been asserted
  always @(posedge rd_clk)
  begin
     if (rd_sreset == 1'b1) begin
        rd_addr <= 'b0;
     end
     else if (rd_enable == 1'b1) begin
        if (rd_addr_reload == 1'b1) begin
           rd_addr <= rd_dec_addr;
        end
        else if (rd_start_addr_reload == 1'b1) begin
           rd_addr <= rd_start_addr;
        end
        else if (rd_addr_inc == 1'b1) begin
           rd_addr <= rd_addr + 1;
        end
     end
  end

  always @(posedge rd_clk)
  begin
     if (rd_sreset == 1'b1) begin
        rd_start_addr <= 'b0;
     end
     else if (rd_enable == 1'b1) begin
        if (rd_start_addr_load == 1'b1) begin
           rd_start_addr <= rd_addr - 4;
        end
     end
  end

  // Collision window expires after MAC has been transmitting for required slot
  // time.  This is 512 clock cycles at 1G.  Also if the end of frame has fully
  // been transmitted by the mac then a collision cannot occur.
  // this collision expire signal goes high at 768 cycles from the start of the
  // frame.
  // inefficient for short frames, however should be enough to prevent fifo
  // locking up.
  always @(posedge rd_clk)
  begin
     if (rd_sreset == 1'b1) begin
        rd_col_window_expire <= 1'b0;
     end
     else if (rd_enable == 1'b1) begin
        if (rd_transmit_frame == 1'b1) begin
           rd_col_window_expire <= 1'b0;
        end
        else if (rd_slot_timer[9:8] == 2'b11) begin
           rd_col_window_expire <= 1'b1;
        end
     end
  end

  assign rd_idle_state = (rd_state == IDLE_s) ? 1'b1 : 1'b0;

  always @(posedge rd_clk)
  begin
     if (rd_enable == 1'b1) begin
        rd_col_window_pipe[0] <= rd_col_window_expire & rd_idle_state;
        if (rd_txfer_en == 1'b1) begin
           rd_col_window_pipe[1] <= rd_col_window_pipe[0];
        end
     end
  end

  always @(posedge rd_clk)
  begin
     if (rd_sreset == 1'b1) begin   // will not count until after first
                                    // frame is sent.
        rd_slot_timer <= 10'b0;
     end
     else if (rd_enable == 1'b1) begin
        if (rd_transmit_frame == 1'b1) begin  // reset counter
           rd_slot_timer <= 10'b0;
        end
        // do not allow counter to role over.
        // only count when frame is being transmitted.
        else if (rd_slot_timer != 10'b1111111111) begin
           rd_slot_timer <= rd_slot_timer + 1;
        end
     end
  end


end // gen_hd_addr  // half duplex address counters
endgenerate

  always @(posedge rd_clk)
  begin
     if (rd_sreset == 1'b1) begin
        rd_dec_addr <= 'b0;
     end
     else if (rd_enable == 1'b1) begin
        if (rd_addr_inc == 1'b1) begin
           rd_dec_addr <= rd_addr - 1;
        end
     end
  end

  //----------------------------------------------------------------------------
  always @(posedge rd_clk)
  begin
     if (rd_sreset == 1'b1) begin
        rd_bram_u <= 1'b0;
        rd_bram_u_reg <= 1'b0;
     end
     else if (rd_enable == 1'b1) begin
        if (rd_addr_inc == 1'b1) begin
           rd_bram_u <= rd_addr[ADDR_WIDTH];
           rd_bram_u_reg <= rd_bram_u;
        end
     end
  end


  //----------------------------------------------------------------------------
  // Data Pipelines
  //----------------------------------------------------------------------------

  // register input signals to fifo
  // no reset to allow srl16 target
  always @(posedge wr_clk)
  begin
     wr_data_pipe[0] <= wr_data;

     if (wr_accept_pipe[0] == 1'b1) begin
        wr_data_pipe[1] <= wr_data_pipe[0];
     end

     if (wr_accept_pipe[1] == 1'b1) begin
        wr_data_bram    <= wr_data_pipe[1];
     end
  end

  // no reset to allow srl16 target
  always @(posedge wr_clk)
  begin
     wr_sof_pipe[0] <= !wr_sof_n;
     if (wr_accept_pipe[0] == 1'b1) begin
        wr_sof_pipe[1] <= wr_sof_pipe[0];
     end
  end

  always @(posedge wr_clk)
  begin
     if (wr_sreset == 1'b1) begin
        wr_accept_pipe[0] <= 1'b0;
        wr_accept_pipe[1] <= 1'b0;
        wr_accept_bram    <= 1'b0;
     end
     else begin
        wr_accept_pipe[0] <= !wr_src_rdy_n & !wr_dst_rdy_int_n;
        wr_accept_pipe[1] <= wr_accept_pipe[0];
        wr_accept_bram    <= wr_accept_pipe[1];
     end
  end

  always @(posedge wr_clk)
  begin
     wr_eof_pipe[0] <= !wr_eof_n;

     if (wr_accept_pipe[0] == 1'b1) begin
        wr_eof_pipe[1] <= wr_eof_pipe[0];
     end

     if (wr_accept_pipe[1] == 1'b1) begin
        wr_eof_bram[0] <= wr_eof_pipe[1];
     end
  end

  // register data outputs from bram
  // no reset to allow srl16 target
  always @(posedge rd_clk)
  begin
     if (rd_enable == 1'b1) begin
        if (rd_en == 1'b1) begin
           rd_data_pipe_u <= rd_data_bram_u;
           rd_data_pipe_l <= rd_data_bram_l;

           if (rd_bram_u_reg == 1'b1) begin
              rd_data_pipe <= rd_data_pipe_u;
           end
           else begin
              rd_data_pipe <= rd_data_pipe_l;
           end
        end
     end
  end

   // register data outputs from bram
  // no reset to allow srl16 target
  always @(posedge rd_clk)
  begin
     if (rd_enable == 1'b1) begin
        if (rd_en == 1'b1) begin
           if (rd_bram_u == 1'b1) begin
              rd_eof_pipe <= rd_eof_bram_u[0];
           end
           else begin
              rd_eof_pipe <= rd_eof_bram_l[0];
           end
           rd_eof <= rd_eof_pipe;
           rd_eof_reg <= rd_eof | rd_eof_pipe;
        end
     end
  end

  //----------------------------------------------------------------------------
generate if (FULL_DUPLEX_ONLY != 1) begin : gen_hd_input
  // register the collision and retransmit signals
  always @(posedge rd_clk)
  begin
     if (rd_enable == 1'b1) begin
        rd_drop_frame <= tx_collision & !tx_retransmit;
     end
  end

  always @(posedge rd_clk)
  begin
     if (rd_enable == 1'b1) begin
        rd_retransmit <= tx_collision & tx_retransmit;
     end
  end

end // gen_hd_input                        // half duplex register input
endgenerate


  //----------------------------------------------------------------------------
  // Fifo full functionality
  //----------------------------------------------------------------------------

  // Full functionality is difference between read and write addresses.
  // Cannot use gray code this time as the read address and read start addresses
  // jump by more than 1


  // generate an enable pulse for the read side every 16 read clocks.  This
  // provides for the worst case situation where wr clk is 20Mhz and rd clk is
  // 125 Mhz.
  always @(posedge rd_clk)
  begin
     if (rd_sreset == 1'b1) begin
        rd_16_count <= 4'b0;
     end
     else if (rd_enable == 1'b1) begin
        rd_16_count <= rd_16_count + 1;
     end
  end

  assign rd_txfer_en = (rd_16_count == 4'b1111) ? 1'b1 : 1'b0;

  // register the start address on the enable pulse
  always @(posedge rd_clk)
  begin
     if (rd_sreset == 1'b1) begin
        rd_addr_txfer <= 'b0;
     end
     else if (rd_enable == 1'b1) begin
        if (rd_txfer_en == 1'b1) begin
           rd_addr_txfer <= rd_start_addr;
        end
     end
  end

  // generate a toggle to indicate that the address has been loaded.
  always @(posedge rd_clk)
  begin
     if (rd_enable == 1'b1) begin
        if (rd_txfer_en == 1'b1) begin
           rd_txfer_tog <= !rd_txfer_tog;
        end
     end
  end

  // pass the toggle to the write side

reg [1:0]rd_txfer_tog_reg;
	
always@(posedge wr_clk)
begin
	rd_txfer_tog_reg <= {rd_txfer_tog_reg[0],rd_txfer_tog};
end
assign wr_txfer_tog_sync = rd_txfer_tog_reg[1];

  always @(posedge wr_clk)
  begin
     wr_txfer_tog_delay <= wr_txfer_tog_sync;
  end

  // generate an enable pulse from the toggle, the address should have been
  // steady on the wr clock input for at least one clock
  assign wr_txfer_en = wr_txfer_tog_delay ^ wr_txfer_tog_sync;

  // capture the address on the write clock when the enable pulse is high.
  always @(posedge wr_clk)
  begin
     if (wr_sreset == 1'b1) begin
        wr_rd_addr <= 'b0;
     end
     else if (wr_txfer_en == 1'b1) begin
        wr_rd_addr <= rd_addr_txfer;
     end
  end


  // Obtain the difference between write and read pointers
  always @(posedge wr_clk)
  begin
     if (wr_sreset == 1'b1) begin
        wr_addr_diff <= 'b0;
     end
     else begin
        wr_addr_diff <= wr_rd_addr - wr_addr;
     end
  end


  // Detect when the FIFO is full
  always @(posedge wr_clk)
  begin
     if (wr_sreset == 1'b1) begin
        wr_fifo_full <= 1'b0;
     end
     else begin
        // The FIFO is considered to be full if the write address
        // pointer is within 1 to 3 of the read address pointer.
        if (wr_addr_diff[ADDR_WIDTH:4] == 0 && wr_addr_diff[3:2] != 2'b0) begin
           wr_fifo_full <= 1'b1;
        end
        else begin
           wr_fifo_full <= 1'b0;
        end
     end
  end

  // memory overflow occurs when the fifo is full and there are no frames
  // available in the fifo for transmission.  If the collision window has
  // expired and there are no frames in the fifo and the fifo is full, then the
  // fifo is in an overflow state.  we must accept the rest of the incoming
  // frame in overflow condition.

generate if (FULL_DUPLEX_ONLY == 1) begin : gen_fd_ovflow
     // in full duplex mode, the fifo memory can only overflow if the fifo goes
     // full but there is no frame available to be retranmsitted.
     // Therefore, prevent signal from being asserted when store_frame signal is
     // high, as frame count is being updated.
     assign wr_fifo_overflow = (wr_fifo_full == 1'b1 && wr_frame_in_fifo == 1'b0
                                   && wr_eof_state == 1'b0
                                   && wr_eof_state_reg == 1'b0)
                                ? 1'b1 : 1'b0;
end // gen_fd_ovflow
endgenerate

generate if (FULL_DUPLEX_ONLY != 1) begin : gen_hd_ovflow
    // register wr col window to give address counter sufficient time to update.
    // This will prevent signal from being asserted when store_frame signal is
    // high, as frame count is being updated
    assign wr_fifo_overflow = (wr_fifo_full == 1'b1 && wr_frame_in_fifo == 1'b0
                                  && wr_eof_state == 1'b0
                                  && wr_eof_state_reg == 1'b0
                                  && wr_col_window_expire == 1'b1)
                               ? 1'b1 : 1'b0;

    // register rd_col_window signal
    // this signal is long, and will remain high until overflow functionality
    // has finished, so save just to register the once.
    always @(posedge wr_clk)
    begin  // process
       if (wr_sreset == 1'b1) begin
          wr_col_window_pipe[0] <= 1'b0;
          wr_col_window_pipe[1] <= 1'b0;
          wr_col_window_expire  <= 1'b0;
       end
       else begin
          if (wr_txfer_en == 1'b1) begin
             wr_col_window_pipe[0] <= rd_col_window_pipe[1];
          end
          wr_col_window_pipe[1] <= wr_col_window_pipe[0];
          wr_col_window_expire <= wr_col_window_pipe[1];
       end
    end

end // gen_hd_ovflow
endgenerate



  //----------------------------------------------------------------------------
  // Create FIFO Status Signals in the Write Domain
  //----------------------------------------------------------------------------

  // The FIFO status signal is four bits which represents the occupancy
  // of the FIFO in 16'ths.  To generate this signal we therefore only
  // need to compare the 4 most significant bits of the write address
  // pointer with the 4 most significant bits of the read address
  // pointer.

  // The 4 most significant bits of the write pointer minus the 4 msb of
  // the read pointer gives us our FIFO status.
  always @(posedge wr_clk)
  begin
     if (wr_sreset == 1'b1) begin
        wr_fifo_status <= 4'b0;
     end
     else begin
        if (wr_addr_diff == 0) begin
           wr_fifo_status <= 4'b0;
        end
        else begin
           wr_fifo_status[3] <= !wr_addr_diff[ADDR_WIDTH];
           wr_fifo_status[2] <= !wr_addr_diff[ADDR_WIDTH-1];
           wr_fifo_status[1] <= !wr_addr_diff[ADDR_WIDTH-2];
           wr_fifo_status[0] <= !wr_addr_diff[ADDR_WIDTH-3];
        end
     end
  end

  //----------------------------------------------------------------------------
  // Instantiate Memory
  //----------------------------------------------------------------------------

  assign rd_en_bram = rd_en & rd_enable;


RAMB16_S9_S9#(
.DEVICE	(DEVICE),
.ADDR_WIDTH(ADDR_WIDTH)
)
ramgen_l ( 
	.doa(), 
	.cea(1),
	.dia({wr_eof_bram,wr_data_bram}), 
	.addra(wr_addr[ADDR_WIDTH-1:0]), 
	.clka(wr_clk), 
	.wea(wr_en_l), 
	//.rsta(wr_sreset), 
	.dob({rd_eof_bram_l,rd_data_bram_l}), 
	.dib(), 
	.addrb(rd_addr[ADDR_WIDTH-1:0]), 
	.clkb(rd_clk), 
	.web(0), 
	.ceb(rd_en_bram)
	//.rstb(rd_sreset)
);


RAMB16_S9_S9#(
.DEVICE	(DEVICE),
.ADDR_WIDTH(ADDR_WIDTH)
)
ramgen_u 
( 
	.doa(),
	.cea(1), 
	.dia({wr_eof_bram,wr_data_bram}), 
	.addra(wr_addr[ADDR_WIDTH-1:0]), 
	.clka(wr_clk), 
	.wea(wr_en_u), 
	//.rsta(wr_sreset), 
	.dob({rd_eof_bram_u,rd_data_bram_u}), 
	.dib(), 
	.addrb(rd_addr[ADDR_WIDTH-1:0]), 
	.clkb(rd_clk), 
	.web(0), 
	.ceb(rd_en_bram)
	//.rstb(rd_sreset)
);


endmodule
