czp-1-A1/FPGA_Component_Inspector/开发实施/验收记录/20261006_A_SW视频链路修复_轮次1/source_snapshot/user_source/hdl_source/mipi_dphy_rx/byte_aligner.enc.v

module byte_aligner #(
    parameter DATA_WIDTH = 8
    )(
    input wire                 I_clk,
    input wire                 I_rst,
    
    input wire                 I_hs_valid, //synthesis keep;
    input wire[DATA_WIDTH-1:0] I_hs_data,  //synthesis keep;

    output reg                 O_aligner_valid,  
    output reg[DATA_WIDTH-1:0] O_aligner_data,   
    
	output reg                 O_lane_error      
);

`pragma protect begin_protected
`pragma protect version = 1
`pragma protect encrypt_agent = "Anlogic"
`pragma protect encrypt_agent_info = "Anlogic Encryption Tool anlogic_2019"
`pragma protect key_keyowner = "Anlogic", key_keyname = "anlogic-rsa-001"
`pragma protect key_method = "rsa"
`pragma protect encoding = (enctype = "BASE64", line_length = 64, bytes = 128)
`pragma protect key_block
kkBLl/1vbVR2lxSdSSuL8KobLMugQ1S8deuar0ClTasPRsYjejkHeS6L5XdfZNYd
+wKiDl8jTMzdIKdnq1JF30jFn4FEoeDqzmmucf9Q6Hh7WiyjoT//n9bsJIe3Byrc
51zNpFNV8Re58M6GUANnifkv+kiRxNXDjsuMLLNNDN8=
`pragma protect key_keyowner = "Cadence Design Systems.", key_keyname = "CDS_RSA_KEY_VER_1"
`pragma protect key_method = "rsa"
`pragma protect encoding = (enctype = "BASE64", line_length = 64, bytes = 256)
`pragma protect key_block
DjS5iMEqdaYXn9t+8ylVBkME7qp5gzywlxVhJ/aOZVifEwfNJSsA2Ds7gun+wNcK
WVlOeamYcjyd3aOYYwRD5NO8QaWYekXh4qsfWj2dDWMPxufJN6Obicgzc1d/mh2M
XEcHATJY6sbpqjv/C0hS5Zyojz0I5HGe/+jV0EZ9x/kU/qGcwt/qYAF/lNSnMWCh
Ki0iVVbzqUo3rxA9FJJWM+1XrMa9m/GJVHeLCuoocCm490yWJX3/855jx8W5LTm5
CH0zkIi7TdNcX31Uy7HgyT7fBLRRQsSsQuttOB2rt4BPwqnLUKCjHA9XKBt/ECJB
SvCSFY1zAOOw2oiK8NO6SQ==
`pragma protect key_keyowner = "Mentor Graphics Corporation", key_keyname = "MGC-VERIF-SIM-RSA-1"
`pragma protect key_method = "rsa"
`pragma protect encoding = (enctype = "BASE64", line_length = 64, bytes = 128)
`pragma protect key_block
Y5A/z3RleJKzTBxDY51vGdHX/Z8vnZ62qPiq5z3/8FeqU0Qmc2ioOomQurzY3Hsa
SDsGBAwjwQl5LM0fmIGbIHsGtfuqhupCD3g3+jG73jEuTBZkLMdjF/jj9wSwB/Gz
9forLpKlxhBwJcjxR6fkF366K6M7/9clUYB34lpLRHc=
`pragma protect key_keyowner = "Mentor Graphics Corporation", key_keyname = "MGC-VERIF-SIM-RSA-2"
`pragma protect key_method = "rsa"
`pragma protect encoding = (enctype = "BASE64", line_length = 64, bytes = 256)
`pragma protect key_block
YI/IbPH5QP5bcmTTxtaCLbsqK8RwwKBQ5q3dfQ0H8o+Jpwy1TDhZjwSxgBStTFid
bN5YVy6og2LrrCb8IDDze98eqaVQbUH74wSb/zP6cVQCn6Pa3Ei+L+xBs+H67vjO
blh1CvKxuCrR1wXOvnfy0ZdVaJtZ+hgcsRaUVvPToj8OCDFH0U+rCHXL1Mk0wU29
hUOoS1ZKjPKTRrsdwZKB2iRhDsGiEUkKuRdZRWdr05p5bXPzGxwI5ho/JDiRi/40
MQuLn87oMfF/ba+8/1D5DwxXuer9QfuKF1kaUC4S5zsvuzlg7CSZg0ELC6TsOqCE
tMOv7/G6kvIWsTMorFR/ww==
`pragma protect key_keyowner = "Synopsys", key_keyname = "SNPS-VCS-RSA-2"
`pragma protect key_method = "rsa"
`pragma protect encoding = (enctype = "BASE64", line_length = 64, bytes = 128)
`pragma protect key_block
FcmUQ3D9M/35EjsPJ/rSIb0RDPvVyEGjKDrKuX7zRzUJeQBmfyKBqnCldJCvZdHR
VhdfA0kPocgoS8hZoYptpoZ+eQVHQYTqzQuS3rx4M9z39+JjBegxDHmJcYaLucSs
/mrhSQygRX5eF1xpVX61Wbi4SaUjX9SJlzO9w4gUaOM=
`pragma protect data_method = "AES128-CBC"
`pragma protect encoding = (enctype = "BASE64", line_length = 64, bytes = 14384)
`pragma protect data_block
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
`pragma protect end_protected

    
endmodule
