czp-1-A1/FPGA_Component_Inspector/开发实施/验收记录/20261006_A_SW视频链路修复_轮次1/source_snapshot/user_source/hdl_source/uial2axis/uial2axis.v

/*****************************************************************
Company : Nanjing Weiku Robot Technology Co., Ltd.
Brand   : VLKUS
Technical forum:www.uisrc.com
@Author      :   
@Time        :   2024/11/11
@Description :   native data convert to axi stream 
*****************************************************************/

module uial2axis #(
    parameter IMG_WIDTH        = 1280,
    parameter IMG_HEIGHT       = 720,
    parameter INPUT_DATA_WIDTH = 128
) (
    // native interface
    input I_native_clk,
    input I_rst_n,

    input [INPUT_DATA_WIDTH-1:0] I_data      ,//synthesis keep 
    input                        I_data_valid,//synthesis keep 
    input                        I_data_start,//synthesis keep 
    input                        I_data_end  ,//synthesis keep 

    output                          axis_tvalid,//synthesis keep 
    output [INPUT_DATA_WIDTH-1 : 0] axis_tdata,//synthesis keep 
    output                          axis_tuser,//synthesis keep 
    output                          axis_tlast//synthesis keep 
);
/*********************************************************
******************1.function declaration******************
*********************************************************/
  function integer clogb2(input integer bit_depth);
    begin
      for (clogb2 = 0; bit_depth > 0; clogb2 = clogb2 + 1) bit_depth = bit_depth >> 1;
    end
  endfunction
/*********************************************************
******************2.constant declaration******************
*********************************************************/
  localparam IMG_WIDTH_4X = (IMG_WIDTH >> 2);//synthesis keep 
/*********************************************************
******************3.wire signals declaration**************
*********************************************************/
  // AXI Stream internal signals
/*********************************************************
******************4.reg signals declaration***************
*********************************************************/
  reg [13:0] hcnt;  //synthesis keep  
  reg [13:0] vcnt;  //synthesis keep  
/*********************************************************
******************5.combination declaration***************
*********************************************************/
  assign axis_tdata  = I_data_valid ? I_data : 'b0;
  assign axis_tvalid = I_data_valid ? 1'b1 : 1'b0;
  assign axis_tlast  = hcnt == IMG_WIDTH_4X - 1 && axis_tvalid ? 1'b1 : 1'b0;
  assign axis_tuser  = vcnt == 'b0 && hcnt == 'b0 && axis_tvalid ? 1'b1 : 1'b0;
/*********************************************************
******************6.sequential declaration****************
*********************************************************/

  always @(posedge I_native_clk or negedge I_rst_n) begin
    if (!I_rst_n || I_data_start) begin
      hcnt <= 'b0;
    end else if (I_data_valid & hcnt < IMG_WIDTH_4X - 1) begin
      hcnt <= hcnt + 1'b1;
    end else if (I_data_valid & hcnt == IMG_WIDTH_4X - 1) begin
      hcnt <= 'b0;
    end else hcnt <= hcnt;
  end

  always @(posedge I_native_clk or negedge I_rst_n) begin
    if (!I_rst_n || I_data_start) begin
      vcnt <= 'b0;
    end else if (axis_tlast & vcnt == IMG_HEIGHT - 1) begin
      vcnt <= 'b0;
    end else if (axis_tlast & vcnt < IMG_HEIGHT - 1) begin
      vcnt <= vcnt + 1;
    end else vcnt <= vcnt;
  end

endmodule
