czp-1-A1/FPGA_Component_Inspector/开发实施/验收记录/20261006_A_SW视频链路修复_轮次1/source_snapshot/user_source/ip_source/PLL/PLL.v

/************************************************************\
**	Copyright (c) 2012-2025 Anlogic Inc.
**	All Right Reserved.
\************************************************************/
/************************************************************\
**	Build time: Mar 26 2026 17:03:43
**	TD version	:	6.2.168116
************************************************************/
///////////////////////////////////////////////////////////////////////////////
//	Input frequency:                50.000000000 MHz
//	Clock multiplication factor: 2
//	Clock division factor:       1
//	Clock information:
//		Clock name	| Frequency 	| Phase shift 
//		C0        	| 100.000000   MHz	    |  0.0000 DEG 
//		C1        	| 24.074074   MHz	    |  0.0000 DEG 
//		C4        	| 52.000000   MHz		|  0.0000 DEG 
//		C5        	| 260.000000   MHz		|  0.0000 DEG 
///////////////////////////////////////////////////////////////////////////////
`timescale 1 ns / 100 fs 

module PLL
(
  input                         refclk,
  output                        clk0_out,
  output                        clk1_out,
  output                        clk4_out,
  output                        clk5_out,
  output                        lock,
  input                         reset
);
  wire							  clk0_buf;
PH1P_LOGIC_BUFG bufg_feedback (
 .i(clk0_buf), 
 .o(clk0_out) 
 ); 

 


 
 


  ph1p_phy_pll_wrapper_25a56e5ce2f9
  #(
      .FBKCLK("CLKC0_EXT"),
      .FBKCLK_INT("CLKC0_EXT"),
      .FIN("50.000000000"),
      .REFCLK_DIV(1),
      .FBCLK_DIV(2),
      .CLKC0_ENABLE("ENABLE"),
      .CLKC0_DIV(13),
      .CLKC0_CPHASE(12),
      .CLKC0_FPHASE(0),
      .CLKC0_FPHASE_RSTSEL(0),
      .CLKC0_DUTY50("ENABLE"),
      .CLKC0_DUTY_INT(7),
      .CLKC1_ENABLE("ENABLE"),
      .CLKC1_DIV(54),
      .CLKC1_CPHASE(53),
      .CLKC1_FPHASE(0),
      .CLKC1_FPHASE_RSTSEL(0),
      .CLKC1_DUTY50("ENABLE"),
      .CLKC1_DUTY_INT(27),
      .CLKC4_ENABLE("ENABLE"),
      .CLKC4_DIV(25),
      .CLKC4_CPHASE(24),
      .CLKC4_FPHASE(0),
      .CLKC4_FPHASE_RSTSEL(0),
      .CLKC4_DUTY50("ENABLE"),
      .CLKC4_DUTY_INT(13),
      .CLKC5_ENABLE("ENABLE"),
      .CLKC5_DIV(5),
      .CLKC5_CPHASE(4),
      .CLKC5_FPHASE(0),
      .CLKC5_FPHASE_RSTSEL(0),
      .CLKC5_DUTY50("ENABLE"),
      .CLKC5_DUTY_INT(3),
      .PLL_USR_RST("ENABLE"),
      .PLL_FEED_TYPE("EXTERNAL"),
      .PLL_FASTLOOP("ENABLE"),
      .LPF_RES(0),
      .LPF_CAP(5),
      .ICP_CUR(29),
      .PHASE_PATH_SEL(0),
      .DYN_PHASE_PATH_SEL("DISABLE"),
      .DYN_FPHASE_EN("DISABLE"),
      .PI_OUT_SEL("NORMAL"),
      .PI_FRAC_EN("DISABLE"),
      .CLKC0_PI_SHIFT_EN("DISABLE"),
      .FEEDBK_MODE("NORMAL"),
      .DYN_CPHASE_EN("DISABLE")
  )ph1p_phy_pll_wrapper_25a56e5ce2f9_Inst
  (
      .clk2_en(1'b0),
      .clk2_out(),
      .clkb2_out(),
      .clk3_en(1'b0),
      .clk3_out(),
      .clkb3_out(),
      .clk6_en(1'b0),
      .clk6_out(),
      .clkb6_out(),
      .refclk(refclk),
      .drp_clk(1'b0),
      .drp_rstn(1'b1),
      .drp_sel(1'b0),
      .drp_rd(1'b0),
      .drp_wr(1'b0),
      .drp_addr(8'b00000000),
      .drp_wdata(8'b00000000),
      .drp_err(),
      .drp_rdy(),
      .drp_rdata(),
      .psclk(1'b0),
      .psclksel(3'b000),
      .psstep(1'b0),
      .psdown(1'b0),
      .cps_step(1'b0),
      .psdone(),
      .ssc_reset(1'b0),
	  .clkc_rst(2'b00),
      .pllpd(1'b0),
      .fbclk(clk0_out),
      .wakeup(1'b1),
      .refclk_rst(1'b0),
      .clk0_en(1'b1),
      .clkb0_out(),
      .clk0_out(clk0_buf),
      .clk1_en(1'b1),
      .clkb1_out(),
      .clk1_out(clk1_out),
      .clk4_en(1'b1),
      .clkb4_out(),
      .clk4_out(clk4_out),
      .clk5_en(1'b1),
      .clkb5_out(),
      .clk5_out(clk5_out),
      .lock(lock),
      .reset(reset)
  );
endmodule
