czp-1-A1/FPGA_Component_Inspector/官方资料/03_PH1P35芯片与MIPI/参考IP设计资料文档/APUG013_UDP_Communication_Protocol_Reference_Design_v1.5/APUG013_UDP_Communication_Protocol_Reference_Design_v1.5_to/src/udp_ip_protocol_stack_merge.enc.v

// `define DEBUG_UDP
module udp_ip_protocol_stack #
(
    parameter               DEVICE            = "PH1",//"PH1","EG4"
    parameter               ARP_REQUEST_NUM   = 3,
    parameter               ARP_REQUEST_DELAY = 27'h0ffffff,    
    parameter               LOCAL_UDP_PORT_NUM= 16'hf000,
    parameter               LOCAL_IP_ADDRESS  = 32'hc0a80a01,
    parameter               LOCAL_MAC_ADDRESS = 48'h0123456789ab
)
(   
    input                   udp_rx_clk,
    input                   udp_tx_clk,
    input                   reset,
    
    input [15:0]            input_local_udp_port_num,
    input                   input_local_udp_port_num_valid,
    
//app2udp signal
    output wire             udp2app_tx_ready,
    output wire             udp2app_tx_ack,
    input                   app_tx_request,
    input                   app_tx_data_valid,
    input [7:0]             app_tx_data,
    input [15:0]            app_tx_data_length,
//udp2app signal    
    output wire             app_rx_data_valid,
    output wire [7:0]       app_rx_data,
    output wire [15:0]      app_rx_data_length,
    output wire [15:0]      app_rx_port_num,
    
    input [15:0]            app_tx_dst_port,
    input [31:0]            ip_tx_dst_address,
    
    input [31:0]            input_local_ip_address,
    input                   input_local_ip_address_valid,
    
//temac signal          
    output wire             temac_rx_ready,
    input  wire             temac_rx_valid,
    input  wire [7:0]       temac_rx_data,
    input  wire             temac_rx_sof,
    input  wire             temac_rx_eof,
    
    input  wire             temac_tx_ready,
    output wire             temac_tx_valid,
    output wire [7:0]       temac_tx_data,
    output wire             temac_tx_sof,
    output wire             temac_tx_eof,
`ifdef DEBUG_UDP
    output wire             udp_debug_out,
`endif
    output wire             ip_rx_error,
    output wire             arp_request_no_reply_error
);
`pragma protect begin_protected
`pragma protect version = 1
`pragma protect encrypt_agent = "Anlogic"
`pragma protect encrypt_agent_info = "Anlogic Encryption Tool anlogic_2019"
`pragma protect key_keyowner = "Anlogic", key_keyname = "anlogic-rsa-001"
`pragma protect key_method = "rsa"
`pragma protect encoding = (enctype = "BASE64", line_length = 64, bytes = 128)
`pragma protect key_block
bYWfmef+IesTiD2TYYSL47unPhAW5jIZCesukRoHVm14bJraRuZi5lOUH6KbI6vN
K8Wd5hWhE9wzLKt98ZOftrwOIxHppC1bvqv2lWKKjydhPxEzKOIeOmHeBkwvcsd+
5/b16pq4lG533NWBY/wR2+D2L84bEvTXI/KJpyhU3UU=
`pragma protect key_keyowner = "Cadence Design Systems.", key_keyname = "CDS_RSA_KEY_VER_1"
`pragma protect key_method = "rsa"
`pragma protect encoding = (enctype = "BASE64", line_length = 64, bytes = 256)
`pragma protect key_block
G/QVmcP6hCe/Wgb/7IyhOO4m8JjXXZNQ6ZDGTgdO3k88wOZXN0NXaB/dpTyL+f+J
jW0RoePy/yIAXimjxNXU7qIizmSmygayEo/kV0AWgu2RPEqfG7dte34Fx/+qnz9Z
2UTVz5g6iKWyFqPZo8p5IY4SKqj8KPtqjSLcMl4uIRe0rkHXBICVGHkfkeXpsvvy
pLquJ6Z/9GxLI8KLiQE2zvrOG8TPBD1ZHapu73MMJ9sZRT6gZpa9RMYVCbLCkSvp
uif4PnzkiSctVE6cVzZ9wWiXvIQlVa6Pf+iPfr1qSlVbJWE7L3qjCm6yvUvH9DRE
USxSXkdHWEpy1CtyTca8vA==
`pragma protect key_keyowner = "Mentor Graphics Corporation", key_keyname = "MGC-VERIF-SIM-RSA-1"
`pragma protect key_method = "rsa"
`pragma protect encoding = (enctype = "BASE64", line_length = 64, bytes = 128)
`pragma protect key_block
X2QwGnjpx4j4B1zDmHTZHkhLsPLgTFVPC0yum4z3Xei+i9CkVm0pk7hP1xTzNQlA
Tmc7trkZx2U/0uqxDeJShxMzg3ClIuxJyIm9g35g0graw62qx48VaRpNFqeIsMy2
Mq10W3Lhmo9Zl18t0god0Gk4x9eq3OfbyWbB4ovWE7A=
`pragma protect key_keyowner = "Mentor Graphics Corporation", key_keyname = "MGC-VERIF-SIM-RSA-2"
`pragma protect key_method = "rsa"
`pragma protect encoding = (enctype = "BASE64", line_length = 64, bytes = 256)
`pragma protect key_block
AXH/IYY3Nk6K9QPm6vKBoDuYlD5DLeHEo1in4UBKj2fSdGKUK9mgq3W81evlOfXY
YwXIVSVDiEtJLTY5LQz2IdjsPUiERnA/W/tnMc+ENpEjvsJOJsKMBd4y4QkOQmMi
QZ/4ae4nQc/fFuxOJ/ih5+DJZqTsyGbZr02K9rvrdSm/tkT7XVLXF2njqAZJr3w2
28FRtNrFrpiKEwANrj0QhevX3ZECcjDxDQBAay9M5MPOkd2HGdu+3AVBlefnGe/h
zddSi4cFRij6ftHC770ncZ9Zrb64YOQU5oZgPu/SqASxwvtAR28sBJf58ITGU4BV
HzazXWkSUM5NDB/jWy8iQQ==
`pragma protect key_keyowner = "Synopsys", key_keyname = "SNPS-VCS-RSA-2"
`pragma protect key_method = "rsa"
`pragma protect encoding = (enctype = "BASE64", line_length = 64, bytes = 128)
`pragma protect key_block
RJ7tqQTOTbhVV7pSbA5EtGh9jdjFwD6/53Z6qY6259C/e0a19VLk9EvE5x64X91o
laYq/2tRvV47wX2KfGqxAWhMnLFRSg2HeB7BwsIgdG2psLvOfdTfn1r5Lwnyj1Zc
1wy9LMZYfNVsFhP93xnB4X1vRR1YgCSducMblvcVZ54=
`pragma protect data_method = "AES128-CBC"
`pragma protect encoding = (enctype = "BASE64", line_length = 64, bytes = 15520)
`pragma protect data_block
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
ElB4hwKS1tKsWiKuzs3JRA==
`pragma protect end_protected
endmodule
`pragma protect begin_protected
`pragma protect version = 1
`pragma protect encrypt_agent = "Anlogic"
`pragma protect encrypt_agent_info = "Anlogic Encryption Tool anlogic_2019"
`pragma protect key_keyowner = "Anlogic", key_keyname = "anlogic-rsa-001"
`pragma protect key_method = "rsa"
`pragma protect encoding = (enctype = "BASE64", line_length = 64, bytes = 128)
`pragma protect key_block
YerWqvAyr5ktMnipWMOj0eJyQNccJ01/WBoGgPeWwjYsmgO+J8apwXzflYodqCPA
B7EINY21P/O4M92gmhD7fn4Aa4AY7QwZPxVezTvHrUmIhWLfNuVSexjfPyUxPava
WgtGPSE+pwzi+z8N1AQ0In9dzG+Zi7263Rde2HU618U=
`pragma protect key_keyowner = "Cadence Design Systems.", key_keyname = "CDS_RSA_KEY_VER_1"
`pragma protect key_method = "rsa"
`pragma protect encoding = (enctype = "BASE64", line_length = 64, bytes = 256)
`pragma protect key_block
lU6O11XlDJq97m4lu4nIg3zOfVrcCL1uTw65xCJSh1sPt8NSZ/9IyW9BpYty72MW
Az9eA7Tm0ViJUgmSNCrr1j9TLrXchq9FAbxbA8N3dNeezEicEe3wrAV0MsGpcvyw
3oAviqCAqZM3gUtLtIZuVLAdmZaGa4z25VibM10JJbKq357BbIygcz+Sr91rNK8t
/ZEHm2LAb65YaG7sKbURIL0ZwKaYLEi4YLI146t3X887BHFg/NTZUNo8LXjz97mr
ZoFdkSZuTeFehVM+nNJ6reDvehDx+2Zo2+rmgwTD+bQNPWZ1MuVl8FnZxUSCI3td
WTE8uZeE0pRzrCumOy0BKg==
`pragma protect key_keyowner = "Mentor Graphics Corporation", key_keyname = "MGC-VERIF-SIM-RSA-1"
`pragma protect key_method = "rsa"
`pragma protect encoding = (enctype = "BASE64", line_length = 64, bytes = 128)
`pragma protect key_block
M9Dae5susYyEARiM0jKgePD0UH9DOKIa7gm1WNOwqVxoFTDOCl10AQGnsXIipDBP
v6n1LtII3g8sX/IQgCsZYX6QW9BZ/PYRBwj7gTHPdIzT27Xxx2uQdaRfGnziKM+e
waM5IQAvc75aiScjgRw3UqvbHXia6r1MCAfkXjy8+og=
`pragma protect key_keyowner = "Mentor Graphics Corporation", key_keyname = "MGC-VERIF-SIM-RSA-2"
`pragma protect key_method = "rsa"
`pragma protect encoding = (enctype = "BASE64", line_length = 64, bytes = 256)
`pragma protect key_block
J7ebBeH7sl5t0f4N57+HA0LvjwrIIdikZYO96LK9w7jMidQZy2ejjWNm7didOexV
lucaehUbkFttM4tIZ7IEuEGji9BOOkky7ZIR3HU/wnUObYhvLsZ/LlZBHO9vCh7m
3Jdbc8rA5/Mwv008l7xcz5+OgpjZsVsxUWlv4caFkd+Ai1CnGHIF2KAuS9MP3bPk
bMMGP3iKyat2gzHPfcRE4s0fEvY1zwpEeQNY6qIG63YoQ6bl99p7NHVlELQERRX0
Eu2G9FYh0GKFE/Z8nm8uKhRYvGzP/qYj//Cu0xnYwycMuKhfAik/RWbT1RmkuYYm
MgOAH+o7BOv1OZ5qB0n/8w==
`pragma protect key_keyowner = "Synopsys", key_keyname = "SNPS-VCS-RSA-2"
`pragma protect key_method = "rsa"
`pragma protect encoding = (enctype = "BASE64", line_length = 64, bytes = 128)
`pragma protect key_block
WkPr3HZ5yCV4UskKjSMZx903tIqI3xlzNdVS3R/Cg1D/+rbxD/x8ZeIxzuXCU6Jm
0nBohpA5SsyEqUfEX3KkxfbIcfmkK6Nt9602FfultPAWmBsFsSCx65Nua38Y3+o6
MzgJswu2UUGwAqtnOU2KQPEQJz4K8ex6wGI1E+DjrkA=
`pragma protect data_method = "AES128-CBC"
`pragma protect encoding = (enctype = "BASE64", line_length = 64, bytes = 144560)
`pragma protect data_block
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
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
