czp-1-A1/FPGA_Component_Inspector/(commit log)

2026-08-30 Initial project import
    [文件校验清单.csv]
2026-09-06 更新了文件夹“赛题与分析”
    [待测元器件候选库.xlsx]
2026-09-06 增加ai便于读的赛题分析
2026-09-09 计划更新+3d建模
    [P01.step, P02.step, P03.step, P04.step, P05.step, P06A.step, P06B.step, P07.step]
2026-10-07 Persist stage A video pipeline and EDGE diagnostic handoff
    Include the sampling UI, SW-selected RAW/GRAY/EDGE views, guarded video
    transport and the latest EDGE throughput fix with ER/LP/WS diagnostics.
    Preserve exact engineering and frozen-evidence bytes for cross-machine
    SHA-256 checks. Add tested bitstreams, simulation sources/assets, latest
    video repair and EDGE diagnostic records, and explicit successor steps.
    Verified207 frozen build inputs and715 evidence copies against staged
    Git blobs. Latest Sobel, OSD, diagnostic/CDC and real ISP/MC regressions
    passed within documented scope. TD final setup+0.858ns/hold+0.020ns/TNS0.
    Physical EDGE freeze remains unverified; the next step is board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
    [.m_params_MCU.txt, .m_params_PLL.txt, .m_params_blk_mem_gen_awb_delay_signal.txt, .m_params_blk_mem_gen_demosaic.txt, .m_params_blk_mem_gen_zhenghe.txt, .m_params_ddr2.txt, .m_params_w128_d512_fifo.txt, .m_params_w155_d512_fifo.txt]
